peterfelfer/Oxcart/.folder_summary.md

---

folder: 03_admin/0309_lab/030901_instruments/Oxcart/Oxcart
aaaa_type: default
tier: institutional
synopsis: "Open-hardware titanium atom probe design files and documentation, currently under active improvement with a stage re-design in progress."
status: active
last_activity: "2024-04-24"
people:
  - { name: "Peter Felfer", role: "designer/lead" }
key_entities:
  notes: "Open hardware atom probe; GPL licensed; runs PyCCAPT software; integrates Surface Concept and RoentDek detectors."
deadlines: []
linked:
  projects: []
  publications: []
  conferences: []
open_items:
  - "Stage re-design to integrate laser with in-situ dual-side focusing is in progress."
  - "Piezo stage lacks lift force and is being replaced."
  - "Weight distribution on optical table prevents use of air suspension."
  - "Low temperature capability currently limited to 35K (20K possible with improvements)."
  - "Only 3 pucks in load lock currently."
indexed:
  at: "2026-05-20T20:55:03"
  model: "deepseek-ai/DeepSeek-V4-Flash"
  backend: "hpc"
  provider: "hpc"
  upstream_model: "deepseek-ai/DeepSeek-V4-Flash"
  source_hash: "1dfb2ab7d26a90a0"
  schema_version: 2
---

## Context

This folder contains the hardware and design files for the Oxcart Titanium atom probe, an open-hardware straight flight path, microelectrode atom probe designed by Peter Felfer under his ERC starting grant. The system is controlled by the PyCCAPT software package and supports integration of Surface Concept and RoentDek detectors. The folder sits within the lab's instruments directory, serving as the central repository for build files and documentation for this custom-built instrument. The project is licensed under GPL, encouraging others to build their own versions or remix components. The current state is active, with known limitations being addressed: the piezo stage lacks lift force and is being replaced, and a stage re-design is underway to integrate a laser with in-situ dual-side focusing. The system achieves excellent vacuum (<10-11 mbar), minimal residual hydrogen, good mass resolution, and high detection efficiency, but has limited low-temperature capability (currently 35K) and only three pucks in the load lock.

## Recent activity

- 2024-04-24: README.md and LICENSE files last modified; documentation reflects current state of the instrument.
- 2024-04-24: Stage re-design to integrate laser with in-situ dual-side focusing noted as in progress.
- 2024-04-24: Piezo stage replacement identified as ongoing due to insufficient lift force.
- 2024-04-24: Known limitations documented: weight distribution issue on optical table, limited low-temperature capability, and load lock capacity.

## Key documents

- **README.md** (2024-04-24): Project overview describing the open-hardware atom probe, its strengths (vacuum, mass resolution, detection efficiency), known problems, and ongoing improvements. Authored by Peter Felfer.
- **LICENSE** (2024-04-24): GPL license file governing use and distribution of the hardware and design files.

## Open questions / next actions

- Complete stage re-design to integrate laser with in-situ dual-side focusing.
- Replace current piezo stage with one having adequate lift force.
- Address weight distribution on optical table to enable air suspension use.
- Investigate improvements to achieve 20K low-temperature capability.
- Expand load lock capacity beyond 3 pucks.
