peterfelfer/Oxcart/BOM.md

# Bill of Materials — off-the-shelf / vendor parts

The CAD tree in this repository contains **only parts designed for the Oxcart instrument**. Off-the-shelf components sourced from commercial suppliers are *not* redistributed here — their CAD models are the property of the respective vendors and are subject to those vendors' own terms. Instead, the parts used are listed below so you can download the original models from, or order them through, each supplier.

Part identifiers are taken from the supplier catalogue names as used in the build. Quantities and exact revisions depend on your configuration; treat this as a sourcing reference rather than a definitive per-unit BOM.

**23 suppliers, 618 distinct catalogue parts referenced.**

| Supplier | Website | Parts referenced |
|---|---|---|
| www.kampundkoetter.de | https://www.kampundkoetter.de | 244 |
| Thorlabs | https://www.thorlabs.com | 200 |
| VAB | https://www.vab-vacuum.com | 38 |
| LewVac | https://www.lewvac.co.uk | 27 |
| MK Profile | https://www.mk-group.com | 16 |
| Edwards | https://www.edwardsvacuum.com | 13 |
| Standa | https://www.standa.lt | 13 |
| Mädler | https://www.maedler.de | 12 |
| allectra | https://www.allectra.com | 11 |
| Pfeiffer | https://www.pfeiffer-vacuum.com | 9 |
| Hositrad | https://www.hositrad.com | 6 |
| smaract | https://www.smaract.com | 6 |
| Newport | https://www.newport.com | 4 |
| Edmbund Optics | https://www.edmundoptics.com | 3 |
| Lakeshore and Omega | https://www.lakeshore.com  /  https://www.omega.com | 3 |
| Vacom | https://www.vacom.de | 3 |
| Festo | https://www.festo.com | 2 |
| Kipp | https://www.kippwerk.de | 2 |
| Landefeld | https://www.landefeld.com | 2 |
| Lesker | https://www.lesker.com | 2 |
| Menlo Systems | https://www.menlosystems.com | 1 |
| prevac | https://www.prevac.eu | 1 |
| Rittal | https://www.rittal.com | 0 |

---

## www.kampundkoetter.de

Website: https://www.kampundkoetter.de

<details><summary>244 catalogue parts</summary>

- Flansch-Festlager KUS12-20160127
- Flansch-Festlager KUS16-20160127
- Flansch-Festlager KUS25-20200903
- Flansch-FestlagerKUS20-20160127
- Flansch-Loslager KUS12-20160127
- Flansch-Loslager KUS16-20160127
- Flansch-Loslager KUS20-20160127
- Flansch-Loslager KUS25-20200903
- KPMR-09C-500
- KPMR-12C-500
- KPMR-15C-500
- KPMW-09C-BLZ0
- KPMW-09C-BSZ0
- KPMW-12C-BLZ0
- KPMW-12C-BSZ0
- KPMW-15C-BLZ0
- KPMW-15C-BSZ0
- KUS1204x1000
- KUS1204x200
- KUS1204x250
- KUS1204x300
- KUS1204x350
- KUS1204x400
- KUS1204x450
- KUS1204x500
- KUS1204x550
- KUS1204x600
- KUS1204x650
- KUS1204x700
- KUS1204x800
- KUS1204x900
- KUS1605x1000
- KUS1605x1100
- KUS1605x1200
- KUS1605x1300
- KUS1605x1400
- KUS1605x1500
- KUS1605x1600
- KUS1605x200
- KUS1605x250
- KUS1605x300
- KUS1605x350
- KUS1605x400
- KUS1605x450
- KUS1605x500
- KUS1605x550
- KUS1605x600
- KUS1605x650
- KUS1605x700
- KUS1605x800
- KUS1605x900
- KUS1610x1000
- KUS1610x1100
- KUS1610x1200
- KUS1610x1300
- KUS1610x1400
- KUS1610x1500
- KUS1610x1600
- KUS1610x200
- KUS1610x250
- KUS1610x300
- KUS1610x350
- KUS1610x400
- KUS1610x450
- KUS1610x500
- KUS1610x550
- KUS1610x600
- KUS1610x650
- KUS1610x700
- KUS1610x800
- KUS1610x900
- KUS2005x1000
- KUS2005x1100
- KUS2005x1200
- KUS2005x1300
- KUS2005x1400
- KUS2005x1500
- KUS2005x1600
- KUS2005x1800
- KUS2005x200
- KUS2005x2000
- KUS2005x250
- KUS2005x300
- KUS2005x350
- KUS2005x400
- KUS2005x450
- KUS2005x500
- KUS2005x550
- KUS2005x600
- KUS2005x650
- KUS2005x700
- KUS2005x800
- KUS2005x900
- KUS2010x1000
- KUS2010x1100
- KUS2010x1200
- KUS2010x1300
- KUS2010x1400
- KUS2010x1500
- KUS2010x1600
- KUS2010x1800
- KUS2010x200
- KUS2010x2000
- KUS2010x250
- KUS2010x300
- KUS2010x350
- KUS2010x400
- KUS2010x450
- KUS2010x500
- KUS2010x550
- KUS2010x600
- KUS2010x650
- KUS2010x700
- KUS2010x800
- KUS2010x900
- KUS2510_Spindelmutter
- KUS2510x1000
- KUS2510x1100
- KUS2510x1200
- KUS2510x1300
- KUS2510x1400
- KUS2510x1500
- KUS2510x1600
- KUS2510x1800
- KUS2510x2000
- KUS2510x800
- KUS2510x900
- LFS16x1000
- LFS16x1100
- LFS16x1200
- LFS16x1300
- LFS16x1400
- LFS16x1500
- LFS16x1600
- LFS16x1800
- LFS16x1900
- LFS16x200
- LFS16x2000
- LFS16x250
- LFS16x300
- LFS16x350
- LFS16x400
- LFS16x450
- LFS16x500
- LFS16x550
- LFS16x600
- LFS16x650
- LFS16x700
- LFS16x800
- LFS16x900
- LFS20x1000
- LFS20x1100
- LFS20x1200
- LFS20x1300
- LFS20x1400
- LFS20x1500
- LFS20x1600
- LFS20x1800
- LFS20x1900
- LFS20x200
- LFS20x2000
- LFS20x250
- LFS20x300
- LFS20x350
- LFS20x400
- LFS20x450
- LFS20x500
- LFS20x550
- LFS20x600
- LFS20x650
- LFS20x700
- LFS20x800
- LFS20x900
- Linearwagen
- Linearwagen D16
- Linearwagen D20 - 2016-09
- Linearwagen D20 WF
- Profilfuehrung20x1000
- Profilfuehrung20x1200
- Profilfuehrung20x1500
- Profilfuehrung20x2000
- Profilfuehrung20x300
- Profilfuehrung20x500
- Profilfuehrung20x800
- SFU2005 Spindelmutter_MJ2020
- SFU2010 Spindelmutter_MJ2020
- Spannblock KUS12
- Spannblock KUS16
- Spannblock KUS20
- Spannblock KUS25
- Spindelmutter-SFU1204-MJ2020
- SpindelmutterSFU1605_MJ2020
- SpindelmutterSFU1610_MJ2020
- Steh-Festlager KUS12-20180528
- Steh-Festlager KUS16-20150517
- Steh-Festlager KUS20-20171205
- Steh-Festlager KUS25-20200903
- Steh-Loslager KUS12-20180528
- Steh-Loslager KUS16-20160510
- Steh-Loslager KUS2020150511
- Steh-Loslager KUS25-20200903
- WF16x1000
- WF16x1100
- WF16x1200
- WF16x1300
- WF16x1400
- WF16x1500
- WF16x1600
- WF16x200
- WF16x250
- WF16x300
- WF16x350
- WF16x400
- WF16x450
- WF16x500
- WF16x550
- WF16x600
- WF16x650
- WF16x700
- WF16x800
- WF16x900
- WF20x1000
- WF20x1100
- WF20x1200
- WF20x1300
- WF20x1400
- WF20x1500
- WF20x1600
- WF20x200
- WF20x250
- WF20x300
- WF20x350
- WF20x400
- WF20x450
- WF20x500
- WF20x550
- WF20x600
- WF20x650
- WF20x700
- WF20x800
- WF20x900
- Wagen-20CR_2016
- Wellenhalter
- stepper_am23hs2449-01

</details>

## Thorlabs

Website: https://www.thorlabs.com

<details><summary>200 catalogue parts</summary>

- 1- 4- RFL MPD149-F01
- 1-2- 150mm RFL MPD00M9-F01
- 1” 6” RFL - MPD169-F01
- 2- 6- RFL MPD269-F01
- ACA254-150-UV
- AL1225-A
- AL75150-A
- AM45C_M
- BE03-UVB
- BE10-1064
- BE10-266
- BE10-532
- BE10-UVB
- BE1_M
- BSC203
- C4W
- C6W
- CF038C_M-P5
- CF125C_M-P5
- CF175C_M-P5
- CH1060_M
- CPX1_M
- CR1_M
- CXYZ05_M
- DAS110
- DCC3240M
- ER025
- ER1-P4
- ER2-P4
- ER24
- ER4
- FAS100
- FM90_M
- FP90_M
- H45CN
- H45E2
- ID36
- ID36_M
- ID50
- KB50_M
- KB75_M
- KC1_M
- KC2_M
- KCB1C_M
- KCB1E_M
- KCB1P_M
- KCB1_M
- KCB2C_M
- KCB2EC_M
- KIM101
- KM100
- KM100CP_M
- KM200
- KM200CP_M
- KPS201
- LA4936
- LC6W
- LCP01B
- LCP01T_M
- LCP02_M
- LCP06_M
- LCP09
- LCP50S
- LMR2_M
- Laser magnification optica
- Laser magnification optica v3 (ATTER UPDATE)
- Laser magnification optica v4 (ATTER UPDATE)
- Laser positioning setup
- MA45-50_M
- MAX341_M
- MB1015_M
- MB1530F_M
- MB2020_M
- MB3030D_M
- MB3030_M
- MB3045_M
- MB35142_M
- MFF101_M
- MFF102_M
- MFF102_M-Solidworks (1)
- MP127P1
- MPD00M9-F01-with beam
- MPD01M9-F01
- MPD124-P01
- MPD149-F01
- MPD169-F01
- MPD2151-P01
- MPD269-F01
- MPD284-P01
- MSB5075_M
- MSB7510_M
- MSC2
- MSP05_M
- MSP1.5_M
- MSP1_M
- MSP2_M
- MT3_M-Z8
- MVL12X20L
- MVL12X3Z
- MVL20A
- MVL6X3Z
- MVL7000
- MVLCMC
- N80L5P
- N80L6P
- NX1NF_M
- P100_M
- P75_M
- PB4_M
- PD1B2_M
- PD1D_M
- PD1V_M
- PD1Z_M
- PF10-03-F01
- PF125B
- PF175B
- PF20-03-F01
- PF85B
- PFE20-G01
- PFSQ20-03-F01
- PH100E_M
- PH150E_M
- PH20E_M
- PH2T_M
- PH30E_M
- PH40E_M
- PH50E_M
- PH75E_M
- PLS-T242_M
- PLS-T242_M-Step (1)
- PLS-T492_M
- PLS-T492_M-Step (1)
- PM100D
- POLARIS-CA1_M
- POLARIS-K05S2
- POLARIS-K1M4_M
- POLARIS-K2
- POLARIS-MA45_M
- PR005_M
- RBB150A_M
- RBL13D_M
- RP005_M
- RS10M
- RS19P4_M
- RS25_M
- RS3M
- RS99_M
- S120VC
- S415C
- S425C
- SB1_M
- SH05_M
- SM1L10
- SM1TC
- SM2A21
- SR025
- T1020C
- TR100_M
- TR10M
- TR150_M
- TR20_M
- TR2F90_M
- TR30_M
- TR40_M
- TR50_M
- TR75_M
- TRF90_M
- TRT2_M
- UPHA
- VB01A_M
- VB01_M
- VRC1SM1
- VRC1SM2
- VRC2SM1
- VRC2SM2
- VRC4SM1
- VRC4SM2
- XRN25-RP1_M
- XRN25DR
- XRN25DR2
- XRN25DR3
- XT34HP_M
- XT34SD-250
- XT34SD-500
- XT34TR1_M
- XT34TR2_M
- XT66C4
- XT66P2_M
- XT66SD-250
- XT66SD-500
- XT66SD-750
- beam expanders
- beam path assembly
- laser beam collection
- laser optical assembly
- laser optical assembly v12 (ATTER UPDATE)
- laser optical assembly v13 (ATTER UPDATE)
- lens laser focussing
- optics frame
- targeting camera assembly

</details>

## VAB

Website: https://www.vab-vacuum.com

<details><summary>38 catalogue parts</summary>

- CF40 offset port
- Durchführungsflansch DN40 CF_ Uni Erlangen
- FIM_PrÑparationskammer_CF200_S1_Blindflansch.0004
- VAb_BF 160-K
- VAb_BNC 16
- VAb_CBF 100
- VAb_DCF 63-2
- VAb_JU-MEM 40K
- VAb_JUMEM 40-L
- VAb_JUMEM 40-M
- VAb_JUMEM 63K
- VAb_KWCF 16K
- VAb_LD 63-50
- VAb_LD 63-50S
- VAb_MDS 16-300
- VAb_MDS 16_40-100 ST MLH
- VAb_MDS 16_40-300
- VAb_MDS 40-150
- VAb_MDS 40-200
- VAb_MDS 40-500
- VAb_MDS 40-600
- VAb_MDS 40-700
- VAb_MDS 63-500
- VAb_MDS 63-600
- VAb_MDS2 40-500
- VAb_MDWS-300
- VAb_MDWS-500
- VAb_MEM 160-200-K
- VAb_MEM 63-25
- VAb_MEM 63-25A
- VAb_RF 200-100
- VAb_SF 160-K
- VAb_SHV 16
- VAb_SPR 40-111
- VAb_SST-63-40
- VAb_THD 40_1+2
- VAb_WKCF 63
- VAb_X 40-12 S

</details>

## LewVac

Website: https://www.lewvac.co.uk

<details><summary>27 catalogue parts</summary>

- 110240 AGP
- A-SMA-F-UHV
- C19-40CF
- C19-AC1200
- C19-VCF500
- D9-40CF
- D9-40KF
- FH-BNC-D-40CF
- FH-MSC19-40CF
- FH-SMA-D-16CF (1)
- FH20-SHV-E-16CF (1)
- FHM-A10-16CF
- FHP-BECU-0.8-CON
- FHP-BECU-1.27-CON
- FHP-BECU-2.4-CON
- SVP-DUV-49.2-63CF
- SVP-UV-11.6-SW
- SVP-UV-14.9-SW
- SVP-UV-17.5-AW
- SVP-UV-23.8-40CF
- SVP-UV-23.8-AW
- SVP-UV-36.5-40CF
- SVP-UV-36.5-AW
- SVP-UV-49.2-AW
- SVP-UV-74.9-AW
- SVP-UV-8.6-SW
- modified SVP-DUV-49.2-63CF

</details>

## MK Profile

Website: https://www.mk-group.com

<details><summary>16 catalogue parts</summary>

- 25_01_0300(00-00-0)(0)
- 25_01_0500(00-00-0)(0)
- 25_50_1010
- 25_50_8000
- 31_60_0007
- 50_05_6026
- 51_51_1000(0)
- 6005AB1800(0)
- 60_05_0500(0)
- 60_05_0650(0)
- 60_05_1000(0)
- 60_05_1850(0)
- B85.00.016
- B85.00.021
- mk2563
- stage assembly rack

</details>

## Edwards

Website: https://www.edwardsvacuum.com

<details><summary>13 catalogue parts</summary>

- 360549_STEP
- 410023_ethernet_B
- 410030 TSP
- 5s-xx-2v-5k_step
- 5s-xx-2v-sc_step
- B58053170_AllCATPart_Radial Fan STEP
- B82200200 nEXT300D CF100 STEP
- B8G200820 AIR COOLER RADIAL SETUP
- B8GX10C01 nEXT85 CF63 (2)
- D02601000_APG100_NW16 (1)
- D14703000_GAUGE_WIDE_RNGE_S_FCC68_NW35CF
- D397XX000 TIC ALL VARIANTS
- nXDS standard and C variant STEP

</details>

## Standa

Website: https://www.standa.lt

<details><summary>13 catalogue parts</summary>

- 1HT09-18-20
- 1VIS10-065-12-60
- 7T38XYZ
- 8MT173V-10-VSS42
- 8MT184-13
- 8MTF2
- 8MTF2M
- 8MVT25-6
- 8MVT45-13
- air table assembly
- compressed air module base
- motorized stage setup
- optical table model

</details>

## Mädler

Website: https://www.maedler.de

<details><summary>12 catalogue parts</summary>

- 47514020
- 62399416GA
- 62499116
- 64001600
- 64010023
- 64200115
- 64477116
- 67071200
- 67099510
- A_64200506
- B_64200506
- shifter block

</details>

## allectra

Website: https://www.allectra.com

<details><summary>11 catalogue parts</summary>

- 210-D09-K40
- 211-FS09-UHV
- 211-FS44H-UHV
- 218-HD44-SS
- 218-HD78-SS
- 220-CM12-C16
- 220-CM19
- 264-13CU1K-2-K16
- 360-CRBC-0.8
- 360-CRBC-1.3
- 515-GV-C16_stp

</details>

## Pfeiffer

Website: https://www.pfeiffer-vacuum.com

<details><summary>9 catalogue parts</summary>

- 110RKR040-016-V.A
- 120AAU016-0500
- 120RKR040-016
- 310FMA063
- 330SMA063
- 420FES040
- 420FES063
- 470RKK040
- PTR21261

</details>

## Hositrad

Website: https://www.hositrad.com

<details><summary>6 catalogue parts</summary>

- 17105-01-W
- 17105-02-W
- Hositrad_CF35-38
- Hositrad_FO63-70-HalfNipple
- Hositrad_KE25-25
- botton standoff port

</details>

## smaract

Website: https://www.smaract.com

<details><summary>6 catalogue parts</summary>

- ALB DN63CF_1B_12
- EX22070349_A00
- EX23080921_A00
- EX23101016_A00
- EX23111089_A00
- EX23111091_A00

</details>

## Newport

Website: https://www.newport.com

<details><summary>4 catalogue parts</summary>

- NPXYZ100SG
- Newport 900 x 1800 optical table
- Newport-M-UMR5_16
- S-2000A-116

</details>

## Edmbund Optics

Website: https://www.edmundoptics.com

<details><summary>3 catalogue parts</summary>

- step_37259
- step_37264
- step_37288 RFL6.35 dia 6.35

</details>

## Lakeshore and Omega

Website: https://www.lakeshore.com  /  https://www.omega.com

<details><summary>3 catalogue parts</summary>

- Lakeshore CO clamp
- Lakeshore DT 670 SD Omega CY 670 SD
- Omega CY7 SD7

</details>

## Vacom

Website: https://www.vacom.de

<details><summary>3 catalogue parts</summary>

- 4AVP-16CF-MV-S
- VACOM_105133_W-SUBD-15-BASIC
- W-SUBD-9-BASIC

</details>

## Festo

Website: https://www.festo.com

<details><summary>2 catalogue parts</summary>

- 19201 DSNU-16-50-P-A---(0)
- 8061478 ELGC-BS-KF-32-200-8P---(0)

</details>

## Kipp

Website: https://www.kippwerk.de

<details><summary>2 catalogue parts</summary>

- K0333_02_0
- K0333_03_0

</details>

## Landefeld

Website: https://www.landefeld.com

<details><summary>2 catalogue parts</summary>

- 10_52_6481_1008_013
- zdm205017236

</details>

## Lesker

Website: https://www.lesker.com

<details><summary>2 catalogue parts</summary>

- sa0075mccf
- sa0075pvqf

</details>

## Menlo Systems

Website: https://www.menlosystems.com

<details><summary>1 catalogue parts</summary>

- Menlo Systems BlueCut Mockup

</details>

## prevac

Website: https://www.prevac.eu

<details><summary>1 catalogue parts</summary>

- TDS_W3008537

</details>

## Rittal

Website: https://www.rittal.com

_Assembly/reference models only._
