peterfelfer/Oxcart/CAD/assemblies/MC Laser assembly v4.step

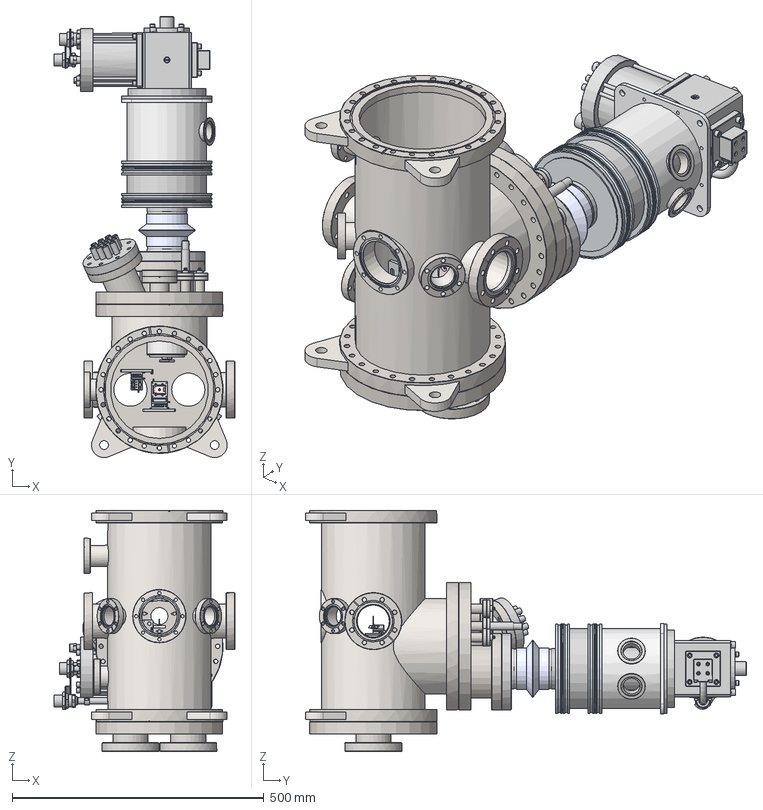
[picture p2: CAD file, 2026-05-30]
CAD/assemblies/MC Laser assembly v4.step
359.1 x 877.0 x 479.1 mm
MC body
Hositrad_CF200-203-Weldflange v1
Hositrad_CF200-203-Weldflange v1 (2)
Hositrad_CF200-203-Weldflange v1 (1)
console x 2
console(Mirror) x 2
Hositrad_CF63-64 v1
Hositrad_CF63-64 v1 (1)
Hositrad_CF35-38 v1
Hositrad_CF35-38 v1 (1)
Hositrad_CF35-38 v1 (2)
Hositrad_CF35-38 v1 (3)
CF63 special weld-in v3
Hositrad_CF200-B v1
Hositrad_CF63-70-Weldflange v1
Hositrad_CF63-70-Weldflange v1 (1)
EX-0045592-Wechselantrieb Baseplate_V8_00_Parent x 3
EX-0054799-Wechselantrieb Topplate V6_00_Parent x 3
ES-0000728-Rail SVS1_FNB-SVS1030 x 6
ES-0000705-Cage RK1_FNB-RK17-8Z x 6
ES-0000810-Slide WS1_WS1030 x 3
ISO 14580 - M2 x 4 x 3.2 - 4.8-N-A2_ISO 14580 - M2 x 4 x 3.2 - 4.8-N- A2 x 27
IS-0006594-NBK_NBK-M1,6x3-St x 6
EX-Kopie von IS-0043336-Housing^EX-0045461-Drive unit_00_Parent x 3
10001541_EX
10001504_EX x 2
10001510_EX
10001507_EX x 4
10000125_M2 x 4 - 4N-A2 x 6
ISO 4762 M2 x 10 - 8.8N-A2_ISO 4762 M2 x 10 - 8.8N-A2 x 4
ISO 4762 M2 x 5 - 3.8N-A2_ISO 4762 M2 x 5 - 3.8N-A2 x 8
ISO 4762 M2 x 4 - 2.8N-A2_ISO 4762 M2 x 4 - 2.8N-A2 x 4
FH20-SHV-E-16CF (1)
CF200
CF100-102-WeldflangE
cf63
CF40
CF16
CF16 (1)
CF16 (2)
CF16 (3)
CF63_1
FH-SMA-D-16CF (1) x 2
Viewport-metal-ring38
Glass47
NW35CF-Viewport
10013849_00_Parent
10004759_00_Parent x 12
top interface
bottom connector
thermal interface
bottom thermal connector
bottom clamp
VAb_CBF 100 v1
330SMA063
VAb_BF 160-K v1
tube
Hositrad_ISO160AV x 2
VAb_SF 160-K x 2
main body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
