peterfelfer/Oxcart/CAD/gas-thermal/baking equipment/baking lid assembly Drawing v3 Sheet1.dxf

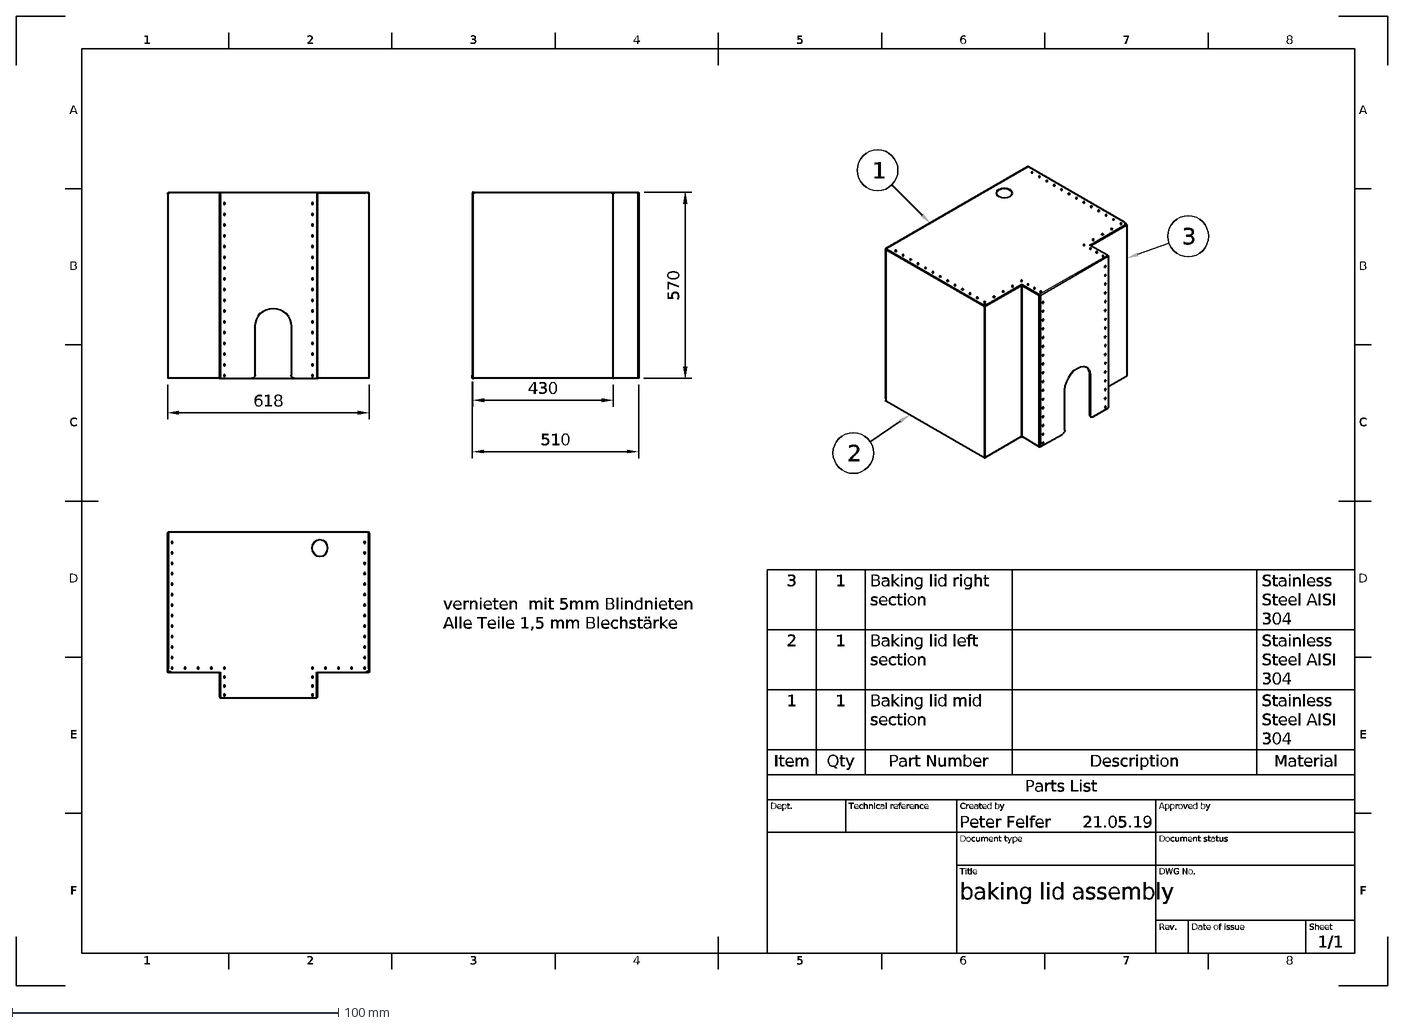
[picture p3: CAD file, 2026-05-30]
CAD/gas-thermal/baking equipment/baking lid assembly Drawing v3 Sheet1.dxf
1
A
2
3
4
5
6
7
8
B
C
D
E
F
21.05.19
1/1
baking lid assembly
Peter Felfer
Dept.
Technical reference
Created by
Approved by
Document type
Document status
Title
DWG No.
Rev.
Date of issue
Sheet
Parts List
Item
Qty
Part Number
Description
Material
Baking lid mid section
Stainless Steel AISI 304
Baking lid left section
Baking lid right section
vernieten mit 5mm Blindnieten Alle Teile 1,5 mm Blechstärke
510
570
430
618
