peterfelfer/Oxcart/CAD/machining/pocket nc/V2PocketNC_both_toolholders_Kinematic_Assembly v19 v1.step

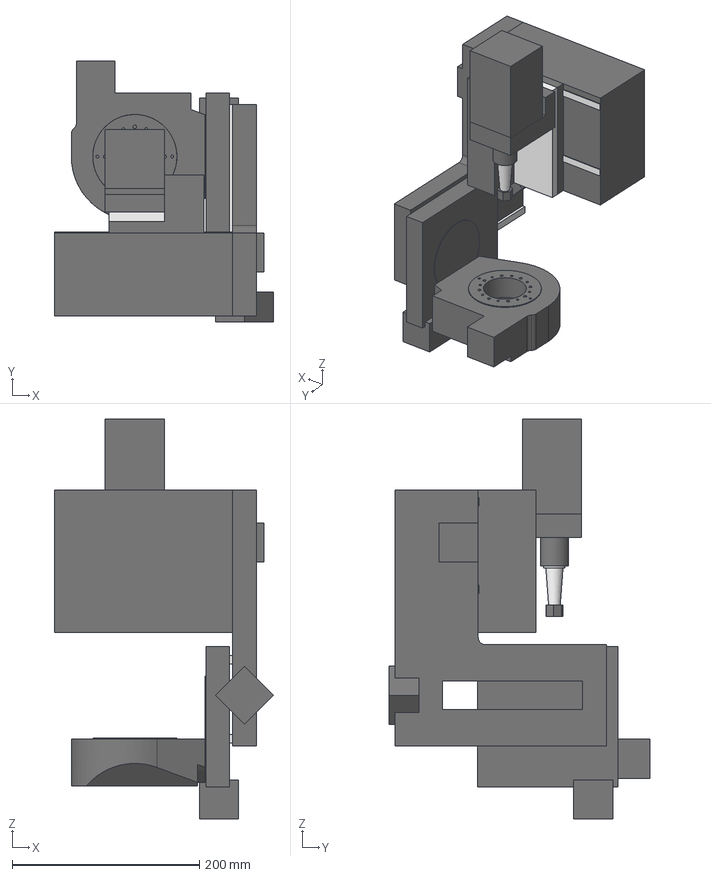
[picture p4: CAD file, 2026-05-30]
CAD/machining/pocket nc/V2PocketNC_both_toolholders_Kinematic_Assembly v19 v1.step
234.3 x 279.2 x 427.8 mm
x rail
L_Bracket_Kinematic
z rail
motor mount
motor
simulation spindle extended
V2 B housing kinematic only v8
V2PocketNC kinematic Bdisc v4
V2PocketNC_A housing v3
y rails
