peterfelfer/Oxcart/CAD/optics-laser/optics/bottom optics assembly v6.step

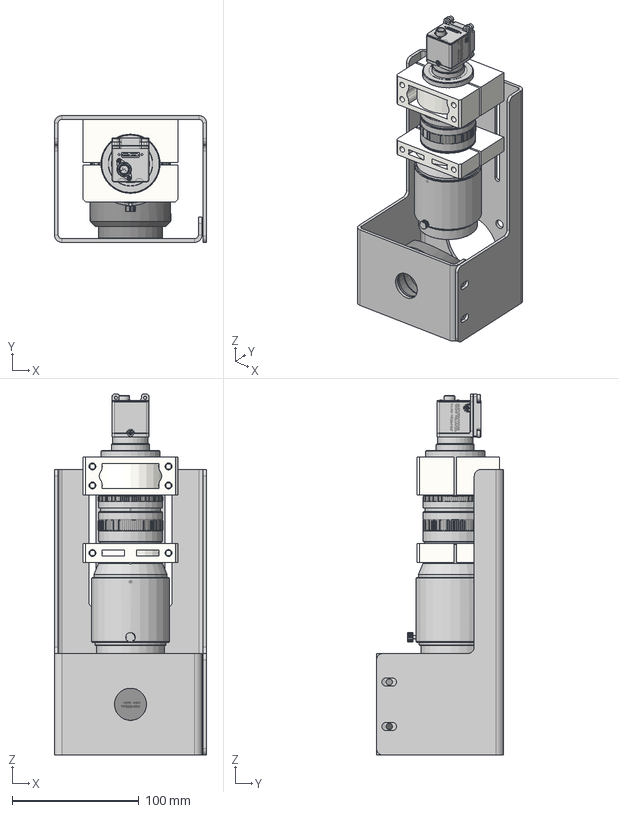
[picture p7: CAD file, 2026-05-30]
CAD/optics-laser/optics/bottom optics assembly v6.step
120.0 x 100.0 x 284.6 mm
H45E2-Step
bottom optics console
PFE20-G01-Step
MVL7000-Step v1
clamp upper short
clamp lower short
clamp lower
clamp upper
DCC3240M-Step v1
