peterfelfer/Oxcart/CAD/3d-print/3D-Print Oxcart/Detector assembly Copy v4.step

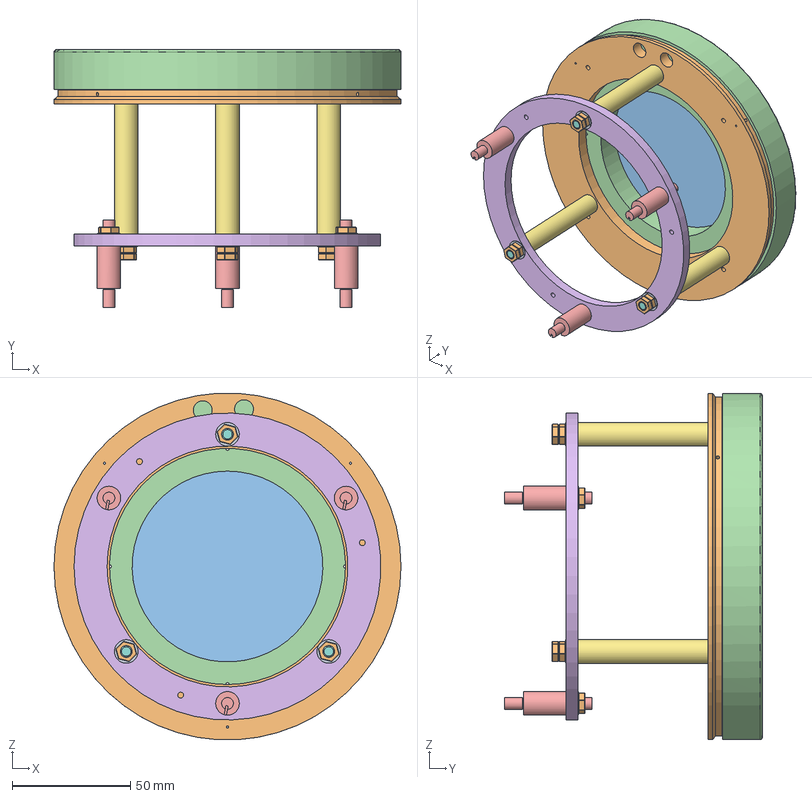
[picture p8: CAD file, 2026-05-30]
CAD/3d-print/3D-Print Oxcart/Detector assembly Copy v4.step
147.0 x 109.2 x 146.8 mm
DLD8080_BODENPLATTE
MCP-75-32-25-19_60ZU1
DLD8080_ABDECKUNG_V2
STANDOFF_ALU_18X10_V2 x 3
HALTERING_3D-DLD4040-150
ABSTANDSHALTER_PEEK x 3
M5-GEWINDESTANGE_ALU x 6
M5-WASCHER_CUBE x 6
M5-MUTTER_TITAN x 9
