peterfelfer/Oxcart/CAD/cryo/cryo heads/2-9 COLDHEAD ASSEMBLY v4.step

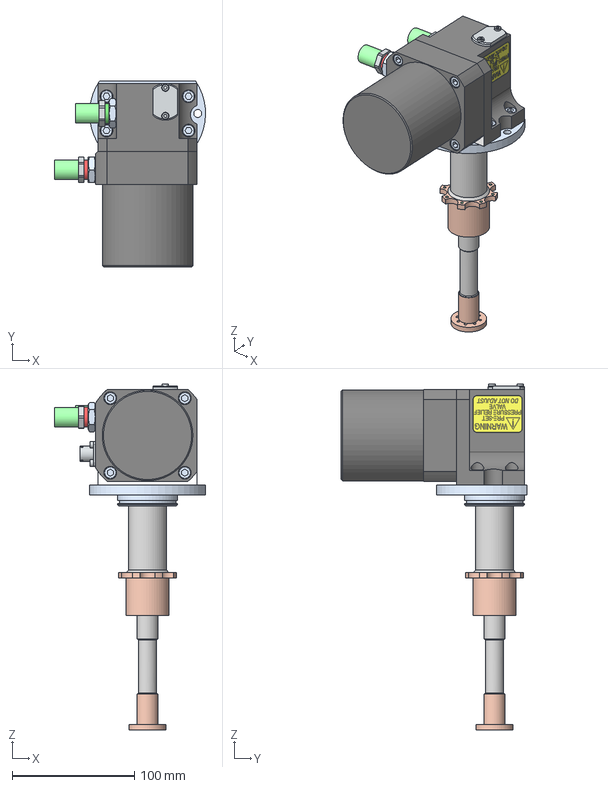
[picture p10: CAD file, 2026-05-30]
CAD/cryo/cryo heads/2-9 COLDHEAD ASSEMBLY v4.step
123.3 x 151.8 x 282.5 mm
911H030A-B (1ST STAGE HEAT STATION 2-9)
911H020A (2ND STAGE HEAT STATION)
911C000A-E (TUBE ASSEMBLY)|448|532|Groove 1
911H040A-C (TUBE FLANGE)
911H000A (1ST STAGE TUBE)
911H010A-B (2ND STAGE TUBE)
911C000A-E (TUBE ASSEMBLY)|448|532|Groove 1 (1)
911C000A-E (TUBE ASSEMBLY)|448|532|Groove 1 (2)
911H220A-F (DRIVE HOUSING)
1P0284 (SELFSEAL COUP MALE 5400-S2-4) x 2
M3 x 8 Socket Cap Head A4 x 2
99BS-OR925X178V160 (O RING 9.25x1 x 2
911H360A (GAS PLUG)
911H320A-B (GAS CONNECTOR) x 2
1X0234 (SHRINK SLEEVE D17 PVC GREEN)
1P0231 (WARNING LABEL)
911H210A-D (MOTOR HOUSING)
1P0175 (4 WAY CONNECTOR)
1X0235 (SHRINK SLEEVE D17 PVC RED)
M3 x 6 Socket Cap Head x 4
99BS-OR14X178N160
1P0213 (CE LABEL)
M6 x 12 Socket Cap Head x 4
M6 x 30 Socket Cap Head x 4
