peterfelfer/Oxcart/CAD/optics-laser/optics/MB1530_M-Step (assembly plate) v1.step

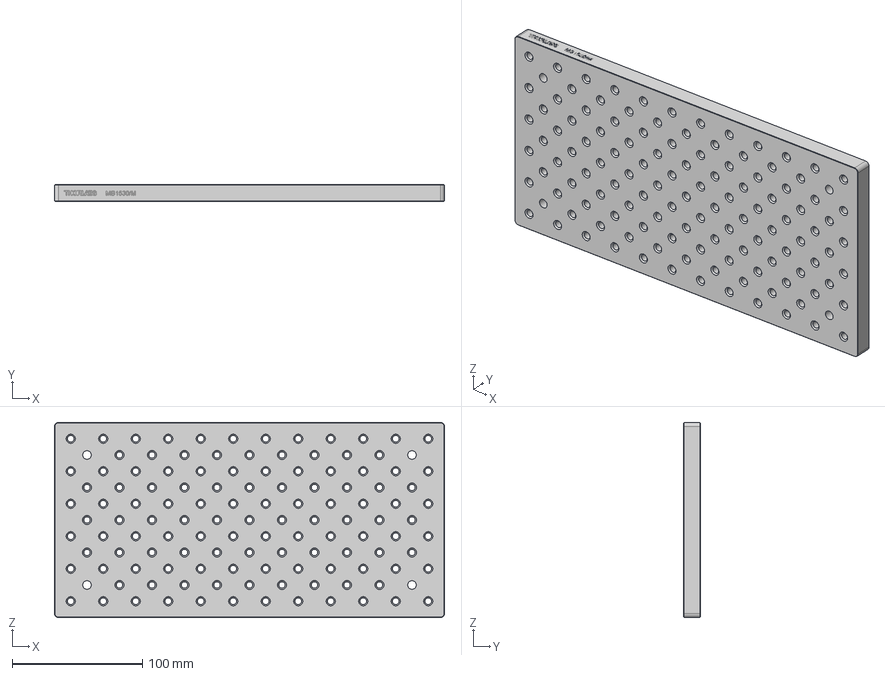
[picture p11: CAD file, 2026-05-30]
CAD/optics-laser/optics/MB1530_M-Step (assembly plate) v1.step
300.0 x 12.7 x 150.0 mm
