peterfelfer/Oxcart/CAD/assemblies/MC Lid assembly laser v9.step

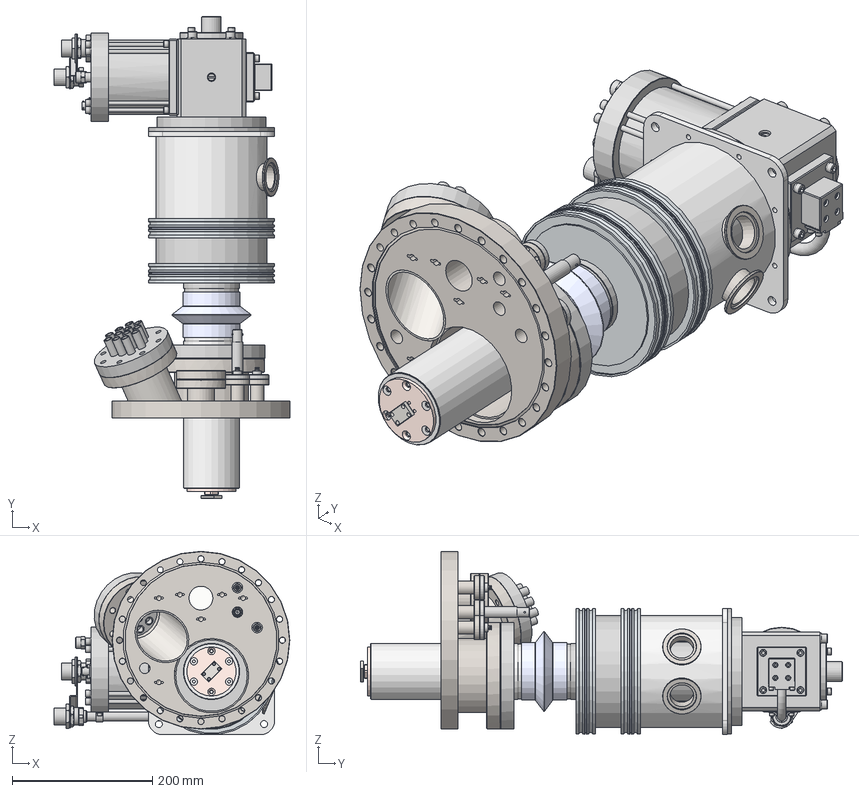
[picture p12: CAD file, 2026-05-30]
CAD/assemblies/MC Lid assembly laser v9.step
335.7 x 686.6 x 261.1 mm
FH20-SHV-E-16CF (1)
CF200
CF100-102-WeldflangE
cf63
CF40
CF16
CF16 (1)
CF16 (2)
CF16 (3)
CF63_1
FH-SMA-D-16CF (1) x 2
Viewport-metal-ring38
Glass47
NW35CF-Viewport
10013849_00_Parent
10004759_00_Parent x 12
top interface
bottom connector
thermal interface
bottom thermal connector
bottom clamp
VAb_CBF 100 v1
330SMA063
VAb_BF 160-K v1
tube
Hositrad_ISO160AV x 2
VAb_SF 160-K x 2
main body
top
VAb_SF 160-K v1
Hositrad_KF40-38-19 v1
Hositrad_KF40-38-19 v1 (1)
O ring 145 x 4
KDE415SA 3D Model
thermal conductor x 2
magnetic ring x 2
thermal contact x 2
pressure plate x 2
Lakeshore DT 670 SD Omega CY 670 SD
insulator bottom
insulator top
Lakeshore CO clamp
back clamp
front clamp
