peterfelfer/Oxcart/CAD/cryo/cryo LL/CryoLLMainPart v2.step

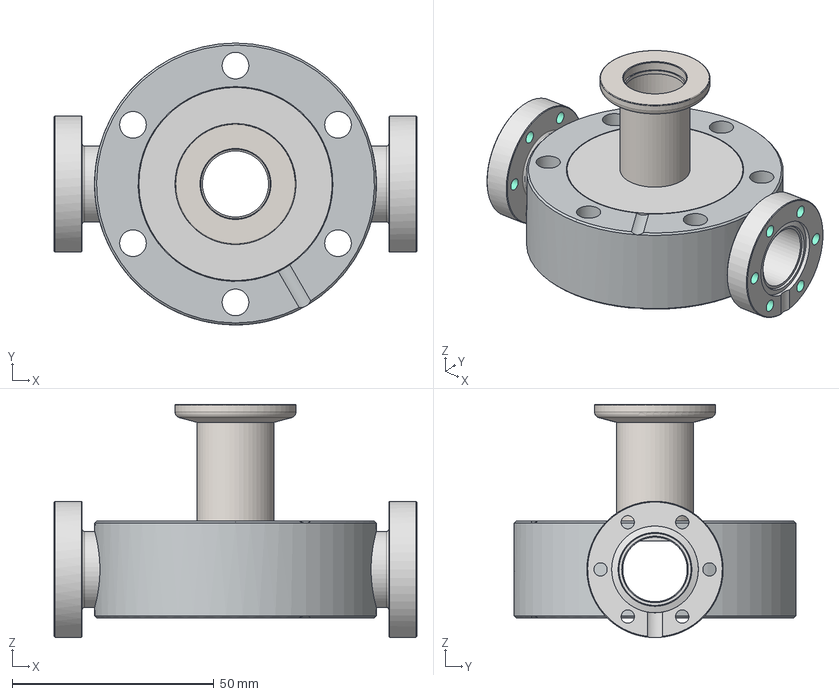
[picture p13: CAD file, 2026-05-30]
CAD/cryo/cryo LL/CryoLLMainPart v2.step
90.0 x 69.9 x 57.8 mm
VAb_DCF 40-2
CF-To-KF-Adaptors-All_CFA16-KF16
KF16-19WS_KF16-19
NW16CF-Outerring
NW16CF-Innerring_CF16-19-R
