peterfelfer/Oxcart/CAD/cryo/cryo system BC/coupling assembly v2.step

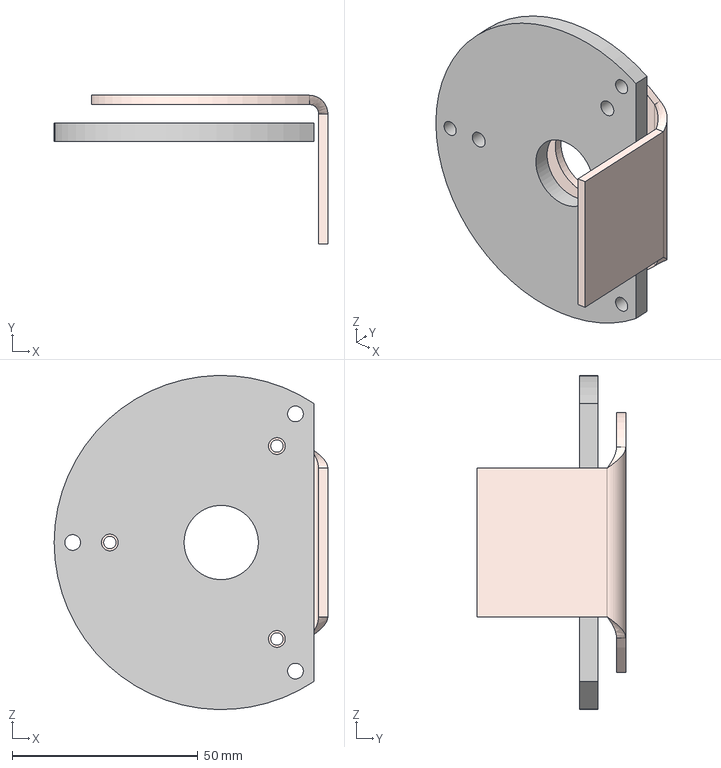
[picture p14: CAD file, 2026-05-30]
CAD/cryo/cryo system BC/coupling assembly v2.step
73.7 x 40.0 x 90.0 mm
coupling plate
coupling bottom plate
