peterfelfer/Oxcart/CAD/gas-thermal/gas charging devices/gasChargingFlashBang/Hositrad_FS16-19-FullNipple v1.step

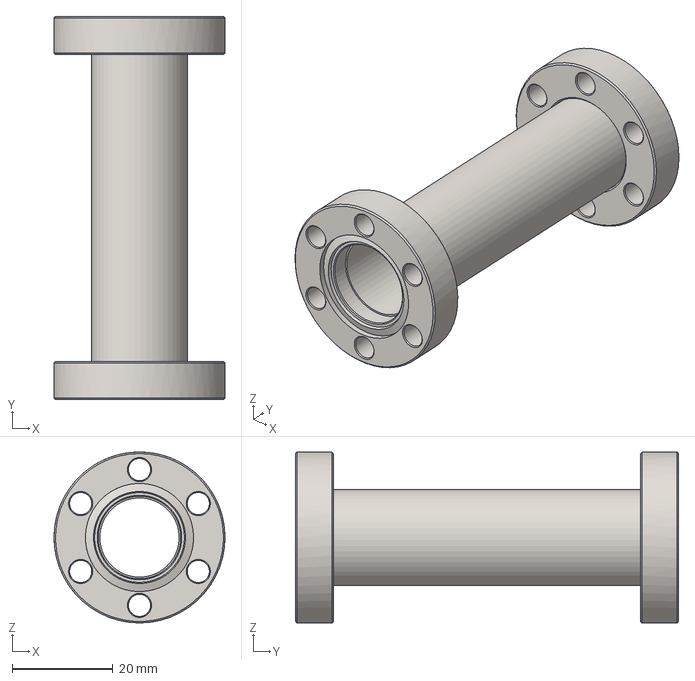
[picture p15: CAD file, 2026-05-30]
CAD/gas-thermal/gas charging devices/gasChargingFlashBang/Hositrad_FS16-19-FullNipple v1.step
34.0 x 76.2 x 34.0 mm
NW16CF-weld_CF16-19 x 2
Tube 19-All_Tube 19L66,8
