peterfelfer/Oxcart/CAD/optics-laser/optics/upper positioning optics assembly v8.step

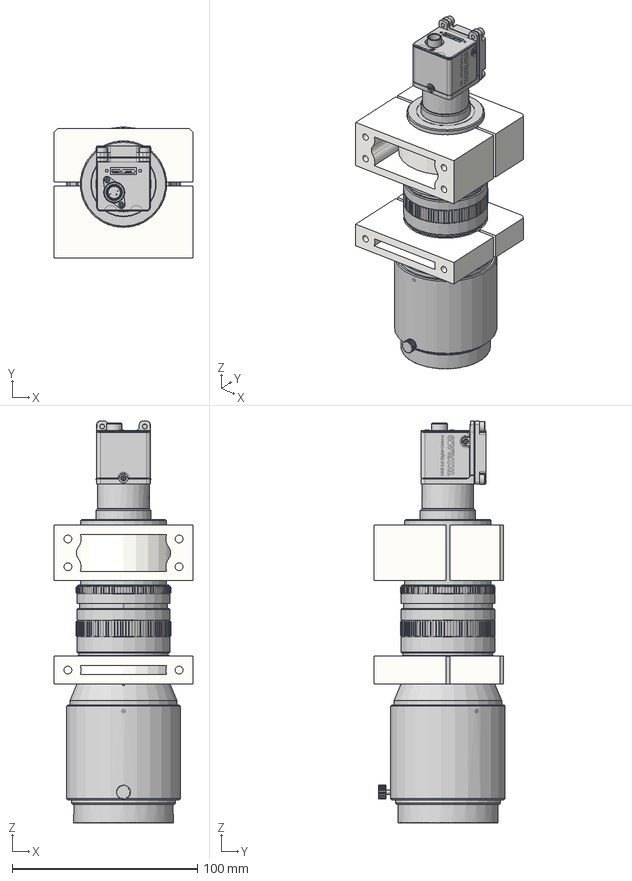
[picture p16: CAD file, 2026-05-30]
CAD/optics-laser/optics/upper positioning optics assembly v8.step
75.0 x 70.9 x 217.0 mm
MVL7000-Step
clamp upper short
clamp lower short
clamp lower
clamp upper
DCC3240M-Step
