peterfelfer/Oxcart/CAD/vacuum/vacuum parts/Hositrad_FS35-43R-FullNipple v1.step

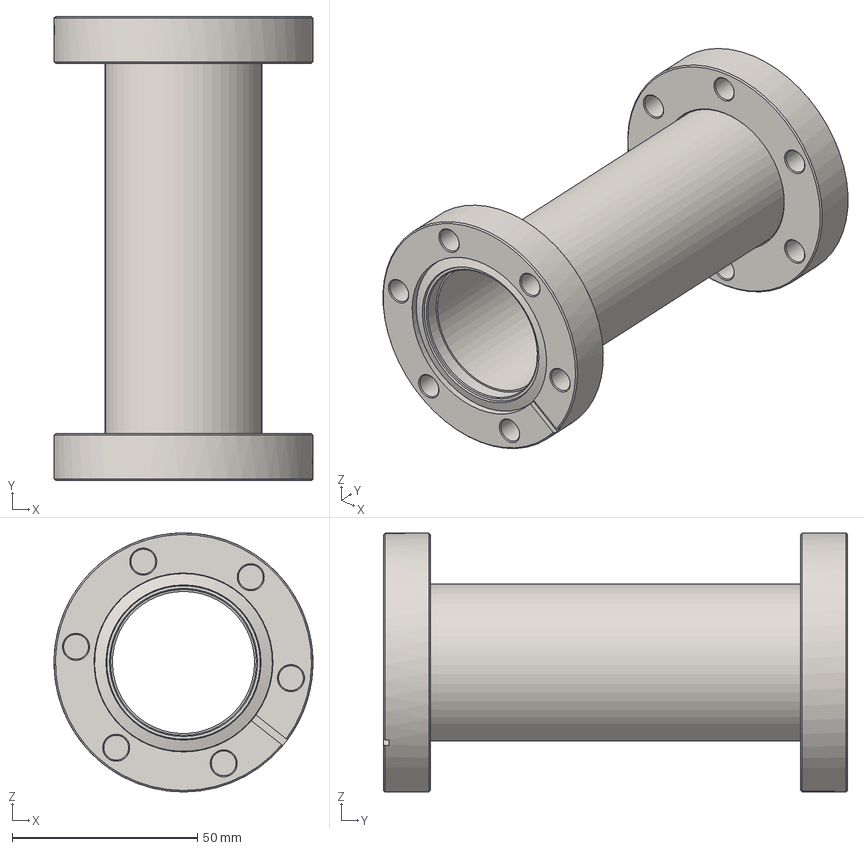
[picture p17: CAD file, 2026-05-30]
CAD/vacuum/vacuum parts/Hositrad_FS35-43R-FullNipple v1.step
70.0 x 125.4 x 70.0 mm
Tube 42.4-All_Tube 42
NW35CF-Weld-42
NW35CFR-Weld-42
