peterfelfer/Oxcart/CAD/detector/dld8080_v3_ext_asm v5.step

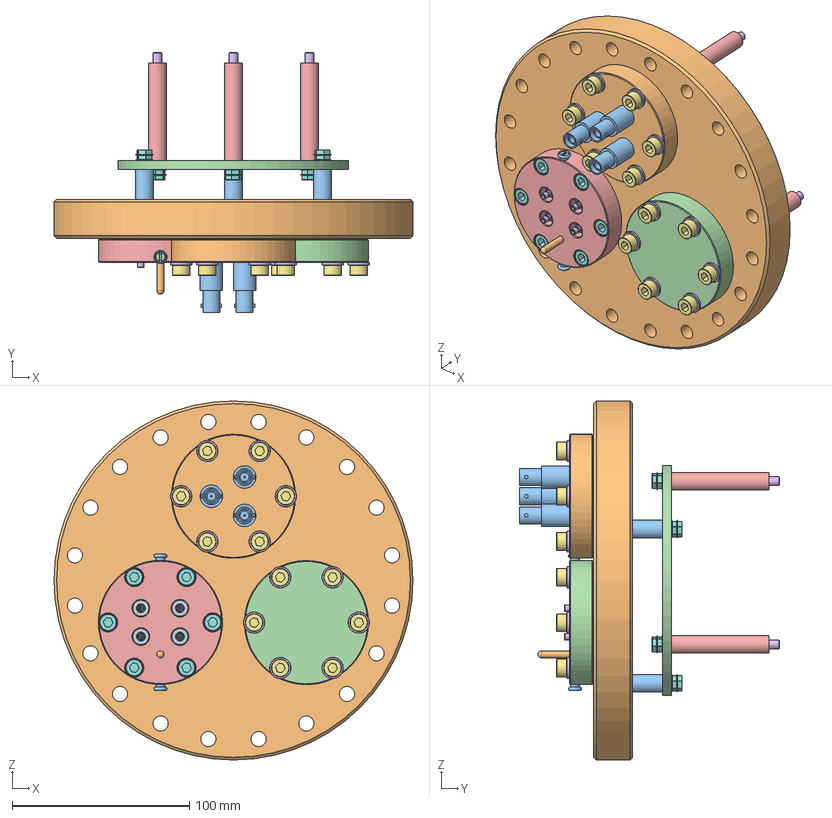
[picture p18: CAD file, 2026-05-30]
CAD/detector/dld8080_v3_ext_asm v5.step
202.4 x 146.9 x 202.4 mm
GRUNDFLANSCH_3D-DLD4040-150
STANDOFF_ALU_18X10_V2 x 3
HALTERING_3D-DLD4040-150
ABSTANDSHALTER_PEEK x 3
M5-GEWINDESTANGE_ALU x 6
M5-WASCHER_CUBE x 12
M5-MUTTER_TITAN x 12
CF40-KUPFERDICHTUNG x 3
3FACH_SHV_CF40
SHV5_SINGLE_2 x 3
CF40_BLINDFLANSCH
4FOLD_SMB_FLANSCH_RAW
SMB_METALLHUELSE x 4
SMB_KONTAKTPIN x 4
GLASHUELSE_INNEN x 4
GLASHUELSE_AUSSEN x 4
ORIENTIERUNGSPIN_ACU
BUNDOESE_METAL x 2
M3X6-SENKKOPF x 2
SMB_CABLECONNECTOR_RG178 x 4
M6_UNTERLEGSCHEIBE_VA x 12
M6X20_VA x 12
M6X18_VA_ABGEDREHT x 6
GOLDSTECKER-SHV-CC23F x 3
