peterfelfer/Oxcart/CAD/gas-thermal/baking equipment/baking lid assembly v4.step

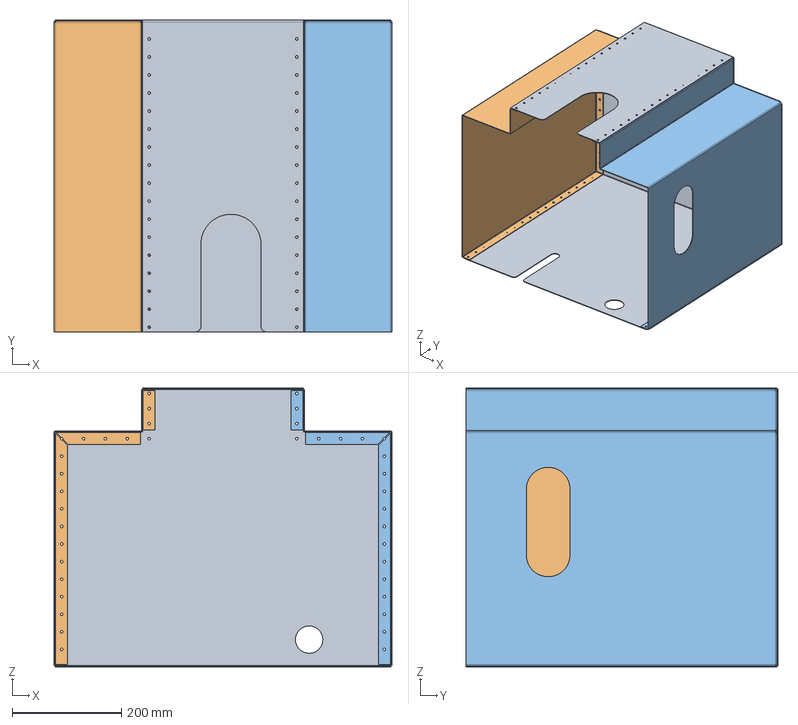
[picture p19: CAD file, 2026-05-30]
CAD/gas-thermal/baking equipment/baking lid assembly v4.step
618.0 x 570.0 x 510.0 mm
baking lid mid section
baking lid left section
baking lid right section
