peterfelfer/Oxcart/CAD/cryo/cryo LL/CryoLLMainPart Zeichnung v1 Plan1.dxf

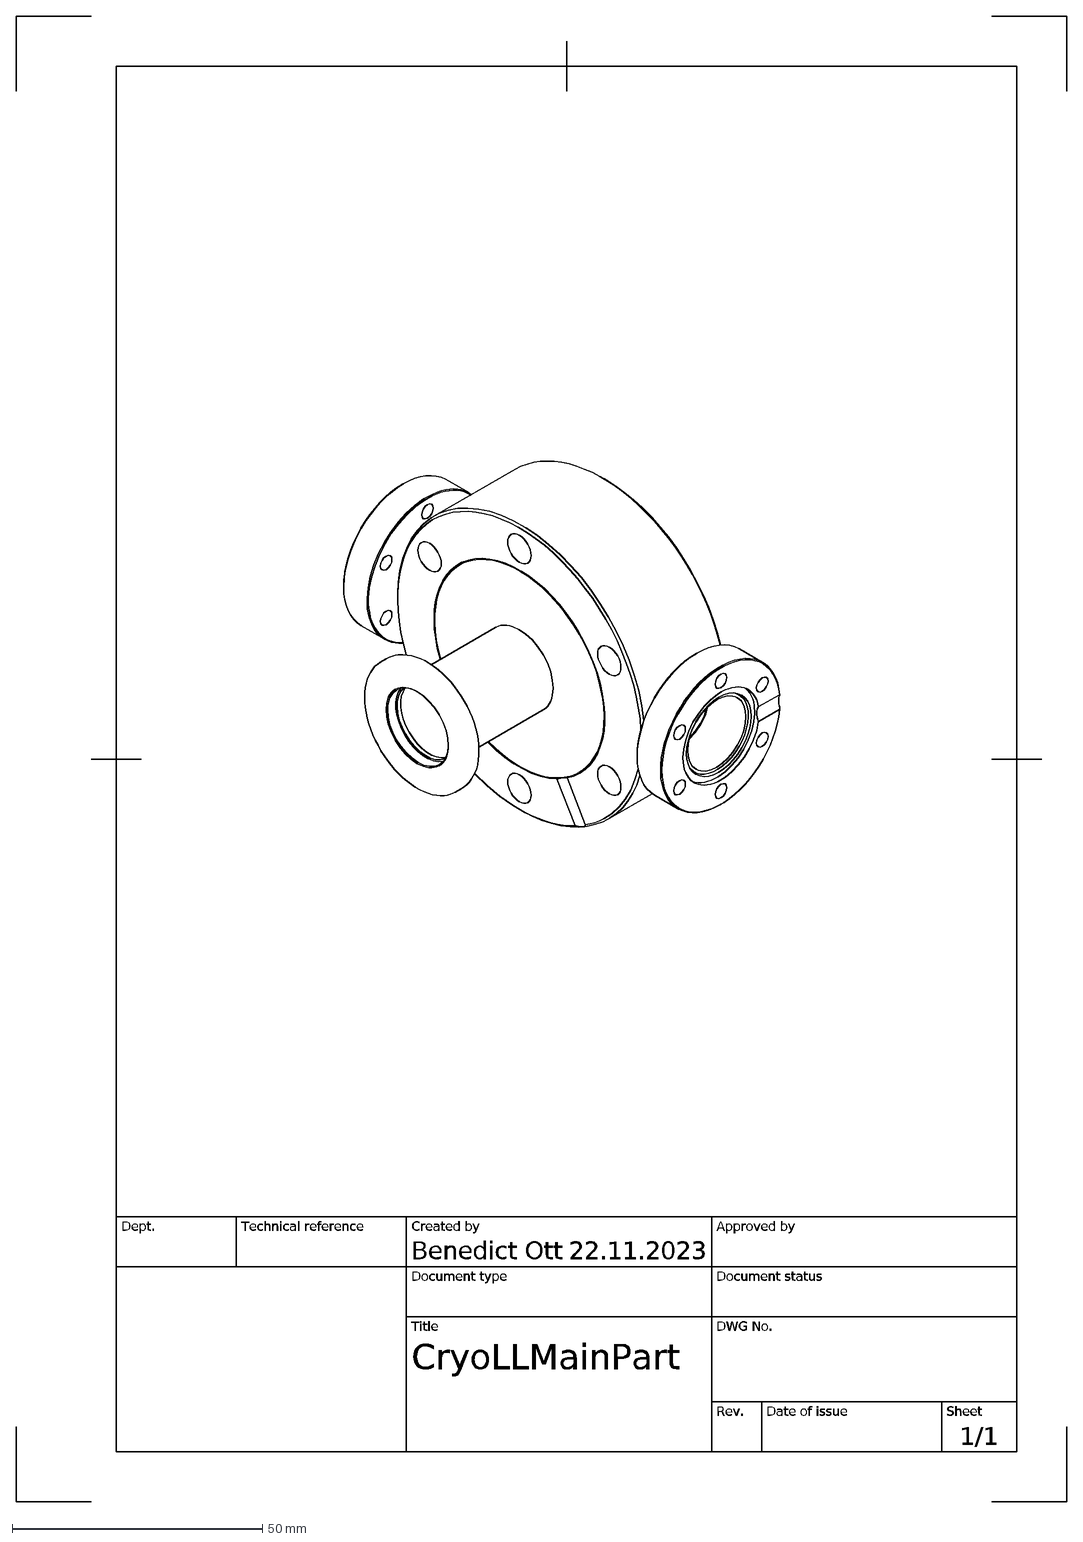
[picture p21: CAD file, 2026-05-30]
CAD/cryo/cryo LL/CryoLLMainPart Zeichnung v1 Plan1.dxf
22.11.2023
1/1
CryoLLMainPart
Benedict Ott
Dept.
Technical reference
Created by
Approved by
Document type
Document status
Title
DWG No.
Rev.
Date of issue
Sheet
