peterfelfer/Oxcart/CAD/cryo/cryo system BC/BC cryo head assembly v8.step

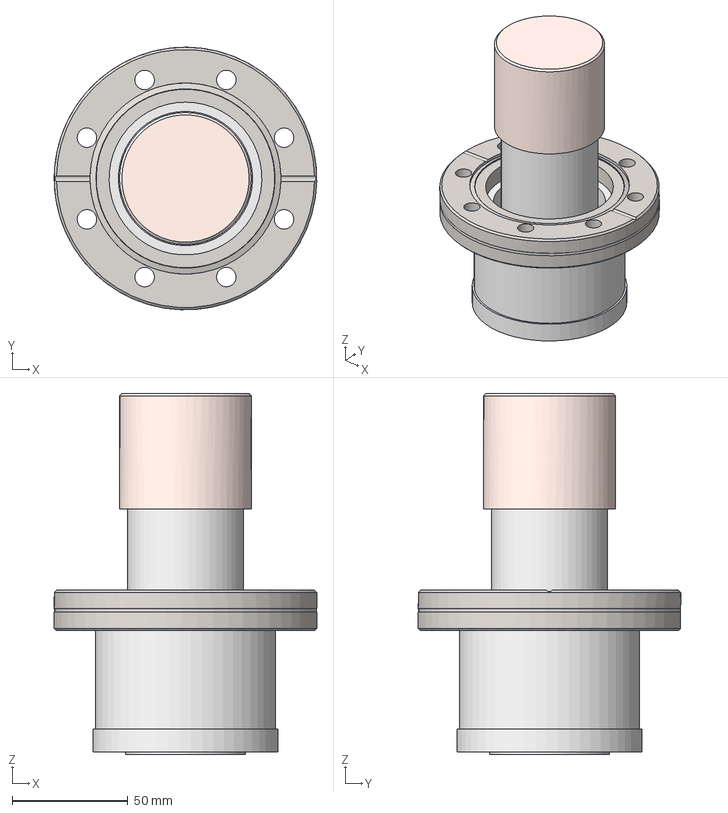
[picture p22: CAD file, 2026-05-30]
CAD/cryo/cryo system BC/BC cryo head assembly v8.step
113.5 x 113.5 x 156.0 mm
flange
thermal conductor
tube
flange (1)
