peterfelfer/Oxcart/CAD/cryo/cryo heads/cold_head_assy_ch204sb_267628d2 v1.step

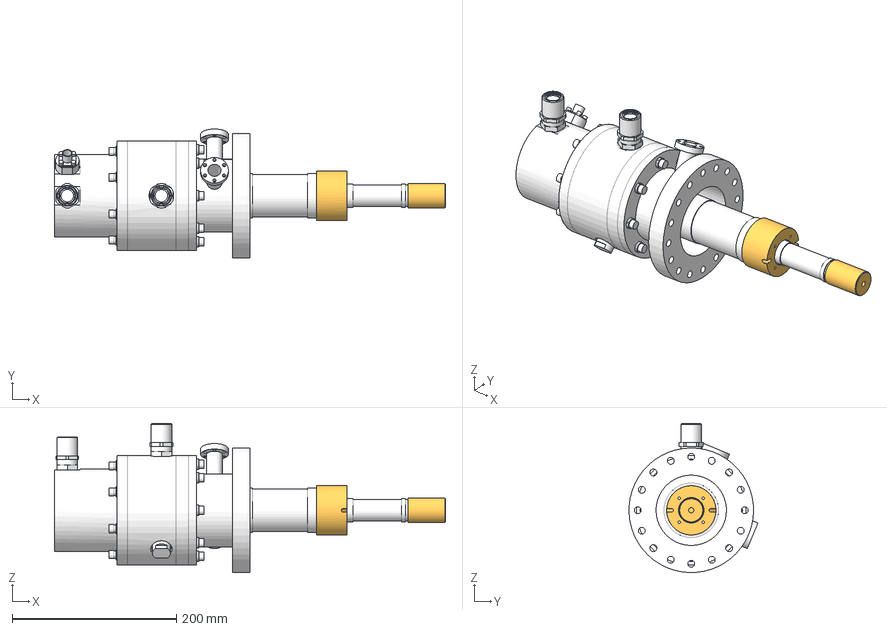
[picture p23: CAD file, 2026-05-30]
CAD/cryo/cryo heads/cold_head_assy_ch204sb_267628d2 v1.step
475.9 x 156.9 x 181.4 mm
