peterfelfer/Oxcart/CAD/cryo/cryo heads/0-12 COLDHEAD ASSEMBLY v3.step

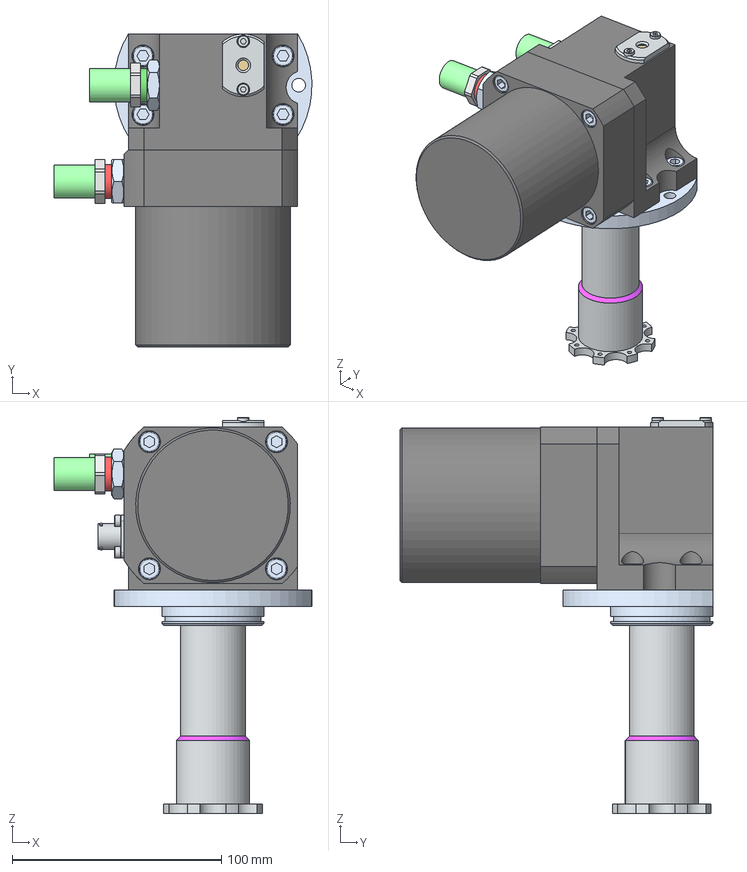
[picture p24: CAD file, 2026-05-30]
CAD/cryo/cryo heads/0-12 COLDHEAD ASSEMBLY v3.step
123.3 x 150.0 x 189.5 mm
M6 x 12 Socket Cap Head x 4
M6 x 30 Socket Cap Head x 4
1S0115 (O RING 40.95x2
1S0155 (O RING 67.0x2
1P0231 (WARNING LABEL)
1P0213 (CE LABEL)
Fillet 1-oa0
911H031A (1ST STAGE HEAT STATION 0-12))
911H040A (TUBE FLANGE)
911H000A (1ST STAGE TUBE)-oa1
M3 x 6 Socket Cap Head x 4
911H320A-B (GAS CONNECTOR) x 2
1P0284 (SELFSEAL COUP MALE 5400-S2-4) x 2
1P0284 (SELFSEAL COUP MALE 5400-S2-4) (1) x 2
1P0175 (4 WAY CONNECTOR)
1X0235 (SHRINK SLEEVE D17 PVC RED)
911H210A-C (MOTOR HOUSING)
1S0123 (O RING 9.25x1
1X0234 (SHRINK SLEEVE D17 PVC GREEN)
911H220A-D (DRIVE HOUSING)
911H360A (GAS PLUG)
99GM-VRVH-125B-435 GENERANT VALVE
M3 x 8 Socket Cap Head A4 x 2
