peterfelfer/Oxcart/CAD/optics-laser/optics/MC NEG assembly_Camera Holder v1.step

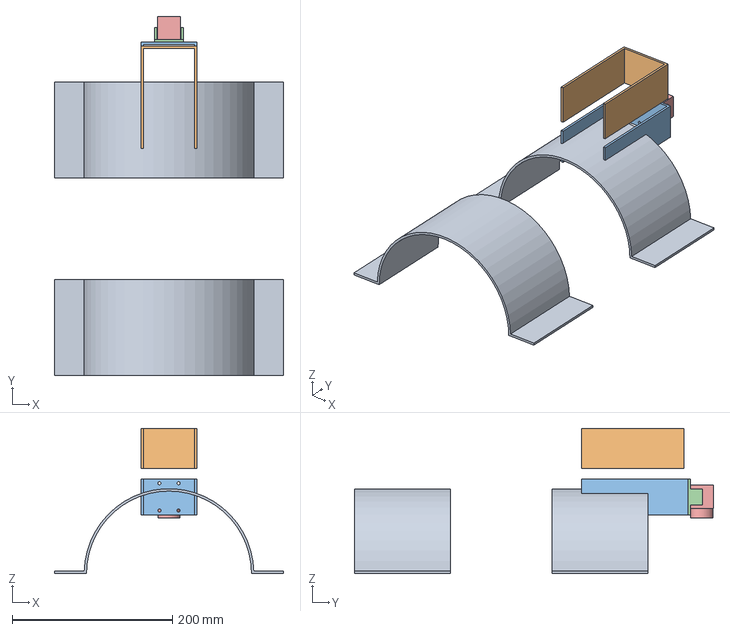
[picture p25: CAD file, 2026-05-30]
CAD/optics-laser/optics/MC NEG assembly_Camera Holder v1.step
286.0 x 448.4 x 181.3 mm
