peterfelfer/Oxcart/CAD/sample-handling/BC LL parts/specimen carousel assembly Drawing v2 Sheet1.dxf

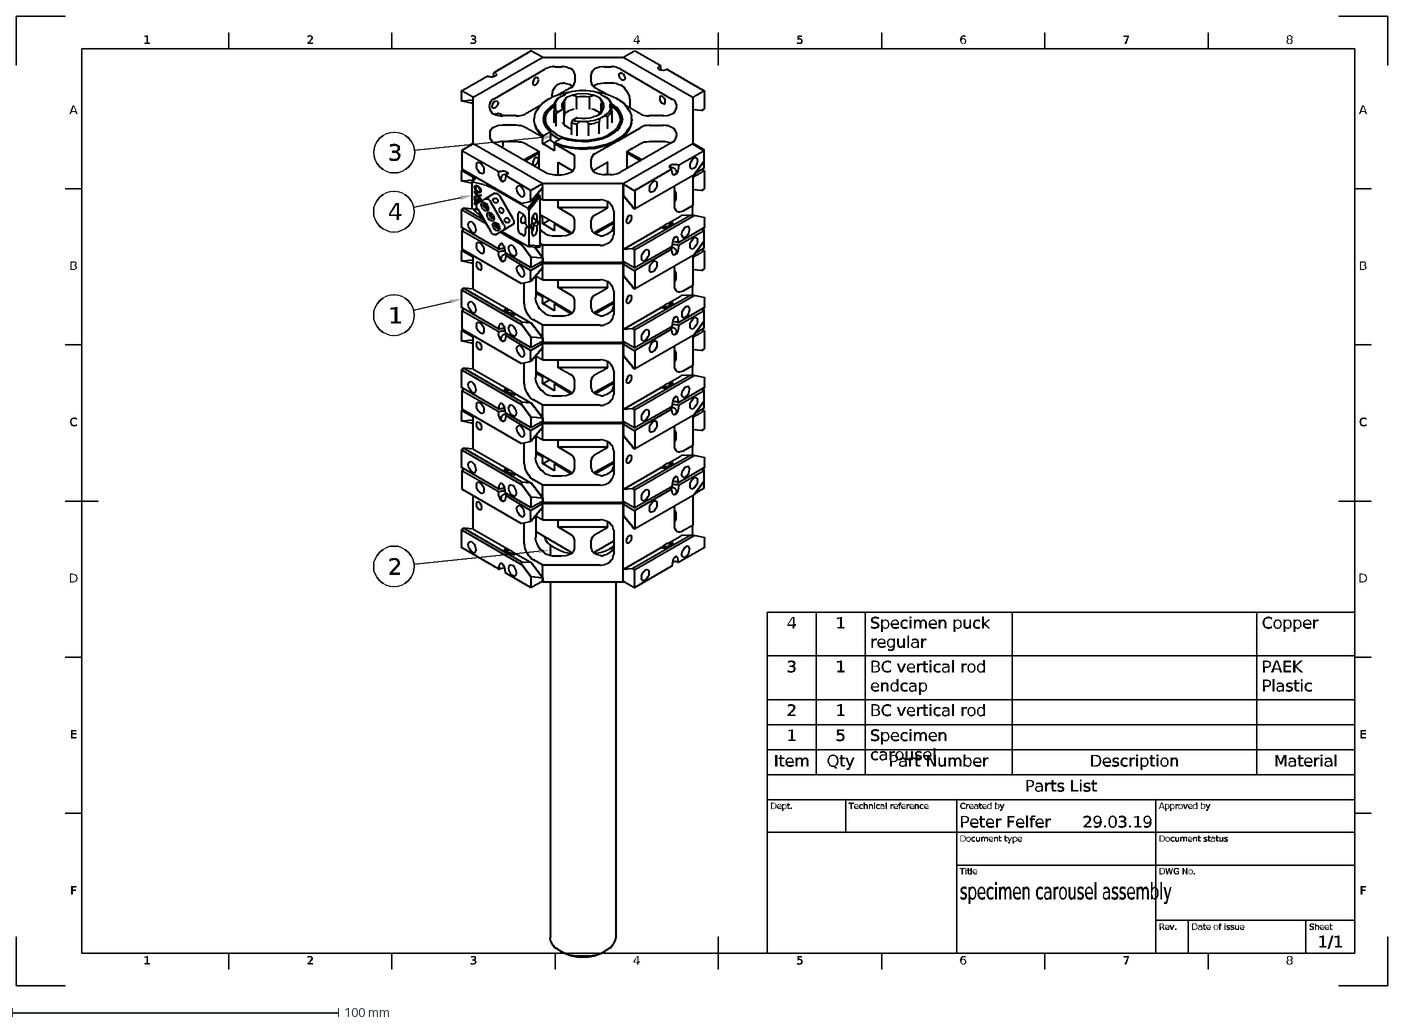
[picture p26: CAD file, 2026-05-30]
CAD/sample-handling/BC LL parts/specimen carousel assembly Drawing v2 Sheet1.dxf
29.03.19
1/1
specimen carousel assembly
Peter Felfer
Dept.
Technical reference
Created by
Approved by
Document type
Document status
Title
DWG No.
Rev.
Date of issue
Sheet
Parts List
Item
Qty
Part Number
Description
Material
1
5
Specimen carousel
2
BC vertical rod
3
BC vertical rod endcap
PAEK Plastic
4
Specimen puck regular
Copper
A
6
7
8
B
C
D
E
F
