peterfelfer/Oxcart/CAD/sample-handling/BC LL parts/specimen carousel assembly v22.step

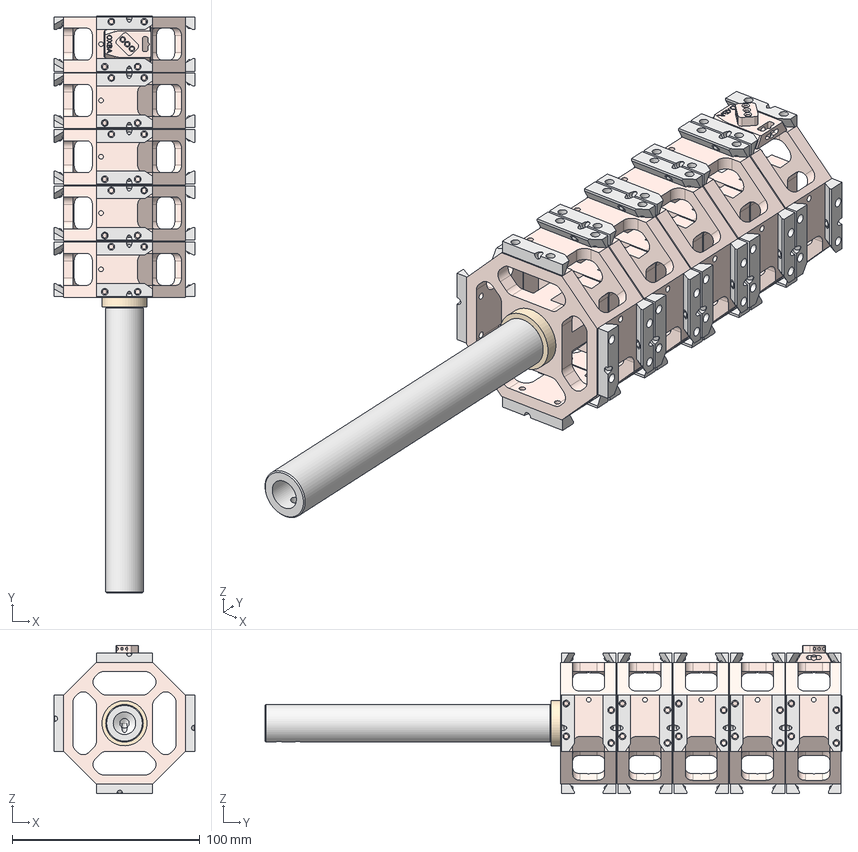
[picture p27: CAD file, 2026-05-30]
CAD/sample-handling/BC LL parts/specimen carousel assembly v22.step
75.0 x 307.5 x 79.0 mm
K0333_03_0 x 40
carousel x 5
rail x 20
rail lower x 20
vespel spacer x 4
vertical rod
peek insulator
BC vertical rod endcap
specimen puck regular
