peterfelfer/Oxcart/CAD/sample-handling/sample stage - pucks/stage assembly v116.step

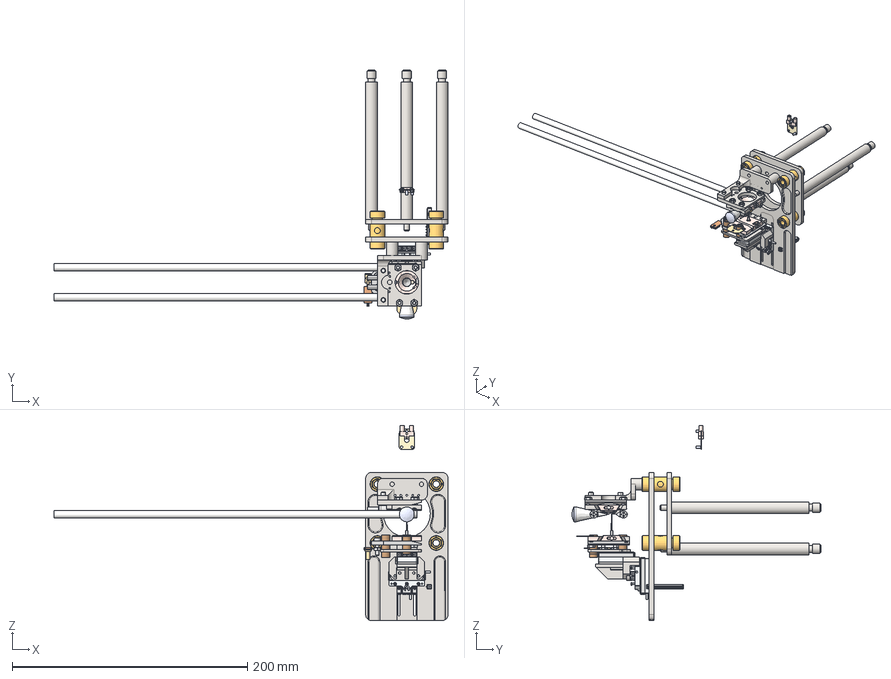
[picture p28: CAD file, 2026-05-30]
CAD/sample-handling/sample stage - pucks/stage assembly v116.step
335.0 x 211.7 x 166.0 mm
bottom plate
top plate
vespel seperator x 4
vespel spacer x 8
outer spacer x 3
vespel spacer_1 x 2
sapphire plate
contact clamp
pressure clamp
backplate
other vespel spacer x 2
even more vespel spacers
vespel bolt
HV connection
specimen puck
dummy sample
piezo adapter plate_1
ES-0000728-Rail SVS1_FNB-SVS1030_1 x 4
ES-0000705-Cage RK1_FNB-RK17-8Z_1 x 4
IS-0006589-NBS_NBS-M1,6x5-St_1 x 12
EX--Baseplate GLC-SLC_SLC-1730 x 2
EX-0009723-000-XYZ-SLC-1730 Slide x 2
EX-0010051-Baseplate SLC17-S-M-L_00_Parent
ES-0000728-Rail SVS1_FNB-SVS1030 x 2
ES-0000705-Cage RK1_FNB-RK17-8Z x 2
ES-0000810-Slide WS1_WS1030
IS-0006589-NBS_NBS-M1,6x5-St x 6
EX-0009723-000-XYZ-SLC-1730 z connector
EX-0009723-000-XYZ-SLC-1730 z base plate
mutter_din934_m3-10 x 5
stage standoffs x 3
pressure clamp_1
contact clamp_1
titanium plate
bracket new
schraube_din_7991-m3x10-a2-70 x 4
K0333_03_0
fhc4x10efa2 x 2
SMB plug holder
SMB electrode puck
SMB plug
smb electrode insulators x 2
electrode v2
smb electrode top ground
Lakeshore DT 670 SD Omega CY 670 SD
insulator bottom
insulator top
Lakeshore CO clamp
pn11610117 x 2
schraube_iso_4762-m3x12-10_9 x 2
mirror
primary beam
reflected beam
mirror(Mirror) (1)
primary beam(Mirror)
reflected beam(Mirror)
LA4936
