peterfelfer/Oxcart/CAD/cryo/cryo system MC/cryo interface assembly v29.step

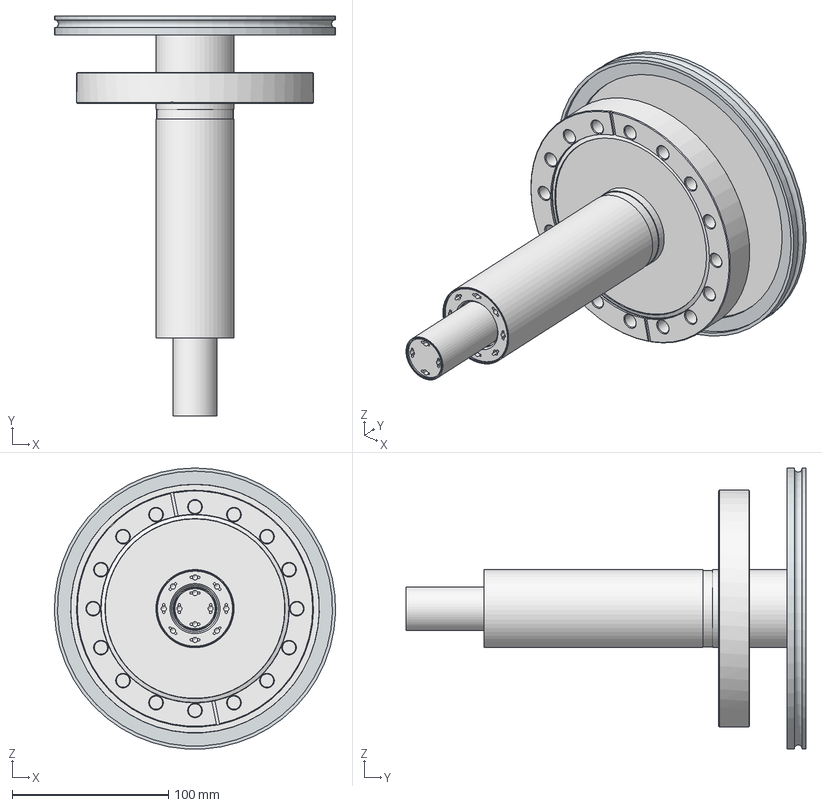
[picture p29: CAD file, 2026-05-30]
CAD/cryo/cryo system MC/cryo interface assembly v29.step
179.9 x 256.0 x 179.8 mm
Hositrad_CF100-B v2
stage 2 connector
bottom tube (28 x 0,6)
stage 1 connector
top tube (50 x 0,5)
toppest tube (50 x 2)
connector plate
VAb_SF 160-K v1
