peterfelfer/Oxcart/CAD/vacuum/vacuum parts/Hositrad_FS35-38-FullNipple v1.step

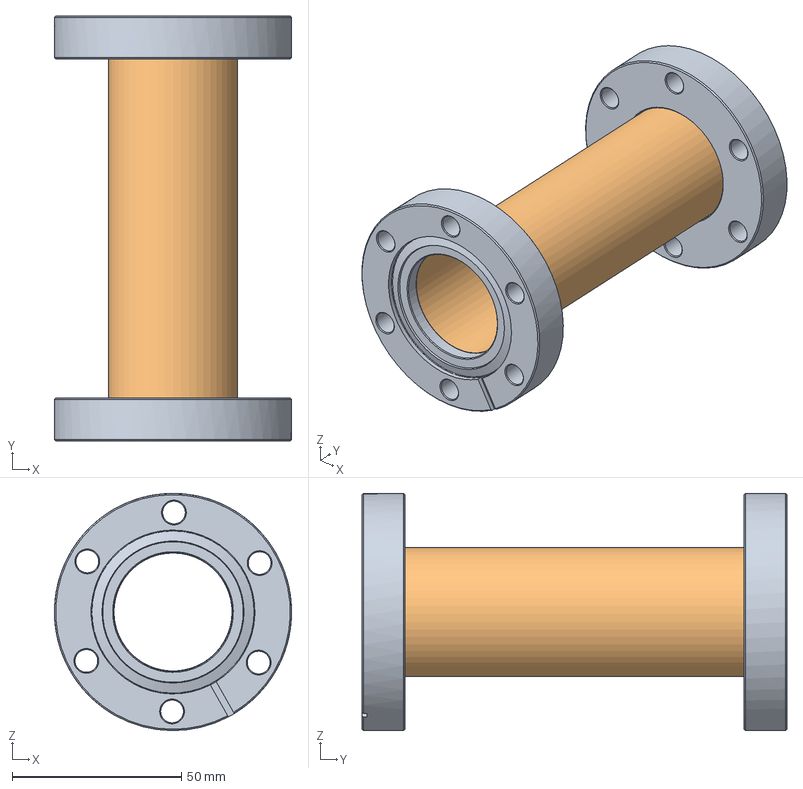
[picture p30: CAD file, 2026-05-30]
CAD/vacuum/vacuum parts/Hositrad_FS35-38-FullNipple v1.step
70.0 x 125.4 x 70.0 mm
NW35CF-Weld-38 x 2
Tube38
