peterfelfer/Oxcart/CAD/sample-handling/sample stage - pucks/electrode puck v2 assembly v12.step

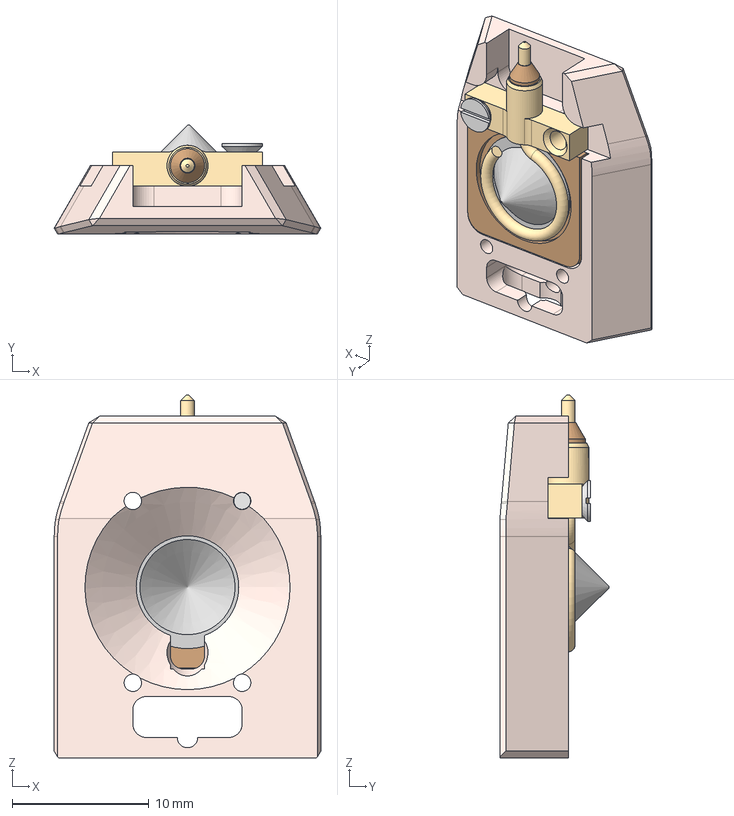
[picture p31: CAD file, 2026-05-30]
CAD/sample-handling/sample stage - pucks/electrode puck v2 assembly v12.step
19.5 x 7.98 x 26.6 mm
main gnd
dielectric
conductor
electrode puck v2
electrode v2 x 2
electrode puck v2 insulation
din_en_iso_2009_-_ke_m1_6_x_4_-_st
