peterfelfer/Oxcart/CAD/sample-handling/sample stage - pucks/SMB electrode assembly v42.step

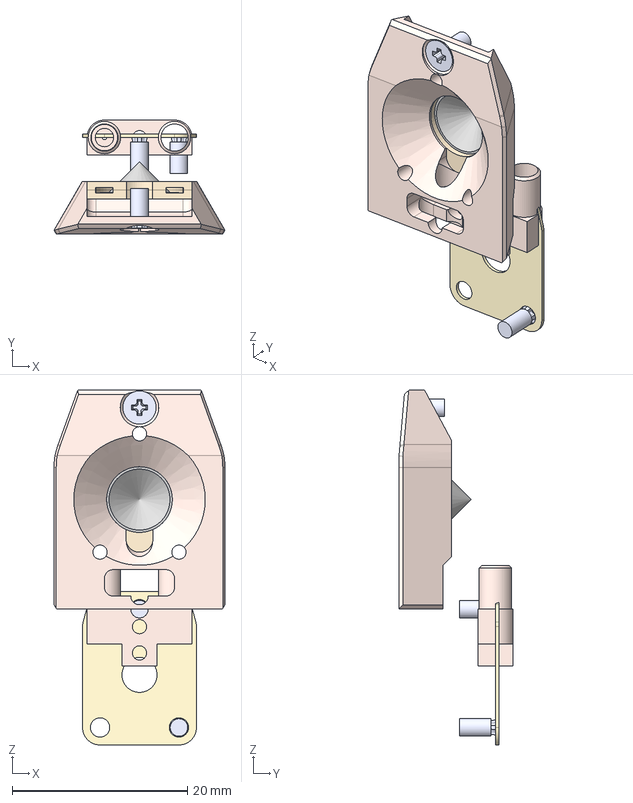
[picture p32: CAD file, 2026-05-30]
CAD/sample-handling/sample stage - pucks/SMB electrode assembly v42.step
19.5 x 13.0 x 40.5 mm
SMB electrode puck
SMB plug
smb electrode insulators x 2
electrode v2
smb electrode top ground
