peterfelfer/Oxcart/CAD/vacuum/vacuum parts/Hositrad_FS150-154R-FullNipple v1.step

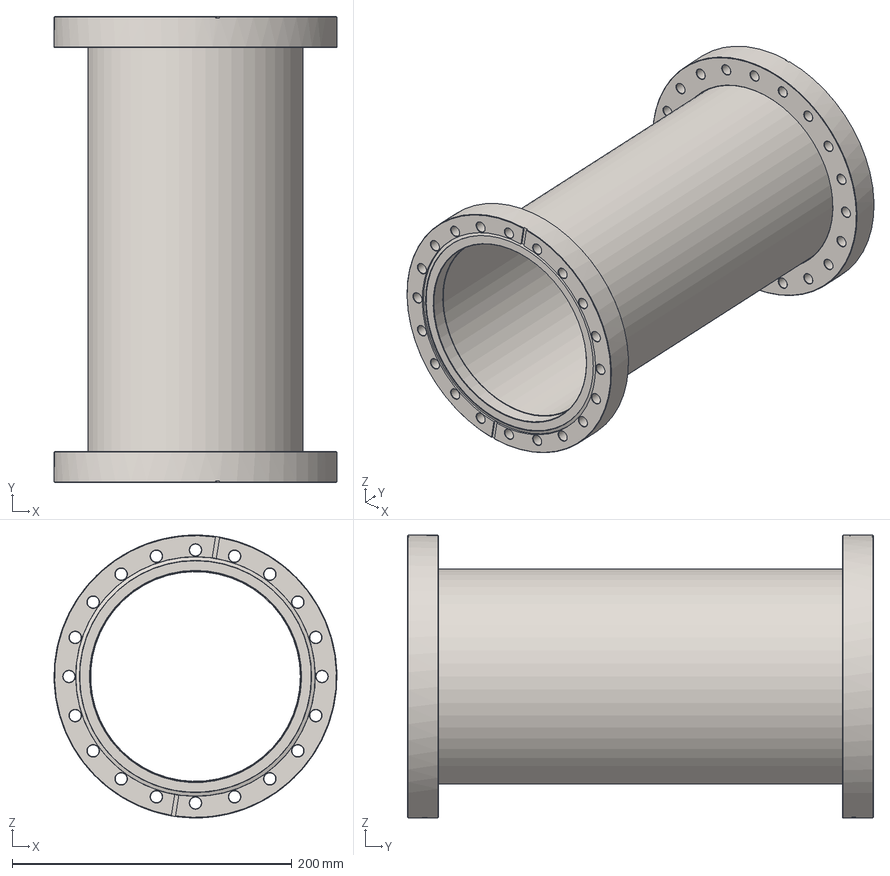
[picture p33: CAD file, 2026-05-30]
CAD/vacuum/vacuum parts/Hositrad_FS150-154R-FullNipple v1.step
202.4 x 333.4 x 202.4 mm
NW150CF-Weld_CF150-154
NW150CF-R-InnerWeld_-154
NW150CF-R-OuterWeld_-154
Tube 154-All_Tube 154 L=333,4-25,4
