peterfelfer/Oxcart/CAD/vacuum/vacuum parts/Hositrad_FS100-102R-FullNipple v1.step

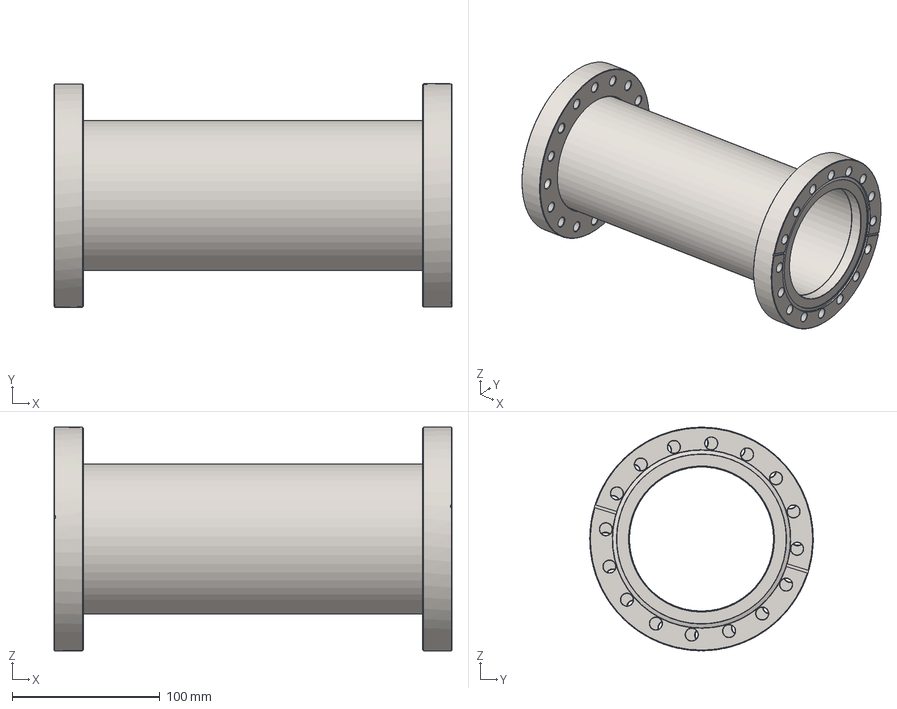
[picture p34: CAD file, 2026-05-30]
CAD/vacuum/vacuum parts/Hositrad_FS100-102R-FullNipple v1.step
269.8 x 151.6 x 151.6 mm
Tube101.6-All_Tube 101
NW100CF-weld_CF100-102
NW100CF-R-Outerring_CF100-108
NW100CF-R-InnerWeld_CF100-102
