peterfelfer/Oxcart/CAD/3d-print/3D-Print Oxcart/Emergency switch mount v2.step

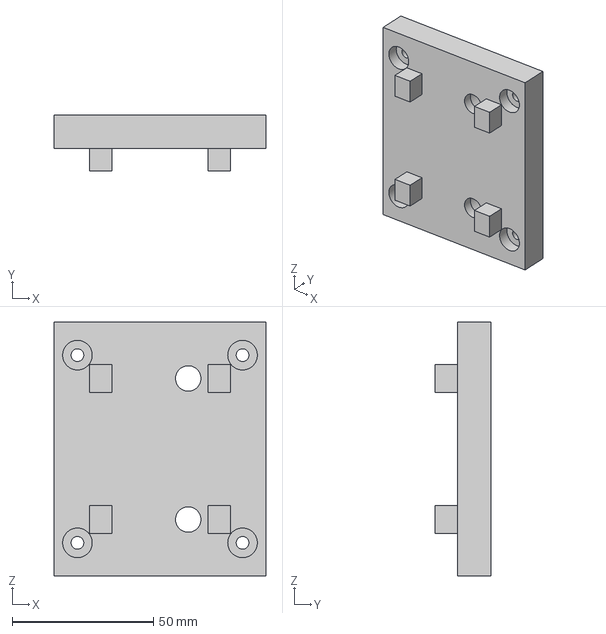
[picture p35: CAD file, 2026-05-30]
CAD/3d-print/3D-Print Oxcart/Emergency switch mount v2.step
75.0 x 20.0 x 90.0 mm
