peterfelfer/Oxcart/CAD/cryo/cryo LL/KF16Flange v1.step

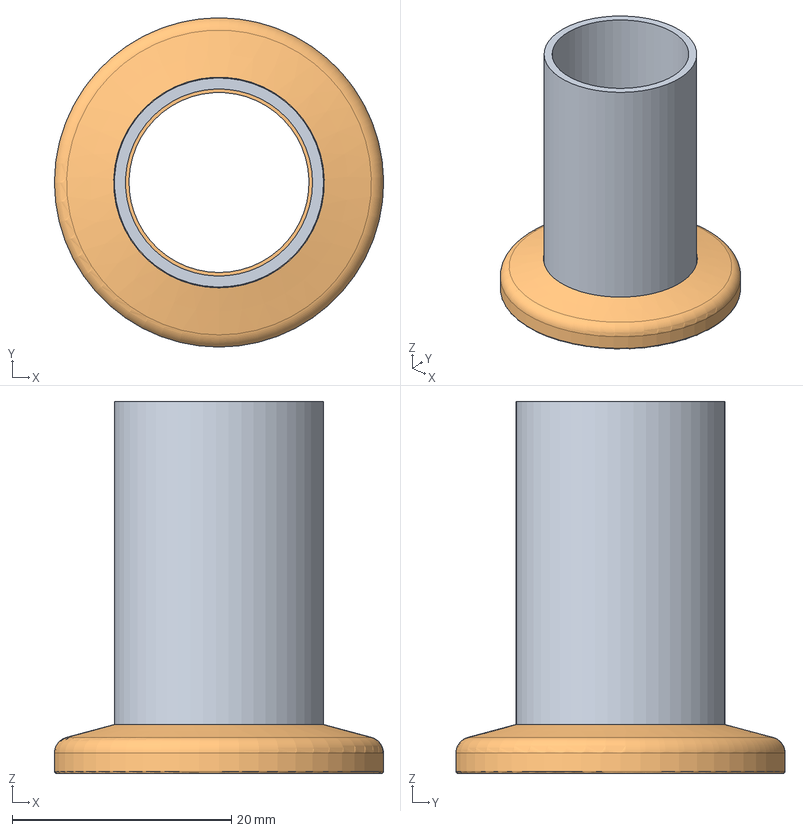
[picture p36: CAD file, 2026-05-30]
CAD/cryo/cryo LL/KF16Flange v1.step
30.0 x 30.0 x 33.9 mm
CF-To-KF-Adaptors-All_CFA16-KF16
KF16-19WS_KF16-19
NW16CF-Outerring
NW16CF-Innerring_CF16-19-R
