peterfelfer/Oxcart/CAD/cryo/cryo system MC/CAM/B-table and Collet v2.step

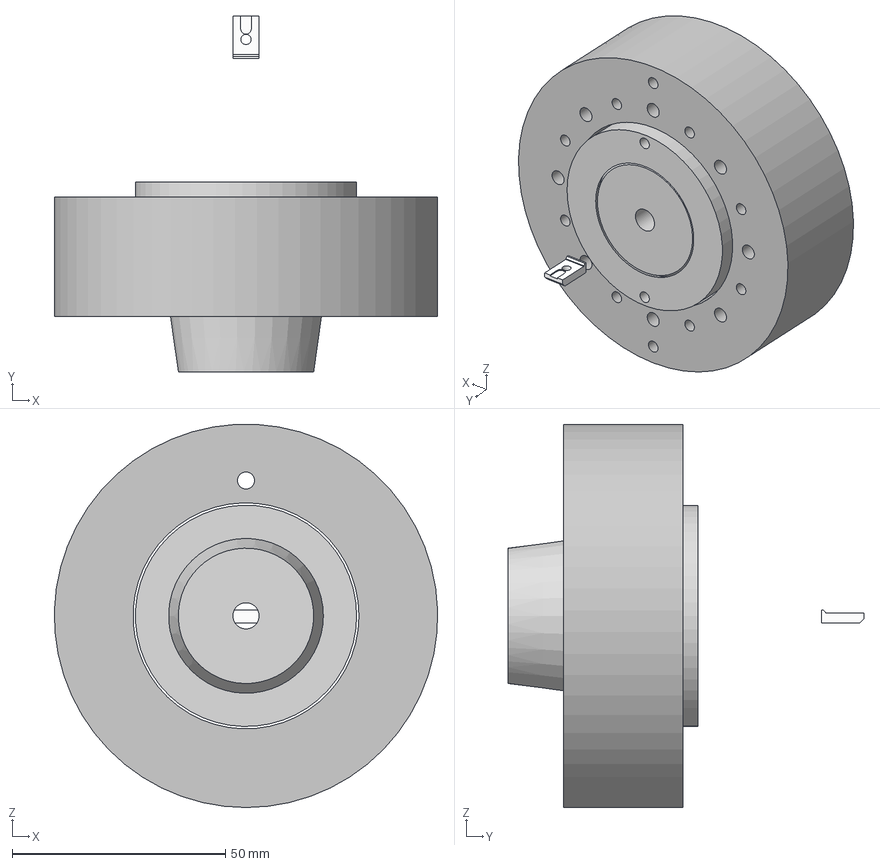
[picture p37: CAD file, 2026-05-30]
CAD/cryo/cryo system MC/CAM/B-table and Collet v2.step
89.9 x 83.5 x 89.9 mm
Collet Bottom Taper
Collet Top Taper
ER-40 Collet Generic v1
V2PocketNC kinematic Bdisc v4
CY7 diode clamp
