peterfelfer/Oxcart/CAD/cryo/cryo system MC/cryo interface v3 Drawing v20 Sheet8.dxf

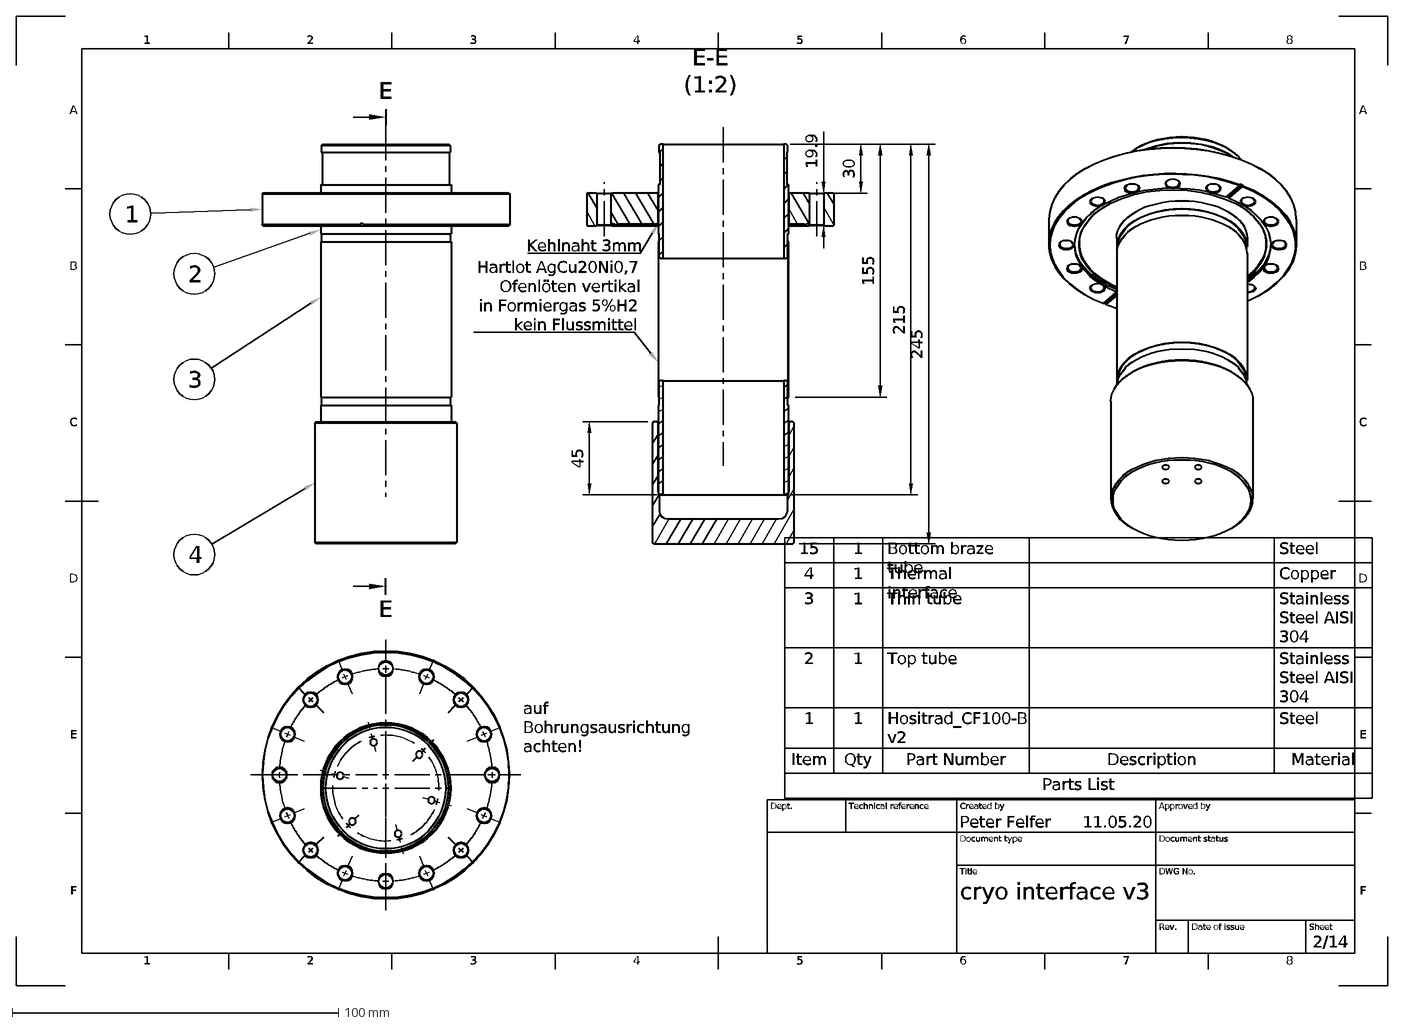
[picture p38: CAD file, 2026-05-30]
CAD/cryo/cryo system MC/cryo interface v3 Drawing v20 Sheet8.dxf
11.05.20
2/14
cryo interface v3
Peter Felfer
Dept.
Technical reference
Created by
Approved by
Document type
Document status
Title
DWG No.
Rev.
Date of issue
Sheet
1
A
2
3
4
5
6
7
8
B
C
D
E
F
E-E (1:2)
215
Kehlnaht 3mm
45
Hartlot AgCu20Ni0,7
Ofenlöten vertikal
in Formiergas 5%H2
kein Flussmittel
245
30
Parts List
Item
Qty
Part Number
Description
Material
Hositrad_CF100-B v2
Steel
Top tube
Stainless Steel AISI 304
Thin tube
Thermal interface
Copper
15
Bottom braze tube
auf Bohrungsausrichtung achten!
155
19.9
