peterfelfer/Oxcart/CAD/cryo/cryo system MC/Metallicflex/Federkörper v8.step

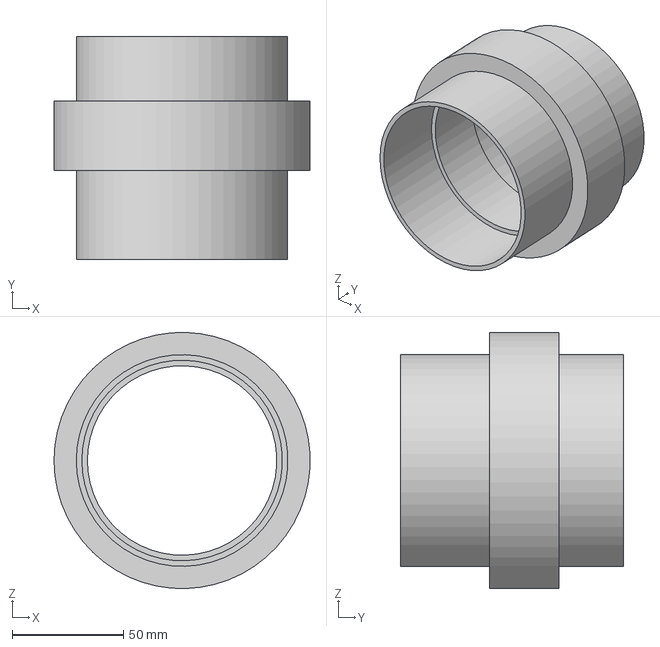
[picture p39: CAD file, 2026-05-30]
CAD/cryo/cryo system MC/Metallicflex/Federkörper v8.step
114.9 x 100.0 x 115.0 mm
