peterfelfer/Oxcart/CAD/detector/Detector CF200 v4.step

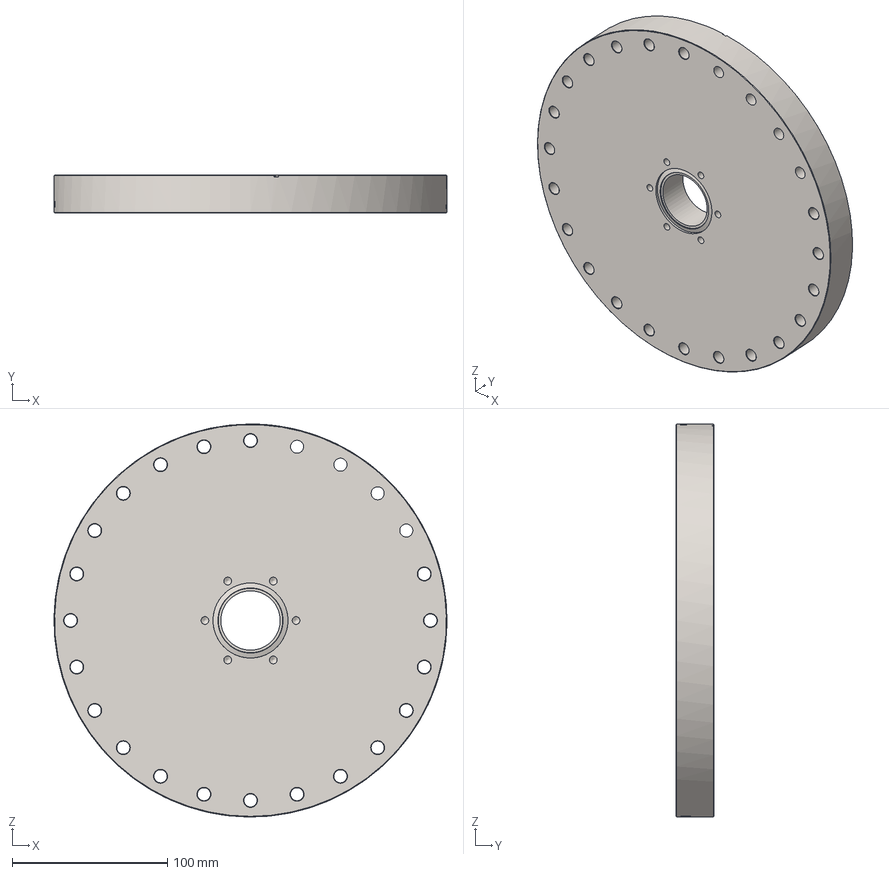
[picture p40: CAD file, 2026-05-30]
CAD/detector/Detector CF200 v4.step
253.2 x 24.6 x 253.2 mm
