peterfelfer/Oxcart/CAD/electronics/electrical and electronics/CNC/lid v1.step

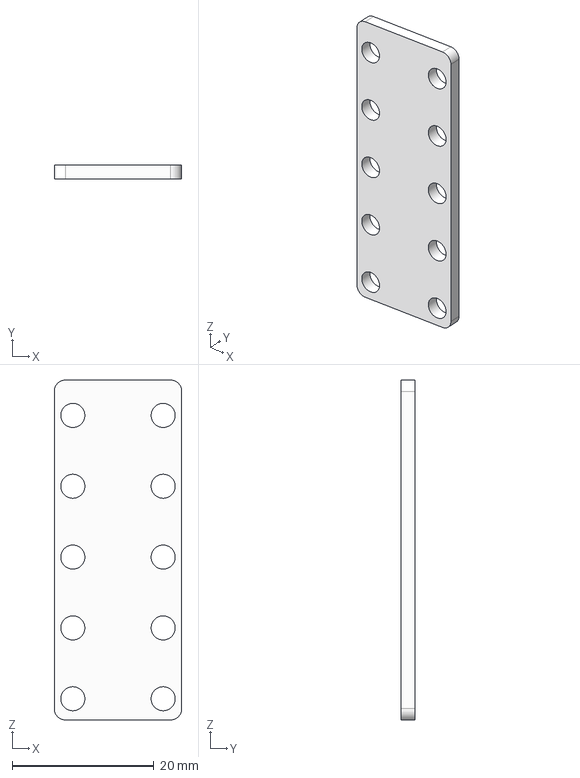
[picture p41: CAD file, 2026-05-30]
CAD/electronics/electrical and electronics/CNC/lid v1.step
18.0 x 2.00 x 48.0 mm
