peterfelfer/Oxcart/CAD/electronics/electrical and electronics/pulse pick-off v3.step

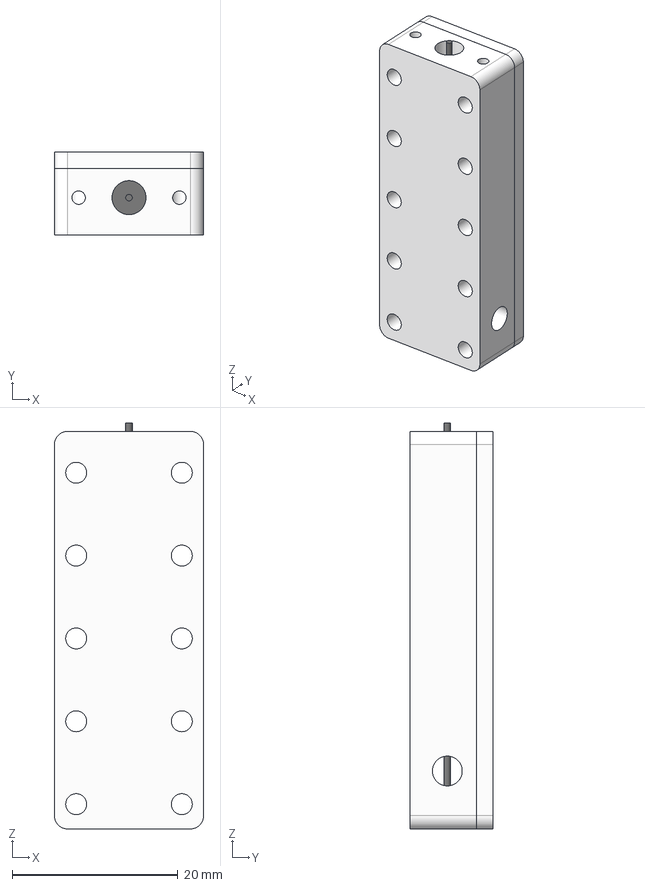
[picture p42: CAD file, 2026-05-30]
CAD/electronics/electrical and electronics/pulse pick-off v3.step
18.0 x 10.0 x 49.0 mm
case
lid
resistor
