peterfelfer/Oxcart/CAD/frame/Frame components/frame bottom v9.step

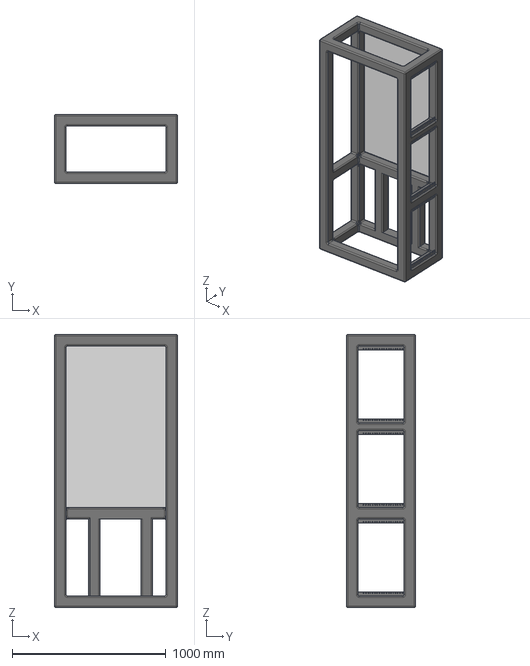
[picture p43: CAD file, 2026-05-30]
CAD/frame/Frame components/frame bottom v9.step
800.0 x 450.0 x 1775.0 mm
instrument frame
dust cover
