peterfelfer/Oxcart/CAD/gas-thermal/gas charging devices/deuterium pump/deuterium compression device Schraubplatte Kolben Zeichnung v2 Plan1.dxf

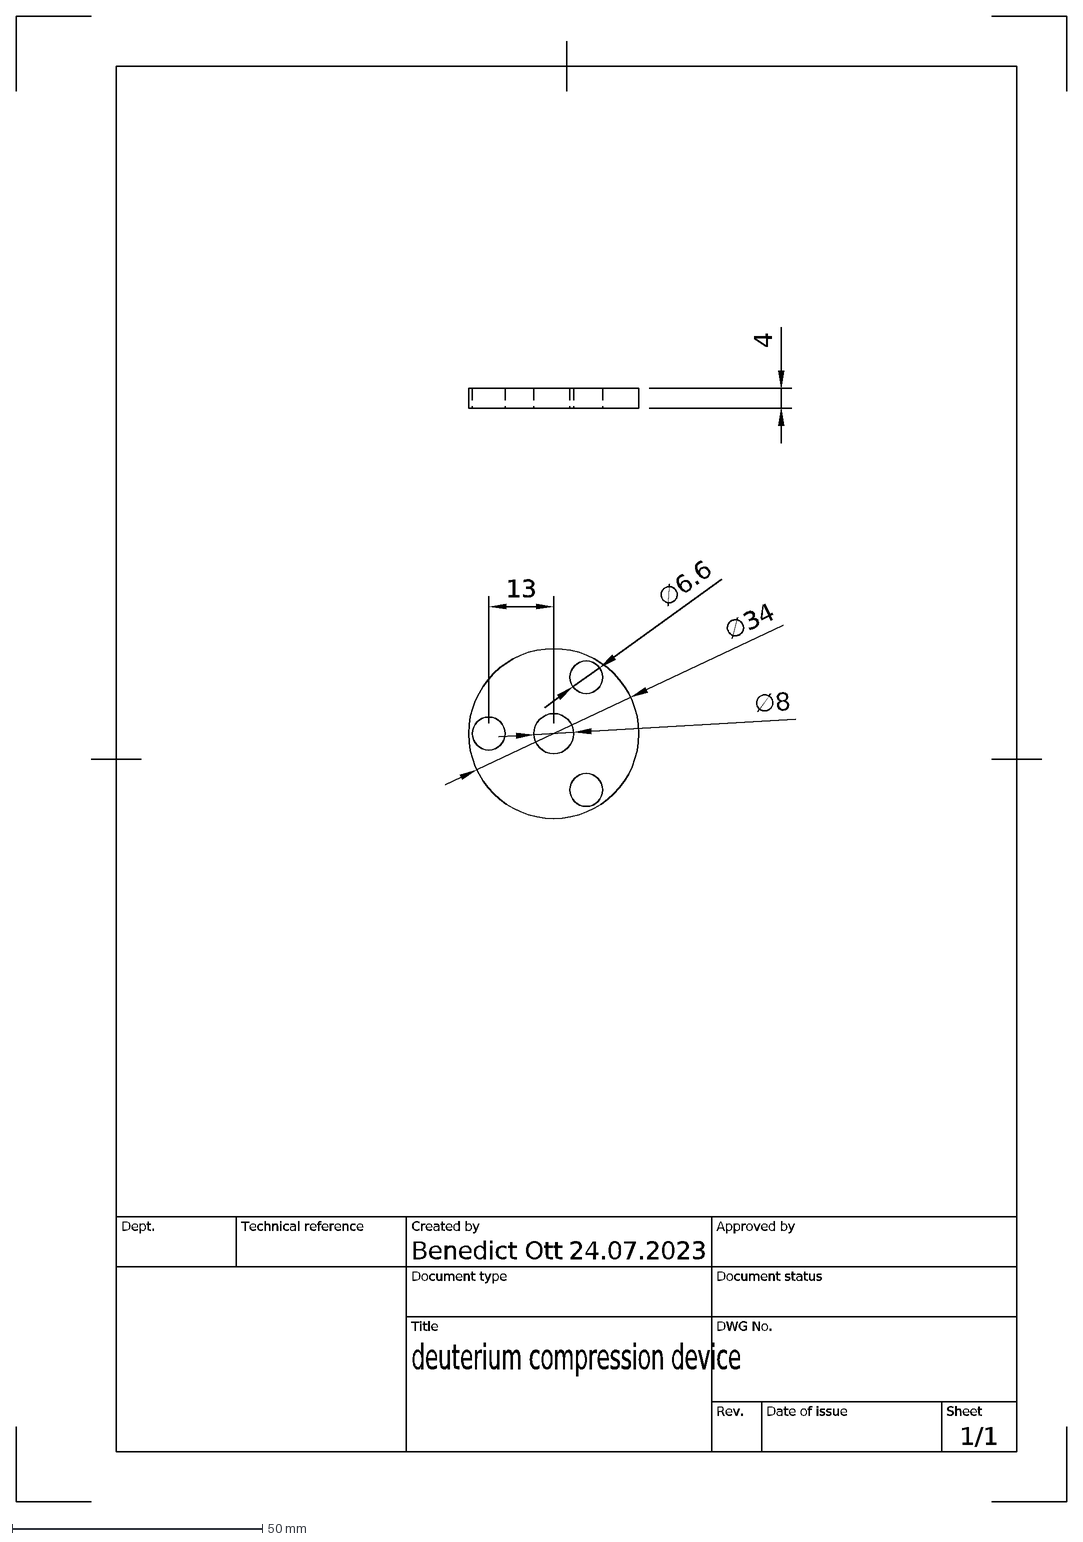
[picture p44: CAD file, 2026-05-30]
CAD/gas-thermal/gas charging devices/deuterium pump/deuterium compression device Schraubplatte Kolben Zeichnung v2 Plan1.dxf
24.07.2023
1/1
deuterium compression device
Benedict Ott
Dept.
Technical reference
Created by
Approved by
Document type
Document status
Title
DWG No.
Rev.
Date of issue
Sheet
∅34
∅8
∅6.6
4
13
