peterfelfer/Oxcart/CAD/gas-thermal/gas charging devices/gasChargingCartridge/V2/W3ZR16 v1.step

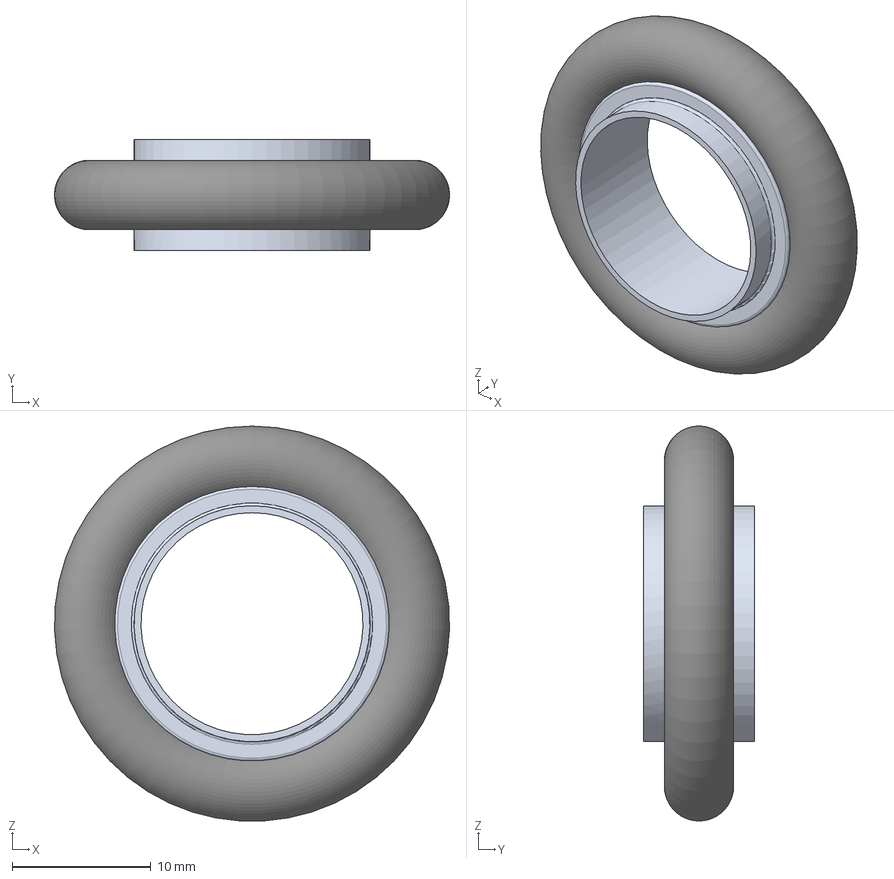
[picture p46: CAD file, 2026-05-30]
CAD/gas-thermal/gas charging devices/gasChargingCartridge/V2/W3ZR16 v1.step
28.5 x 8.00 x 28.5 mm
W3ZR16_1
O-Ring_18,5
