peterfelfer/Oxcart/CAD/gas-thermal/gas charging devices/gasChargingCube/Hositrad_CF16-B_RuptureDisc v18.step

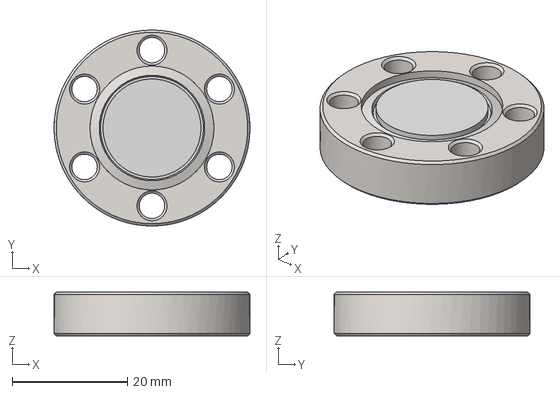
[picture p47: CAD file, 2026-05-30]
CAD/gas-thermal/gas charging devices/gasChargingCube/Hositrad_CF16-B_RuptureDisc v18.step
34.0 x 34.0 x 7.60 mm
Rupture Disc
