peterfelfer/Oxcart/CAD/gas-thermal/gas charging devices/gasChargingFlashBang/Hositrad_CF16-B_SwagelokTube v1.step

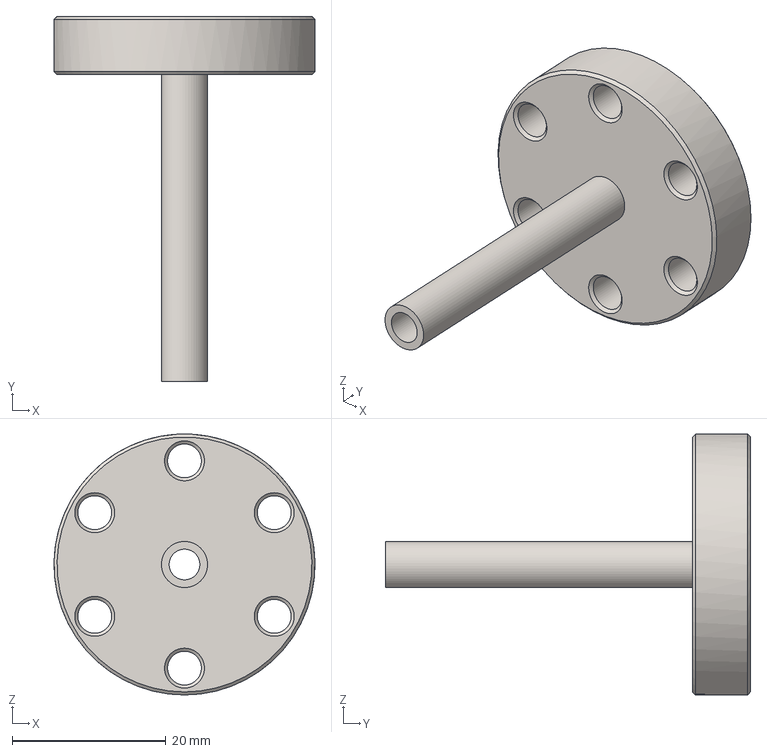
[picture p48: CAD file, 2026-05-30]
CAD/gas-thermal/gas charging devices/gasChargingFlashBang/Hositrad_CF16-B_SwagelokTube v1.step
34.0 x 47.6 x 34.0 mm
