peterfelfer/Oxcart/CAD/gas-thermal/gas charging devices/gasChargingHandgrenade/gasChargingHandgrenade v7.step

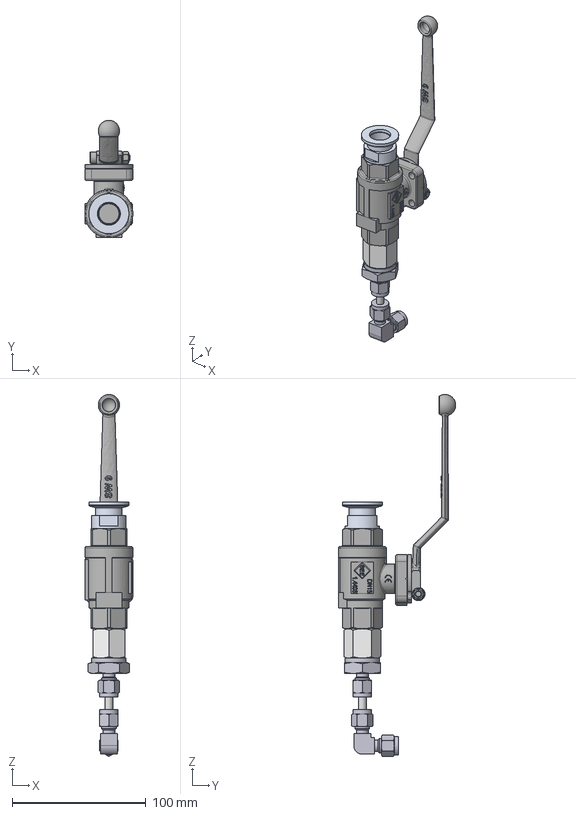
[picture p49: CAD file, 2026-05-30]
CAD/gas-thermal/gas charging devices/gasChargingHandgrenade/gasChargingHandgrenade v7.step
36.3 x 88.0 x 271.2 mm
Komponente1
Komponente2
cryo nipple v2 v2 v1
W3ES16-1I2
SS-6M0-1-8RS-SwagelokCompany-3D-04-11-2023
rn1212es12623
SwagelokTube_1
SS-6M0-9-SwagelokCompany-3D-04-12-2023
