peterfelfer/Oxcart/CAD/gas-thermal/gas charging devices/gasSupplyParts/3d_23x.50.063_radial_en_co v2.step

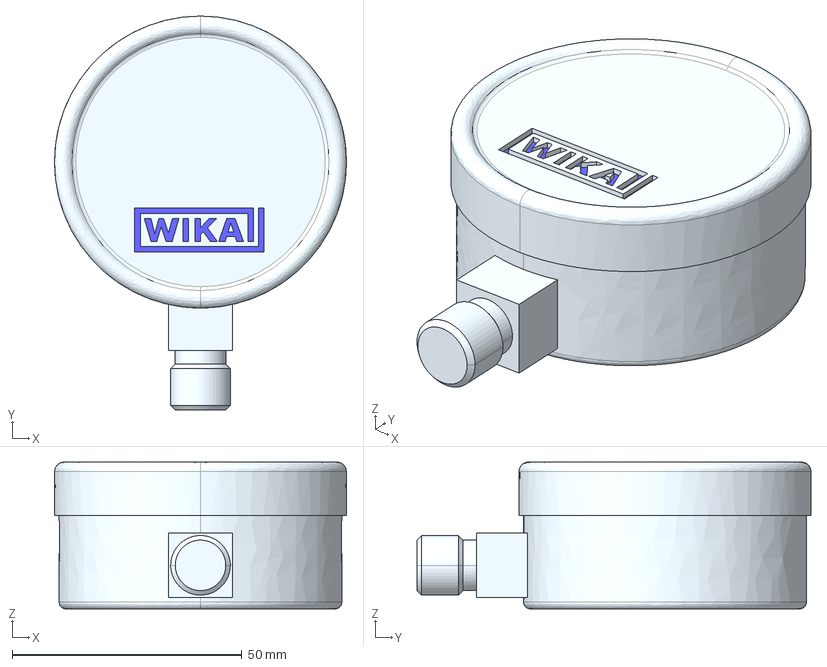
[picture p50: CAD file, 2026-05-30]
CAD/gas-thermal/gas charging devices/gasSupplyParts/3d_23x.50.063_radial_en_co v2.step
63.6 x 85.8 x 32.0 mm
