peterfelfer/Oxcart/CAD/gas-thermal/gas charging devices/Probe in Doppelnippel_new v2 v4 v1.step

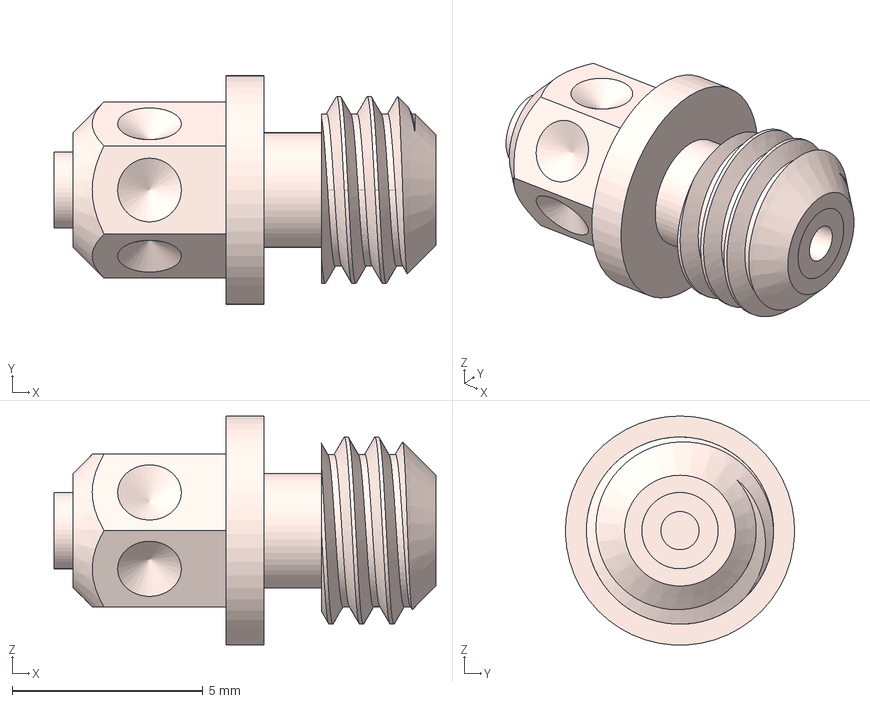
[picture p51: CAD file, 2026-05-30]
CAD/gas-thermal/gas charging devices/Probe in Doppelnippel_new v2 v4 v1.step
10.0 x 6.00 x 5.99 mm
Komponente1
Komponente2
cryo nipple v2 v2 v1
