peterfelfer/Oxcart/CAD/gas-thermal/lamp holder/lamp holder v5.step

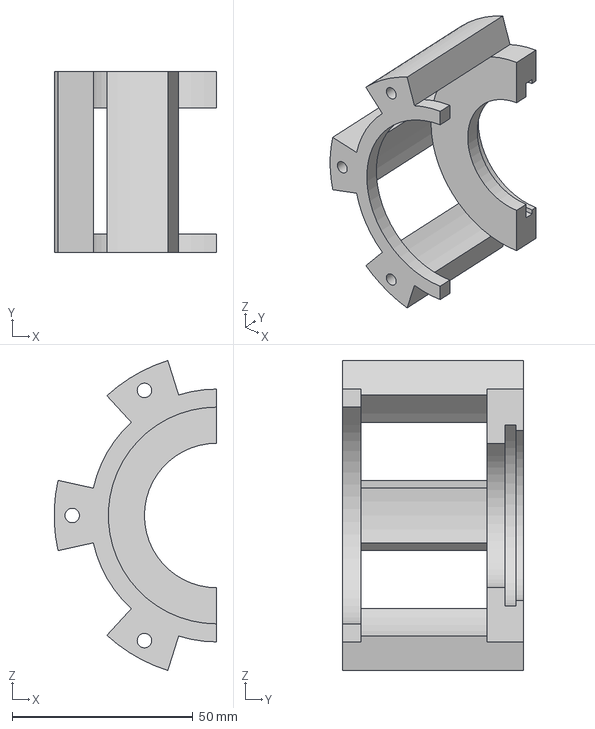
[picture p52: CAD file, 2026-05-30]
CAD/gas-thermal/lamp holder/lamp holder v5.step
45.0 x 50.0 x 85.8 mm
