peterfelfer/Oxcart/CAD/machining/CY7 diode clamp Drawing v1 Sheet1.dxf

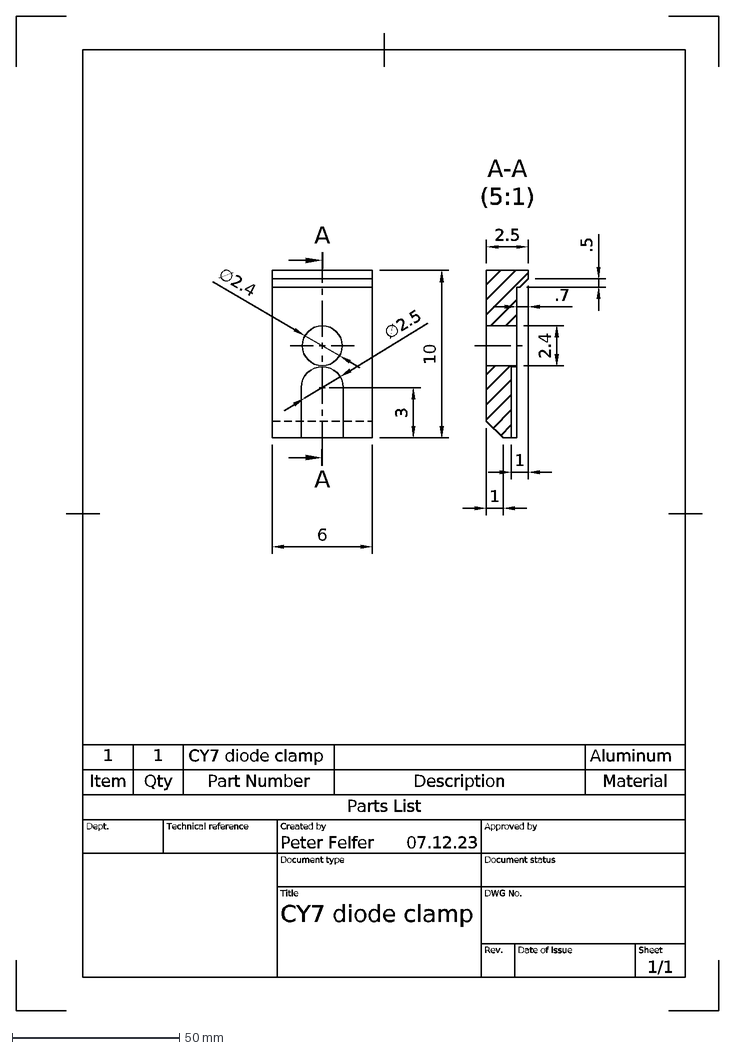
[picture p53: CAD file, 2026-05-30]
CAD/machining/CY7 diode clamp Drawing v1 Sheet1.dxf
07.12.23
1/1
CY7 diode clamp
Peter Felfer
Dept.
Technical reference
Created by
Approved by
Document type
Document status
Title
DWG No.
Rev.
Date of issue
Sheet
A-A (5:1)
6
10
3
∅2.5
∅2.4
2.4
.7
1
2.5
.5
Parts List
Item
Qty
Part Number
Description
Material
Aluminum
A
