peterfelfer/Oxcart/CAD/measurement/barion-basic v1.step

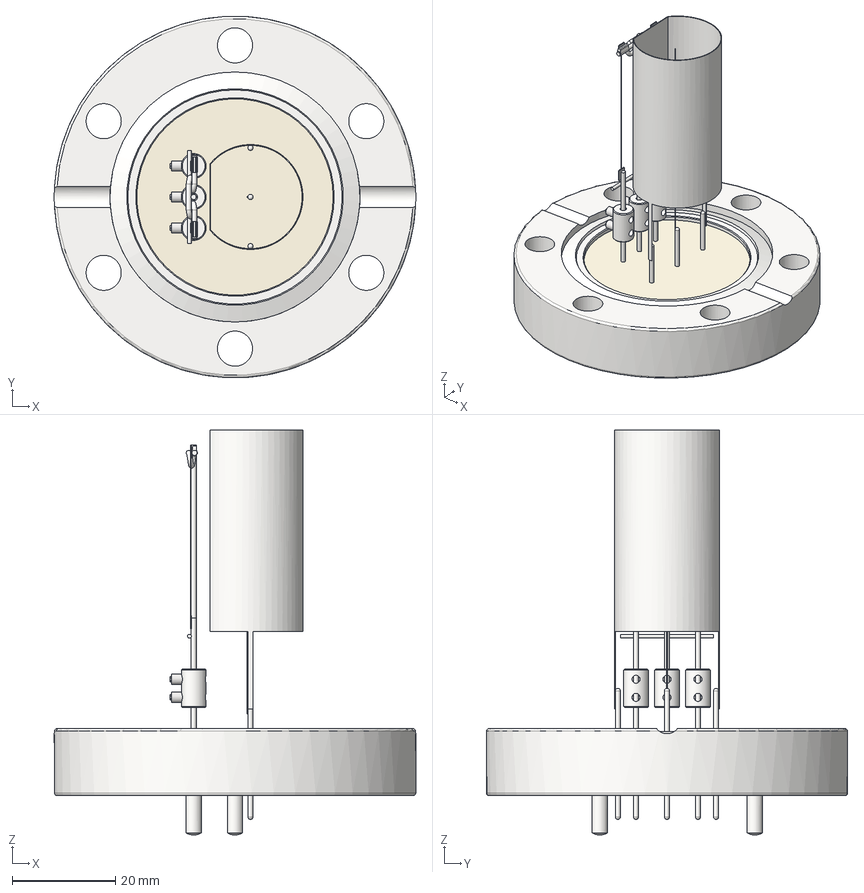
[picture p54: CAD file, 2026-05-30]
CAD/measurement/barion-basic v1.step
70.0 x 70.0 x 78.4 mm
