peterfelfer/Oxcart/CAD/optics-laser/laser upgrade/Amplitude Systemes/PI26-0013-B v1.step

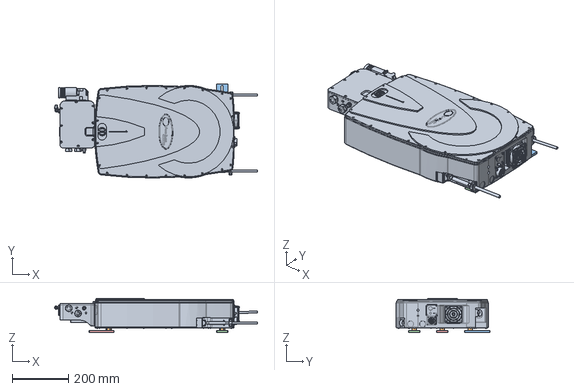
[picture p55: CAD file, 2026-05-30]
CAD/optics-laser/laser upgrade/Amplitude Systemes/PI26-0013-B v1.step
723.8 x 335.0 x 121.5 mm
