peterfelfer/Oxcart/CAD/optics-laser/laser upgrade/Edmund Optics/step_37288 v1.step

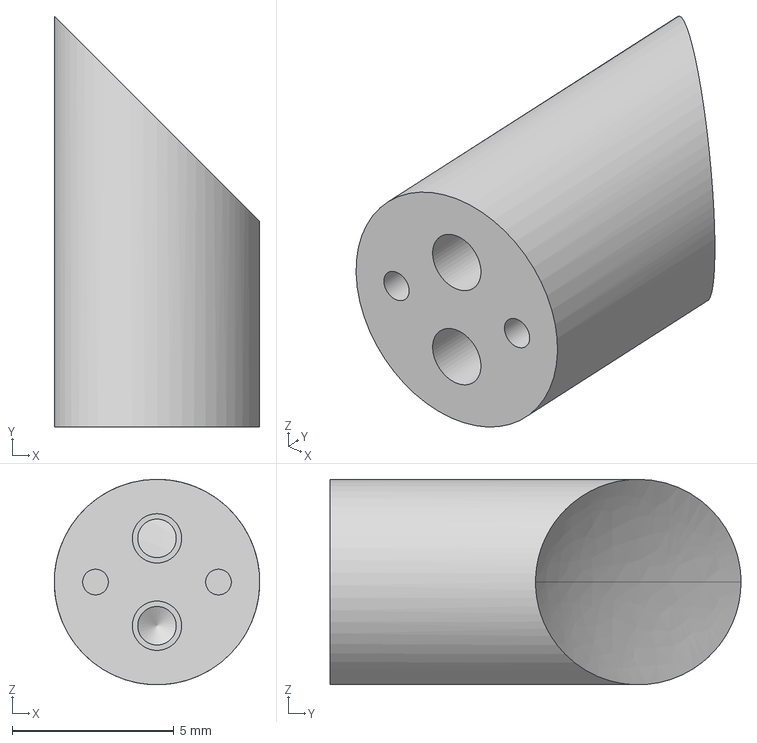
[picture p56: CAD file, 2026-05-30]
CAD/optics-laser/laser upgrade/Edmund Optics/step_37288 v1.step
6.35 x 12.7 x 6.35 mm
