peterfelfer/Oxcart/CAD/optics-laser/laser upgrade/Eksma optics/990-0070M-motorized-attenuator v1.step

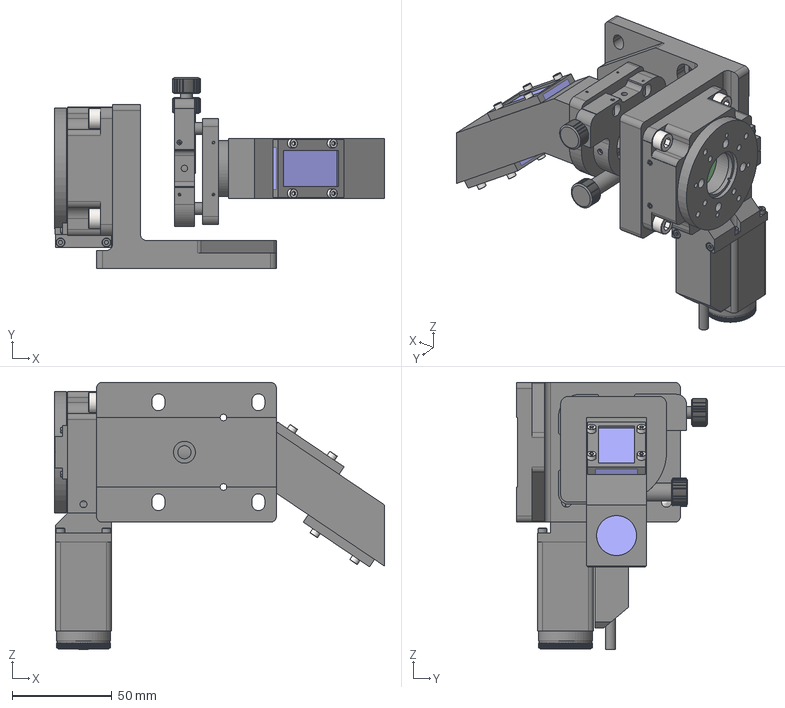
[picture p57: CAD file, 2026-05-30]
CAD/optics-laser/laser upgrade/Eksma optics/990-0070M-motorized-attenuator v1.step
165.1 x 95.4 x 133.8 mm
