peterfelfer/Oxcart/CAD/optics-laser/laser upgrade/LaserSaftyInterlockOverrideHolder v3.step

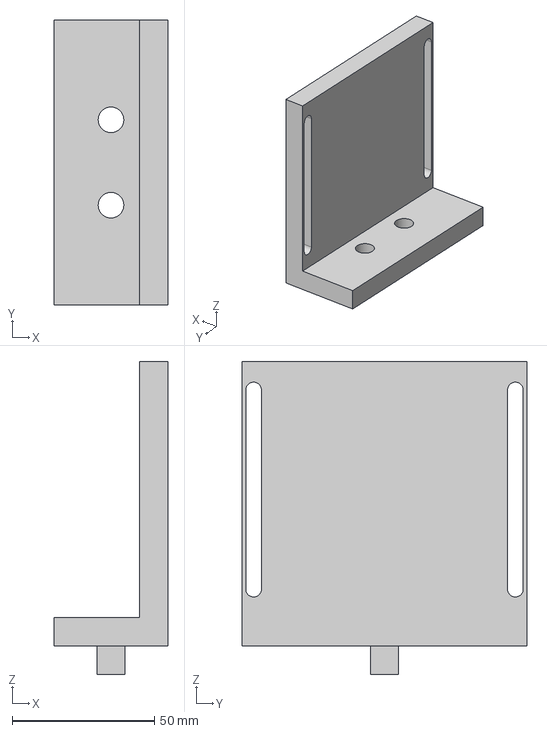
[picture p58: CAD file, 2026-05-30]
CAD/optics-laser/laser upgrade/LaserSaftyInterlockOverrideHolder v3.step
40.0 x 100.0 x 110.0 mm
