peterfelfer/Oxcart/CAD/optics-laser/laser upgrade/LaserStage/LaserStageXYZ Zeichnung v1 Plan1.dxf

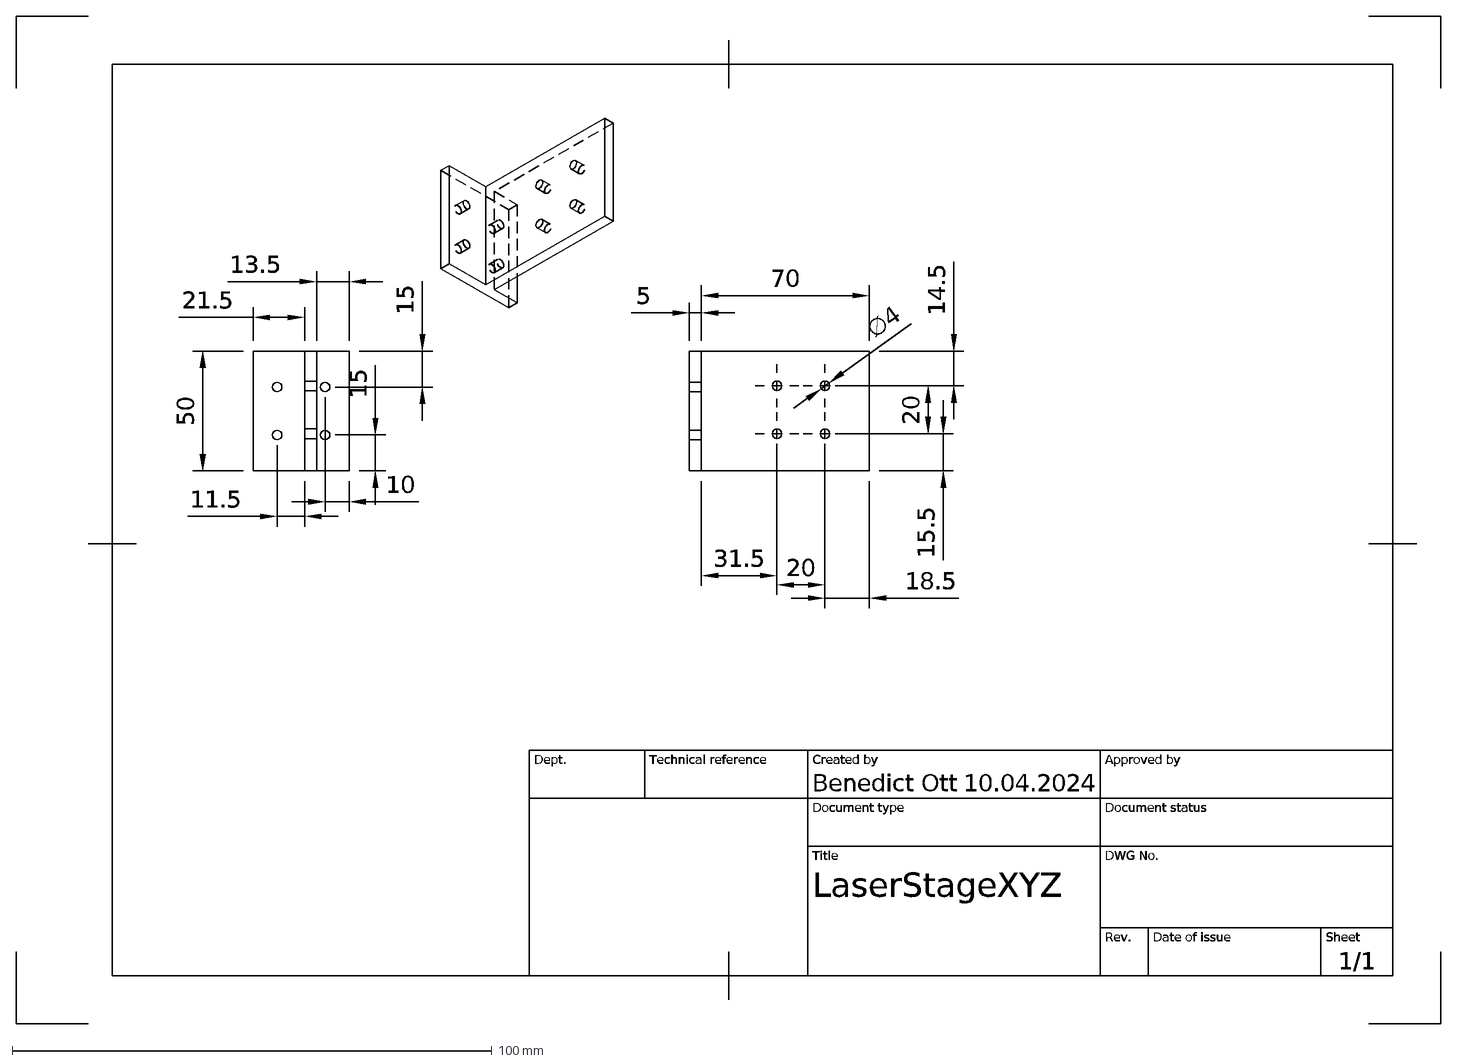
[picture p59: CAD file, 2026-05-30]
CAD/optics-laser/laser upgrade/LaserStage/LaserStageXYZ Zeichnung v1 Plan1.dxf
10.04.2024
1/1
LaserStageXYZ
Benedict Ott
Dept.
Technical reference
Created by
Approved by
Document type
Document status
Title
DWG No.
Rev.
Date of issue
Sheet
70
5
14.5
15.5
20
∅4
18.5
31.5
13.5
21.5
10
15
50
11.5
