peterfelfer/Oxcart/CAD/optics-laser/laser upgrade/NKT photonics/Origami XP_109147_baseplate v2.step

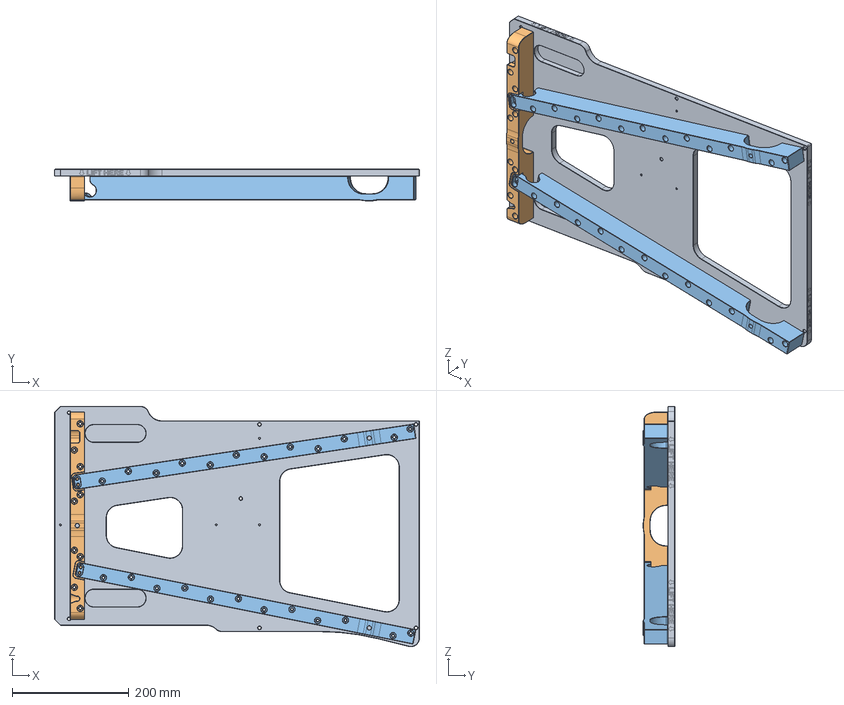
[picture p60: CAD file, 2026-05-30]
CAD/optics-laser/laser upgrade/NKT photonics/Origami XP_109147_baseplate v2.step
625.0 x 54.0 x 411.7 mm
