peterfelfer/Oxcart/CAD/optics-laser/optics/CAM/upper optics holder v2.step

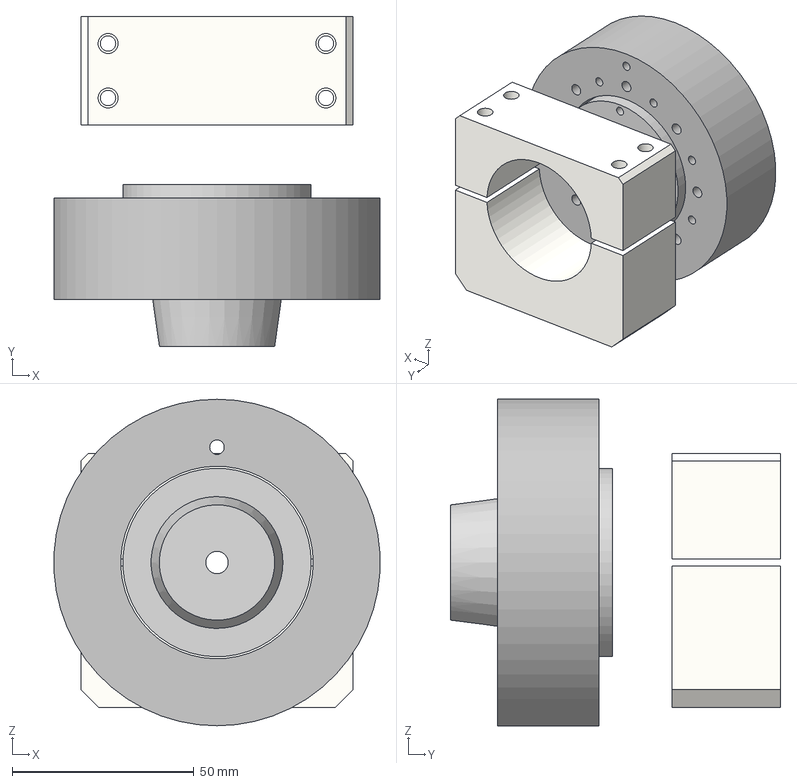
[picture p62: CAD file, 2026-05-30]
CAD/optics-laser/optics/CAM/upper optics holder v2.step
89.8 x 91.0 x 89.9 mm
Collet Bottom Taper
Collet Top Taper
ER-40 Collet Generic v1
V2PocketNC kinematic Bdisc v4
clamp lower
clamp upper
