peterfelfer/Oxcart/CAD/optics-laser/optics/SSE2BZ-MX10-355 (Guide Rail) v1.step

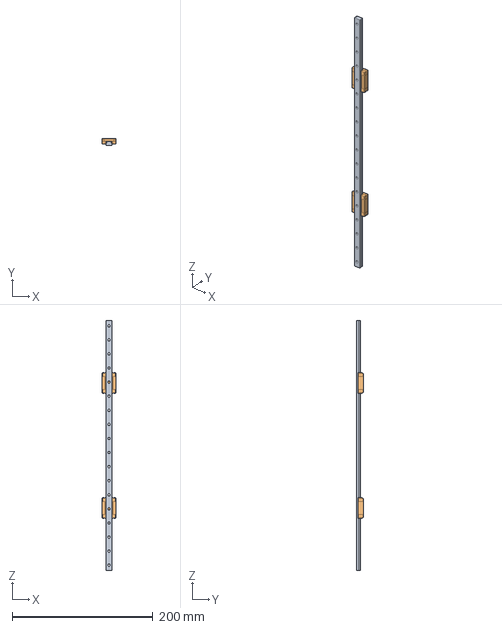
[picture p63: CAD file, 2026-05-30]
CAD/optics-laser/optics/SSE2BZ-MX10-355 (Guide Rail) v1.step
20.0 x 10.0 x 355.0 mm
SSE2BZ-MX10-355_r
SSEBZ-MX10_b x 2
