peterfelfer/Oxcart/CAD/sample-handling/BC LL parts/CAM/carousel rails v1.step

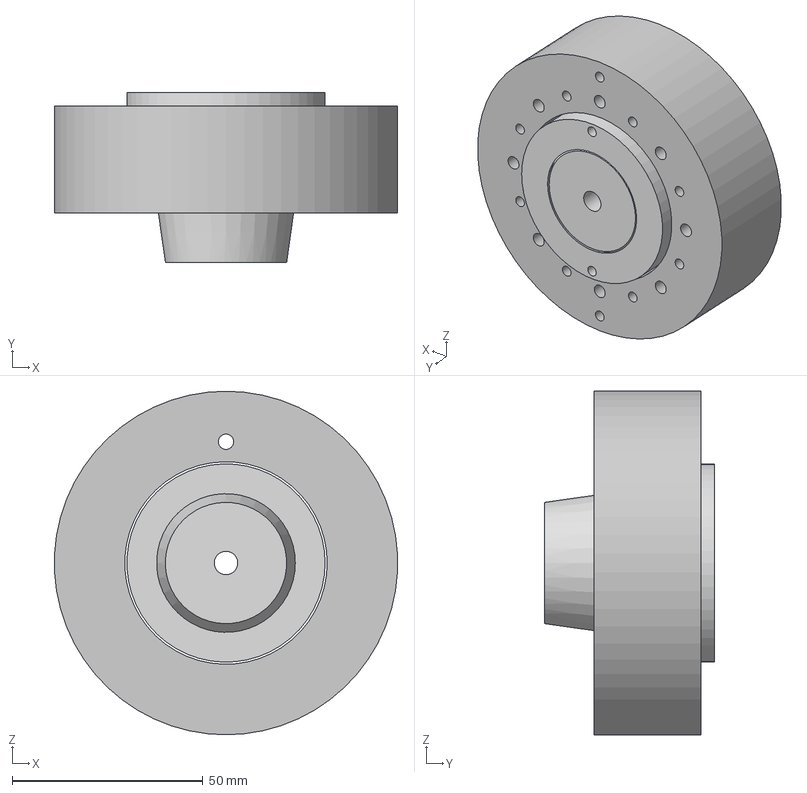
[picture p64: CAD file, 2026-05-30]
CAD/sample-handling/BC LL parts/CAM/carousel rails v1.step
89.8 x 44.6 x 89.9 mm
Collet Bottom Taper
Collet Top Taper
ER-40 Collet Generic v1
V2PocketNC kinematic Bdisc v4
