peterfelfer/Oxcart/CAD/sample-handling/BC LL parts/LL sample rail 2 Drawing v7 Sheet4.dxf

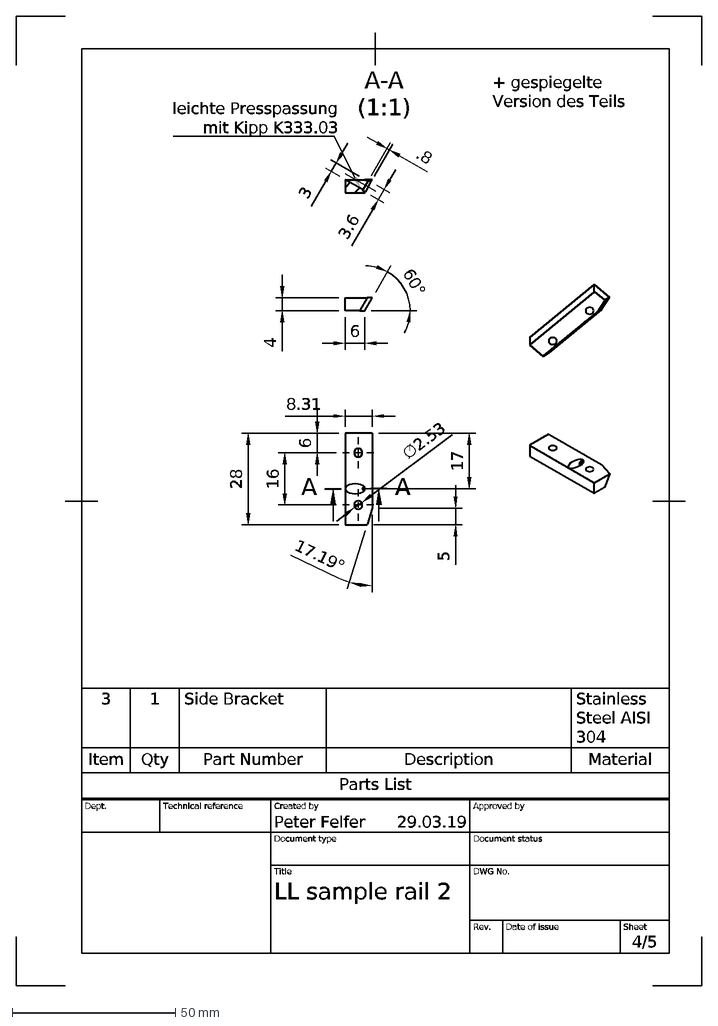
[picture p65: CAD file, 2026-05-30]
CAD/sample-handling/BC LL parts/LL sample rail 2 Drawing v7 Sheet4.dxf
29.03.19
4/5
LL sample rail 2
Peter Felfer
Dept.
Technical reference
Created by
Approved by
Document type
Document status
Title
DWG No.
Rev.
Date of issue
Sheet
28
8.31
17.19°
∅2.53
6
16
A-A (1:1)
3.6
3
.8
60°
4
17
Parts List
Item
Qty
Part Number
Description
Material
1
Side Bracket
Stainless Steel AISI 304
+ gespiegelte Version des Teils
leichte Presspassung
mit Kipp K333.03
5
A
