peterfelfer/Oxcart/CAD/sample-handling/sample automation/BC lift v2.step

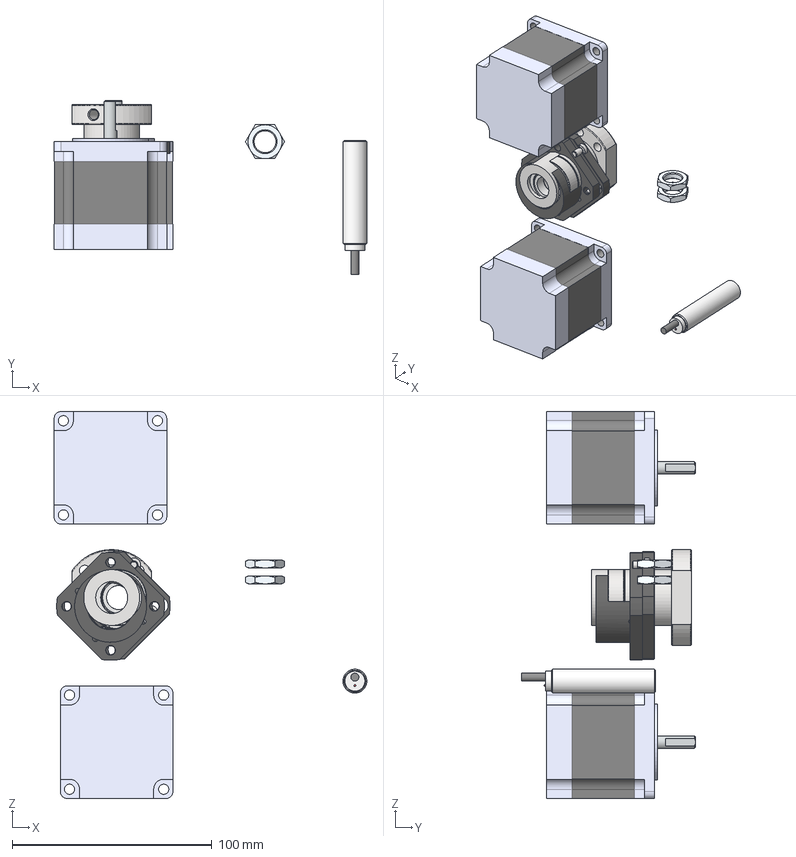
[picture p66: CAD file, 2026-05-30]
CAD/sample-handling/sample automation/BC lift v2.step
156.6 x 87.1 x 193.8 mm
stepper_am23hs2449-01_01 x 2
stepper_am23hs2449-01_02 x 2
FK12_Flanschfestlager
FK12_Abdeckkappe
FK12-Distanzscheibe
Rolling bearing 7001 C GB_T 292-94 x 2
DIN 7984 - M4 x 6 x 4
Wellendichtring23x17x4 x 2
FK12-Dinstanzring_kurz
FK12-Dinstanzring_lang
SpindelmutterSFU1605_MJ2020
sensor_mst12-s02aa-a2n2_1
