peterfelfer/Oxcart/CAD/sample-handling/sample stage - pucks/CAM/HV connector CAM v3.step

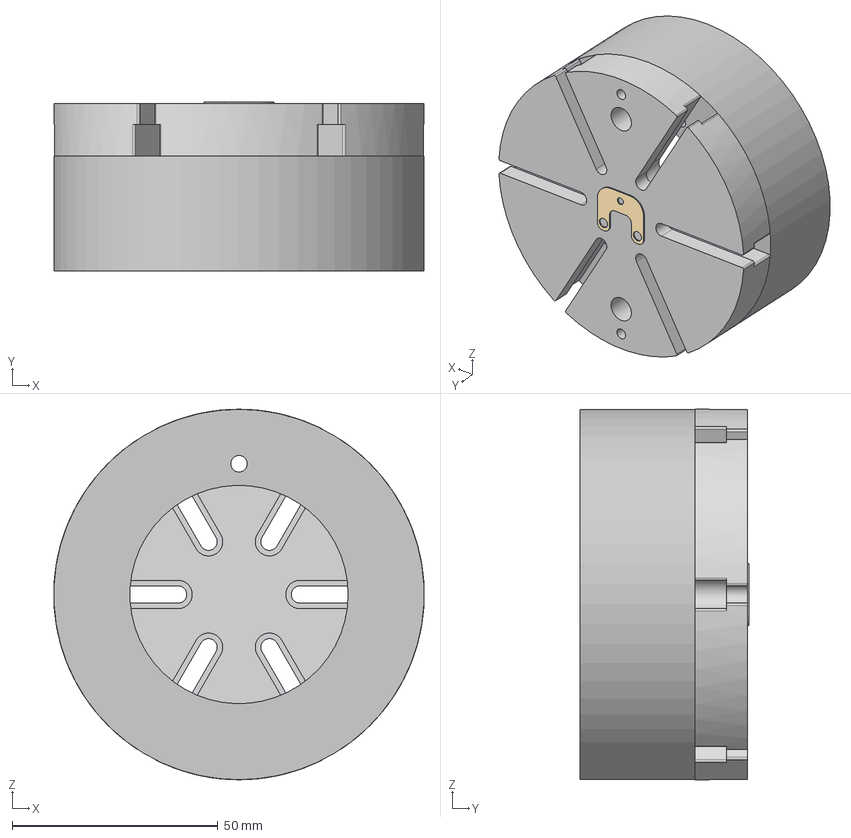
[picture p67: CAD file, 2026-05-30]
CAD/sample-handling/sample stage - pucks/CAM/HV connector CAM v3.step
89.8 x 41.1 x 90.0 mm
V2PocketNC kinematic Bdisc v4
V2 removable table v1
HV connection
