peterfelfer/Oxcart/CAD/sample-handling/sample stage - pucks/ME contact pin v2.step

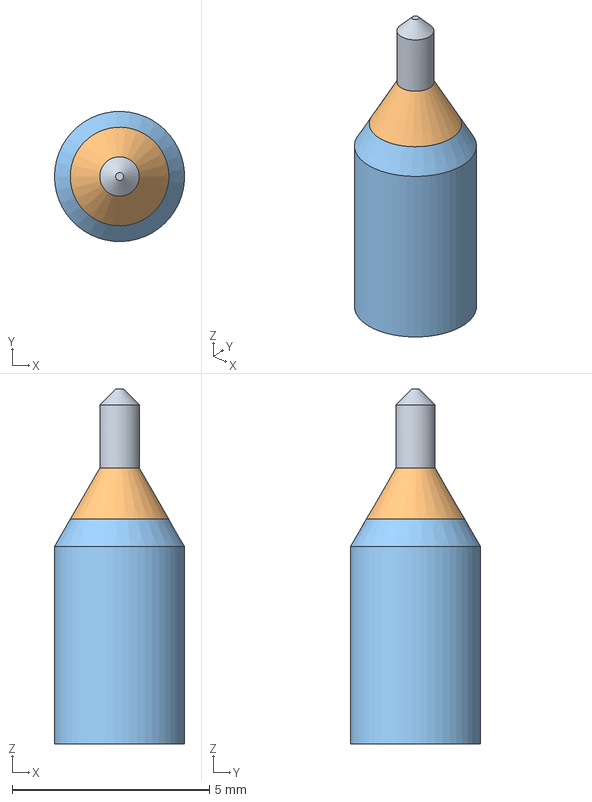
[picture p68: CAD file, 2026-05-30]
CAD/sample-handling/sample stage - pucks/ME contact pin v2.step
3.30 x 3.30 x 9.00 mm
