peterfelfer/Oxcart/CAD/sample-handling/UHV cryo transfer shuttle/shuttle body v4.step

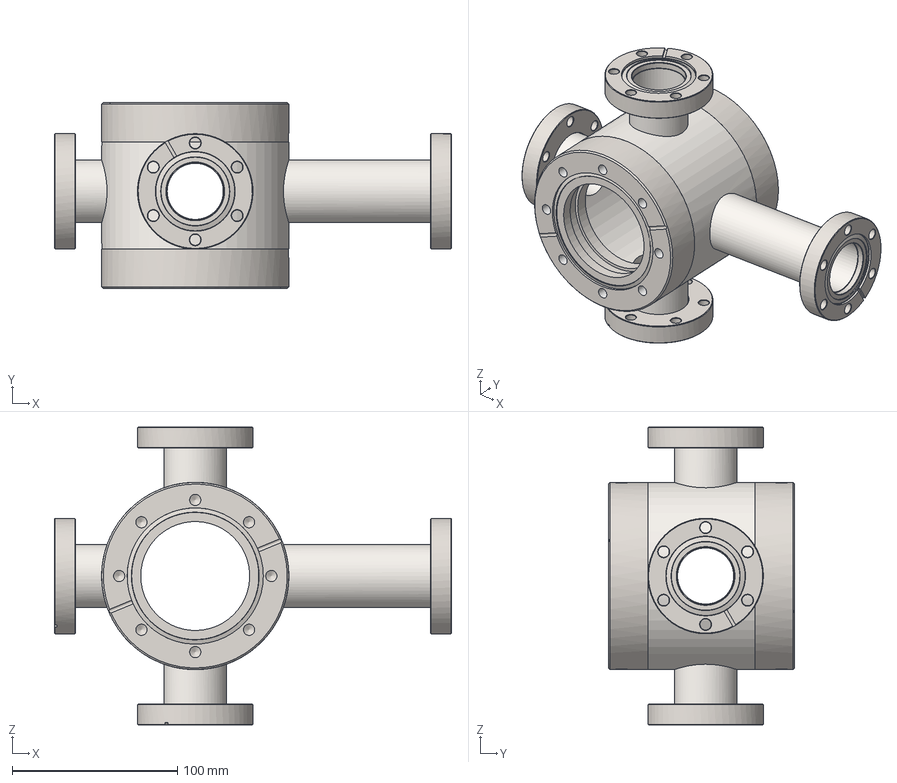
[picture p69: CAD file, 2026-05-30]
CAD/sample-handling/UHV cryo transfer shuttle/shuttle body v4.step
240.6 x 113.0 x 180.6 mm
Hositrad_CF35-38 v1
Hositrad_CF35-38 v1 (1)
420FES063 v1
420FES063 v1 (1)
Hositrad_CF35-38 v1 (3)
Hositrad_CF35-38 v1 (2)
