peterfelfer/Oxcart/CAD/vacuum/pumps/5s-xx-2v-sc_step v1.step

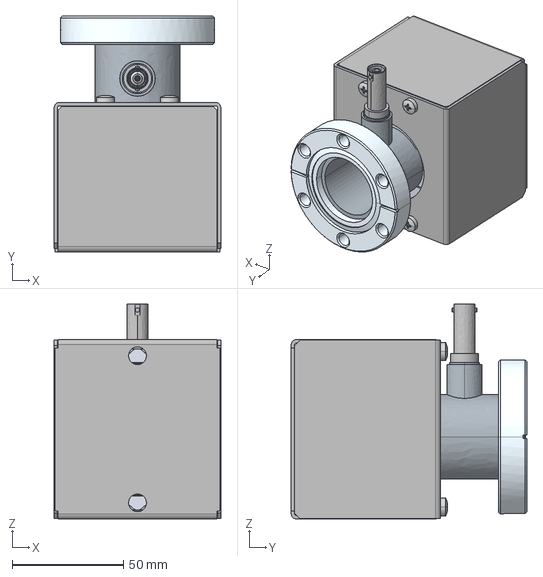
[picture p70: CAD file, 2026-05-30]
CAD/vacuum/pumps/5s-xx-2v-sc_step v1.step
75.0 x 106.1 x 96.8 mm
