peterfelfer/Oxcart/CAD/vacuum/vacuum parts/Hositrad_CF63-64-T v1.step

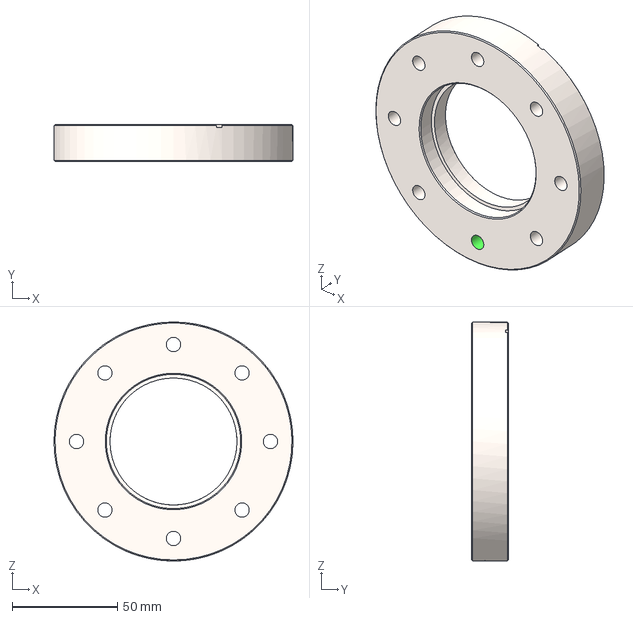
[picture p71: CAD file, 2026-05-30]
CAD/vacuum/vacuum parts/Hositrad_CF63-64-T v1.step
113.5 x 17.5 x 113.5 mm
