peterfelfer/Oxcart/CAD/vacuum/valves manipulation/sample shifter Drawing v6 Sheet4.dxf

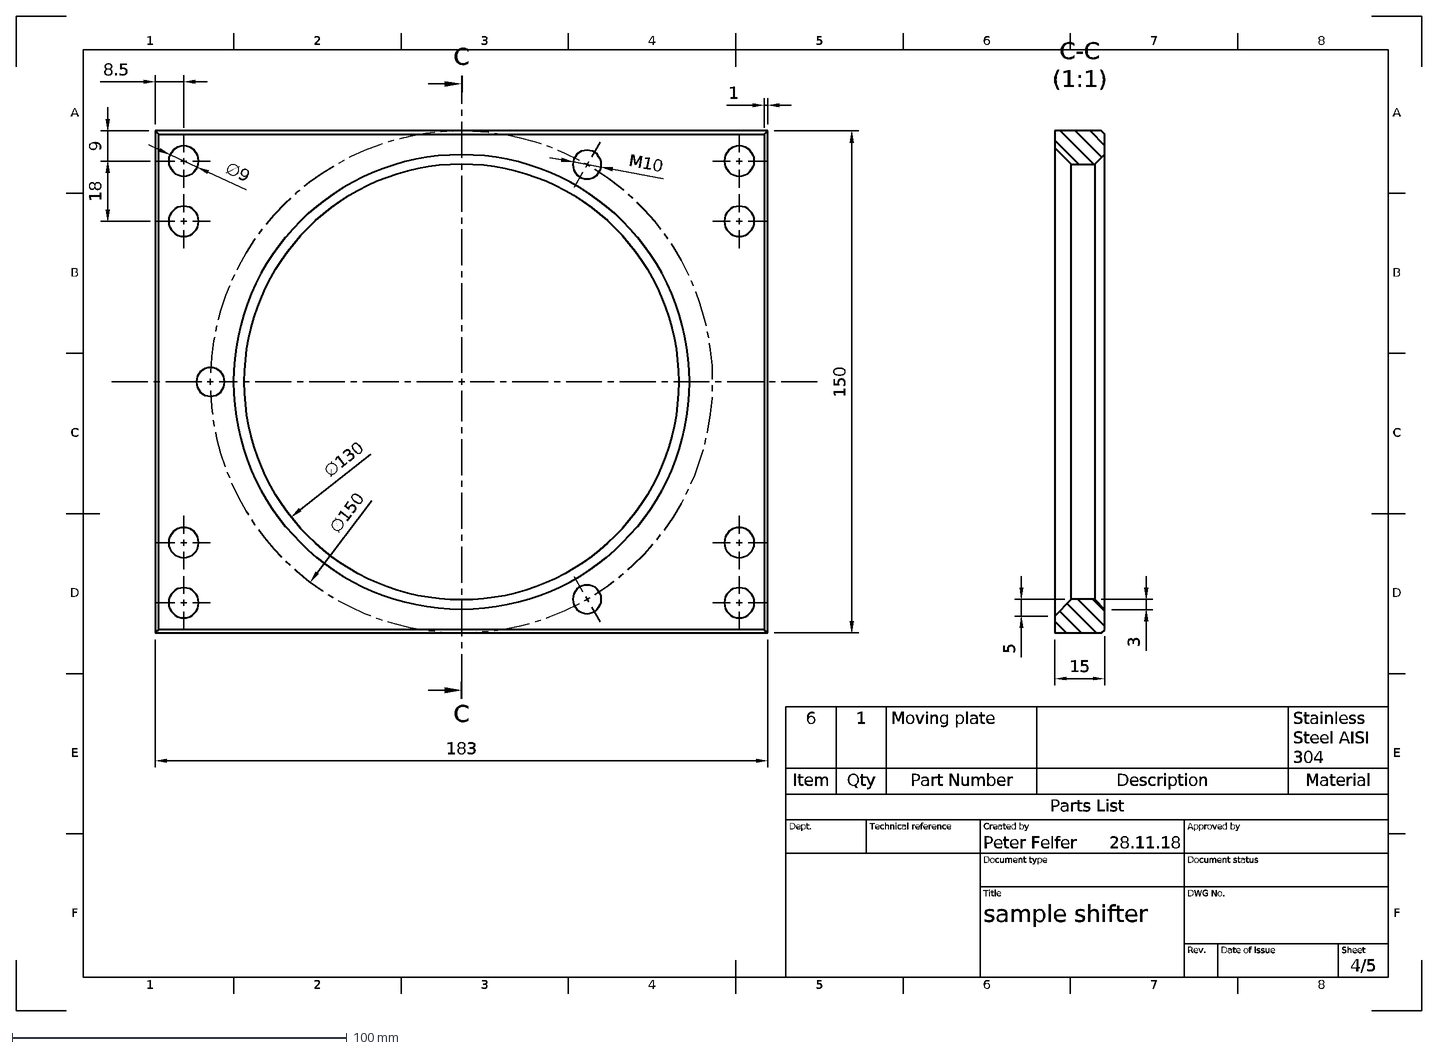
[picture p72: CAD file, 2026-05-30]
CAD/vacuum/valves manipulation/sample shifter Drawing v6 Sheet4.dxf
1
A
2
3
4
5
6
7
8
B
C
D
E
F
28.11.18
4/5
sample shifter
Peter Felfer
Dept.
Technical reference
Created by
Approved by
Document type
Document status
Title
DWG No.
Rev.
Date of issue
Sheet
C-C (1:1)
15
8.5
9
18
150
183
∅130
∅150
∅9
M10
Parts List
Item
Qty
Part Number
Description
Material
Moving plate
Stainless Steel AISI 304
