peterfelfer/Oxcart/CAD/cryo/cryo heads/KDE415SA 3D Model v4.step

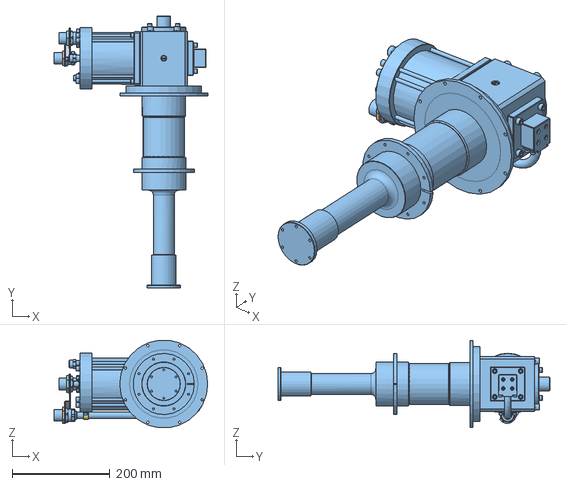
[picture p73: CAD file, 2026-05-30]
CAD/cryo/cryo heads/KDE415SA 3D Model v4.step
314.1 x 556.5 x 178.7 mm
