peterfelfer/Oxcart/CAD/cryo/cryo LL/Hositrad_CFA35-16L v1.step

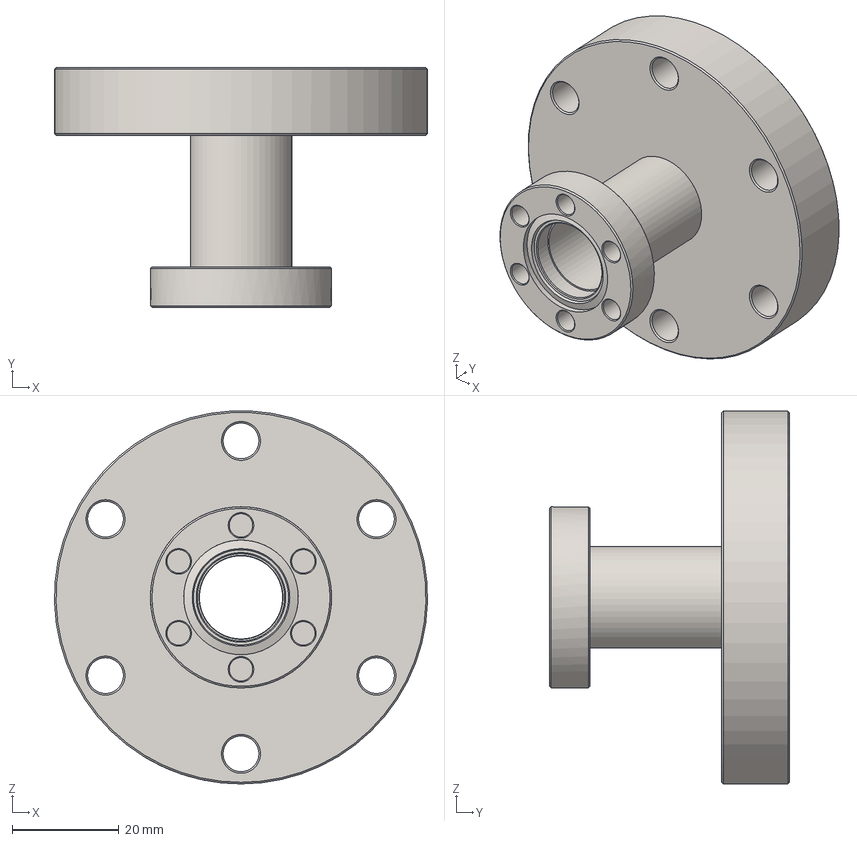
[picture p74: CAD file, 2026-05-30]
CAD/cryo/cryo LL/Hositrad_CFA35-16L v1.step
70.0 x 45.0 x 69.9 mm
NW35CF-Straight Hole_CF35-Hole 19,05
Tube 19-All_Tube19L35
NW16CF-weld_CF16-19
