peterfelfer/Oxcart/CAD/cryo/cryo system BC/coupling plate v1.step

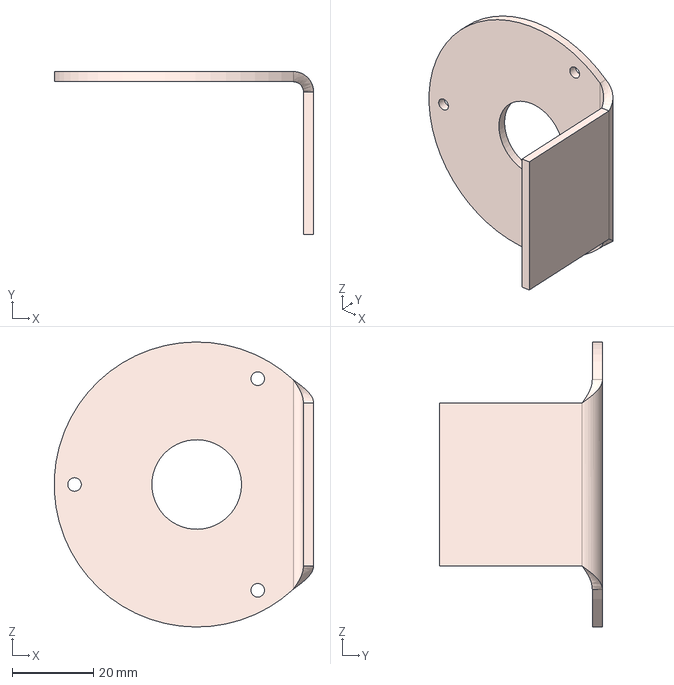
[picture p75: CAD file, 2026-05-30]
CAD/cryo/cryo system BC/coupling plate v1.step
63.7 x 40.0 x 70.0 mm
