peterfelfer/Oxcart/CAD/cryo/cryo system MC/CAM/Collet Top Taper v1.step

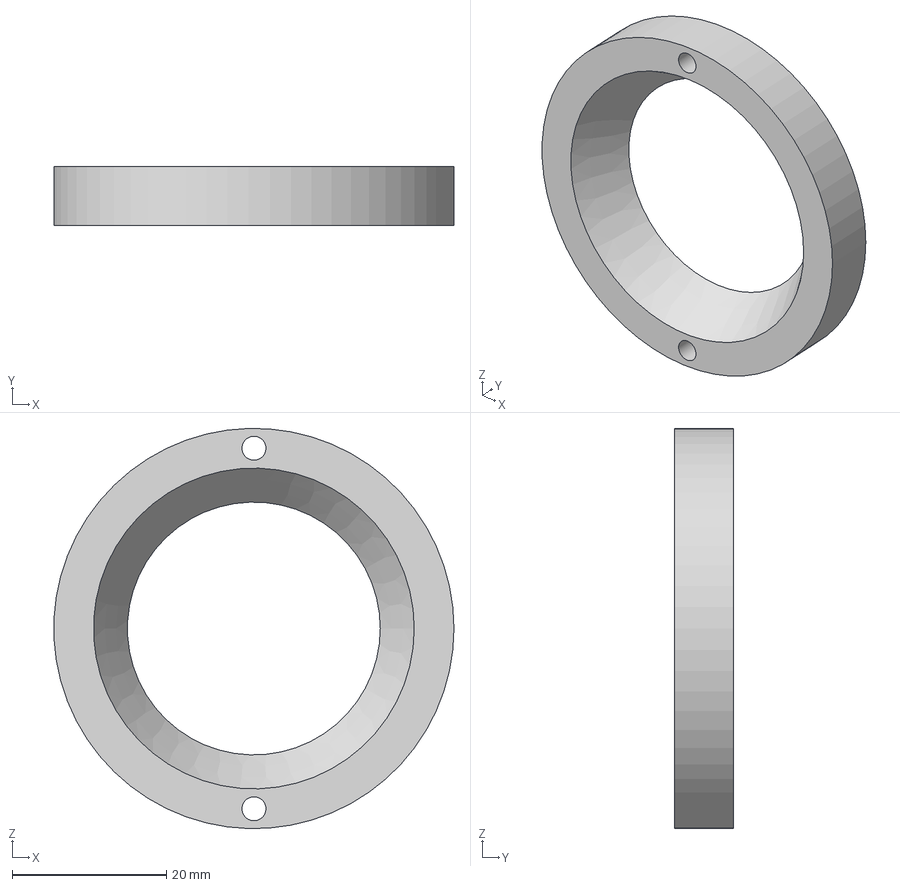
[picture p76: CAD file, 2026-05-30]
CAD/cryo/cryo system MC/CAM/Collet Top Taper v1.step
51.8 x 7.62 x 51.8 mm
