peterfelfer/Oxcart/CAD/cryo/cryo system MC/cryo interface v4 v42.step

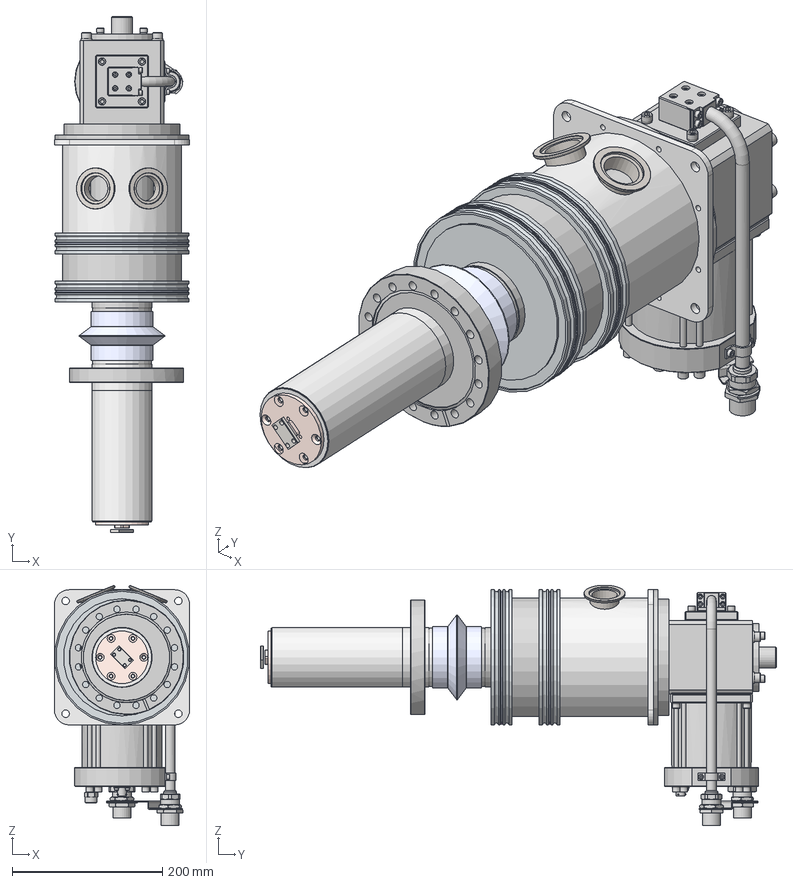
[picture p77: CAD file, 2026-05-30]
CAD/cryo/cryo system MC/cryo interface v4 v42.step
180.0 x 686.6 x 320.0 mm
top interface
bottom connector
thermal interface
bottom thermal connector
bottom clamp
VAb_CBF 100 v1
330SMA063
VAb_BF 160-K v1
tube
Hositrad_ISO160AV x 2
VAb_SF 160-K x 2
main body
top
VAb_SF 160-K v1
Hositrad_KF40-38-19 v1
Hositrad_KF40-38-19 v1 (1)
O ring 145 x 4
KDE415SA 3D Model
thermal conductor x 2
magnetic ring x 2
thermal contact x 2
pressure plate x 2
Lakeshore DT 670 SD Omega CY 670 SD
insulator bottom
insulator top
Lakeshore CO clamp
back clamp
front clamp
