peterfelfer/Oxcart/CAD/gas-thermal/baking equipment/baking lid left section Drawing v3 Sheet1.dxf

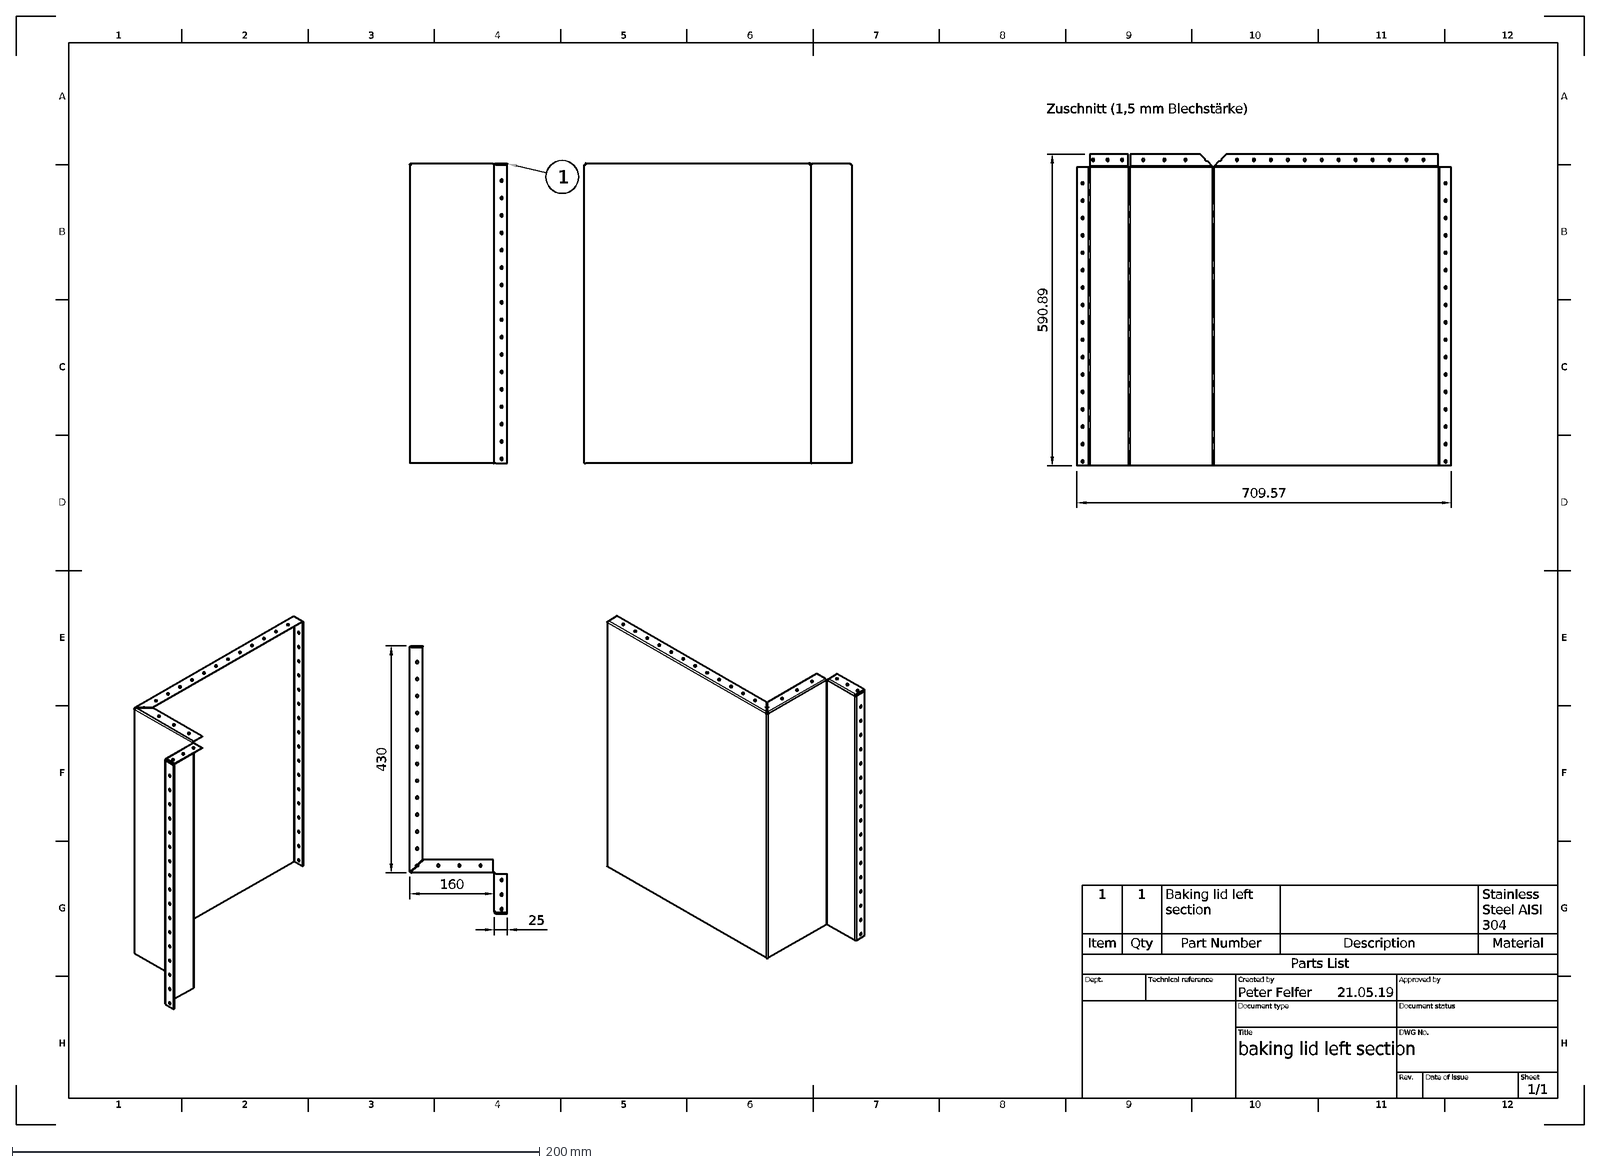
[picture p78: CAD file, 2026-05-30]
CAD/gas-thermal/baking equipment/baking lid left section Drawing v3 Sheet1.dxf
2
1
3
4
5
6
7
8
9
10
11
12
B
A
C
D
E
F
G
H
21.05.19
1/1
baking lid left section
Peter Felfer
Dept.
Technical reference
Created by
Approved by
Document type
Document status
Title
DWG No.
Rev.
Date of issue
Sheet
Parts List
Item
Qty
Part Number
Description
Material
Baking lid left section
Stainless Steel AISI 304
430
160
25
Zuschnitt (1,5 mm Blechstärke)
709.57
590.89
