peterfelfer/Oxcart/CAD/gas-thermal/gas charging devices/deuterium pump/deuterium compression device Endstopfen Zeichnung v2 Plan1.dxf

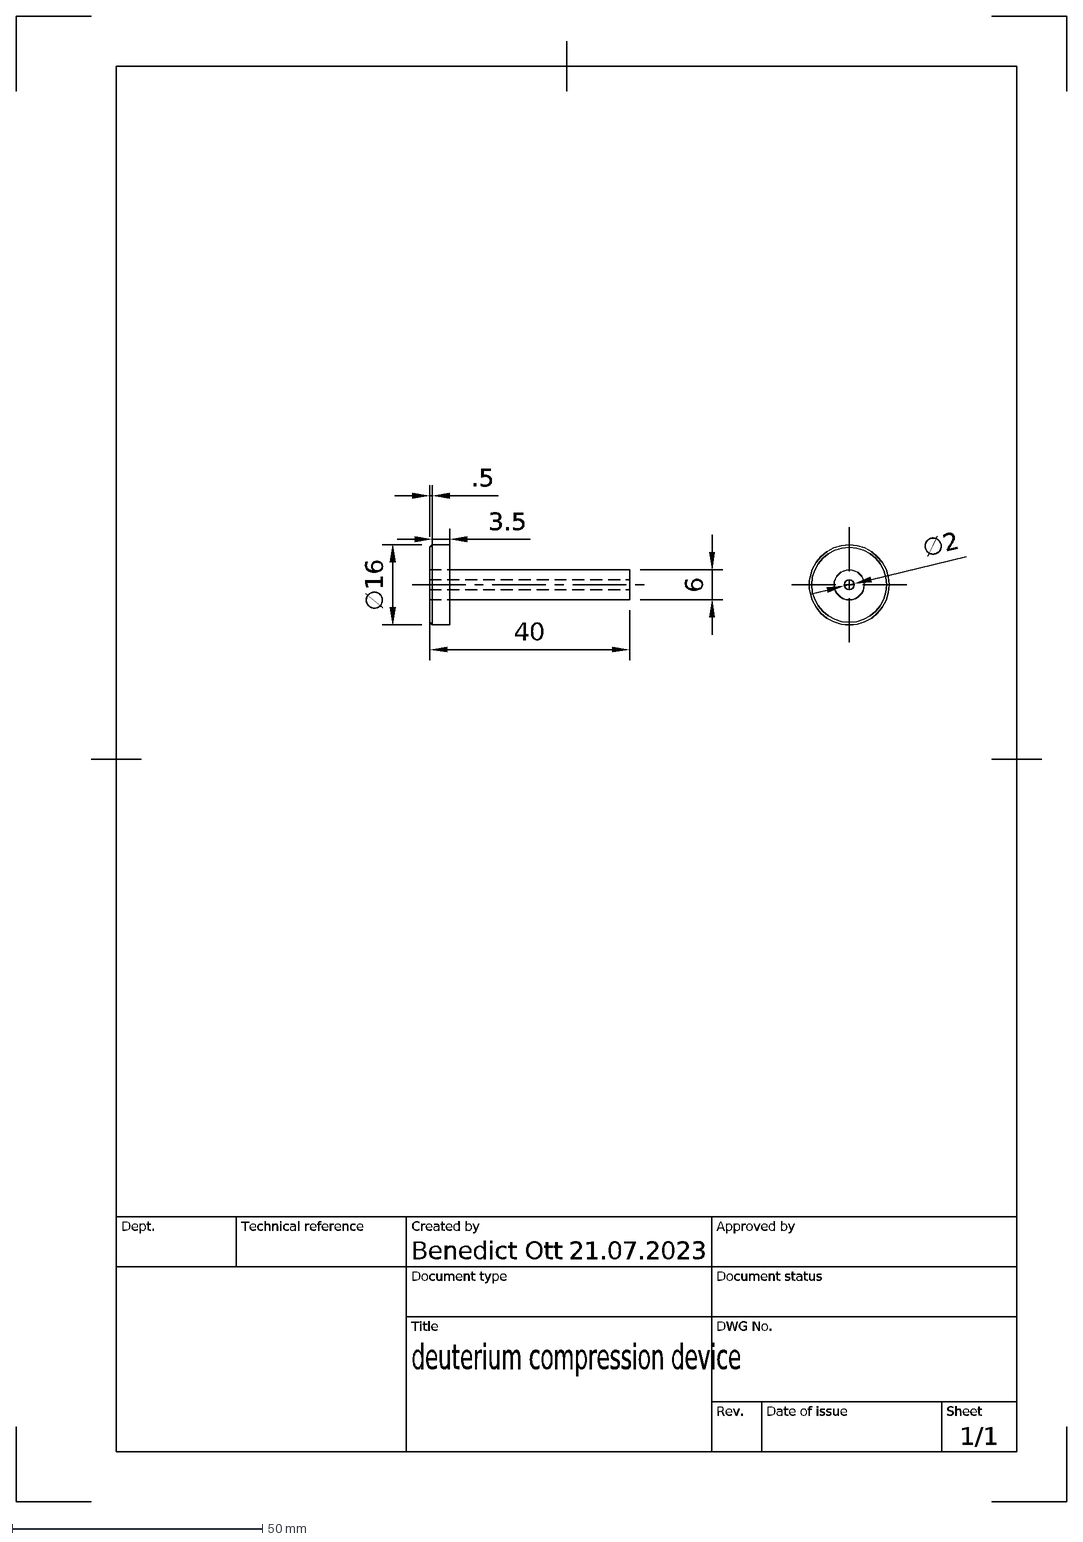
[picture p79: CAD file, 2026-05-30]
CAD/gas-thermal/gas charging devices/deuterium pump/deuterium compression device Endstopfen Zeichnung v2 Plan1.dxf
21.07.2023
1/1
deuterium compression device
Benedict Ott
Dept.
Technical reference
Created by
Approved by
Document type
Document status
Title
DWG No.
Rev.
Date of issue
Sheet
.5
∅16
6
∅2
40
3.5
