peterfelfer/Oxcart/CAD/gas-thermal/gas charging devices/gasChargingBombHolder/gasChargingBombLid v4.step

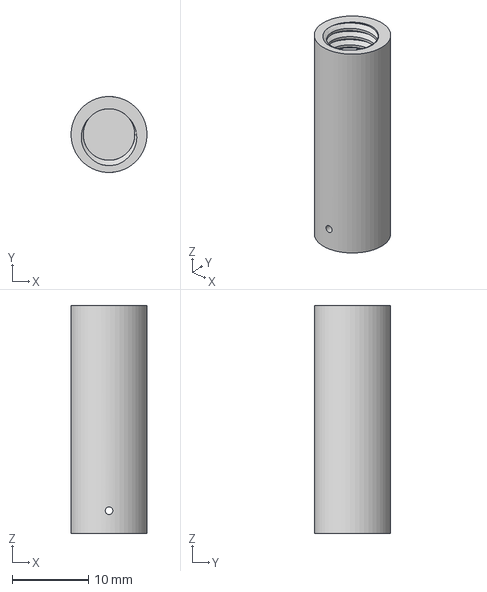
[picture p80: CAD file, 2026-05-30]
CAD/gas-thermal/gas charging devices/gasChargingBombHolder/gasChargingBombLid v4.step
9.99 x 10.00 x 30.0 mm
