peterfelfer/Oxcart/CAD/gas-thermal/gas charging devices/gasChargingCartridge/V2/gasChargingCartridgePlug v9.step

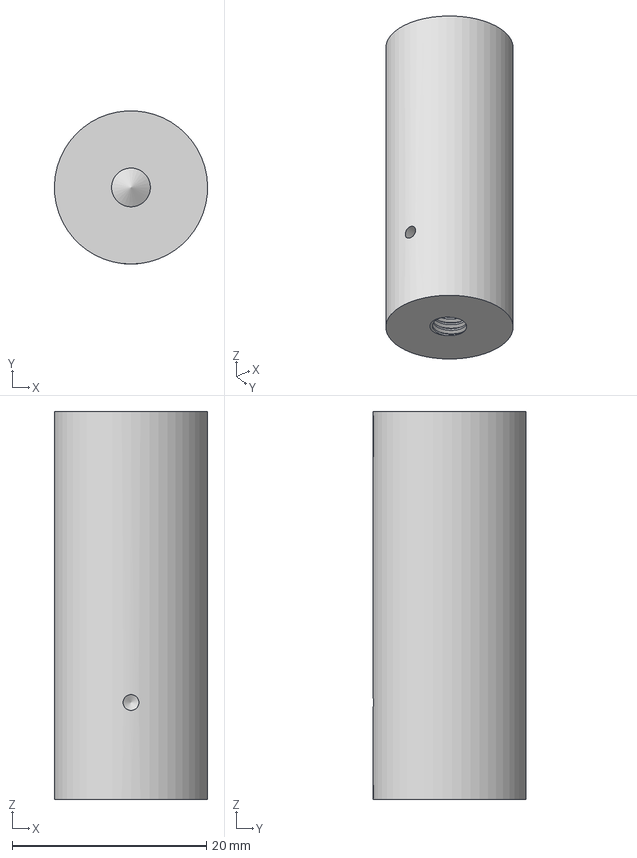
[picture p81: CAD file, 2026-05-30]
CAD/gas-thermal/gas charging devices/gasChargingCartridge/V2/gasChargingCartridgePlug v9.step
15.8 x 15.8 x 40.0 mm
