peterfelfer/Oxcart/CAD/gas-thermal/gas charging devices/gasChargingCube/5242-110ZSK016 v1.step

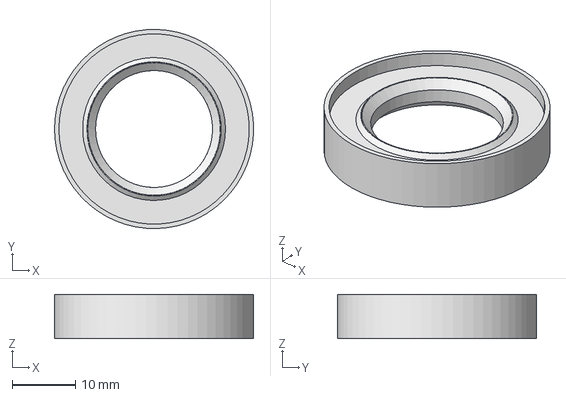
[picture p82: CAD file, 2026-05-30]
CAD/gas-thermal/gas charging devices/gasChargingCube/5242-110ZSK016 v1.step
31.5 x 31.5 x 7.00 mm
