peterfelfer/Oxcart/CAD/gas-thermal/gas charging devices/gasChargingFlashBang/gasChargingFlashBangSampleHolder v6.step

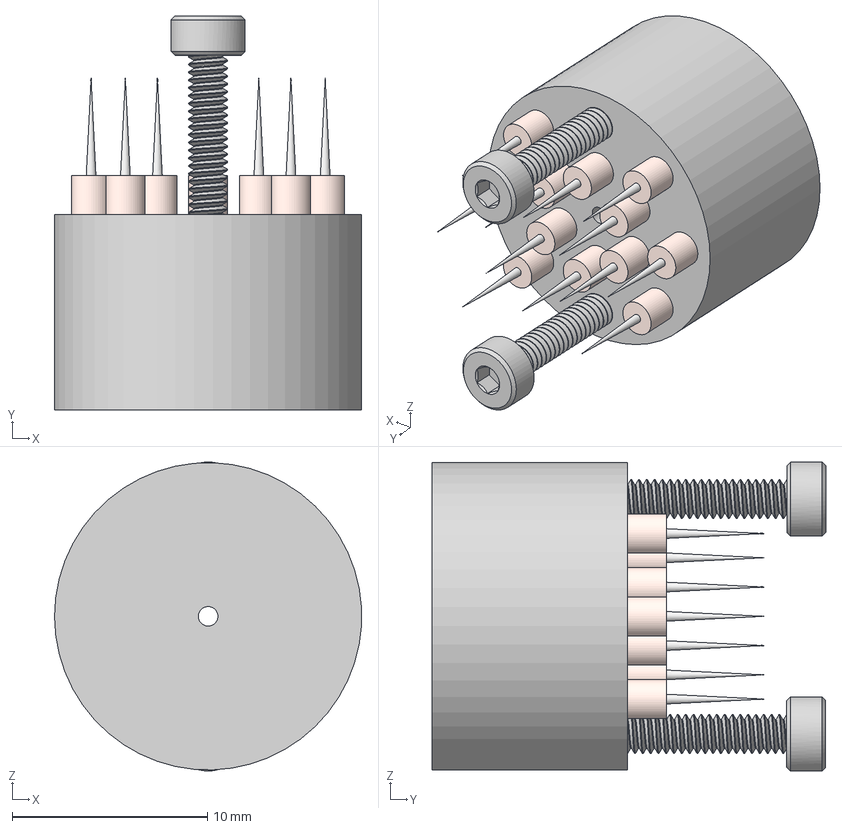
[picture p83: CAD file, 2026-05-30]
CAD/gas-thermal/gas charging devices/gasChargingFlashBang/gasChargingFlashBangSampleHolder v6.step
15.7 x 20.2 x 15.8 mm
Sample x 12
91292A833_18-8 Stainless Steel Socket Head Screw
91292A833_18-8 Stainless Steel Socket Head Screw (1)
