peterfelfer/Oxcart/CAD/gas-thermal/gas charging devices/gasChargingHandgrenade/SS-6M0-1-8RS-SwagelokCompany-3D-04-11-2023 v6.step

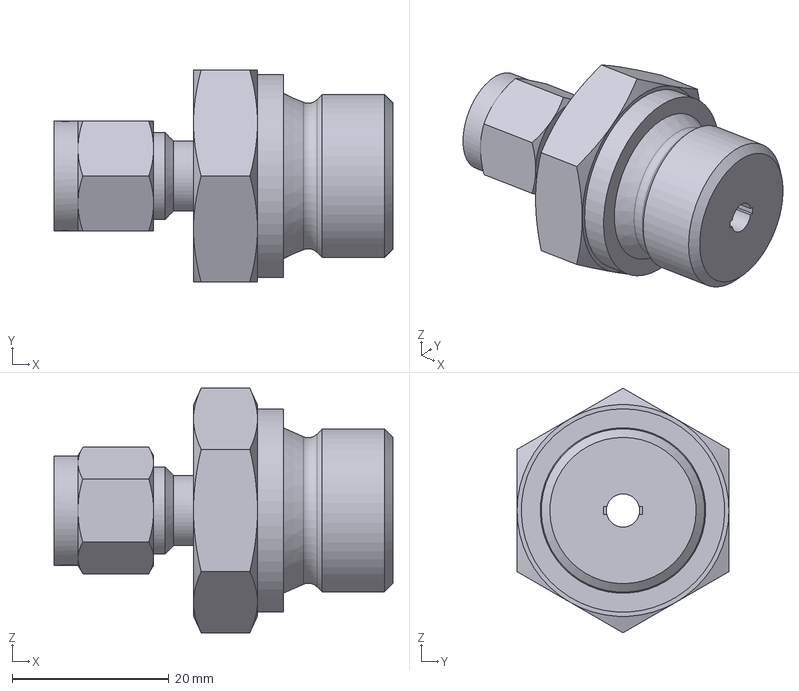
[picture p84: CAD file, 2026-05-30]
CAD/gas-thermal/gas charging devices/gasChargingHandgrenade/SS-6M0-1-8RS-SwagelokCompany-3D-04-11-2023 v6.step
43.2 x 27.0 x 31.2 mm
