peterfelfer/Oxcart/CAD/gas-thermal/gas charging devices/gasSupplyParts/SS-6M0-3-SwagelokCompany-3D-03-31-2022 v2.step

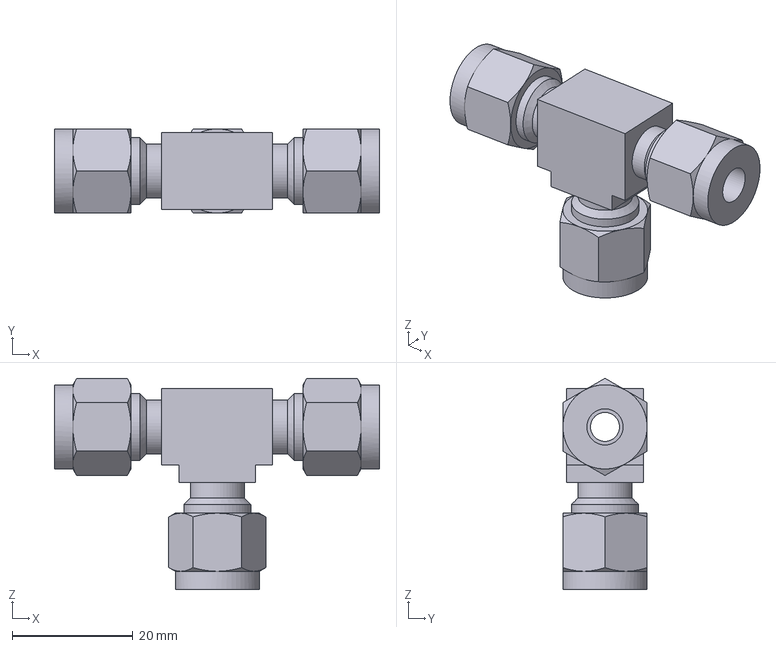
[picture p85: CAD file, 2026-05-30]
CAD/gas-thermal/gas charging devices/gasSupplyParts/SS-6M0-3-SwagelokCompany-3D-03-31-2022 v2.step
53.9 x 14.0 x 35.1 mm
