peterfelfer/Oxcart/CAD/gas-thermal/gas charging devices/Sample v3.step

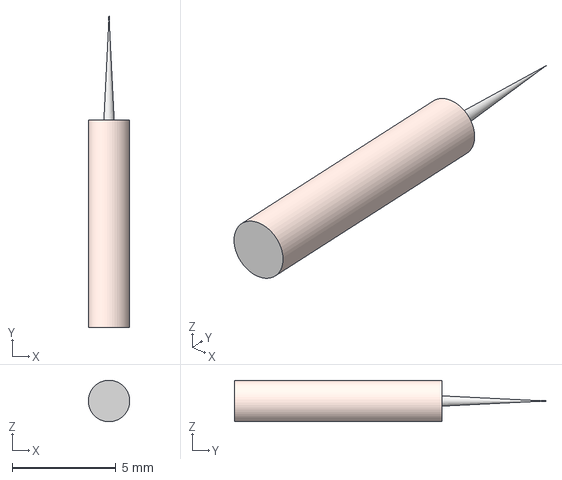
[picture p86: CAD file, 2026-05-30]
CAD/gas-thermal/gas charging devices/Sample v3.step
2.00 x 15.0 x 2.00 mm
