peterfelfer/Oxcart/CAD/gas-thermal/lamp holder/lamp holder v2 v3.step

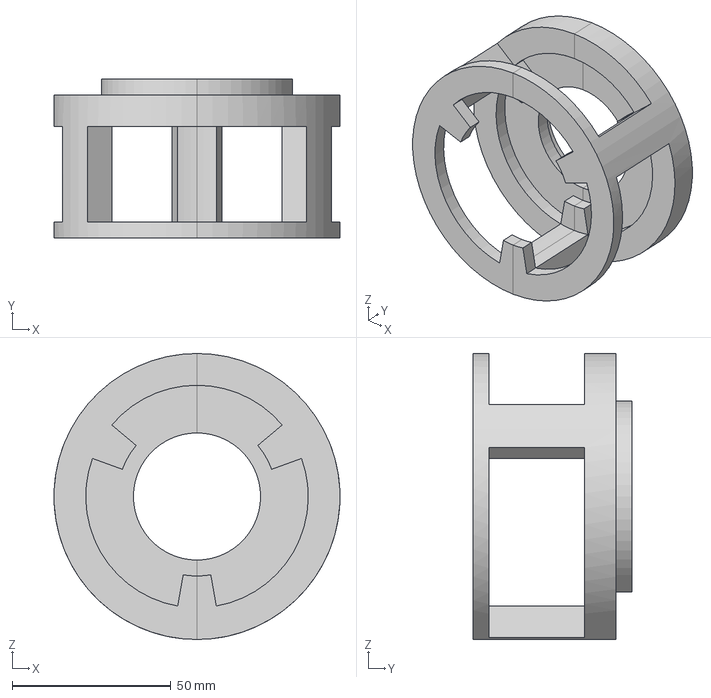
[picture p87: CAD file, 2026-05-30]
CAD/gas-thermal/lamp holder/lamp holder v2 v3.step
90.0 x 50.0 x 90.0 mm
