peterfelfer/Oxcart/CAD/machining/cryo interface v4 cooling shield Zeichnung v2 Plan1.dxf

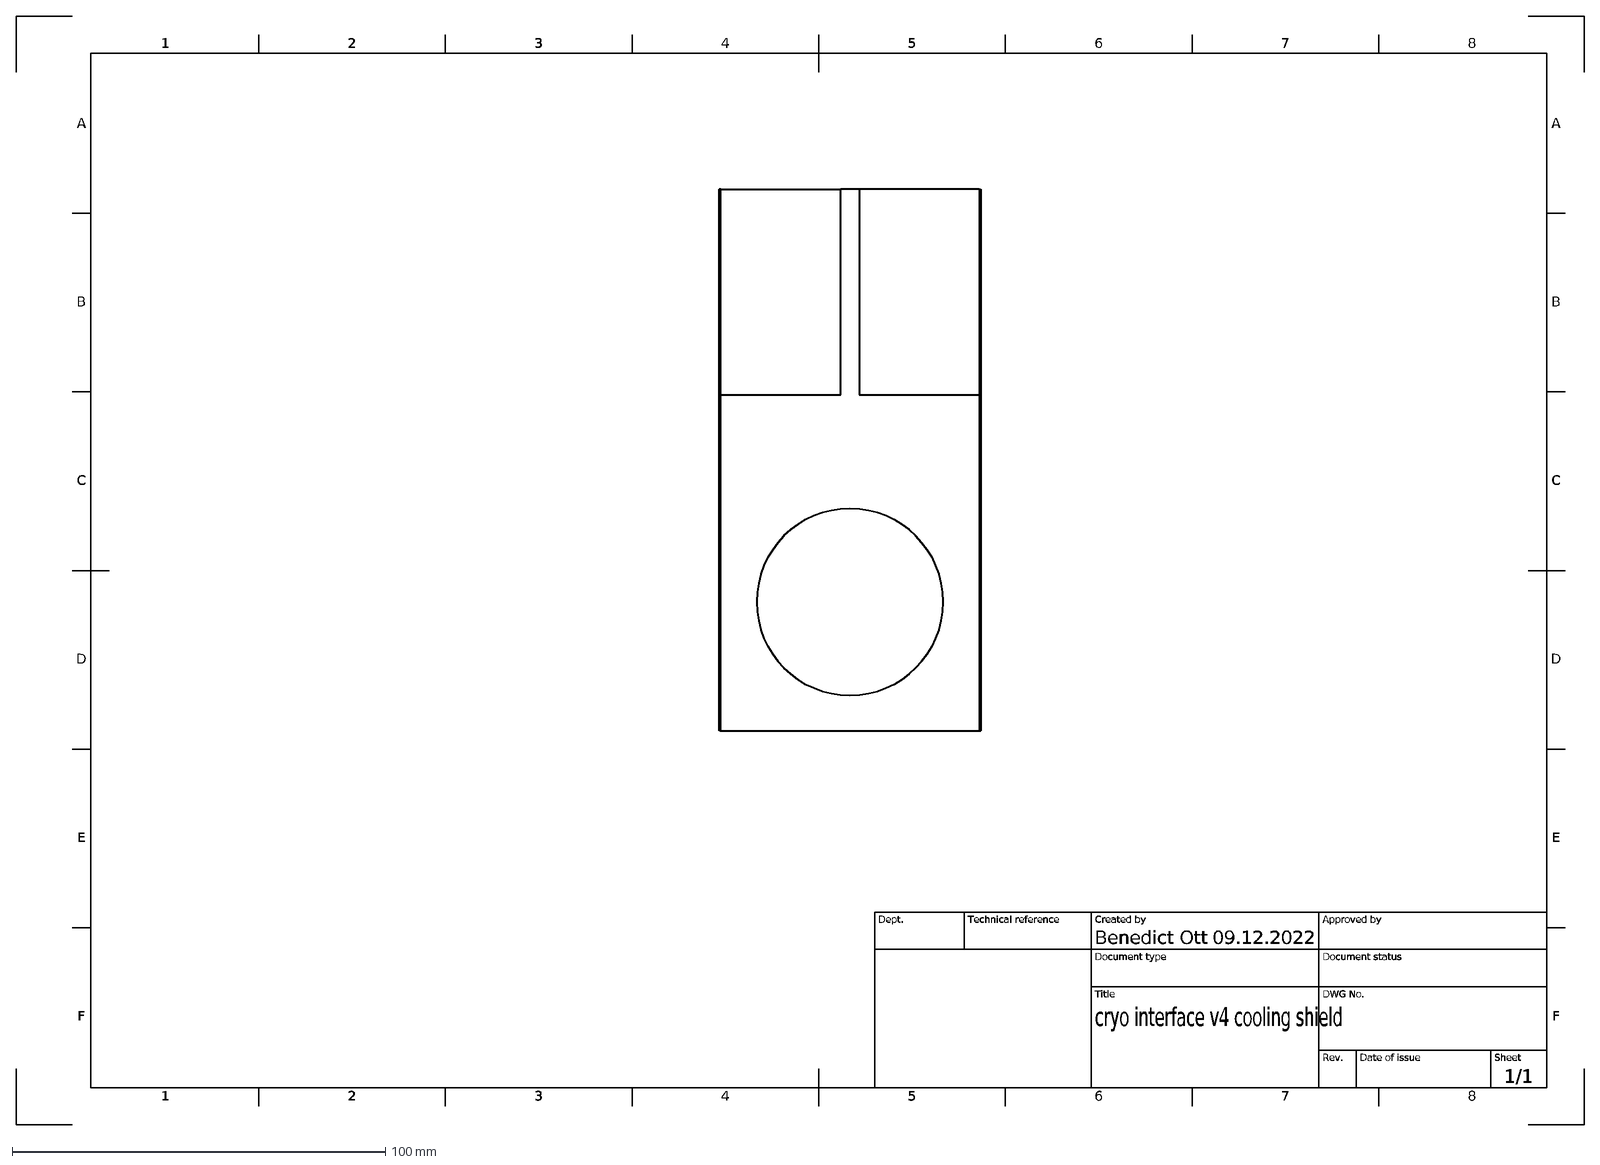
[picture p88: CAD file, 2026-05-30]
CAD/machining/cryo interface v4 cooling shield Zeichnung v2 Plan1.dxf
1
A
2
3
4
5
6
7
8
B
C
D
E
F
09.12.2022
1/1
cryo interface v4 cooling shield
Benedict Ott
Dept.
Technical reference
Created by
Approved by
Document type
Document status
Title
DWG No.
Rev.
Date of issue
Sheet
