peterfelfer/Oxcart/CAD/machining/pocket nc/Collet Bottom Taper v1.step

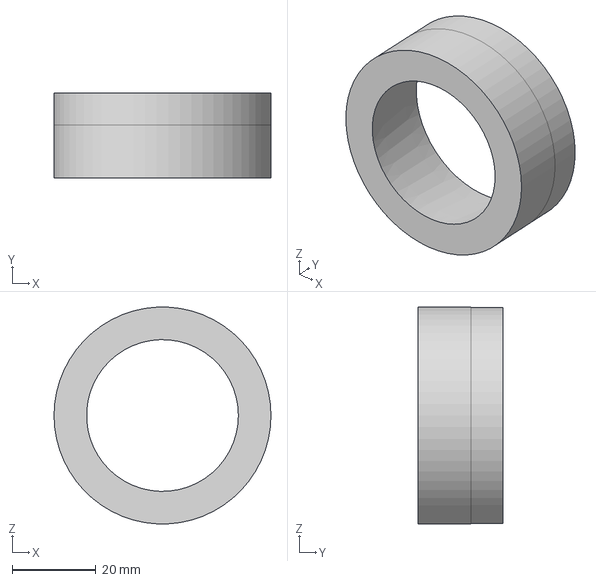
[picture p89: CAD file, 2026-05-30]
CAD/machining/pocket nc/Collet Bottom Taper v1.step
51.9 x 20.3 x 51.8 mm
