peterfelfer/Oxcart/CAD/optics-laser/laser upgrade/LaserStage/LaserStageRotation Drawing v2 Sheet1.dxf

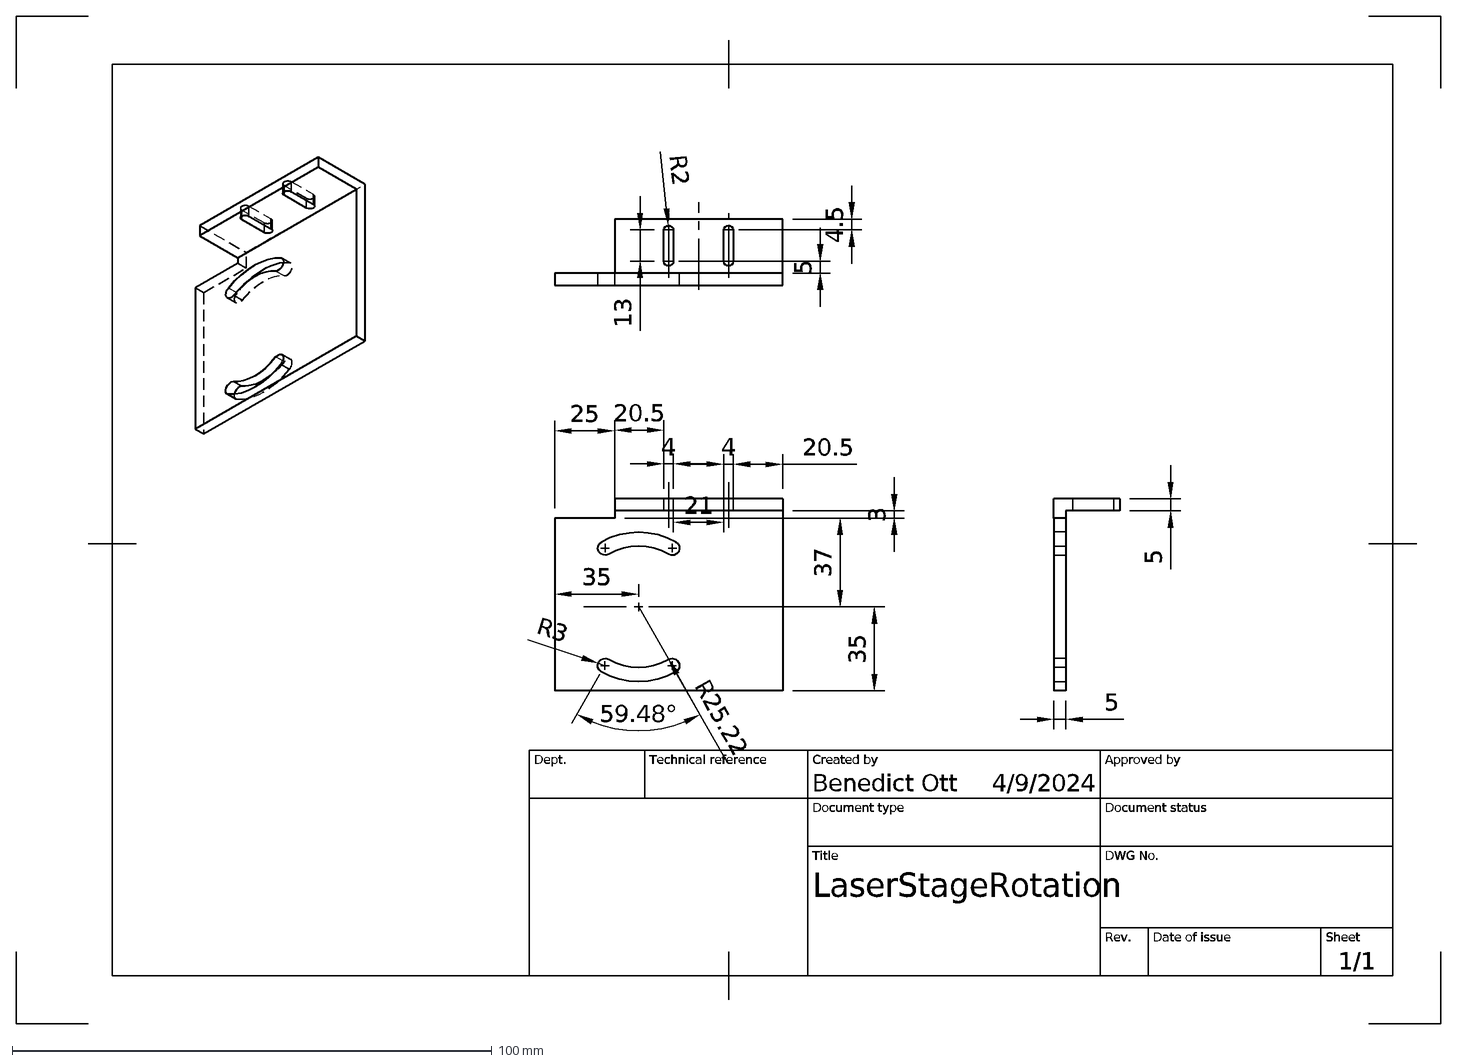
[picture p91: CAD file, 2026-05-30]
CAD/optics-laser/laser upgrade/LaserStage/LaserStageRotation Drawing v2 Sheet1.dxf
4/9/2024
1/1
LaserStageRotation
Benedict Ott
Dept.
Technical reference
Created by
Approved by
Document type
Document status
Title
DWG No.
Rev.
Date of issue
Sheet
R3
20.5
4
21
25
3
35
37
5
59.48°
R25.22
R2
13
4.5
