peterfelfer/Oxcart/CAD/optics-laser/laser upgrade/NKT photonics/Origami XP_109443_FHG v2.step

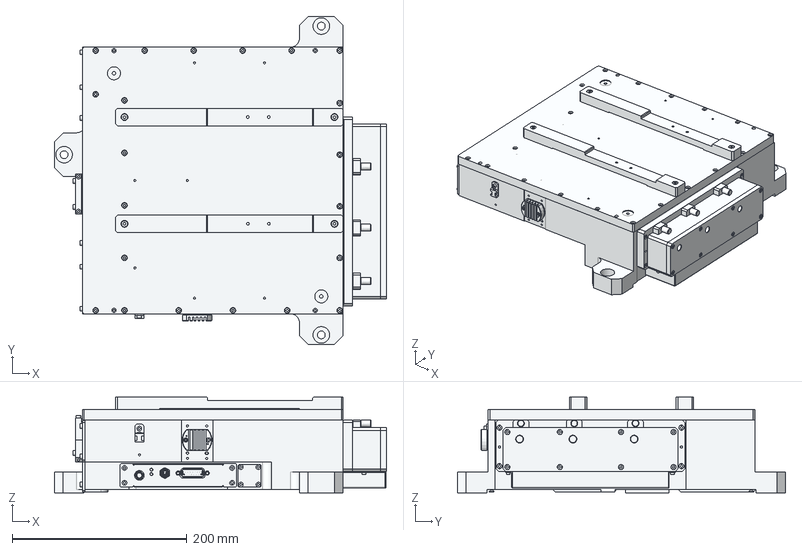
[picture p92: CAD file, 2026-05-30]
CAD/optics-laser/laser upgrade/NKT photonics/Origami XP_109443_FHG v2.step
379.5 x 375.0 x 109.5 mm
