peterfelfer/Oxcart/CAD/optics-laser/laser upgrade/smaract/EX-0038144-XYZ SLC2330_00_Parent v2.step

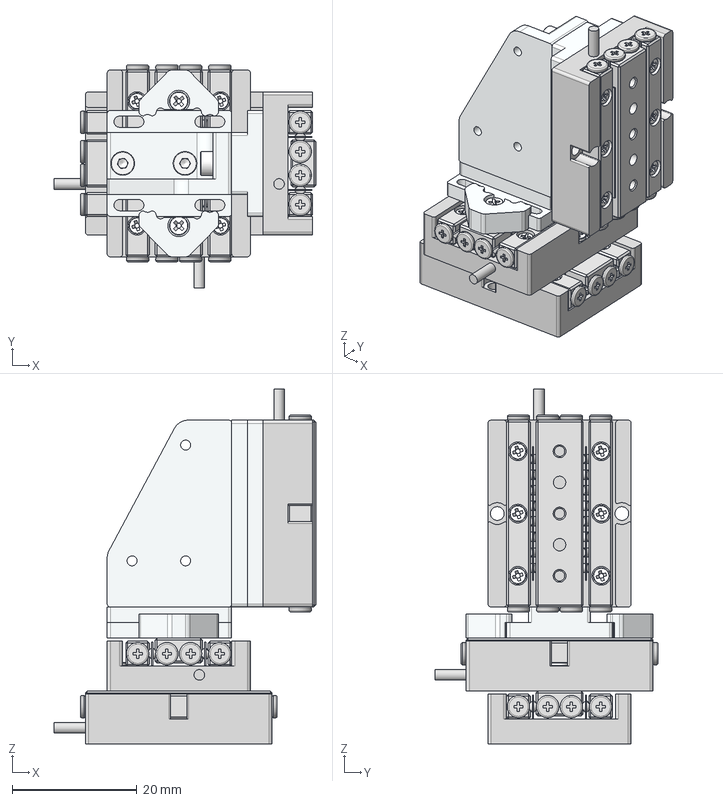
[picture p93: CAD file, 2026-05-30]
CAD/optics-laser/laser upgrade/smaract/EX-0038144-XYZ SLC2330_00_Parent v2.step
42.0 x 35.8 x 57.0 mm
ES-0000728-Rail SVS1_FNB-SVS1030 x 6
ES-0000705-Cage RK1_FNB-RK17-8Z x 6
IS-0006589-NBS_NBS-M1,6x5-St x 18
EX--Baseplate GLC-SLC_SLC-2330-W-D-S x 3
ES-0000810-Slide WS1_WS1030 x 3
EX-0037996-Baseplate_00_Parent
EX-0033125-Plate_00_Parent
EX-0033059-Bracket_00_Parent
EX-0033060-Plate_00_Parent
EX-0013083-Modular Connector_00_Parent x 2
EX-0043426-Cable clip _00_Parent x 4
EX-0043609-Cable clip_00_Parent
ISO 4762-M1.6 X 6-6-A2_ISO 4762-M1.6 X 6-6-A2 x 8
ISO 4762-M2 X 6-6-A2_ISO 4762-M2 X 6-6-A2 x 4
IS-0006594-NBK_NBK-M2x4-St x 6
IS-0006594-NBK_NBK-M2x6-St x 4
