peterfelfer/Oxcart/CAD/sample-handling/BC LL parts/BC linear drive plate v6.step

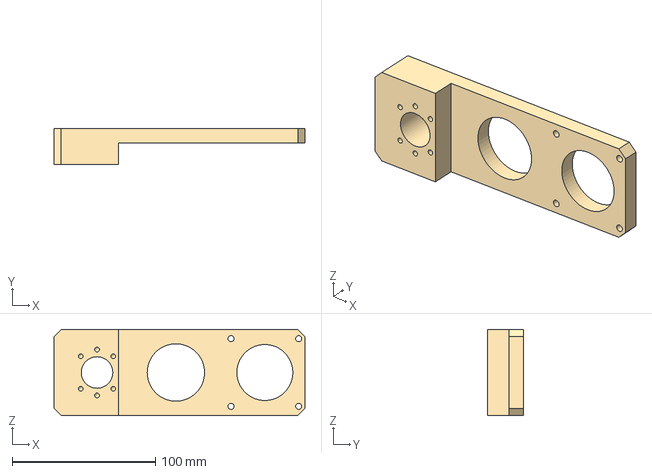
[picture p94: CAD file, 2026-05-30]
CAD/sample-handling/BC LL parts/BC linear drive plate v6.step
175.0 x 25.0 x 60.0 mm
