peterfelfer/Oxcart/CAD/sample-handling/BC LL parts/CAM/V2PocketNC kinematic Bdisc v4 v1-3.step

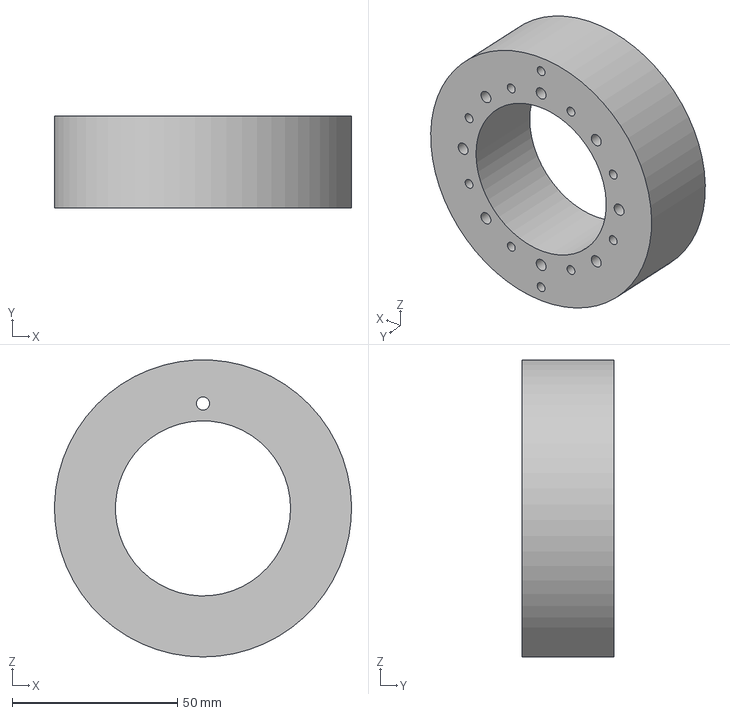
[picture p95: CAD file, 2026-05-30]
CAD/sample-handling/BC LL parts/CAM/V2PocketNC kinematic Bdisc v4 v1-3.step
89.9 x 28.0 x 89.9 mm
