peterfelfer/Oxcart/CAD/sample-handling/sample stage - pucks/RT 60K thermal separator v4.step

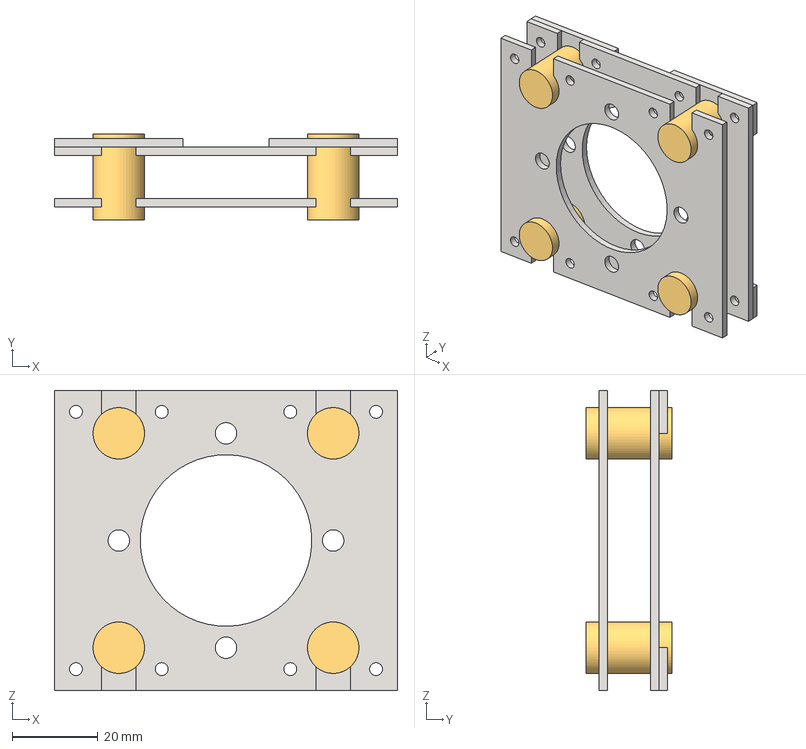
[picture p96: CAD file, 2026-05-30]
CAD/sample-handling/sample stage - pucks/RT 60K thermal separator v4.step
80.0 x 20.0 x 70.0 mm
Ti Baseplate
Vespel spacer
Ti clamp
Vespel spacer(Mirror)
Ti clamp(Mirror)
Vespel spacer(Mirror) (1)
Ti clamp(Mirror) (1)
Vespel spacer(Mirror)(Mirror)
Ti clamp(Mirror)(Mirror)
Ti Baseplate(Mirror)
