peterfelfer/Oxcart/CAD/sample-handling/UHV cryo transfer shuttle/cryo interface v5.step

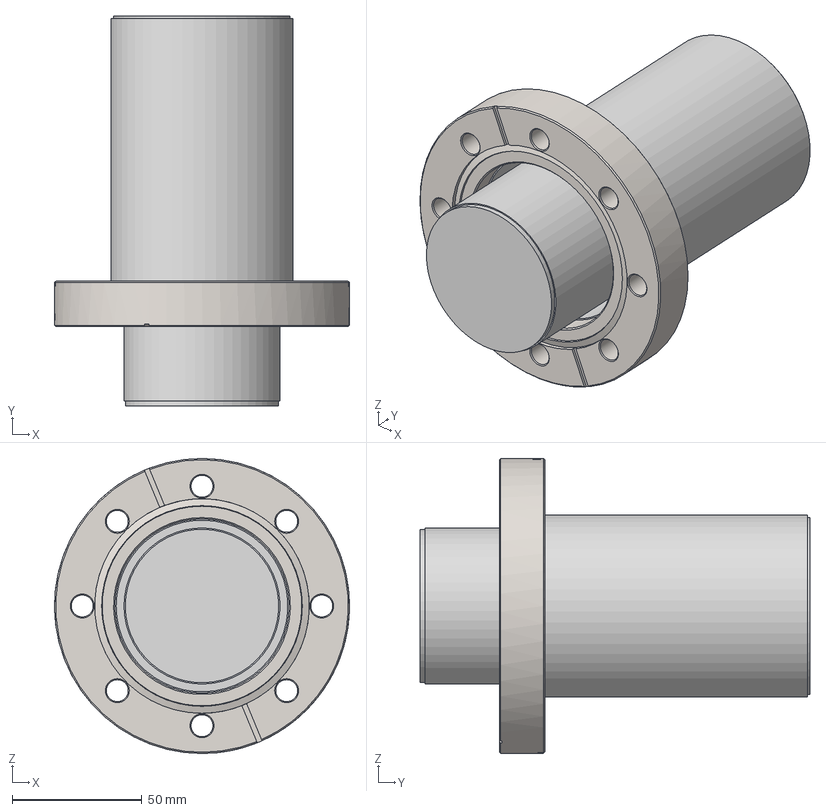
[picture p97: CAD file, 2026-05-30]
CAD/sample-handling/UHV cryo transfer shuttle/cryo interface v5.step
113.5 x 150.0 x 113.5 mm
thermal interface
insulation tube
top connector
outer tube
Hositrad_CF63-70-Weldflange
