peterfelfer/Oxcart/CAD/vacuum/chambers/D1000 NEG Flange Drawing v4 Sheet1.dxf

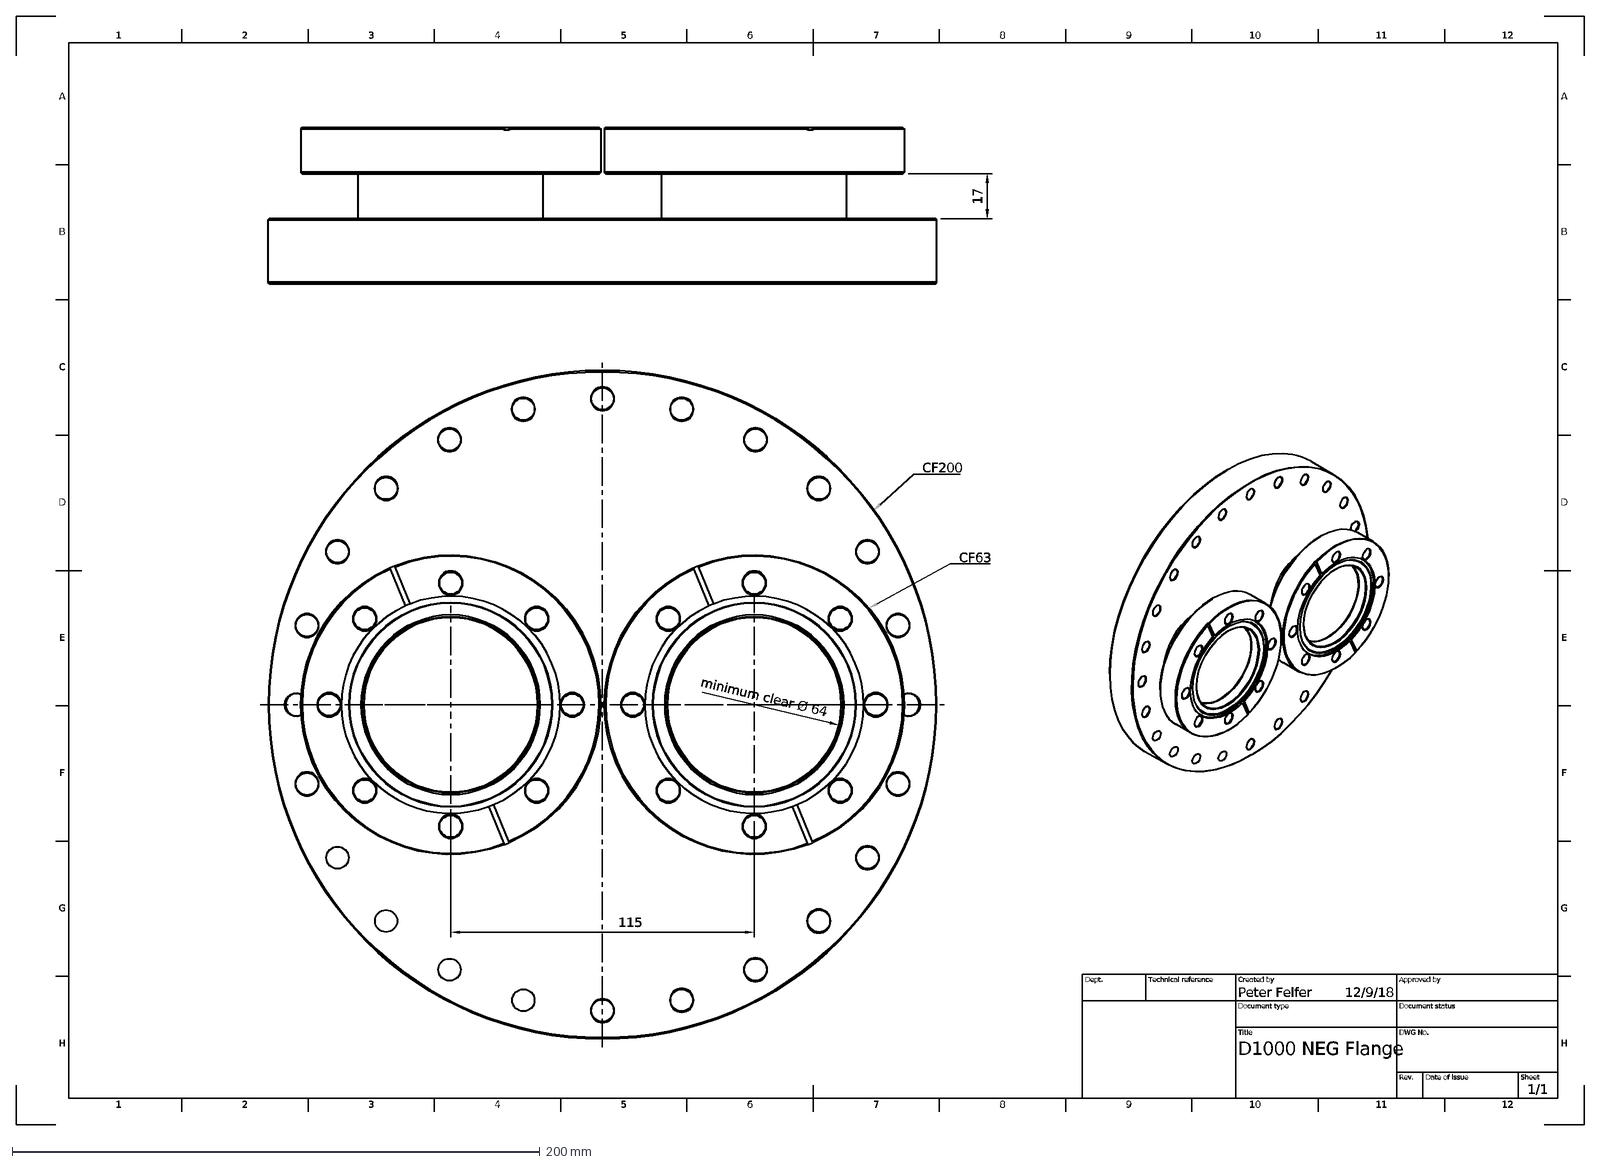
[picture p98: CAD file, 2026-05-30]
CAD/vacuum/chambers/D1000 NEG Flange Drawing v4 Sheet1.dxf
2
1
3
4
5
6
7
8
9
10
11
12
B
A
C
D
E
F
G
H
12/9/18
1/1
D1000 NEG Flange
Peter Felfer
Dept.
Technical reference
Created by
Approved by
Document type
Document status
Title
DWG No.
Rev.
Date of issue
Sheet
CF200
CF63
115
17
minimum clear Ø 64
