peterfelfer/Oxcart/CAD/vacuum/pumps/400lx-8p_w_htrs v1.step

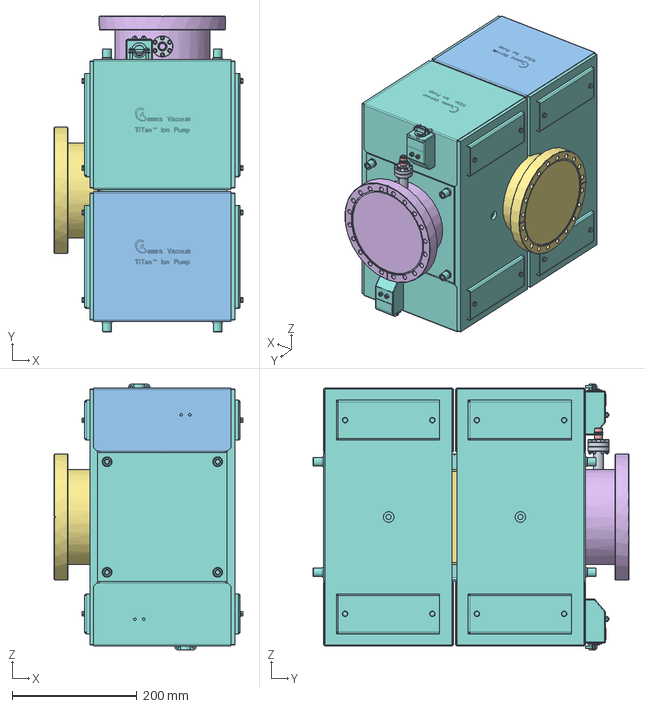
[picture p99: CAD file, 2026-05-30]
CAD/vacuum/pumps/400lx-8p_w_htrs v1.step
301.8 x 505.8 x 425.8 mm
