peterfelfer/Oxcart/CAD/vacuum/vacuum parts/Hositrad_FX-100-100R-Cross v1.step

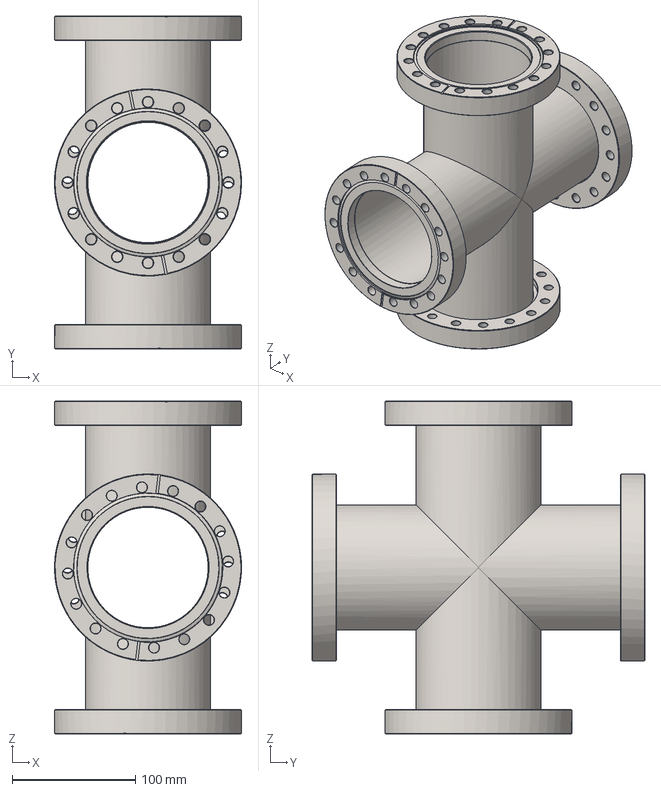
[picture p100: CAD file, 2026-05-30]
CAD/vacuum/vacuum parts/Hositrad_FX-100-100R-Cross v1.step
151.6 x 269.8 x 269.8 mm
FX4-101
NW100CF-R-Outerring_CF100-108 x 2
NW100CF-R-InnerWeld_CF100-102 x 2
NW100CF-weld_CF100-102 x 2
