peterfelfer/Oxcart/CAD/vacuum/valves manipulation/MPPL35-100-H (0) v2.step

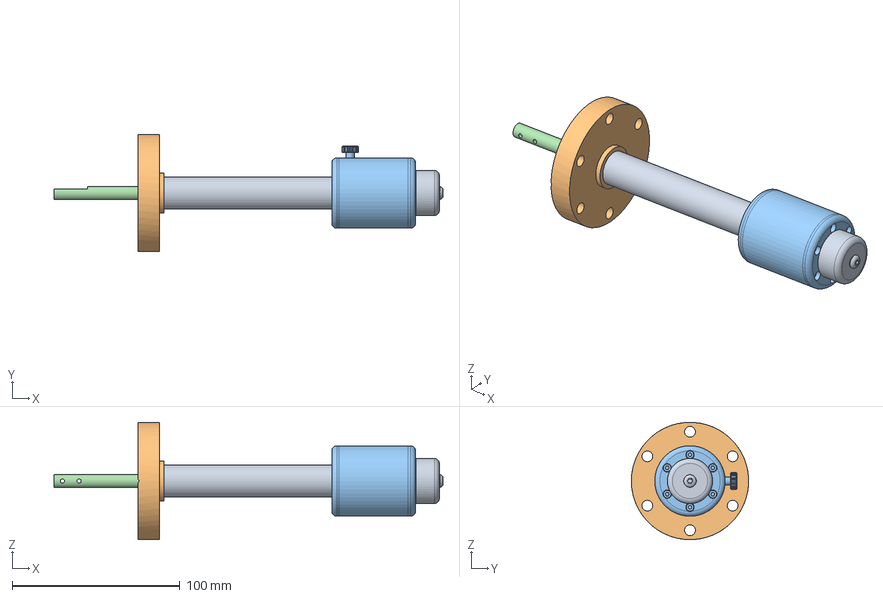
[picture p101: CAD file, 2026-05-30]
CAD/vacuum/valves manipulation/MPPL35-100-H (0) v2.step
232.1 x 70.0 x 70.0 mm
MPPL-H-16_35-BASE (100) (0)
MPPL-CF35-H flange
MPPL-H-16_35-BASE-THIMBLE (100) (0)
MPPL (H)(100)_shaft
