peterfelfer/Oxcart/CAD/cryo/cryo LL/CryoLL v7.step

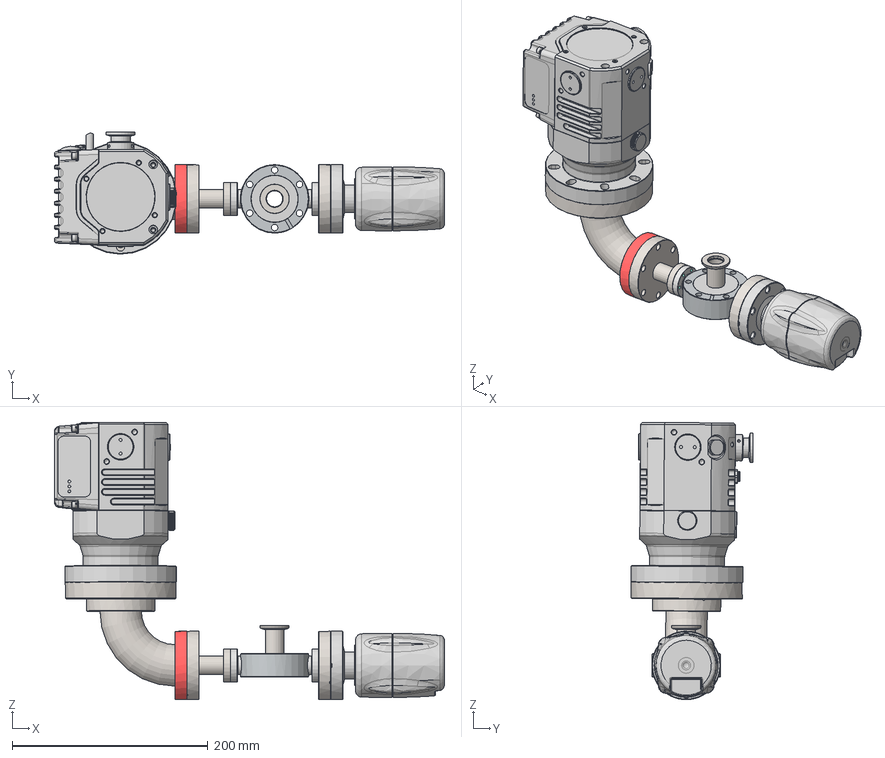
[picture p102: CAD file, 2026-05-30]
CAD/cryo/cryo LL/CryoLL v7.step
398.1 x 124.8 x 283.2 mm
NW35CF-Straight Hole_CF35-Hole 19,05
Tube 19-All_Tube19L35
NW16CF-weld_CF16-19
Elbows-90-all_35-43
CF35-BR-innerring_CF35-43-W
CF35-BR-outerring
NW35CF-Weld-42.4
VAb_DCF 40-2
CF-To-KF-Adaptors-All_CFA16-KF16
KF16-19WS_KF16-19
NW16CF-Outerring
NW16CF-Innerring_CF16-19-R
B8GX10C01 nEXT85 CF63 (2)
D14703000_GAUGE_WIDE_RNGE_S_FCC68_NW35CF
Hositrad_CFA63-38D
Hositrad_CFA35-16D
