peterfelfer/Oxcart/CAD/cryo/cryo system BC/cryo head flange v5.step

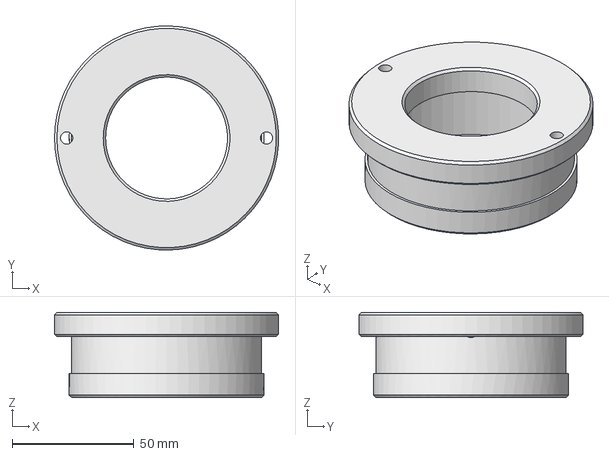
[picture p103: CAD file, 2026-05-30]
CAD/cryo/cryo system BC/cryo head flange v5.step
91.9 x 92.0 x 35.0 mm
