peterfelfer/Oxcart/CAD/cryo/cryo system MC/CAM/heater plug shim CAM v4.step

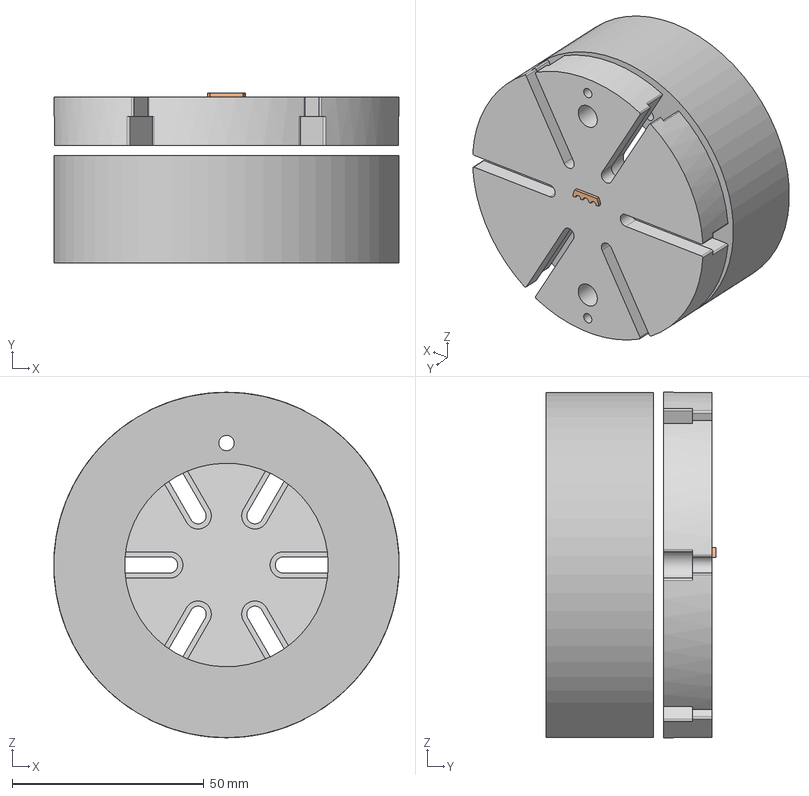
[picture p104: CAD file, 2026-05-30]
CAD/cryo/cryo system MC/CAM/heater plug shim CAM v4.step
89.8 x 44.2 x 90.0 mm
V2PocketNC kinematic Bdisc v4
V2 removable table v1
shim
