peterfelfer/Oxcart/CAD/cryo/cryo system MC/stage 2 shield v7.step

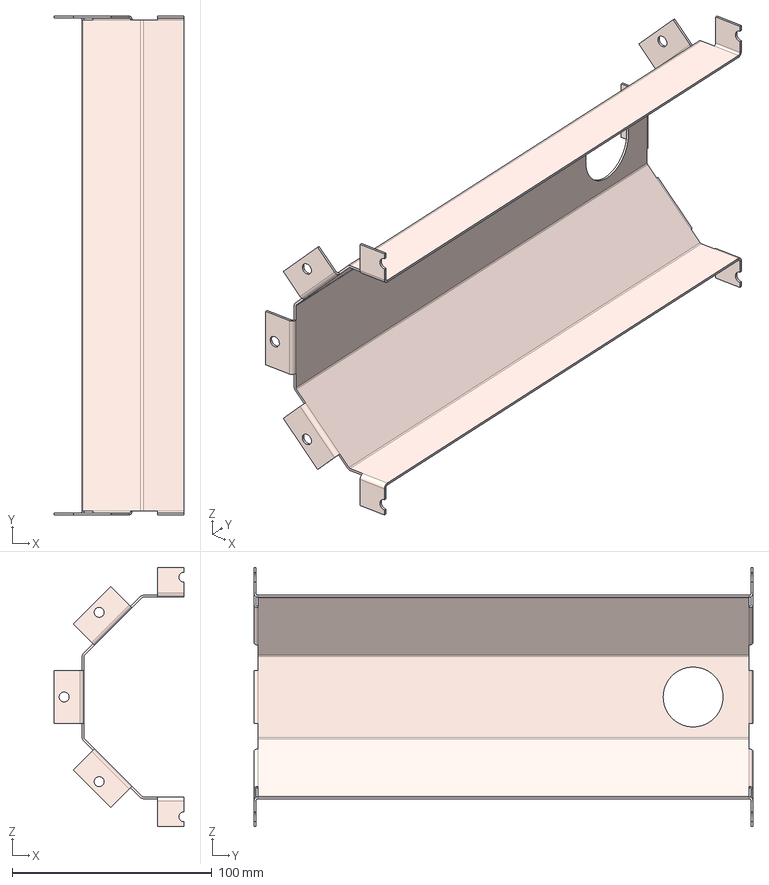
[picture p105: CAD file, 2026-05-30]
CAD/cryo/cryo system MC/stage 2 shield v7.step
65.0 x 250.0 x 130.0 mm
