peterfelfer/Oxcart/CAD/detector/dld8080_added_flange_BO v1.step

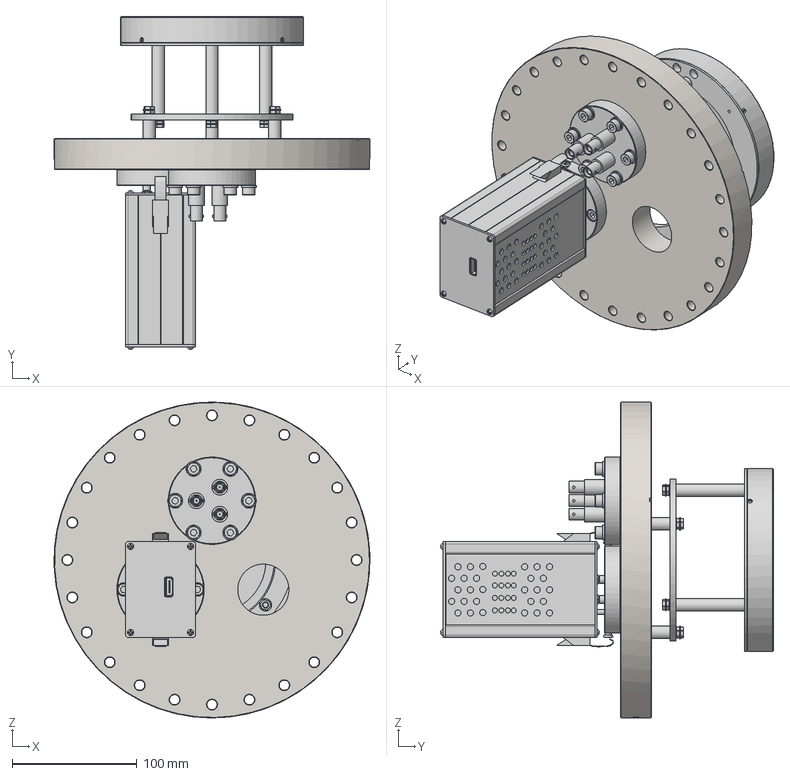
[picture p106: CAD file, 2026-05-30]
CAD/detector/dld8080_added_flange_BO v1.step
253.0 x 266.9 x 253.2 mm
DLD8080_BODENPLATTE
MCP-75-32-25-19_60ZU1
DLD8080_ABDECKUNG_V2
M2X5-SENKKOPF_TITAN x 3
STANDOFF_ALU_18X10_V2 x 3
HALTERING_3D-DLD4040-150
ABSTANDSHALTER_PEEK x 3
M5-GEWINDESTANGE_ALU x 6
M5-WASCHER_CUBE x 12
M5-MUTTER_TITAN x 12
CF40-KUPFERDICHTUNG x 2
3FACH_SHV_CF40
SHV5_SINGLE_2 x 3
4FOLD_SMB_FLANSCH_RAW
SMB_METALLHUELSE x 4
SMB_KONTAKTPIN x 4
GLASHUELSE_INNEN x 4
GLASHUELSE_AUSSEN x 4
ORIENTIERUNGSPIN_ACU
BUNDOESE_METAL x 2
M3X6-SENKKOPF x 2
SMB_CABLECONNECTOR_RG178 x 4
M6_UNTERLEGSCHEIBE_VA x 6
M6X20_VA x 6
M6X18_VA_ABGEDREHT x 6
GOLDSTECKER-SHV-CC23F x 3
SEITENPROFIL_ACU342_1 x 2
RUECKPLATTE_SMB-MONTAGE_2
MONTAGESCHIENE_1 x 2
BODEN-DECKEL_1 x 2
MANIFOLD_SOLID_BREP_19127
MANIFOLD_SOLID_BREP_19216
MANIFOLD_SOLID_BREP_19305
MANIFOLD_SOLID_BREP_19394
MANIFOLD_SOLID_BREP_19483
MANIFOLD_SOLID_BREP_19572
MANIFOLD_SOLID_BREP_19661
MANIFOLD_SOLID_BREP_19750
MANIFOLD_SOLID_BREP_19839
MANIFOLD_SOLID_BREP_19928
MANIFOLD_SOLID_BREP_20017
MANIFOLD_SOLID_BREP_20106
MANIFOLD_SOLID_BREP_20195
MANIFOLD_SOLID_BREP_20284
MANIFOLD_SOLID_BREP_20373
MANIFOLD_SOLID_BREP_20462
MANIFOLD_SOLID_BREP_20551
ABSTANDHUELSEN_PVC_3X5_1 x 4
ZYLINDERKOPF_PVC_M3X12_1 x 4
MUTTER_M3_3 x 8
KOFFERVERSCHLUSS_1 x 2
SMB_PANNELCONNECTOR_RG178_2 x 4
KRATZSCHEIBE_SMB_1 x 4
LOETOESE_M5_1 x 4
MONTAGEMUTTER_SMB_1 x 4
ZYLINDERKOPF_METAL_M3X6_1 x 4
LINSENKOPF_BLECHSCHRAUBE_M3_1 x 8
FRONTPLATTE_ACU342_1
Hositrad_CF200-BT
