peterfelfer/Oxcart/CAD/frame/Frame components/PSY176-Step v1.step

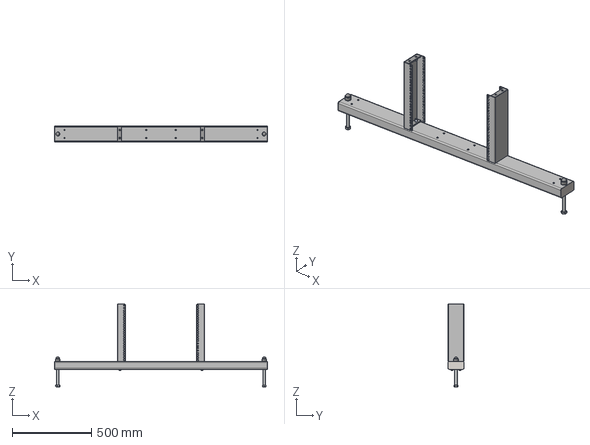
[picture p107: CAD file, 2026-05-30]
CAD/frame/Frame components/PSY176-Step v1.step
1342.0 x 100.0 x 520.0 mm
