peterfelfer/Oxcart/CAD/gas-thermal/baking equipment/baking base Drawing v3 Sheet1.dxf

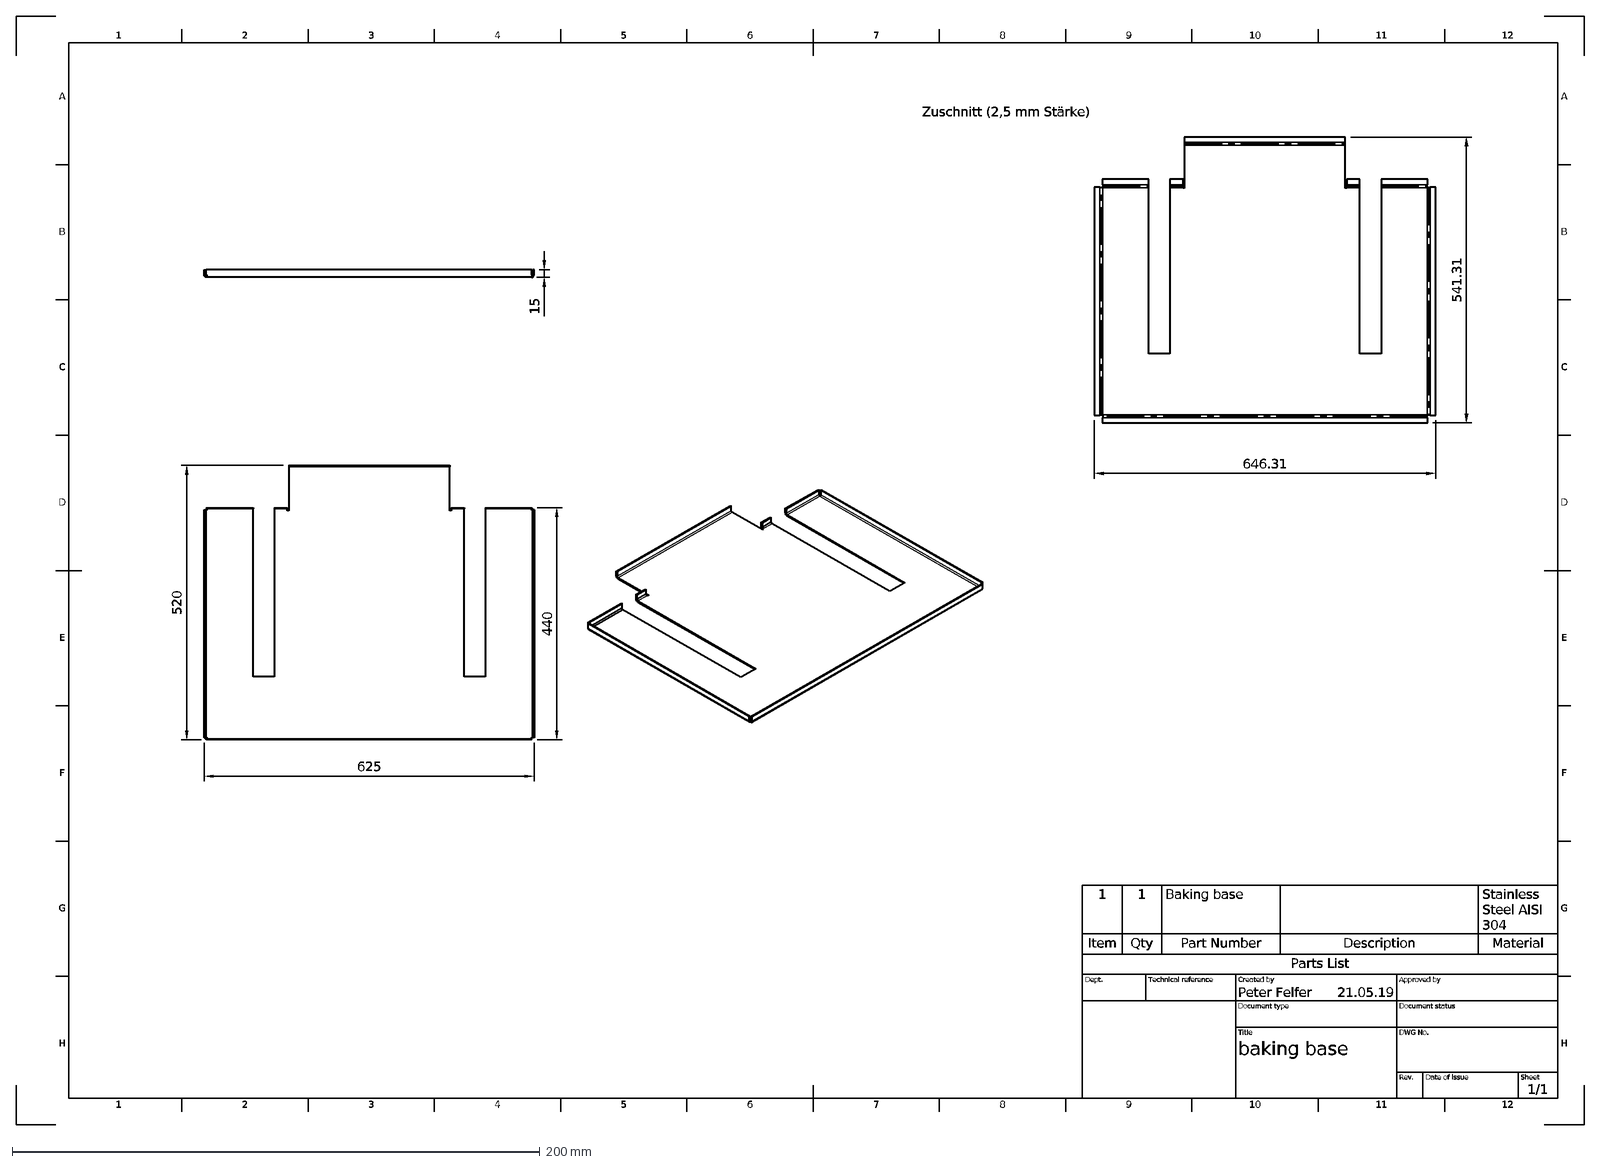
[picture p108: CAD file, 2026-05-30]
CAD/gas-thermal/baking equipment/baking base Drawing v3 Sheet1.dxf
2
1
3
4
5
6
7
8
9
10
11
12
B
A
C
D
E
F
G
H
21.05.19
1/1
baking base
Peter Felfer
Dept.
Technical reference
Created by
Approved by
Document type
Document status
Title
DWG No.
Rev.
Date of issue
Sheet
Parts List
Item
Qty
Part Number
Description
Material
Baking base
Stainless Steel AISI 304
646.31
541.31
15
625
440
520
Zuschnitt (2,5 mm Stärke)
