peterfelfer/Oxcart/CAD/gas-thermal/gas charging devices/490DFL016-S10 v3.step

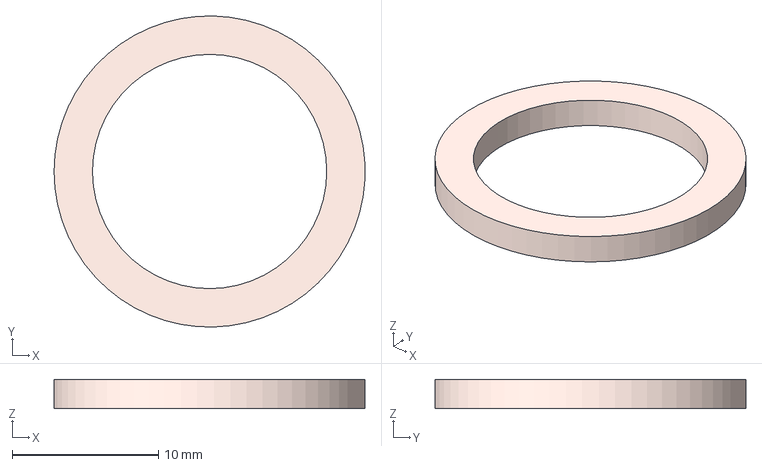
[picture p109: CAD file, 2026-05-30]
CAD/gas-thermal/gas charging devices/490DFL016-S10 v3.step
21.2 x 21.2 x 2.00 mm
