peterfelfer/Oxcart/CAD/gas-thermal/gas charging devices/deuterium pump/deuterium compression device Rohr Zeichnung v2 Plan1.dxf

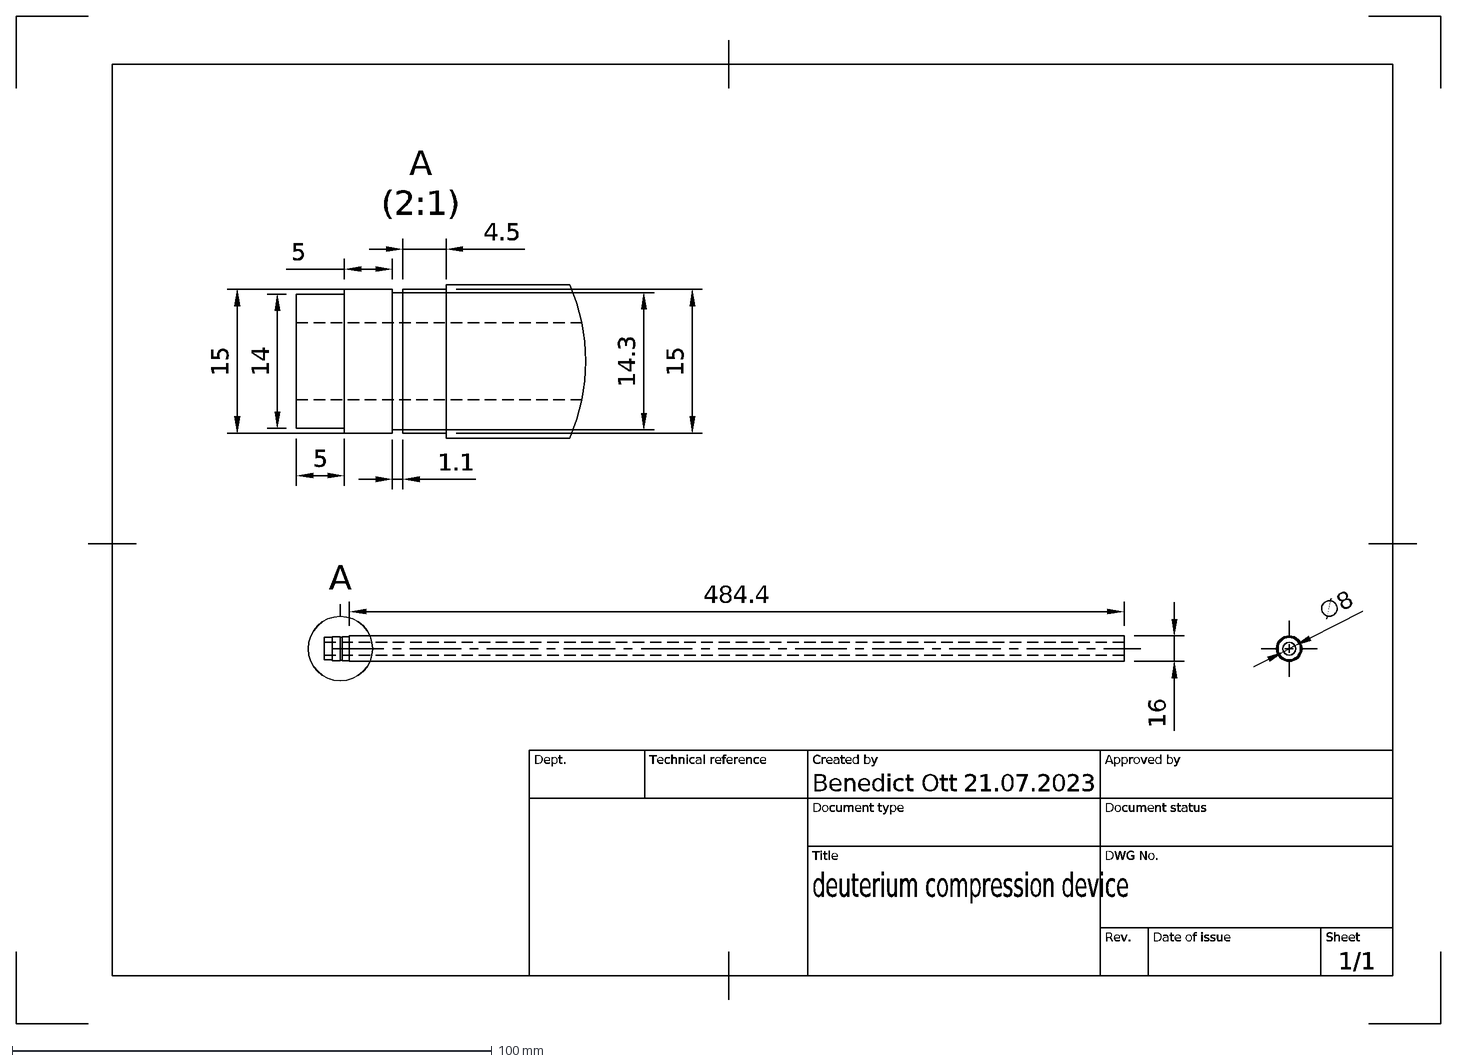
[picture p110: CAD file, 2026-05-30]
CAD/gas-thermal/gas charging devices/deuterium pump/deuterium compression device Rohr Zeichnung v2 Plan1.dxf
21.07.2023
1/1
deuterium compression device
Benedict Ott
Dept.
Technical reference
Created by
Approved by
Document type
Document status
Title
DWG No.
Rev.
Date of issue
Sheet
16
484.4
∅8
A (2:1)
5
1.1
4.5
14
15
14.3
A
