peterfelfer/Oxcart/CAD/gas-thermal/gas charging devices/gasChargingBombHolder/gasChargingBombHolderCryologgerstand v5.step

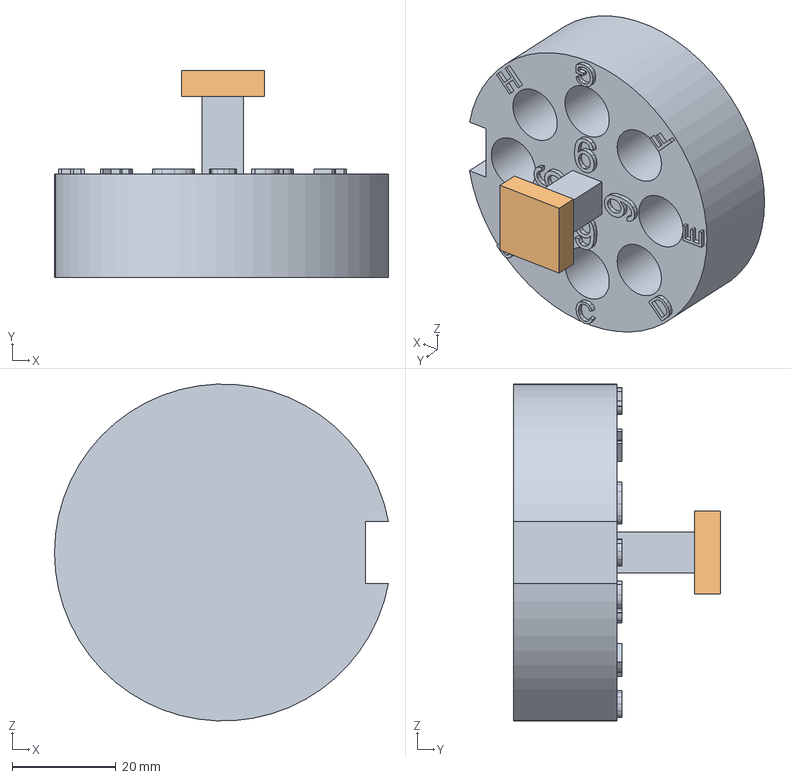
[picture p111: CAD file, 2026-05-30]
CAD/gas-thermal/gas charging devices/gasChargingBombHolder/gasChargingBombHolderCryologgerstand v5.step
64.4 x 40.0 x 65.0 mm
