peterfelfer/Oxcart/CAD/gas-thermal/gas charging devices/gasChargingCartridge/V2/gasChargingCartridgeV2 Zeichnung v1 Plan1.dxf

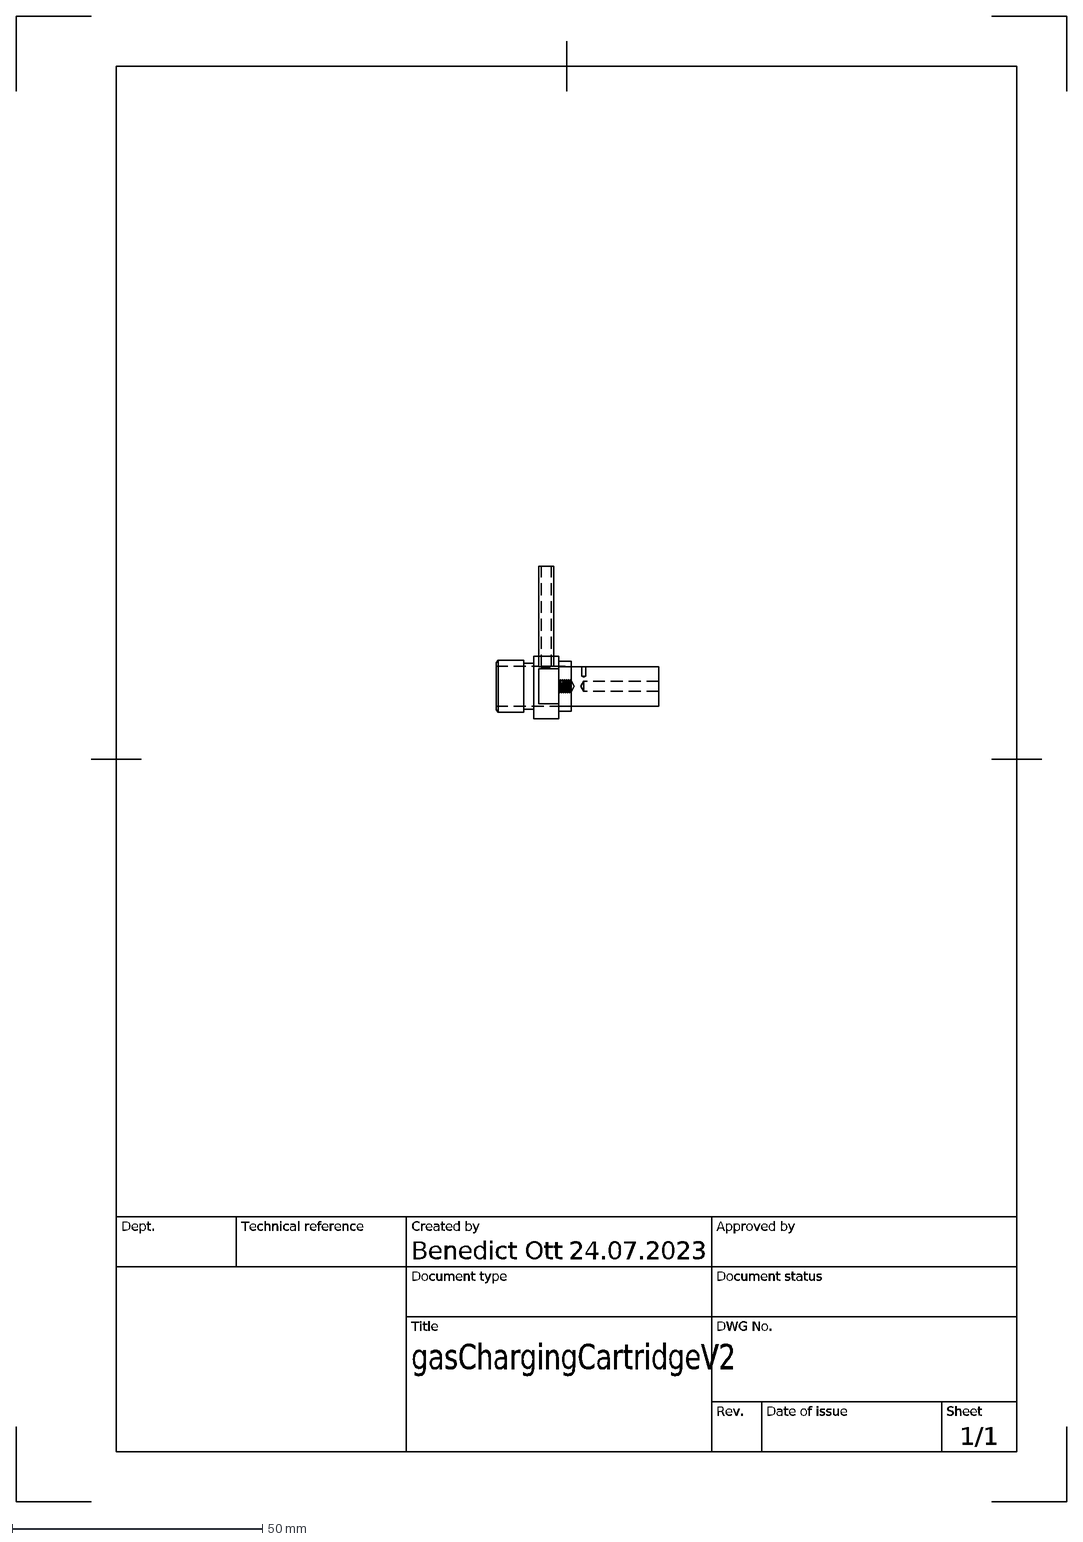
[picture p112: CAD file, 2026-05-30]
CAD/gas-thermal/gas charging devices/gasChargingCartridge/V2/gasChargingCartridgeV2 Zeichnung v1 Plan1.dxf
24.07.2023
1/1
gasChargingCartridgeV2
Benedict Ott
Dept.
Technical reference
Created by
Approved by
Document type
Document status
Title
DWG No.
Rev.
Date of issue
Sheet
