peterfelfer/Oxcart/CAD/gas-thermal/gas charging devices/gasChargingCube/Hositrad_CF16-B_RuptureDisc Zeichnung v1 Plan1.dxf

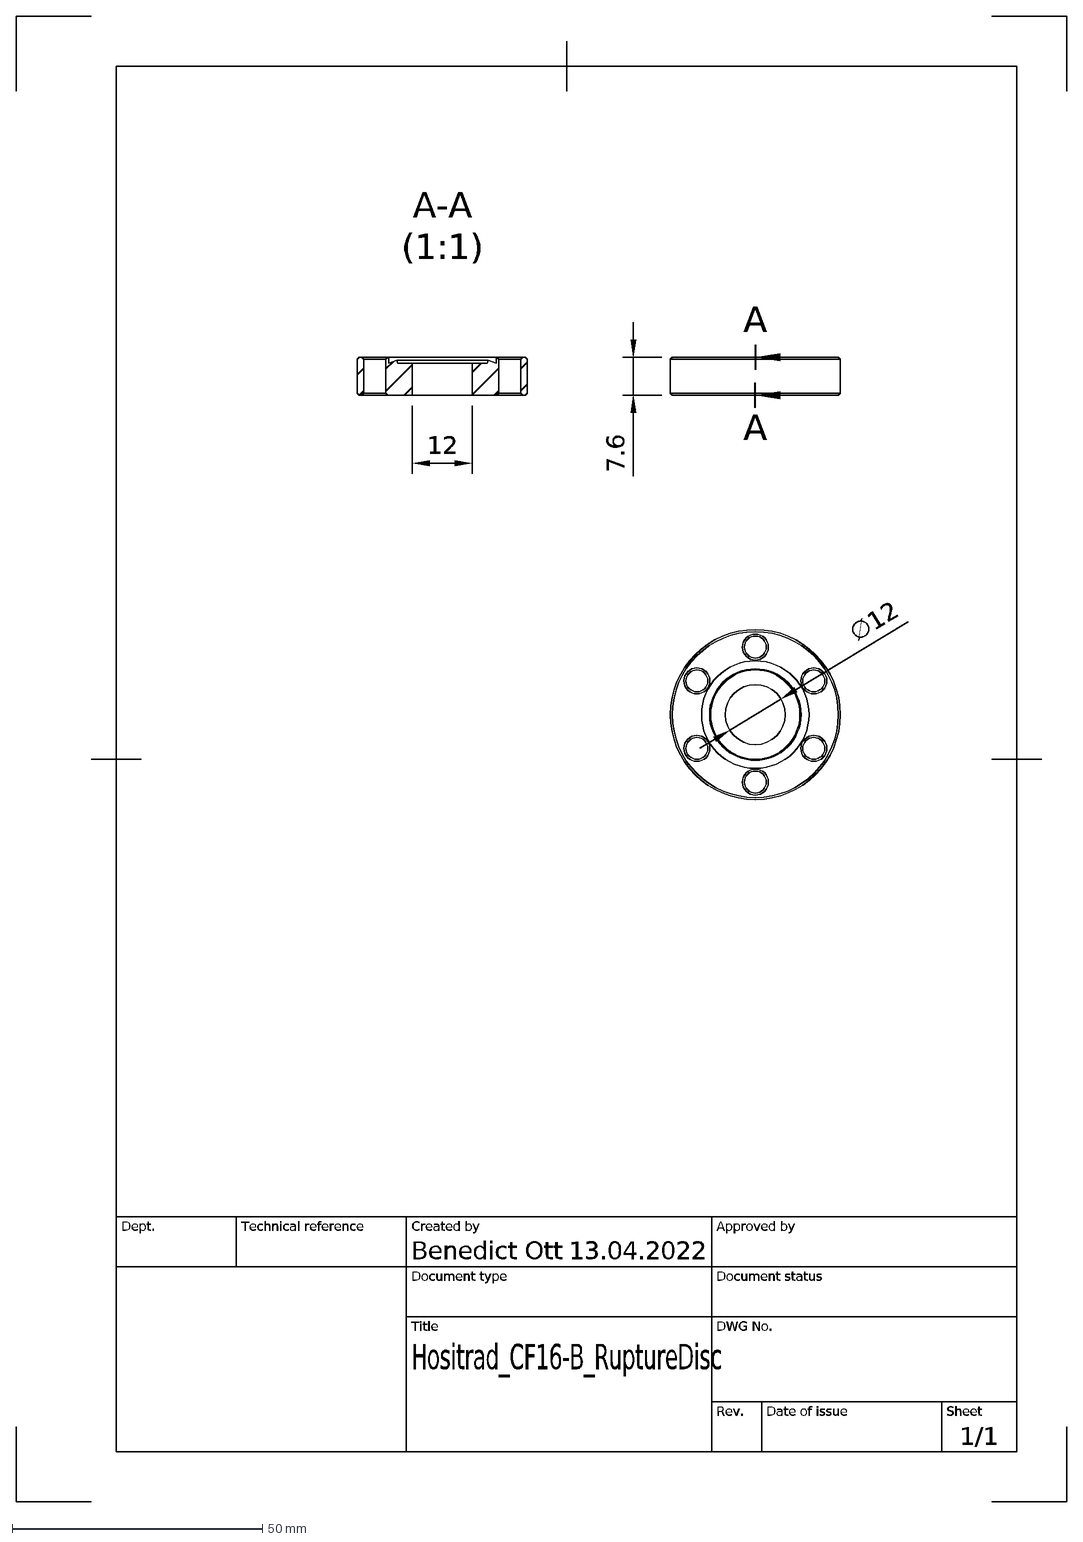
[picture p113: CAD file, 2026-05-30]
CAD/gas-thermal/gas charging devices/gasChargingCube/Hositrad_CF16-B_RuptureDisc Zeichnung v1 Plan1.dxf
13.04.2022
1/1
Hositrad_CF16-B_RuptureDisc
Benedict Ott
Dept.
Technical reference
Created by
Approved by
Document type
Document status
Title
DWG No.
Rev.
Date of issue
Sheet
A-A (1:1)
12
7.6
∅12
A
