peterfelfer/Oxcart/CAD/gas-thermal/gas charging devices/gasChargingFlashBang/sampleHolder_fancy v4.step

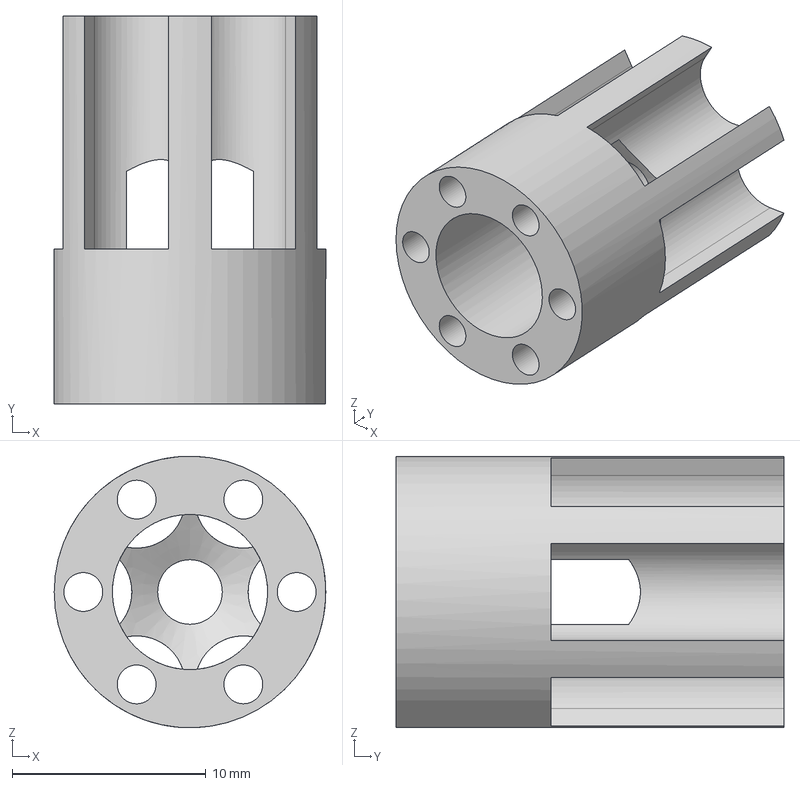
[picture p114: CAD file, 2026-05-30]
CAD/gas-thermal/gas charging devices/gasChargingFlashBang/sampleHolder_fancy v4.step
14.0 x 20.0 x 14.0 mm
