peterfelfer/Oxcart/CAD/gas-thermal/gas charging devices/gasChargingHandgrenade/rn1212es12623 v3.step

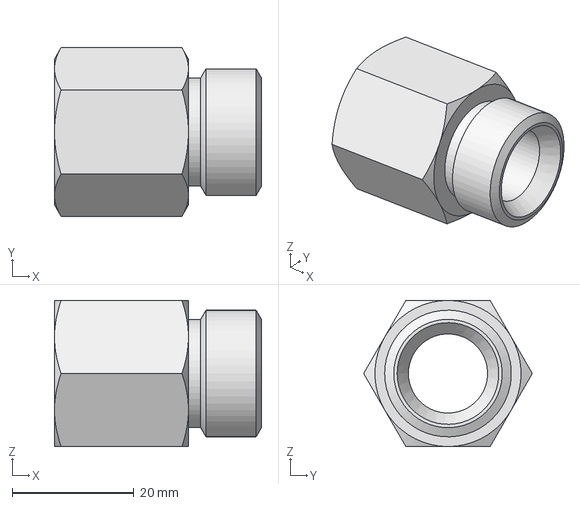
[picture p115: CAD file, 2026-05-30]
CAD/gas-thermal/gas charging devices/gasChargingHandgrenade/rn1212es12623 v3.step
34.0 x 27.7 x 24.0 mm
