peterfelfer/Oxcart/CAD/gas-thermal/gas charging devices/gasSupplyParts/SS-6BG-MM-SwagelokCompany-3D-04-05-2022 v2.step

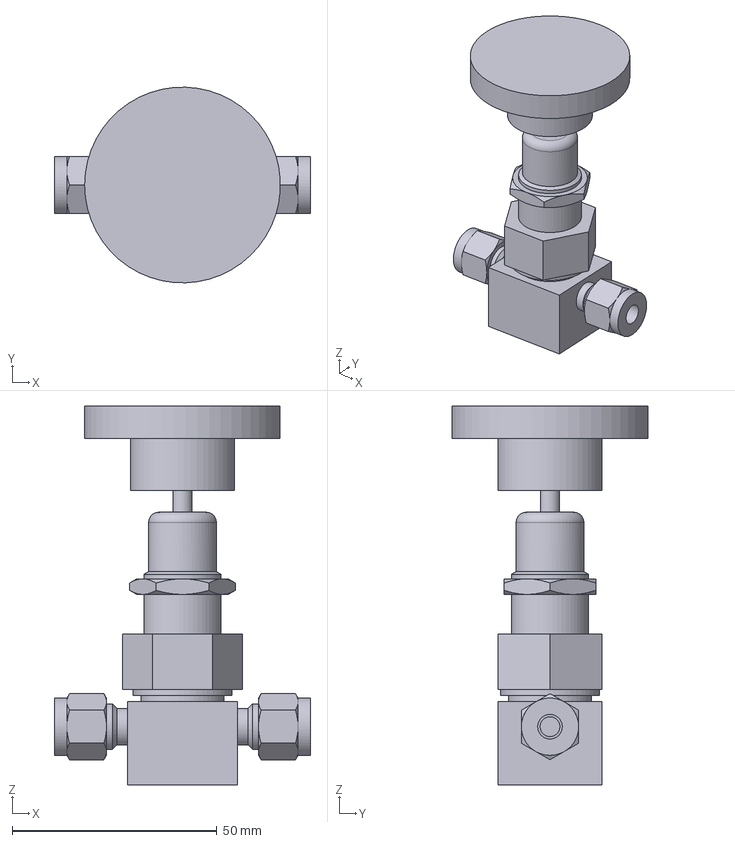
[picture p116: CAD file, 2026-05-30]
CAD/gas-thermal/gas charging devices/gasSupplyParts/SS-6BG-MM-SwagelokCompany-3D-04-05-2022 v2.step
62.5 x 47.7 x 92.5 mm
