peterfelfer/Oxcart/CAD/machining/MC NEG laser space requirements v1 Sheet1.dxf

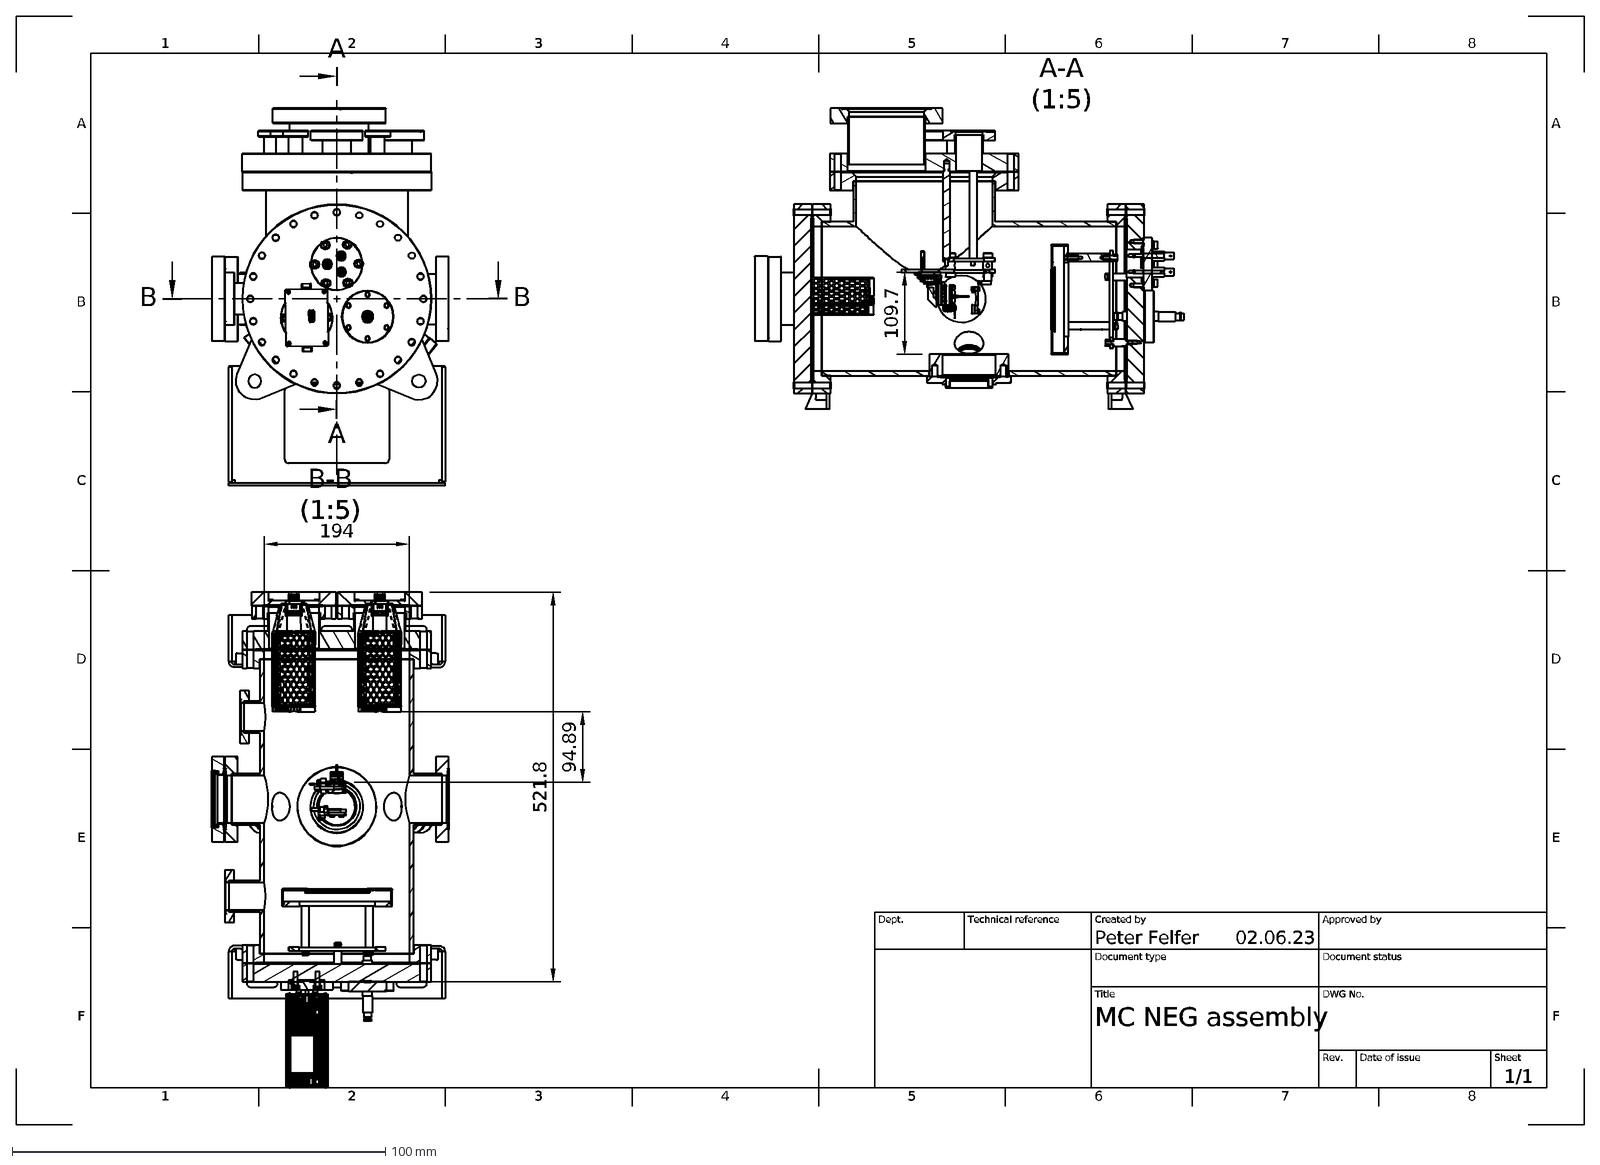
[picture p117: CAD file, 2026-05-30]
CAD/machining/MC NEG laser space requirements v1 Sheet1.dxf
02.06.23
1/1
MC NEG assembly
Peter Felfer
Dept.
Technical reference
Created by
Approved by
Document type
Document status
Title
DWG No.
Rev.
Date of issue
Sheet
A-A (1:5)
B-B (1:5)
521.8
194
94.89
109.7
1
A
2
3
4
5
6
7
8
B
C
D
E
F
