peterfelfer/Oxcart/CAD/machining/pocket nc/B-table and Collet v2.step

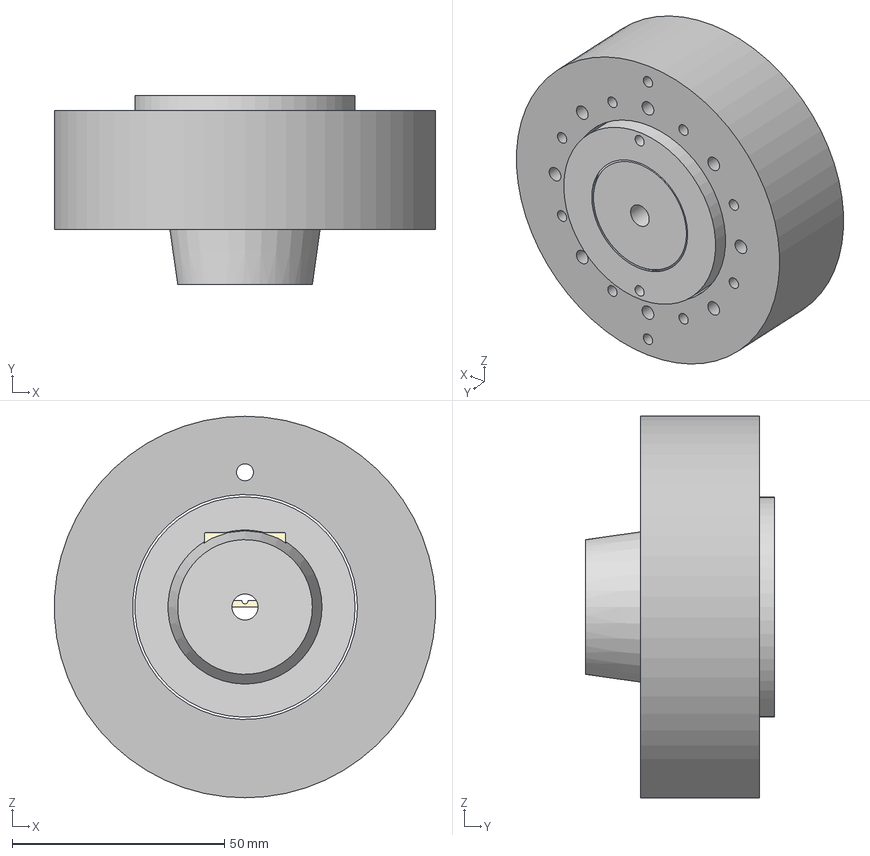
[picture p118: CAD file, 2026-05-30]
CAD/machining/pocket nc/B-table and Collet v2.step
89.8 x 44.6 x 89.9 mm
Collet Bottom Taper
Collet Top Taper
ER-40 Collet Generic v1
V2PocketNC kinematic Bdisc v4
