peterfelfer/Oxcart/CAD/optics-laser/laser upgrade/LaserSaftyInterlockDoorBelt v1.step

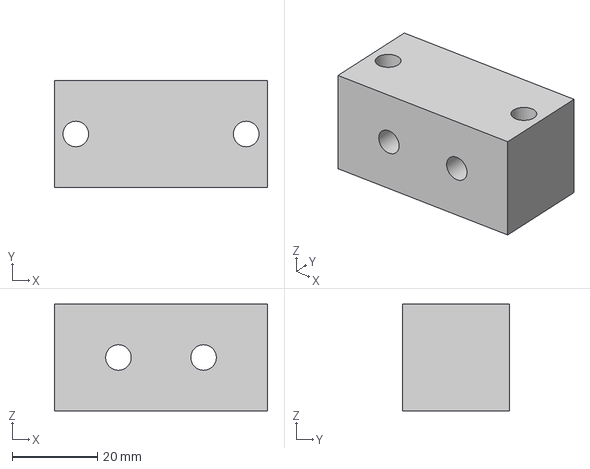
[picture p119: CAD file, 2026-05-30]
CAD/optics-laser/laser upgrade/LaserSaftyInterlockDoorBelt v1.step
50.0 x 25.0 x 25.0 mm
