peterfelfer/Oxcart/CAD/optics-laser/laser upgrade/LaserStage/LaserStageXYZ v19.step

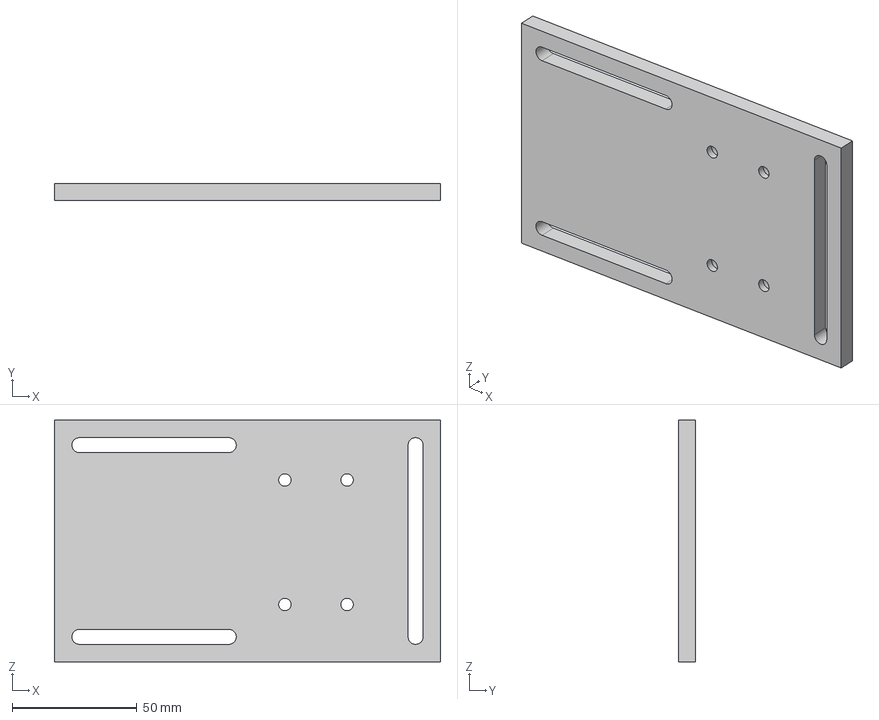
[picture p120: CAD file, 2026-05-30]
CAD/optics-laser/laser upgrade/LaserStage/LaserStageXYZ v19.step
155.0 x 7.00 x 97.0 mm
