peterfelfer/Oxcart/CAD/optics-laser/laser upgrade/NKT photonics/LaerCover v2.step

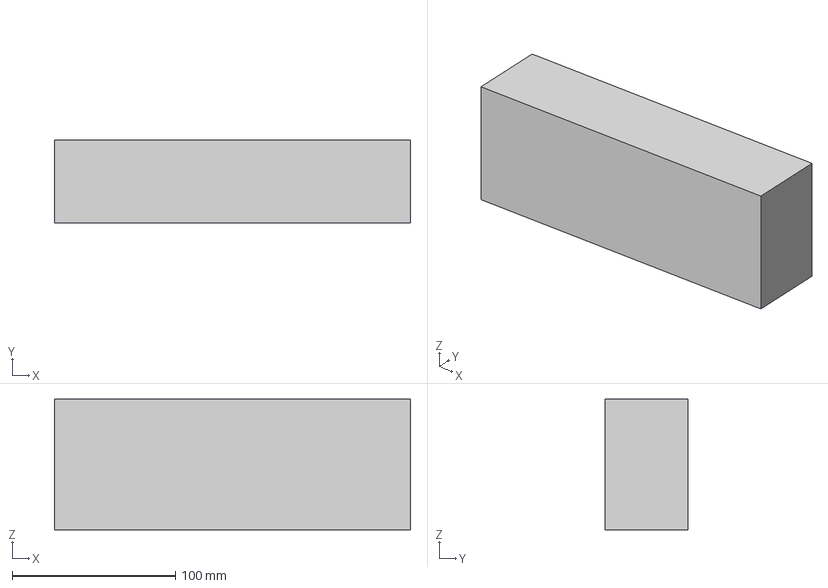
[picture p121: CAD file, 2026-05-30]
CAD/optics-laser/laser upgrade/NKT photonics/LaerCover v2.step
218.0 x 51.0 x 80.0 mm
