peterfelfer/Oxcart/CAD/optics-laser/laser upgrade/smaract/EX-0038097-XYZ SLC1722_00_Parent v2.step

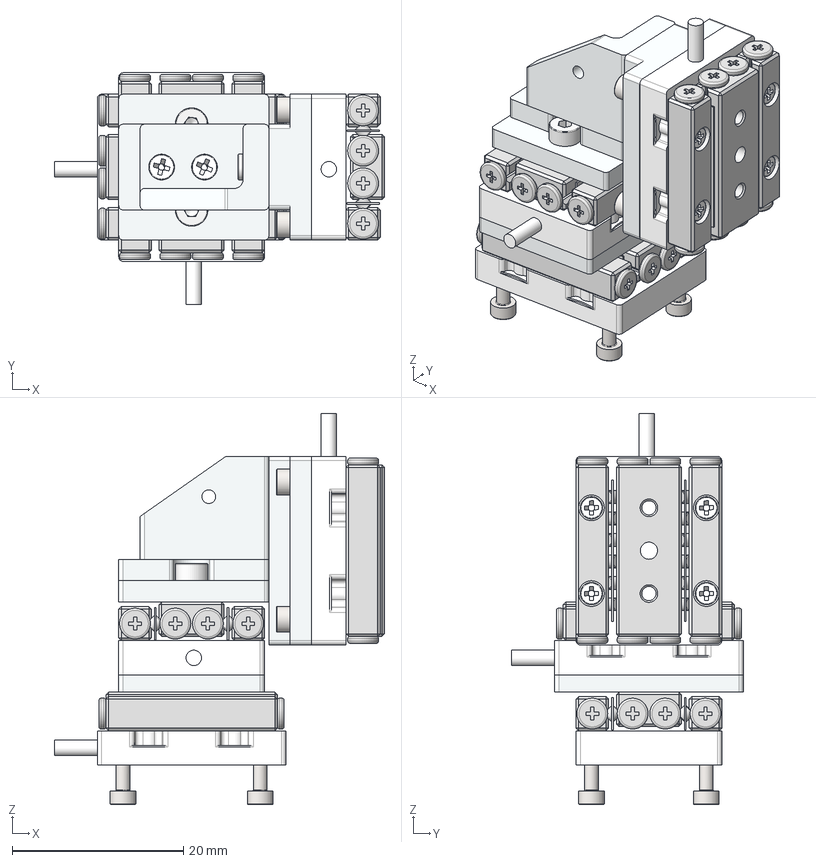
[picture p122: CAD file, 2026-05-30]
CAD/optics-laser/laser upgrade/smaract/EX-0038097-XYZ SLC1722_00_Parent v2.step
38.5 x 27.0 x 45.6 mm
EX-0011844-Baseplate SLC1722-S_00_Parent x 3
ES-0000728-Rail SVS1_FNB-SVS1020 x 6
ES-0000705-Cage RK1_FNB-RK17-6Z x 6
IS-0006589-NBS_NBS-M1,6x5-St x 12
ES-0000810-Slide WS1_WS1020 x 3
EX-0037996-Baseplate_00_Parent
IS-0011435-Connecting Element_00_Parent
EX-0034841-Plate_00_Parent
EX-0033068-Bracket_00_Parent
EX-0035285-Plate_00_Parent
EX-0043426-Cable clip _00_Parent x 3
EX-0043609-Cable clip_00_Parent
ISO 4762-M1.6 X 6-6-A2_ISO 4762-M1.6 X 6-6-A2 x 8
ISO 4762-M2 X 6-6-A2_ISO 4762-M2 X 6-6-A2 x 2
IS-0006594-NBK_NBK-M1,6x4-St x 4
IS-0006594-NBK_NBK-M2x4-St x 7
IS-0006594-NBK_NBK-M2x6-St x 4
