peterfelfer/Oxcart/CAD/sample-handling/BC LL parts/BC Endeffector Drawing v9 Sheet1.dxf

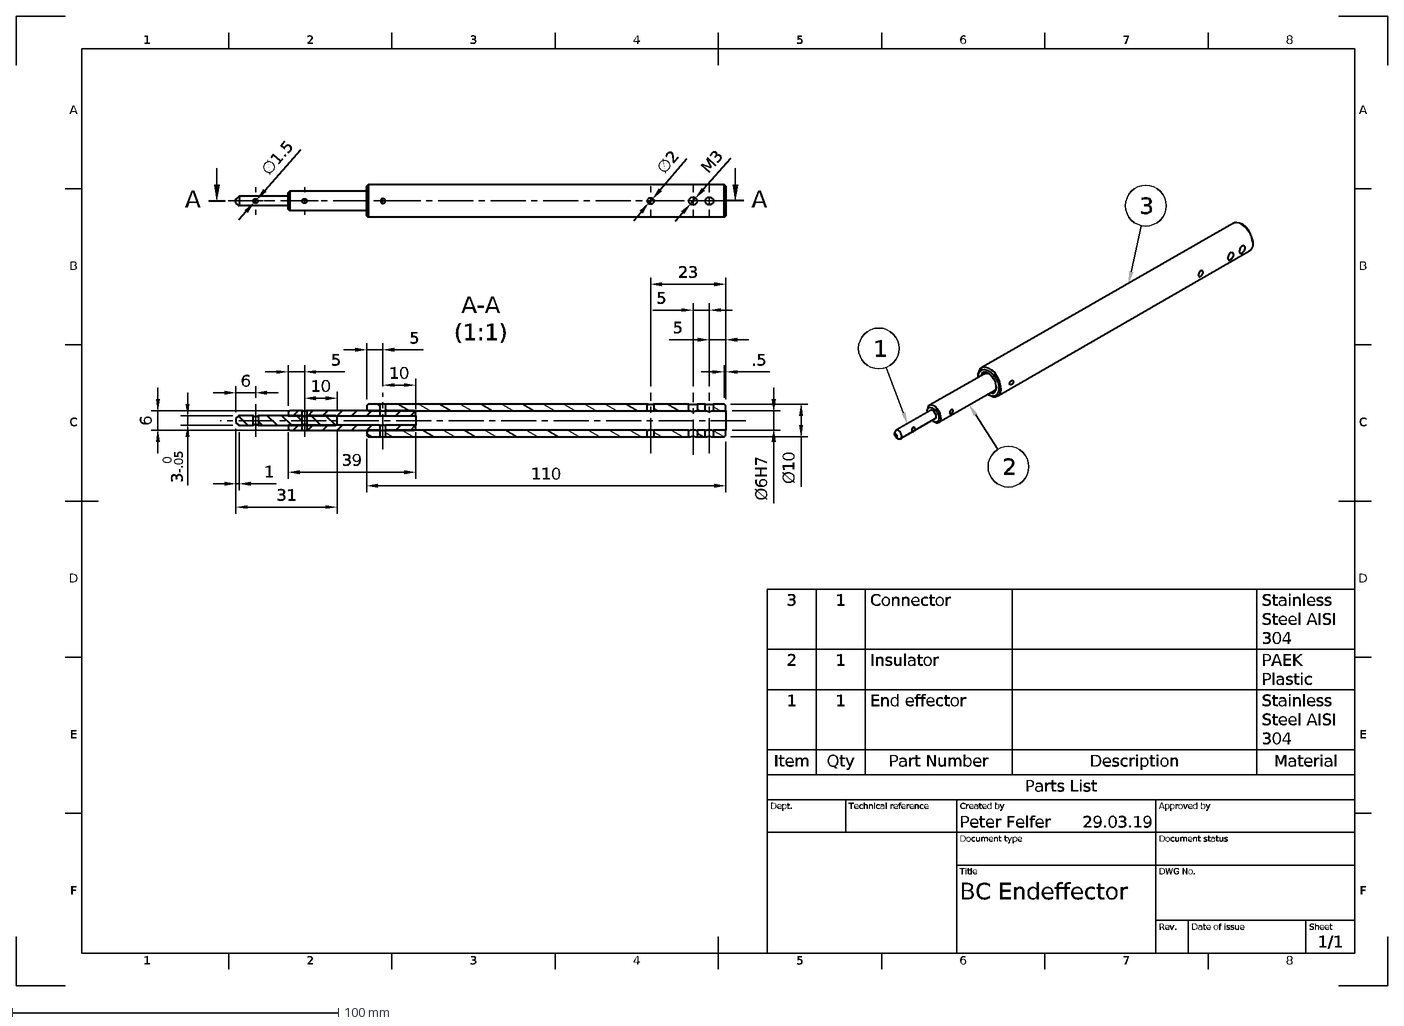
[picture p123: CAD file, 2026-05-30]
CAD/sample-handling/BC LL parts/BC Endeffector Drawing v9 Sheet1.dxf
1
A
2
3
4
5
6
7
8
B
C
D
E
F
29.03.19
1/1
BC Endeffector
Peter Felfer
Dept.
Technical reference
Created by
Approved by
Document type
Document status
Title
DWG No.
Rev.
Date of issue
Sheet
A-A (1:1)
.5
110
39
23
Ø6H7
Ø10
∅1.5
∅2
M3
Parts List
Item
Qty
Part Number
Description
Material
End effector
Stainless Steel AISI 304
Insulator
PAEK Plastic
Connector
3 0^-.05
31
10
