peterfelfer/Oxcart/CAD/sample-handling/BC LL parts/CAM/BC carousel top cap v5.step

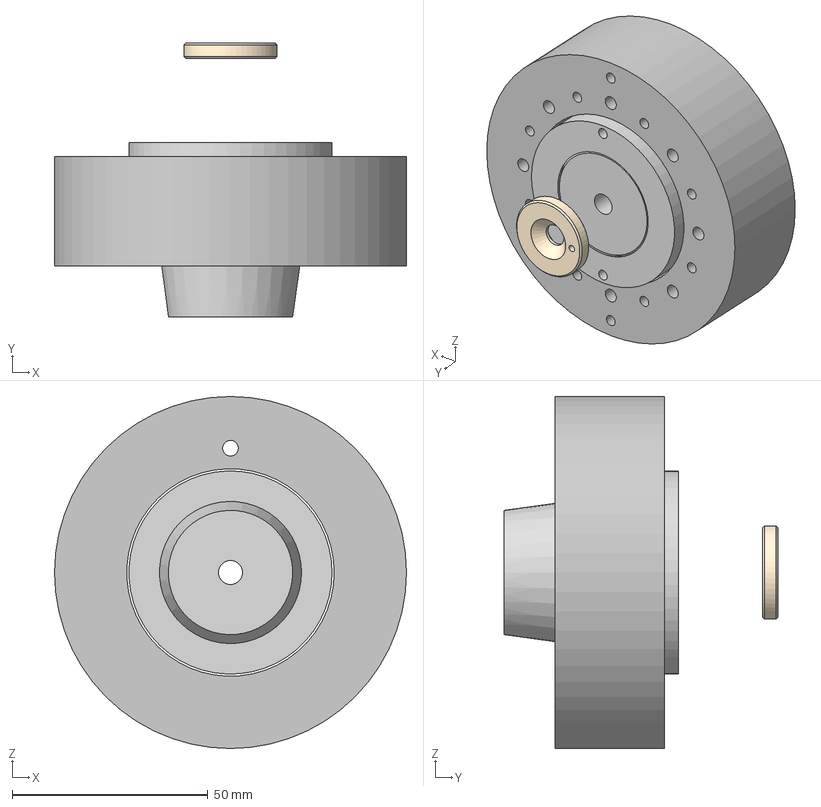
[picture p124: CAD file, 2026-05-30]
CAD/sample-handling/BC LL parts/CAM/BC carousel top cap v5.step
89.9 x 70.0 x 89.9 mm
Collet Bottom Taper
Collet Top Taper
ER-40 Collet Generic v1
V2PocketNC kinematic Bdisc v4
BC vertical rod endcap
