peterfelfer/Oxcart/CAD/sample-handling/sample stage - pucks/CAM/ME puck insulators v5.step

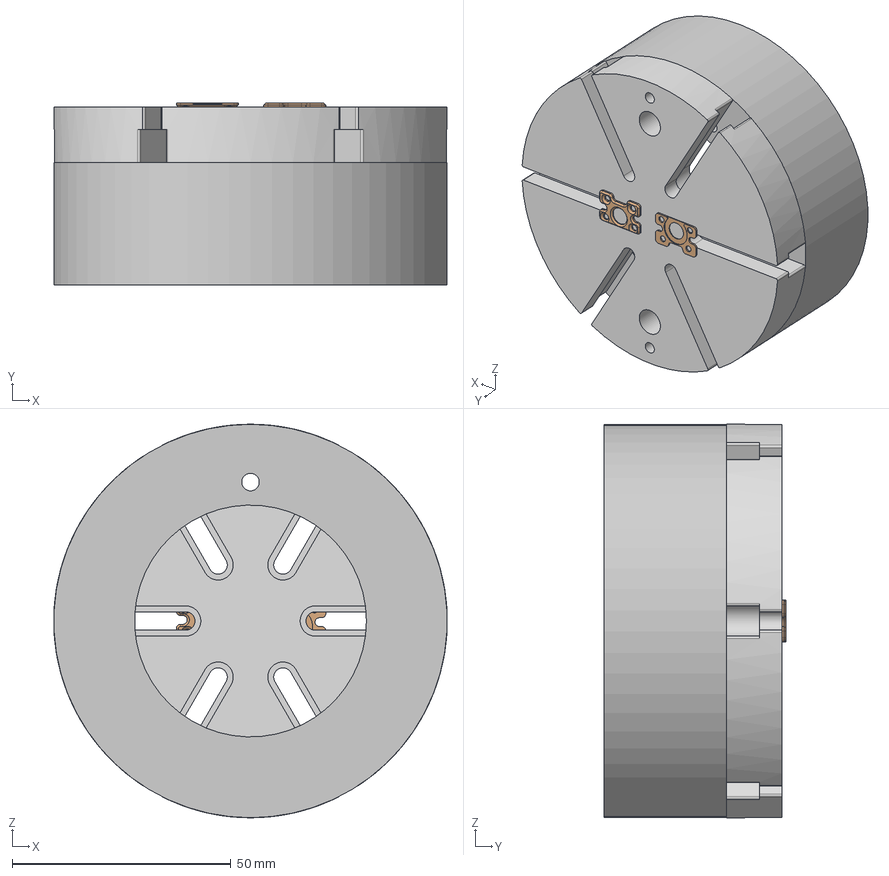
[picture p126: CAD file, 2026-05-30]
CAD/sample-handling/sample stage - pucks/CAM/ME puck insulators v5.step
89.8 x 41.7 x 90.0 mm
V2PocketNC kinematic Bdisc v4
V2 removable table v1
insulator
insulator (1)
