peterfelfer/Oxcart/CAD/vacuum/chambers/chamber brackets v6.step

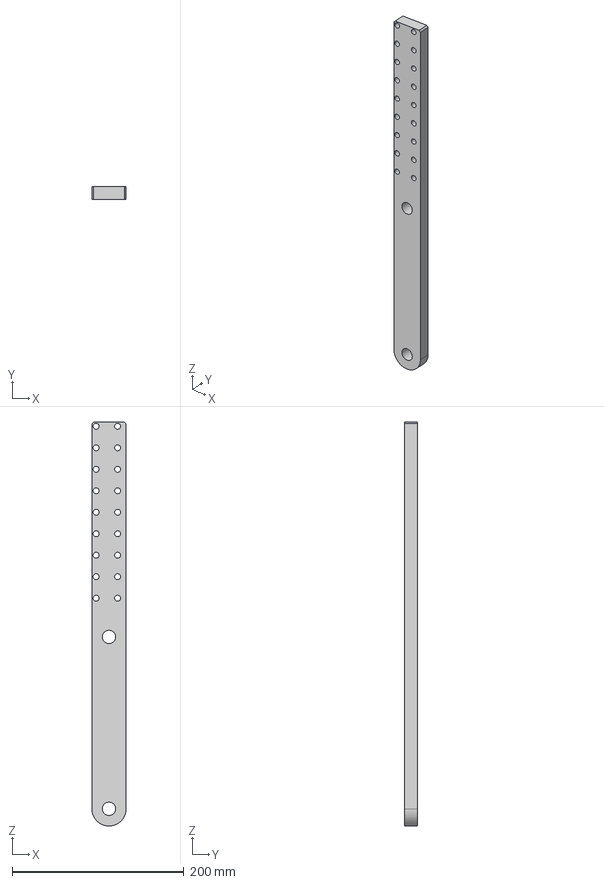
[picture p127: CAD file, 2026-05-30]
CAD/vacuum/chambers/chamber brackets v6.step
40.0 x 15.0 x 470.0 mm
