peterfelfer/Oxcart/CAD/vacuum/pumps/500t-8s_no_htrs v1.step

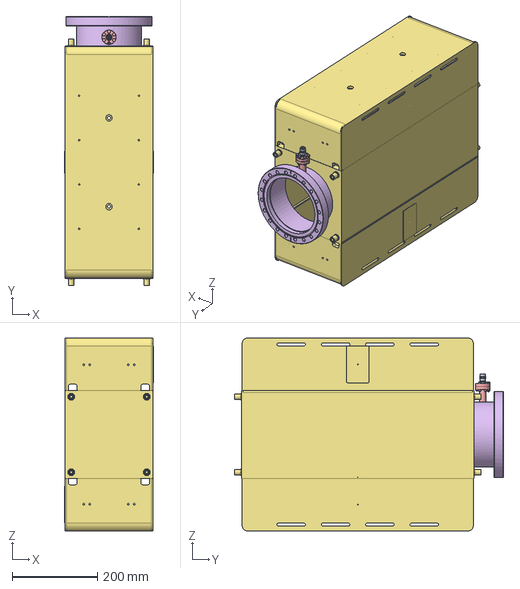
[picture p128: CAD file, 2026-05-30]
CAD/vacuum/pumps/500t-8s_no_htrs v1.step
207.7 x 630.8 x 452.4 mm
