peterfelfer/Oxcart/CAD/vacuum/vacuum parts/420BMH160 (1) v1.step

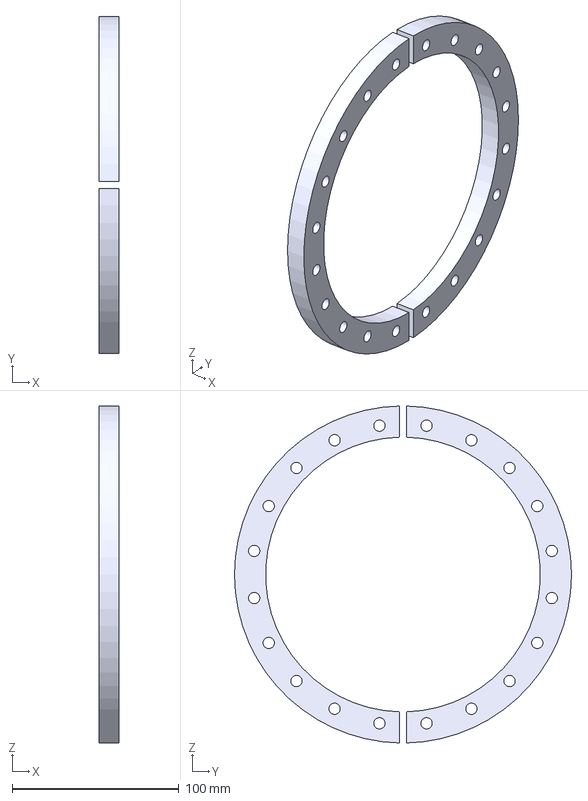
[picture p129: CAD file, 2026-05-30]
CAD/vacuum/vacuum parts/420BMH160 (1) v1.step
12.0 x 202.4 x 202.4 mm
