peterfelfer/Oxcart/CAD/vacuum/valves manipulation/MPPRL35-300-H (0) v3.step

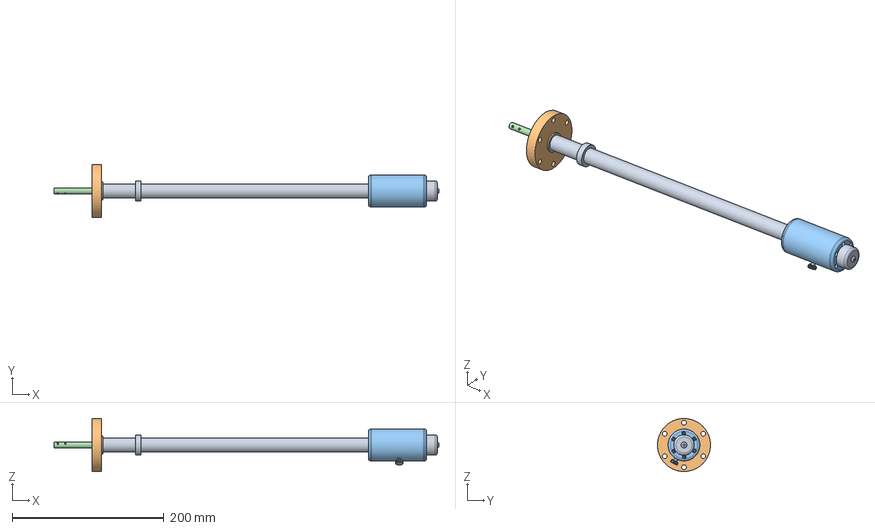
[picture p130: CAD file, 2026-05-30]
CAD/vacuum/valves manipulation/MPPRL35-300-H (0) v3.step
508.1 x 70.0 x 70.0 mm
MPPLR-H-35-BASE (300) (0)
MPPRL-CF35-H_flange
MPPLR-H-35-BASE-THIMBLE (300) (0)
MPPRL (35)(300)_shaft
