peterfelfer/Oxcart/CAD/3d-print/3D-Print Oxcart/Curtain Clamps v2.step

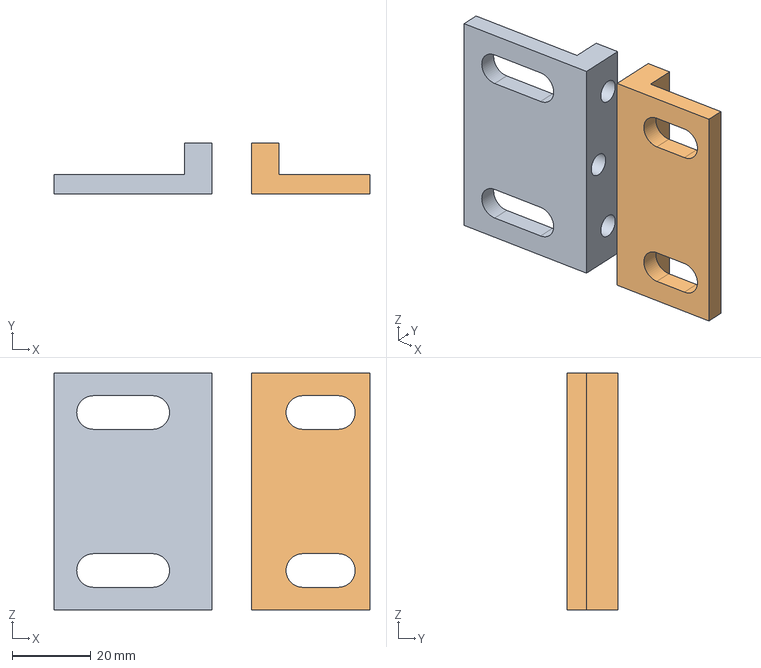
[picture p131: CAD file, 2026-05-30]
CAD/3d-print/3D-Print Oxcart/Curtain Clamps v2.step
80.0 x 13.0 x 60.0 mm
