peterfelfer/Oxcart/CAD/cryo/cryo heads/RDK-305E2_XRD47Z0971AQ v1.step

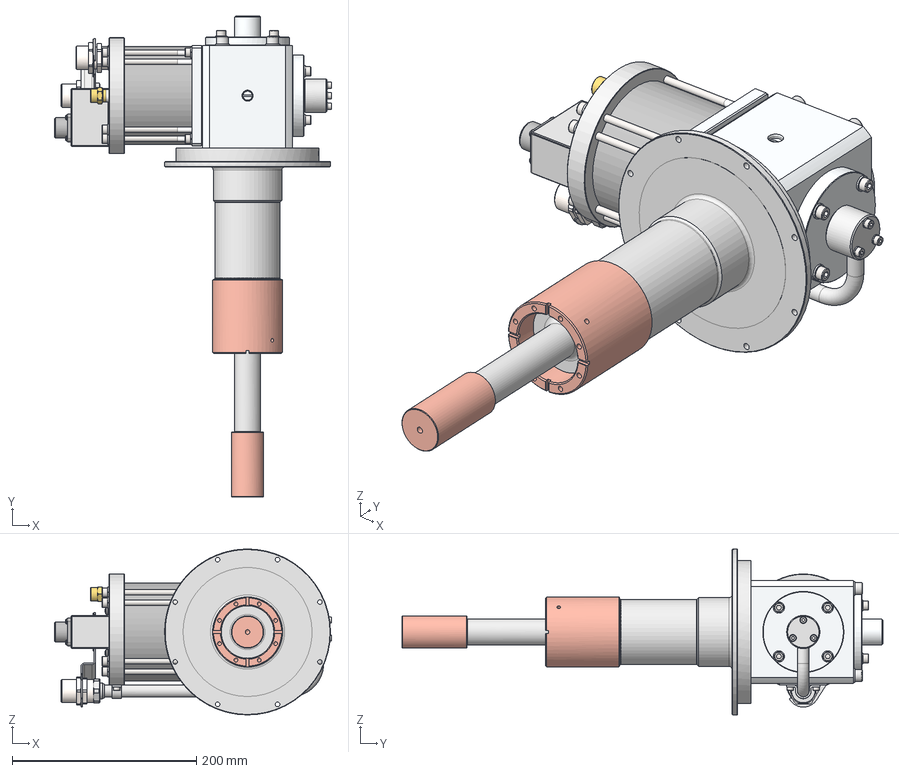
[picture p132: CAD file, 2026-05-30]
CAD/cryo/cryo heads/RDK-305E2_XRD47Z0971AQ v1.step
301.0 x 522.0 x 180.0 mm
