peterfelfer/Oxcart/CAD/cryo/cryo system MC/CAM/CY7 diode clamp CAM v3.step

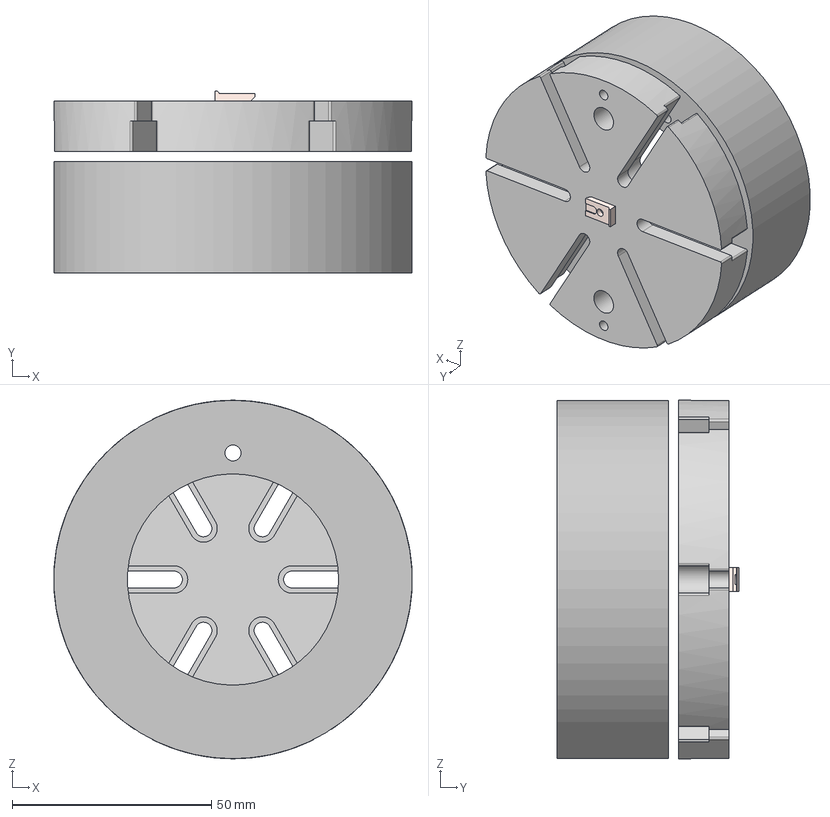
[picture p133: CAD file, 2026-05-30]
CAD/cryo/cryo system MC/CAM/CY7 diode clamp CAM v3.step
89.8 x 45.7 x 90.0 mm
V2PocketNC kinematic Bdisc v4
V2 removable table v1
CY7 diode clamp
