peterfelfer/Oxcart/CAD/cryo/cryo system MC/cryo interface v2 Drawing v6 Sheet6.dxf

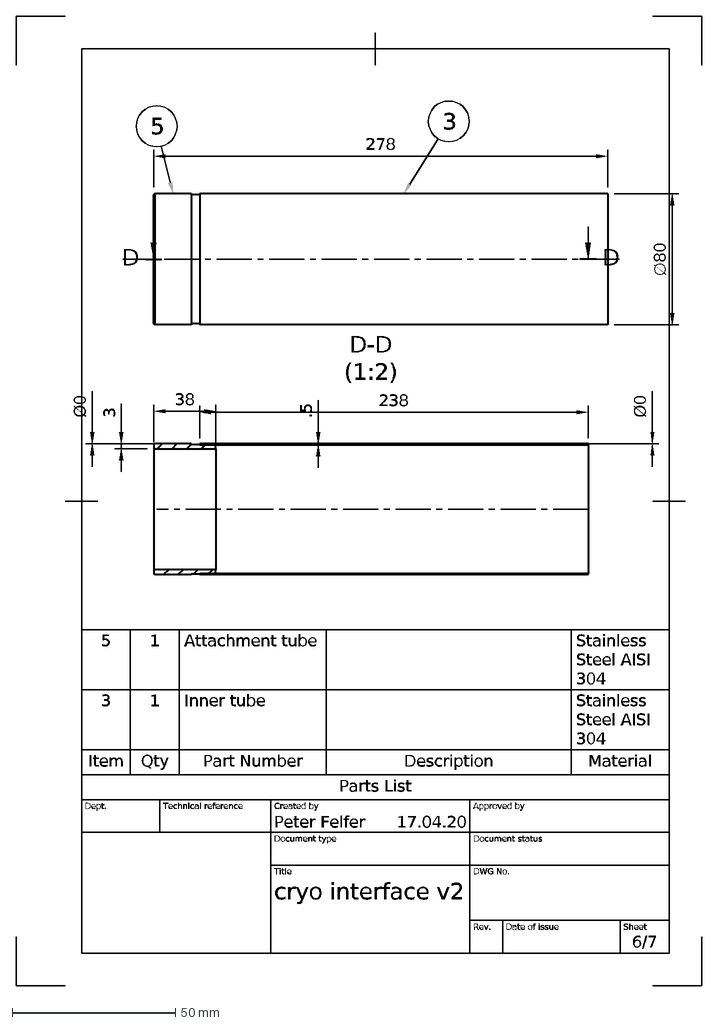
[picture p134: CAD file, 2026-05-30]
CAD/cryo/cryo system MC/cryo interface v2 Drawing v6 Sheet6.dxf
17.04.20
6/7
cryo interface v2
Peter Felfer
Dept.
Technical reference
Created by
Approved by
Document type
Document status
Title
DWG No.
Rev.
Date of issue
Sheet
278
∅80
D-D (1:2)
Parts List
Item
Qty
Part Number
Description
Material
3
1
Inner tube
Stainless Steel AISI 304
5
Attachment tube
Ø0
.5
238
38
D
