peterfelfer/Oxcart/CAD/detector/Hositrad_CF200-BT v3.step

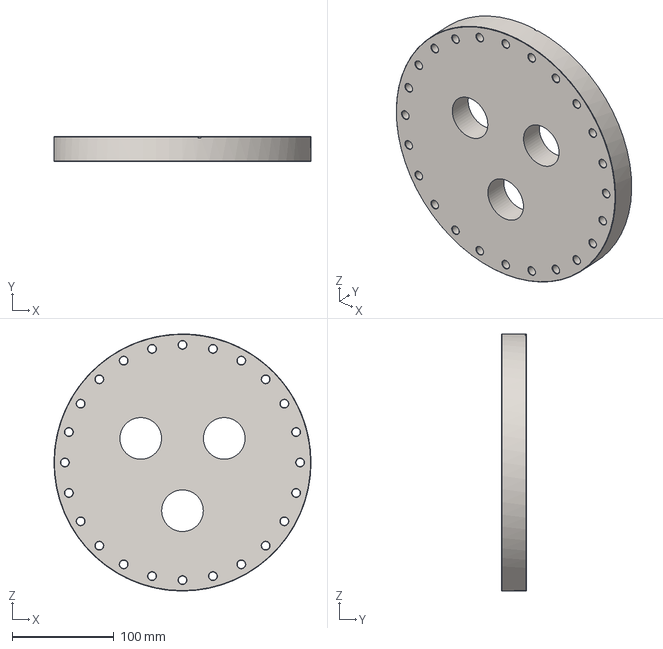
[picture p135: CAD file, 2026-05-30]
CAD/detector/Hositrad_CF200-BT v3.step
253.2 x 24.6 x 253.2 mm
