peterfelfer/Oxcart/CAD/frame/Frame components/PSY175-Step v1.step

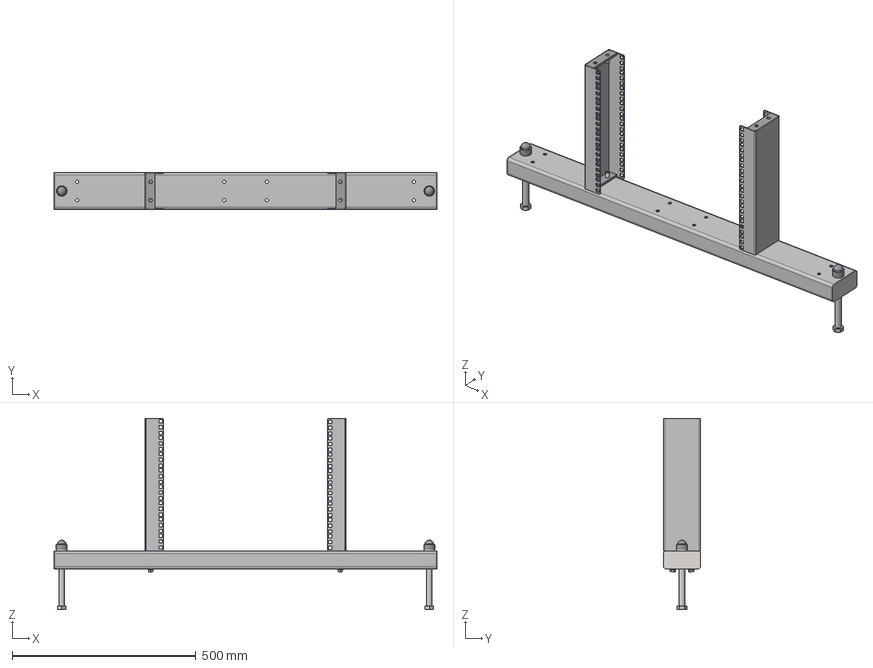
[picture p136: CAD file, 2026-05-30]
CAD/frame/Frame components/PSY175-Step v1.step
1042.0 x 100.0 x 520.0 mm
