peterfelfer/Oxcart/CAD/gas-thermal/baking equipment/baking lid right section Drawing v4 Sheet1.dxf

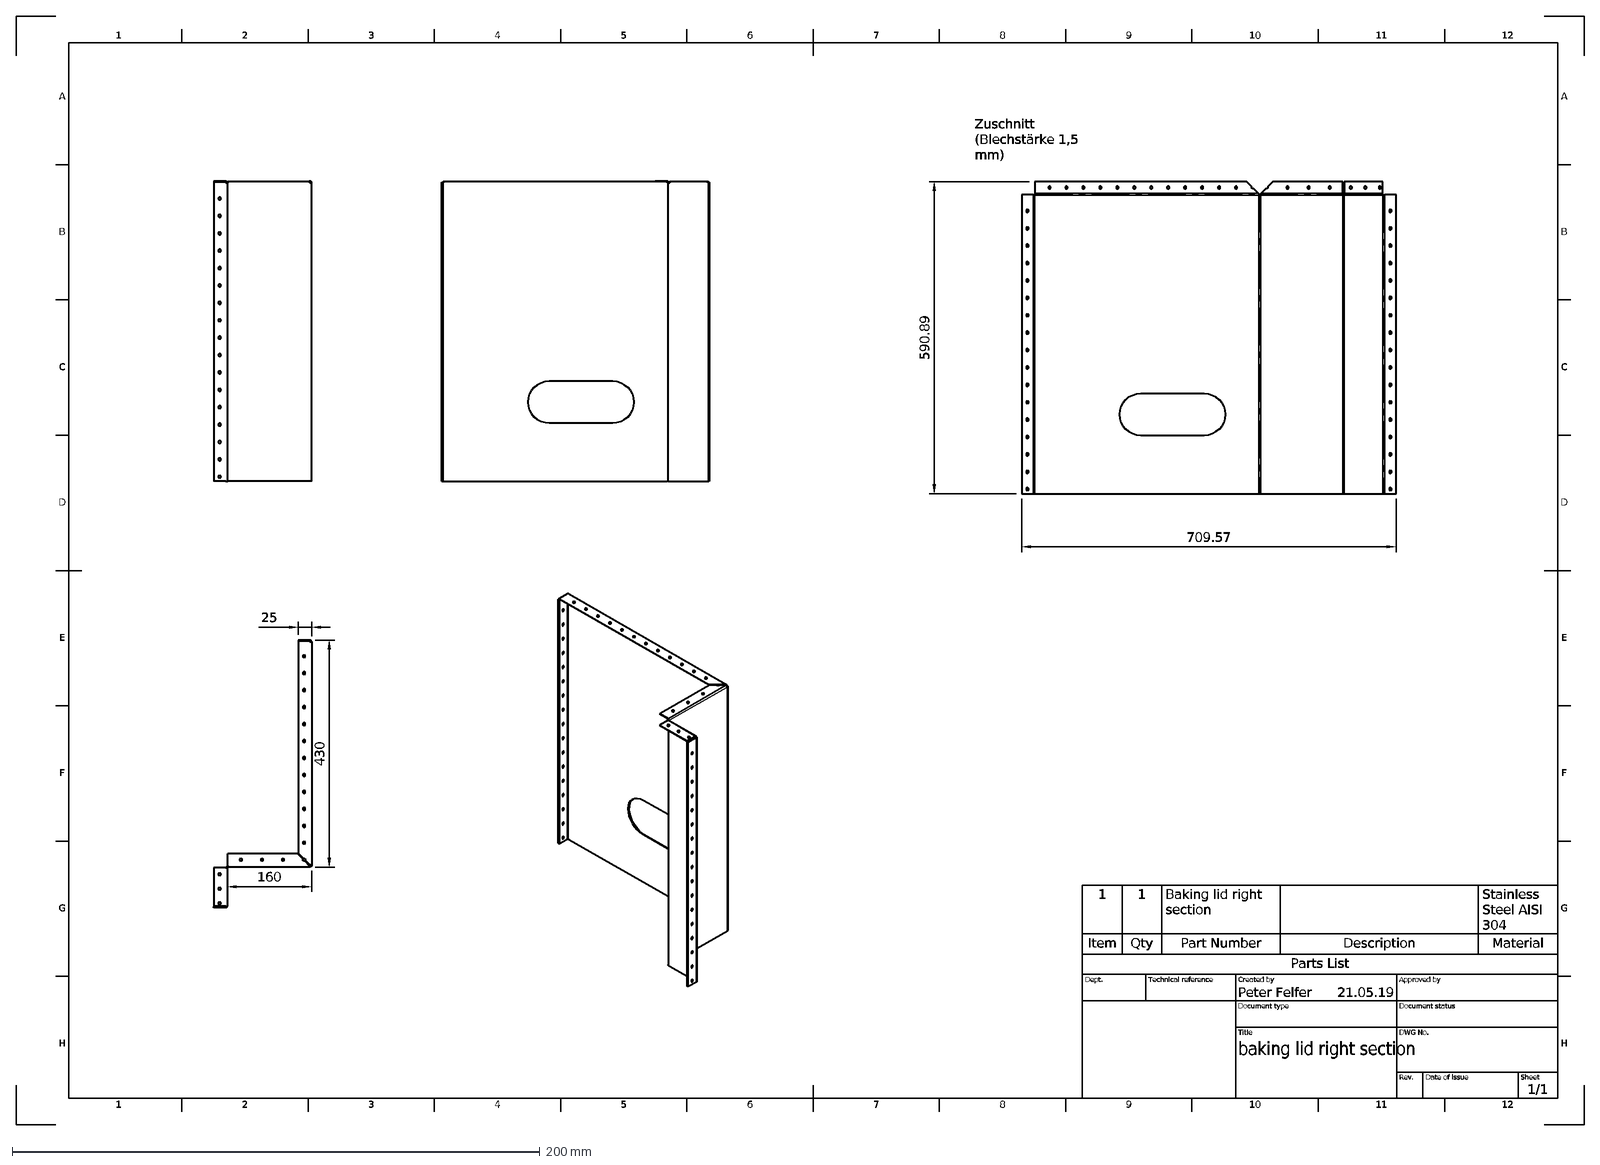
[picture p137: CAD file, 2026-05-30]
CAD/gas-thermal/baking equipment/baking lid right section Drawing v4 Sheet1.dxf
21.05.19
1/1
baking lid right section
Peter Felfer
Dept.
Technical reference
Created by
Approved by
Document type
Document status
Title
DWG No.
Rev.
Date of issue
Sheet
2
1
3
4
5
6
7
8
9
10
11
12
B
A
C
D
E
F
G
H
Zuschnitt (Blechstärke 1,5 mm)
590.89
709.57
430
25
160
Parts List
Item
Qty
Part Number
Description
Material
Baking lid right section
Stainless Steel AISI 304
