peterfelfer/Oxcart/CAD/gas-thermal/gas charging devices/deuterium pump/deuterium compression device Zeichnung Schraubplatte Rohr v2 Plan1.dxf

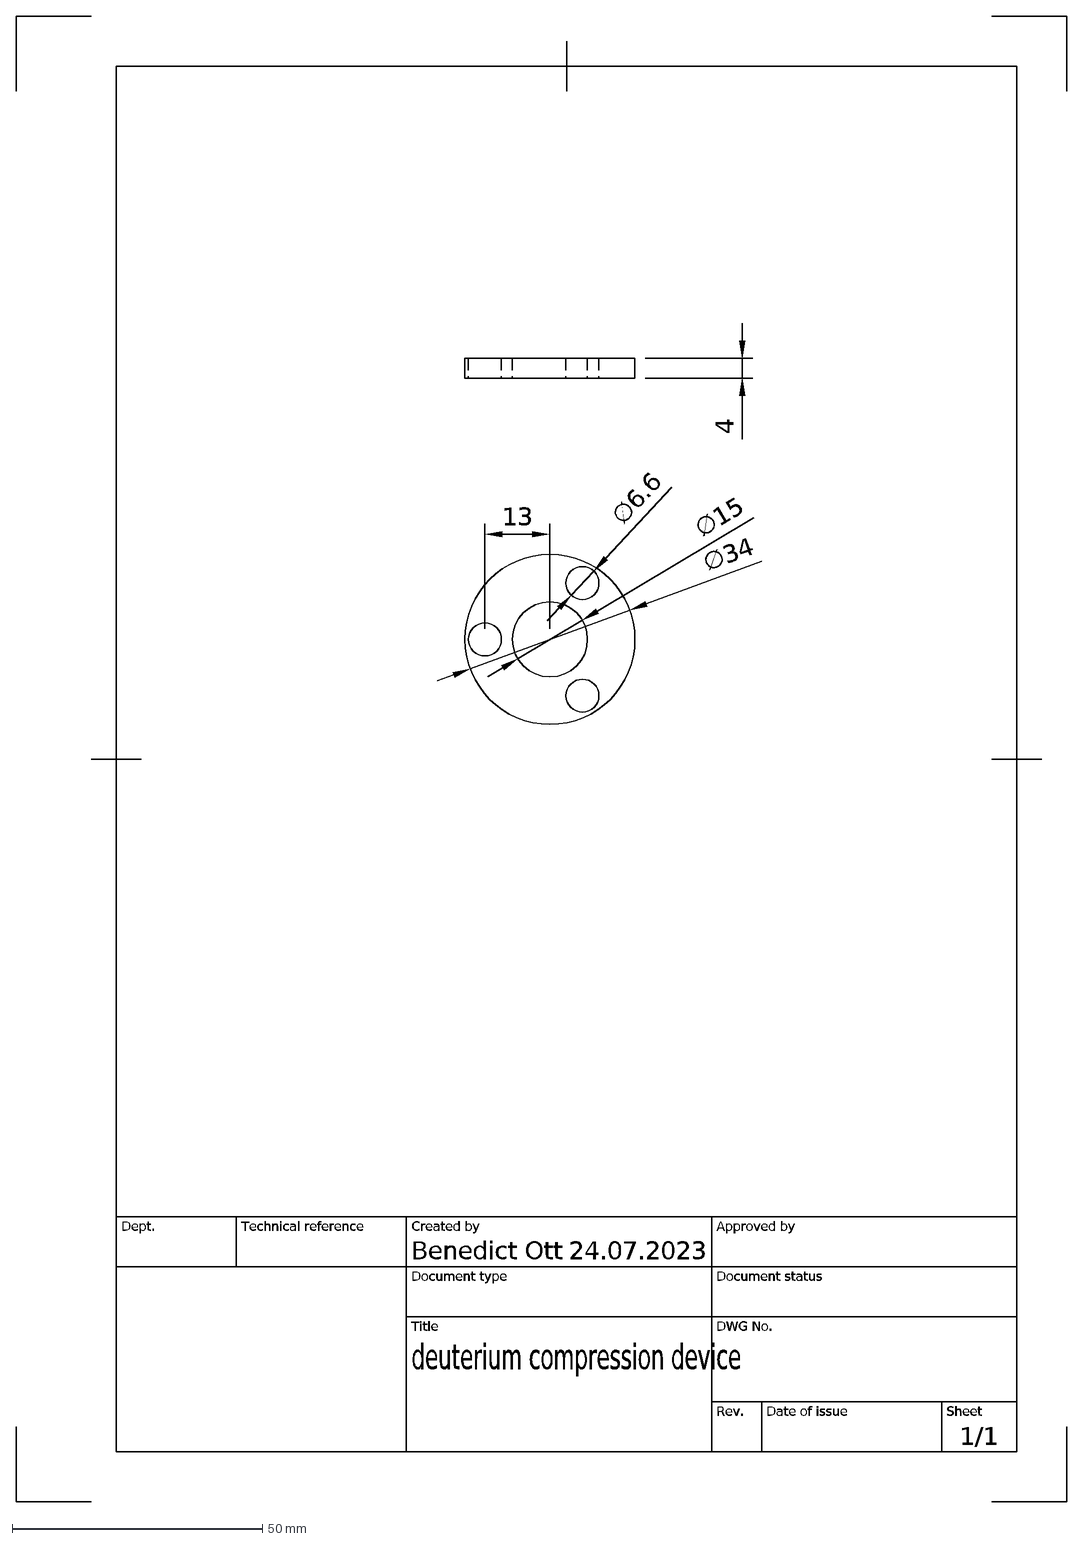
[picture p138: CAD file, 2026-05-30]
CAD/gas-thermal/gas charging devices/deuterium pump/deuterium compression device Zeichnung Schraubplatte Rohr v2 Plan1.dxf
24.07.2023
1/1
deuterium compression device
Benedict Ott
Dept.
Technical reference
Created by
Approved by
Document type
Document status
Title
DWG No.
Rev.
Date of issue
Sheet
∅34
∅15
4
∅6.6
13
