peterfelfer/Oxcart/CAD/gas-thermal/gas charging devices/gasChargingBombHolder/gasChargingBombHolderSchnittbild v2.step

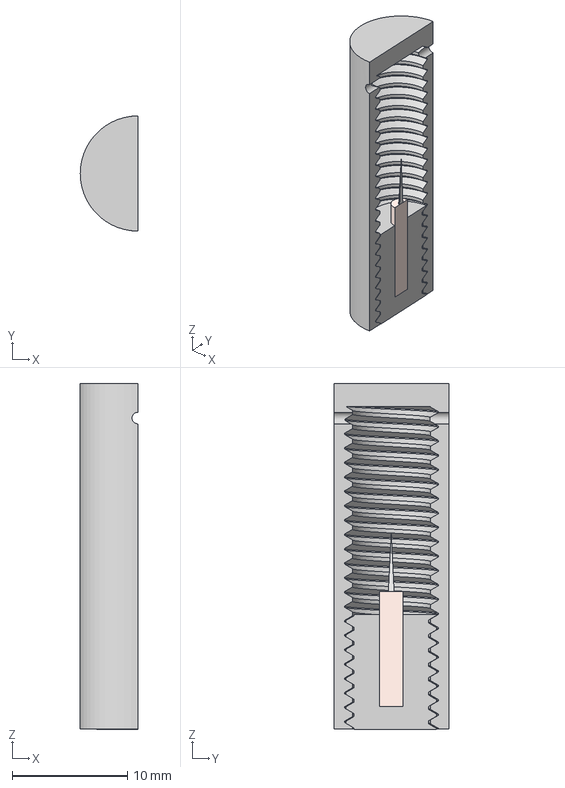
[picture p139: CAD file, 2026-05-30]
CAD/gas-thermal/gas charging devices/gasChargingBombHolder/gasChargingBombHolderSchnittbild v2.step
5.00 x 10.0 x 30.0 mm
SampleHolder
gasChargingBombLid v4
Tube
Sample
