peterfelfer/Oxcart/CAD/gas-thermal/gas charging devices/gasChargingCartridge/V2/gasChargingCartridgeV2 v17.step

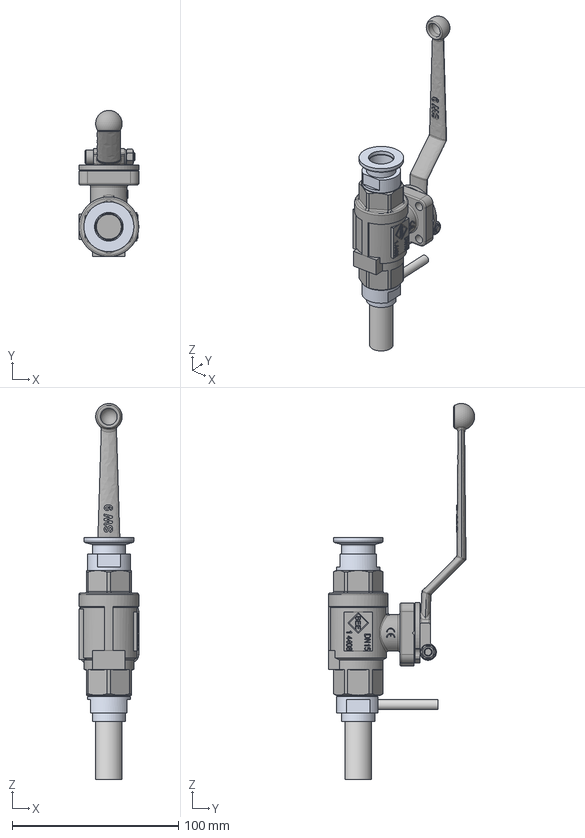
[picture p140: CAD file, 2026-05-30]
CAD/gas-thermal/gas charging devices/gasChargingCartridge/V2/gasChargingCartridgeV2 v17.step
36.3 x 88.0 x 226.1 mm
SwagelokTube_1
Komponente1
Komponente2
cryo nipple v2 v2 v1
W3ES16-1I2
