peterfelfer/Oxcart/CAD/gas-thermal/gas charging devices/gasChargingCube/Hositrad_CU16-Cube v2.step

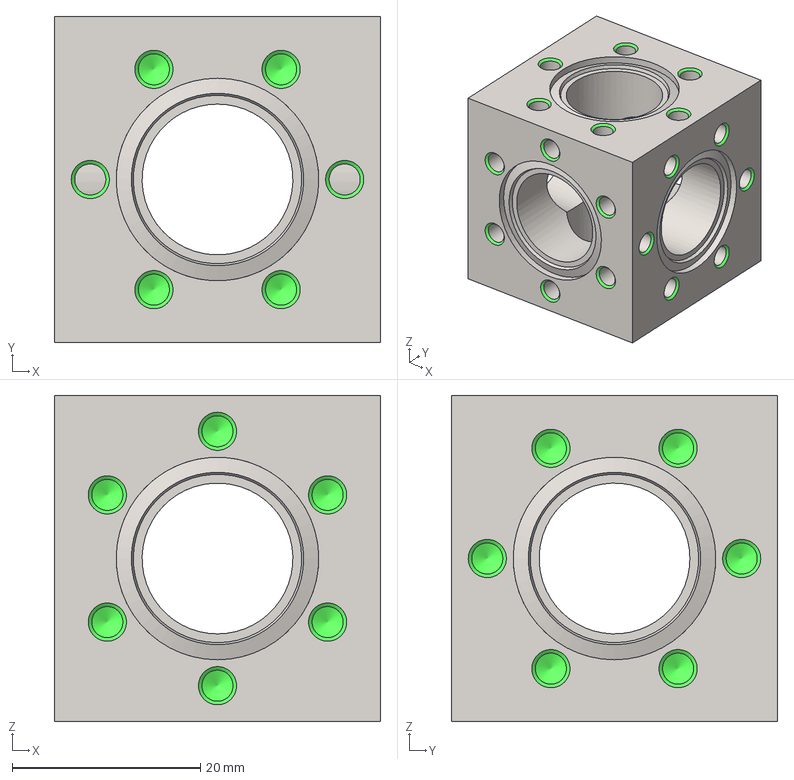
[picture p141: CAD file, 2026-05-30]
CAD/gas-thermal/gas charging devices/gasChargingCube/Hositrad_CU16-Cube v2.step
34.6 x 34.6 x 34.6 mm
