peterfelfer/Oxcart/CAD/gas-thermal/gas charging devices/gasChargingHandgrenade/SS-6M0-9-SwagelokCompany-3D-04-12-2023 v1.step

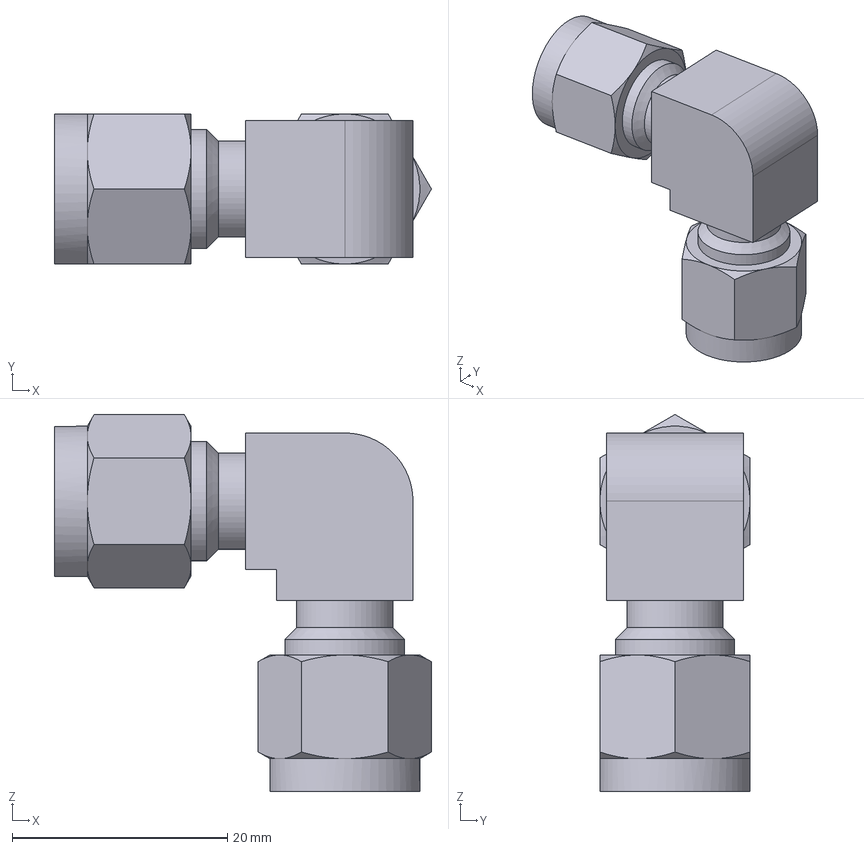
[picture p142: CAD file, 2026-05-30]
CAD/gas-thermal/gas charging devices/gasChargingHandgrenade/SS-6M0-9-SwagelokCompany-3D-04-12-2023 v1.step
35.1 x 14.0 x 35.1 mm
