peterfelfer/Oxcart/(list of files, cad)

Other CAD files:
CAD/cryo/cryo heads/stress sim taper v14.step
CAD/cryo/cryo system BC/BC cryo interface 2 v9.step
CAD/vacuum/chambers/BC_FINAL Drawing v5 Sheet1.dxf
CAD/3d-print/3D-Print Oxcart/Anweisungen für die Foxcart v1.step
CAD/optics-laser/laser upgrade/Laser beam height adjustment optics v1.step
CAD/optics-laser/optics/CAM/B-table and Collet v1.step
CAD/sample-handling/sample stage - pucks/CAM/V2PocketNC kinematic Bdisc v4 v1-2.step
CAD/optics-laser/laser upgrade/Edmund Optics/step_37289 v1.step
CAD/optics-laser/optics/CAM/V2PocketNC kinematic Bdisc v4 v1.step
CAD/3d-print/3D-Print Oxcart/Anweisungen für die Foxcart v1.f3d
CAD/3d-print/3D-Print Oxcart/Curtain Clamps Side slide v4.f3d
CAD/3d-print/3D-Print Oxcart/Curtain Clamps Side slide v4.step
CAD/3d-print/3D-Print Oxcart/Curtain Clamps v2.f3d
CAD/3d-print/3D-Print Oxcart/Detector assembly Copy v4.f3d
CAD/3d-print/3D-Print Oxcart/Emergency switch mount v2.f3d
CAD/3d-print/3D-Print Oxcart/Flansch Endcap v2.f3z
CAD/3d-print/3D-Print Oxcart/Flansch Endcap v3.step
CAD/3d-print/3D-Print Oxcart/Mirror Mount- New Version v3.f3d
CAD/3d-print/3D-Print Oxcart/Mirror Mount- New Version v3.step
CAD/3d-print/3D-Print Oxcart/Mirror mount temporary v15.f3z
CAD/3d-print/3D-Print Oxcart/Mirror mount temporary v15.step
CAD/3d-print/3D-Print Oxcart/SVP-UV-36.5-40CF Kopieren v4.f3d
CAD/3d-print/3D-Print Oxcart/SVP-UV-36.5-40CF Kopieren v4.step
CAD/3d-print/3D-Print Oxcart/Vesa 100 x 100 Alu Profil 40x40 mount v2.f3d
CAD/3d-print/3D-Print Oxcart/Vesa 100 x 100 Alu Profil 40x40 mount v2.step
CAD/assemblies/BC3 assembly v87.f3z
CAD/assemblies/LL assembly v43.f3z
CAD/assemblies/MC Laser assembly v4.f3z
CAD/assemblies/MC Lid assembly laser v9.f3z
CAD/assemblies/MC lid assembly v121.f3z
CAD/cryo/cryo LL/CryoLL v7.f3z
CAD/cryo/cryo LL/CryoLLMainPart v2.f3z
CAD/cryo/cryo LL/Hositrad_CF16-19-XT v1.f3d
CAD/cryo/cryo LL/Hositrad_CF16-19-XT v1.step
CAD/cryo/cryo LL/Hositrad_CFA16-KF16 v1.f3d
CAD/cryo/cryo LL/Hositrad_CFA16-KF16 v1.step
CAD/cryo/cryo LL/Hositrad_CFA35-16D v1.f3d
CAD/cryo/cryo LL/Hositrad_CFA35-16D v1.step
CAD/cryo/cryo LL/Hositrad_CFA35-16L v1.f3d
CAD/cryo/cryo LL/Hositrad_CFA63-38D v1.f3d
CAD/cryo/cryo LL/Hositrad_CFA63-38D v1.step
CAD/cryo/cryo LL/Hositrad_FE35-43R-Elbow v1.f3d
CAD/cryo/cryo LL/Hositrad_FE35-43R-Elbow v1.step
CAD/cryo/cryo LL/KF16Flange v1.f3d
CAD/cryo/cryo LL/VAb_DCF 40-2 v1.f3d
CAD/cryo/cryo LL/VAb_DCF 40-2 v1.step
CAD/cryo/cryo heads/0-12 COLDHEAD ASSEMBLY v3.f3d
CAD/cryo/cryo heads/1.5W 4K v2.f3d
CAD/cryo/cryo heads/1.5W 4K v2.step
CAD/cryo/cryo heads/2-9 COLDHEAD ASSEMBLY v4.f3d
CAD/cryo/cryo heads/Cryo assembly v18.f3z
CAD/cryo/cryo heads/Cryo interface v3.f3d
CAD/cryo/cryo heads/Cryo interface v3.step
CAD/cryo/cryo heads/KDE415SA 3D Model v4.f3d
CAD/cryo/cryo heads/RDK-305E2_XRD47Z0971AQ v1.f3d
CAD/cryo/cryo heads/cold_head_assy_ch204sb_267628d2 v1.f3d
CAD/cryo/cryo heads/coldhead CF adapter v3.f3d
CAD/cryo/cryo heads/coldhead CF adapter v3.step
CAD/cryo/cryo heads/stress sim taper v14.f3d
CAD/cryo/cryo system BC/BC cryo head assembly v7.f3z
CAD/cryo/cryo system BC/BC cryo interface 2 v9.f3d
CAD/cryo/cryo system BC/BC cryo interface v8.f3d
CAD/cryo/cryo system BC/BC cryo interface v8.step
CAD/cryo/cryo system BC/coupling assembly v2.f3z
CAD/cryo/cryo system BC/coupling bottom plate v3.f3d
CAD/cryo/cryo system BC/coupling bottom plate v3.step
CAD/cryo/cryo system BC/coupling plate v1.f3d
CAD/cryo/cryo system BC/cryo head flange v5.f3d
CAD/cryo/cryo system MC/CAM/B-Table and Sacrificial Plate v1.f3z
CAD/cryo/cryo system MC/CAM/B-Table and Sacrificial Plate v1.step
CAD/cryo/cryo system MC/CAM/B-table and Collet v2.f3z
CAD/cryo/cryo system MC/CAM/CY7 diode clamp CAM v2.f3z
CAD/cryo/cryo system MC/CAM/Collet Bottom Taper v1.f3d
CAD/cryo/cryo system MC/CAM/Collet Bottom Taper v1.step
CAD/cryo/cryo system MC/CAM/Collet Top Taper v1.f3d
CAD/cryo/cryo system MC/CAM/V2 removable table v1 v1.f3d
CAD/cryo/cryo system MC/CAM/V2PocketNC kinematic Bdisc v4 v1-1.f3d
CAD/cryo/cryo system MC/CAM/V2PocketNC kinematic Bdisc v4 v1-1.step
CAD/cryo/cryo system MC/CAM/counterheater element CAM v4.f3z
CAD/cryo/cryo system MC/CAM/counterheater element CAM v5.step
CAD/cryo/cryo system MC/CAM/heater plug CAM v4.f3z
CAD/cryo/cryo system MC/CAM/heater plug CAM v4.step
CAD/cryo/cryo system MC/CAM/heater plug shim CAM v4.f3z
CAD/cryo/cryo system MC/CAM/m2 washers vespel CAM v2.f3z
CAD/cryo/cryo system MC/CAM/m2 washers vespel CAM v2.step
CAD/cryo/cryo system MC/CAM/silver contact pieces CAM v3.f3z
CAD/cryo/cryo system MC/CAM/silver contact pieces CAM v3.step
CAD/cryo/cryo system MC/CY7 diode clamp Drawing v2 Sheet1.dxf
CAD/cryo/cryo system MC/CY7 diode clamp v7.f3d
CAD/cryo/cryo system MC/CY7 diode clamp v7.step
CAD/cryo/cryo system MC/Cryo counterheater plate v1.f3d
CAD/cryo/cryo system MC/Cryo counterheater plate v1.step
CAD/cryo/cryo system MC/Cryo head connector Drawing v10 Sheet1.dxf
CAD/cryo/cryo system MC/Cryo head connector v22.f3z
CAD/cryo/cryo system MC/Cryo head connector v22.step
CAD/cryo/cryo system MC/Iso K 160 extension tube v2.f3z
CAD/cryo/cryo system MC/Iso K 160 extension tube v2.step
CAD/cryo/cryo system MC/M2 washer vespel v1.f3d
CAD/cryo/cryo system MC/M2 washer vespel v1.step
CAD/cryo/cryo system MC/Metallicflex/Federkörper v8.f3d
CAD/cryo/cryo system MC/O ring 145 x 4 v2.f3d
CAD/cryo/cryo system MC/O ring 145 x 4 v2.step
CAD/cryo/cryo system MC/butted insulation tube Drawing v1 Sheet1.dxf
CAD/cryo/cryo system MC/butted insulation tube v2.f3d
CAD/cryo/cryo system MC/butted insulation tube v2.step
CAD/cryo/cryo system MC/chc4x35pf8z v1.f3d
CAD/cryo/cryo system MC/chc4x35pf8z v1.step
CAD/cryo/cryo system MC/clamp Drawing v4 Sheet1.dxf
CAD/cryo/cryo system MC/contact part v2.f3d
CAD/cryo/cryo system MC/contact part v2.step
CAD/cryo/cryo system MC/counterheater v2.f3d
CAD/cryo/cryo system MC/counterheater v2.step
CAD/cryo/cryo system MC/cryo boom 2 Drawing v2 Sheet1.dxf
CAD/cryo/cryo system MC/cryo boom 2 v16.f3z
CAD/cryo/cryo system MC/cryo boom 2 v16.step
CAD/cryo/cryo system MC/cryo boom Drawing v1 Sheet1.dxf
CAD/cryo/cryo system MC/cryo boom console Drawing v2 Sheet1.dxf
CAD/cryo/cryo system MC/cryo boom console v8.f3d
CAD/cryo/cryo system MC/cryo boom console v8.step
CAD/cryo/cryo system MC/cryo boom v15.f3z
CAD/cryo/cryo system MC/cryo boom v15.step
CAD/cryo/cryo system MC/cryo clamp lower v4.f3d
CAD/cryo/cryo system MC/cryo clamp lower v4.step
CAD/cryo/cryo system MC/cryo clamp upper Drawing v2 Sheet1.dxf
CAD/cryo/cryo system MC/cryo clamp upper v8.f3d
CAD/cryo/cryo system MC/cryo clamp upper v8.step
CAD/cryo/cryo system MC/cryo contact clamp Drawing v1 Sheet1.dxf
CAD/cryo/cryo system MC/cryo contact clamp v3.f3d
CAD/cryo/cryo system MC/cryo contact clamp v3.step
CAD/cryo/cryo system MC/cryo head clamp Drawing v4 Sheet1.dxf
CAD/cryo/cryo system MC/cryo head clamp v8.f3d
CAD/cryo/cryo system MC/cryo head clamp v8.step
CAD/cryo/cryo system MC/cryo head diode and heater mount Drawing v1 Sheet1.dxf
CAD/cryo/cryo system MC/cryo head diode and heater mount v6.f3z
CAD/cryo/cryo system MC/cryo head diode and heater mount v6.step
CAD/cryo/cryo system MC/cryo interface assembly v28.f3z
CAD/cryo/cryo system MC/cryo interface final Drawing v4 Sheet1.dxf
CAD/cryo/cryo system MC/cryo interface final v24.f3d
CAD/cryo/cryo system MC/cryo interface final v24.step
CAD/cryo/cryo system MC/cryo interface v2 Drawing v6 Sheet1.dxf
CAD/cryo/cryo system MC/cryo interface v2 Drawing v6 Sheet2.dxf
CAD/cryo/cryo system MC/cryo interface v2 Drawing v6 Sheet3.dxf
CAD/cryo/cryo system MC/cryo interface v2 Drawing v6 Sheet4.dxf
CAD/cryo/cryo system MC/cryo interface v2 Drawing v6 Sheet5.dxf
CAD/cryo/cryo system MC/cryo interface v2 Drawing v6 Sheet7.dxf
CAD/cryo/cryo system MC/cryo interface v2 v25.f3z
CAD/cryo/cryo system MC/cryo interface v2 v26.step
CAD/cryo/cryo system MC/cryo interface v2 weld Drawing v3 Sheet1.dxf
CAD/cryo/cryo system MC/cryo interface v3 Drawing v20 Sheet1.dxf
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
