peterfelfer/Oxcart/CAD/machining/MC NEG laser space requirements v1.pdf

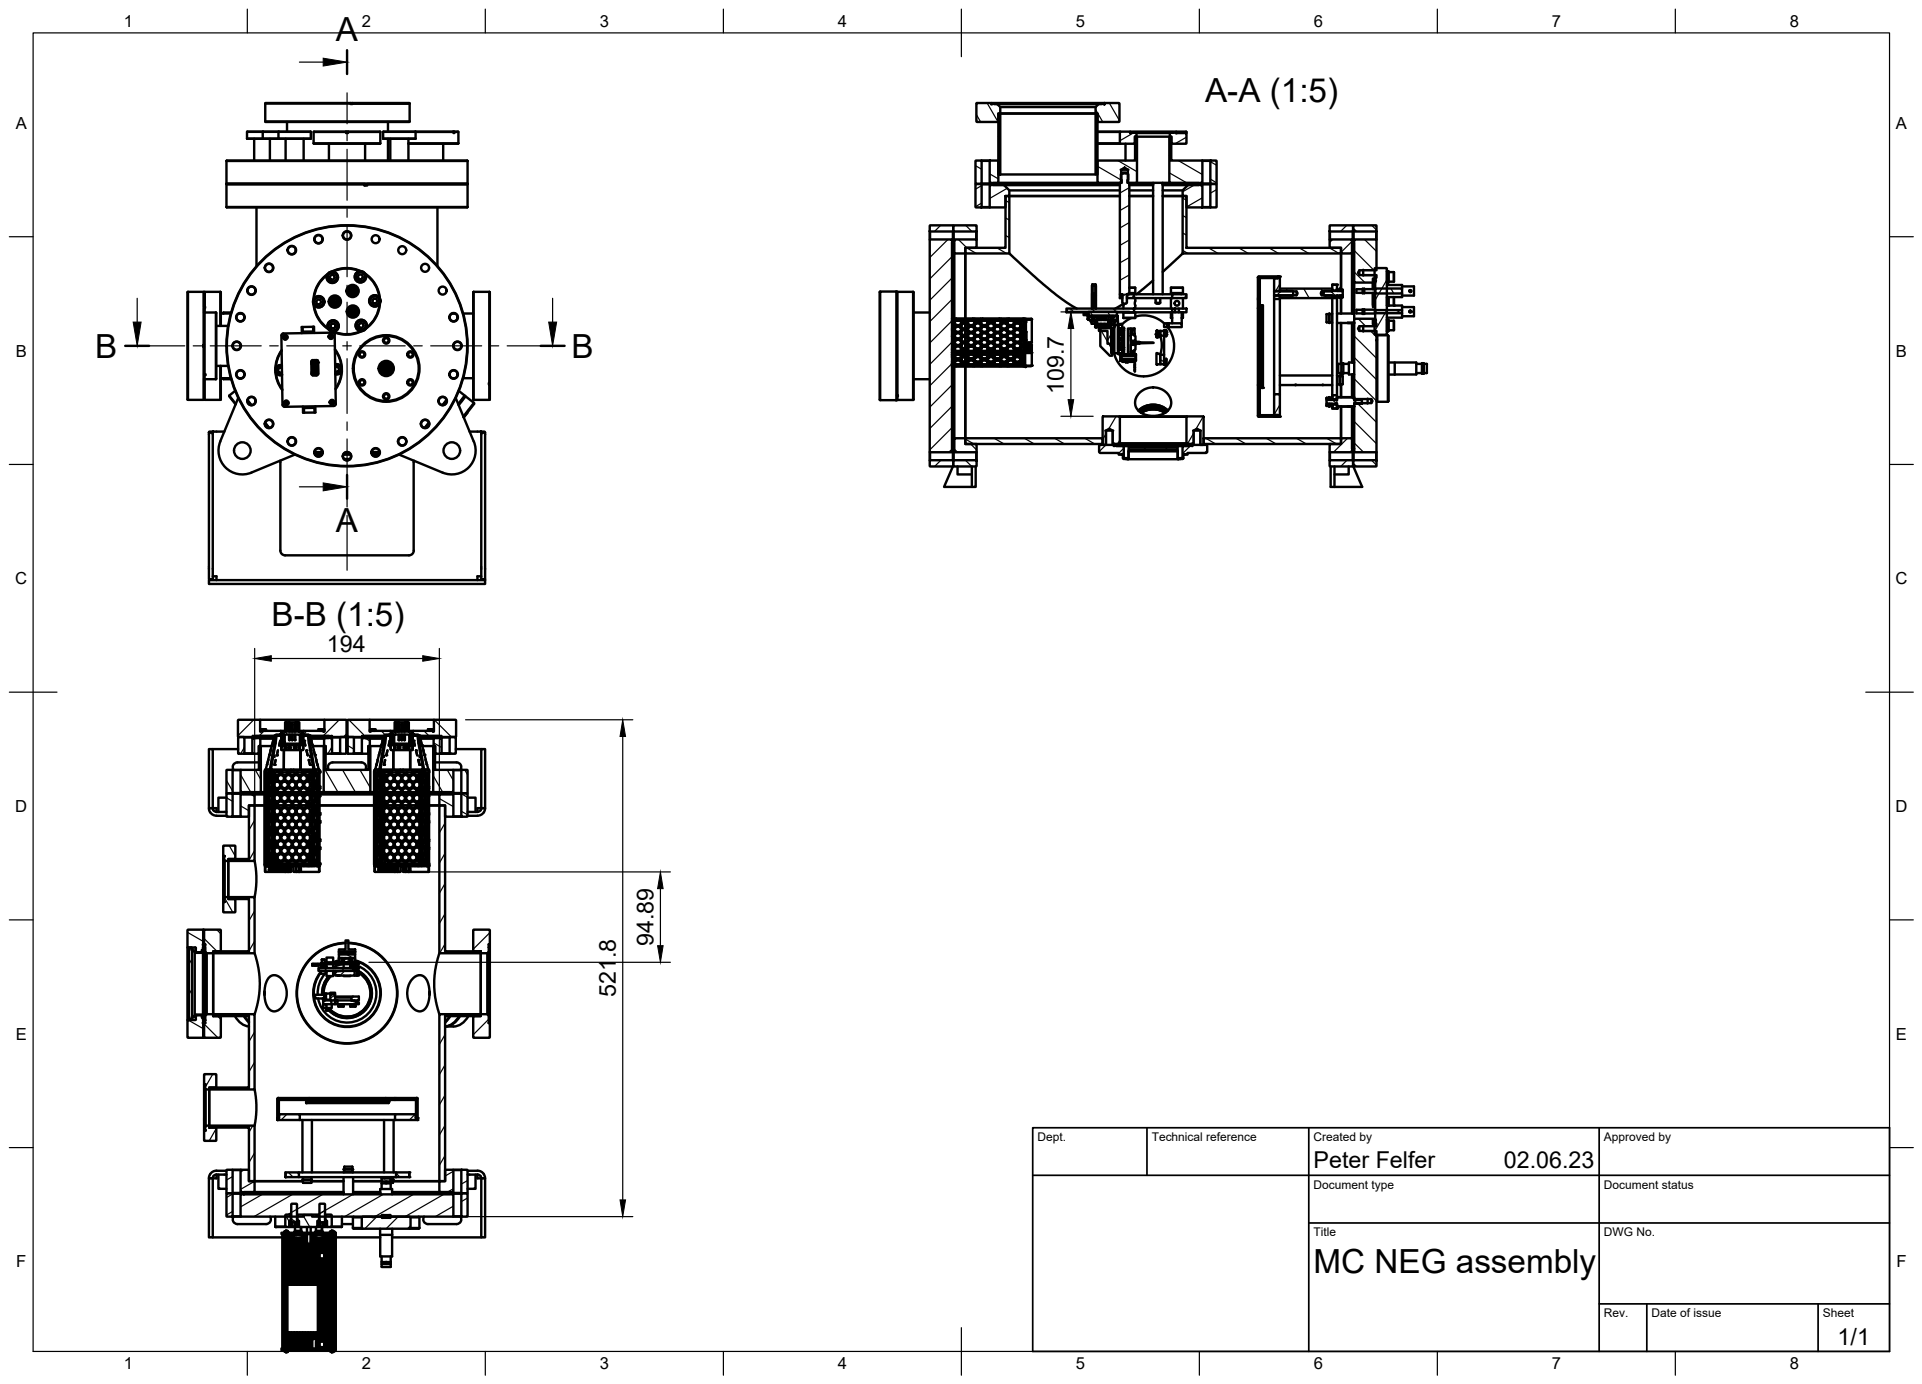
[picture p143: page 1]
Dept.; Technical reference; Created by; Approved by; Document type; Document status; Title; DWG No.; Rev.; Date of issue; Sheet; Peter Felfer

MC NEG assembly
