peterfelfer/Oxcart/CAD/gas-thermal/baking equipment/baking lid assembly Drawing v3.pdf

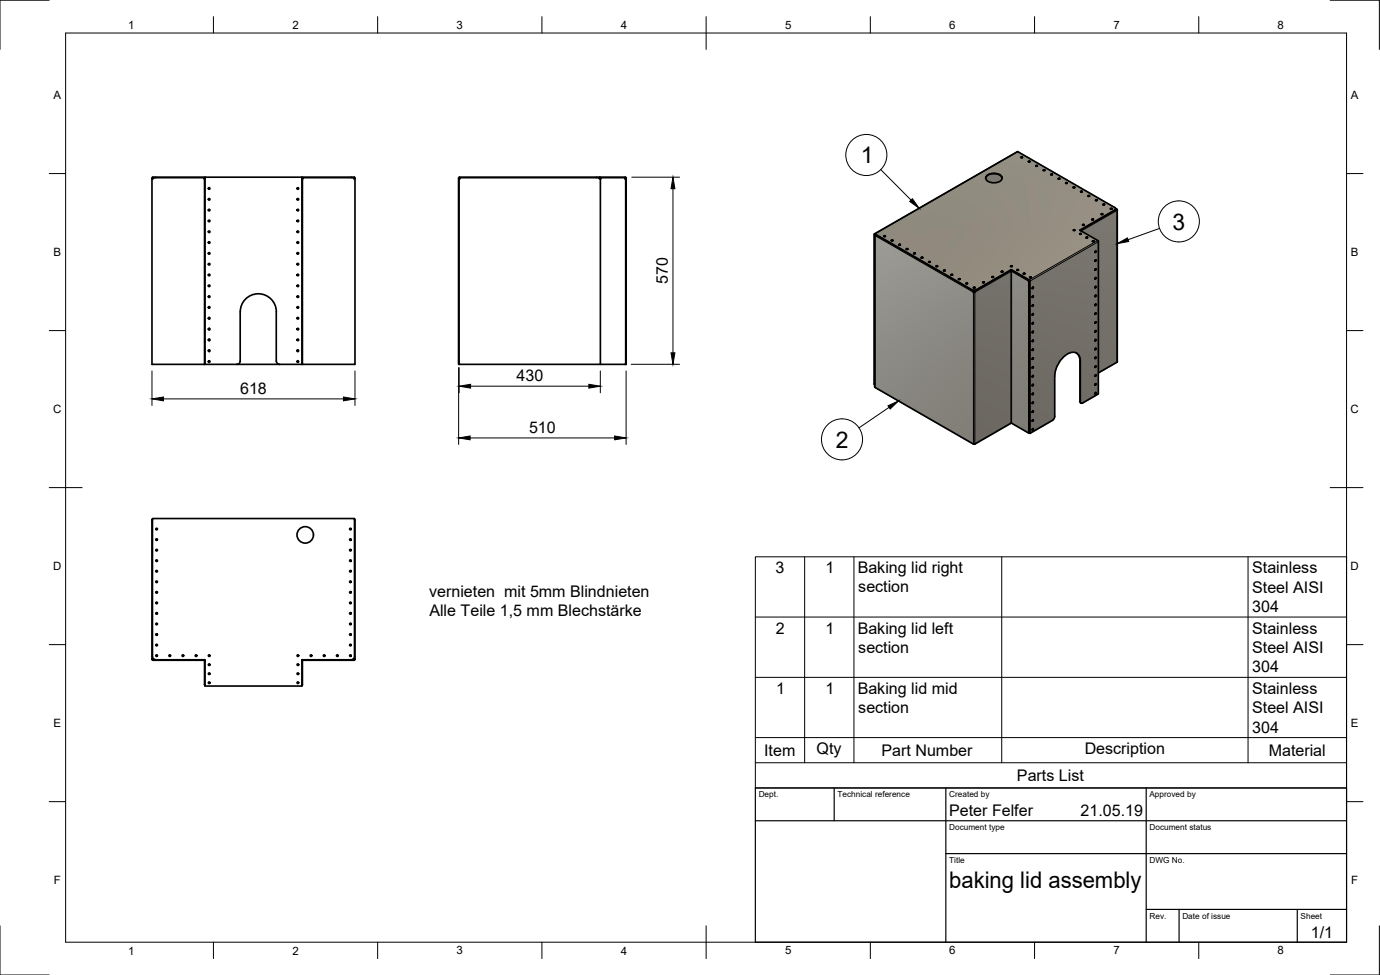
[picture p144: page 1]
Parts List

3 | 1 | Baking lid right section | | Stainless Steel AISI 304

vernieten mit 5mm Blindnieten
Alle Teile 1,5 mm Blechstärke

2 | 1 | Baking lid left section | | Stainless Steel AISI 304

1 | 1 | Baking lid mid section | | Stainless Steel AISI 304

Item | Qty | Part Number | Description | Material

Dept. | Technical reference | Created by Peter Felfer 21.05.19 | Approved by

Document type | Document status

Title baking lid assembly | DWG No.

Rev. | Date of issue | Sheet 1/1
