peterfelfer/Oxcart/CAD/optics-laser/optics/bottom optics console Drawing v4.pdf

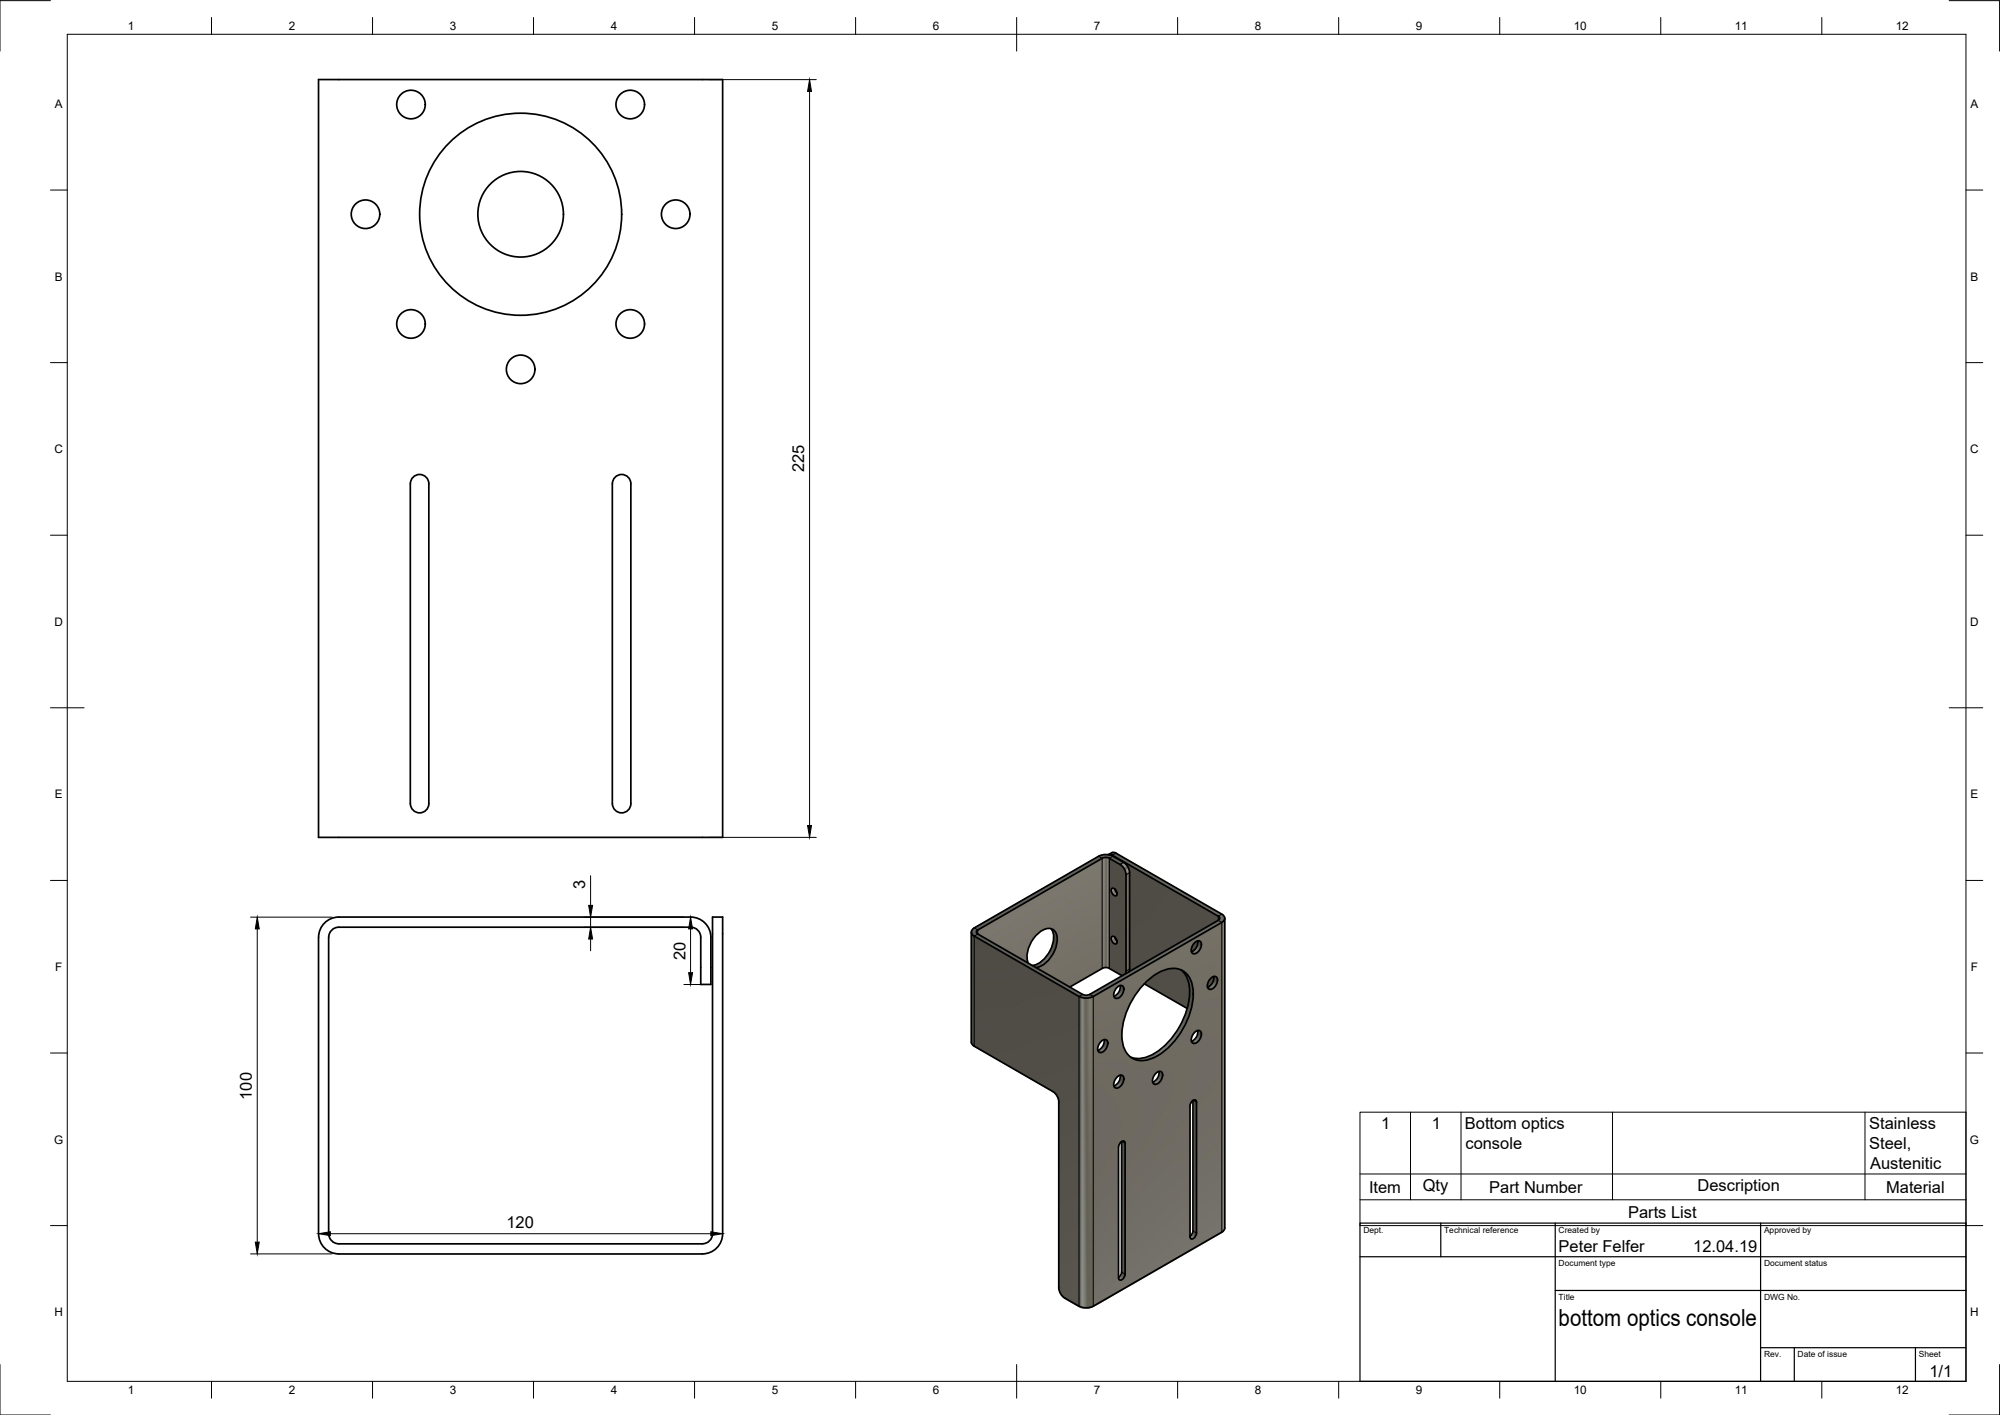
[picture p145: page 1]
Parts List; Austenitic 20

1 | 1 | Bottom optics console | | Stainless Steel,

Item | Qty | Part Number | Description | Material

Dept. | Technical reference | Created by Peter Felfer 12.04.19 | Approved by

Document type | Document status

Title bottom optics console | DWG No.

Rev. | Date of issue | Sheet 1/1
