peterfelfer/Oxcart/CAD/optics-laser/optics/upper positioning optics console Drawing v2.pdf

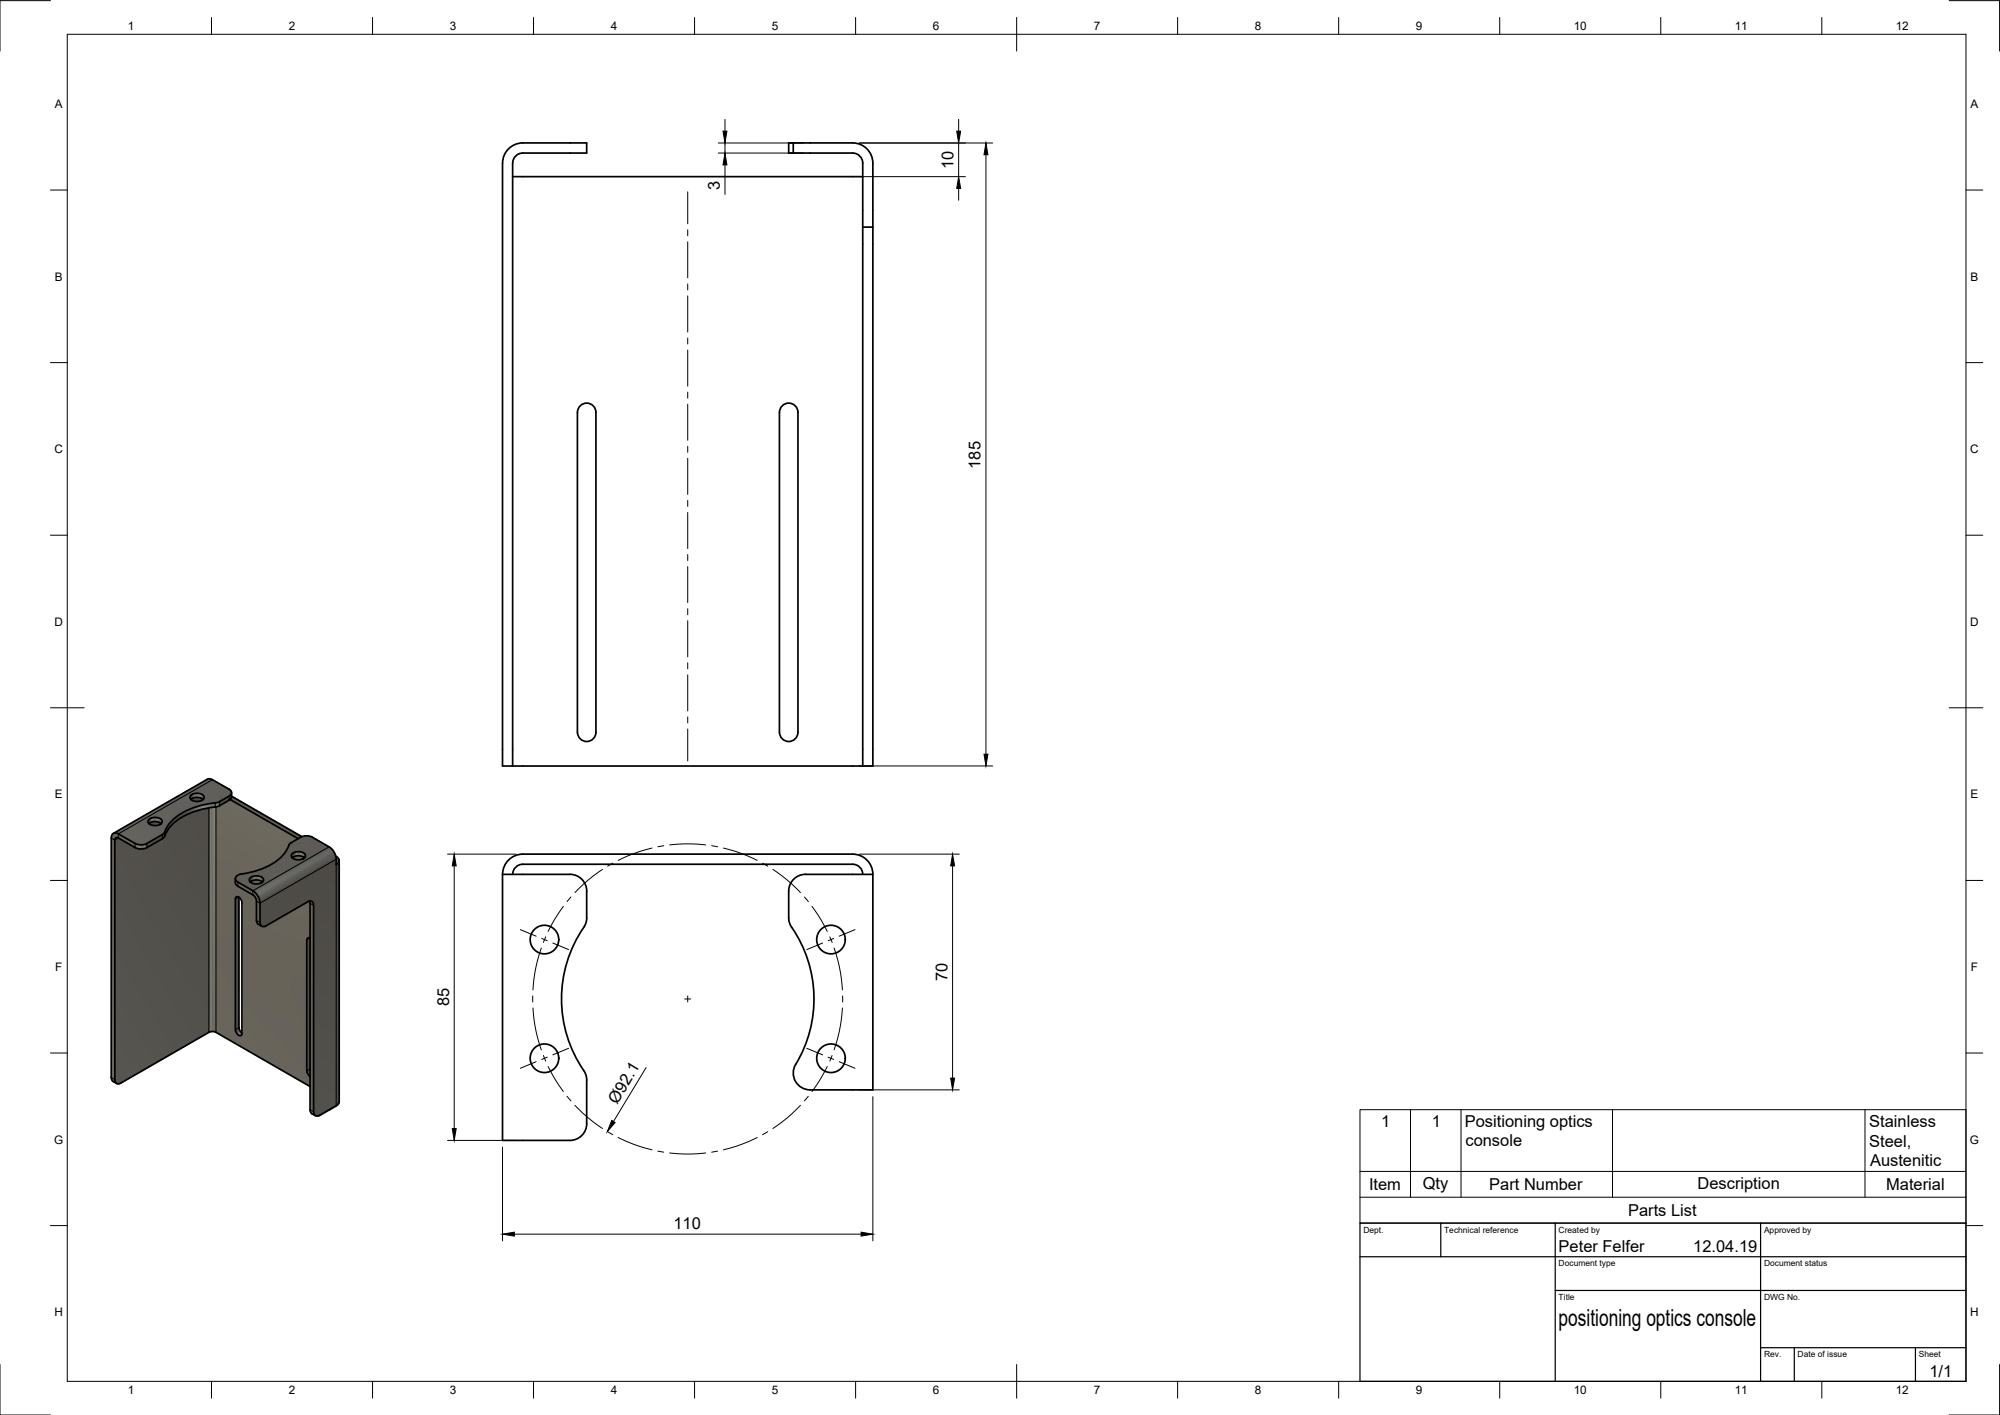
[picture p146: page 1]
Peter Felfer 10; Parts List

1 | 1 | Positioning optics console | | Stainless Steel, Austenitic

Item | Qty | Part Number | Description | Material

Dept. | Technical reference | Created by 12.04.19 | Approved by

Document type | Document status

Title positioning optics console | DWG No.

Rev. | Date of issue | Sheet 1/1
