peterfelfer/Oxcart/CAD/sample-handling/BC LL parts/BC Endeffector Drawing v9.pdf

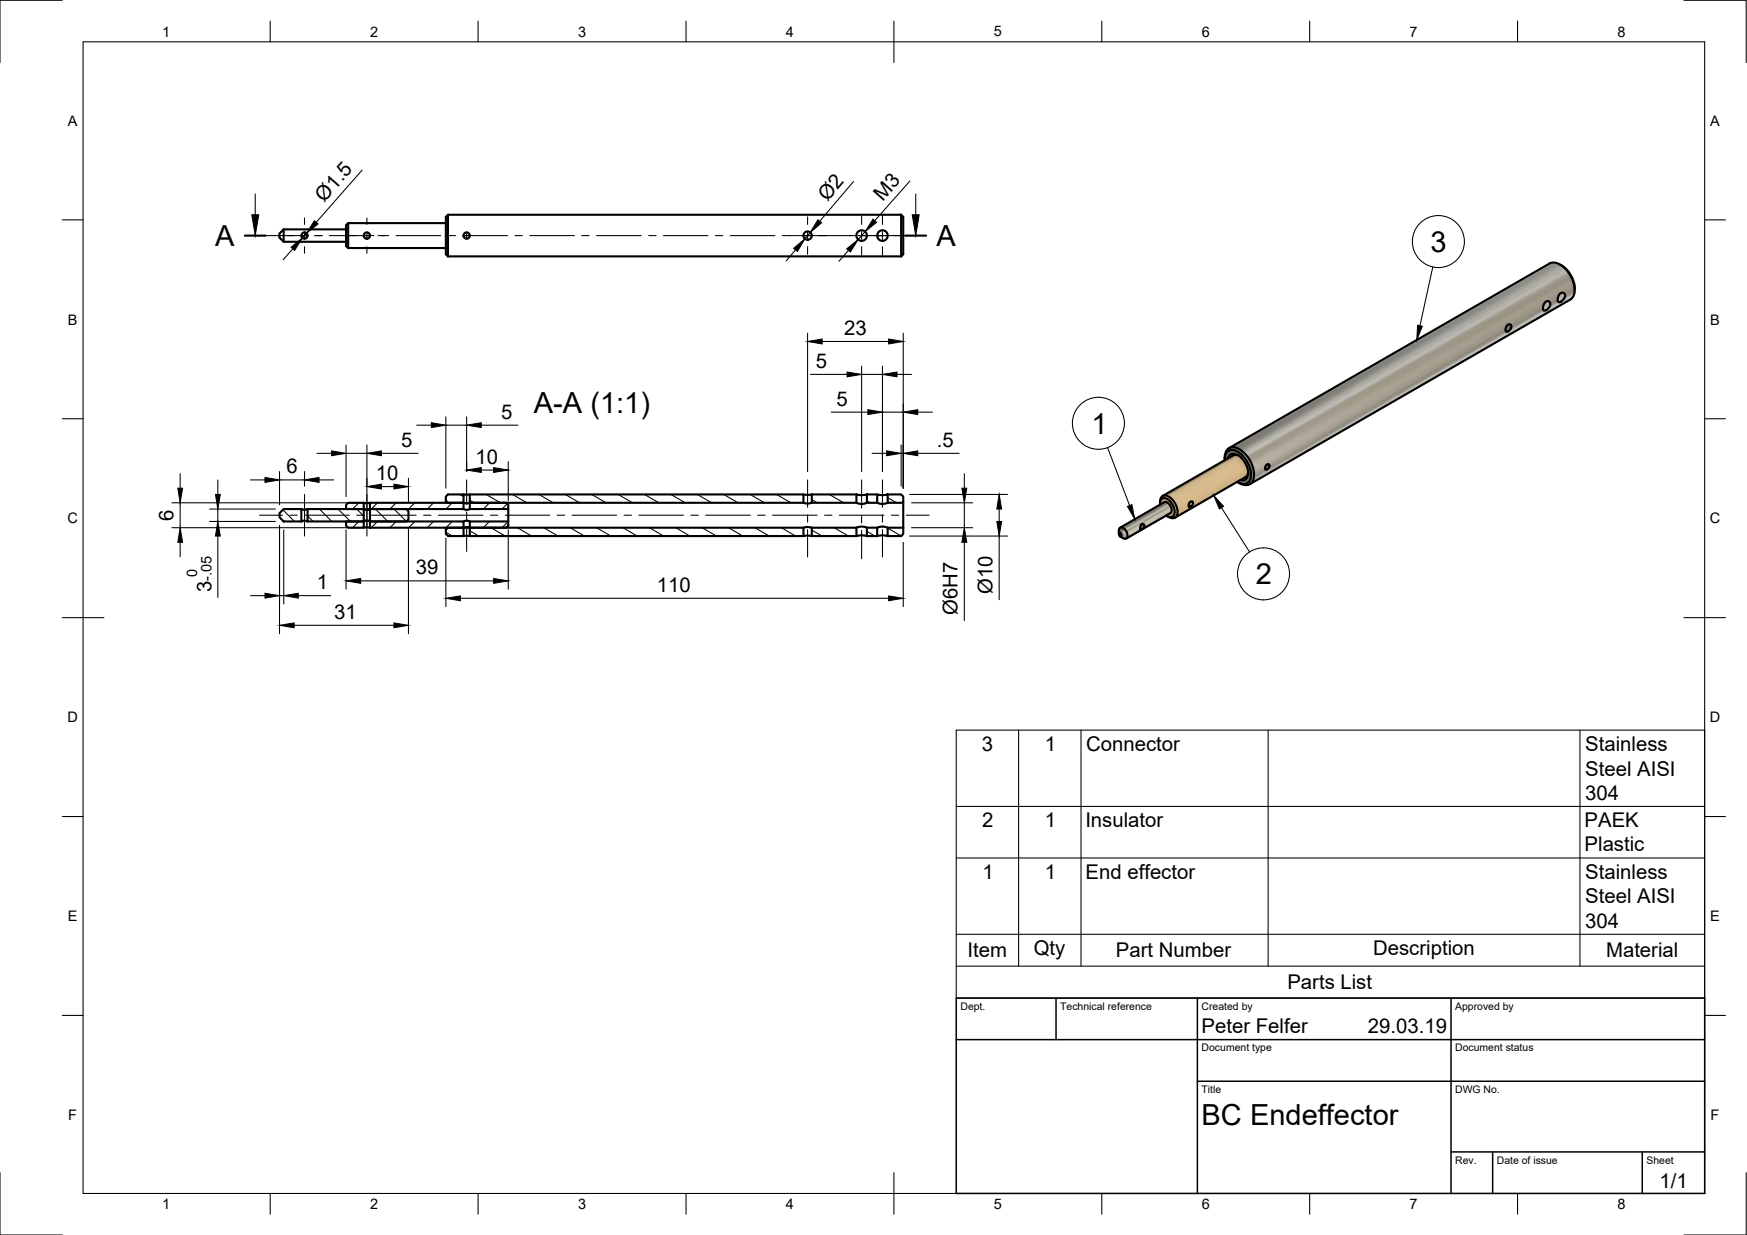
[picture p147: page 1]
Parts List

3 | 1 | Connector | | Stainless Steel AISI 304

2 | 1 | Insulator | | PAEK Plastic

1 | 1 | End effector | | Stainless Steel AISI 304

Item | Qty | Part Number | Description | Material

Dept. | Technical reference | Created by Peter Felfer 29.03.19 | Approved by

Document type | Document status

Title BC Endeffector | DWG No.

Rev. | Date of issue | Sheet 1/1
