peterfelfer/Oxcart/CAD/sample-handling/BC LL parts/BC vertical rod Drawing v2.pdf

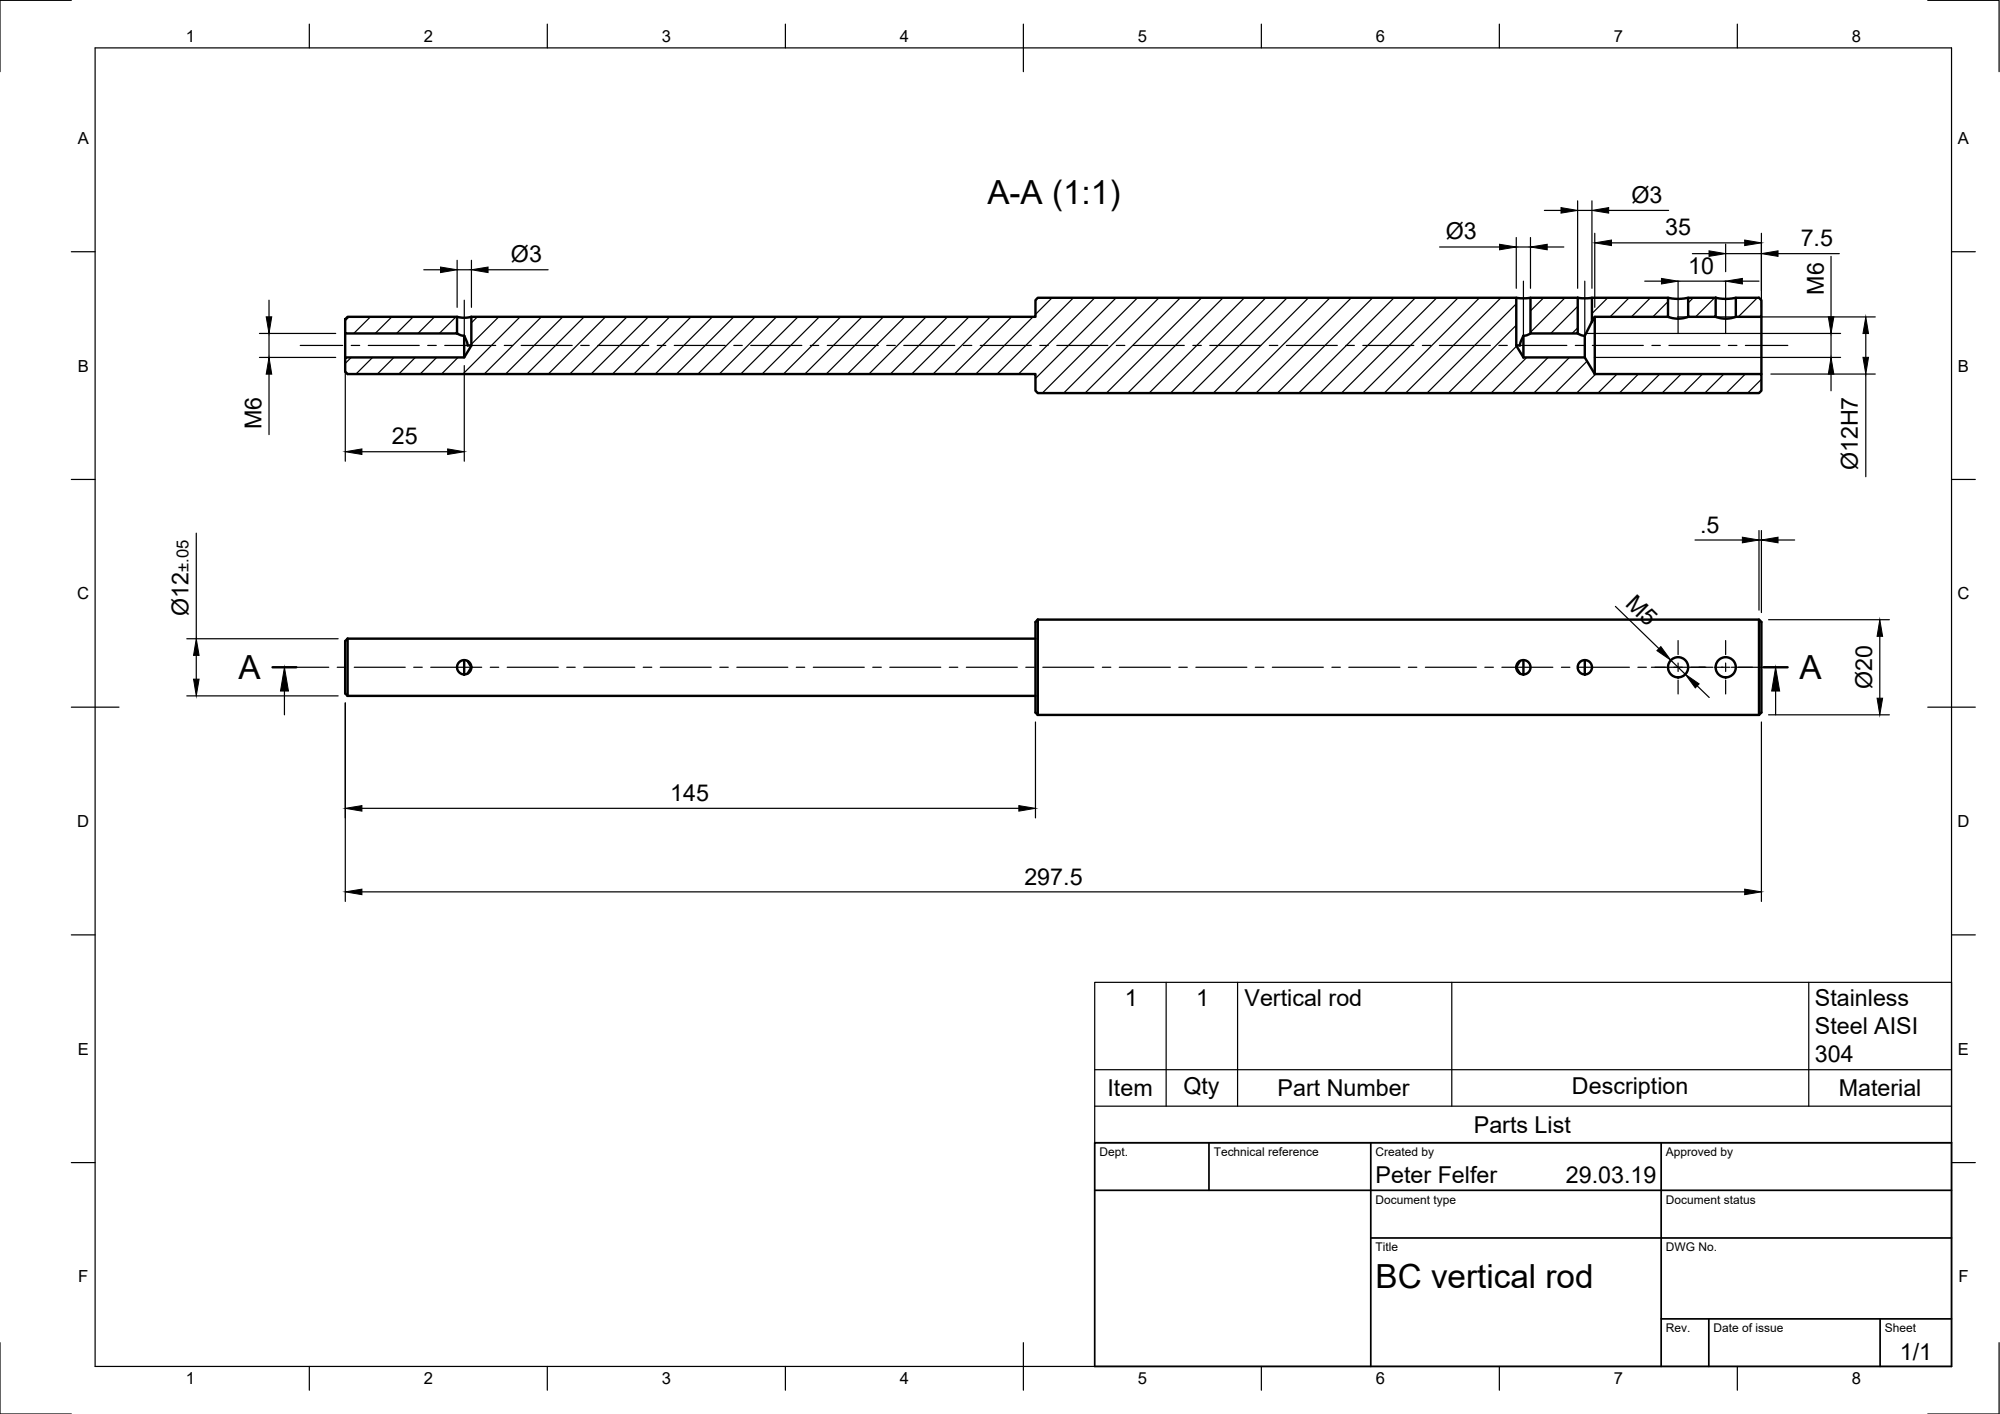
[picture p148: page 1]
Peter Felfer Ø12±.05; Parts List

1 | 1 | Vertical rod | | Stainless Steel AISI 304

Item | Qty | Part Number | Description | Material

Dept. | Technical reference | Created by 29.03.19 | Approved by

Document type | Document status

Title BC vertical rod | DWG No.

Rev. | Date of issue | Sheet 1/1
