peterfelfer/Oxcart/CAD/sample-handling/BC LL parts/LL endeffector Drawing v4.pdf

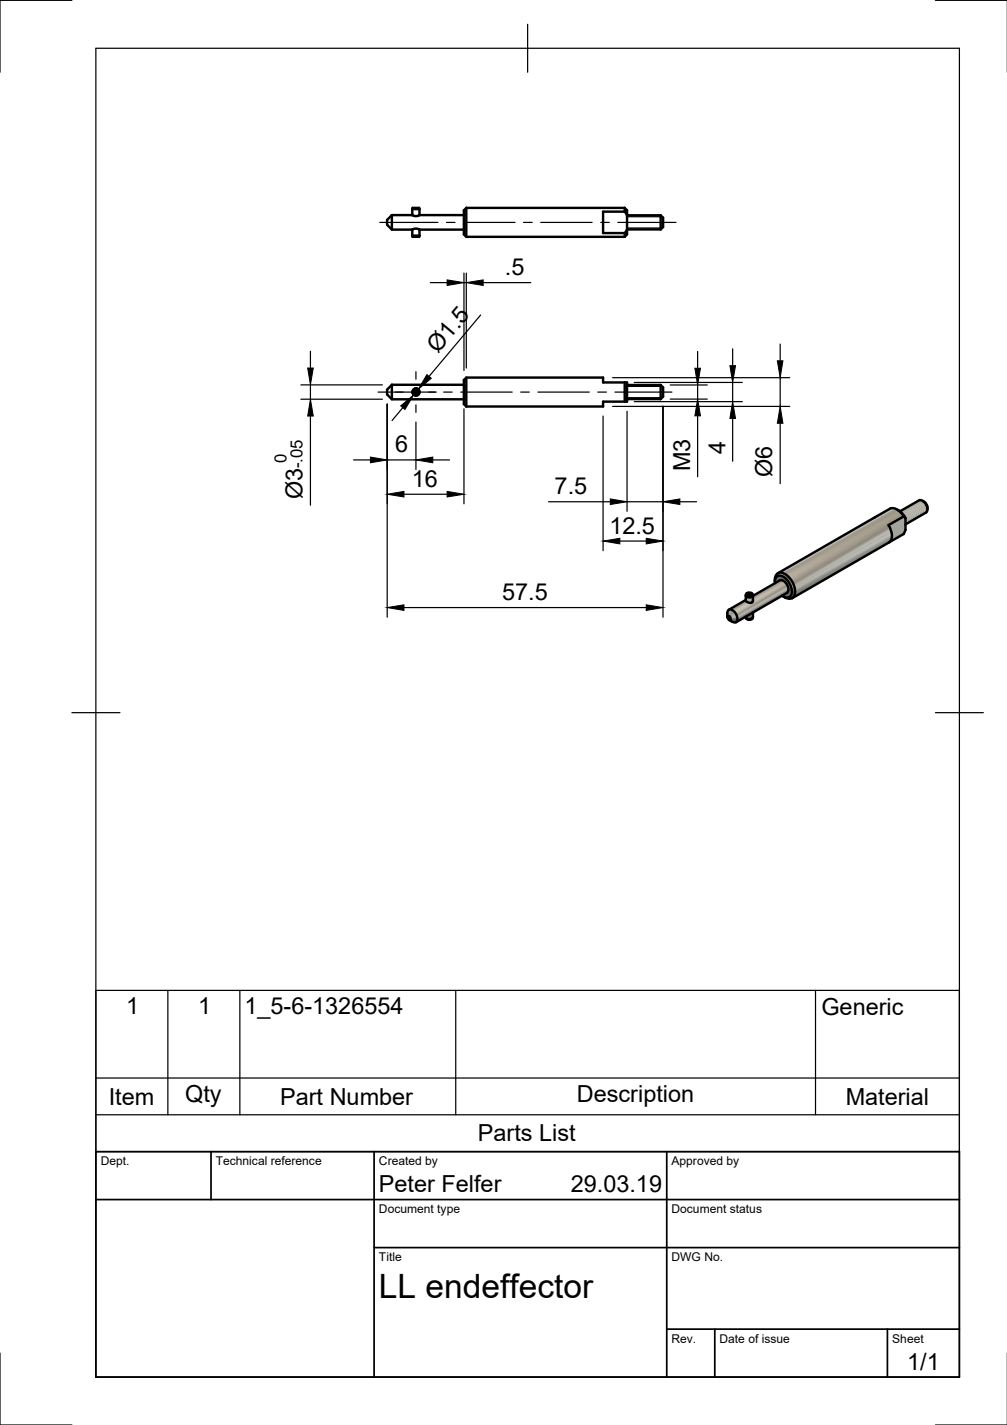
[picture p149: page 1]
Parts List

1 | 1 | 1_5-6-1326554 | | Generic

Item | Qty | Part Number | Description | Material

Dept. | Technical reference | Created by Peter Felfer 29.03.19 | Approved by

Document type | Document status

Title LL endeffector | DWG No.

Rev. | Date of issue | Sheet 1/1
