peterfelfer/Oxcart/CAD/sample-handling/BC LL parts/LL sample rail 2 Drawing v7.pdf

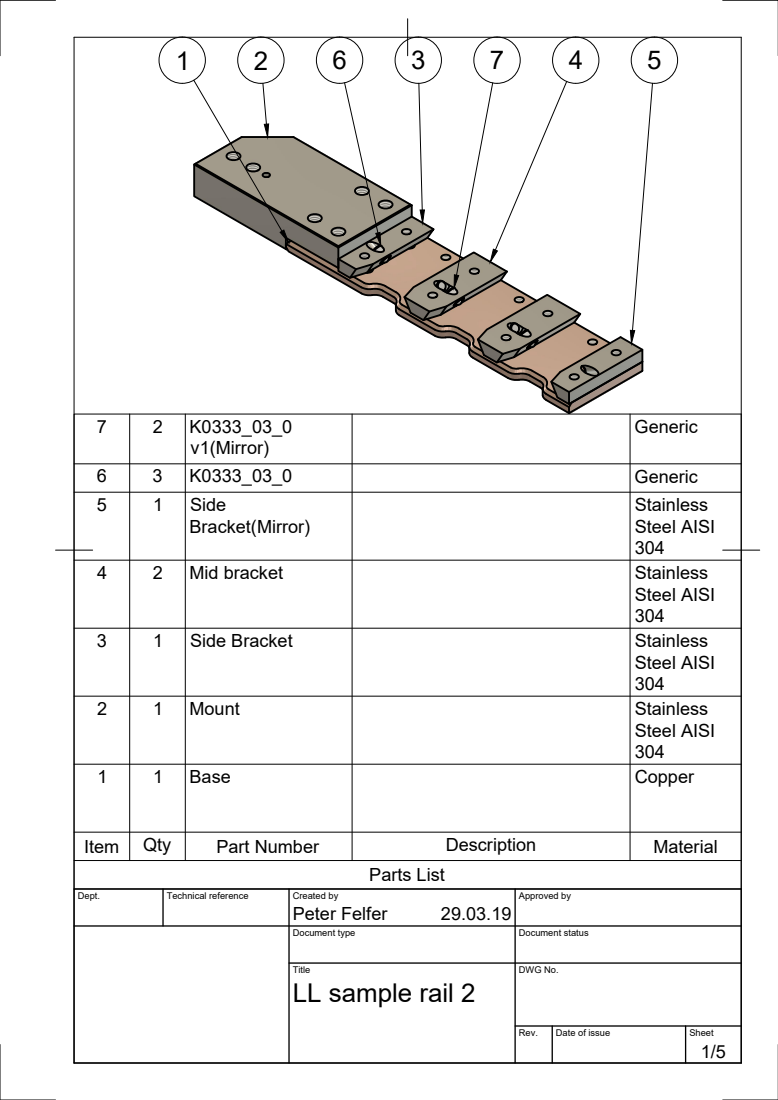
[picture p150: page 1]
Parts List

7 | 2 | K0333_03_0 v1(Mirror) | | Generic

6 | 3 | K0333_03_0 | | Generic
5 | 1 | Side Bracket(Mirror) | | Stainless Steel AISI 304

4 | 2 | Mid bracket | | Stainless Steel AISI 304

3 | 1 | Side Bracket | | Stainless Steel AISI 304

2 | 1 | Mount | | Stainless Steel AISI 304

1 | 1 | Base | | Copper

Item | Qty | Part Number | Description | Material

Dept. | Technical reference | Created by Peter Felfer 29.03.19 | Approved by

Document type | Document status

Title LL sample rail 2 | DWG No.

Rev. | Date of issue | Sheet

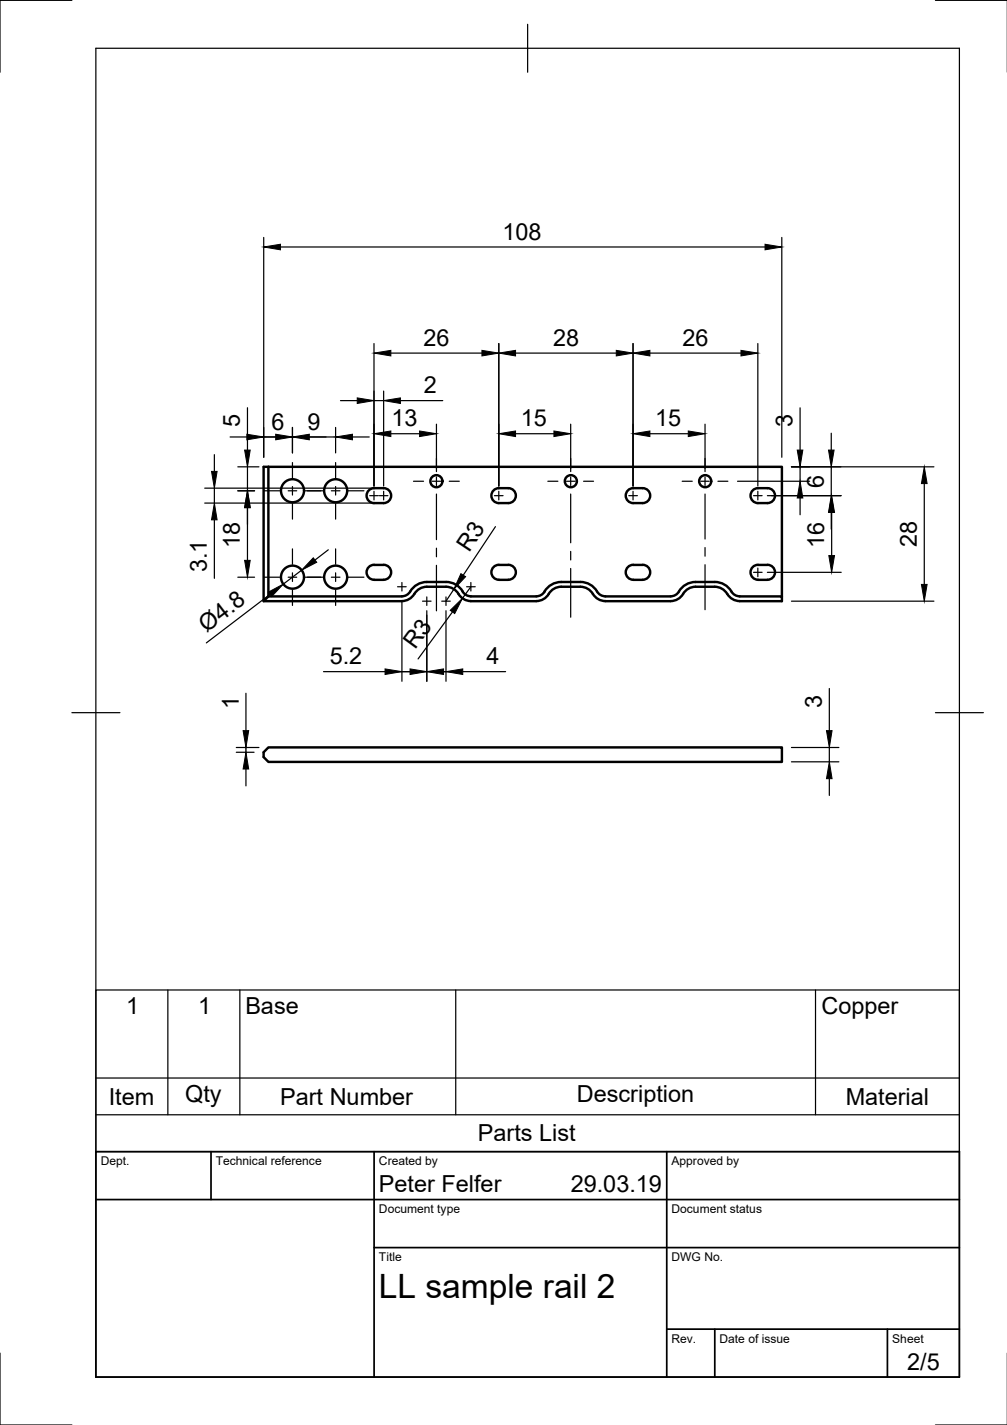
[picture p151: page 2]
Peter Felfer; Parts List

1 | 1 | Base | | Copper

Item | Qty | Part Number | Description | Material

Dept. | Technical reference | Created by 29.03.19 | Approved by

Document type | Document status

Title LL sample rail 2 | DWG No.

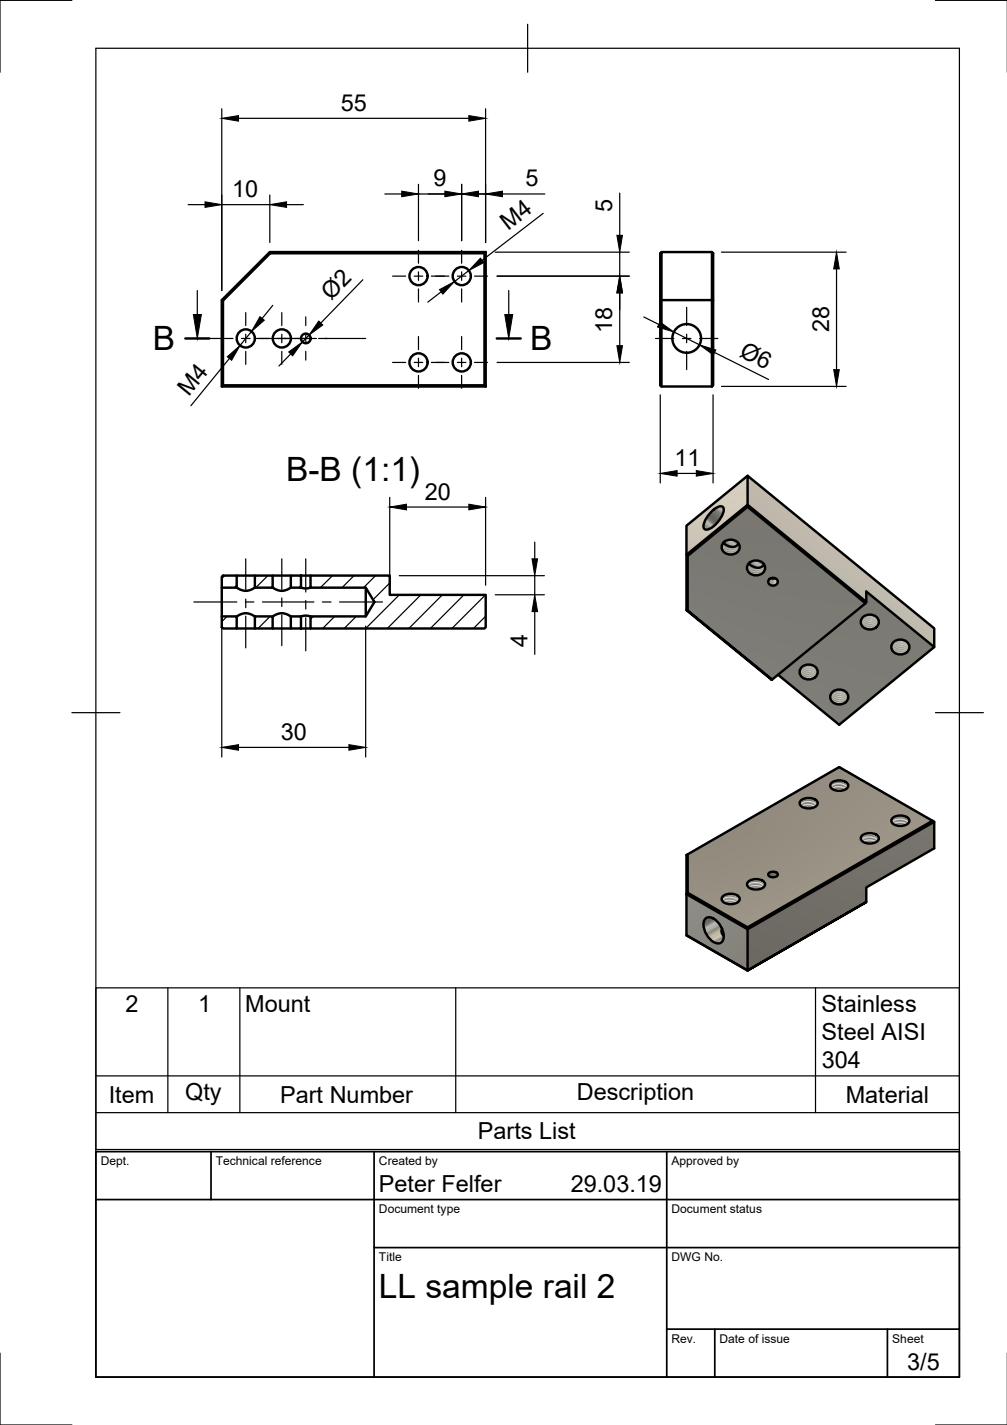
[picture p152: page 3]
Parts List

2 | 1 | Mount | | Stainless Steel AISI 304

Item | Qty | Part Number | Description | Material

Dept. | Technical reference | Created by Peter Felfer 29.03.19 | Approved by

Document type | Document status

Title LL sample rail 2 | DWG No.

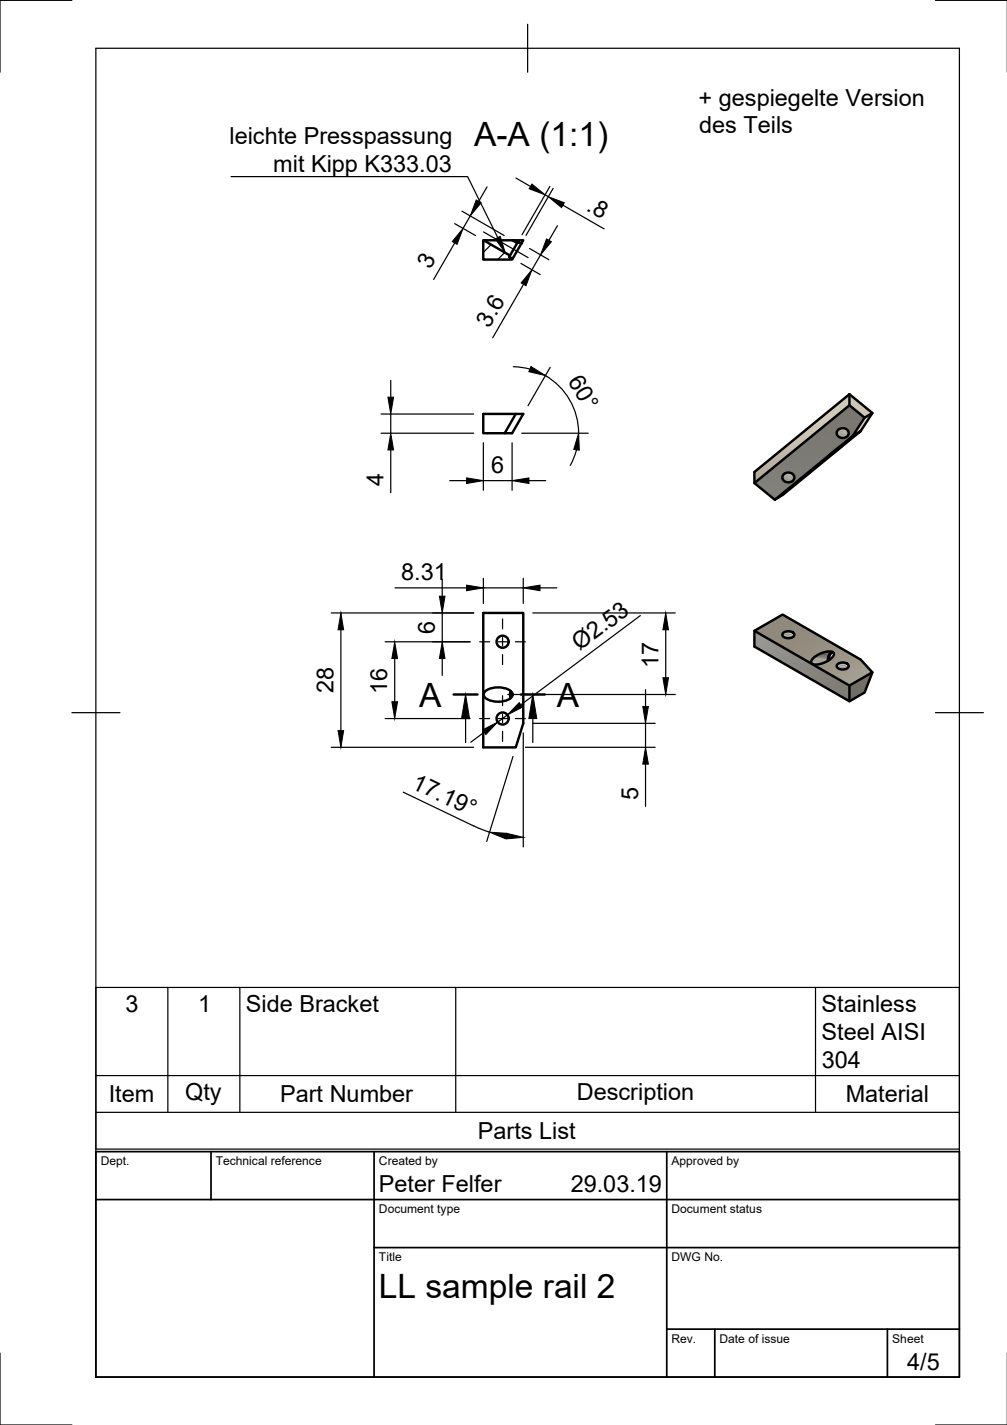
[picture p153: page 4]
Peter Felfer 28; Parts List; + gespiegelte Version

des Teils leichte Presspassung
mit Kipp K333.03

3 | 1 | Side Bracket | | Stainless Steel AISI 304

Item | Qty | Part Number | Description | Material

Dept. | Technical reference | Created by 29.03.19 | Approved by

Document type | Document status

Title LL sample rail 2 | DWG No.

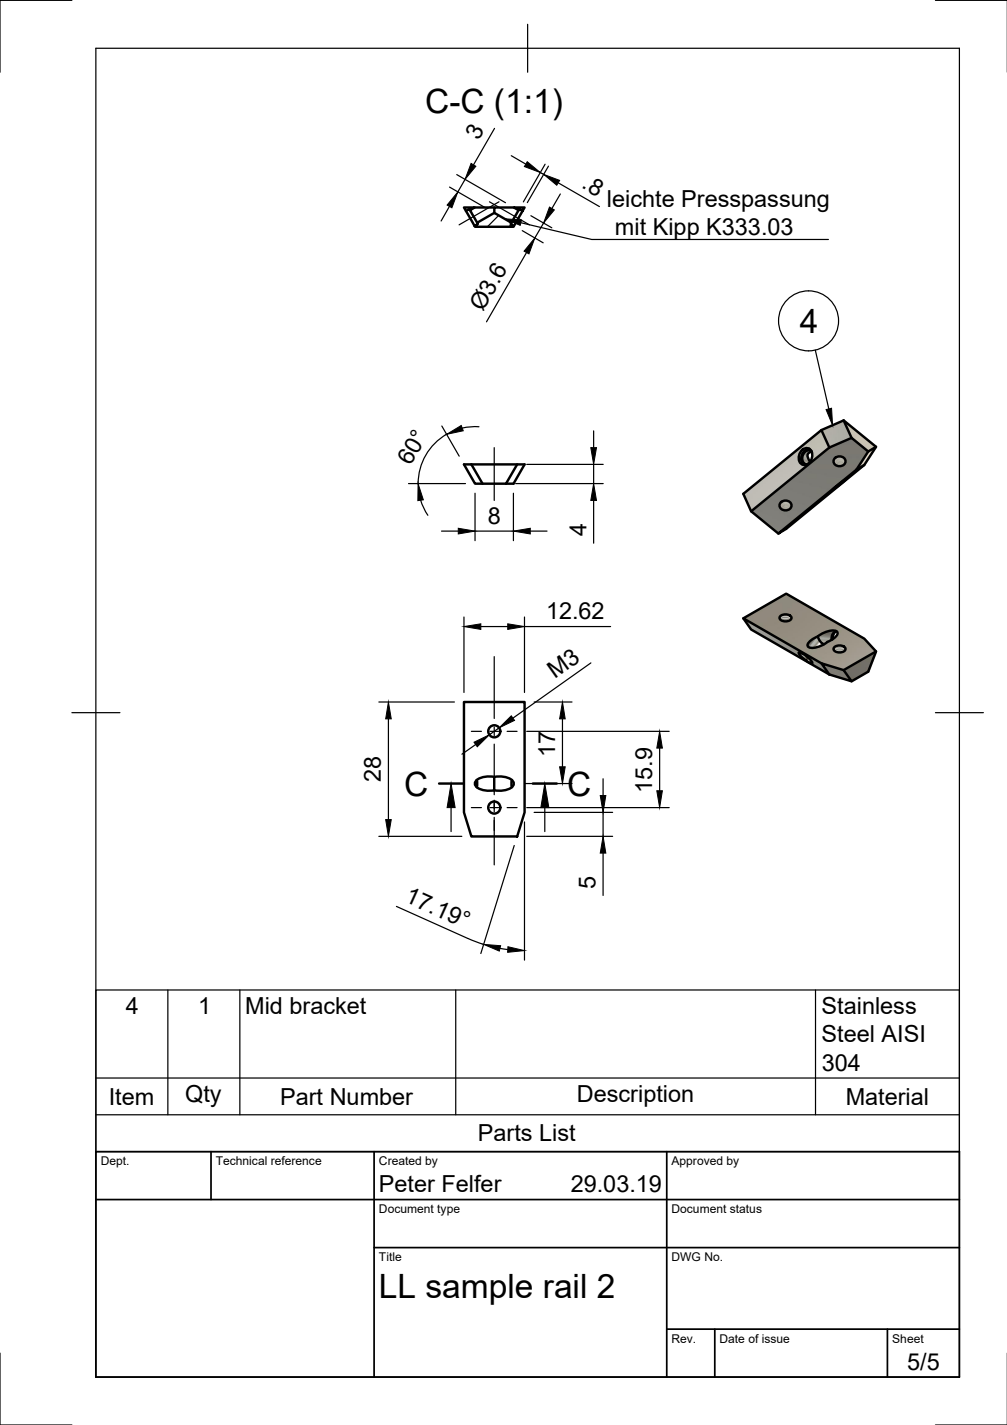
[picture p154: page 5]
Peter Felfer 28; leichte Presspassung mit Kipp K333.03; Parts List

4 | 1 | Mid bracket | | Stainless Steel AISI 304

Item | Qty | Part Number | Description | Material

Dept. | Technical reference | Created by 29.03.19 | Approved by

Document type | Document status

Title LL sample rail 2 | DWG No.
