peterfelfer/Oxcart/CAD/sample-handling/BC LL parts/specimen carousel assembly Drawing v2.pdf

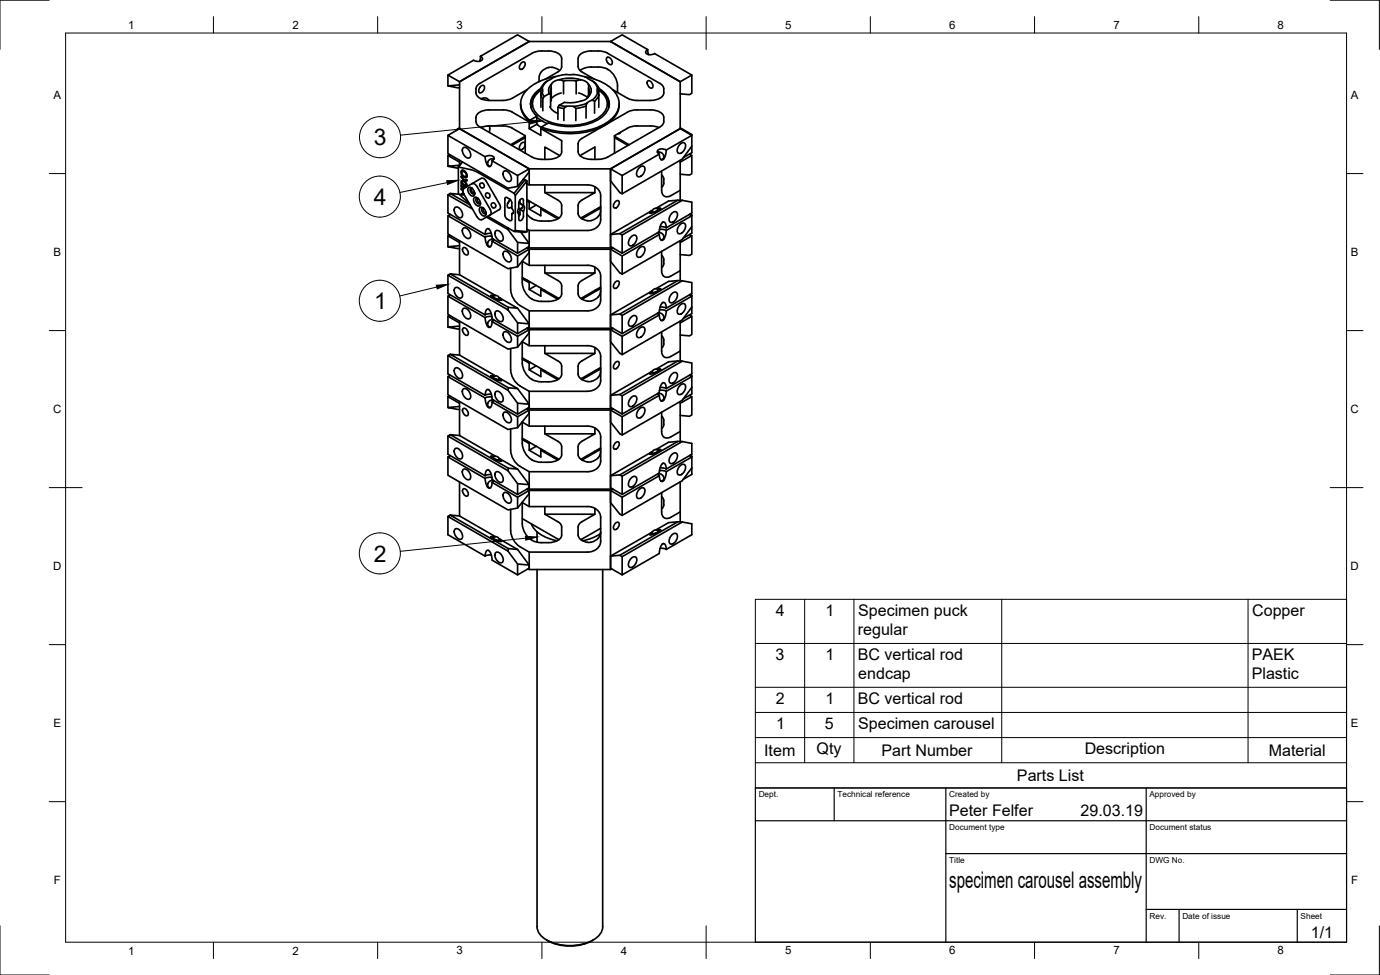
[picture p156: page 1]
Parts List

4 | 1 | Specimen puck regular | | Copper

3 | 1 | BC vertical rod endcap | | PAEK Plastic

2 | 1 | BC vertical rod
1 | 5 | Specimen carousel
Item | Qty | Part Number | Description | Material

Dept. | Technical reference | Created by Peter Felfer 29.03.19 | Approved by

Document type | Document status

Title specimen carousel assembly | DWG No.

Rev. | Date of issue | Sheet 1/1
