peterfelfer/Oxcart/CAD/sample-handling/BC LL parts/specimen carousel Drawing v6.pdf

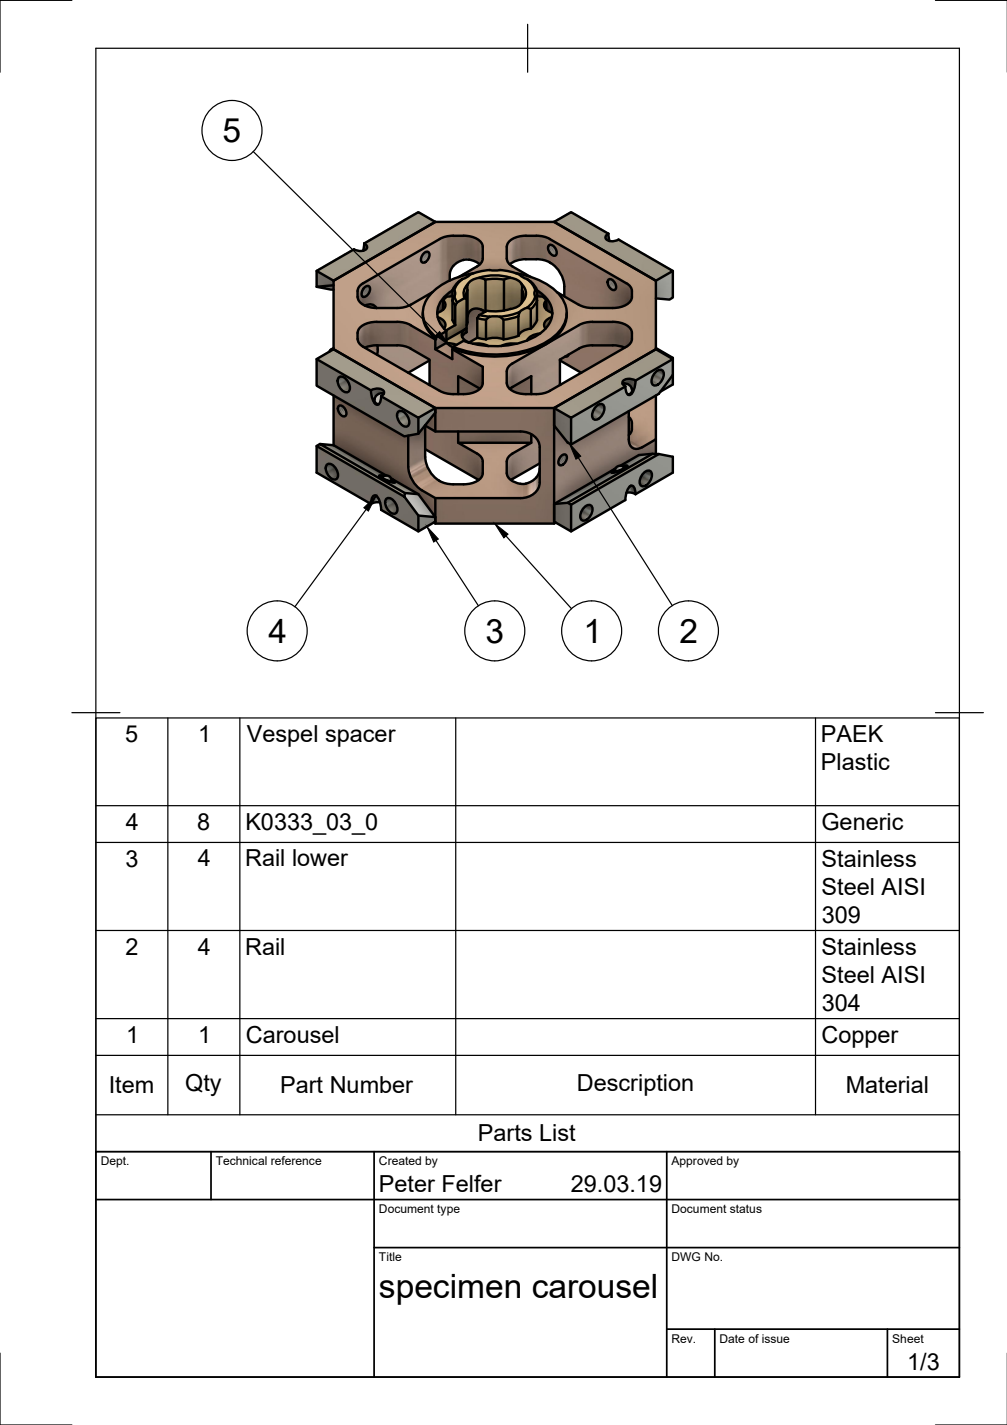
[picture p157: page 1]
Parts List

5 | 1 | Vespel spacer | | PAEK Plastic

4 | 8 | K0333_03_0 | | Generic
3 | 4 | Rail lower | | Stainless Steel AISI 309

2 | 4 | Rail | | Stainless Steel AISI 304

1 | 1 | Carousel | | Copper

Item | Qty | Part Number | Description | Material

Dept. | Technical reference | Created by Peter Felfer 29.03.19 | Approved by

Document type | Document status

Title specimen carousel | DWG No.

Rev. | Date of issue | Sheet

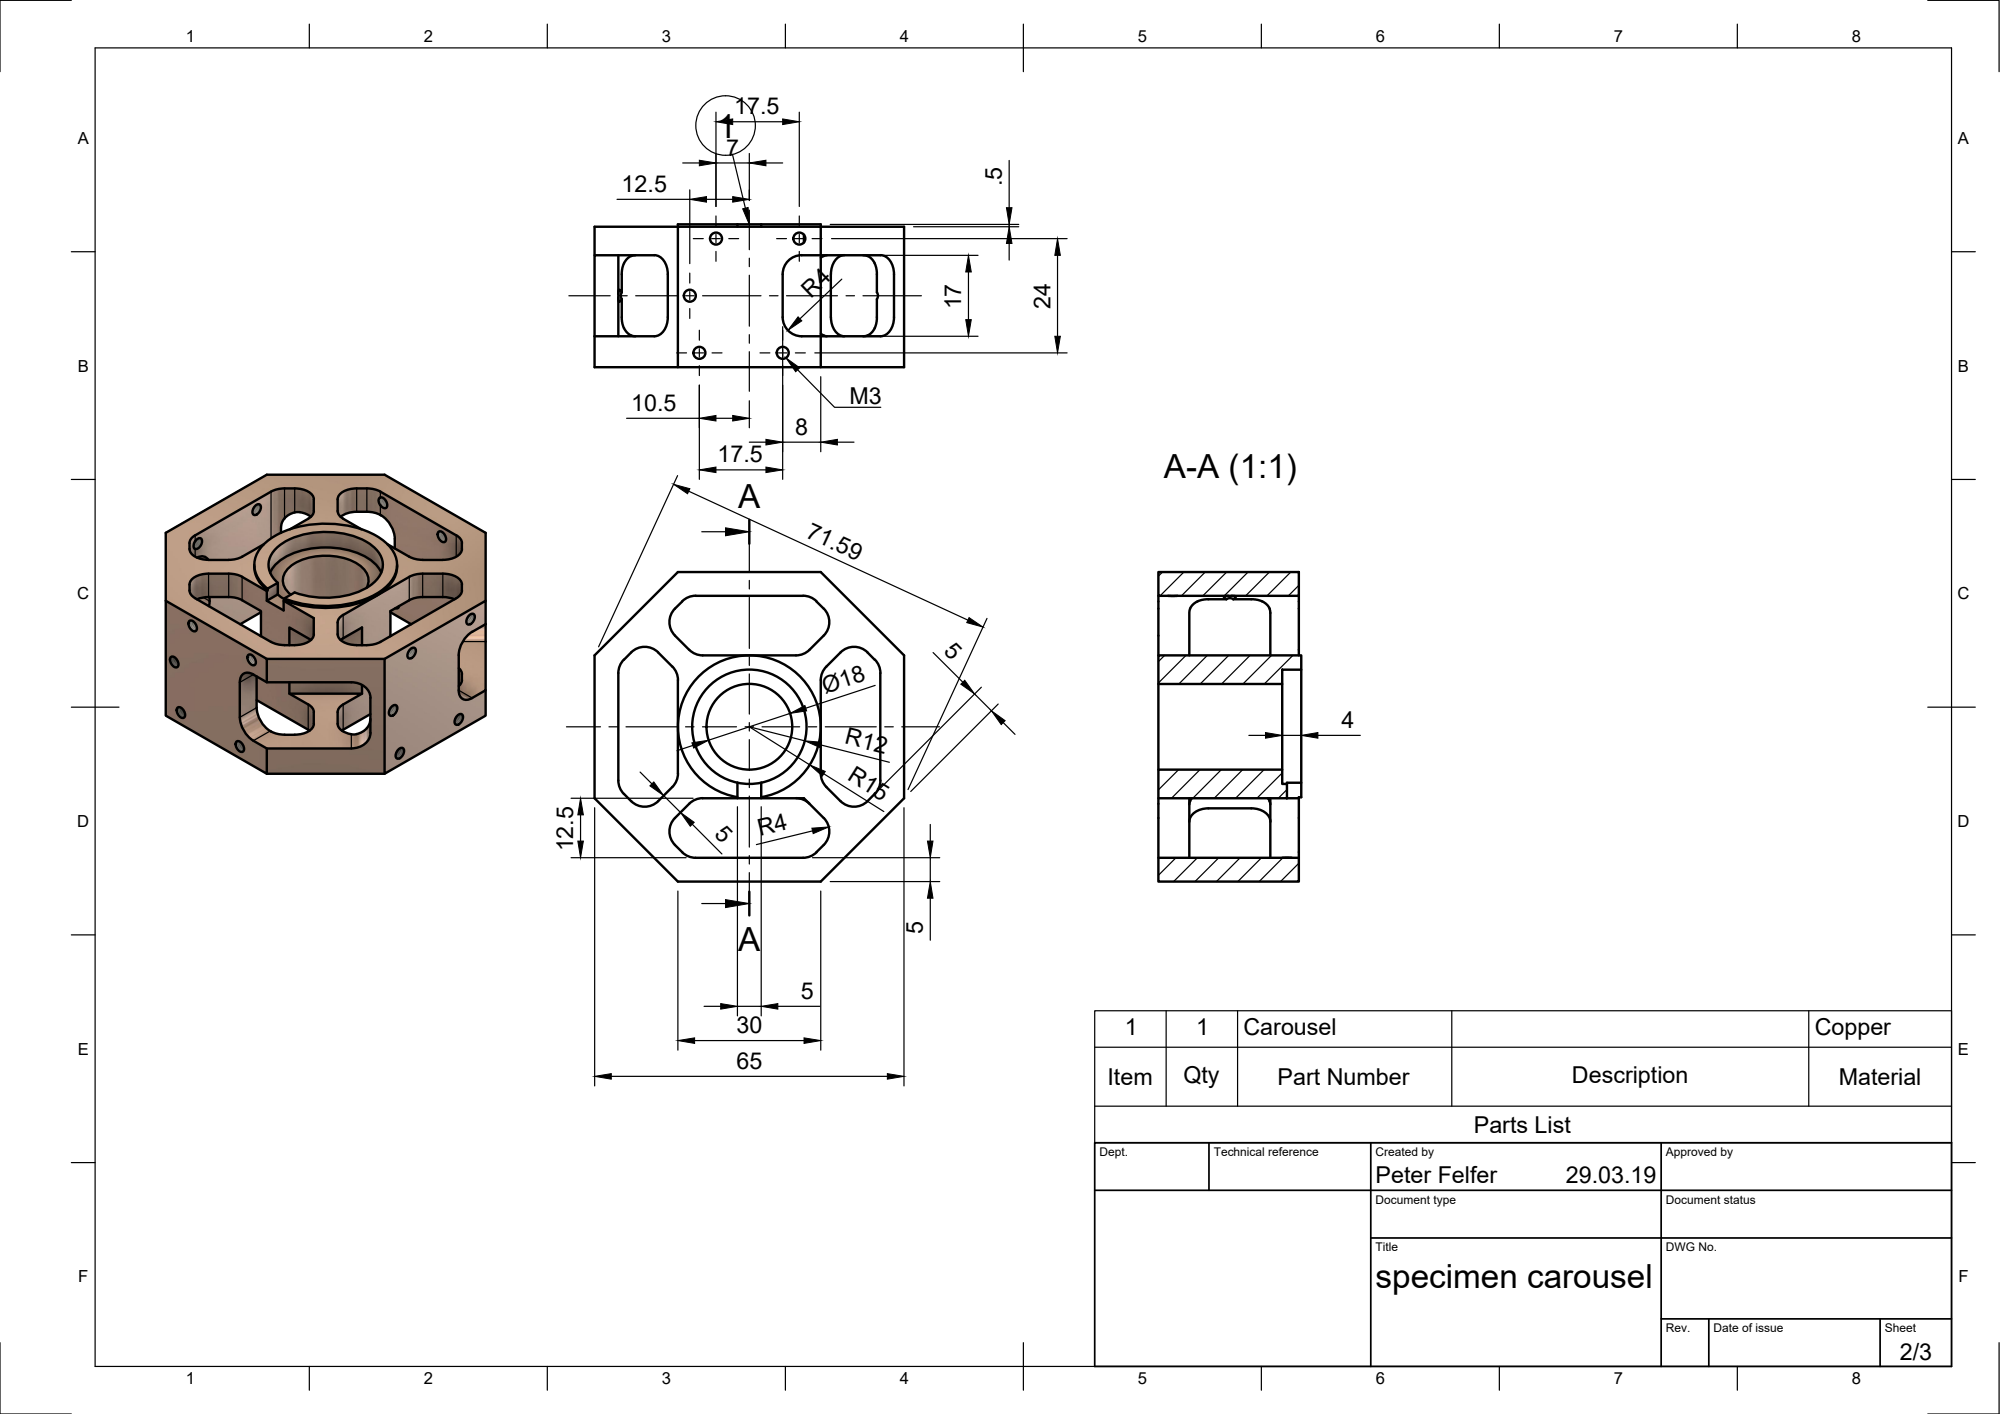
[picture p158: page 2]
Parts List

1 | 1 | Carousel | | Copper

Item | Qty | Part Number | Description | Material

Dept. | Technical reference | Created by Peter Felfer 29.03.19 | Approved by

Document type | Document status

Title specimen carousel | DWG No.

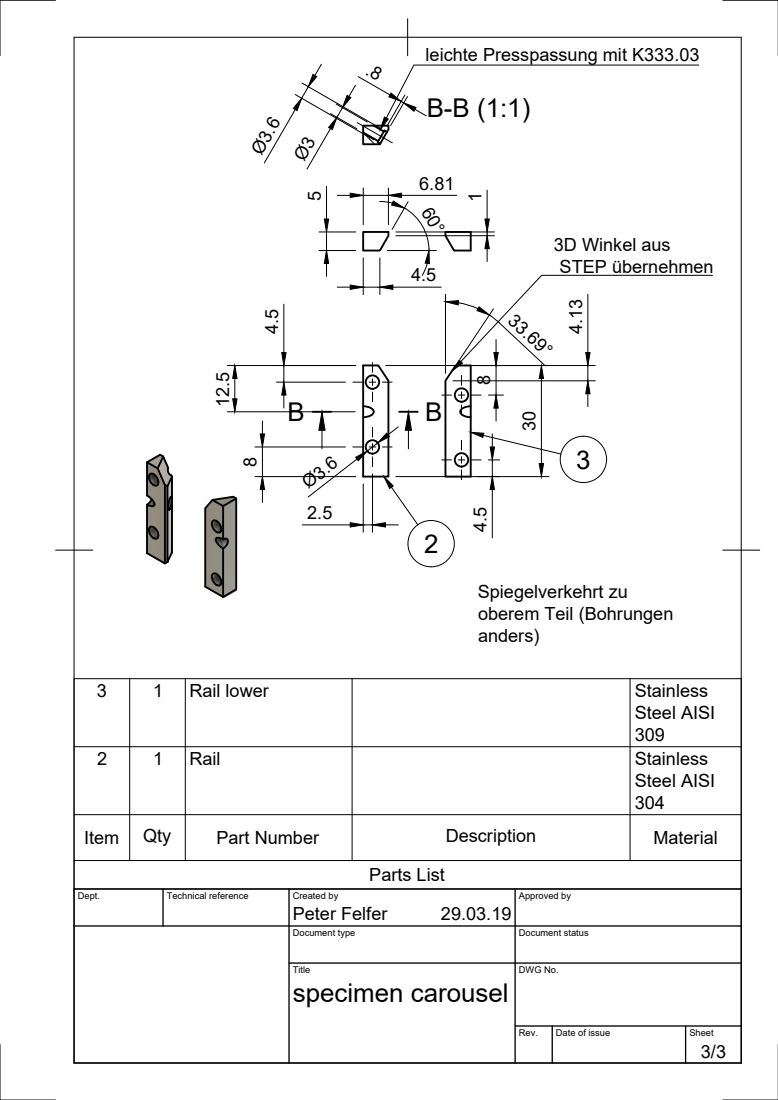
[picture p159: page 3]
anders) 4.5; Parts List; 3D Winkel aus STEP übernehmen

leichte Presspassung mit K333.03

Spiegelverkehrt zu
oberem Teil (Bohrungen

3 | 1 | Rail lower | | Stainless Steel AISI 309

2 | 1 | Rail | | Stainless Steel AISI 304

Item | Qty | Part Number | Description | Material

Dept. | Technical reference | Created by Peter Felfer 29.03.19 | Approved by

Document type | Document status

Title specimen carousel | DWG No.
