peterfelfer/Oxcart/CAD/sample-handling/sample stage - pucks/Sapphire Plate Specimen Side Drawing v6.pdf

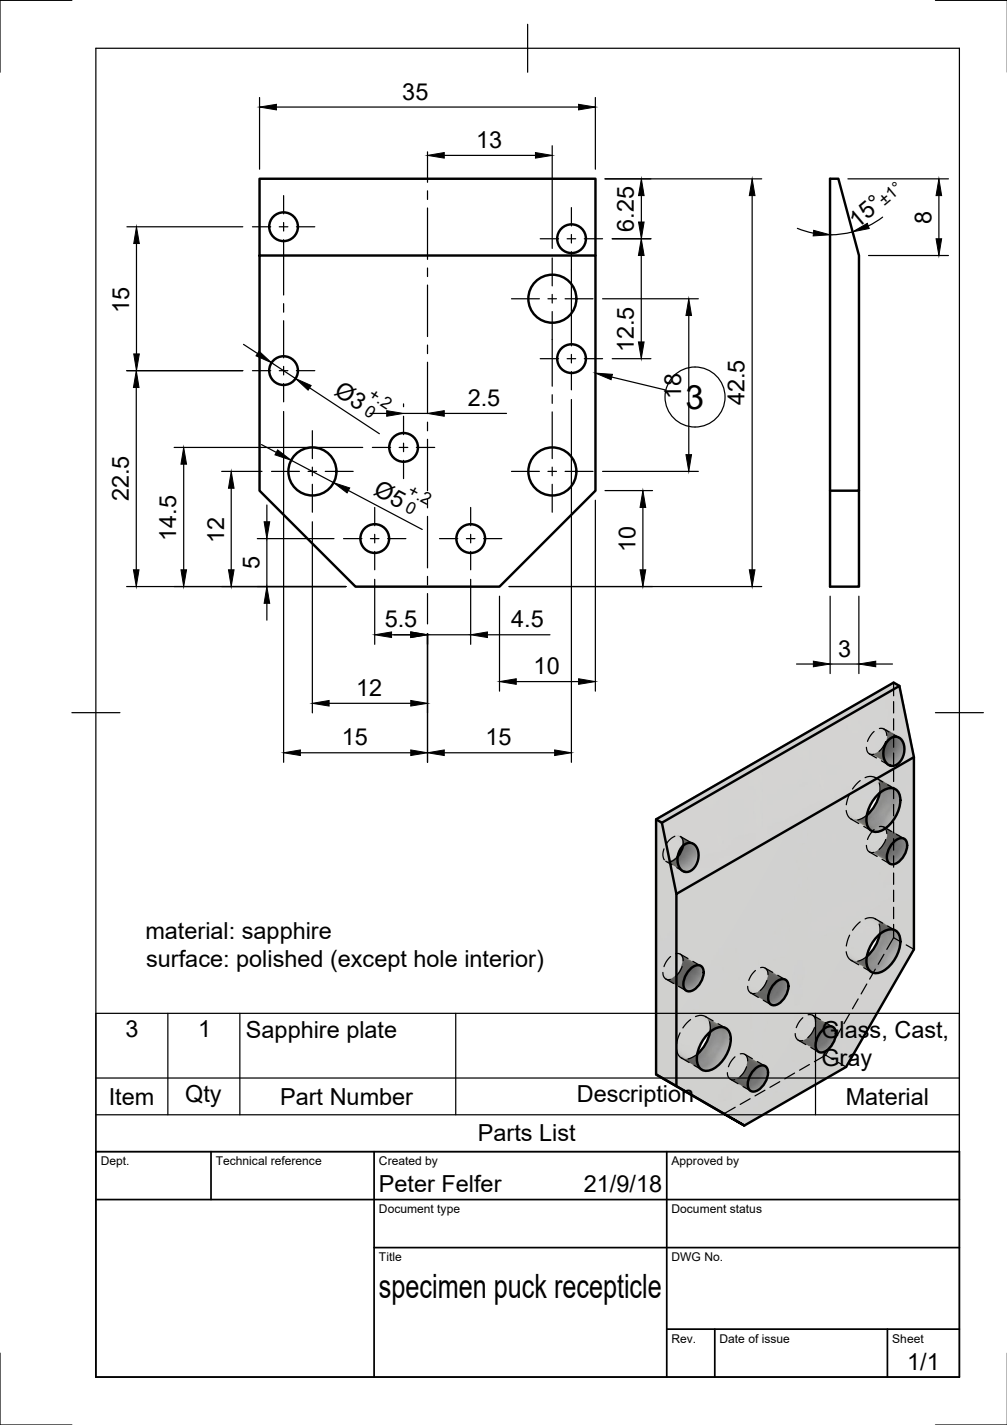
[picture p160: page 1]
Parts List

material: sapphire
surface: polished (except hole interior)

3 | 1 | Sapphire plate | | Glass, Cast, Gray

Item | Qty | Part Number | Description | Material

Dept. | Technical reference | Created by Peter Felfer 21/9/18 | Approved by

Document type | Document status

Title specimen puck recepticle | DWG No.

Rev. | Date of issue | Sheet 1/1
