peterfelfer/Oxcart/CAD/sample-handling/sample stage - pucks/specimen puck Drawing v5.pdf

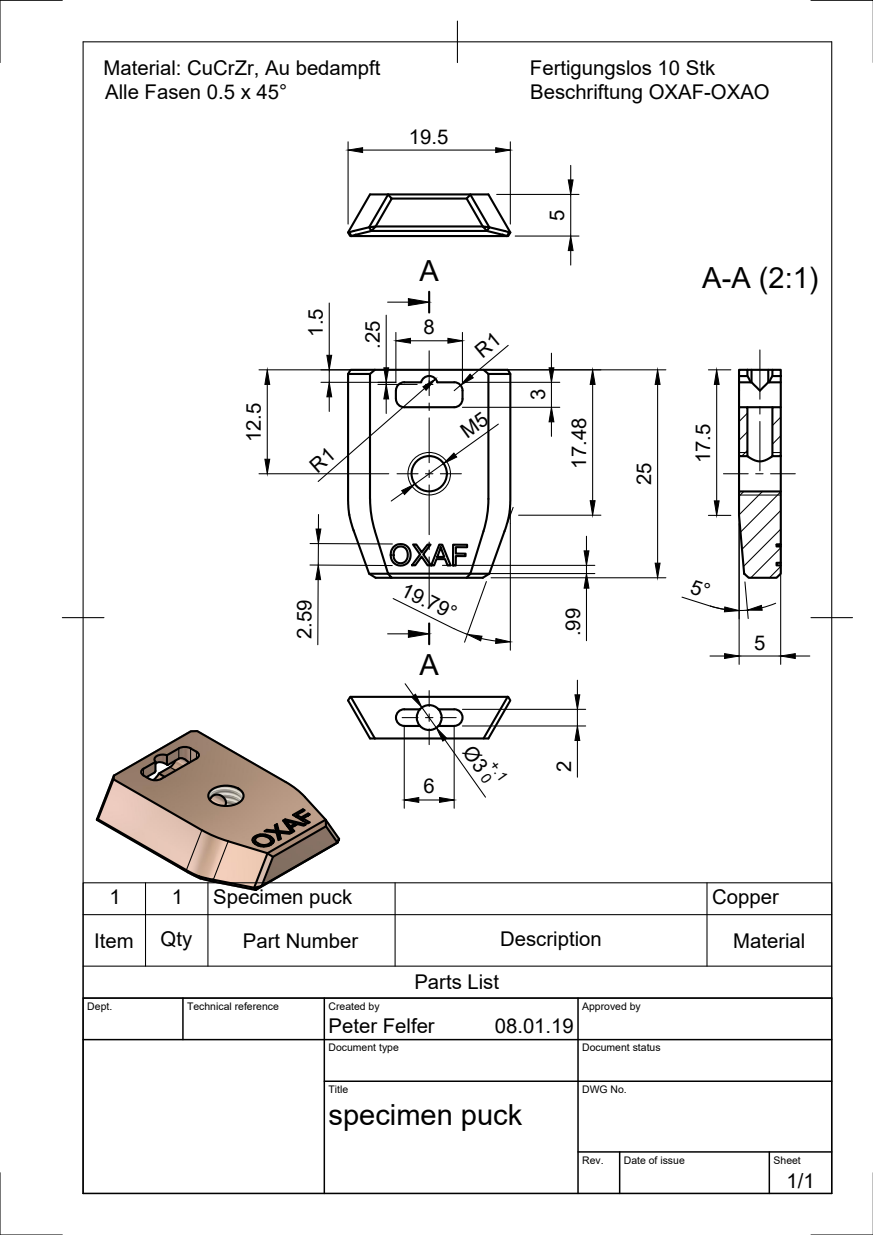
[picture p161: page 1]
Parts List

Material: CuCrZr, Au bedampft
Alle Fasen 0.5 x 45°

Fertigungslos 10 Stk
Beschriftung OXAF-OXAO 2517.48

1 | 1 | Specimen puck | | Copper

Item | Qty | Part Number | Description | Material

Dept. | Technical reference | Created by Peter Felfer 08.01.19 | Approved by

Document type | Document status

Title specimen puck | DWG No.

Rev. | Date of issue | Sheet 1/1
