peterfelfer/Oxcart/CAD/sample-handling/sample stage - pucks/specimen puck recepticle Drawing v5.pdf

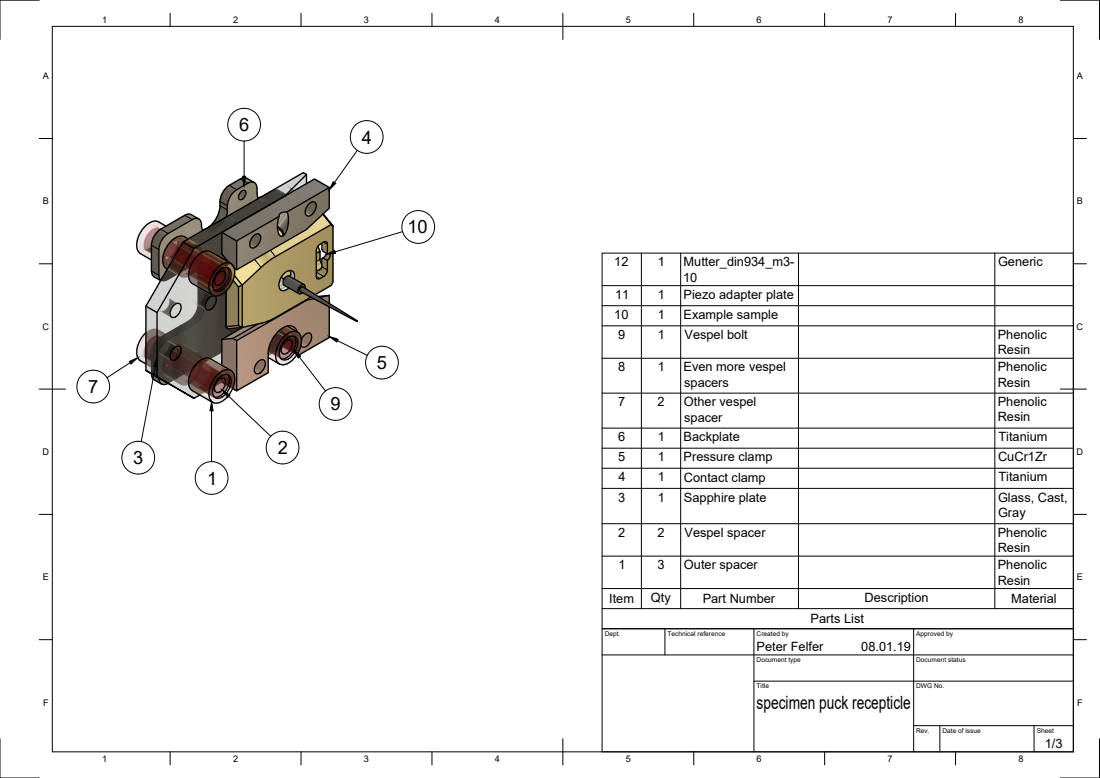
[picture p162: page 1]
Peter Felfer 1 A; 8 BCDEF; ABCDEF; Parts List; Resin 2; Vespel spacer; Phenolic

12 | 1 | Mutter_din934_m3-10 | | Generic

11 | 1 | Piezo adapter plate
10 | 1 | Example sample
1 | Vespel bolt | | Resin 9 Phenolic Resin

1 | Even more vespel spacers | | Resin 8 Phenolic

2 1 1 1 | Pressure clamp Backplate Contact clamp Other vespel | | Gray 4 CuCr1Zr 6 Titanium 5 Titanium 7

spacer | | Phenolic

1 | Sapphire plate | | Resin 3 Glass, Cast,

Item | Qty 3 | Outer spacer Part Number | Description | Phenolic Material 1

Dept. | Technical reference | Created by 08.01.19 | Approved by

Document type | Document status

Title specimen puck recepticle | DWG No.

Rev. | Date of issue | Sheet

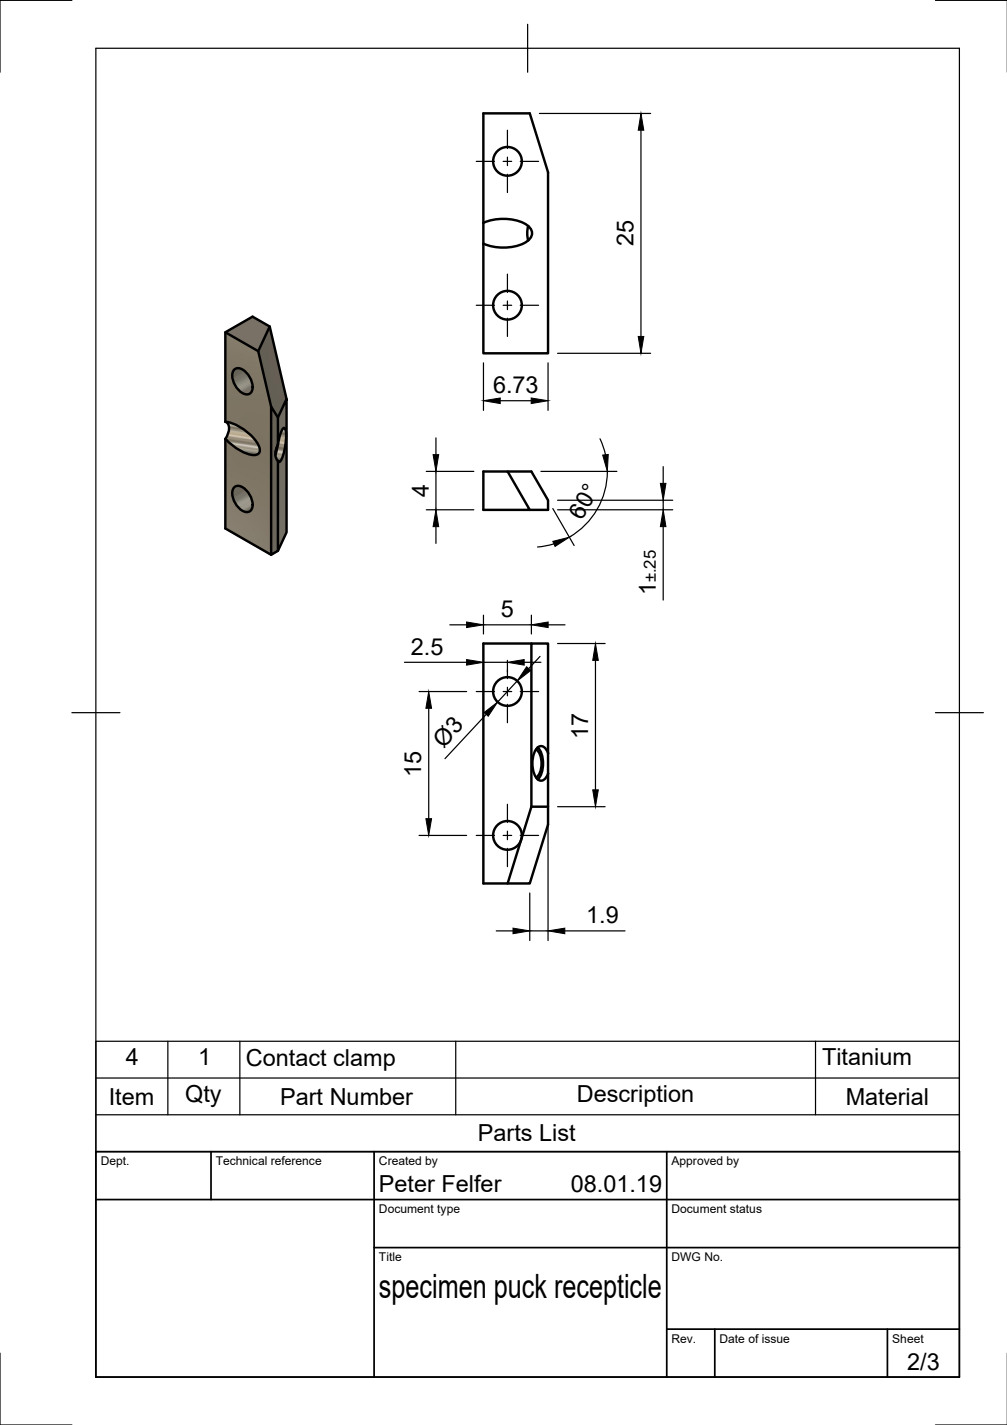
[picture p163: page 2]
Parts List; Item; Qty; Part Number; Description; Material; Contact clamp; Titanium 25

Dept. | Technical reference | Created by Peter Felfer 08.01.19 | Approved by

Document type | Document status

Title specimen puck recepticle | DWG No.

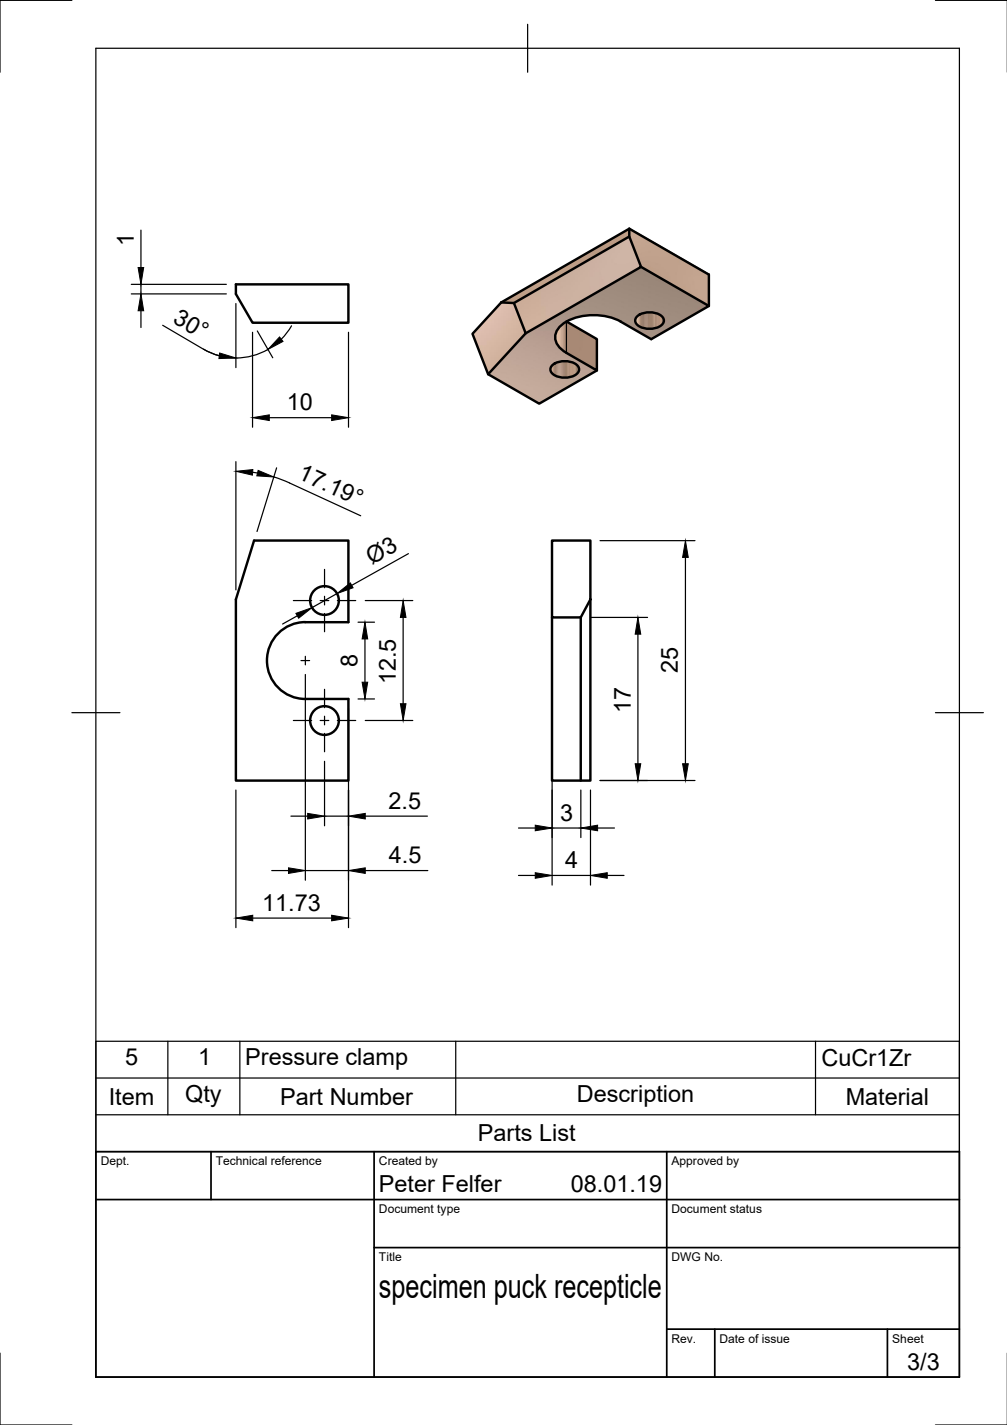
[picture p164: page 3]
Parts List; Item; Qty; Part Number; Description; Material; Pressure clamp; CuCr1Zr 25

Dept. | Technical reference | Created by Peter Felfer 08.01.19 | Approved by

Document type | Document status

Title specimen puck recepticle | DWG No.
