peterfelfer/Oxcart/CAD/sample-handling/sample stage - pucks/specimen puck regular Drawing v6.pdf

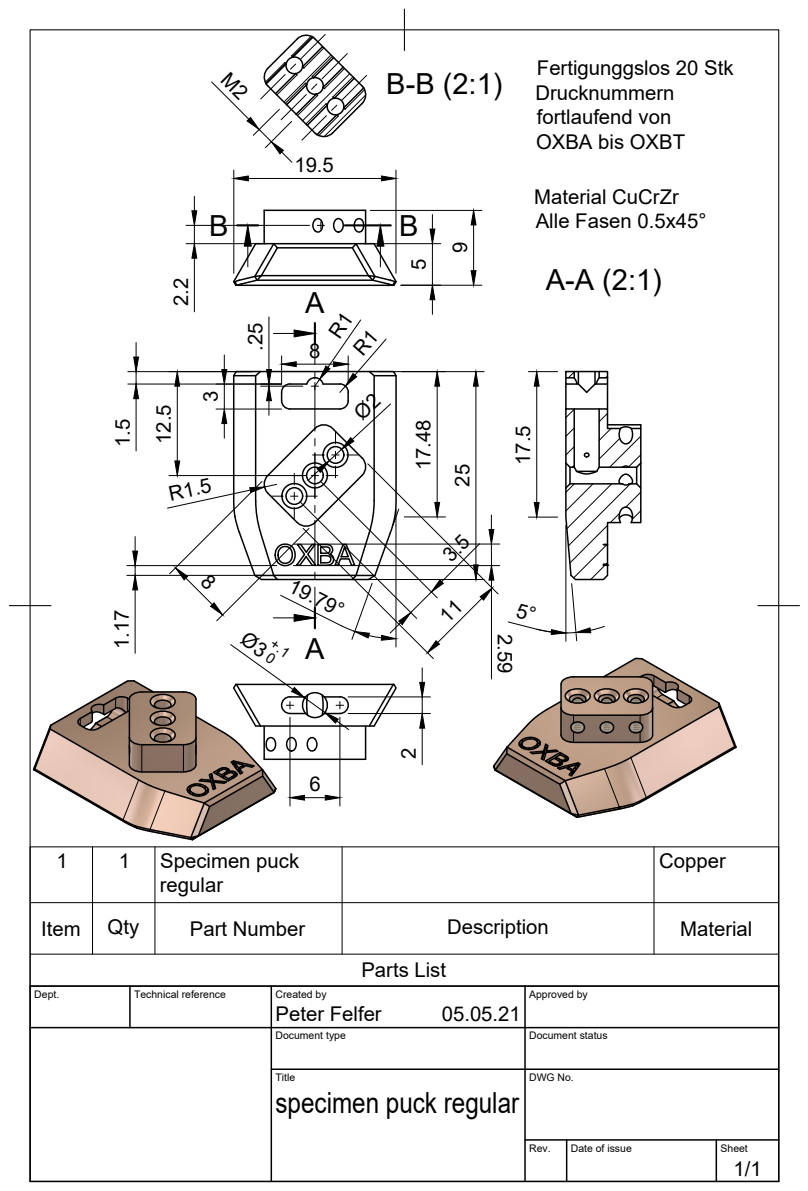
[picture p165: page 1]
Parts List; Material CuCrZr Alle Fasen 0.5x45°; Fertigunggslos 20 Stk; Drucknummern; fortlaufend von; OXBA bis OXBT 2.591.17

1 | 1 | Specimen puck regular | | Copper

Item | Qty | Part Number | Description | Material

Dept. | Technical reference | Created by Peter Felfer 05.05.21 | Approved by

Document type | Document status

Title specimen puck regular | DWG No.

Rev. | Date of issue | Sheet 1/1
