peterfelfer/Oxcart/CAD/vacuum/chambers/CF63 special weld-in_final v1.pdf

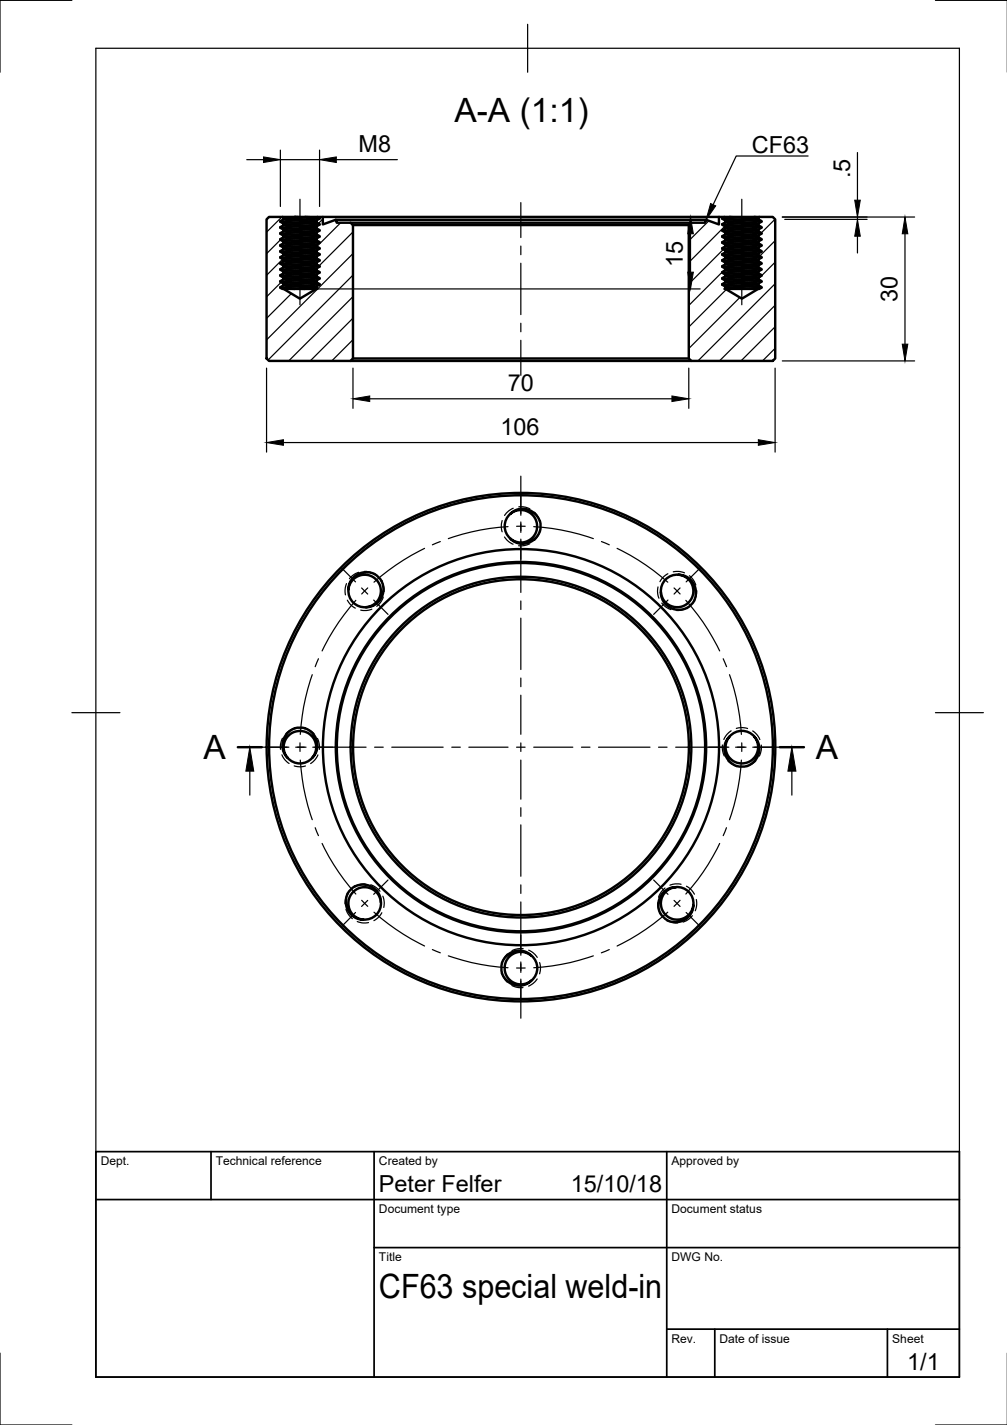
[picture p166: page 1]

Dept. | Technical reference | Created by Peter Felfer 15/10/18 | Approved by

Document type | Document status

Title CF63 special weld-in | DWG No.

Rev. | Date of issue | Sheet 1/1
