peterfelfer/Oxcart/CAD/vacuum/chambers/Detector flange Surface Concept Drawing v4.pdf

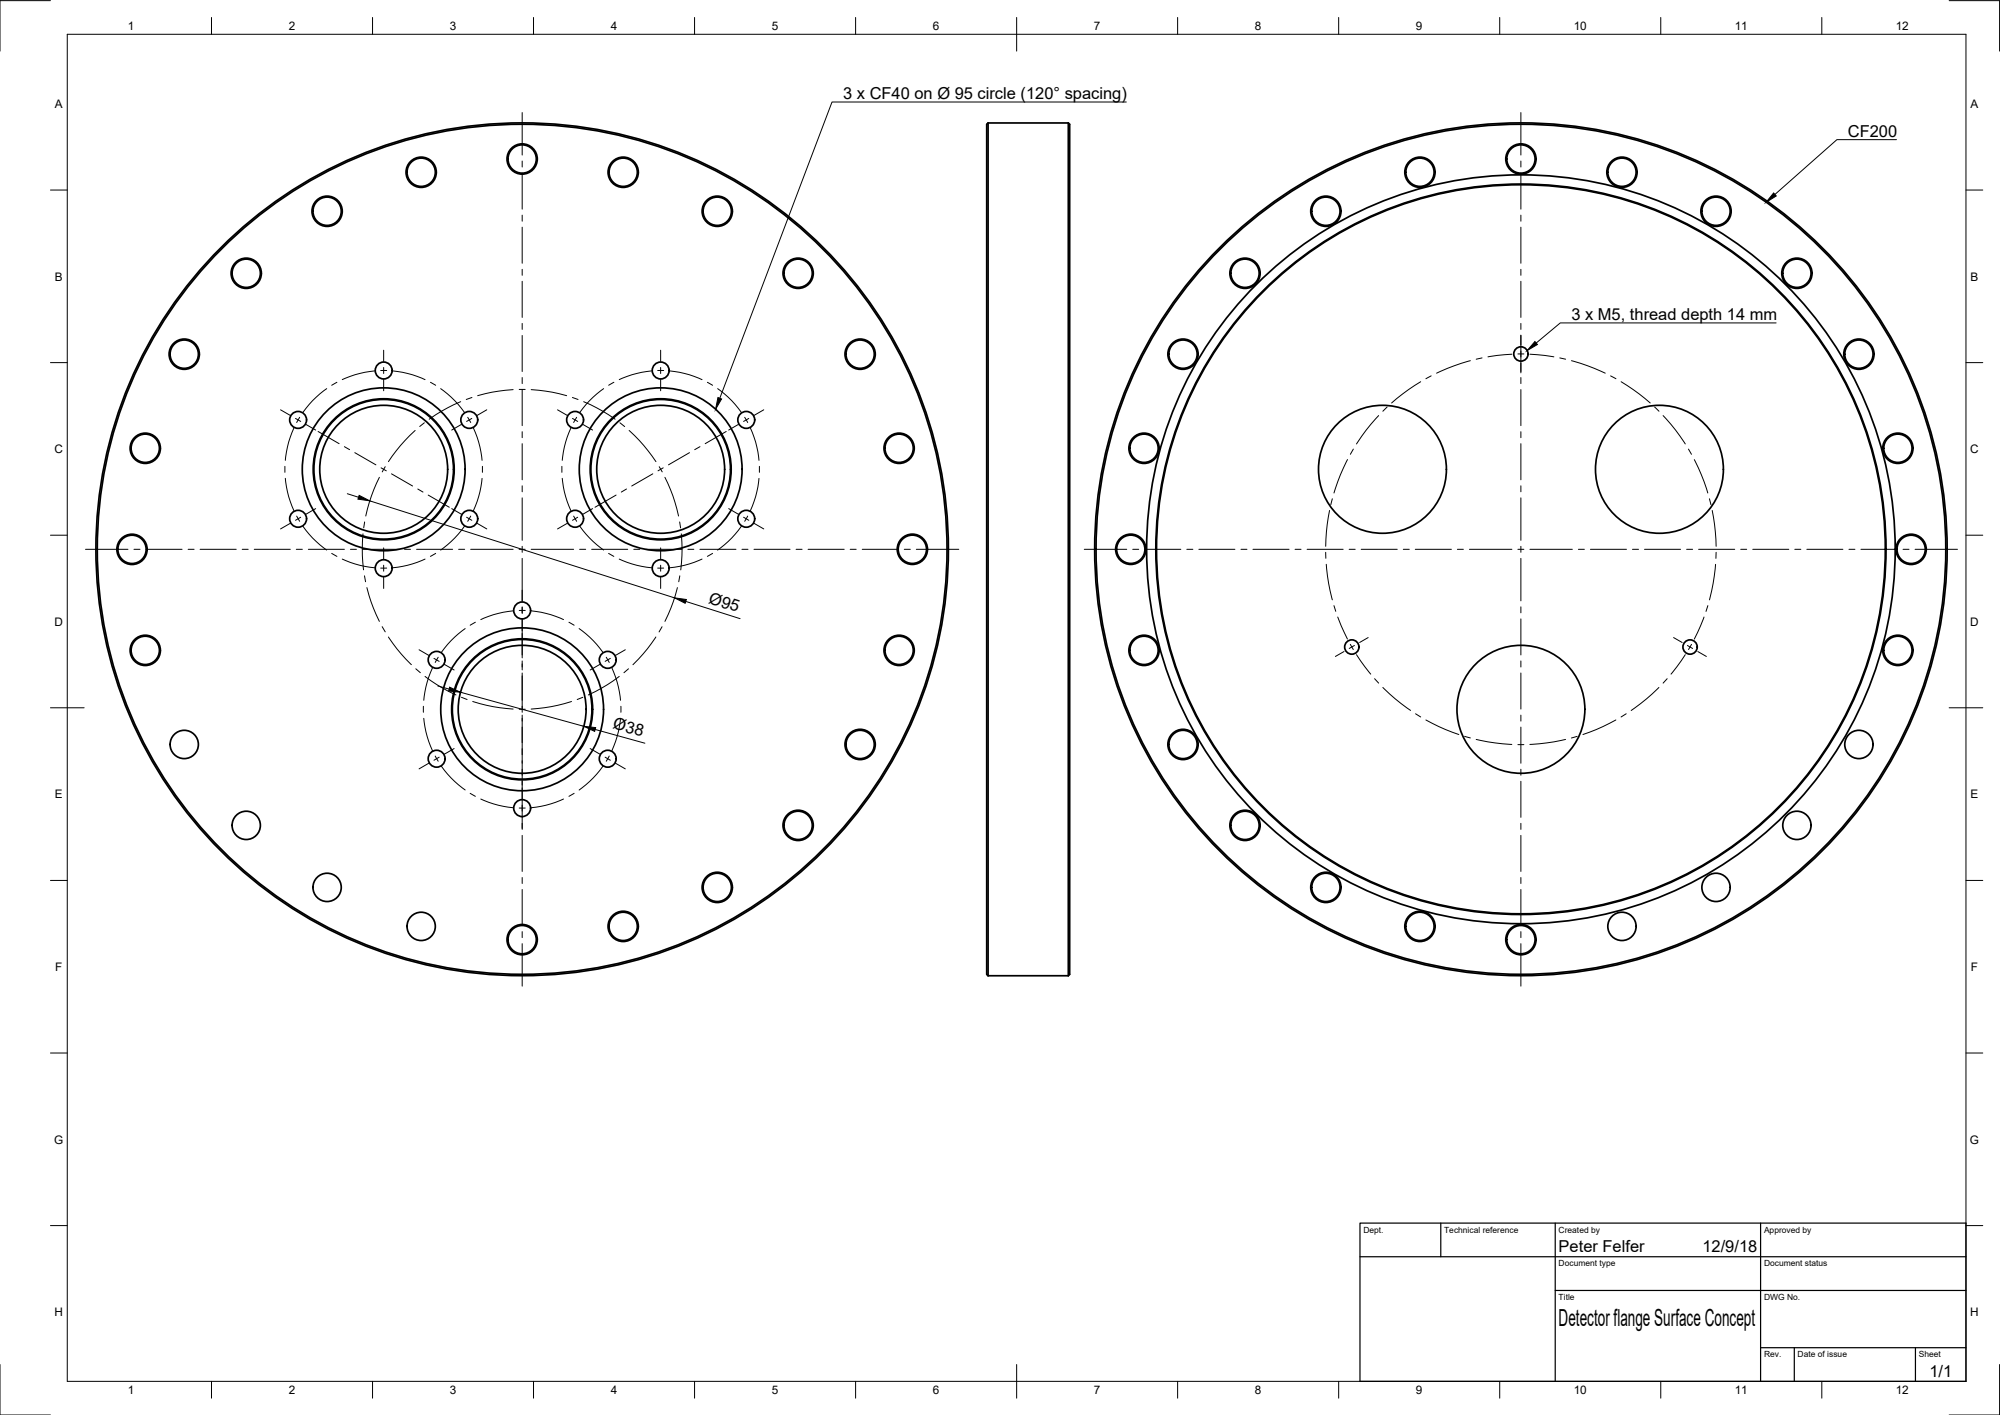
[picture p167: page 1]

3 x CF40 on Ø 95 circle (120° spacing)

3 x M5, thread depth 14 mm

Dept. | Technical reference | Created by Peter Felfer 12/9/18 | Approved by

Document type | Document status

Title Detector flange Surface Concept | DWG No.

Rev. | Date of issue | Sheet 1/1
