peterfelfer/Oxcart/CAD/optics-laser/laser upgrade/LaserStage/LaserStageRotation Drawing v2.pdf

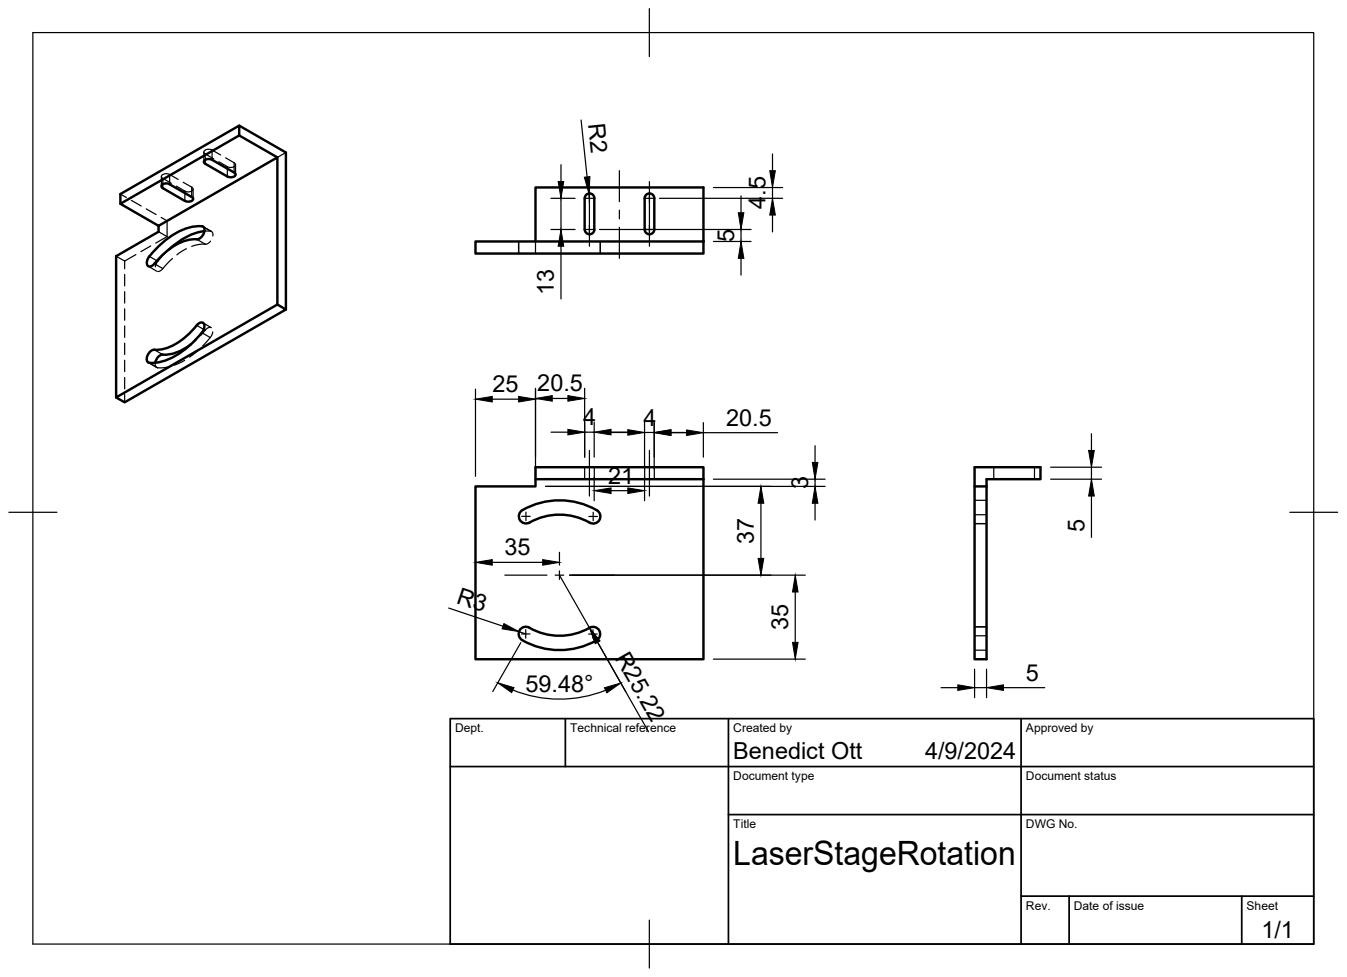
[picture p168: page 1]

Dept. | Technical reference | Created by Benedict Ott 4/9/2024 | Approved by

Document type | Document status

Title LaserStageRotation | DWG No.

Rev. | Date of issue | Sheet 1/1
