peterfelfer/Oxcart/CAD/optics-laser/laser upgrade/LaserStage/LaserStageXYZ Zeichnung v1.pdf

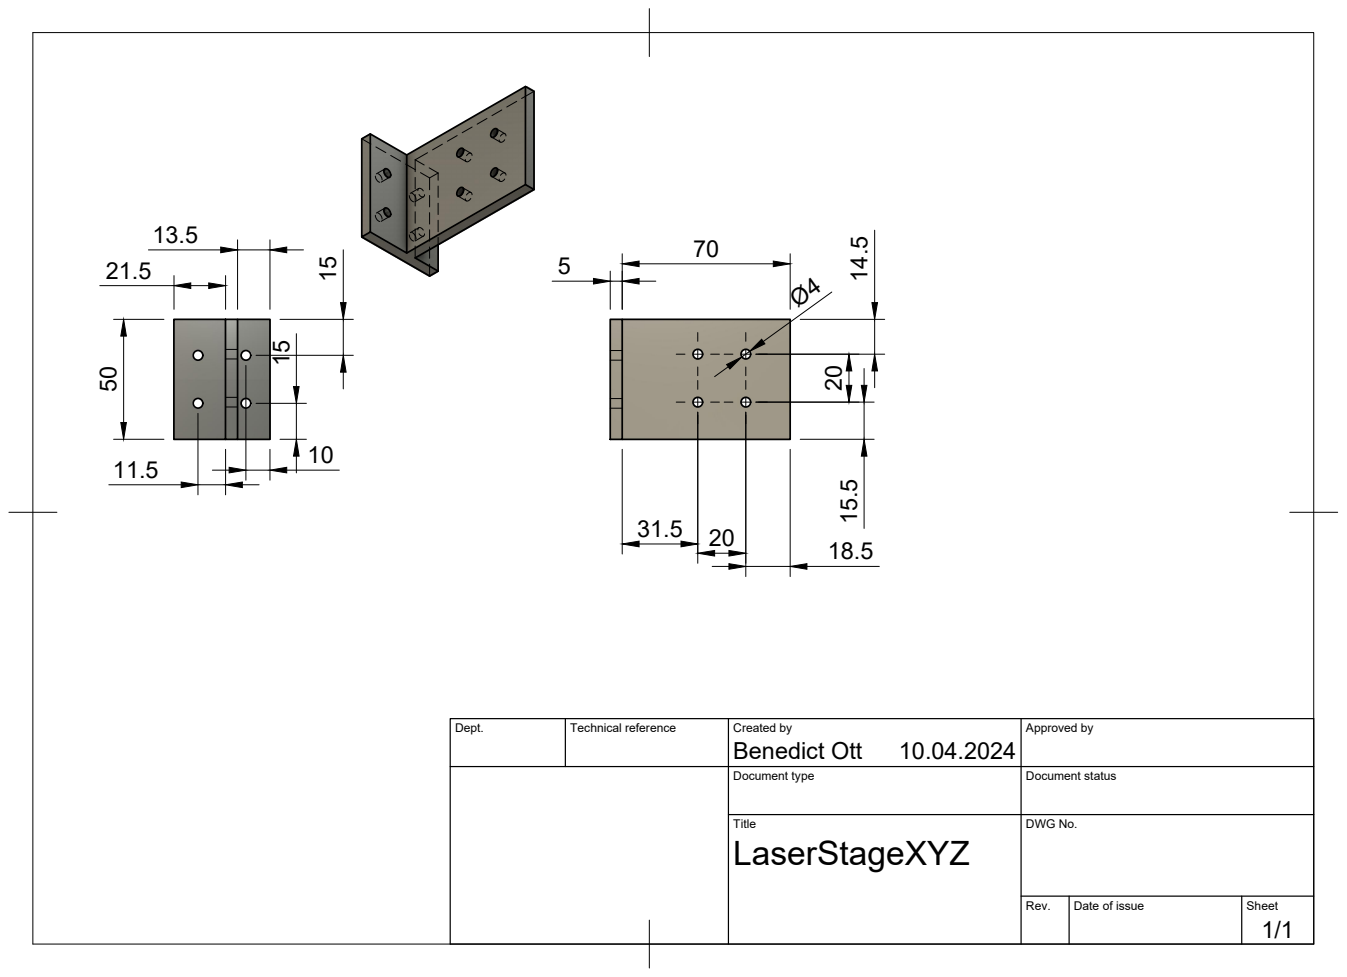
[picture p169: page 1]

Dept. | Technical reference | Created by Benedict Ott 10.04.2024 | Approved by

Document type | Document status

Title LaserStageXYZ | DWG No.

Rev. | Date of issue | Sheet 1/1
