peterfelfer/Oxcart/CAD/machining/CY7 diode clamp Drawing v1.pdf

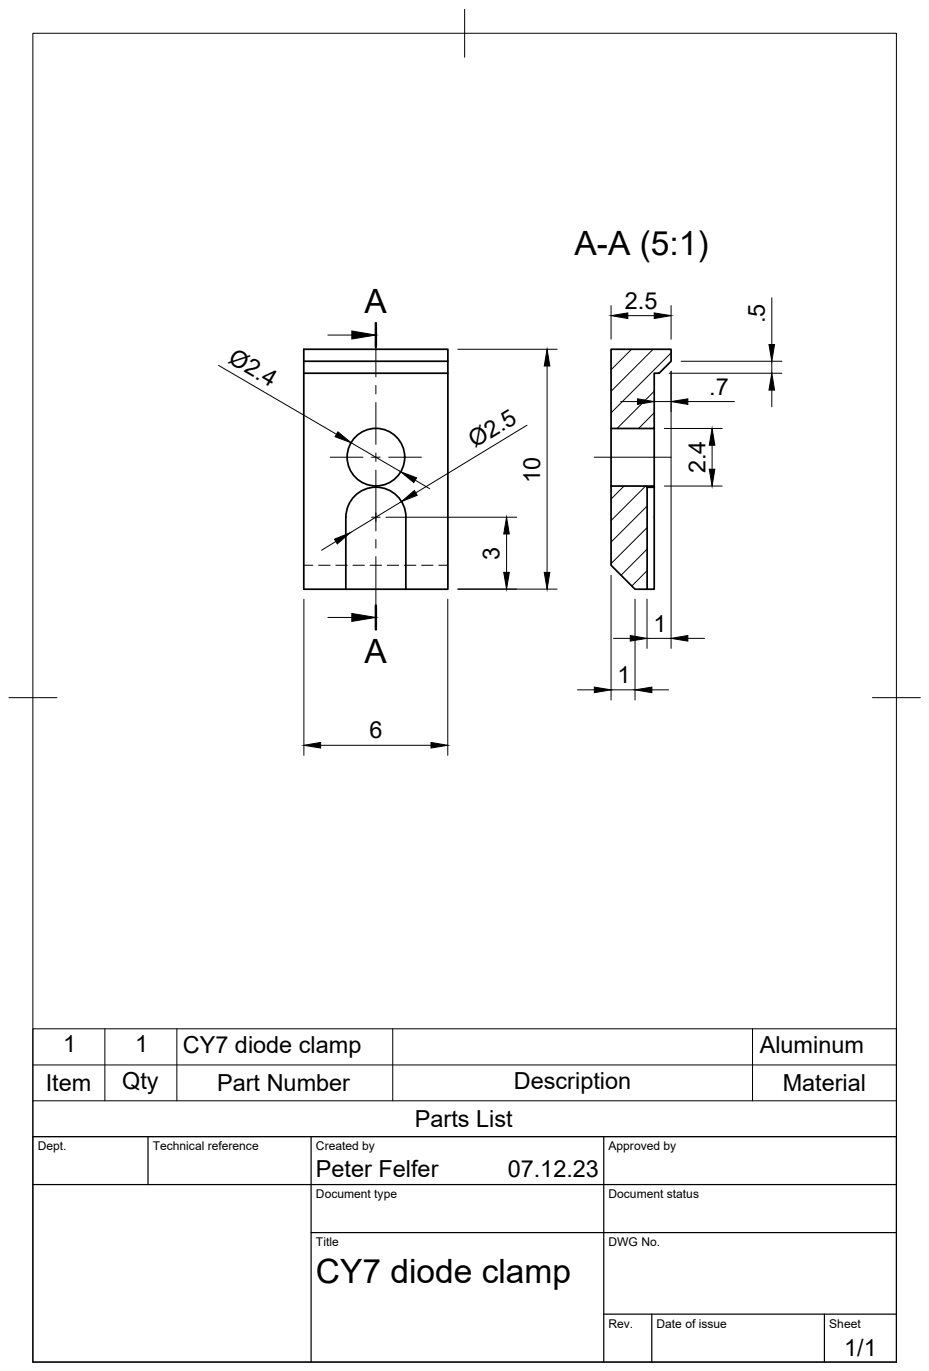
[picture p170: page 1]
Parts List

1 | 1 | CY7 diode clamp | | Aluminum
Item | Qty | Part Number | Description | Material

Dept. | Technical reference | Created by Peter Felfer 07.12.23 | Approved by

Document type | Document status

Title CY7 diode clamp | DWG No.

Rev. | Date of issue | Sheet 1/1
