peterfelfer/Oxcart/CAD/cryo/cryo system MC/butted insulation tube Drawing v1.pdf

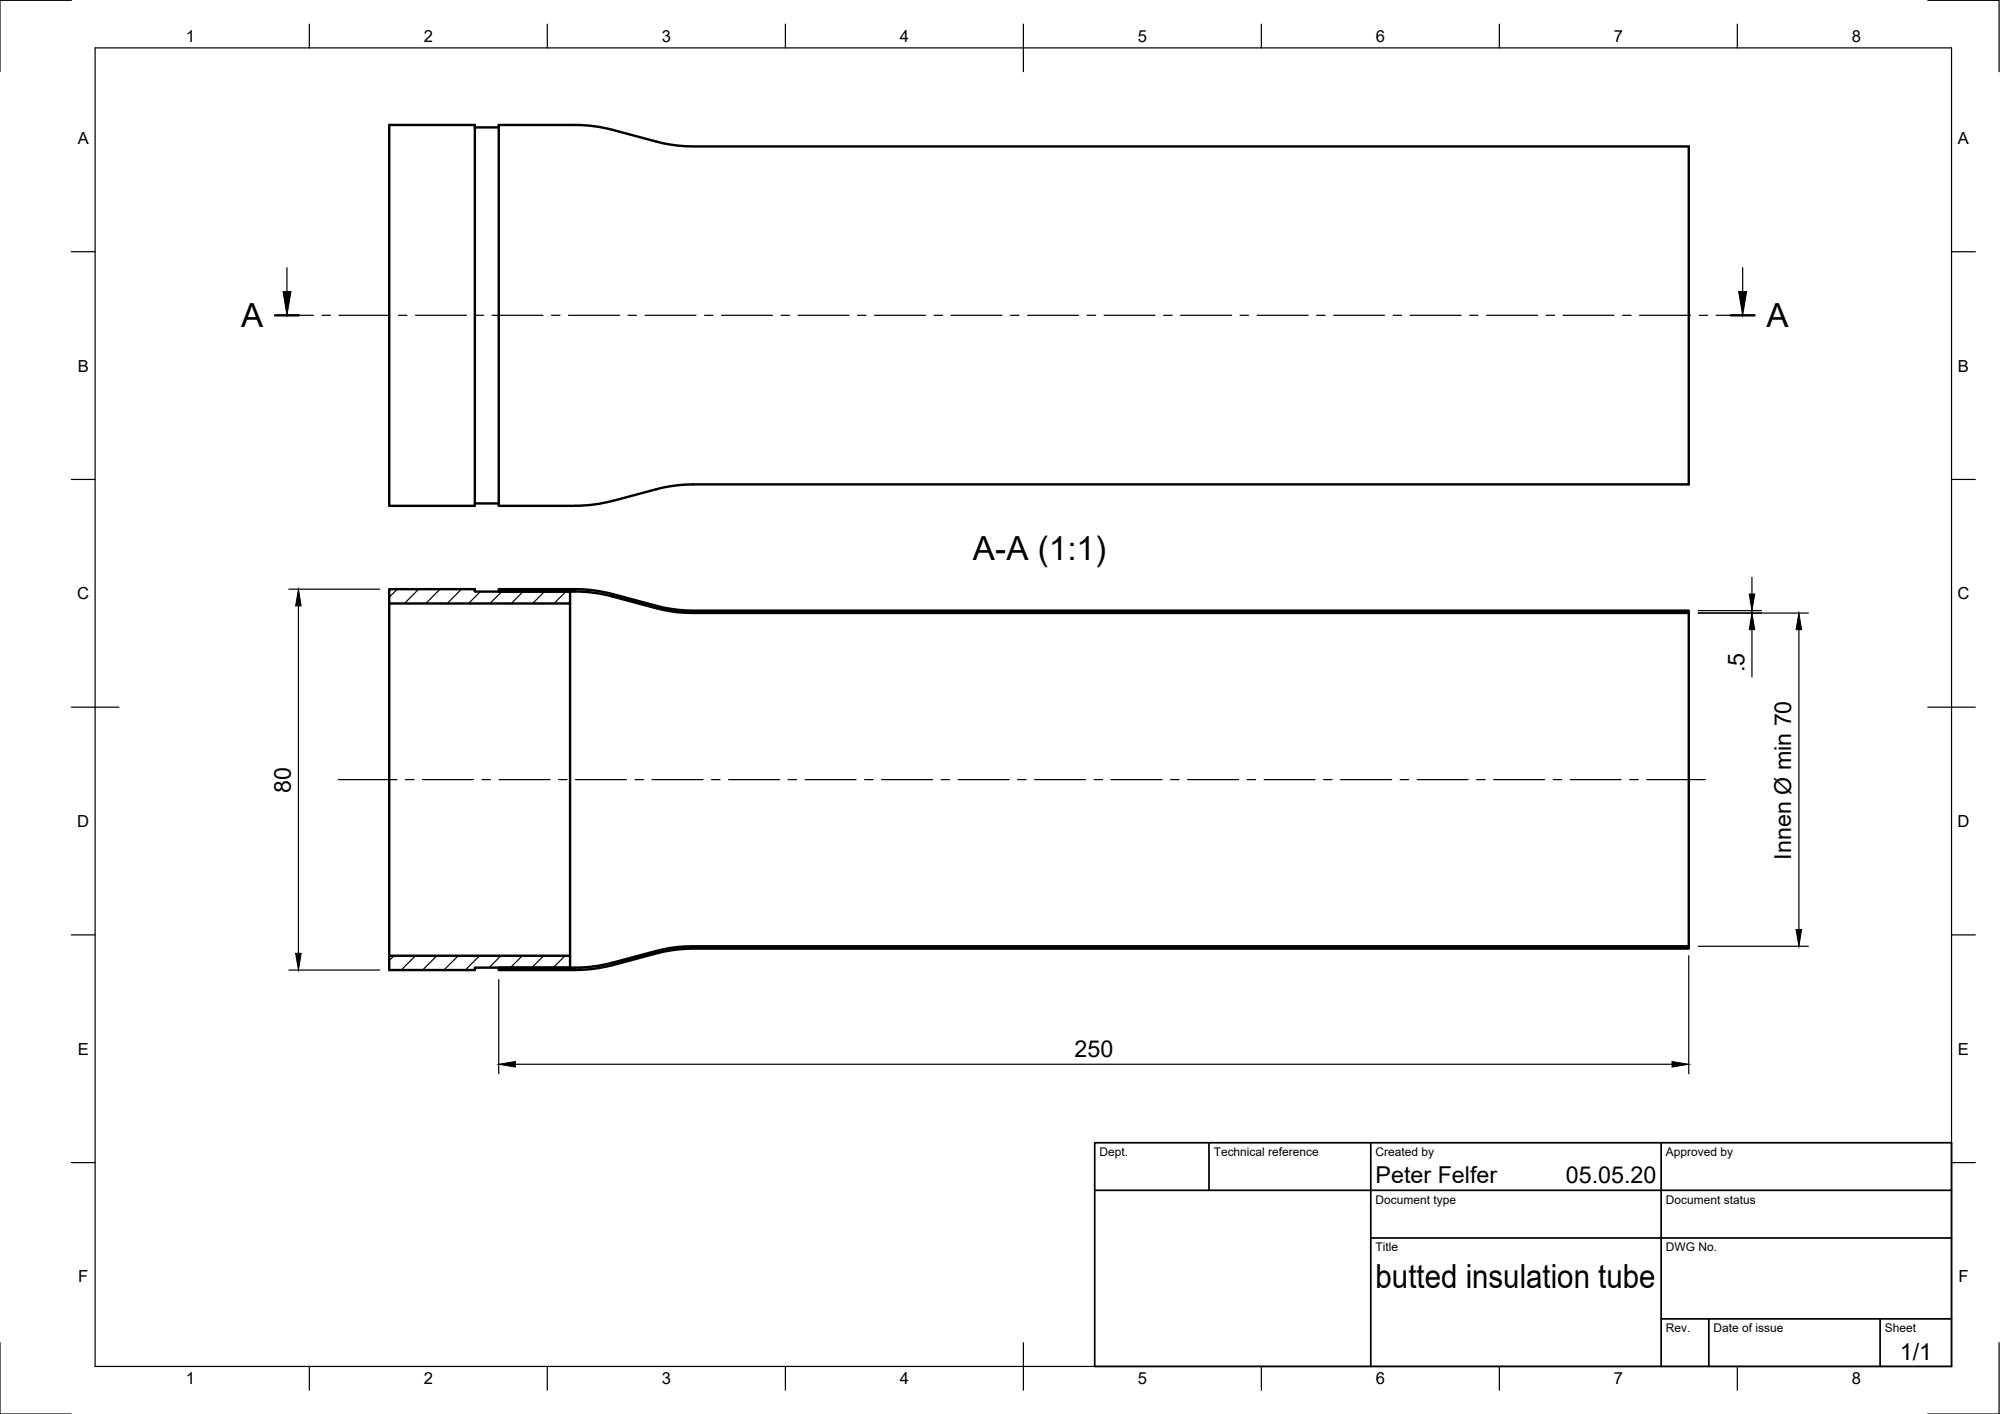
[picture p171: page 1]
Innen Ø min 70

Dept. | Technical reference | Created by Peter Felfer 05.05.20 | Approved by

Document type | Document status

Title butted insulation tube | DWG No.

Rev. | Date of issue | Sheet 1/1
