peterfelfer/Oxcart/CAD/cryo/cryo system MC/clamp Drawing v4.pdf

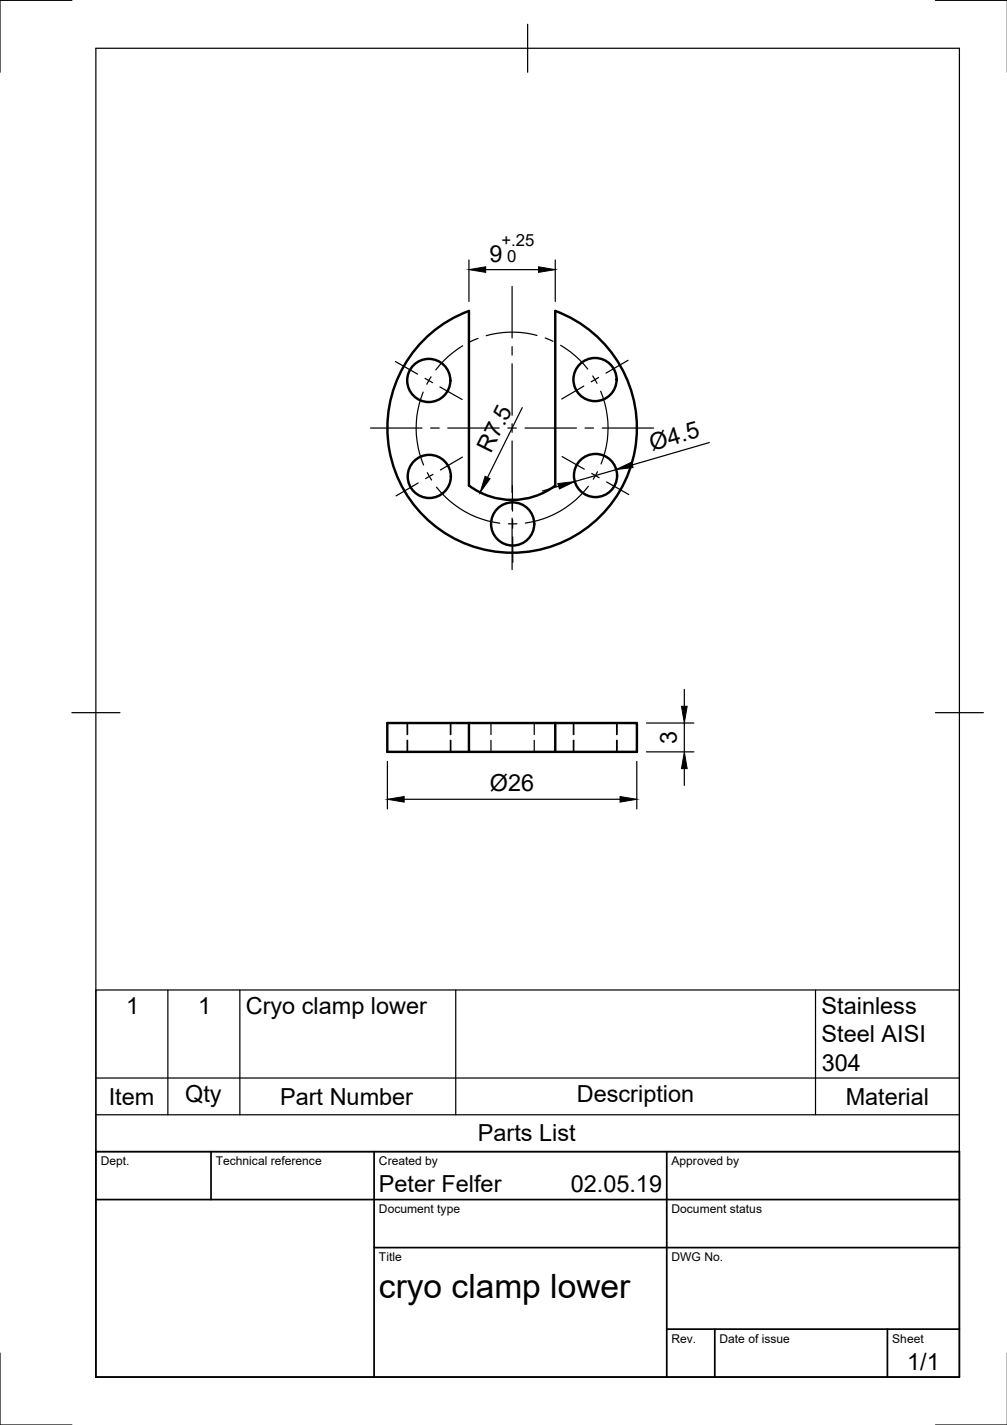
[picture p172: page 1]
Parts List

1 | 1 | Cryo clamp lower | | Stainless Steel AISI 304

Item | Qty | Part Number | Description | Material

Dept. | Technical reference | Created by Peter Felfer 02.05.19 | Approved by

Document type | Document status

Title cryo clamp lower | DWG No.

Rev. | Date of issue | Sheet 1/1
