peterfelfer/Oxcart/CAD/cryo/cryo system MC/cryo boom 2 Drawing v2.pdf

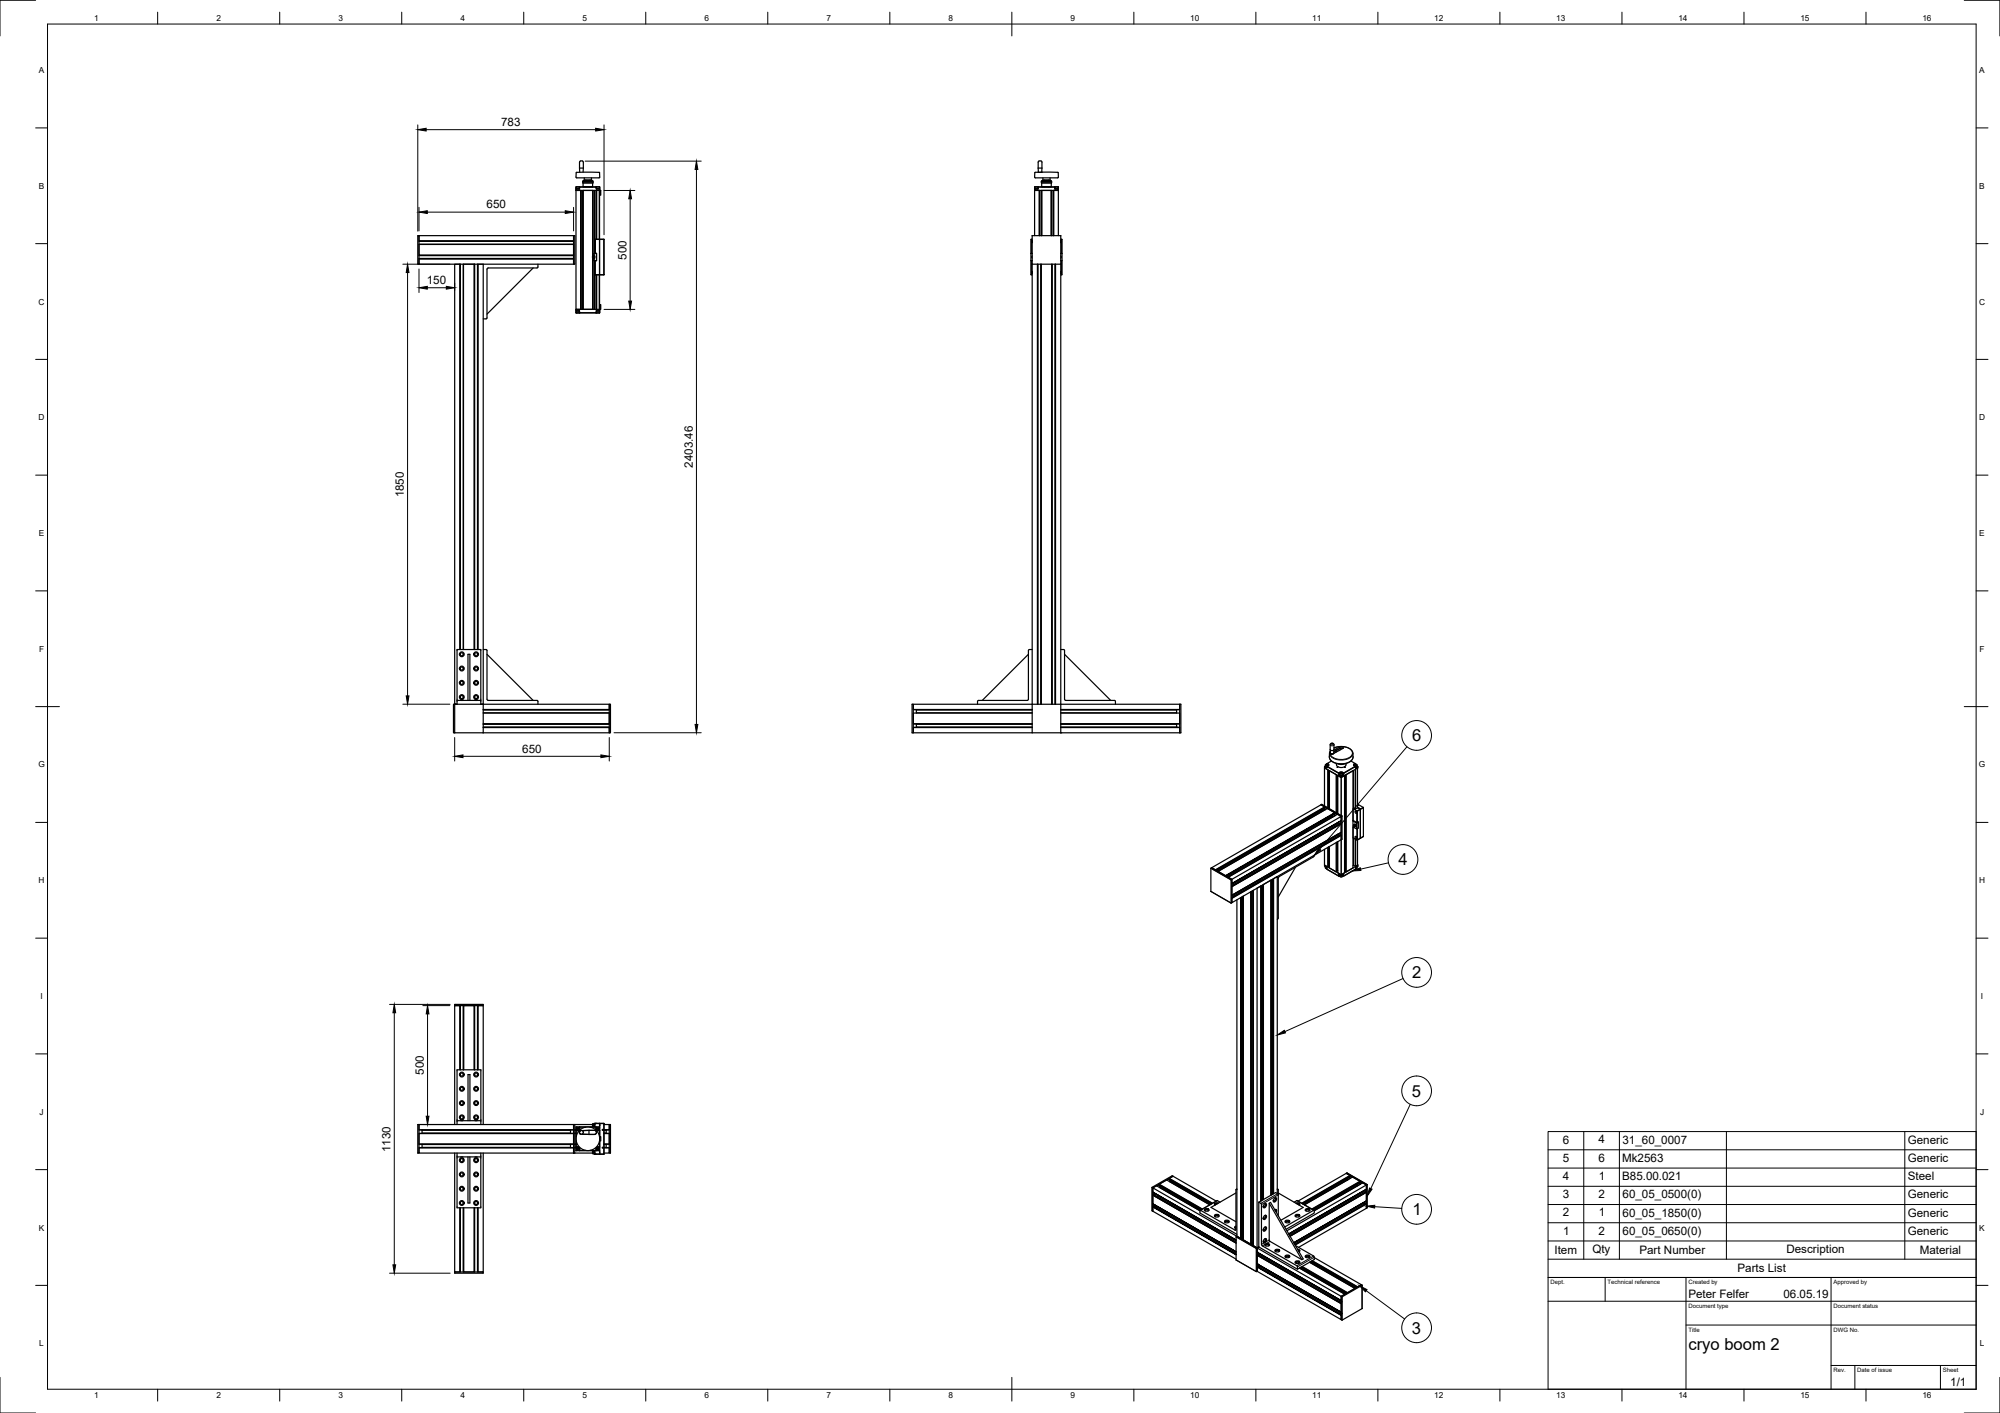
[picture p173: page 1]
Peter Felfer 1; 16 BACDEFGHIJKL; BACDEFGHIJKL; Parts List; Item; Qty; Part Number; Description; Material 1; Generic 2; Generic 3; Generic 4; Steel 5; Generic 6; Generic 3152 4 6 500

Dept. | Technical reference | Created by 06.05.19 | Approved by

Document type | Document status

Title cryo boom 2 | DWG No.

Rev. | Date of issue | Sheet 1/1
