peterfelfer/Oxcart/CAD/cryo/cryo system MC/cryo boom console Drawing v2.pdf

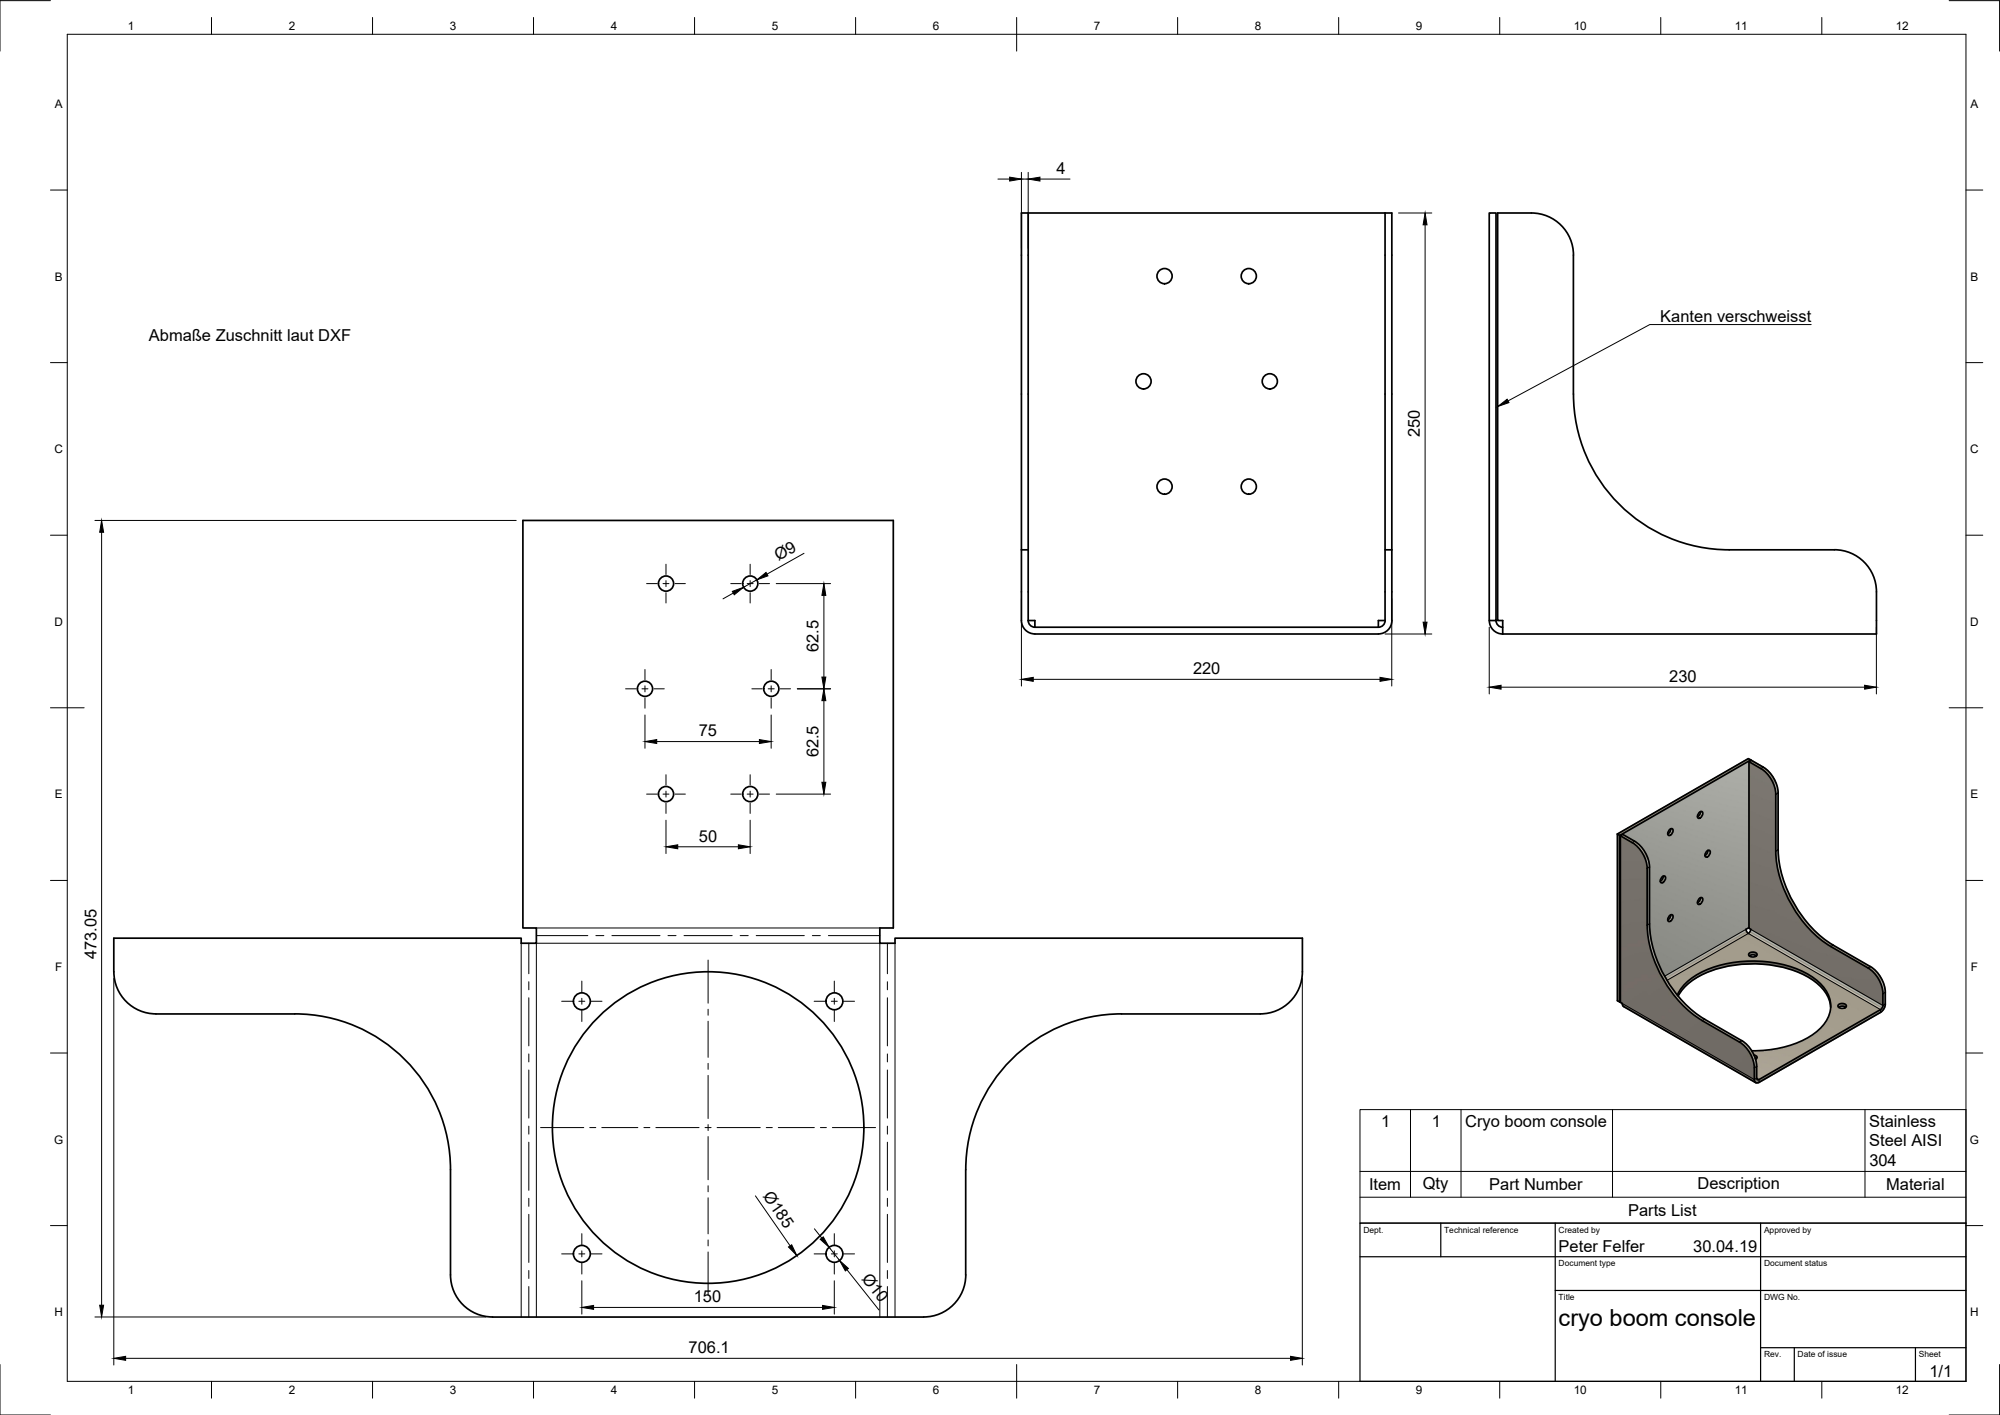
[picture p174: page 1]
Peter Felfer 473.05; Kanten verschweisst; Parts List

Abmaße Zuschnitt laut DXF

1 | 1 | Cryo boom console | | Stainless Steel AISI 304

Item | Qty | Part Number | Description | Material

Dept. | Technical reference | Created by 30.04.19 | Approved by

Document type | Document status

Title cryo boom console | DWG No.

Rev. | Date of issue | Sheet 1/1
