peterfelfer/Oxcart/CAD/cryo/cryo system MC/cryo boom Drawing v1.pdf

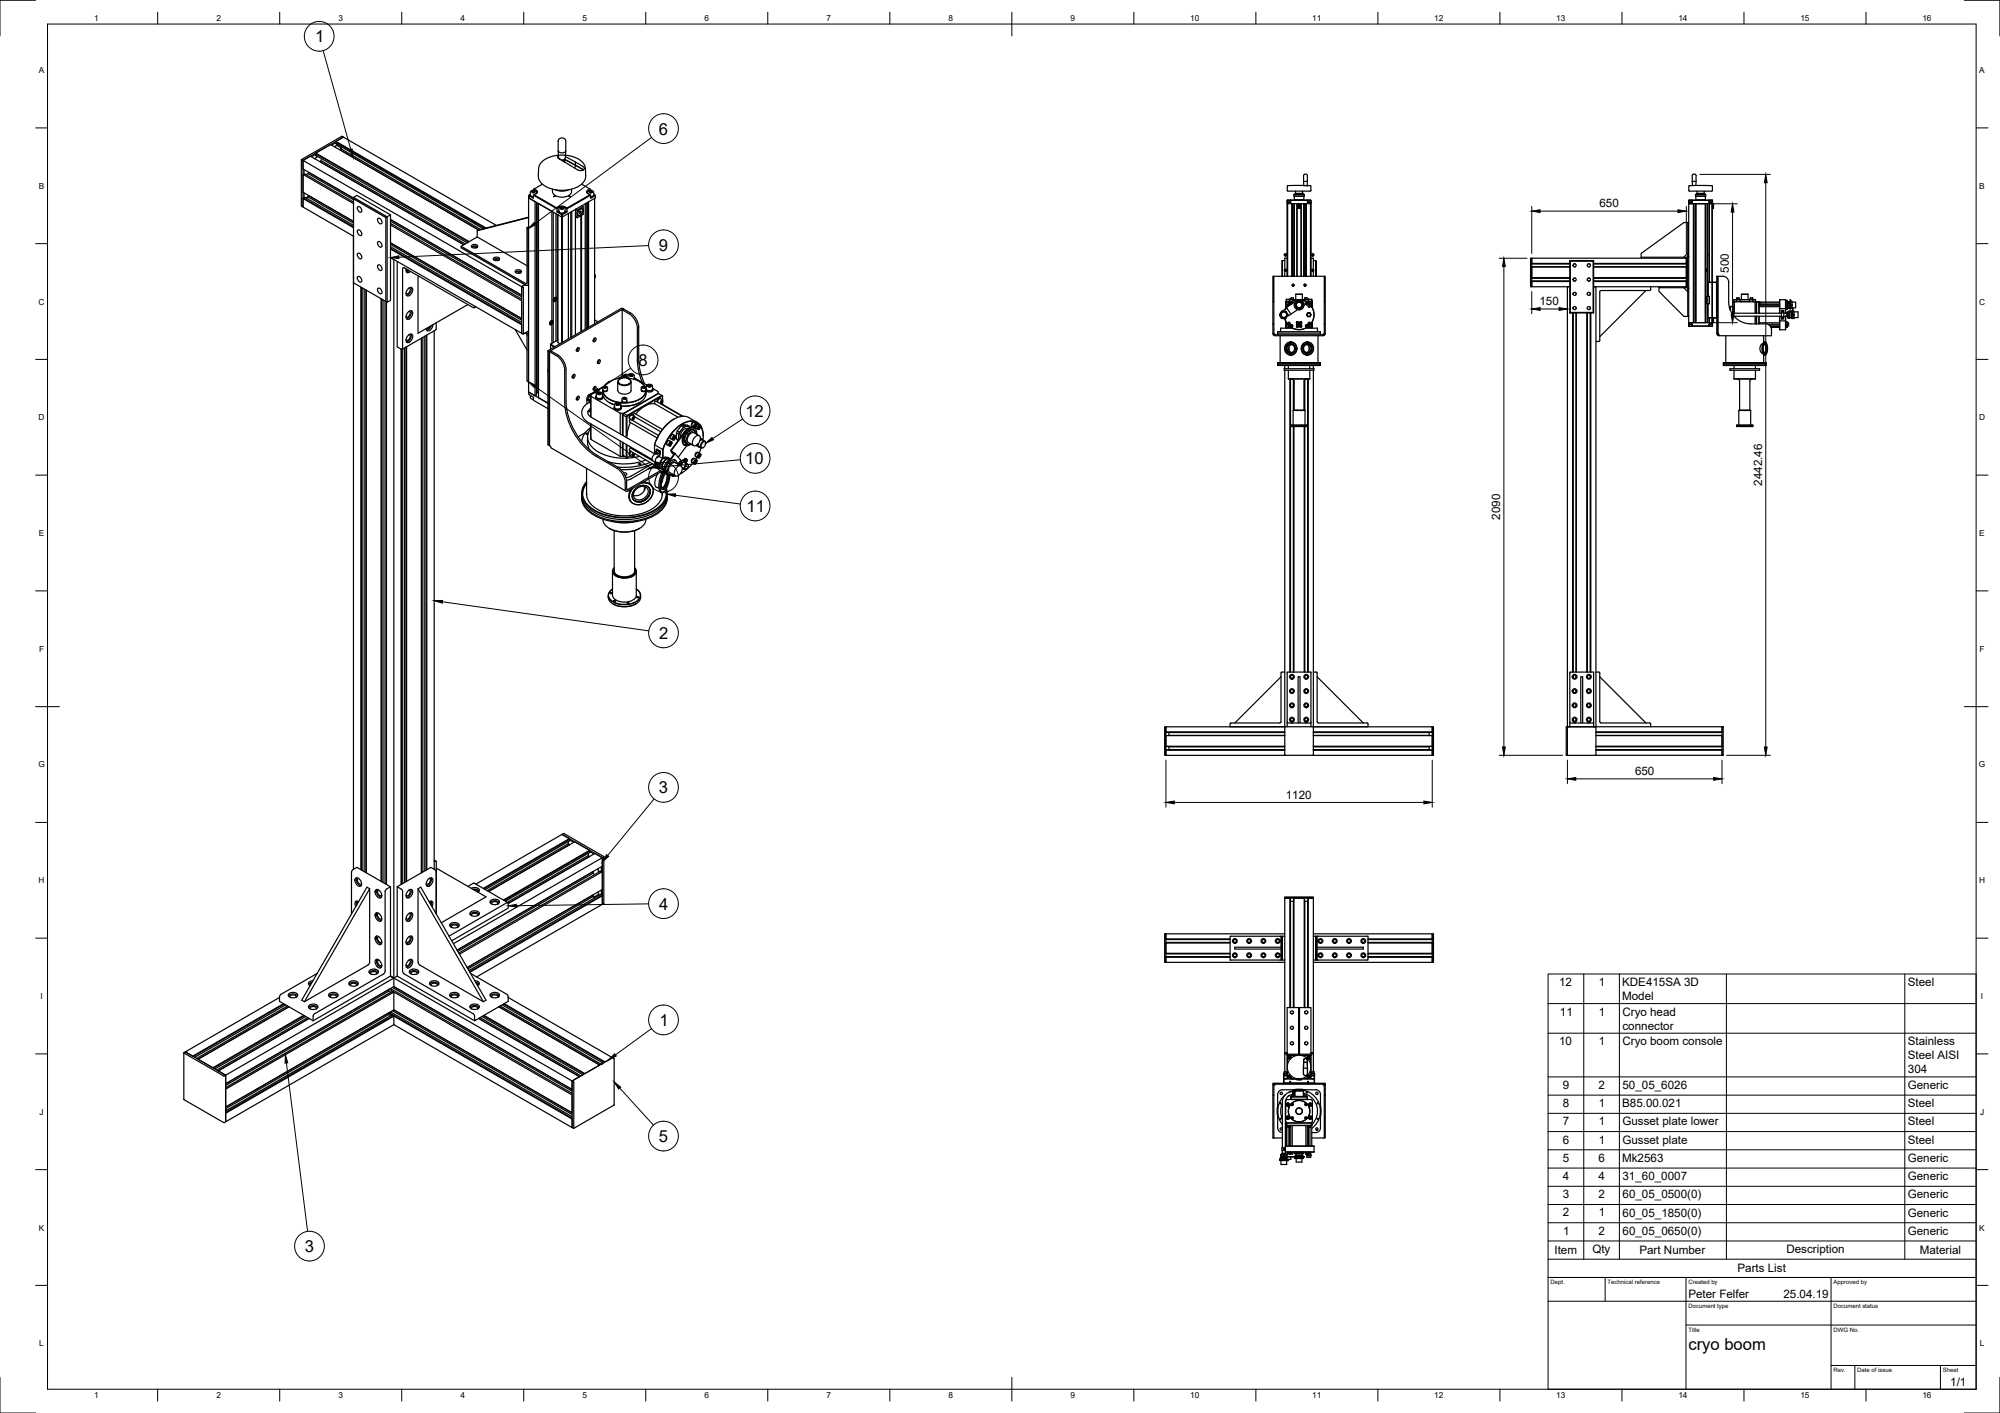
[picture p175: page 1]
16 BACDEFGHIJKL; BACDEFGHIJKL; Dept.; Technical reference; Created by; Approved by; Document type; Document status; Title; DWG No.; Rev.; Date of issue; Sheet; cryo boom; Peter Felfer; Parts List; Item; Qty; Part Number; Description; Material 1; Generic 2; Generic 3; Generic 4; Generic 5; Generic 6; Gusset plate; Steel 7; Gusset plate lower; Steel 8; Steel 9; Generic; Cryo boom console; Stainless; Steel AISI; Cryo head; KDE415SA 3D; Steel 51432 8 796
