peterfelfer/Oxcart/CAD/cryo/cryo system MC/cryo clamp upper Drawing v2.pdf

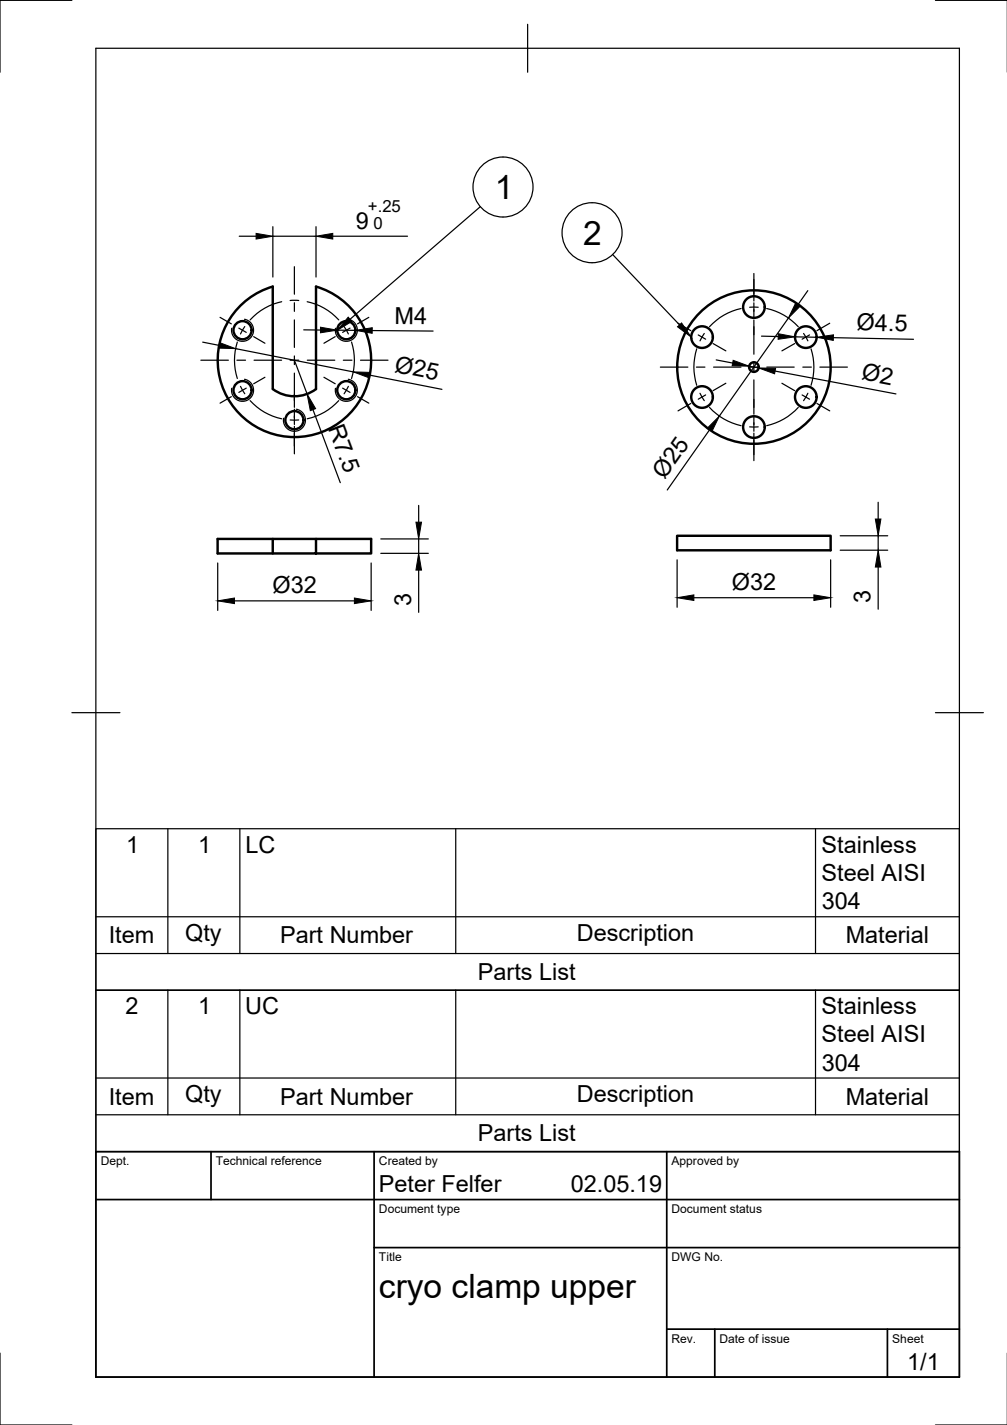
[picture p176: page 1]
Parts List

1 | 1 | LC | | Stainless Steel AISI 304

Item | Qty | Part Number | Description | Material

2 | 1 | UC | | Stainless Steel AISI 304

Dept. | Technical reference | Created by Peter Felfer 02.05.19 | Approved by

Document type | Document status

Title cryo clamp upper | DWG No.

Rev. | Date of issue | Sheet 1/1
