peterfelfer/Oxcart/CAD/cryo/cryo system MC/cryo contact clamp Drawing v1.pdf

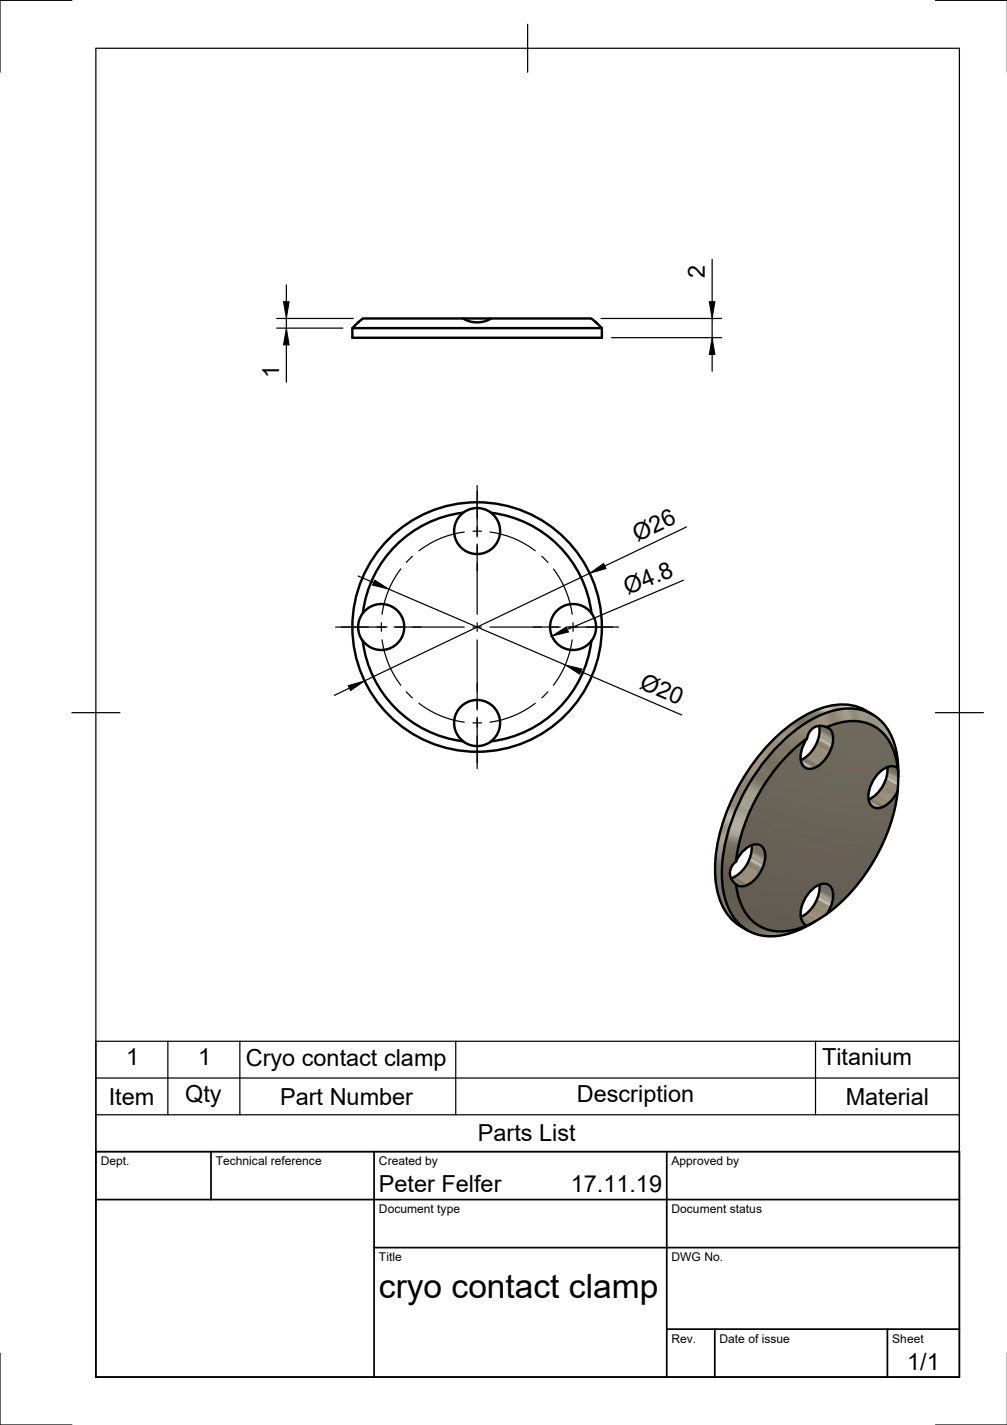
[picture p177: page 1]
Parts List

1 | 1 | Cryo contact clamp | | Titanium
Item | Qty | Part Number | Description | Material

Dept. | Technical reference | Created by Peter Felfer 17.11.19 | Approved by

Document type | Document status

Title cryo contact clamp | DWG No.

Rev. | Date of issue | Sheet 1/1
