peterfelfer/Oxcart/CAD/cryo/cryo system MC/cryo head clamp Drawing v4.pdf

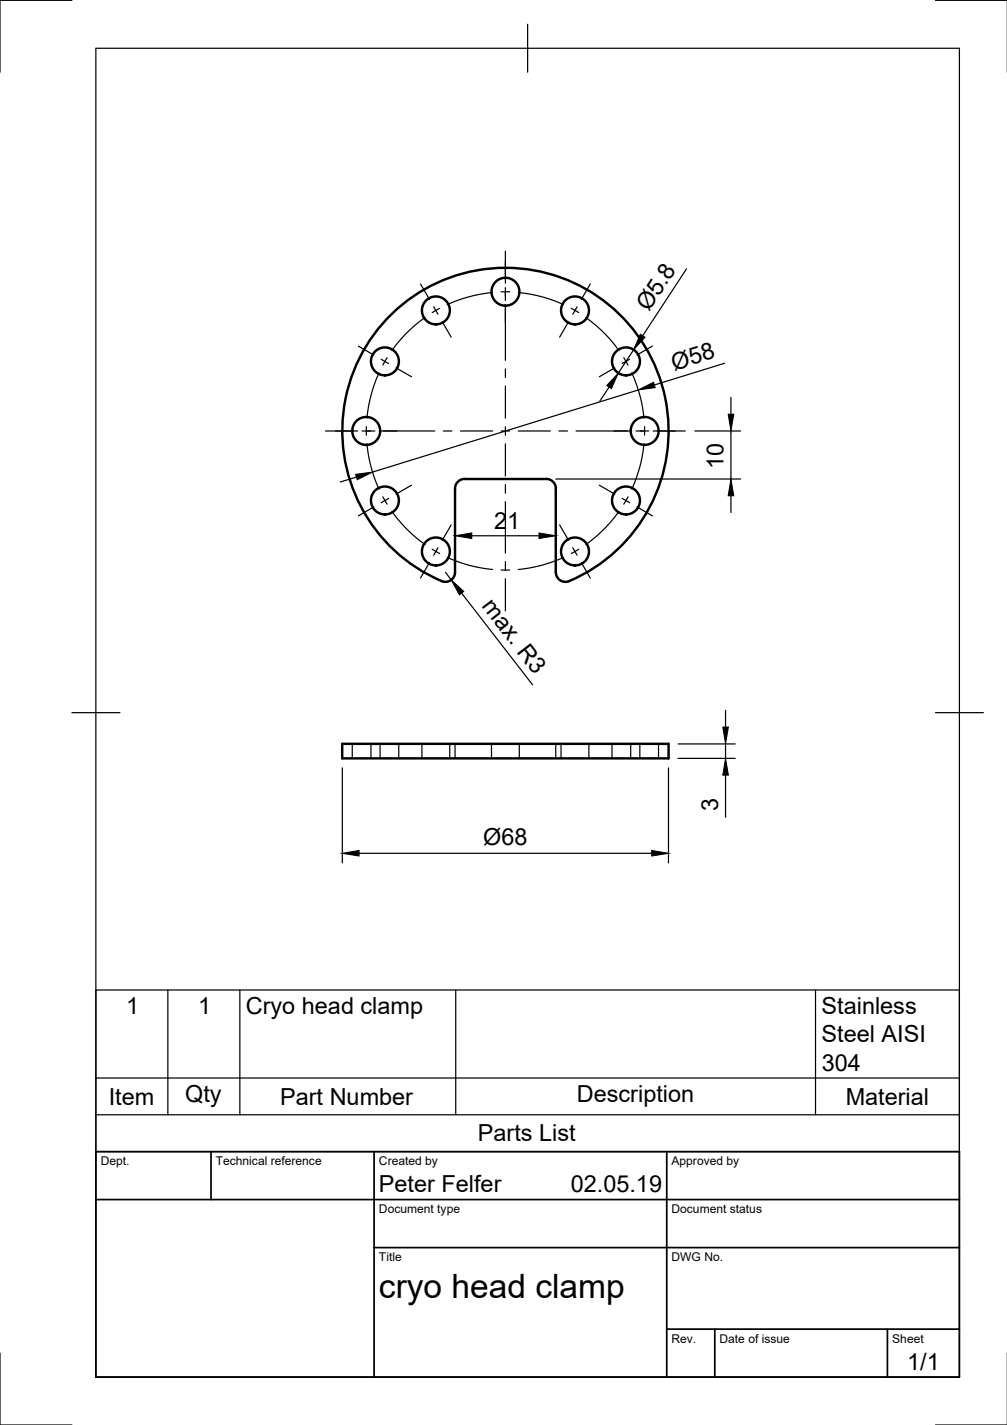
[picture p178: page 1]
max. R3; Parts List

1 | 1 | Cryo head clamp | | Stainless Steel AISI 304

Item | Qty | Part Number | Description | Material

Dept. | Technical reference | Created by Peter Felfer 02.05.19 | Approved by

Document type | Document status

Title cryo head clamp | DWG No.

Rev. | Date of issue | Sheet 1/1
