peterfelfer/Oxcart/CAD/cryo/cryo system MC/Cryo head connector Drawing v10.pdf

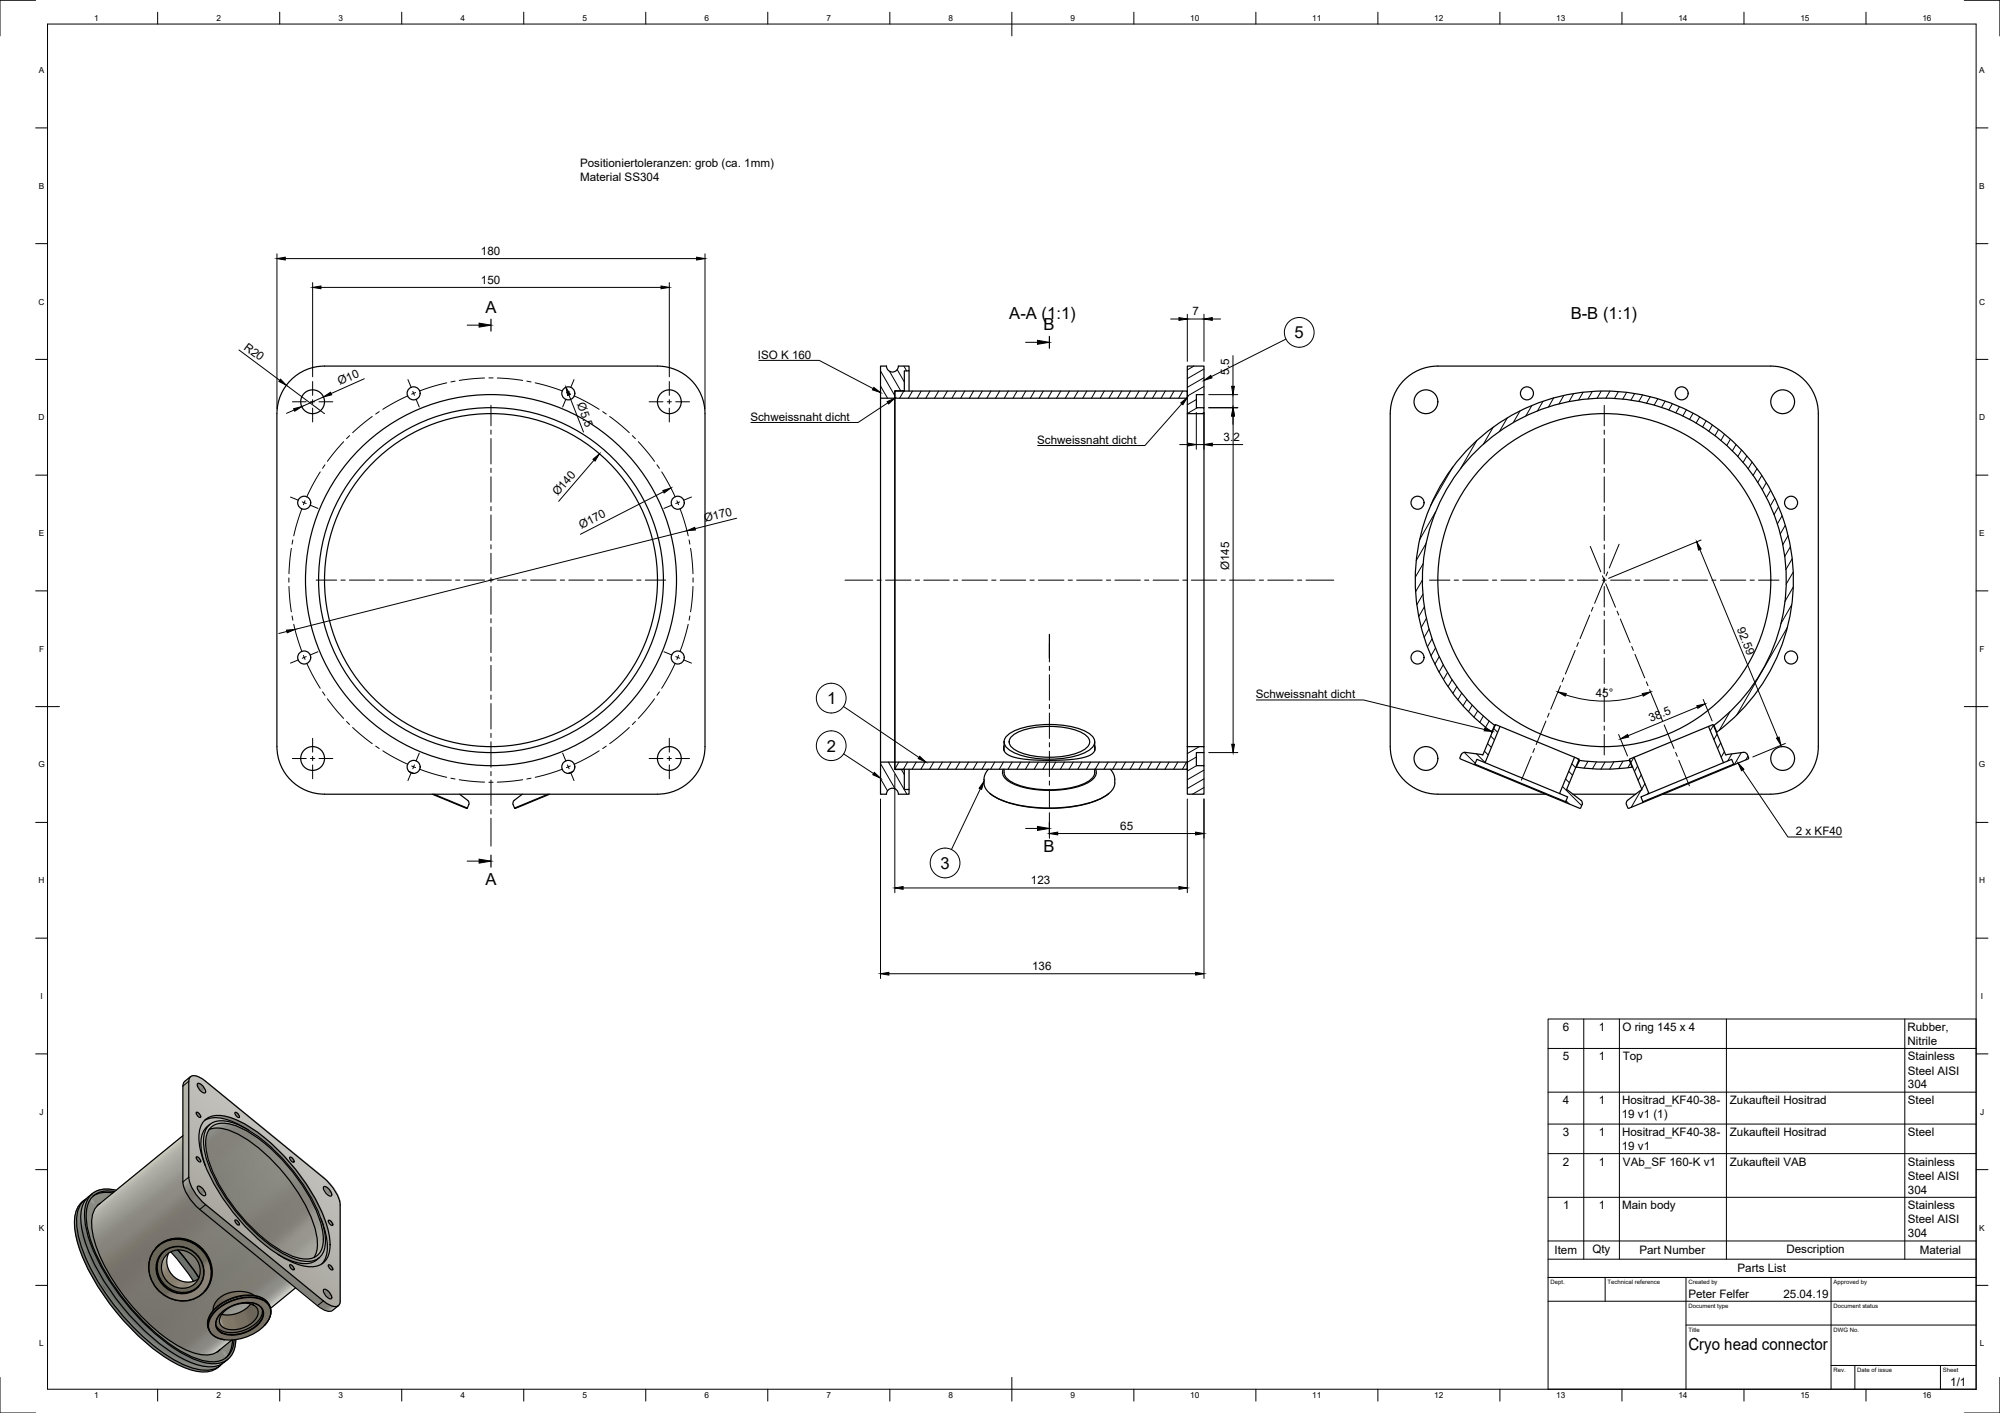
[picture p179: page 1]
ISO K 160; Schweissnaht dicht; Parts List

Positioniertoleranzen: grob (ca. 1mm)
Material SS304

6 | 1 | O ring 145 x 4 | | Rubber, Nitrile

5 | 1 | Top | | Stainless Steel AISI 304

4 | 1 | Hositrad_KF40-38-19 v1 (1) | Zukaufteil Hositrad | Steel

3 | 1 | Hositrad_KF40-38-19 v1 | Zukaufteil Hositrad | Steel

2 | 1 | VAb_SF 160-K v1 | Zukaufteil VAB | Stainless Steel AISI 304

1 | 1 | Main body | | Stainless Steel AISI 304

Item | Qty | Part Number | Description | Material

Dept. | Technical reference | Created by Peter Felfer 25.04.19 | Approved by

Document type | Document status

Title Cryo head connector | DWG No.

Rev. | Date of issue | Sheet 1/1
