peterfelfer/Oxcart/CAD/cryo/cryo system MC/cryo head diode and heater mount Drawing v1.pdf

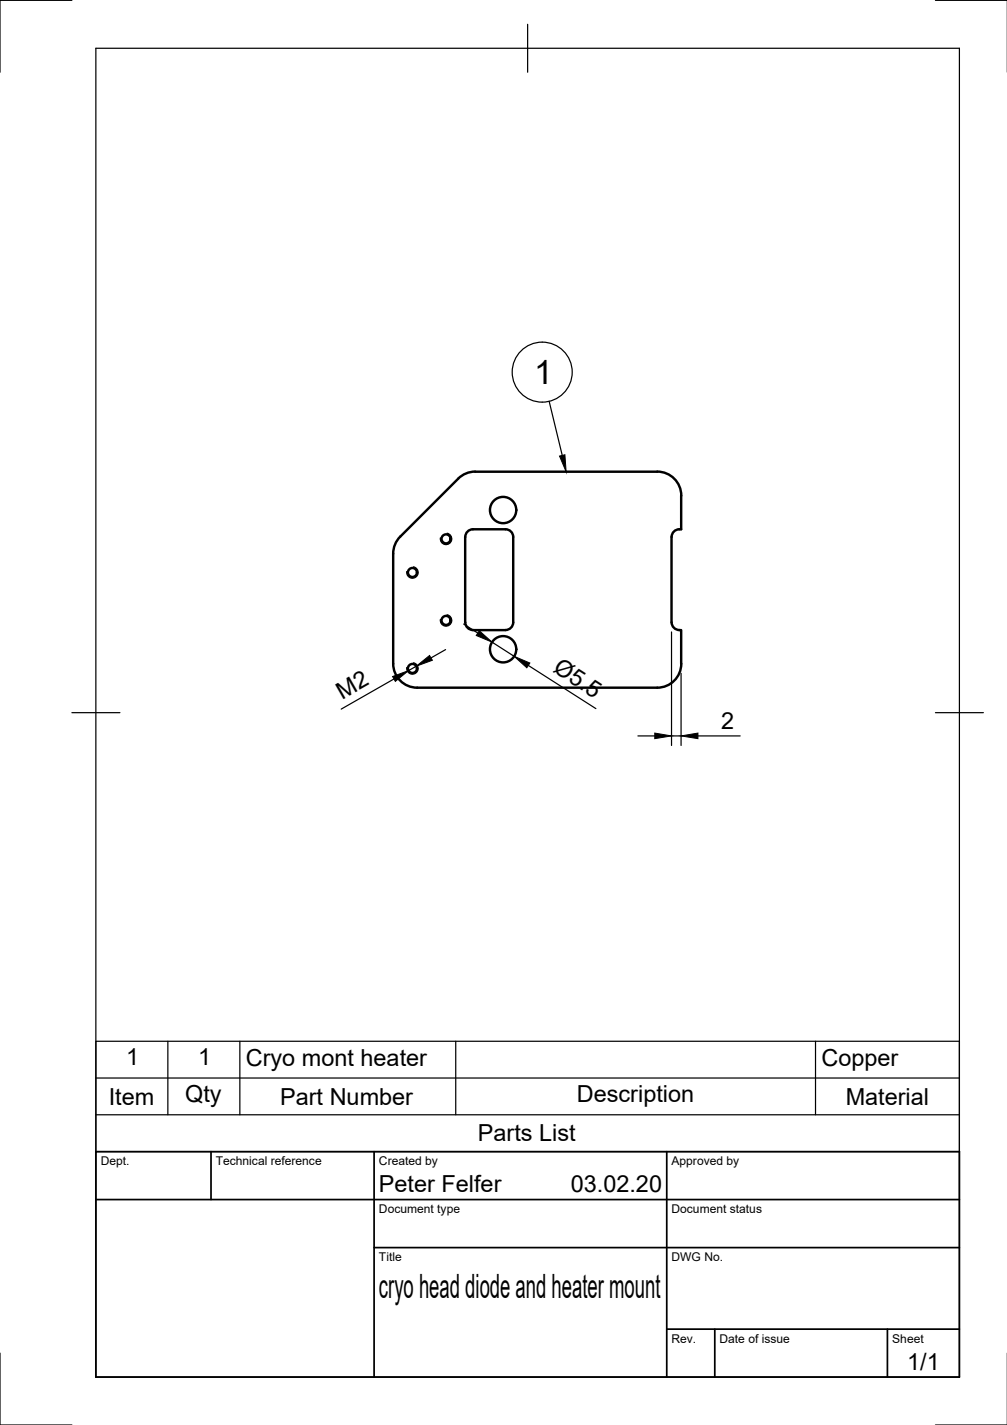
[picture p180: page 1]
Parts List

1 | 1 | Cryo mont heater | | Copper
Item | Qty | Part Number | Description | Material

Dept. | Technical reference | Created by Peter Felfer 03.02.20 | Approved by

Document type | Document status

Title cryo head diode and heater mount | DWG No.

Rev. | Date of issue | Sheet 1/1
