peterfelfer/Oxcart/CAD/cryo/cryo system MC/cryo interface final Drawing v4.pdf

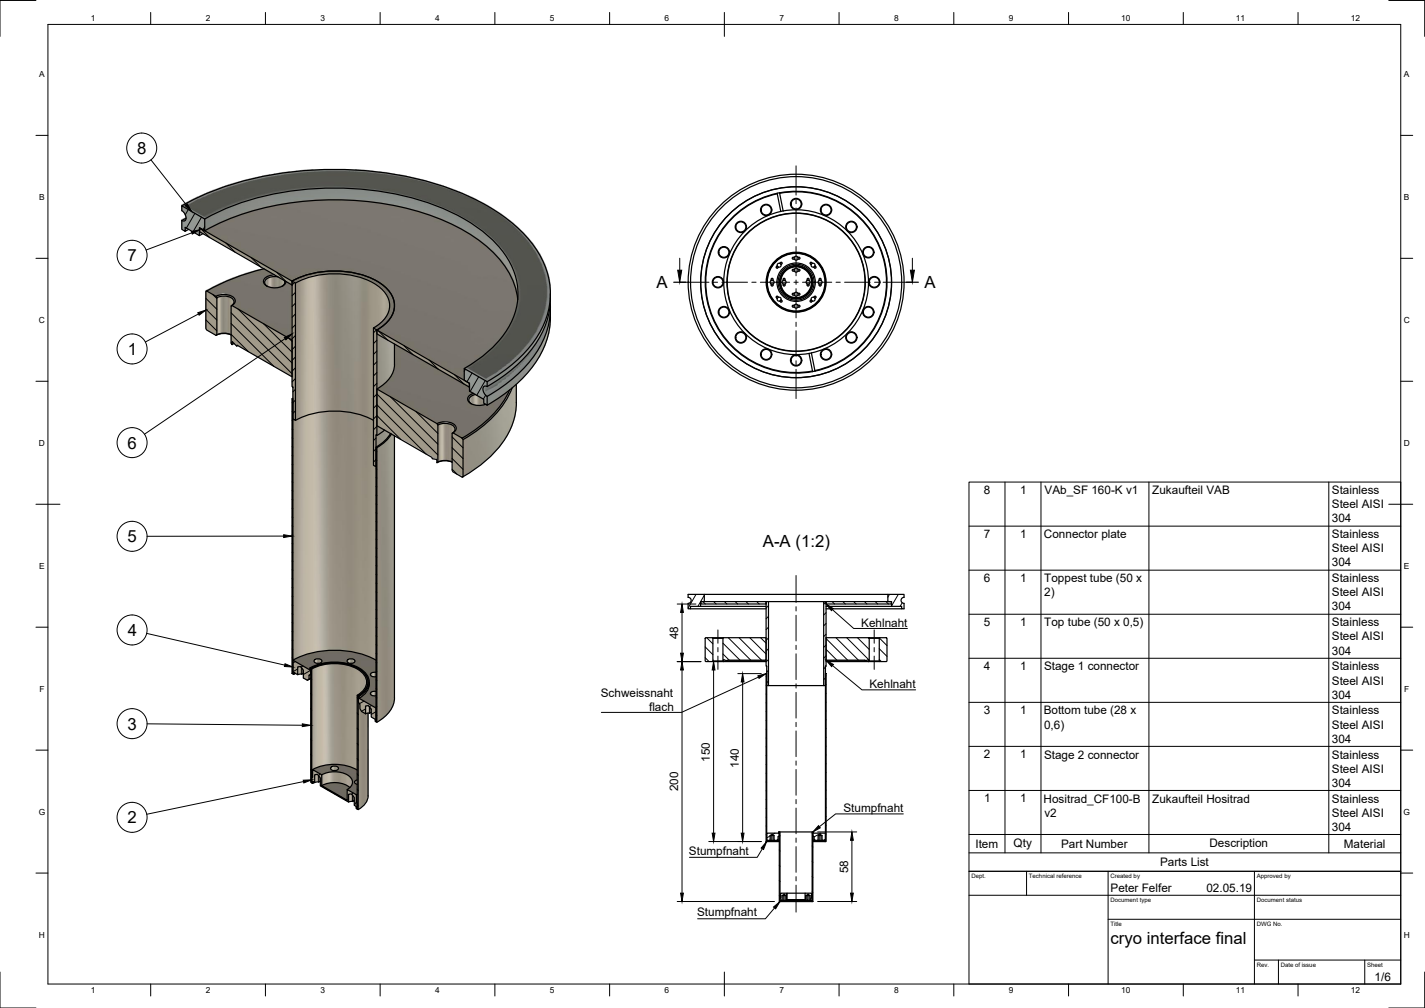
[picture p181: page 1]
Parts List; Kehlnaht Schweissnaht; Stumpfnaht 140

8 | 1 | VAb_SF 160-K v1 | Zukaufteil VAB | Stainless Steel AISI 304

7 | 1 | Connector plate | | Stainless Steel AISI 304

6 | 1 | Toppest tube (50 x 2) | | Stainless Steel AISI 304

5 | 1 | Top tube (50 x 0,5) | | Stainless Steel AISI 304

4 | 1 | Stage 1 connector | | Stainless Steel AISI 304

3 | 1 | Bottom tube (28 x 0,6) | | Stainless Steel AISI 304

2 | 1 | Stage 2 connector | | Stainless Steel AISI 304

1 | 1 | Hositrad_CF100-B v2 | Zukaufteil Hositrad | Stainless Steel AISI 304

Item | Qty | Part Number | Description | Material

Dept. | Technical reference | Created by Peter Felfer 02.05.19 | Approved by

Document type | Document status

Title cryo interface final | DWG No.

Rev. | Date of issue | Sheet

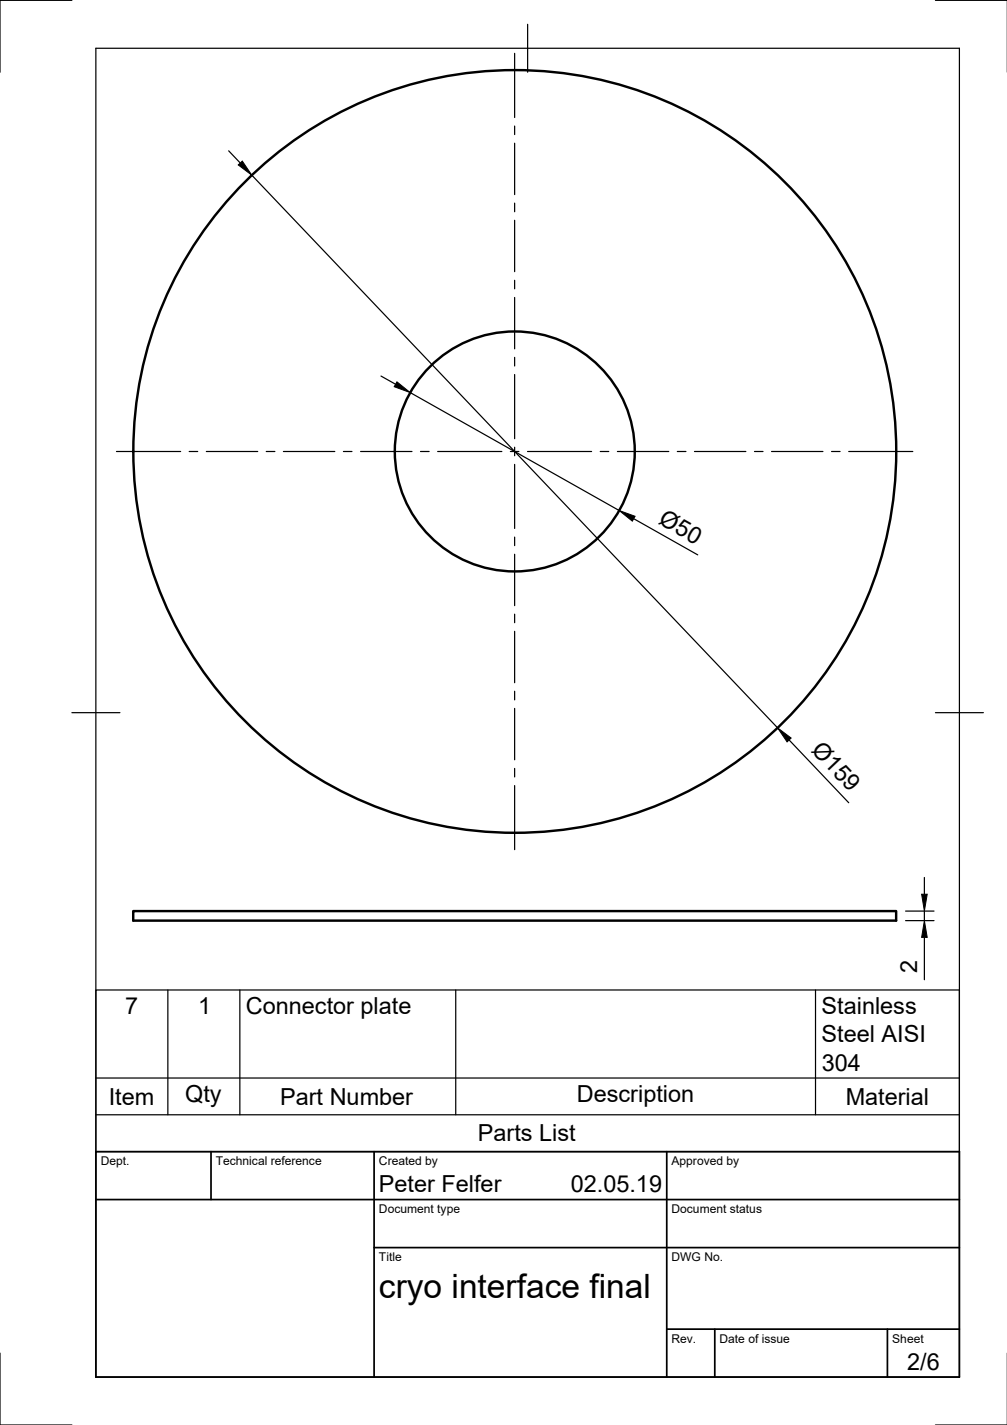
[picture p182: page 2]
Parts List

7 | 1 | Connector plate | | Stainless Steel AISI 304

Item | Qty | Part Number | Description | Material

Dept. | Technical reference | Created by Peter Felfer 02.05.19 | Approved by

Document type | Document status

Title cryo interface final | DWG No.

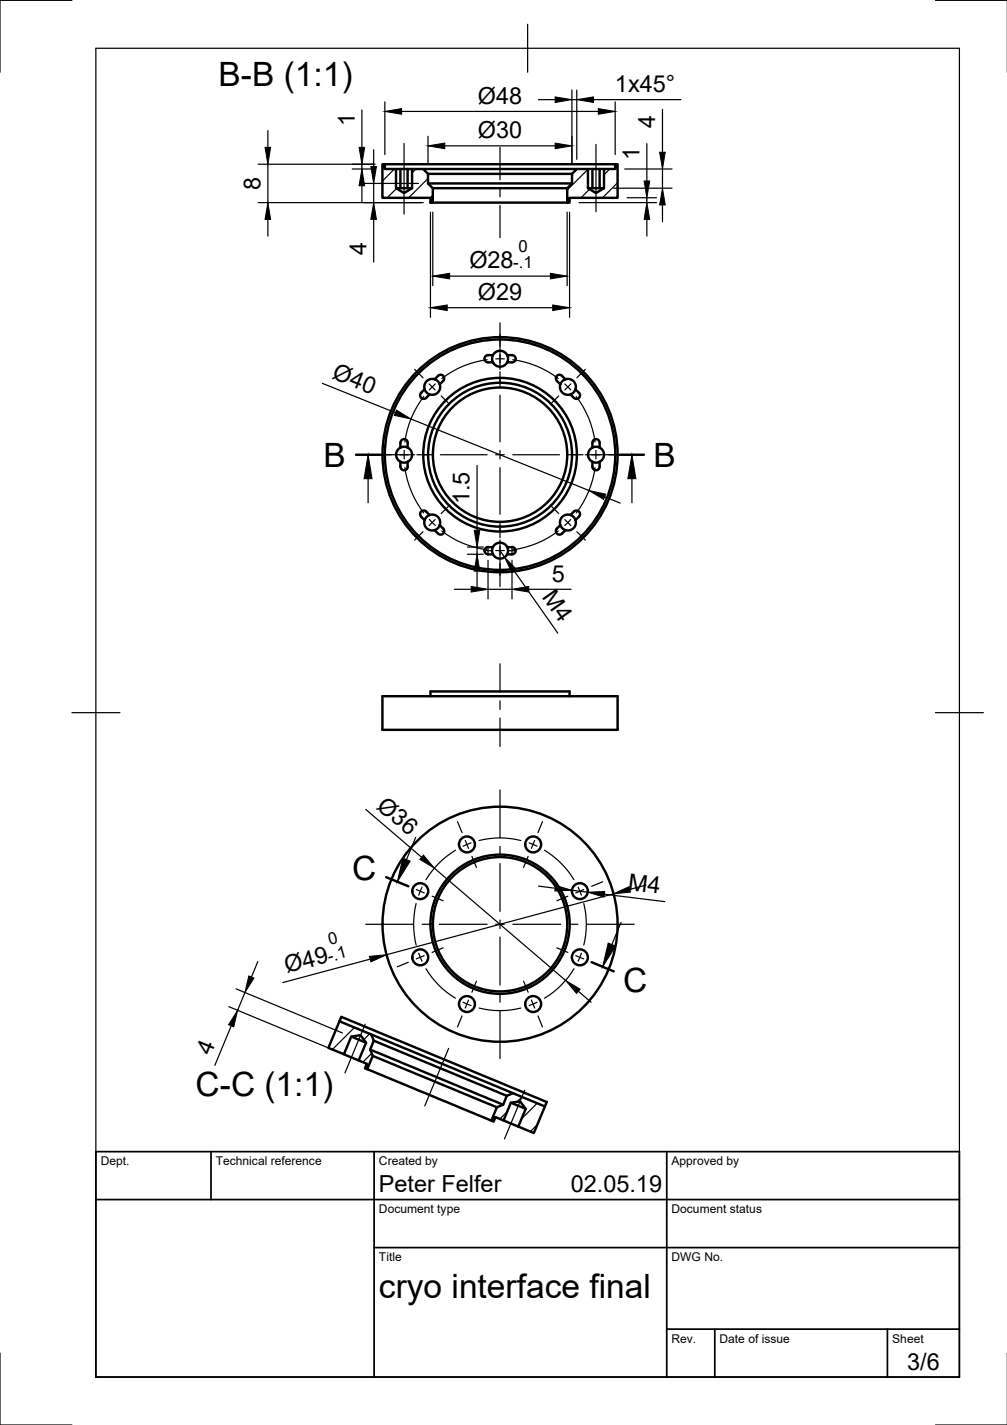
[picture p183: page 3]

Dept. | Technical reference | Created by Peter Felfer 02.05.19 | Approved by

Document type | Document status

Title cryo interface final | DWG No.

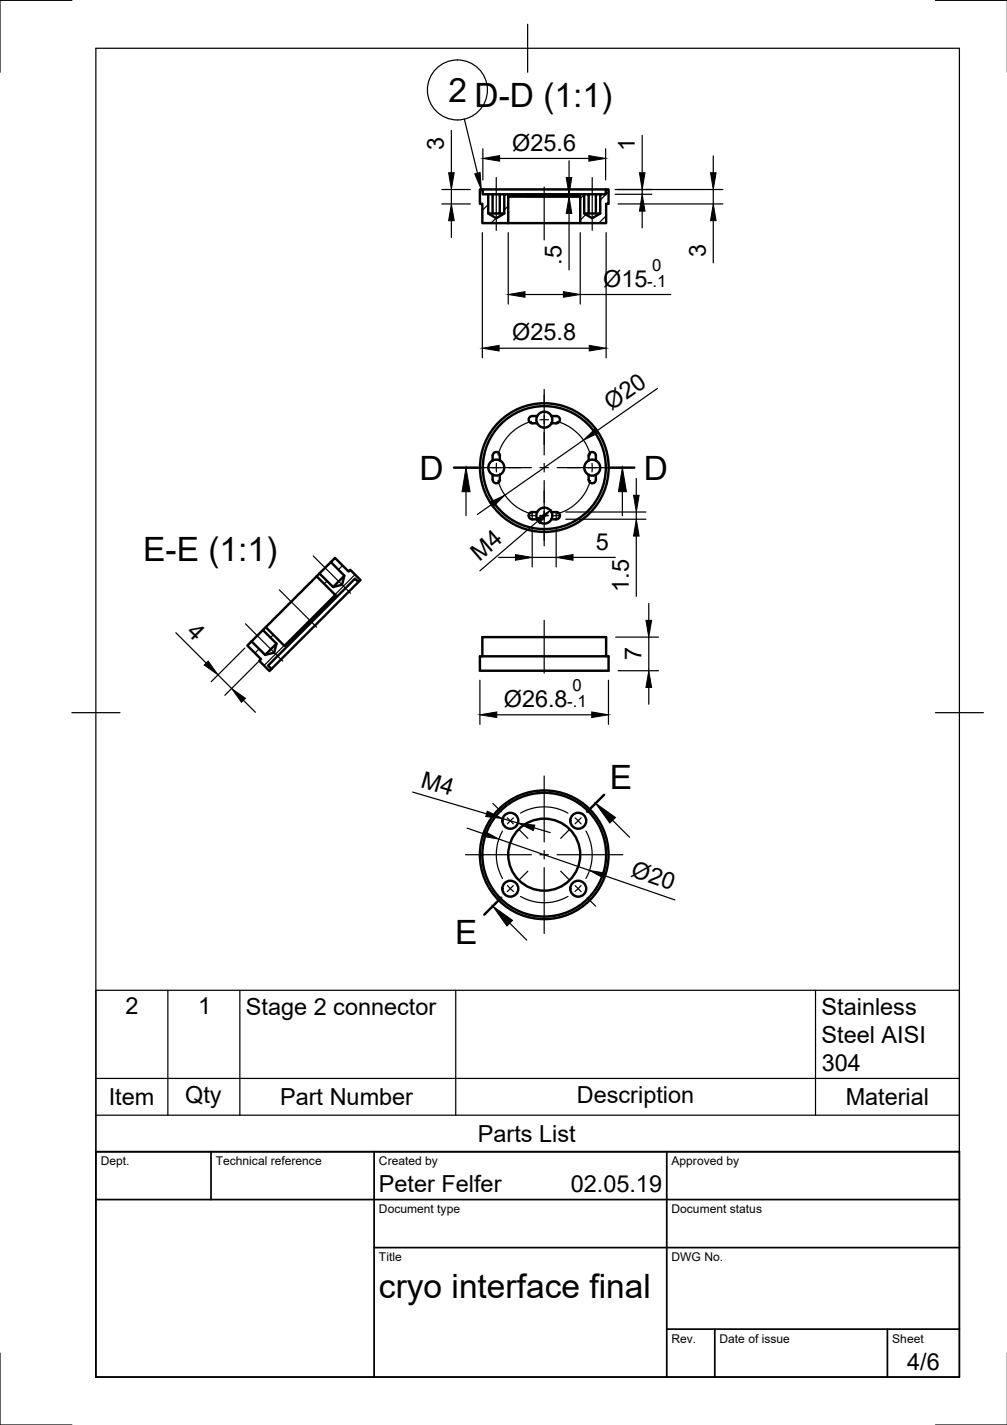
[picture p184: page 4]
Parts List

2 | 1 | Stage 2 connector | | Stainless Steel AISI 304

Item | Qty | Part Number | Description | Material

Dept. | Technical reference | Created by Peter Felfer 02.05.19 | Approved by

Document type | Document status

Title cryo interface final | DWG No.

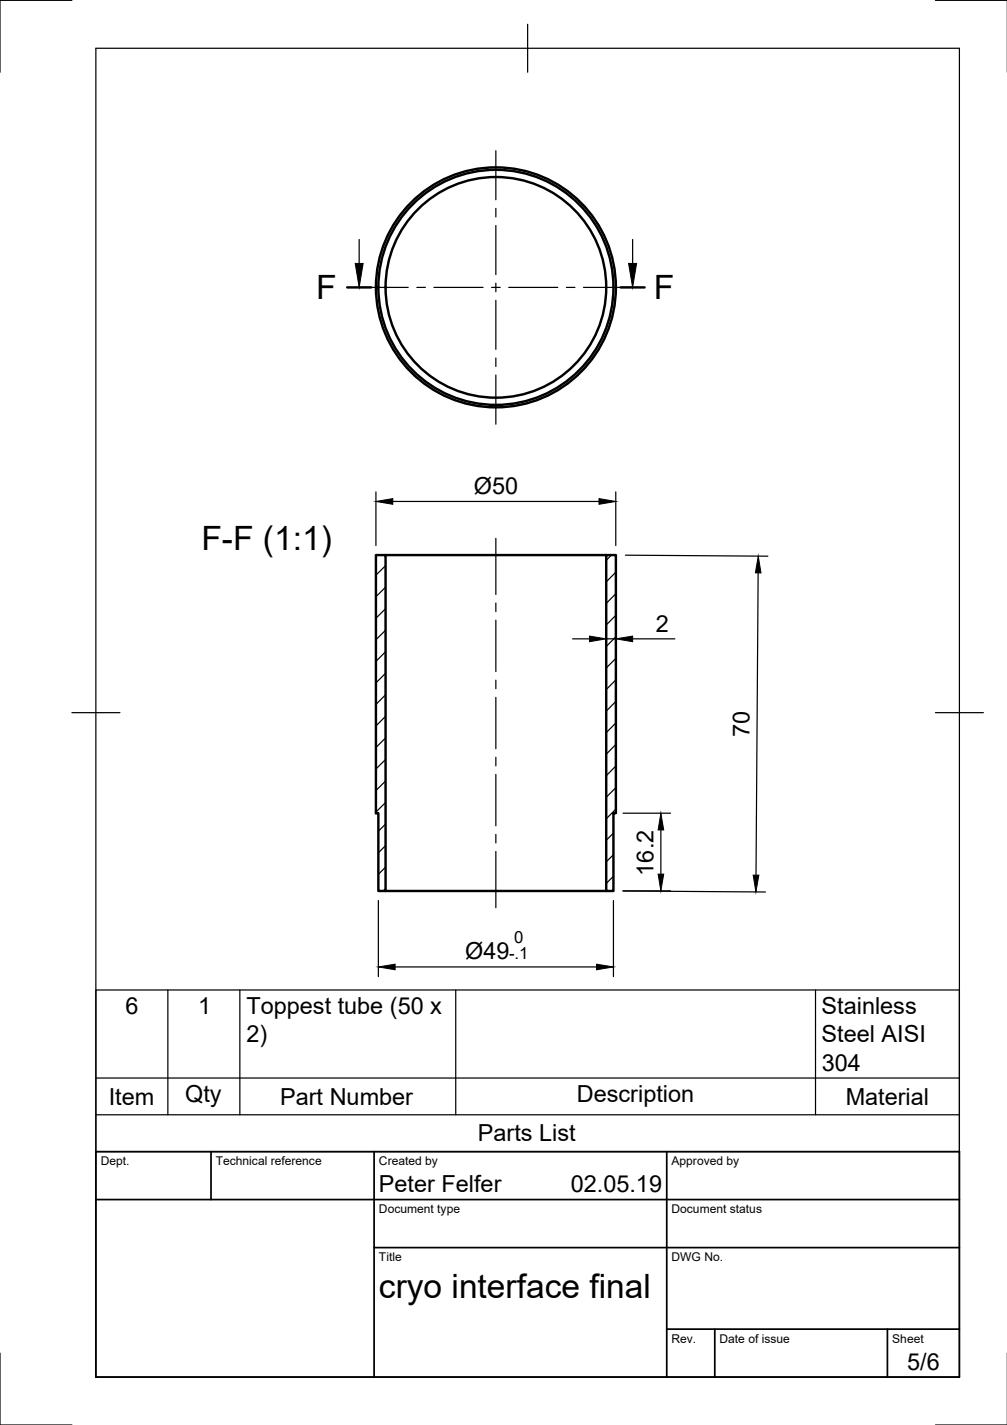
[picture p185: page 5]
Parts List

6 | 1 | Toppest tube (50 x 2) | | Stainless Steel AISI 304

Item | Qty | Part Number | Description | Material

Dept. | Technical reference | Created by Peter Felfer 02.05.19 | Approved by

Document type | Document status

Title cryo interface final | DWG No.

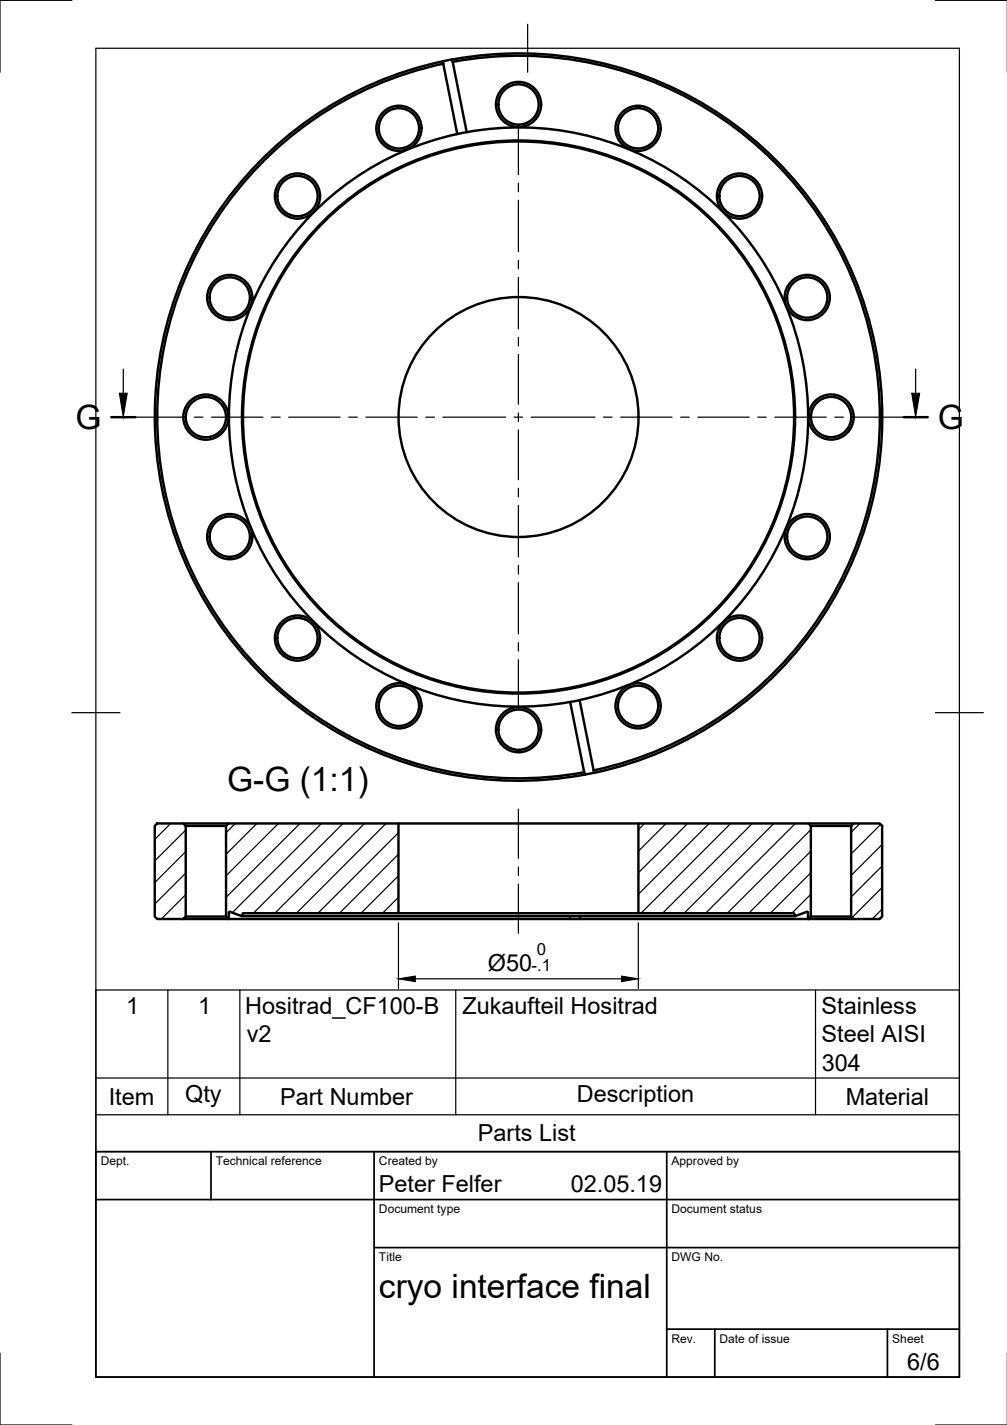
[picture p186: page 6]
Parts List

1 | 1 | Hositrad_CF100-B v2 | Zukaufteil Hositrad | Stainless Steel AISI 304

Item | Qty | Part Number | Description | Material

Dept. | Technical reference | Created by Peter Felfer 02.05.19 | Approved by

Document type | Document status

Title cryo interface final | DWG No.
