peterfelfer/Oxcart/CAD/cryo/cryo system MC/cryo interface v2 Drawing v6.pdf

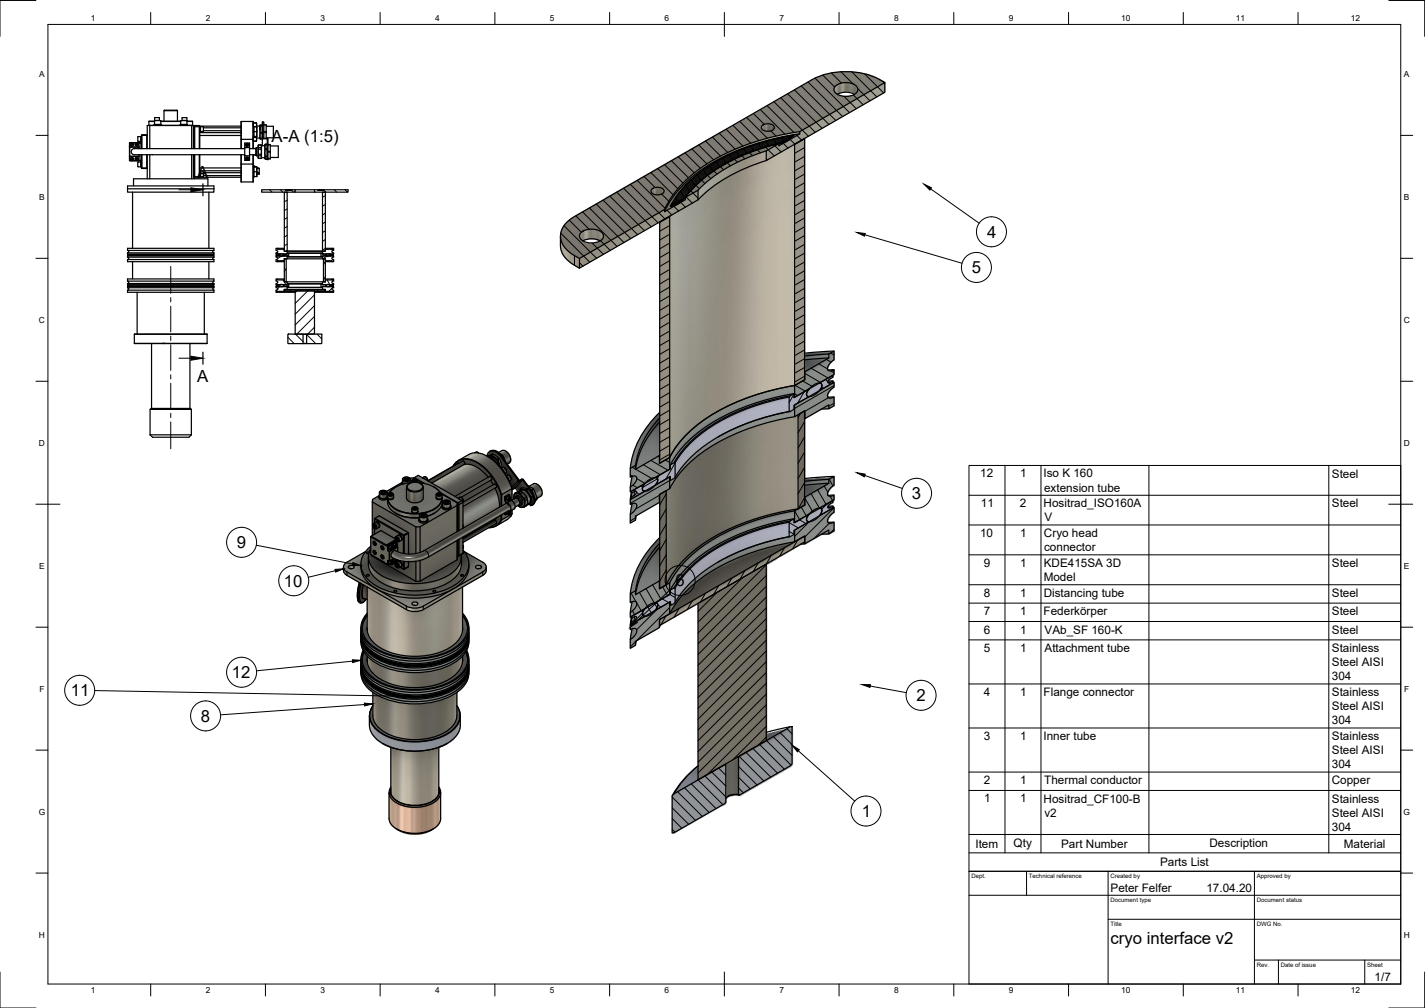
[picture p187: page 1]
12 BACDEFGH; BACDEFGH; Peter Felfer AA; Parts List; Item; Qty; Part Number; Description; Material 1; Hositrad_CF100-B; Steel AISI; Steel 23 1

12 | 1 | Iso K 160 extension tube

11 | 2 | Hositrad_ISO160A V | Steel

10 | 1 | Cryo head connector

1 1 | Federkörper Distancing tube KDE415SA 3D VAb_SF 160-K | Steel 7 Steel 8 Steel 9 304 6

Model | Steel

1 | Attachment tube | Stainless 304 5 Steel AISI

1 | Flange connector | Stainless 304 4 Steel AISI

1 1 | Inner tube Thermal conductor | Copper 3 Stainless 304 2 Steel AISI

Dept. | Technical reference | Created by 17.04.20 | Approved by

Document type | Document status

Title cryo interface v2 | DWG No.

Rev. | Date of issue | Sheet

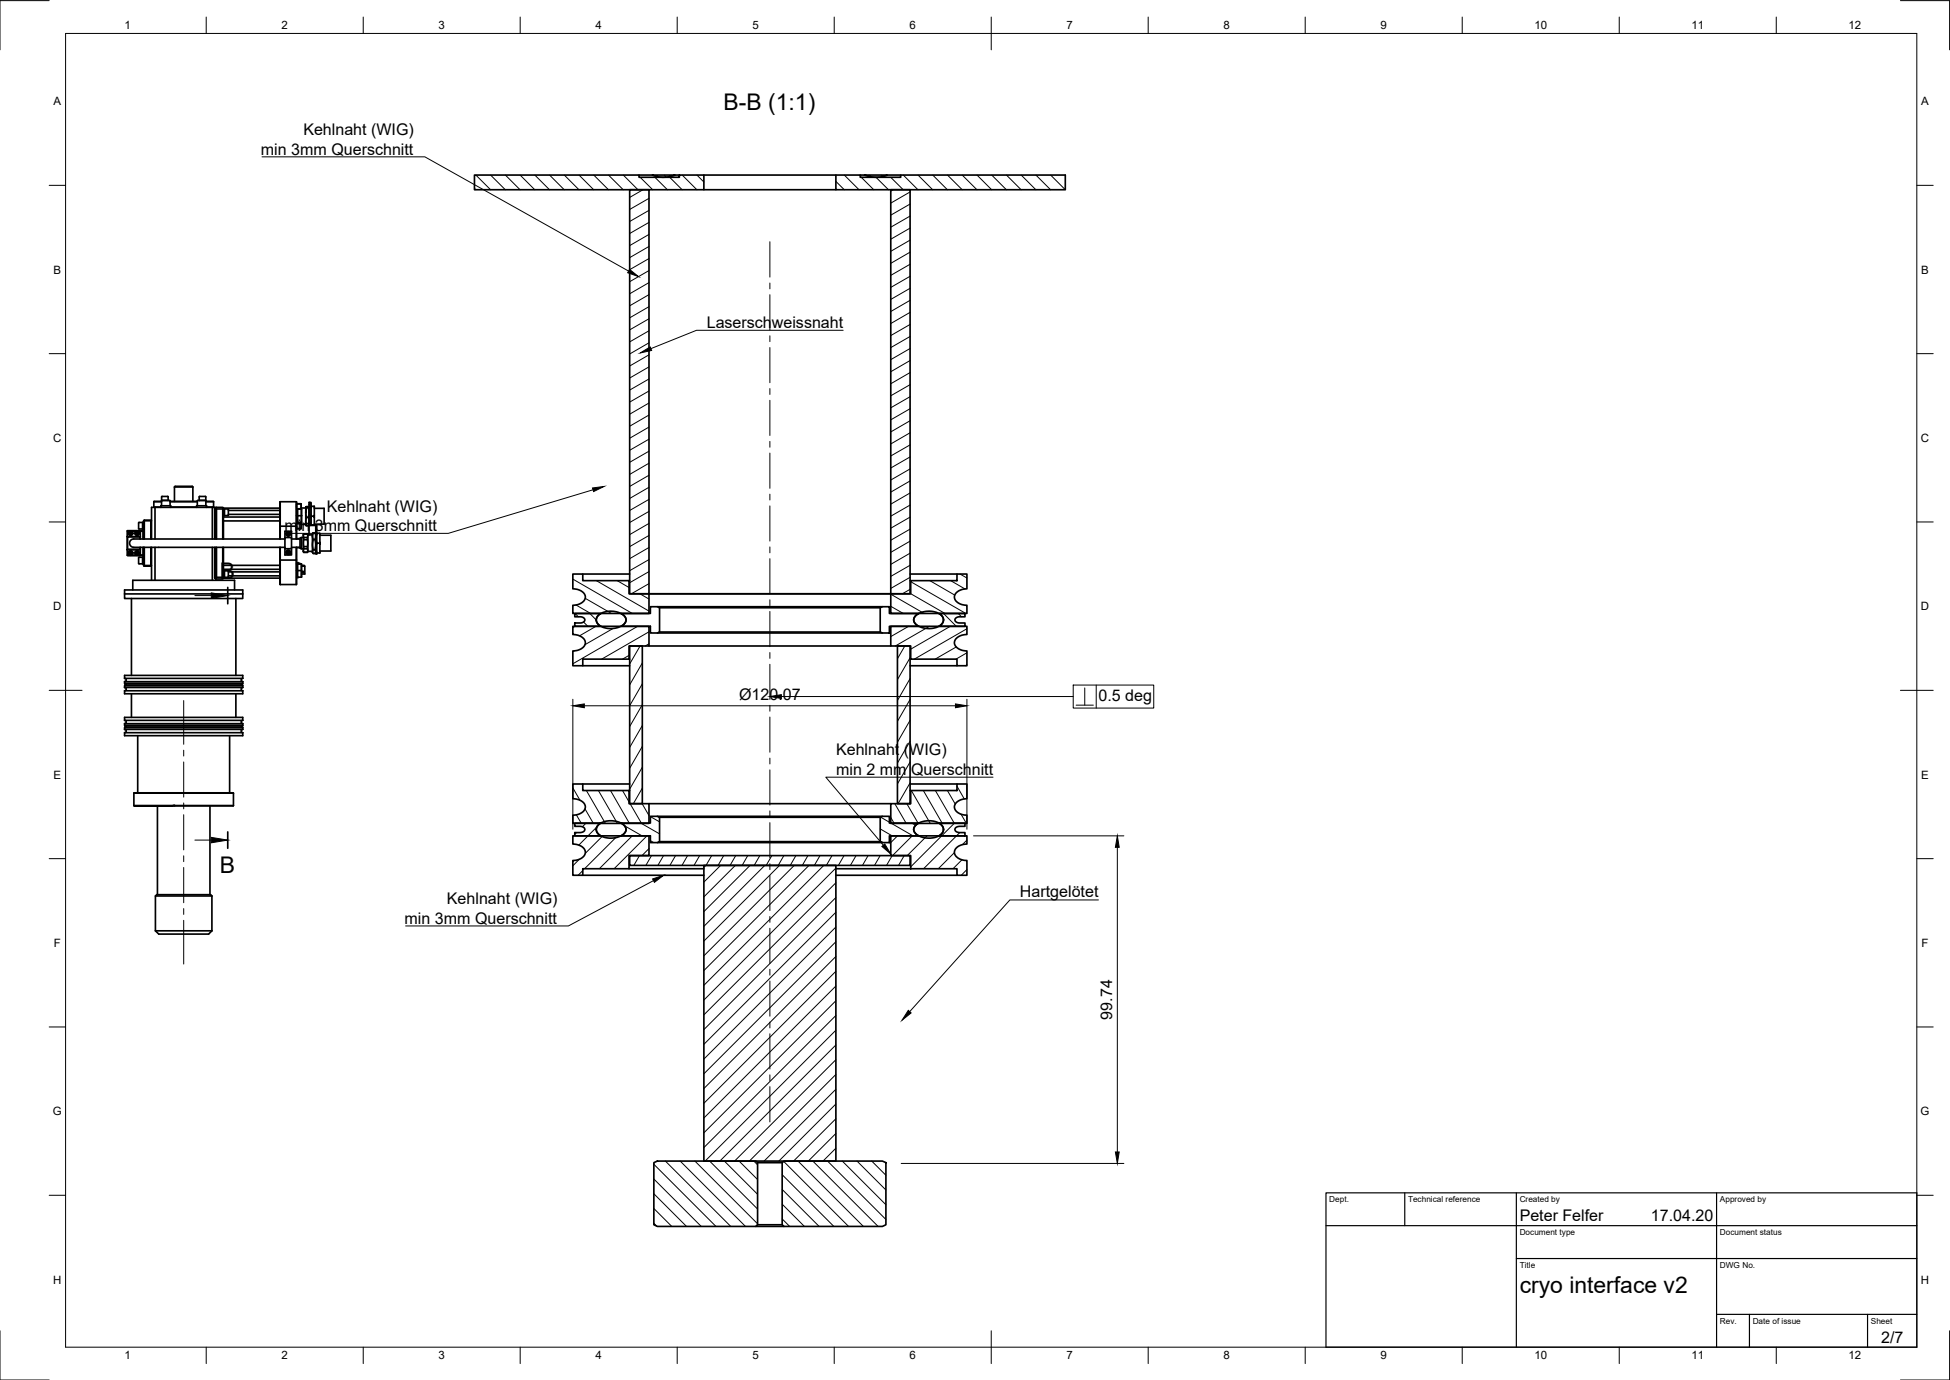
[picture p188: page 2]
Kehlnaht (WIG) min 3mm Querschnitt; 0.5 deg

Kehlnaht (WIG)
min 2 mm Querschnitt

Dept. | Technical reference | Created by Peter Felfer 17.04.20 | Approved by

Document type | Document status

Title cryo interface v2 | DWG No.

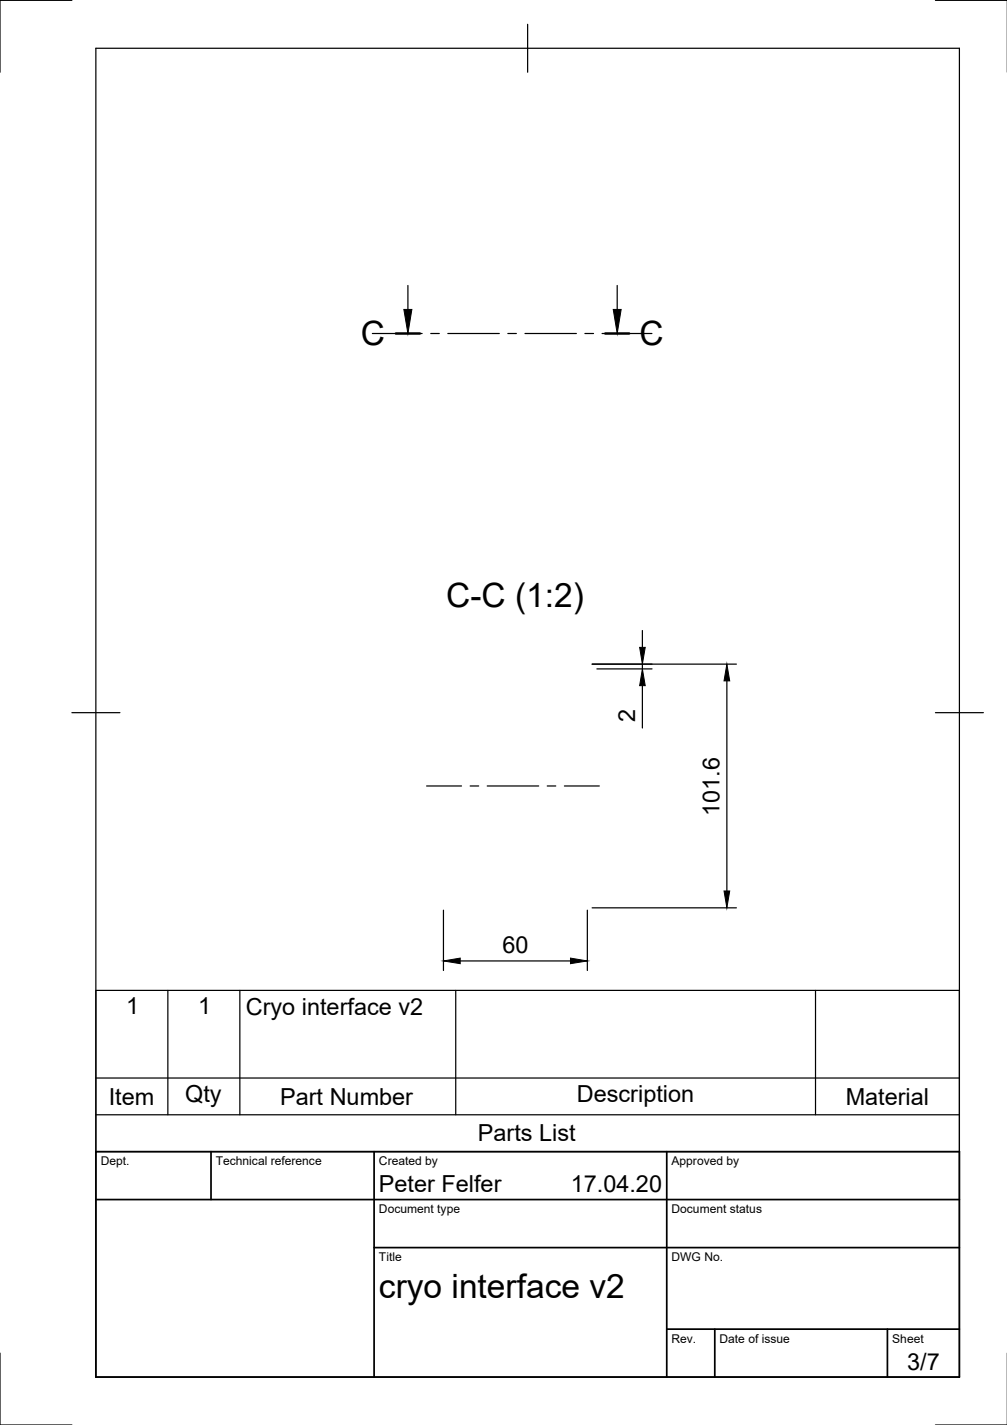
[picture p189: page 3]
Parts List; Item; Qty; Part Number; Description; Material; Cryo interface v2

Dept. | Technical reference | Created by Peter Felfer 17.04.20 | Approved by

Document type | Document status

Title cryo interface v2 | DWG No.

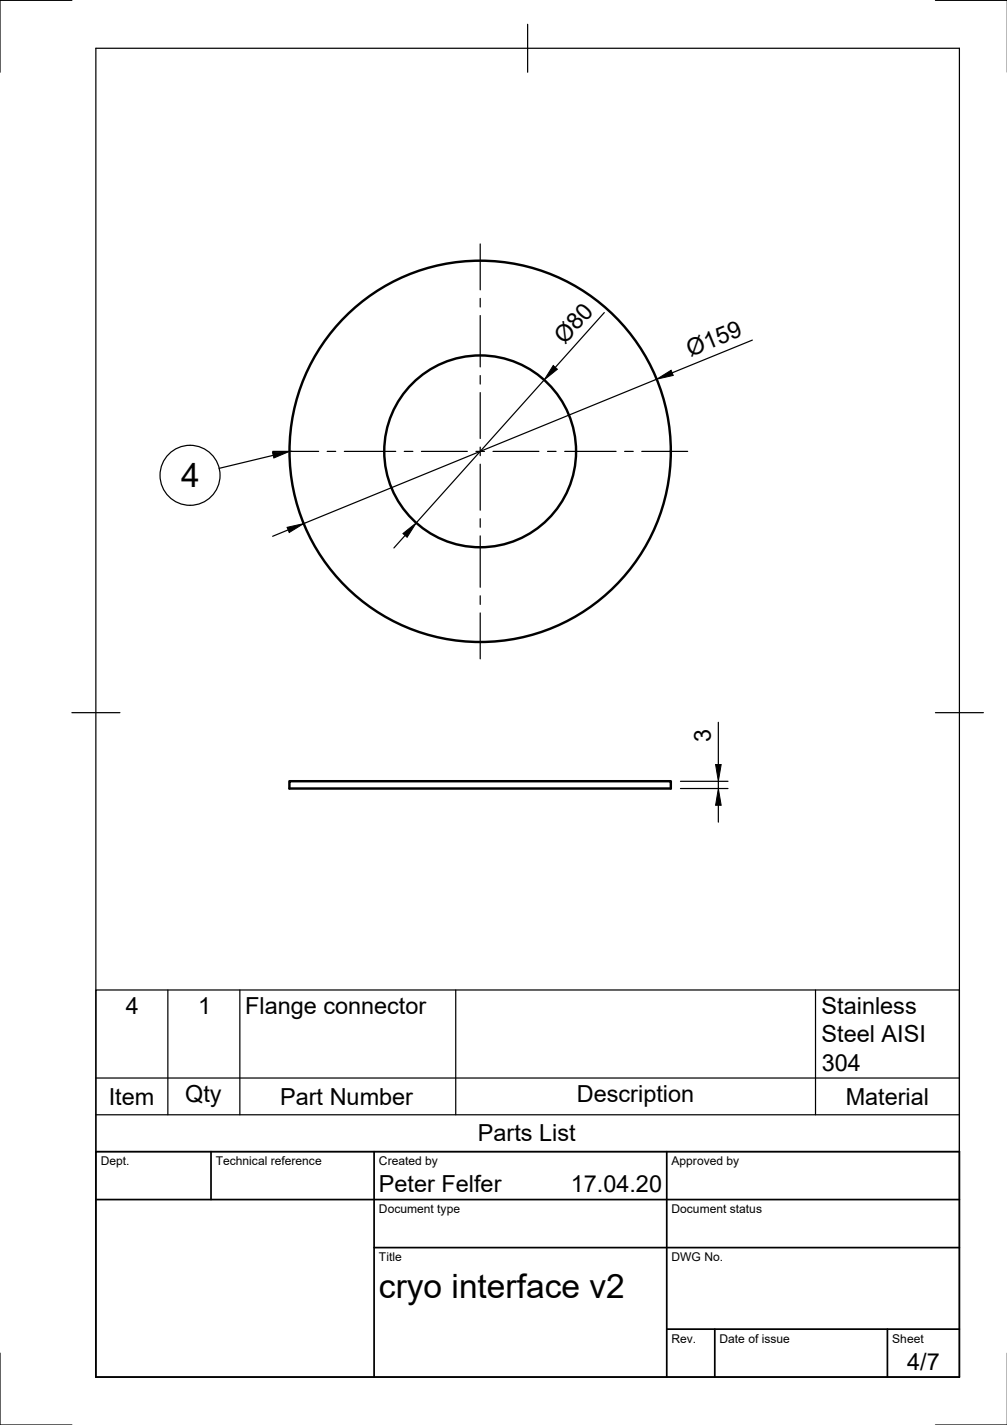
[picture p190: page 4]
Parts List

4 | 1 | Flange connector | | Stainless Steel AISI 304

Item | Qty | Part Number | Description | Material

Dept. | Technical reference | Created by Peter Felfer 17.04.20 | Approved by

Document type | Document status

Title cryo interface v2 | DWG No.

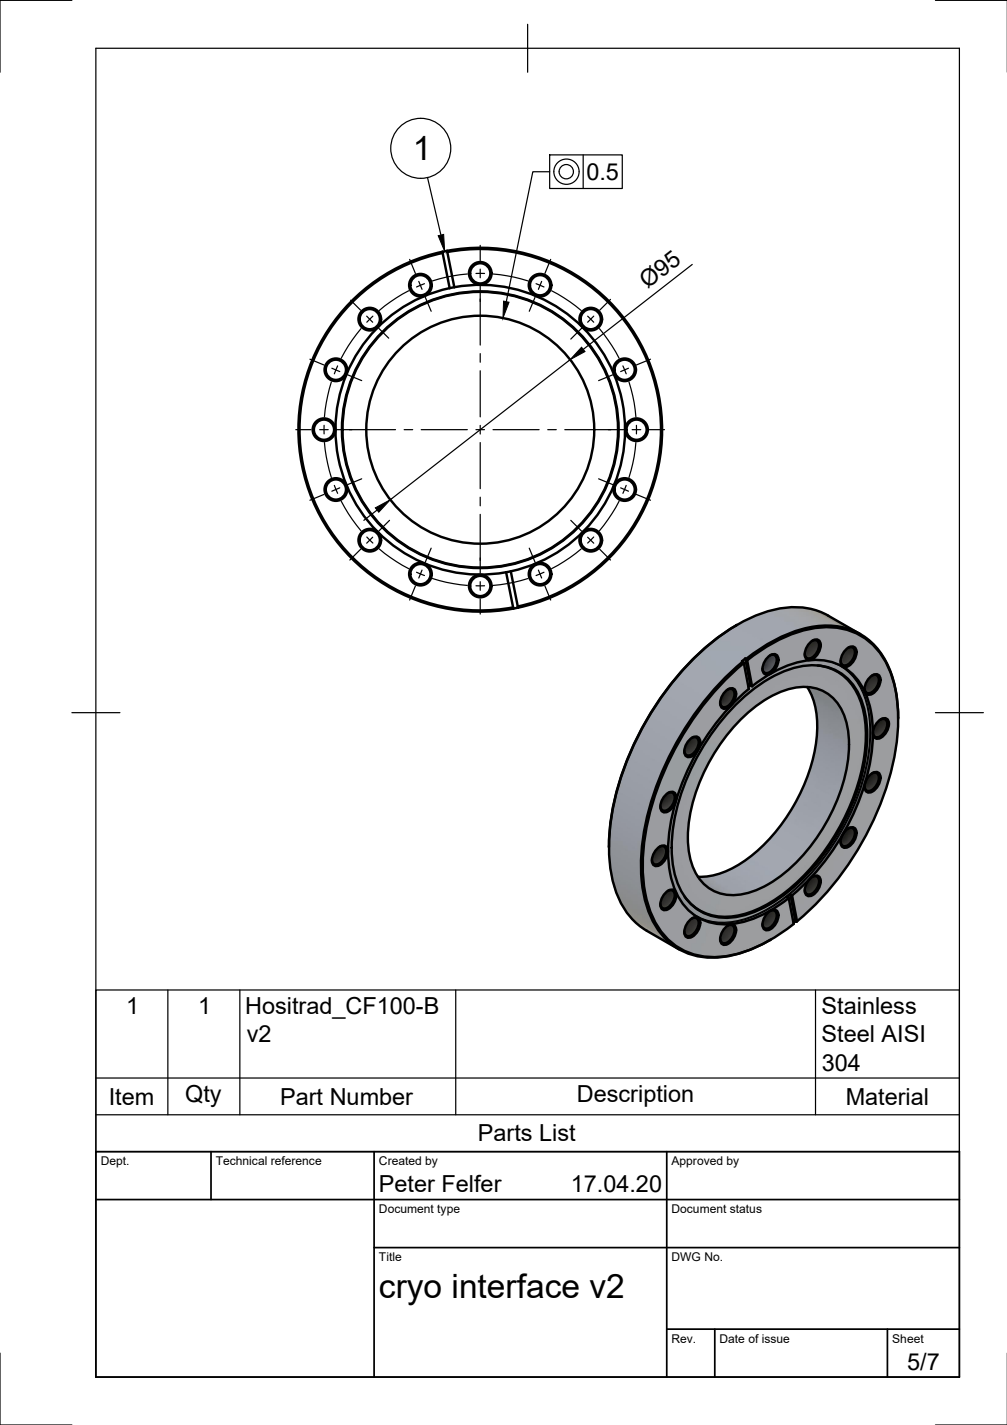
[picture p191: page 5]
Parts List

1 | 1 | Hositrad_CF100-B v2 | | Stainless Steel AISI 304

Item | Qty | Part Number | Description | Material

Dept. | Technical reference | Created by Peter Felfer 17.04.20 | Approved by

Document type | Document status

Title cryo interface v2 | DWG No.

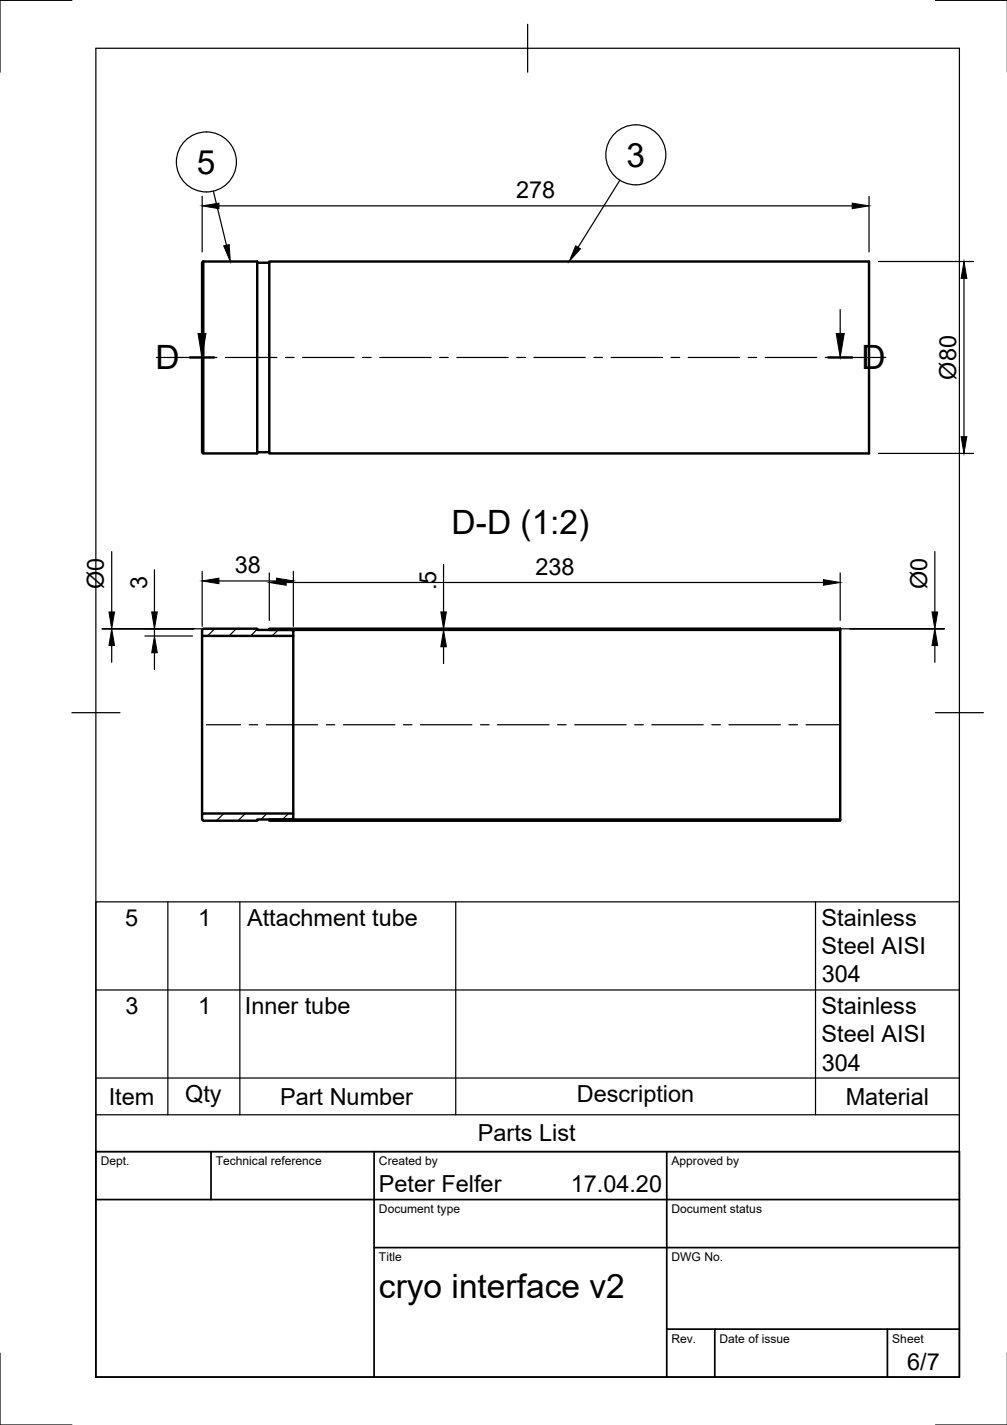
[picture p192: page 6]
Parts List

5 | 1 | Attachment tube | | Stainless Steel AISI 304

3 | 1 | Inner tube | | Stainless Steel AISI 304

Item | Qty | Part Number | Description | Material

Dept. | Technical reference | Created by Peter Felfer 17.04.20 | Approved by

Document type | Document status

Title cryo interface v2 | DWG No.

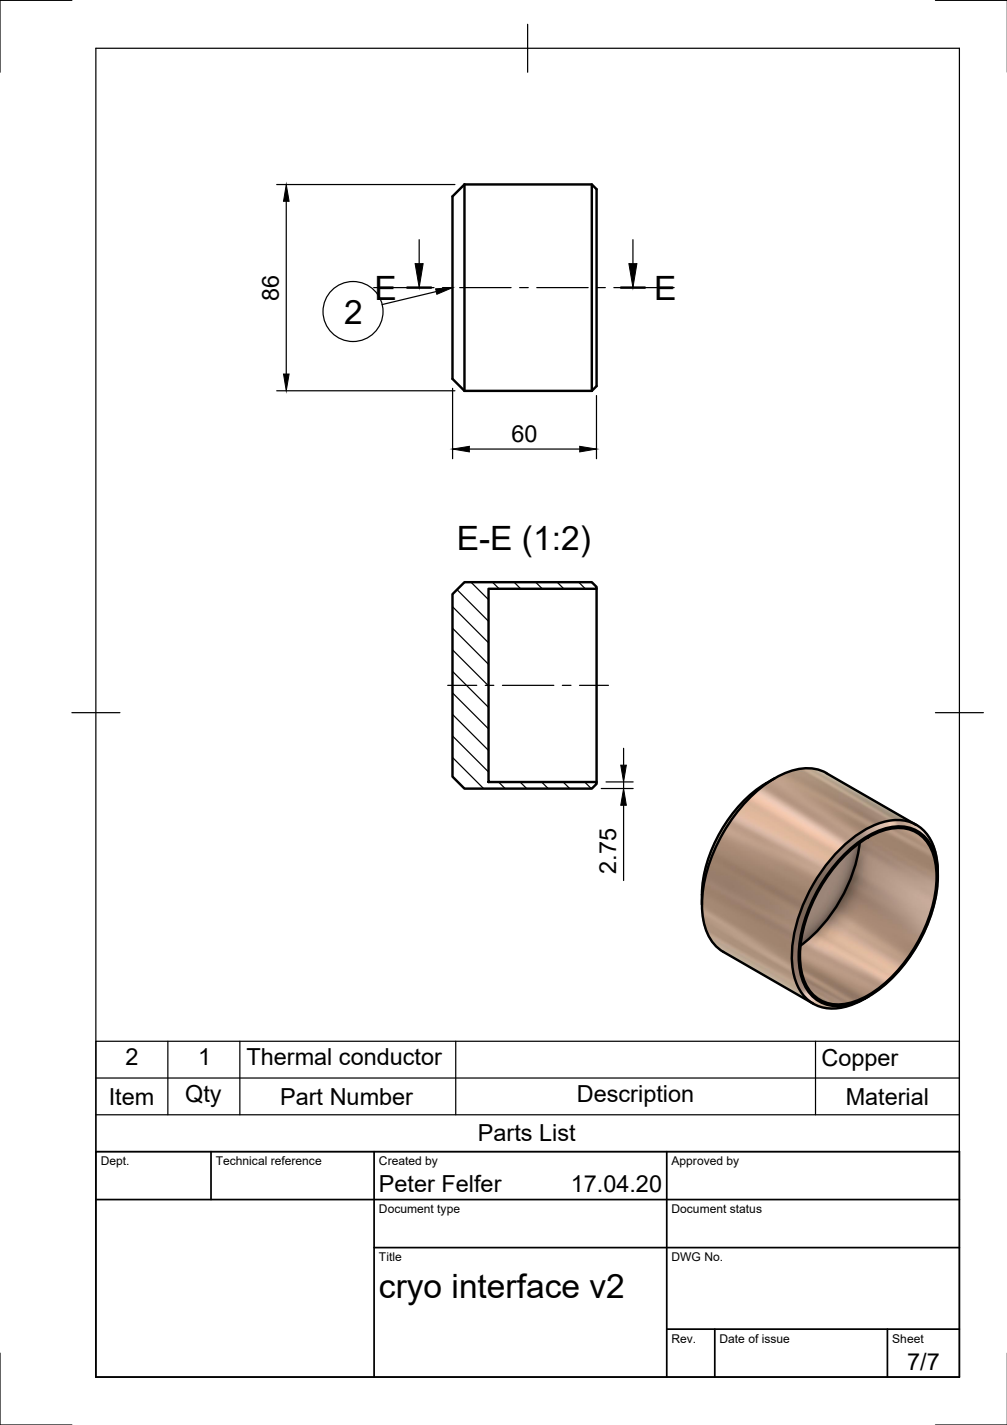
[picture p193: page 7]
Parts List; Item; Qty; Part Number; Description; Material; Thermal conductor; Copper 86

Dept. | Technical reference | Created by Peter Felfer 17.04.20 | Approved by

Document type | Document status

Title cryo interface v2 | DWG No.
