peterfelfer/Oxcart/CAD/cryo/cryo system MC/cryo interface v3 Drawing v20.pdf

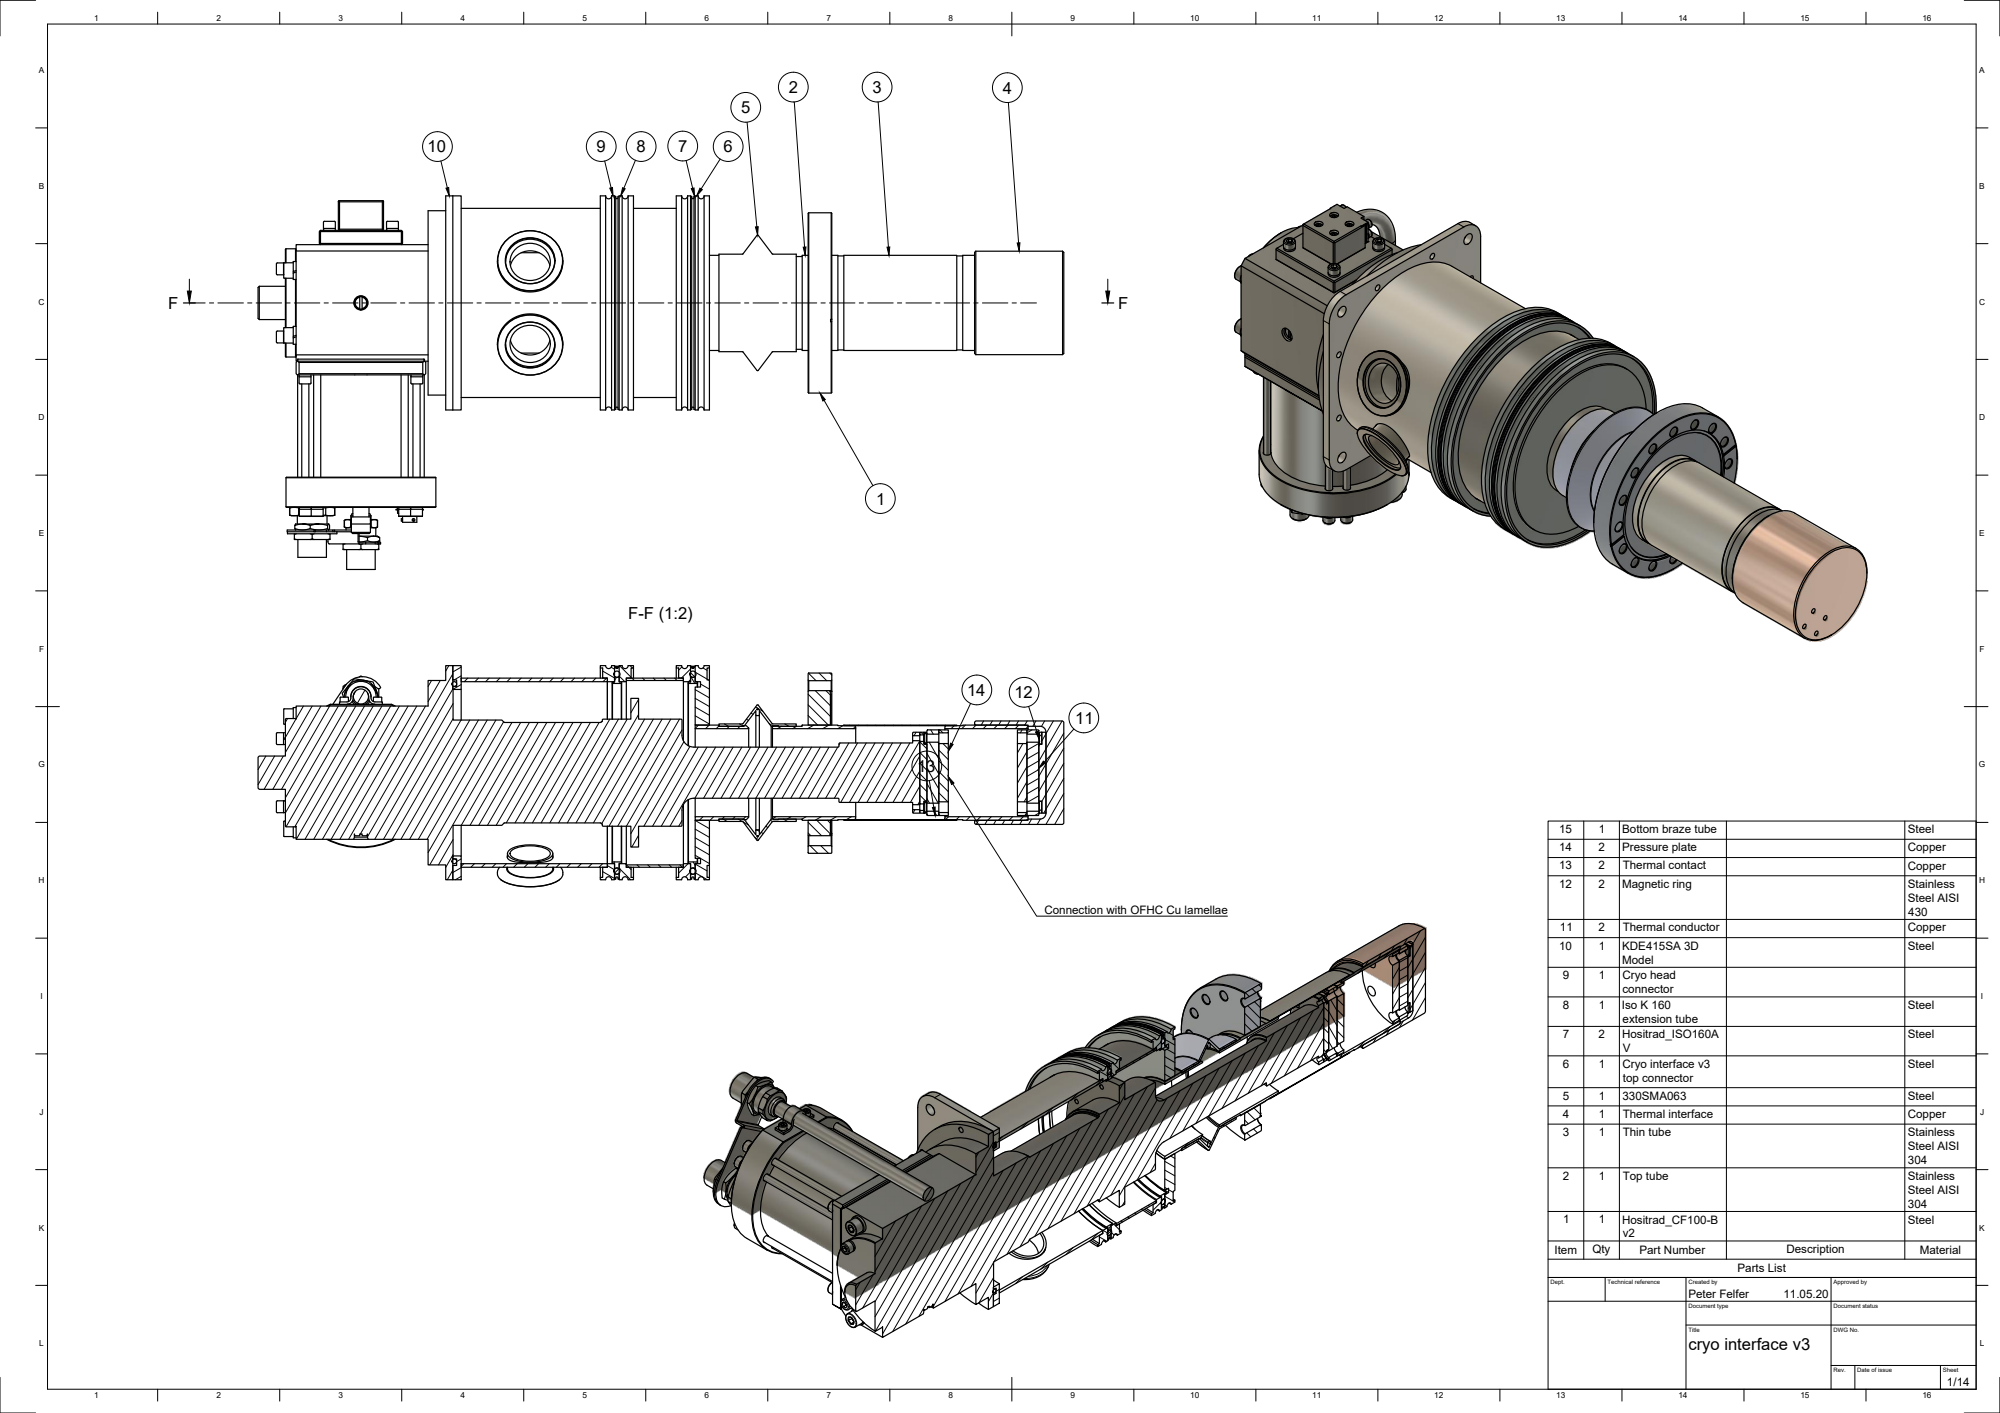
[picture p194: page 1]
Dept.; Technical reference; Created by; Approved by; Document type; Document status; Title; DWG No.; Rev.; Date of issue; Sheet; cryo interface v3; Peter Felfer; Parts List; Item; Qty; Part Number; Description; Material; Top tube; Stainless; Steel AISI; Thin tube; Thermal interface; Copper; Cryo interface v3; top connector; Iso K 160; extension tube; Cryo head; KDE415SA 3D; Thermal conductor; Magnetic ring; Thermal contact; Pressure plate; Bottom braze tube; Steel

Connection with OFHC Cu lamellae

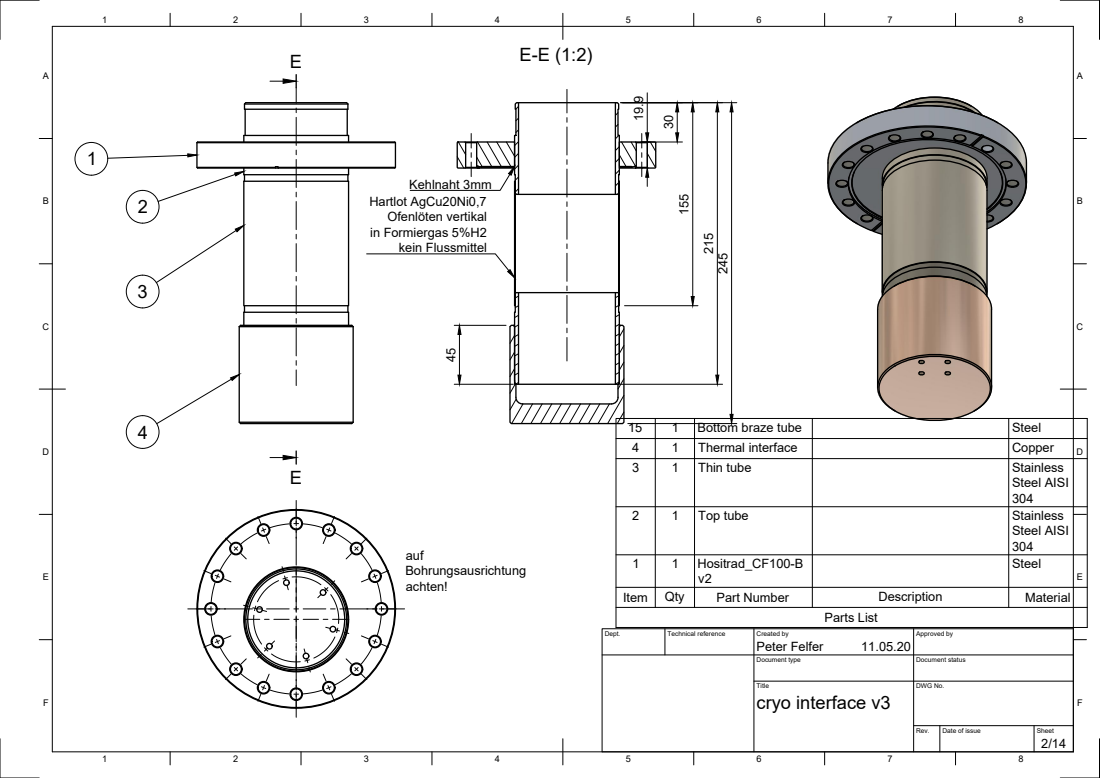
[picture p195: page 2]
Kehlnaht 3mm 45 Hartlot AgCu20Ni0,7 Ofenlöten vertikal in Formiergas 5%H2; kein Flussmittel; Bottom braze tube; Steel 4; achten!

4 | 1 | Thermal interface | | Copper | D
3 | 1 | Thin tube | | Stainless Steel AISI 304

2 | 1 | Top tube | | Stainless Steel AISI 304

1 | 1 | Hositrad_CF100-B v2 | | Steel | E

Item | Qty | Part Number | Description | Material

Parts List

Dept. | Technical reference | Created by Peter Felfer 11.05.20 | Approved by

Document type | Document status

Title cryo interface v3 | DWG No.

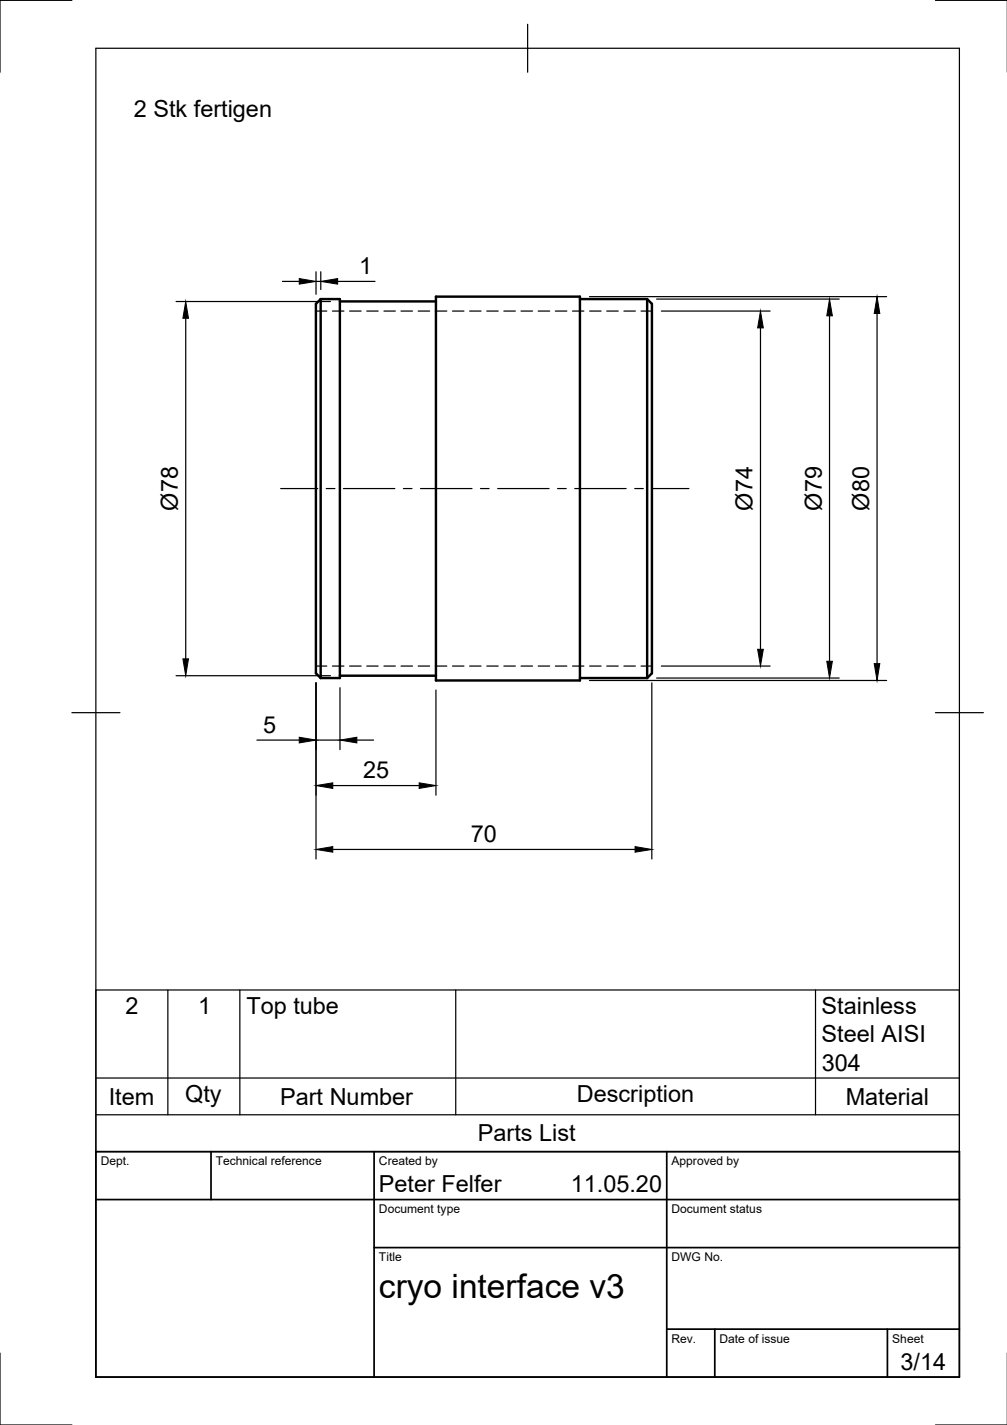
[picture p196: page 3]
Parts List; 2 Stk fertigen

2 | 1 | Top tube | | Stainless Steel AISI

Item | Qty | Part Number | Description | Material

Dept. | Technical reference | Created by Peter Felfer 11.05.20 | Approved by

Document type | Document status

Title cryo interface v3 | DWG No.

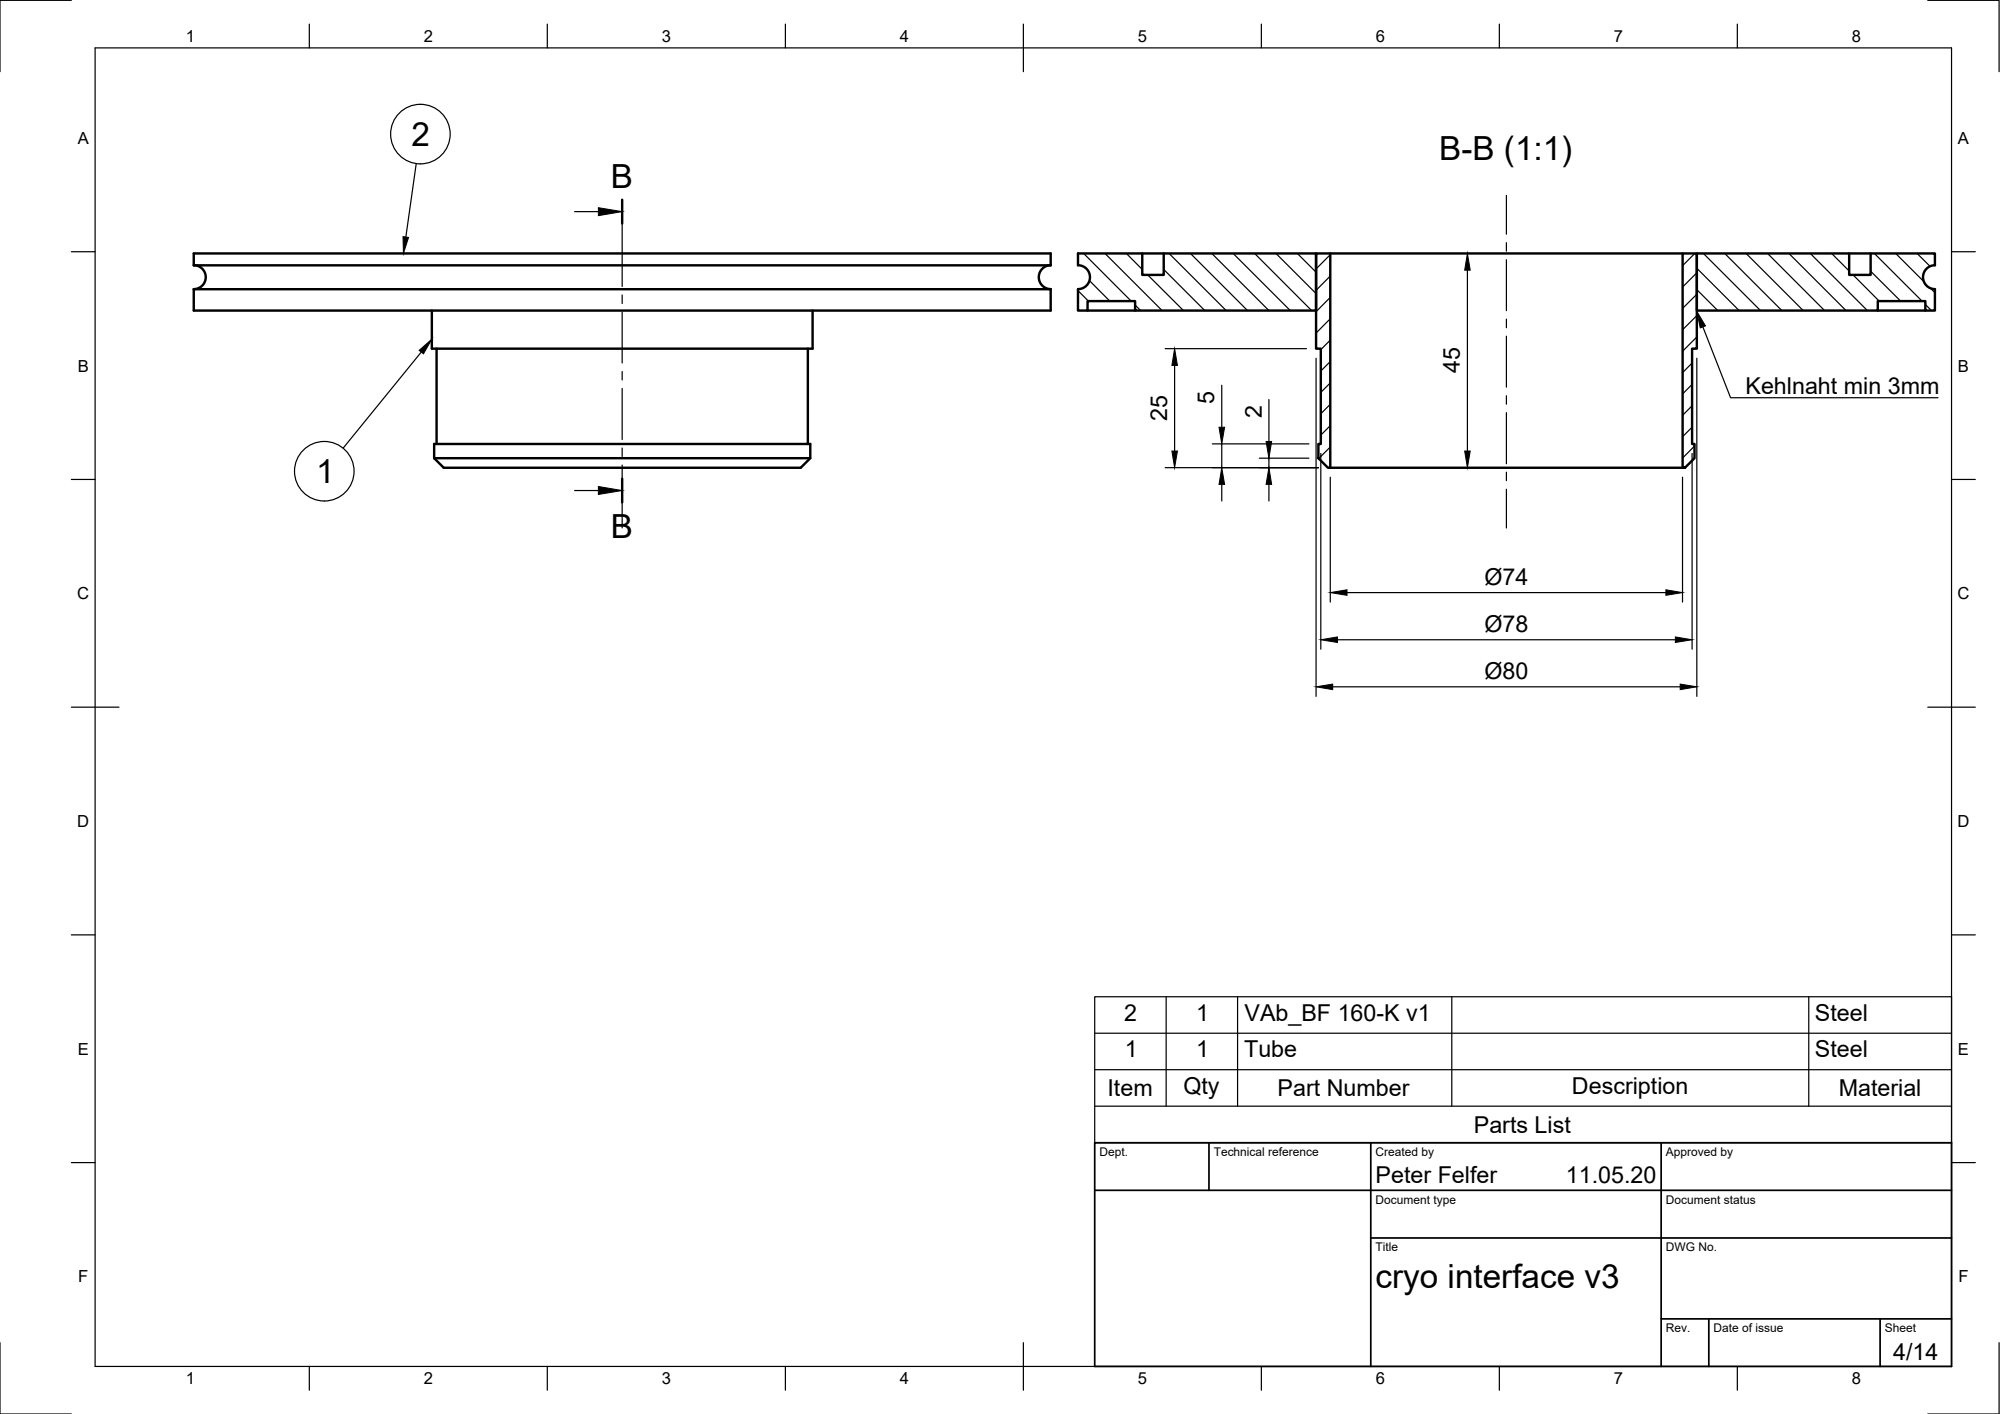
[picture p197: page 4]
Parts List; Kehlnaht min 3mm

2 | 1 | VAb_BF 160-K v1 | | Steel
1 | 1 | Tube | | Steel
Item | Qty | Part Number | Description | Material

Dept. | Technical reference | Created by Peter Felfer 11.05.20 | Approved by

Document type | Document status

Title cryo interface v3 | DWG No.

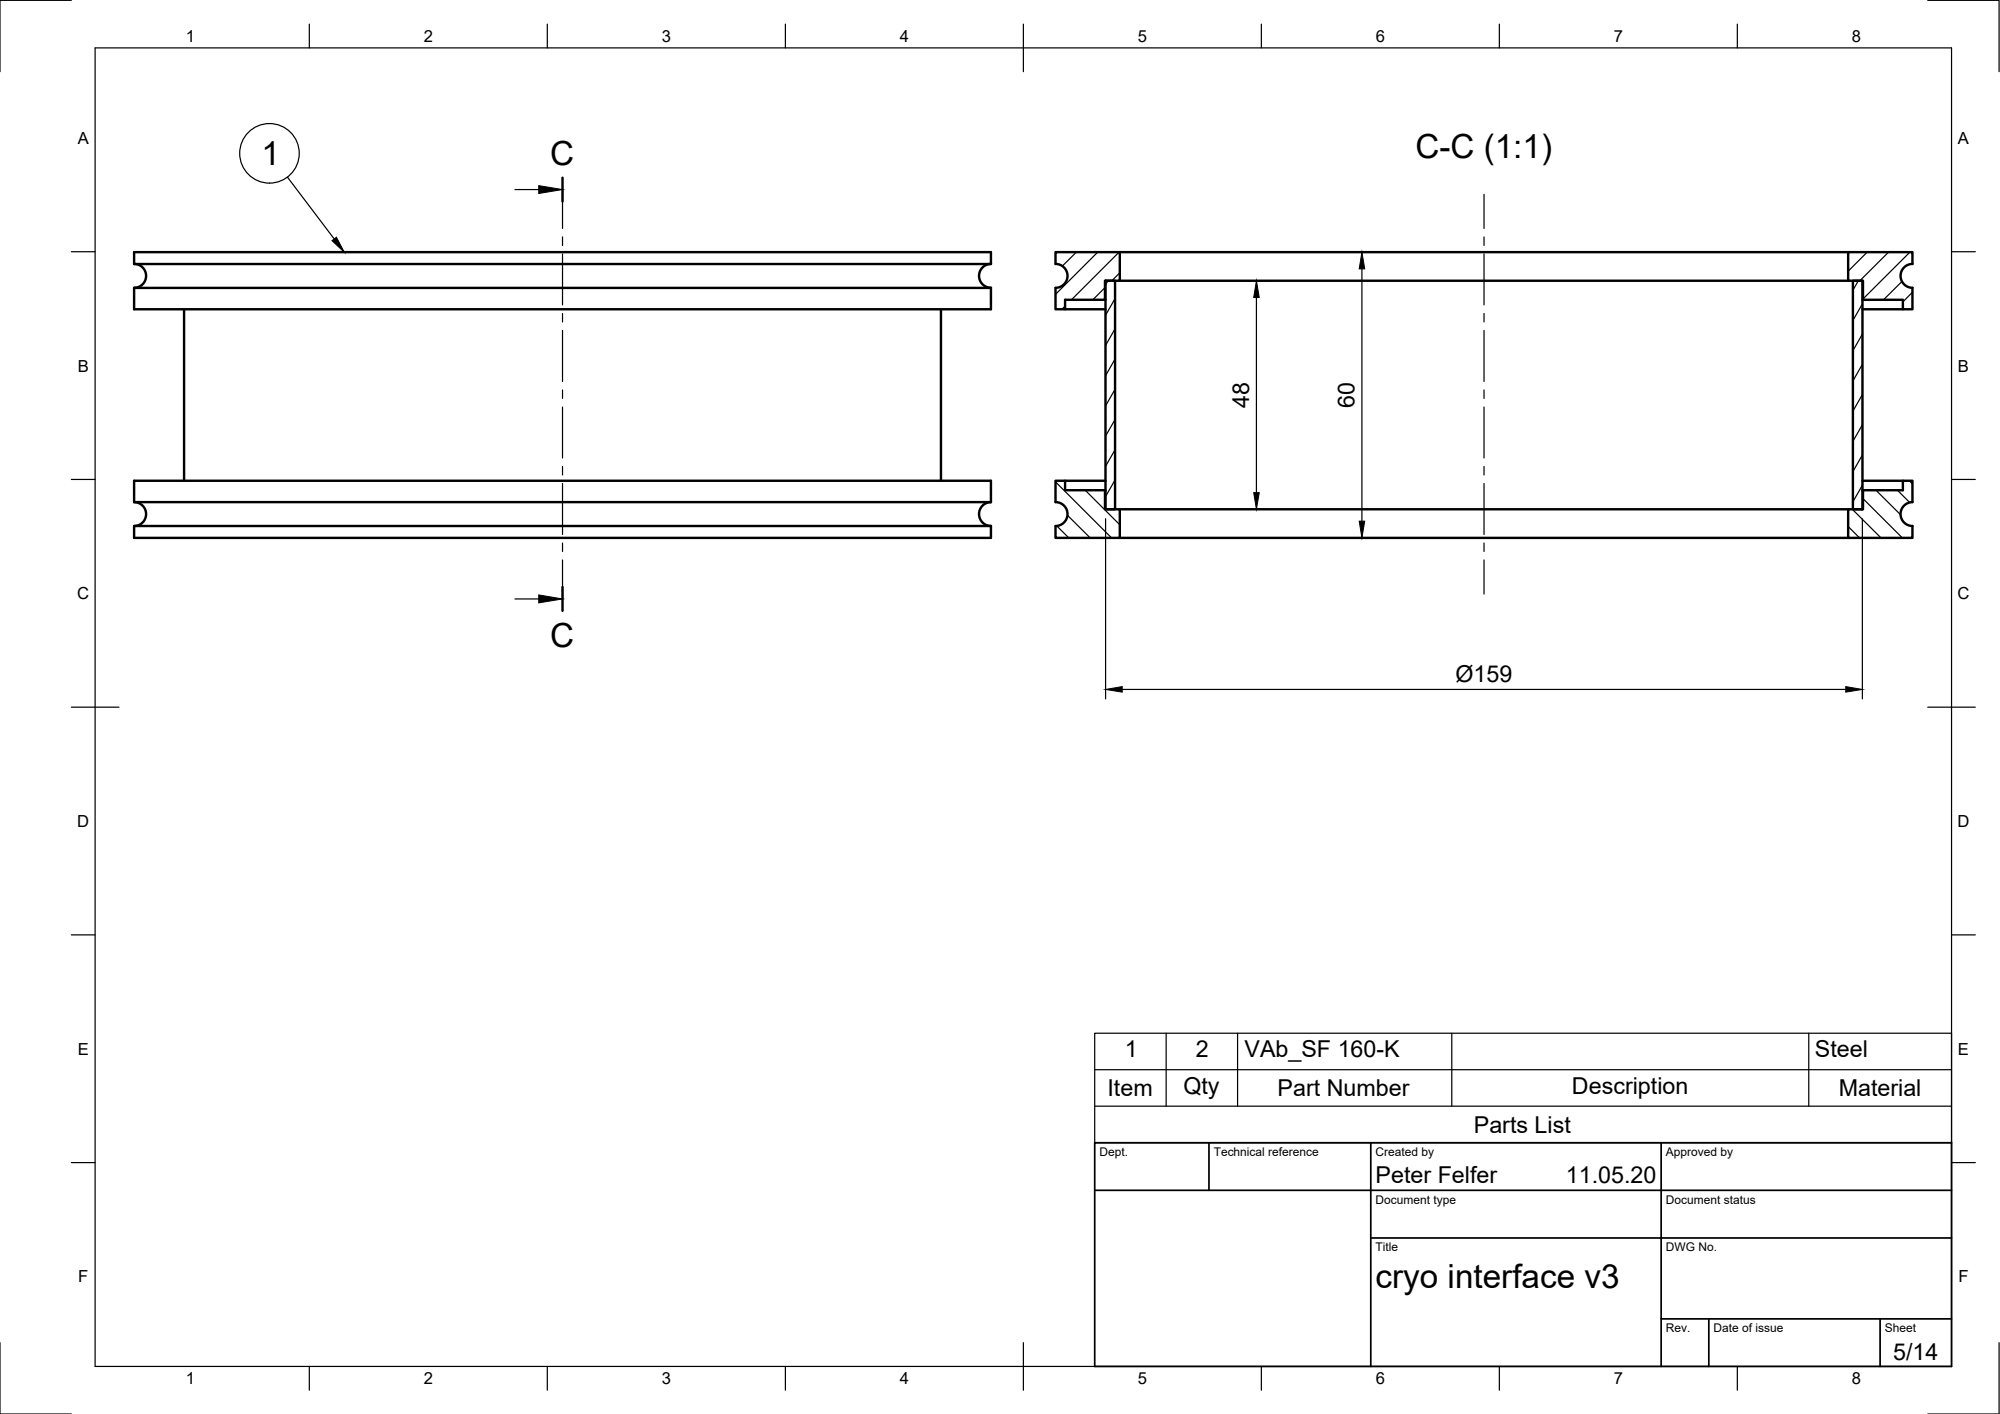
[picture p198: page 5]
Parts List

1 | 2 | VAb_SF 160-K | | Steel
Item | Qty | Part Number | Description | Material

Dept. | Technical reference | Created by Peter Felfer 11.05.20 | Approved by

Document type | Document status

Title cryo interface v3 | DWG No.

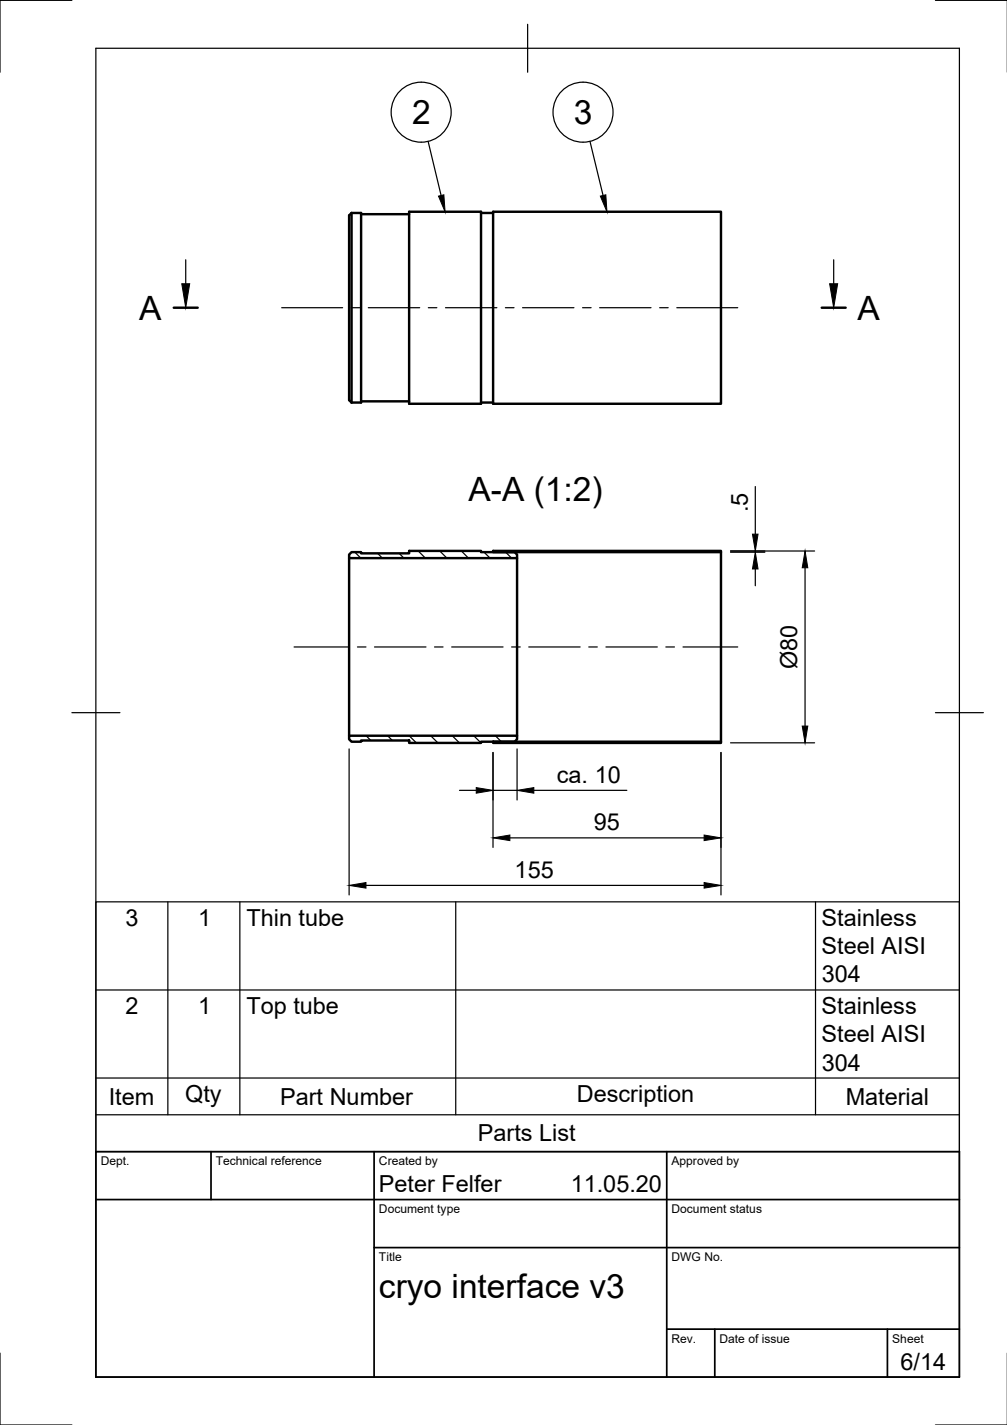
[picture p199: page 6]
Parts List

3 | 1 | Thin tube | | Stainless Steel AISI 304

2 | 1 | Top tube | | Stainless Steel AISI 304

Item | Qty | Part Number | Description | Material

Dept. | Technical reference | Created by Peter Felfer 11.05.20 | Approved by

Document type | Document status

Title cryo interface v3 | DWG No.

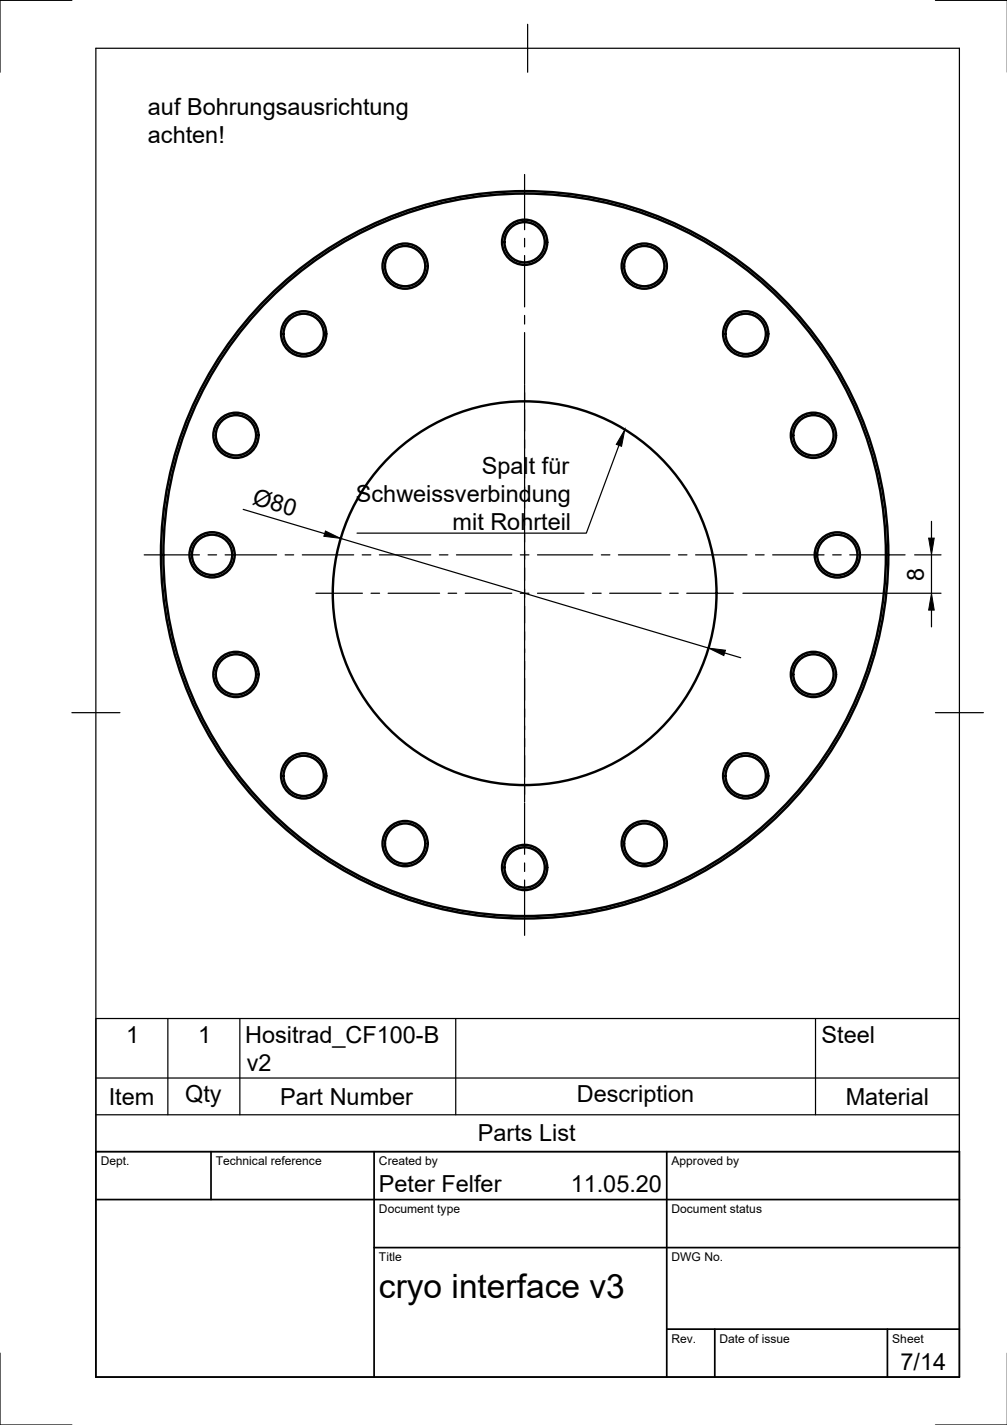
[picture p200: page 7]
Parts List; auf Bohrungsausrichtung; Spalt für; mit Rohrteil

1 | 1 | Hositrad_CF100-B v2 | | Steel

Item | Qty | Part Number | Description | Material

Dept. | Technical reference | Created by Peter Felfer 11.05.20 | Approved by

Document type | Document status

Title cryo interface v3 | DWG No.

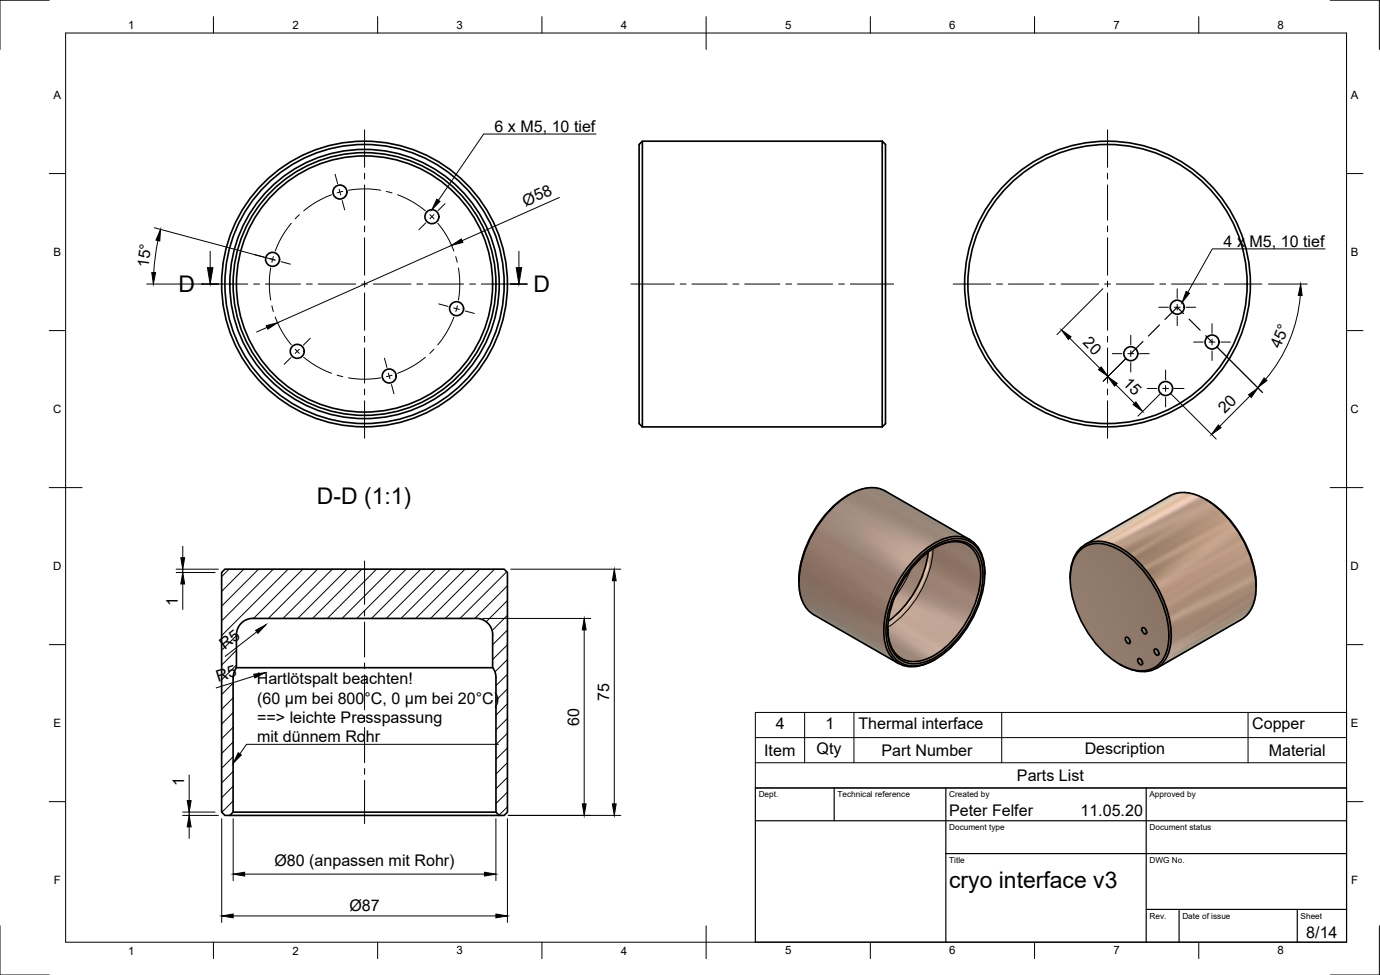
[picture p201: page 8]
Ø80 (anpassen mit Rohr); 6 x M5, 10 tief; 4 x M5, 10 tief; Parts List

Hartlötspalt beachten!
(60 µm bei 800°C, 0 µm bei 20°C)
==> leichte Presspassung
mit dünnem Rohr

4 | 1 | Thermal interface | | Copper
Item | Qty | Part Number | Description | Material

Dept. | Technical reference | Created by Peter Felfer 11.05.20 | Approved by

Document type | Document status

Title cryo interface v3 | DWG No.

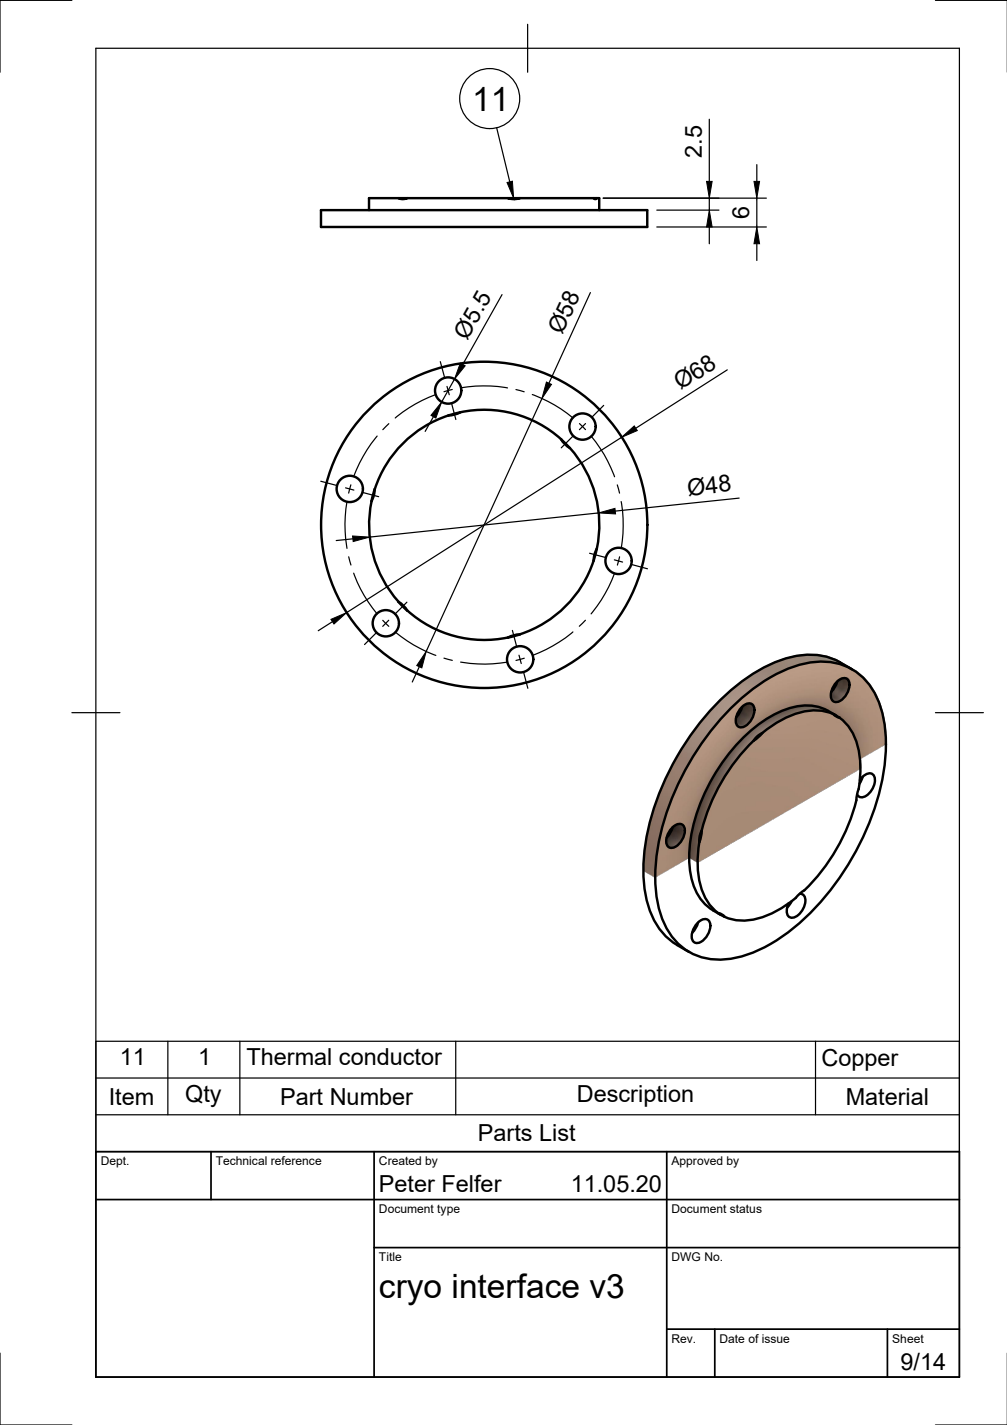
[picture p202: page 9]
Parts List

11 | 1 | Thermal conductor | | Copper
Item | Qty | Part Number | Description | Material

Dept. | Technical reference | Created by Peter Felfer 11.05.20 | Approved by

Document type | Document status

Title cryo interface v3 | DWG No.

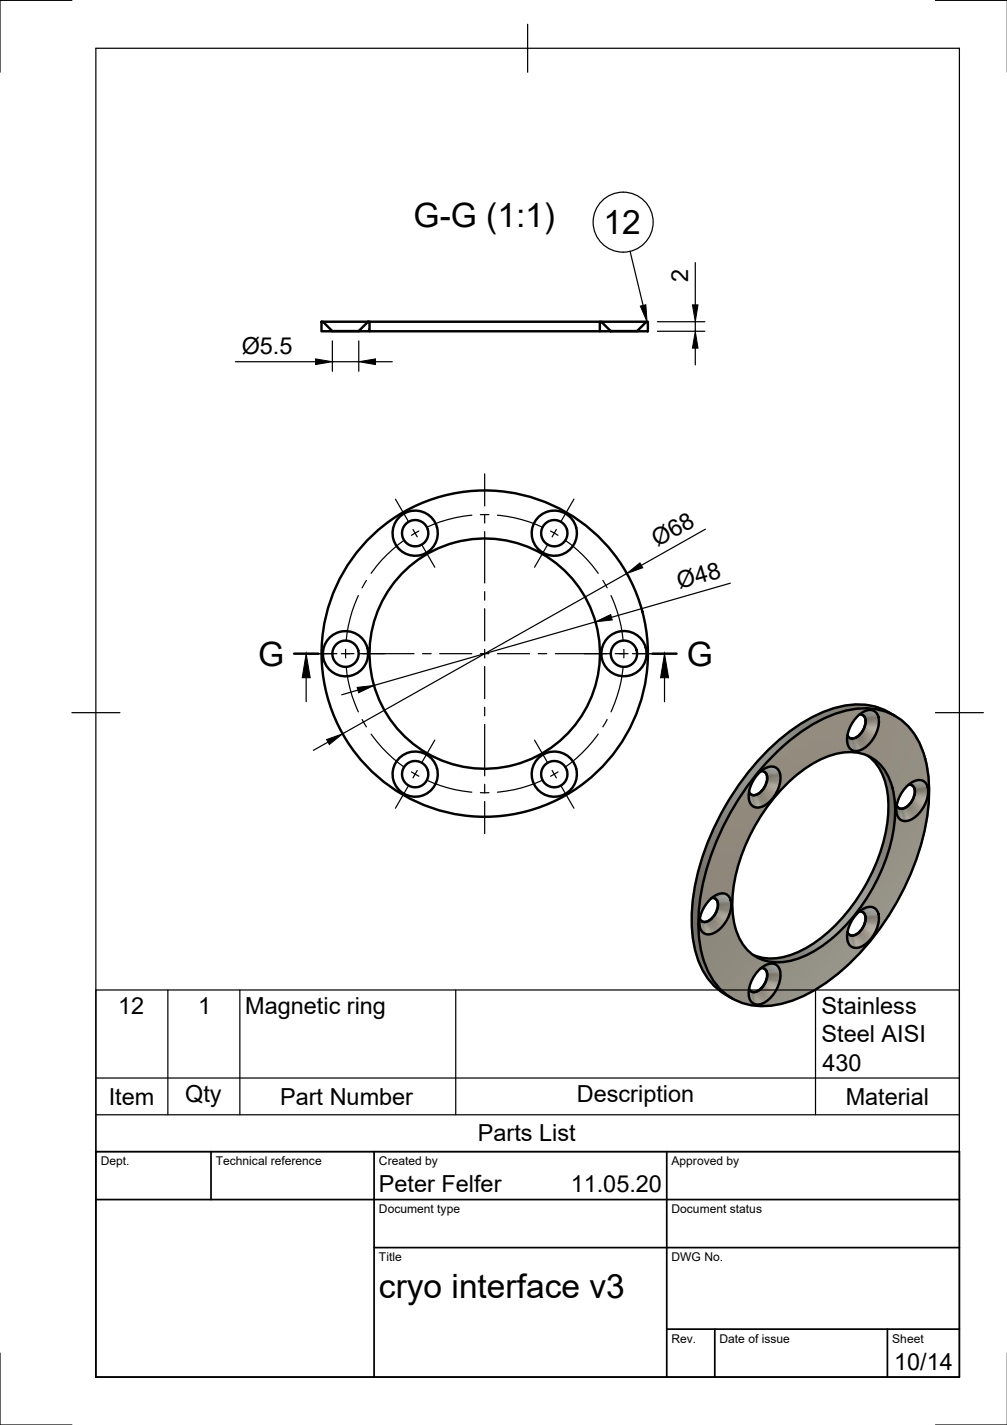
[picture p203: page 10]
Parts List

12 | 1 | Magnetic ring | | Stainless Steel AISI 430

Item | Qty | Part Number | Description | Material

Dept. | Technical reference | Created by Peter Felfer 11.05.20 | Approved by

Document type | Document status

Title cryo interface v3 | DWG No.

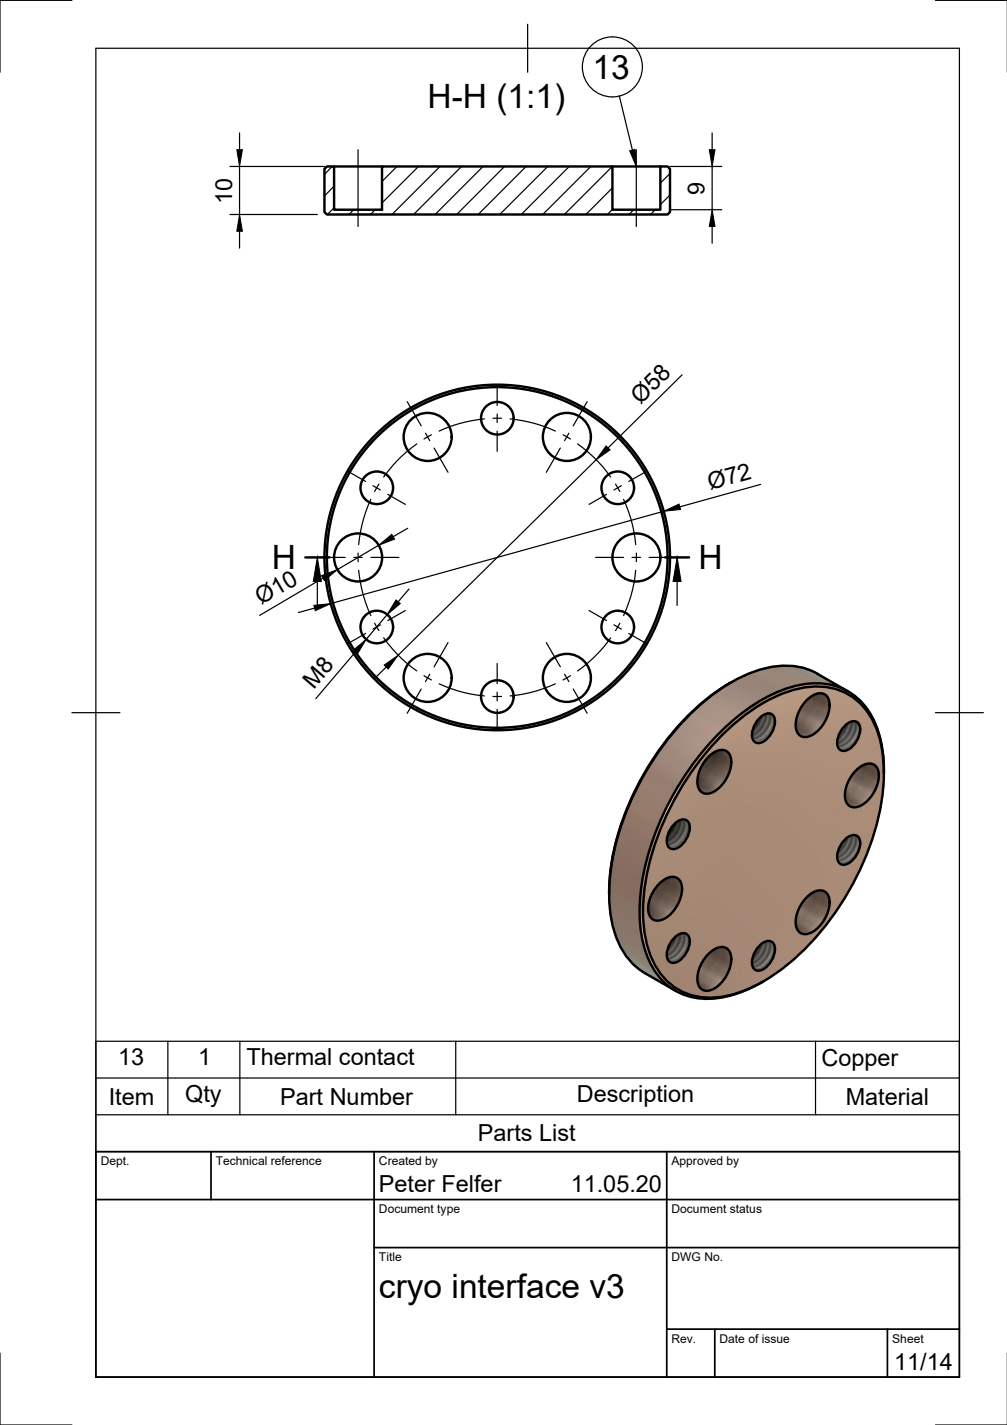
[picture p204: page 11]
Parts List

13 | 1 | Thermal contact | | Copper
Item | Qty | Part Number | Description | Material

Dept. | Technical reference | Created by Peter Felfer 11.05.20 | Approved by

Document type | Document status

Title cryo interface v3 | DWG No.

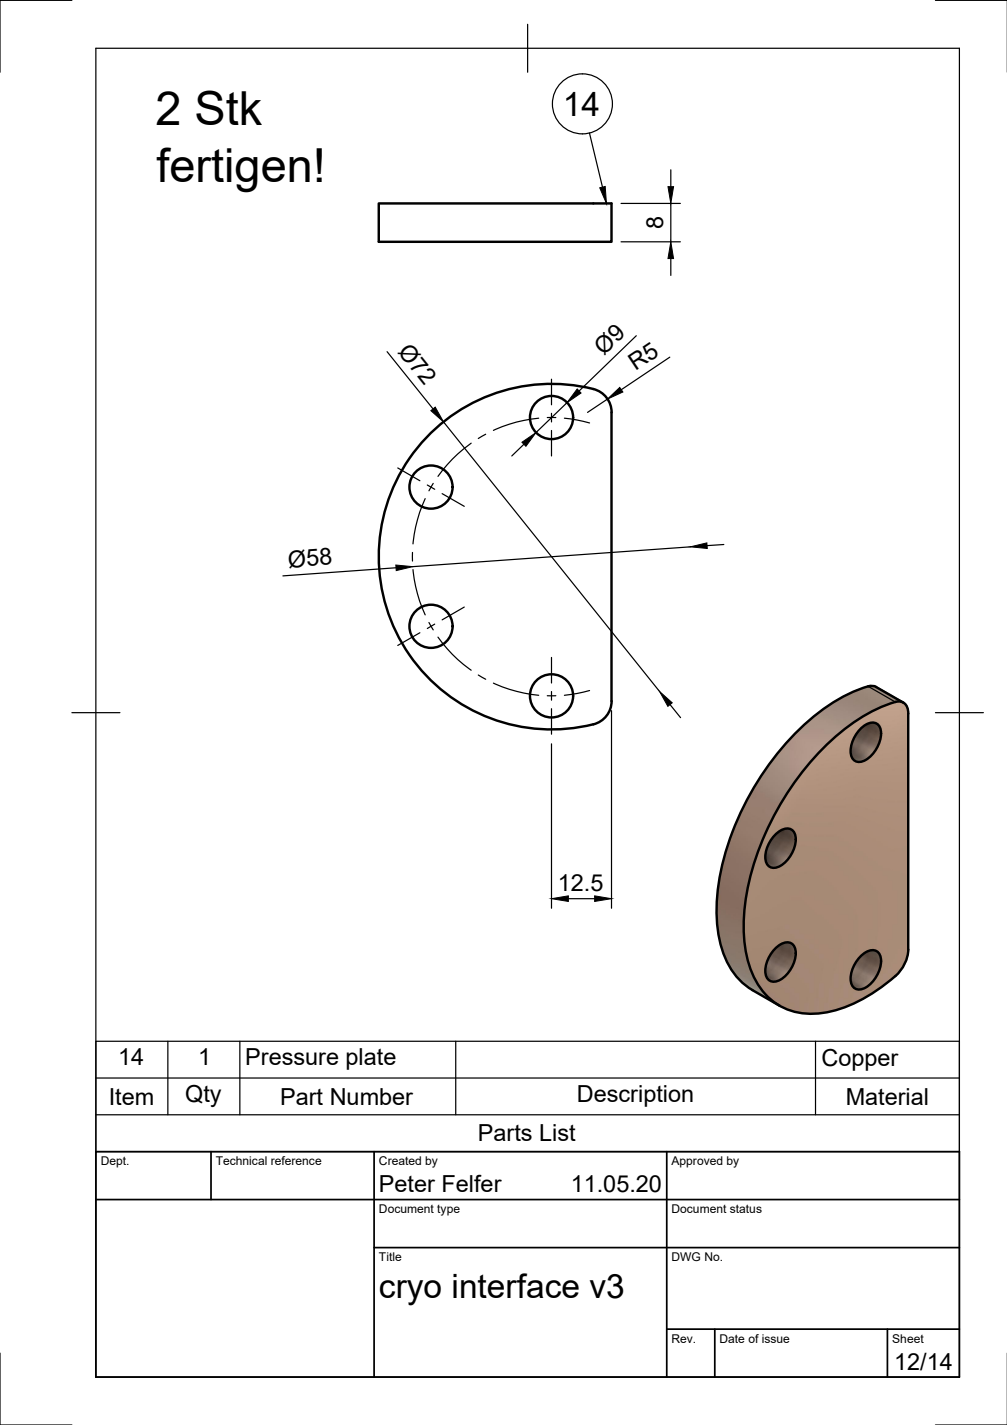
[picture p205: page 12]
Parts List; 2 Stk

14 | 1 | Pressure plate | | Copper
Item | Qty | Part Number | Description | Material

Dept. | Technical reference | Created by Peter Felfer 11.05.20 | Approved by

Document type | Document status

Title cryo interface v3 | DWG No.

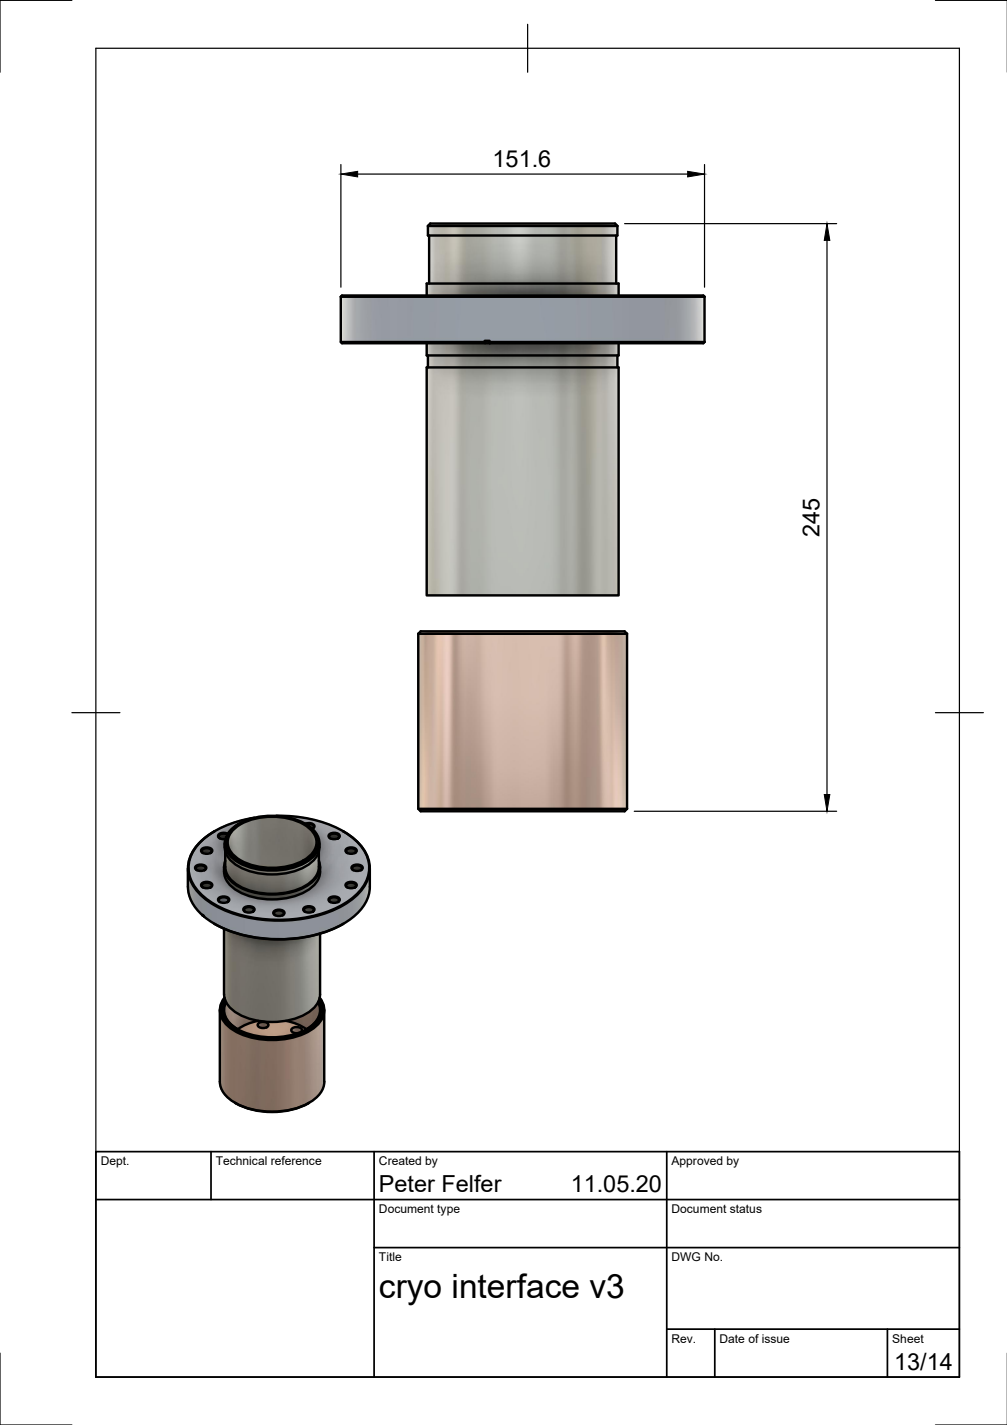
[picture p206: page 13]
Peter Felfer

Dept. | Technical reference | Created by 11.05.20 | Approved by

Document type | Document status

Title cryo interface v3 | DWG No.

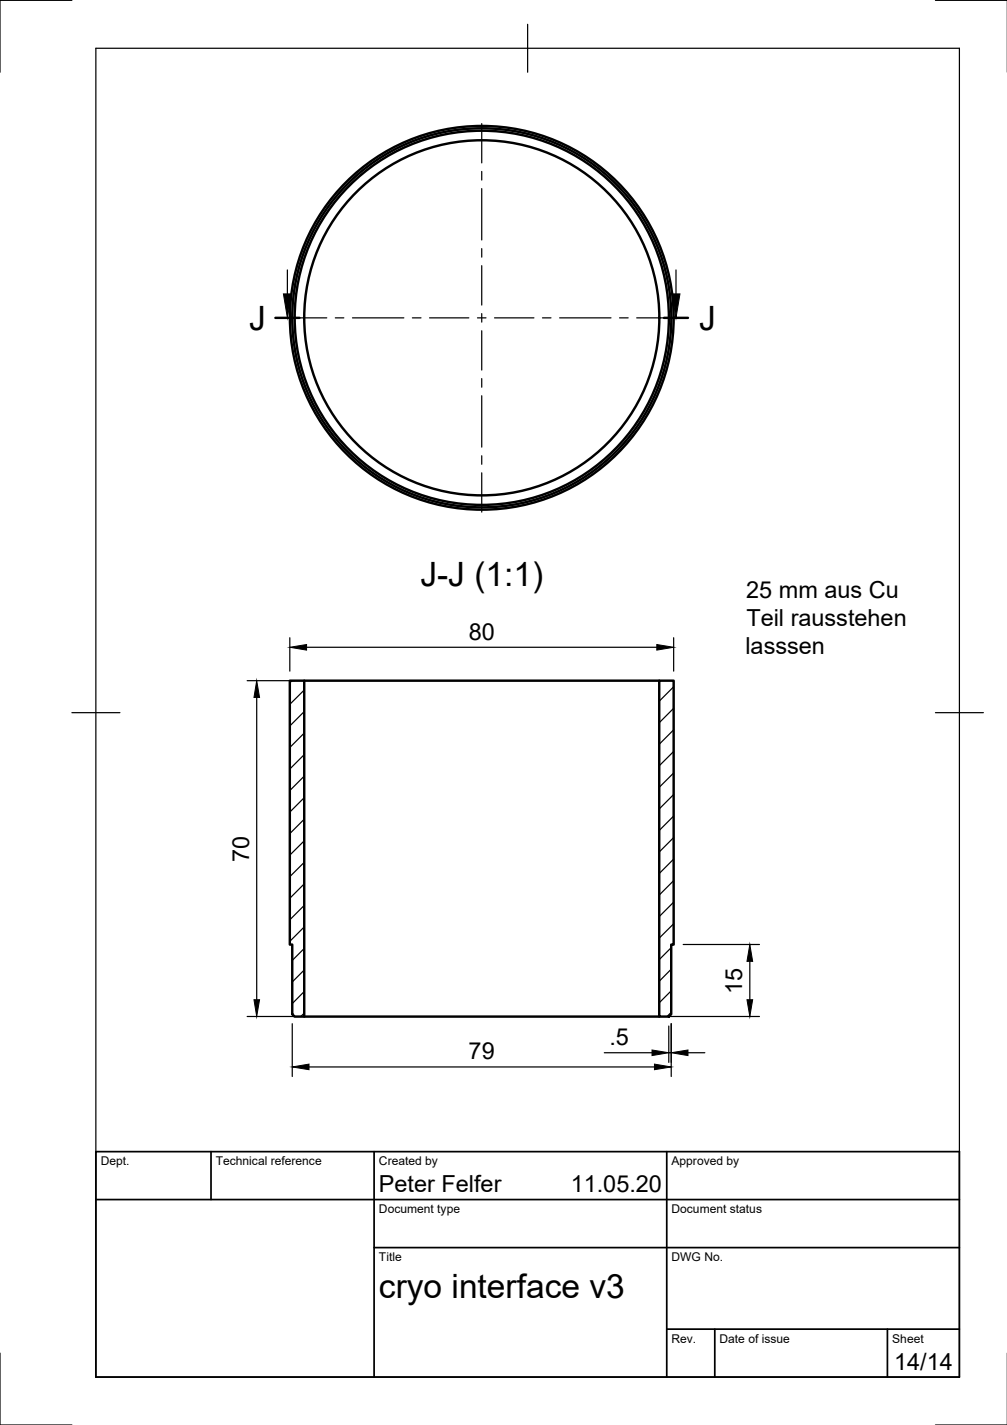
[picture p207: page 14]

25 mm aus Cu
Teil rausstehen
lasssen

Dept. | Technical reference | Created by Peter Felfer 11.05.20 | Approved by

Document type | Document status

Title cryo interface v3 | DWG No.
