peterfelfer/Oxcart/CAD/cryo/cryo system MC/cryo interface v4 Drawing v26.pdf

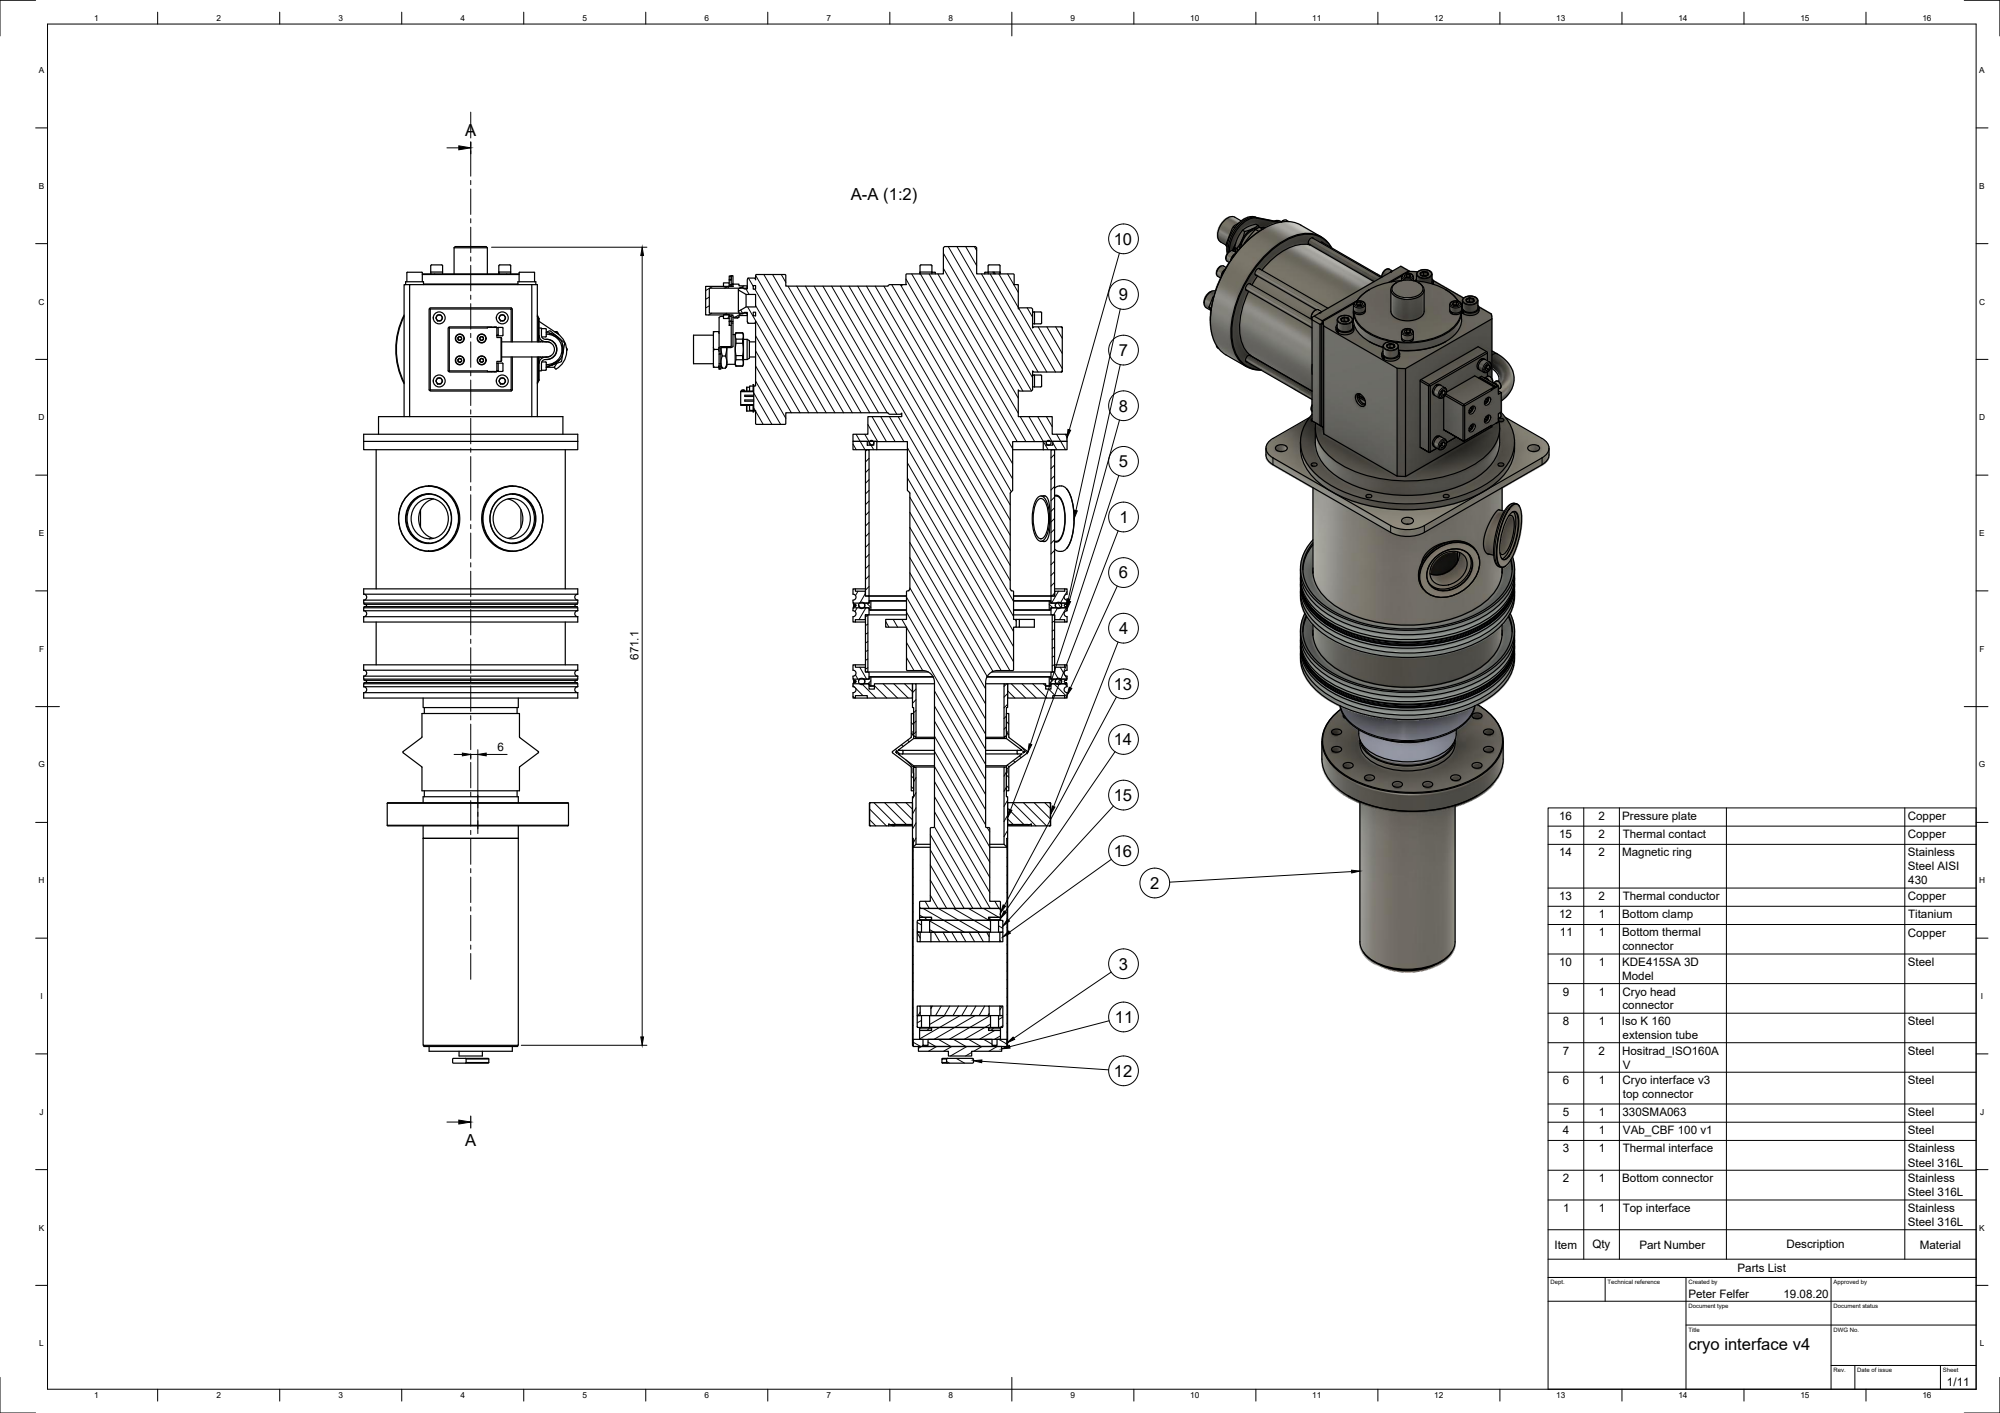
[picture p208: page 1]
16 BACDEFGHIJKL; BACDEFGHIJKL; Peter Felfer AA; Parts List; Item; Qty; Part Number; Description; Material 1; Top interface; Stainless; Steel 316L 2; Bottom connector; Steel 316L 3; Thermal interface; Steel 316L 4; VAb_CBF 100 v1; Steel 5; 330SMA063; Steel 6; Cryo interface v3; top connector; Steel 7; Hositrad_ISO160A V; Steel 8; Iso K 160; extension tube; Steel 9; Cryo head; KDE415SA 3D; Bottom thermal; Bottom clamp; Titanium; Thermal conductor; Copper; Magnetic ring; Steel AISI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

Dept. | Technical reference | Created by 19.08.20 | Approved by

Document type | Document status

Title cryo interface v4 | DWG No.

Rev. | Date of issue | Sheet

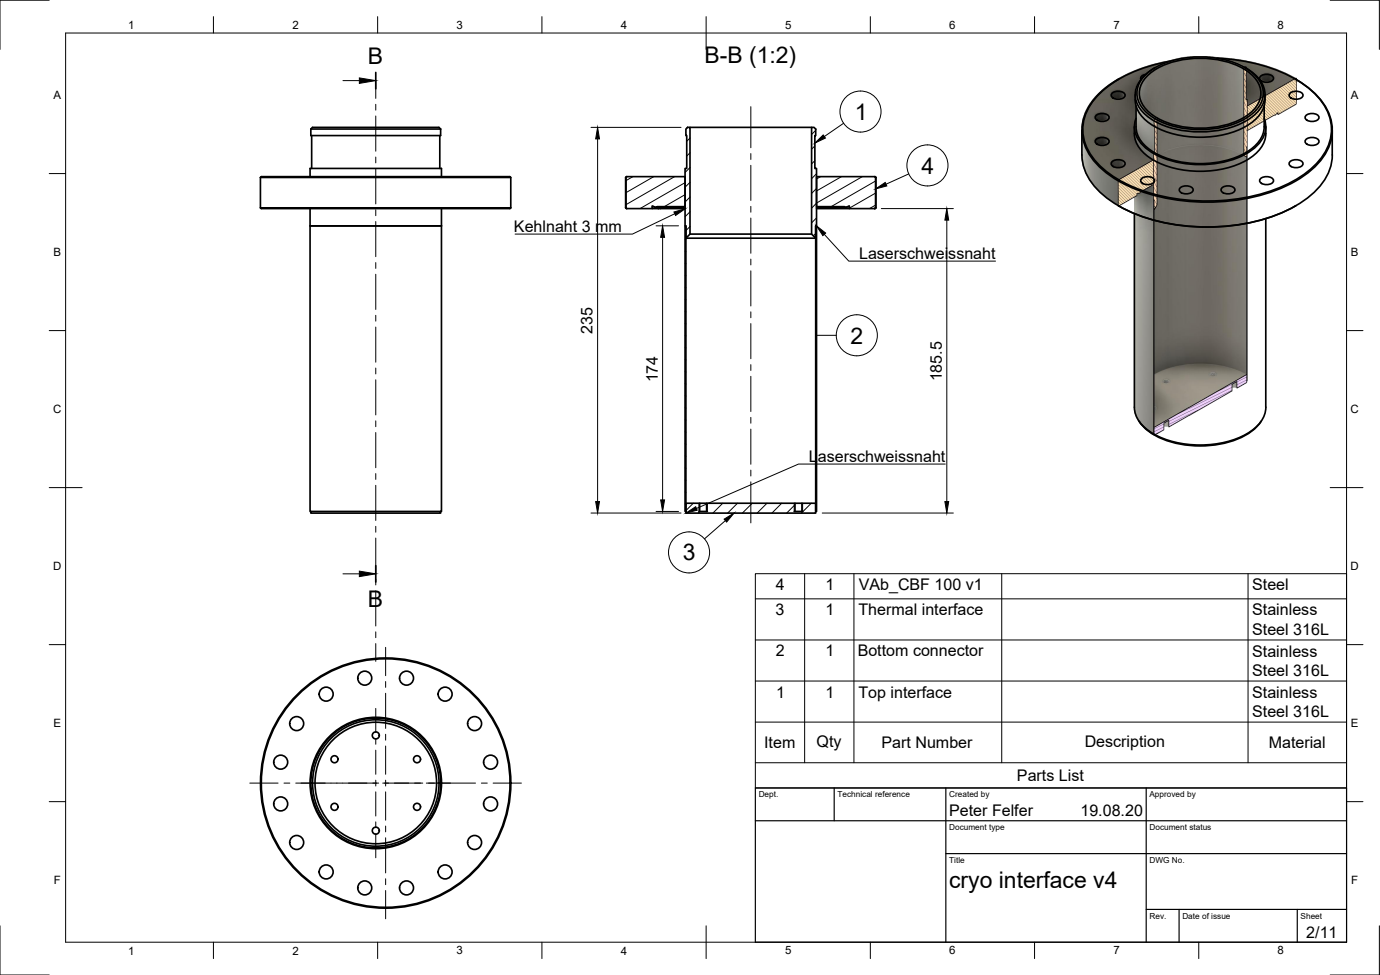
[picture p209: page 2]
Kehlnaht 3 mm; Parts List

4 | 1 | VAb_CBF 100 v1 | | Steel
3 | 1 | Thermal interface | | Stainless Steel 316L

2 | 1 | Bottom connector | | Stainless Steel 316L

1 | 1 | Top interface | | Stainless Steel 316L

Item | Qty | Part Number | Description | Material

Dept. | Technical reference | Created by Peter Felfer 19.08.20 | Approved by

Document type | Document status

Title cryo interface v4 | DWG No.

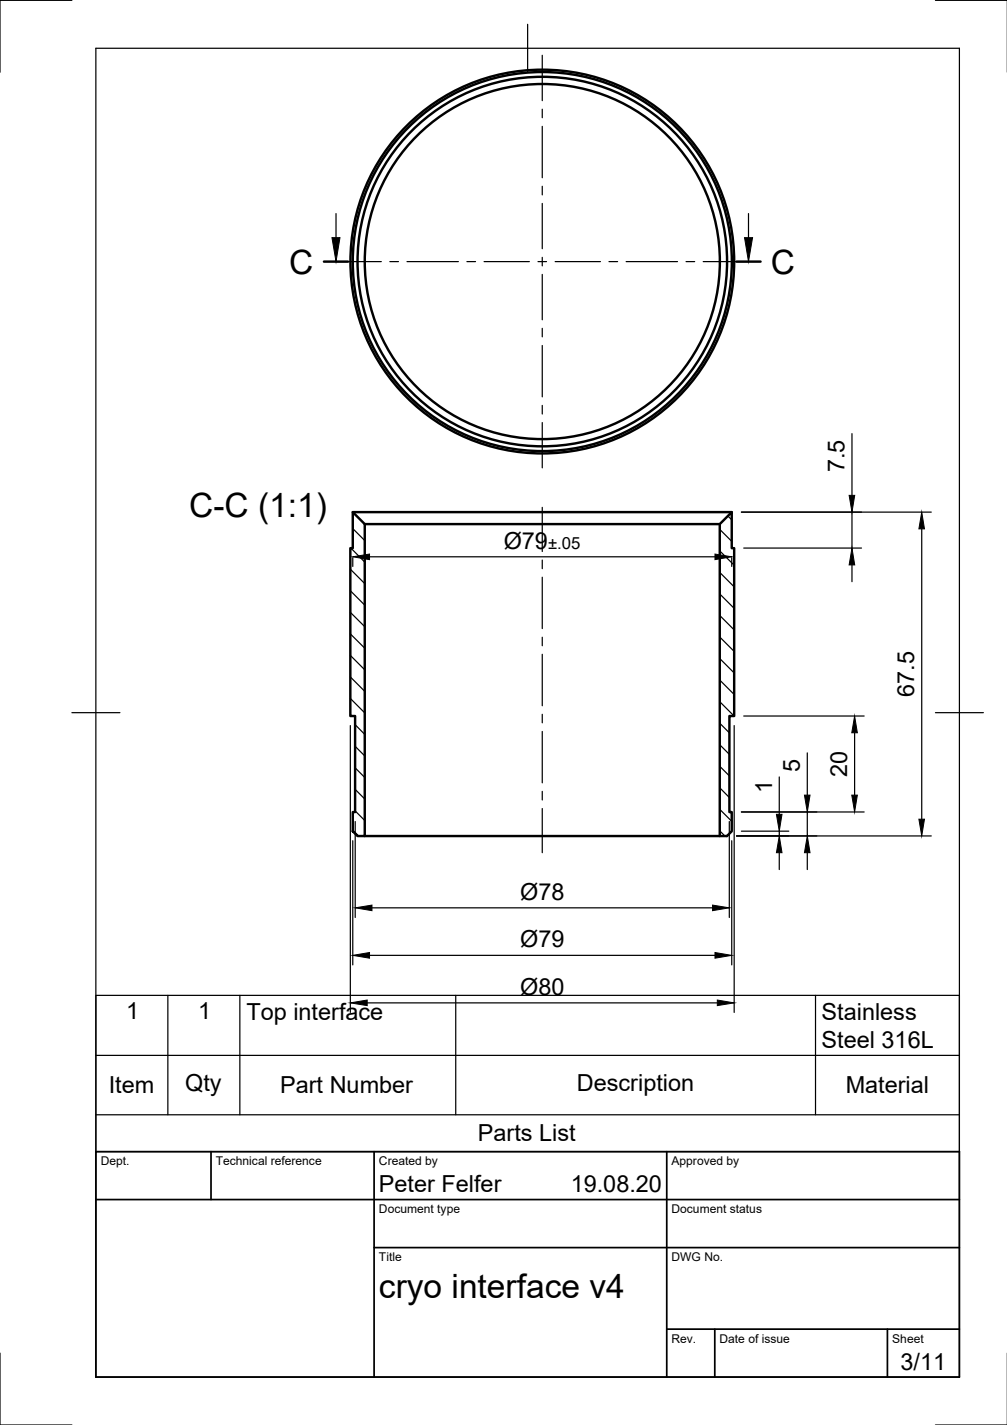
[picture p210: page 3]
Parts List

1 | 1 | Top interface | | Stainless Steel 316L

Item | Qty | Part Number | Description | Material

Dept. | Technical reference | Created by Peter Felfer 19.08.20 | Approved by

Document type | Document status

Title cryo interface v4 | DWG No.

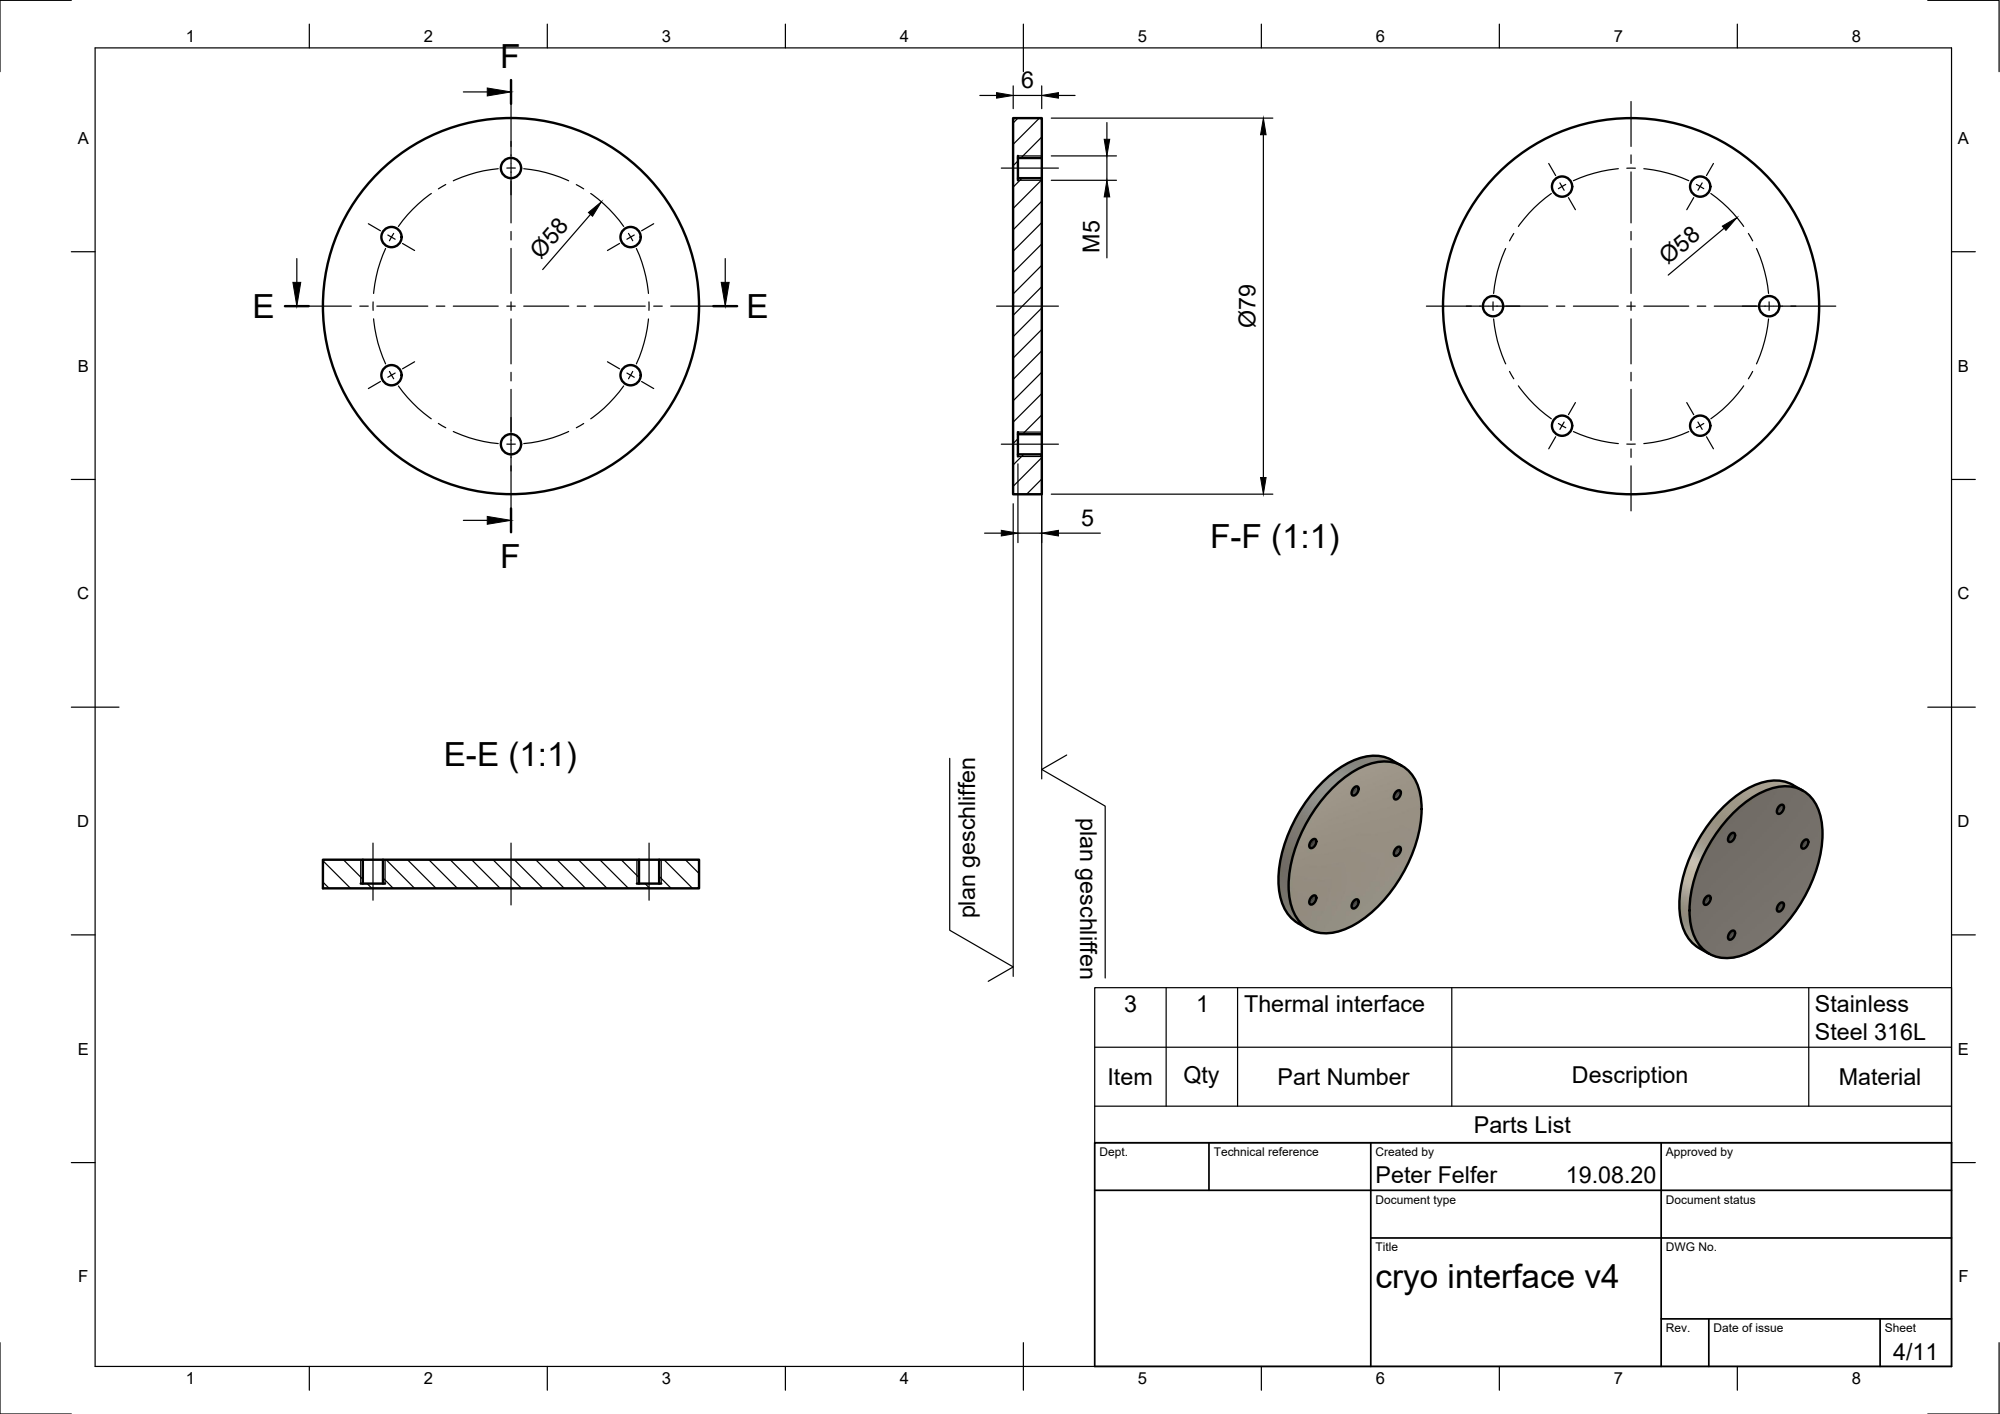
[picture p211: page 4]
Parts List

Ø58 Ø58 plan geschliffen plan geschliffen

3 | 1 | Thermal interface | | Stainless Steel 316L

Item | Qty | Part Number | Description | Material

Dept. | Technical reference | Created by Peter Felfer 19.08.20 | Approved by

Document type | Document status

Title cryo interface v4 | DWG No.

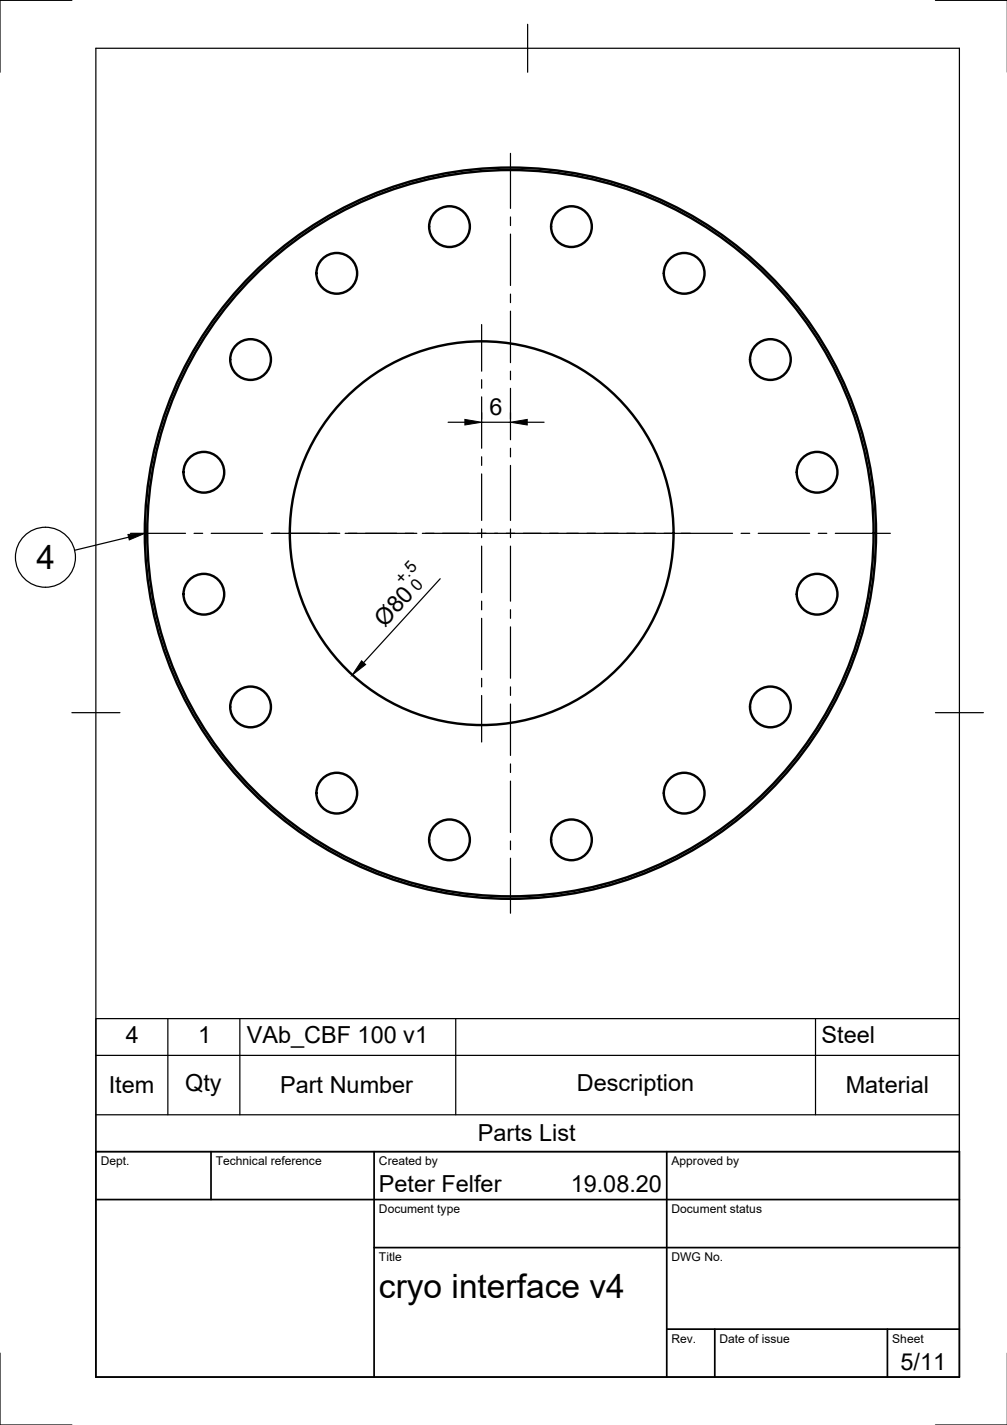
[picture p212: page 5]
Parts List

4 | 1 | VAb_CBF 100 v1 | | Steel

Item | Qty | Part Number | Description | Material

Dept. | Technical reference | Created by Peter Felfer 19.08.20 | Approved by

Document type | Document status

Title cryo interface v4 | DWG No.

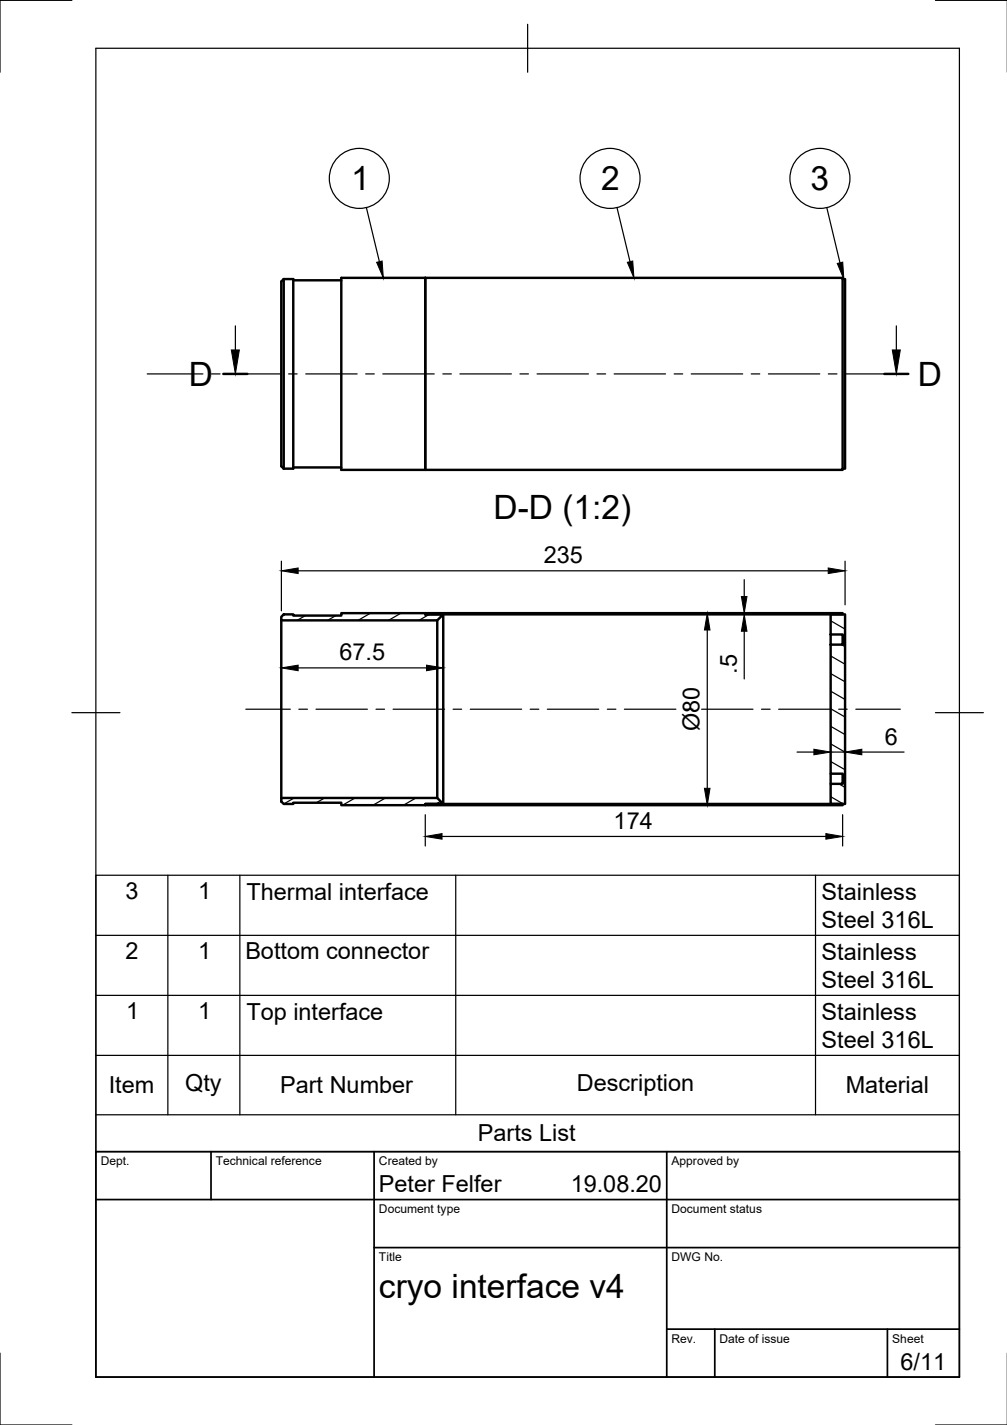
[picture p213: page 6]
Parts List

3 | 1 | Thermal interface | | Stainless Steel 316L

2 | 1 | Bottom connector | | Stainless Steel 316L

1 | 1 | Top interface | | Stainless Steel 316L

Item | Qty | Part Number | Description | Material

Dept. | Technical reference | Created by Peter Felfer 19.08.20 | Approved by

Document type | Document status

Title cryo interface v4 | DWG No.

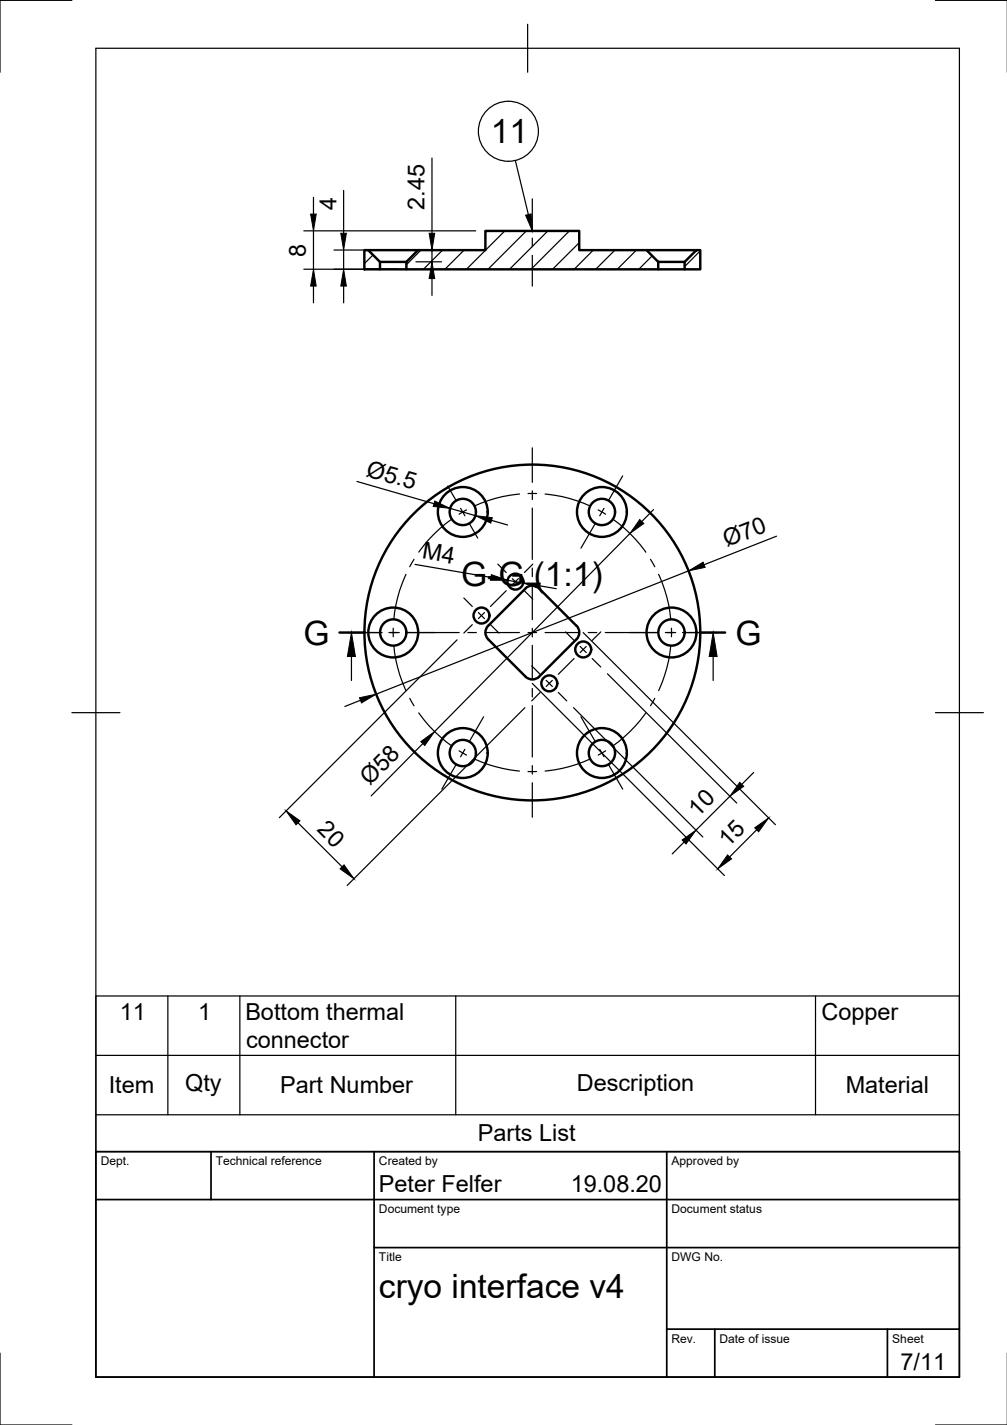
[picture p214: page 7]
Parts List

11 | 1 | Bottom thermal connector | | Copper

Item | Qty | Part Number | Description | Material

Dept. | Technical reference | Created by Peter Felfer 19.08.20 | Approved by

Document type | Document status

Title cryo interface v4 | DWG No.

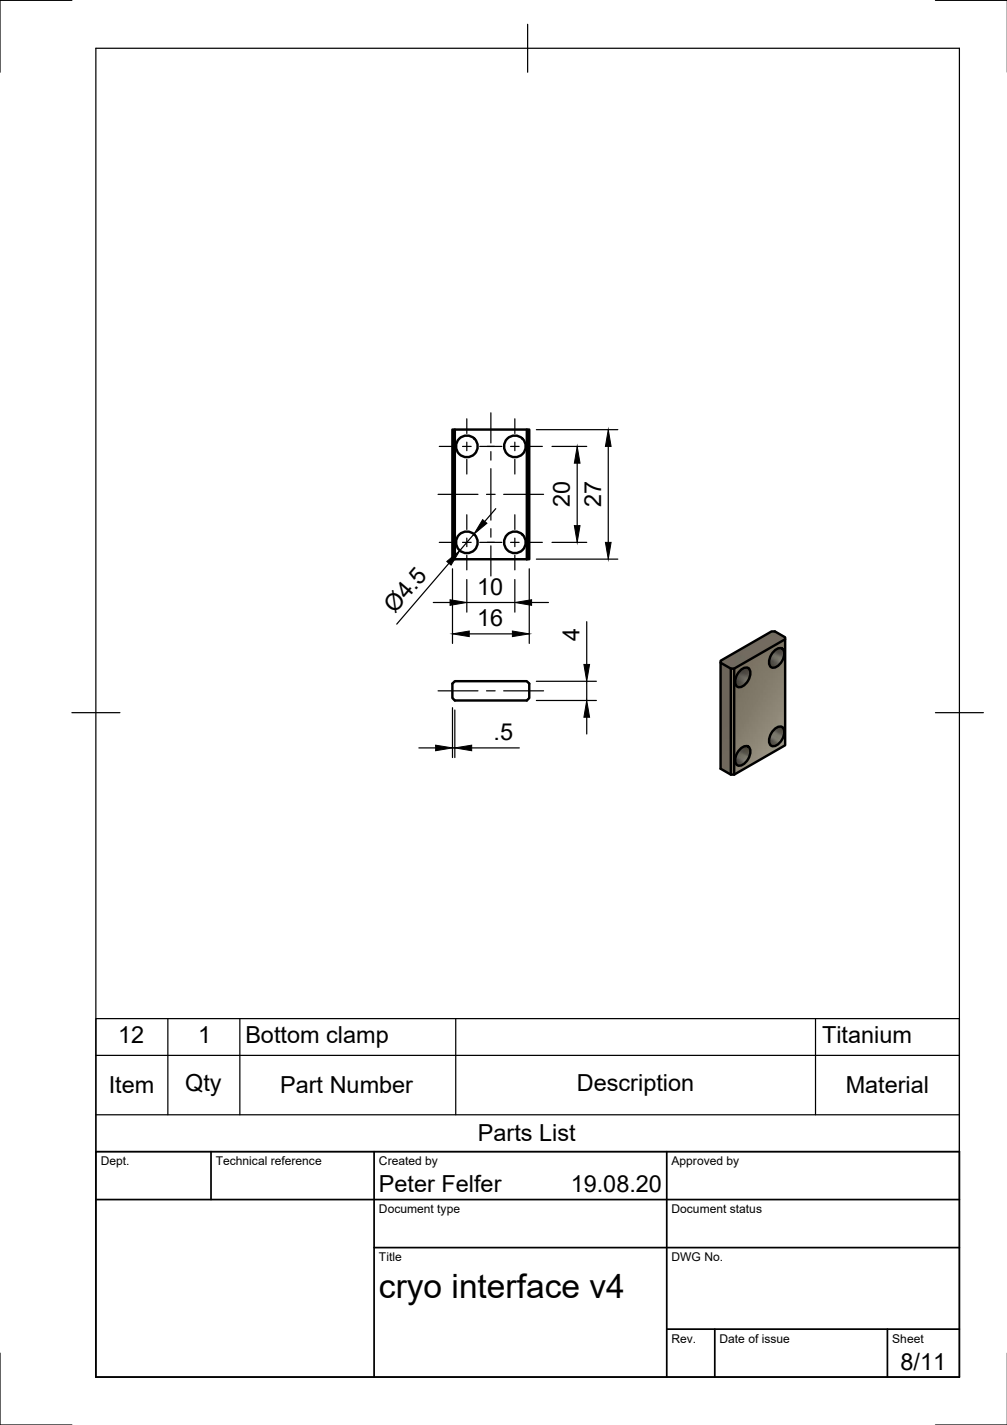
[picture p215: page 8]
Parts List

12 | 1 | Bottom clamp | | Titanium

Item | Qty | Part Number | Description | Material

Dept. | Technical reference | Created by Peter Felfer 19.08.20 | Approved by

Document type | Document status

Title cryo interface v4 | DWG No.

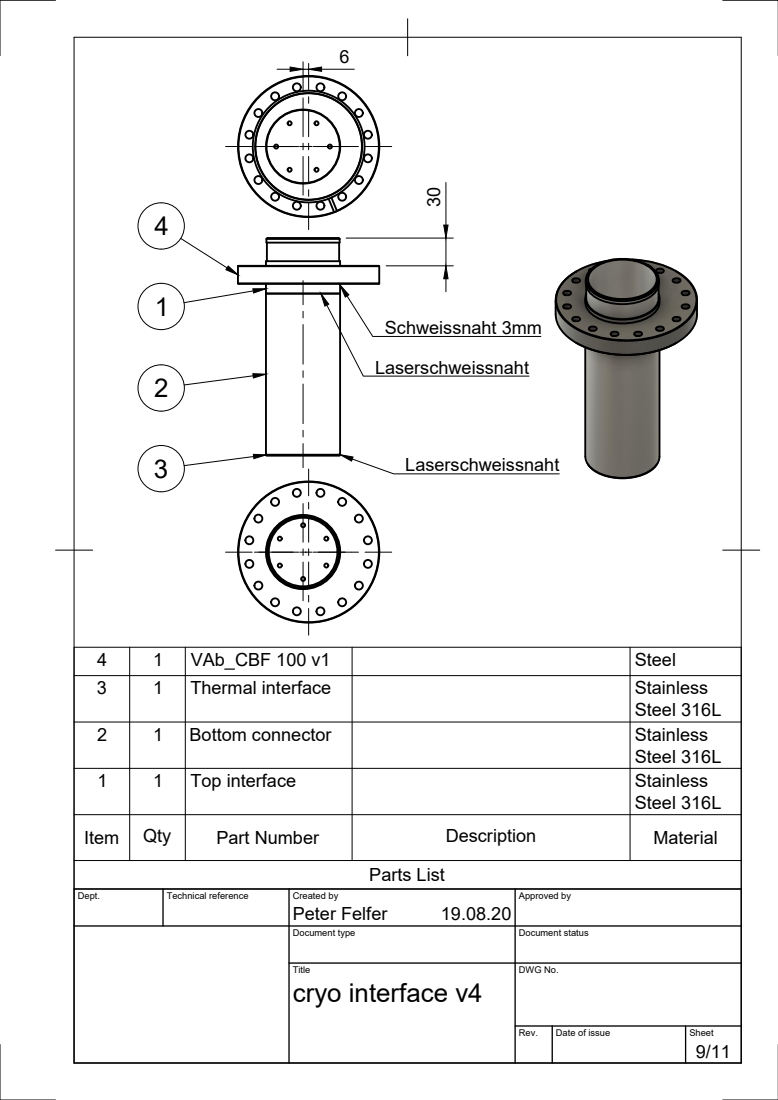
[picture p216: page 9]
Schweissnaht 3mm; Parts List; Laserschweissnaht 30

4 | 1 | VAb_CBF 100 v1 | | Steel
3 | 1 | Thermal interface | | Stainless Steel 316L

2 | 1 | Bottom connector | | Stainless Steel 316L

1 | 1 | Top interface | | Stainless Steel 316L

Item | Qty | Part Number | Description | Material

Dept. | Technical reference | Created by Peter Felfer 19.08.20 | Approved by

Document type | Document status

Title cryo interface v4 | DWG No.

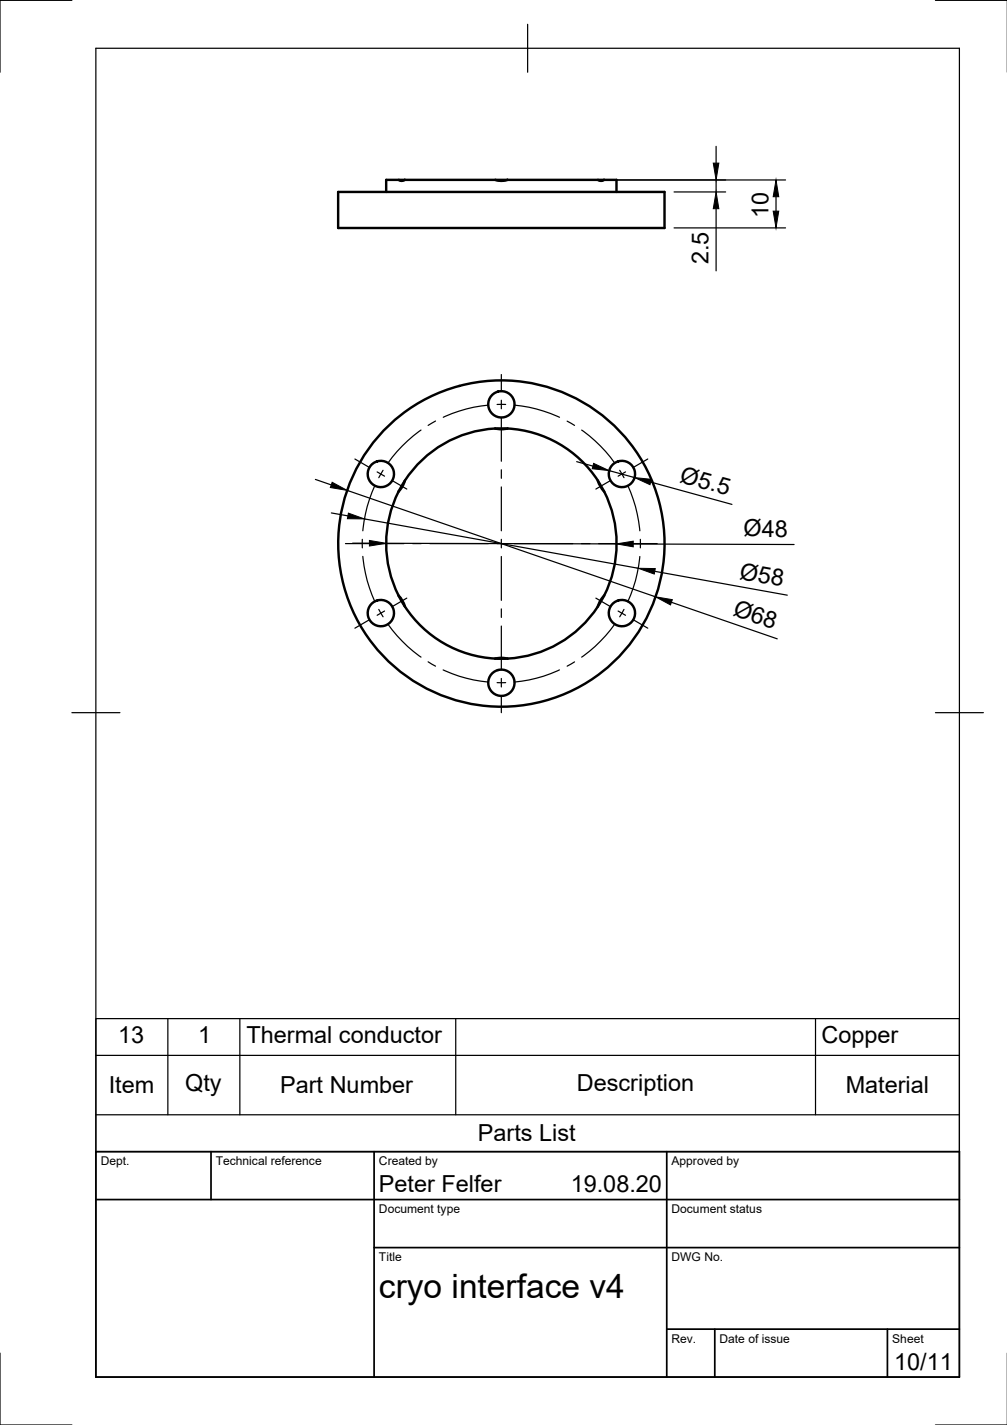
[picture p217: page 10]
Parts List; Item; Qty; Part Number; Description; Material; Thermal conductor; Copper 10 2.5

Dept. | Technical reference | Created by Peter Felfer 19.08.20 | Approved by

Document type | Document status

Title cryo interface v4 | DWG No.

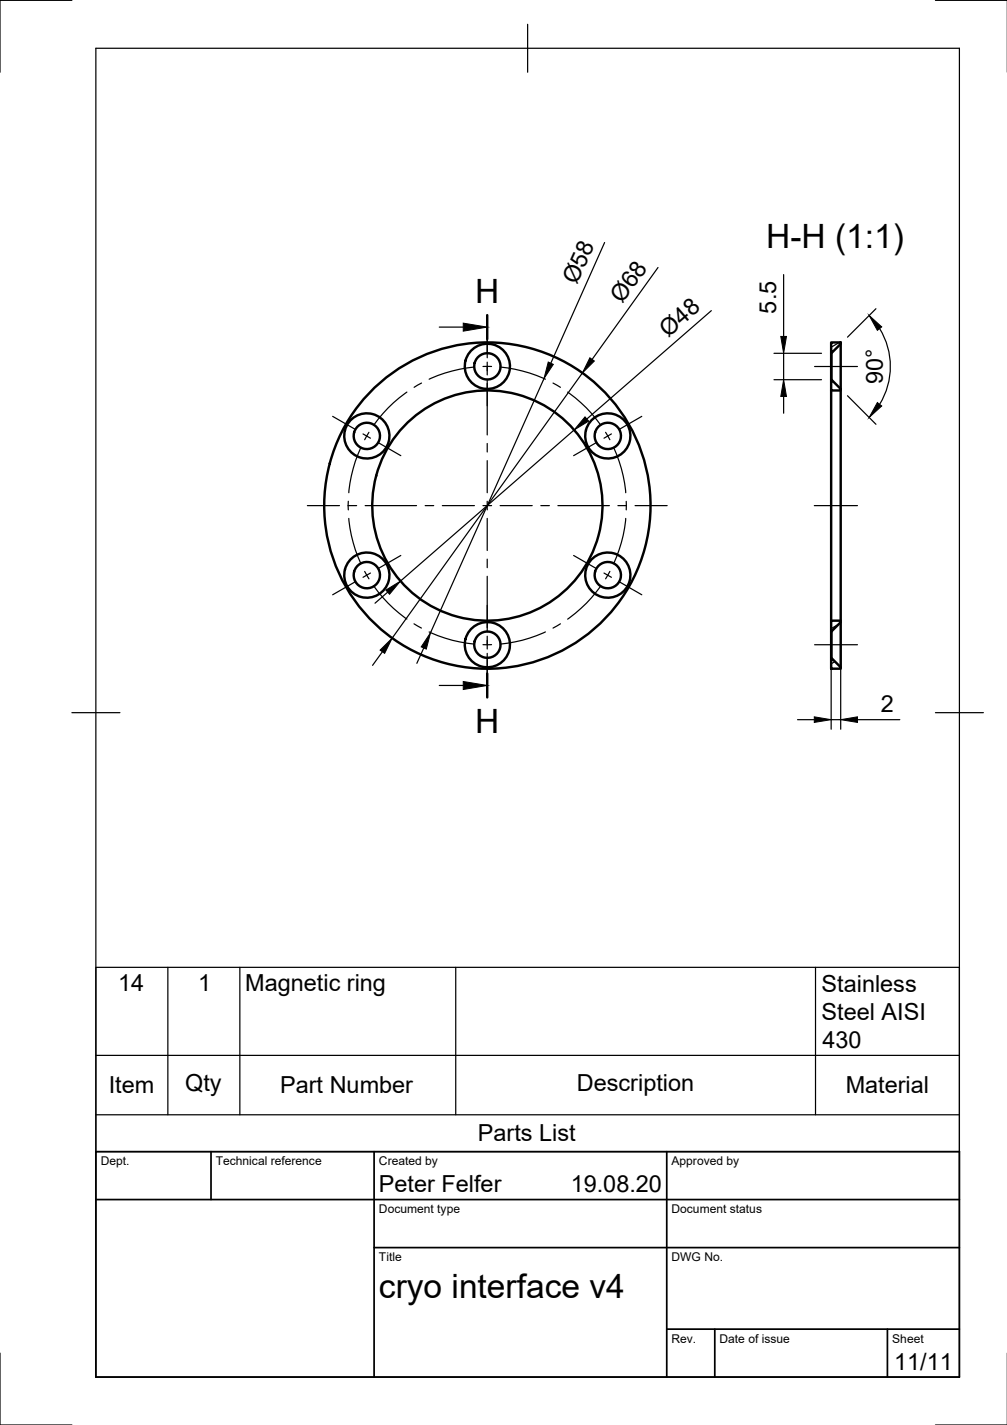
[picture p218: page 11]
Parts List

14 | 1 | Magnetic ring | | Stainless Steel AISI 430

Item | Qty | Part Number | Description | Material

Dept. | Technical reference | Created by Peter Felfer 19.08.20 | Approved by

Document type | Document status

Title cryo interface v4 | DWG No.
