peterfelfer/Oxcart/CAD/cryo/cryo system MC/cryointerface v4 heating bracket Drawing v3.pdf

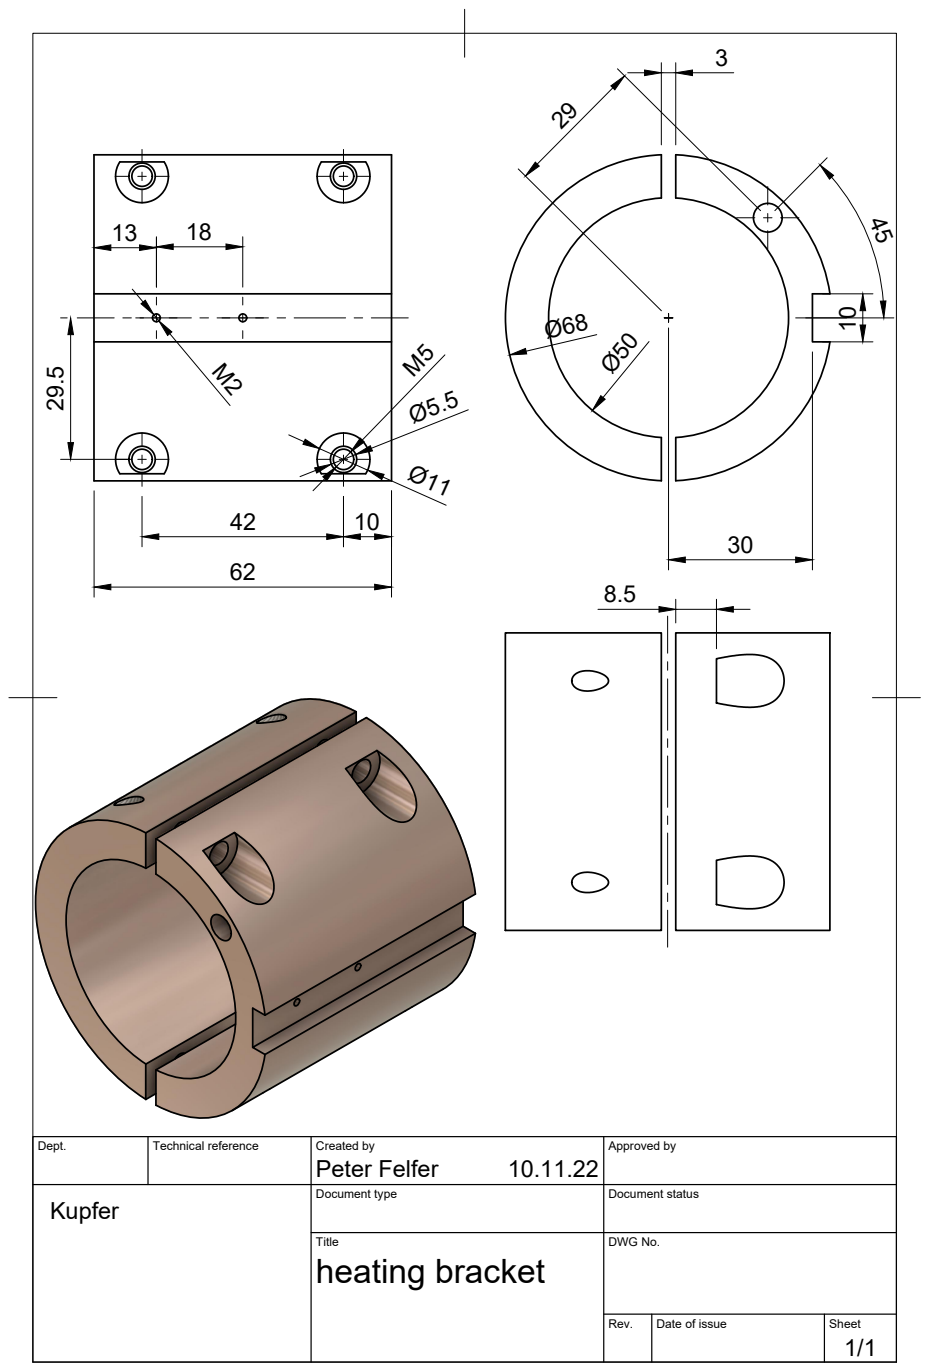
[picture p219: page 1]

Dept. | Technical reference | Created by Peter Felfer 10.11.22 | Approved by

Kupfer | | Document type | Document status

Title heating bracket | DWG No.

Rev. | Date of issue | Sheet 1/1
