peterfelfer/Oxcart/CAD/cryo/cryo system MC/shield connector Drawing v1.pdf

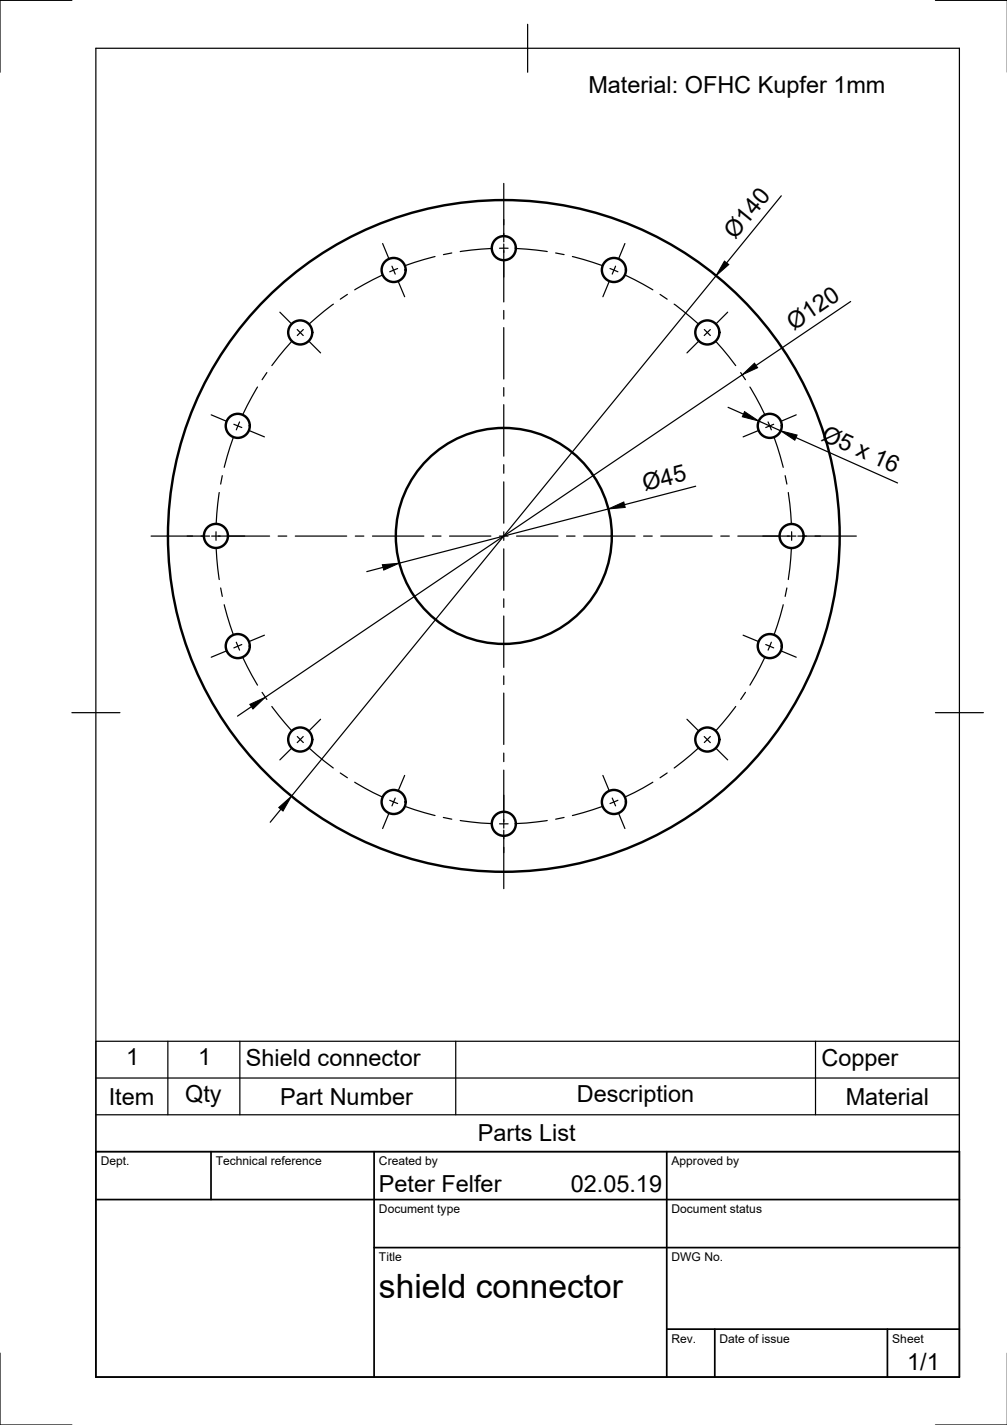
[picture p220: page 1]
Parts List

Material: OFHC Kupfer 1mm

1 | 1 | Shield connector | | Copper
Item | Qty | Part Number | Description | Material

Dept. | Technical reference | Created by Peter Felfer 02.05.19 | Approved by

Document type | Document status

Title shield connector | DWG No.

Rev. | Date of issue | Sheet 1/1
