peterfelfer/Oxcart/CAD/cryo/cryo system MC/stage 1 shield Drawing v1.pdf

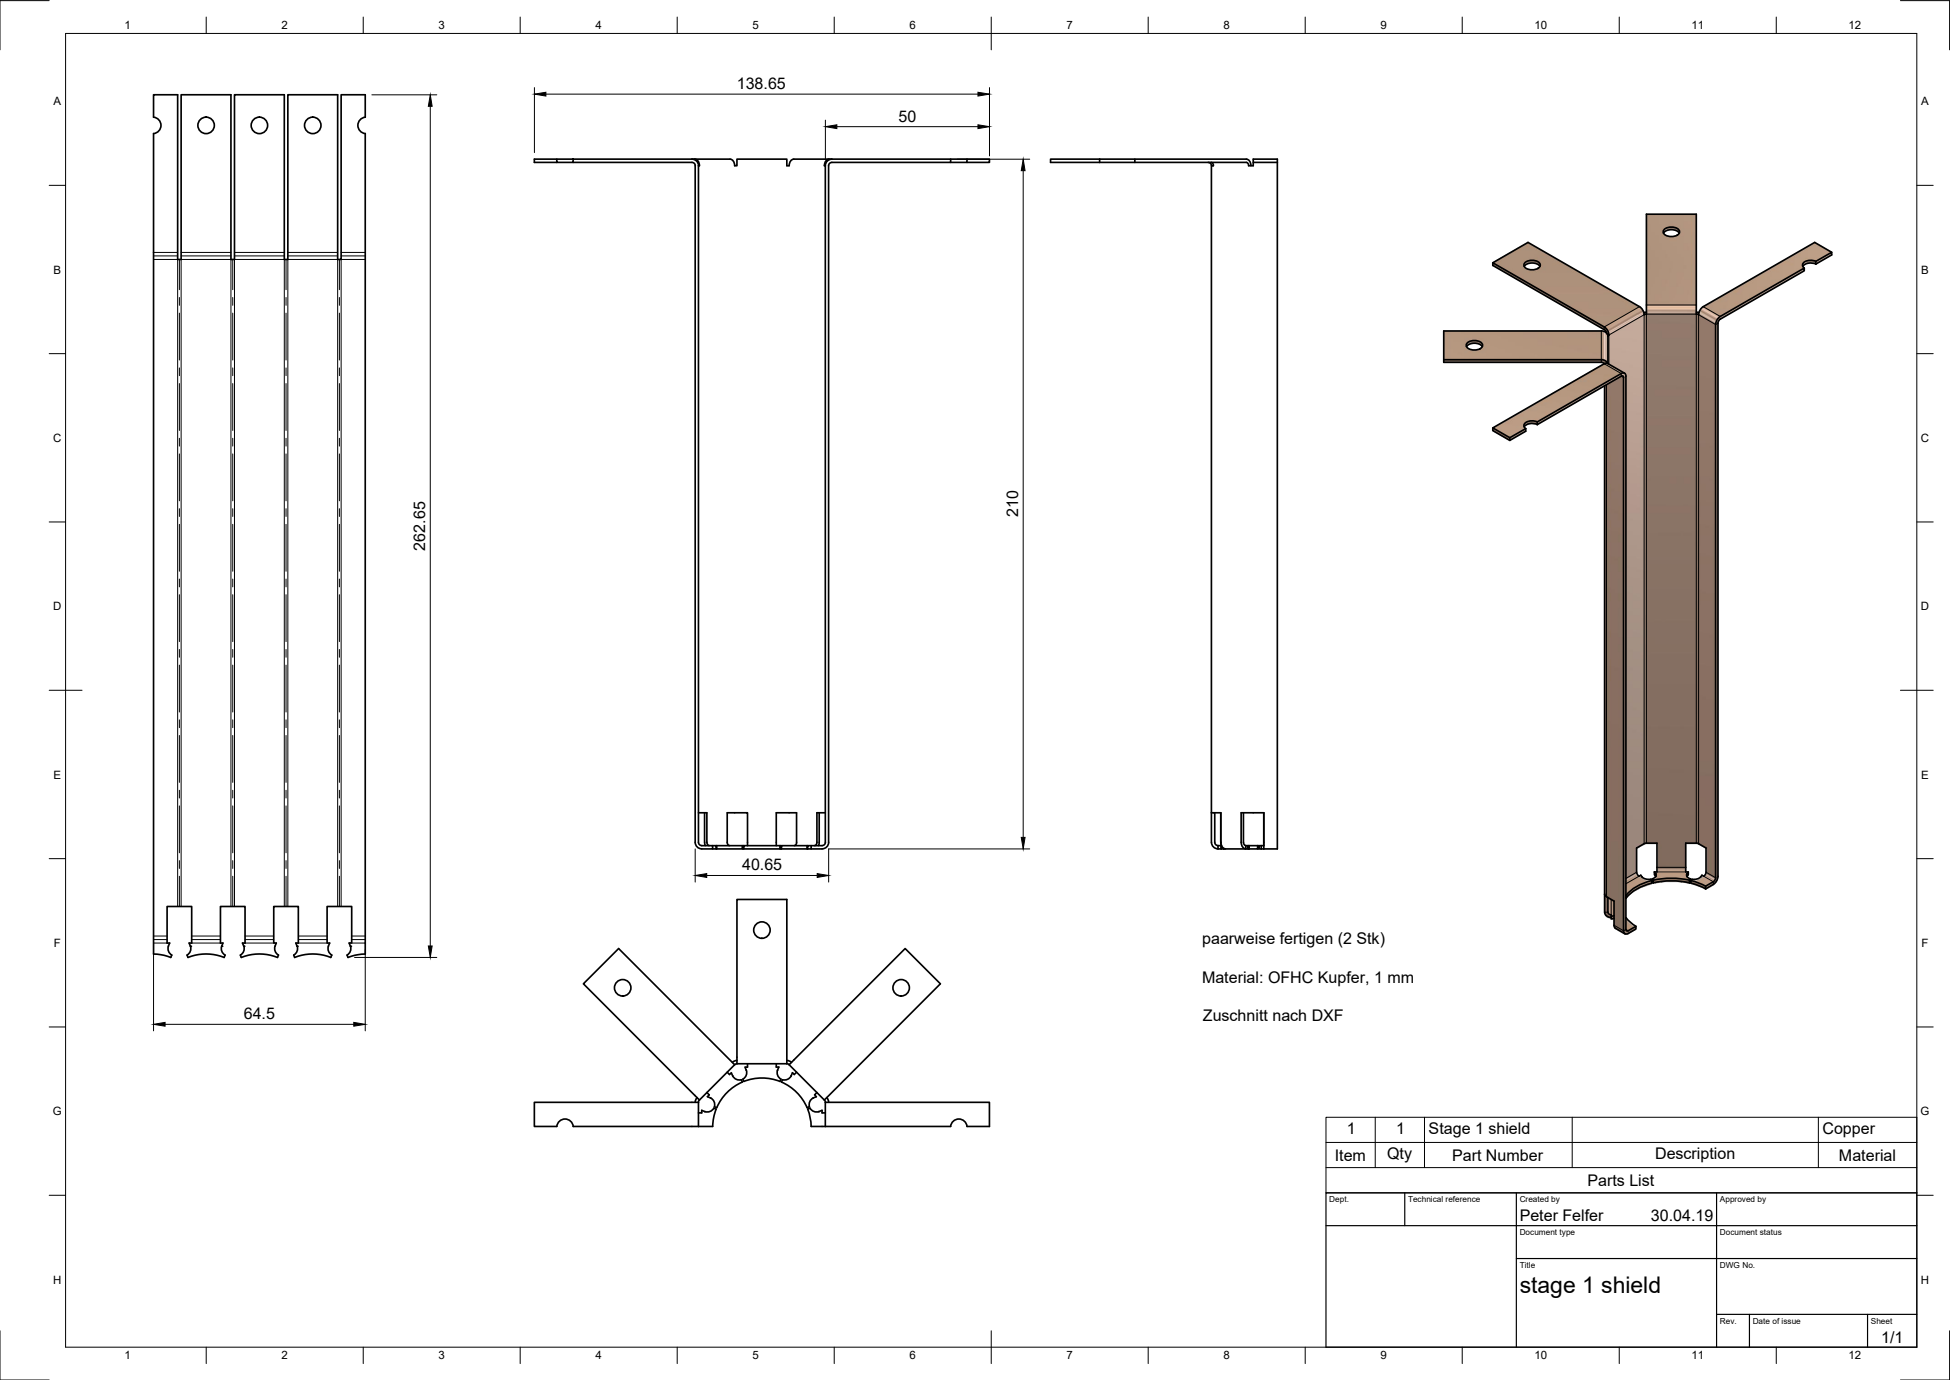
[picture p221: page 1]
Parts List; Item; Qty; Part Number; Description; Material; Stage 1 shield; Copper 210

paarweise fertigen (2 Stk)

Material: OFHC Kupfer, 1 mm

Zuschnitt nach DXF

Dept. | Technical reference | Created by Peter Felfer 30.04.19 | Approved by

Document type | Document status

Title stage 1 shield | DWG No.

Rev. | Date of issue | Sheet 1/1
