peterfelfer/Oxcart/CAD/cryo/cryo system MC/stage 2 connector clamp Drawing v2.pdf

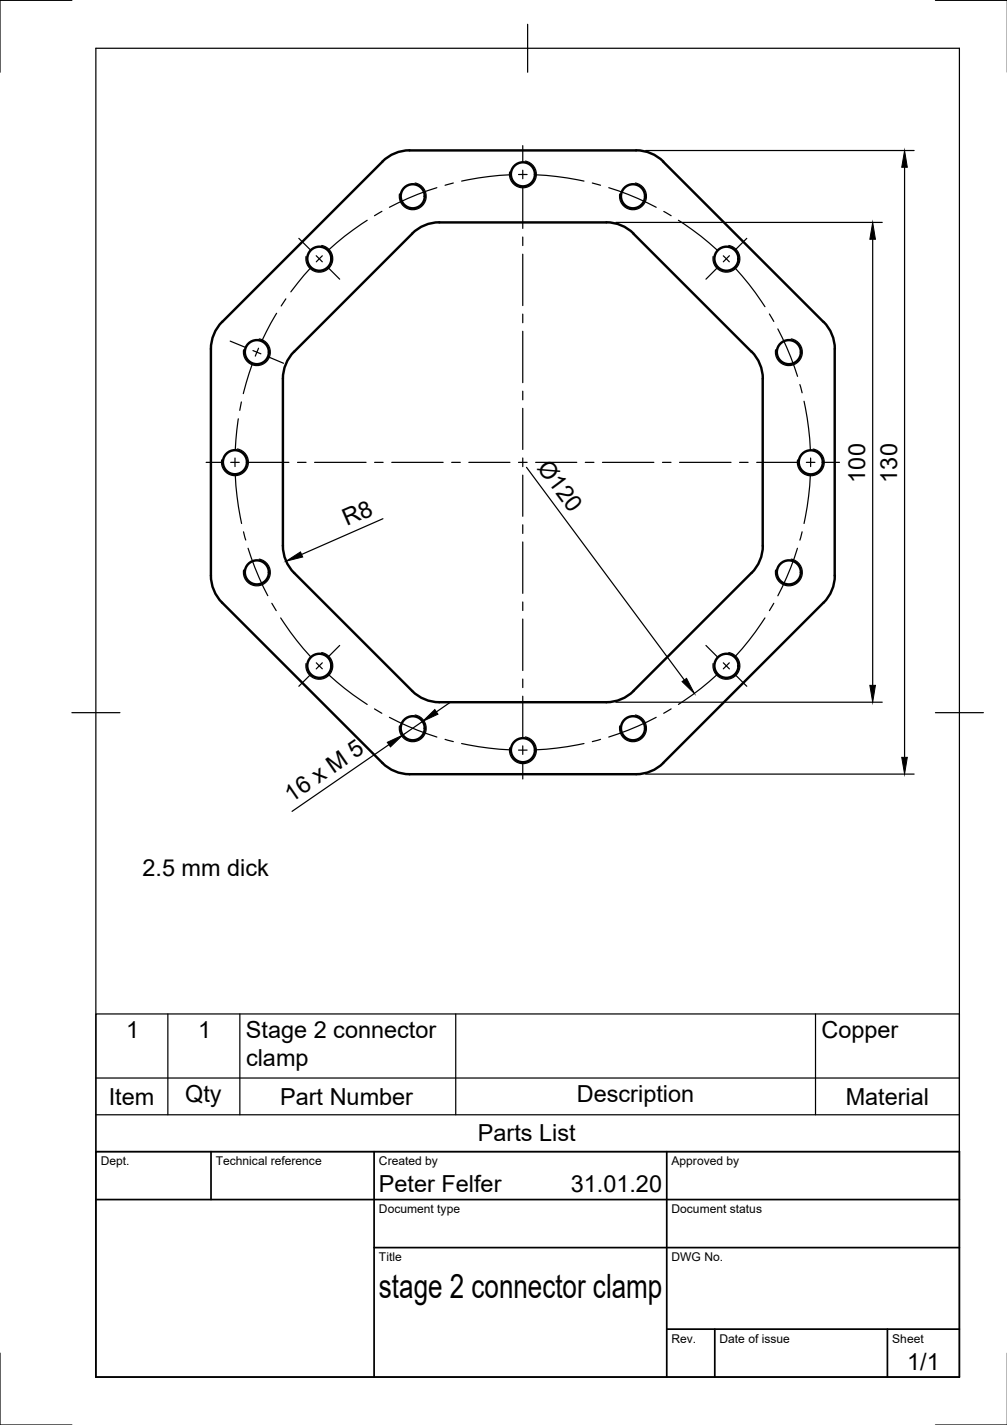
[picture p222: page 1]
2.5 mm dick; Parts List

1 | 1 | Stage 2 connector clamp | | Copper

Item | Qty | Part Number | Description | Material

Dept. | Technical reference | Created by Peter Felfer 31.01.20 | Approved by

Document type | Document status

Title stage 2 connector clamp | DWG No.

Rev. | Date of issue | Sheet 1/1
