peterfelfer/Oxcart/CAD/cryo/cryo system MC/stage 2 connector Cu lamellae Drawing v5.pdf

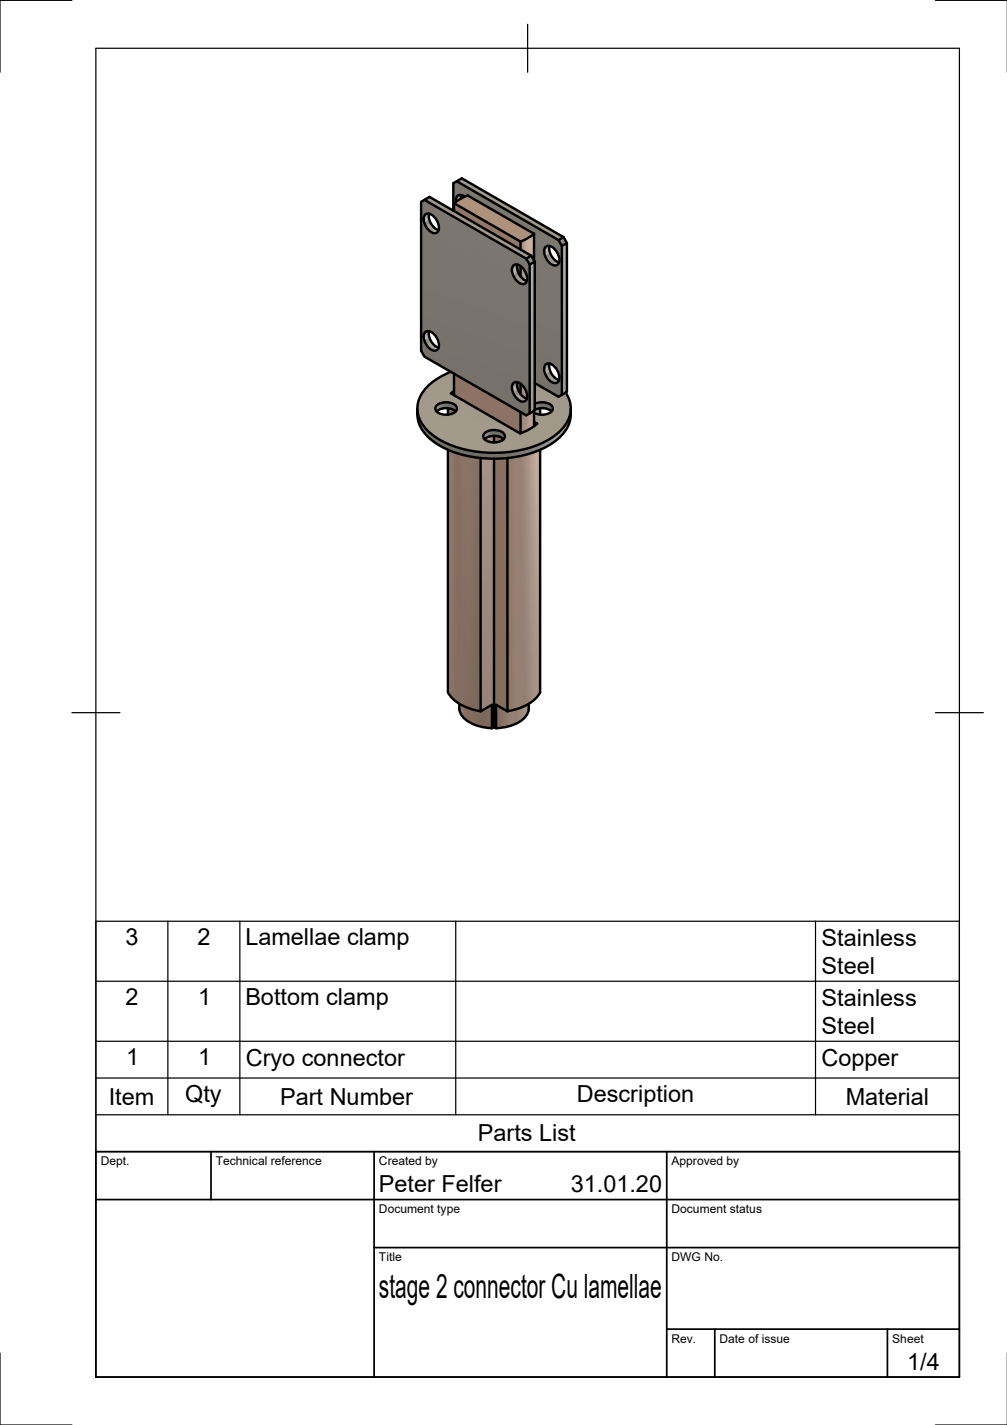
[picture p223: page 1]
Parts List

3 | 2 | Lamellae clamp | | Stainless Steel

2 | 1 | Bottom clamp | | Stainless Steel

1 | 1 | Cryo connector | | Copper
Item | Qty | Part Number | Description | Material

Dept. | Technical reference | Created by Peter Felfer 31.01.20 | Approved by

Document type | Document status

Title stage 2 connector Cu lamellae | DWG No.

Rev. | Date of issue | Sheet

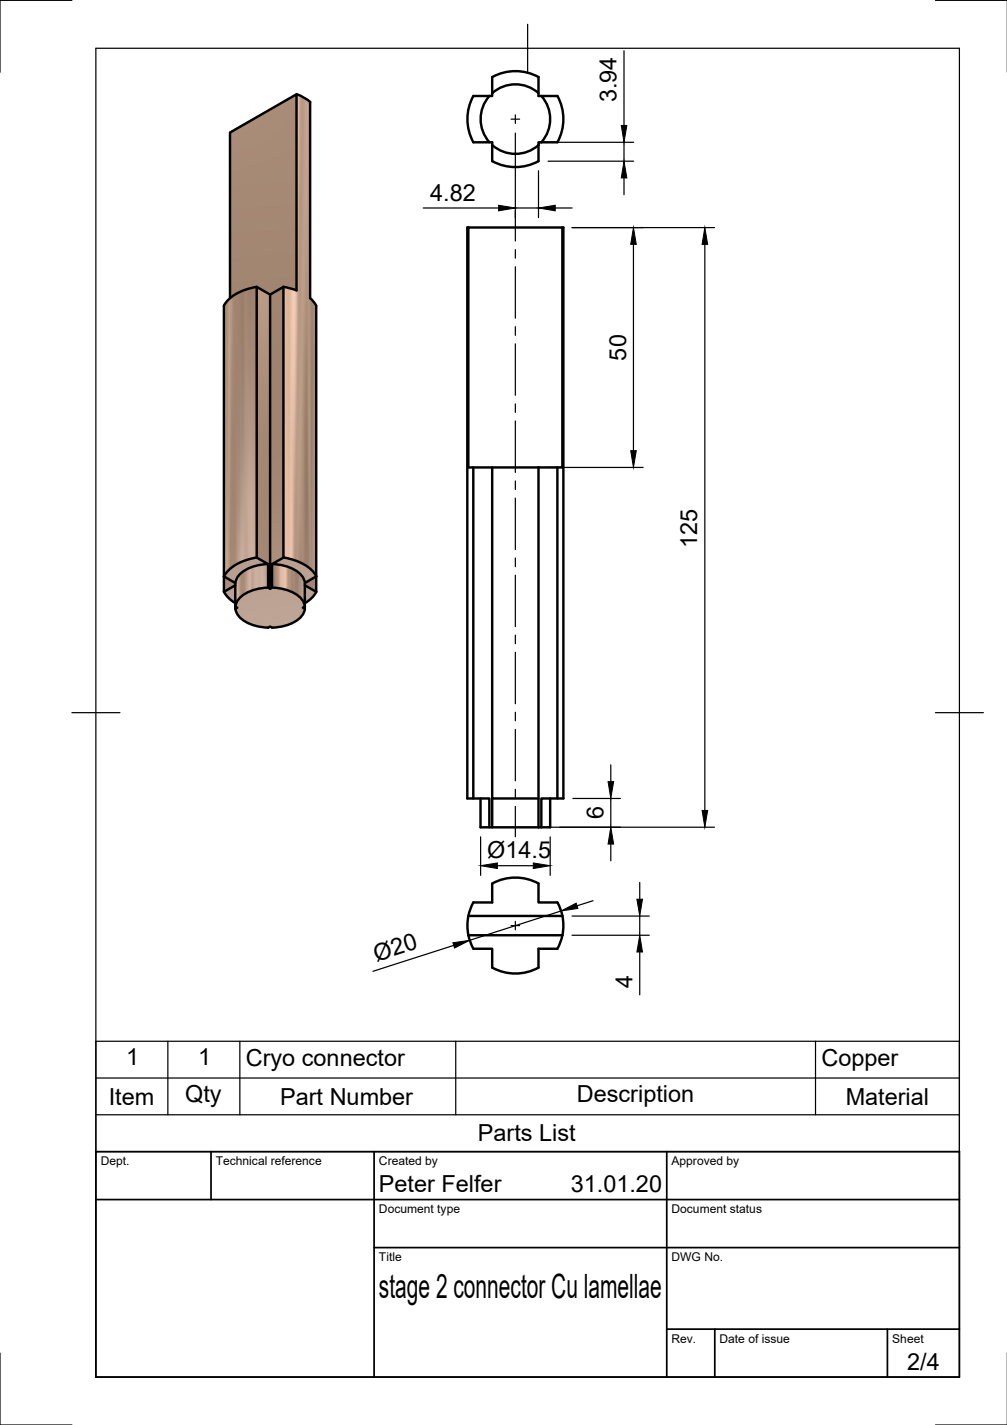
[picture p224: page 2]
Peter Felfer; Parts List

1 | 1 | Cryo connector | | Copper
Item | Qty | Part Number | Description | Material

Dept. | Technical reference | Created by 31.01.20 | Approved by

Document type | Document status

Title stage 2 connector Cu lamellae | DWG No.

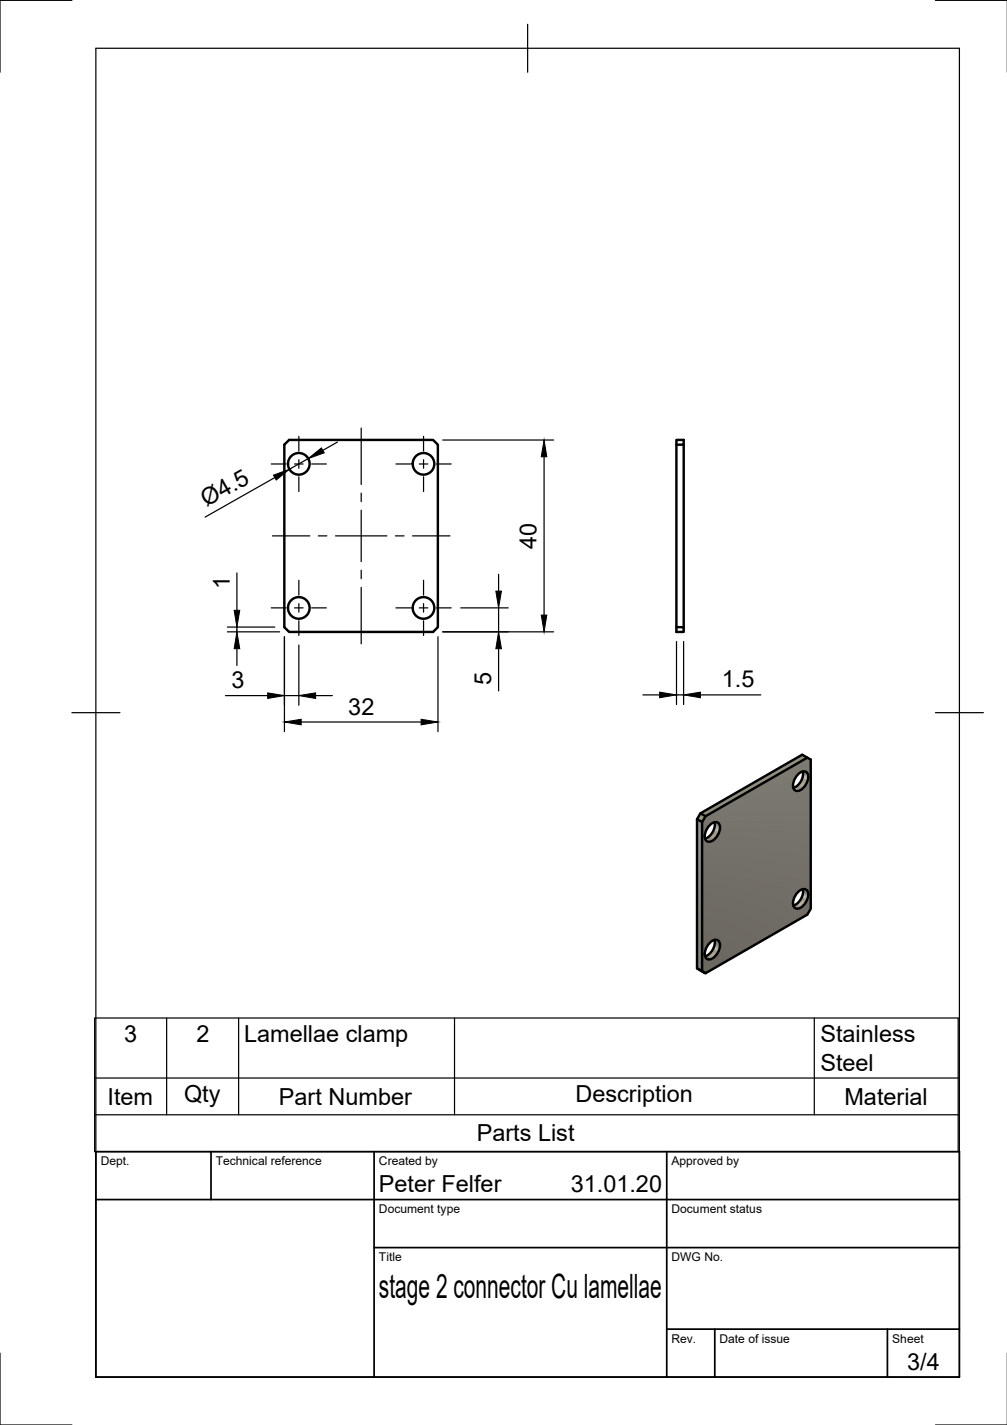
[picture p225: page 3]
Peter Felfer 40; Parts List

3 | 2 | Lamellae clamp | | Stainless Steel

Item | Qty | Part Number | Description | Material

Dept. | Technical reference | Created by 31.01.20 | Approved by

Document type | Document status

Title stage 2 connector Cu lamellae | DWG No.

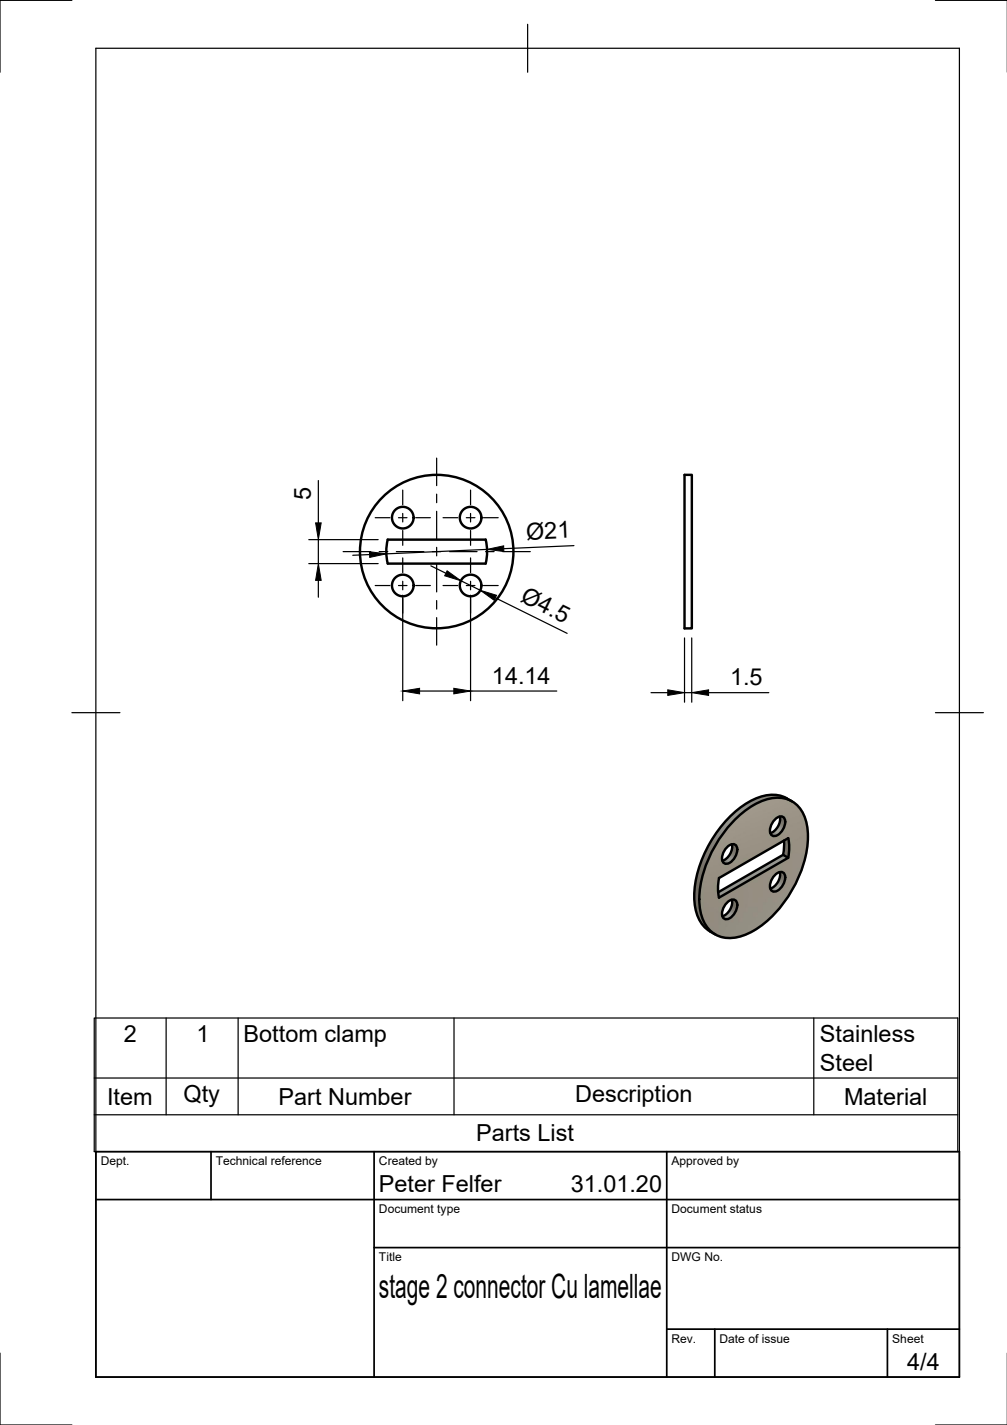
[picture p226: page 4]
Parts List

2 | 1 | Bottom clamp | | Stainless Steel

Item | Qty | Part Number | Description | Material

Dept. | Technical reference | Created by Peter Felfer 31.01.20 | Approved by

Document type | Document status

Title stage 2 connector Cu lamellae | DWG No.
