peterfelfer/Oxcart/CAD/cryo/cryo system MC/stage 2 shield 2 clamps Drawing v2.pdf

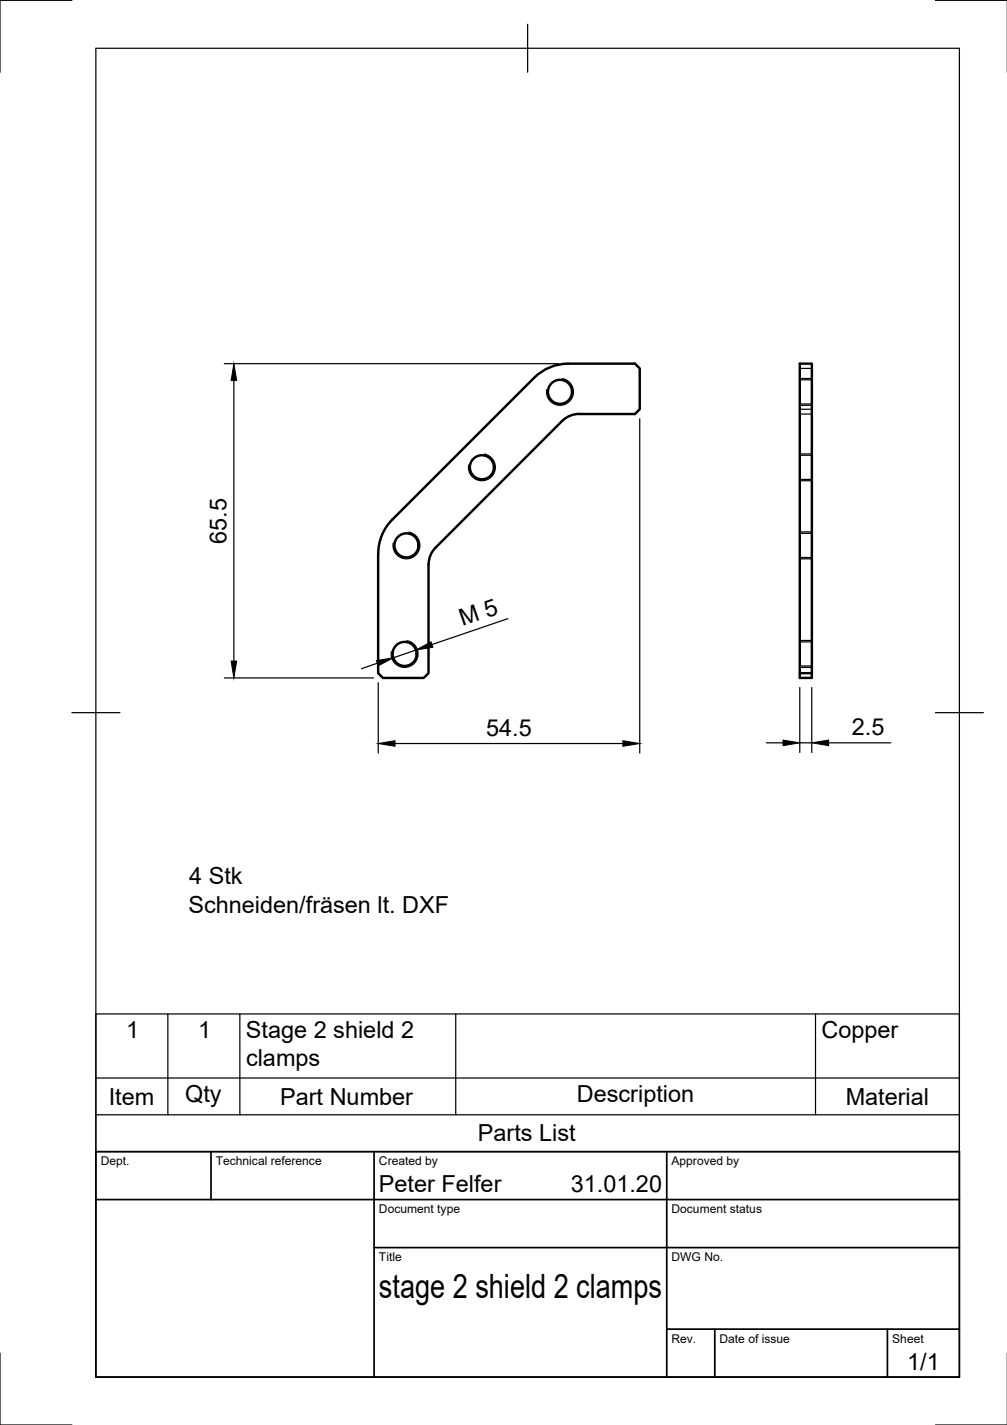
[picture p227: page 1]
4 Stk; Parts List

Schneiden/fräsen lt. DXF 65.5

1 | 1 | Stage 2 shield 2 clamps | | Copper

Item | Qty | Part Number | Description | Material

Dept. | Technical reference | Created by Peter Felfer 31.01.20 | Approved by

Document type | Document status

Title stage 2 shield 2 clamps | DWG No.

Rev. | Date of issue | Sheet 1/1
