peterfelfer/Oxcart/CAD/cryo/cryo system MC/stage 2 shield 2 clamps top Drawing v5.pdf

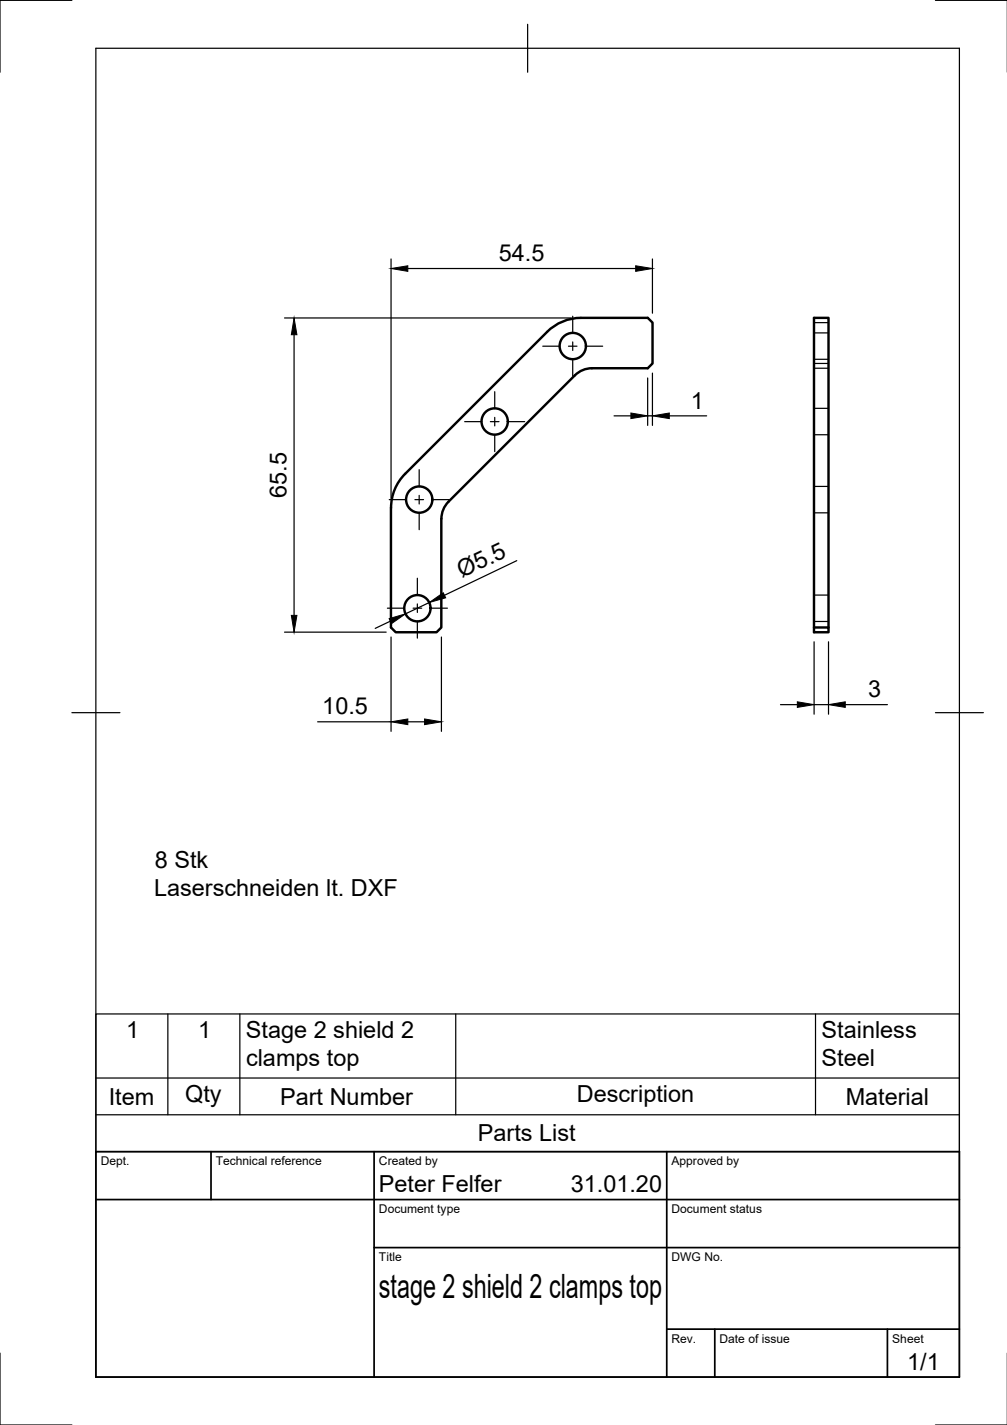
[picture p228: page 1]
Parts List

8 Stk
Laserschneiden lt. DXF

1 | 1 | Stage 2 shield 2 clamps top | | Stainless Steel

Item | Qty | Part Number | Description | Material

Dept. | Technical reference | Created by Peter Felfer 31.01.20 | Approved by

Document type | Document status

Title stage 2 shield 2 clamps top | DWG No.

Rev. | Date of issue | Sheet 1/1
