peterfelfer/Oxcart/CAD/cryo/cryo system MC/stage 2 shield 2 Drawing v3.pdf

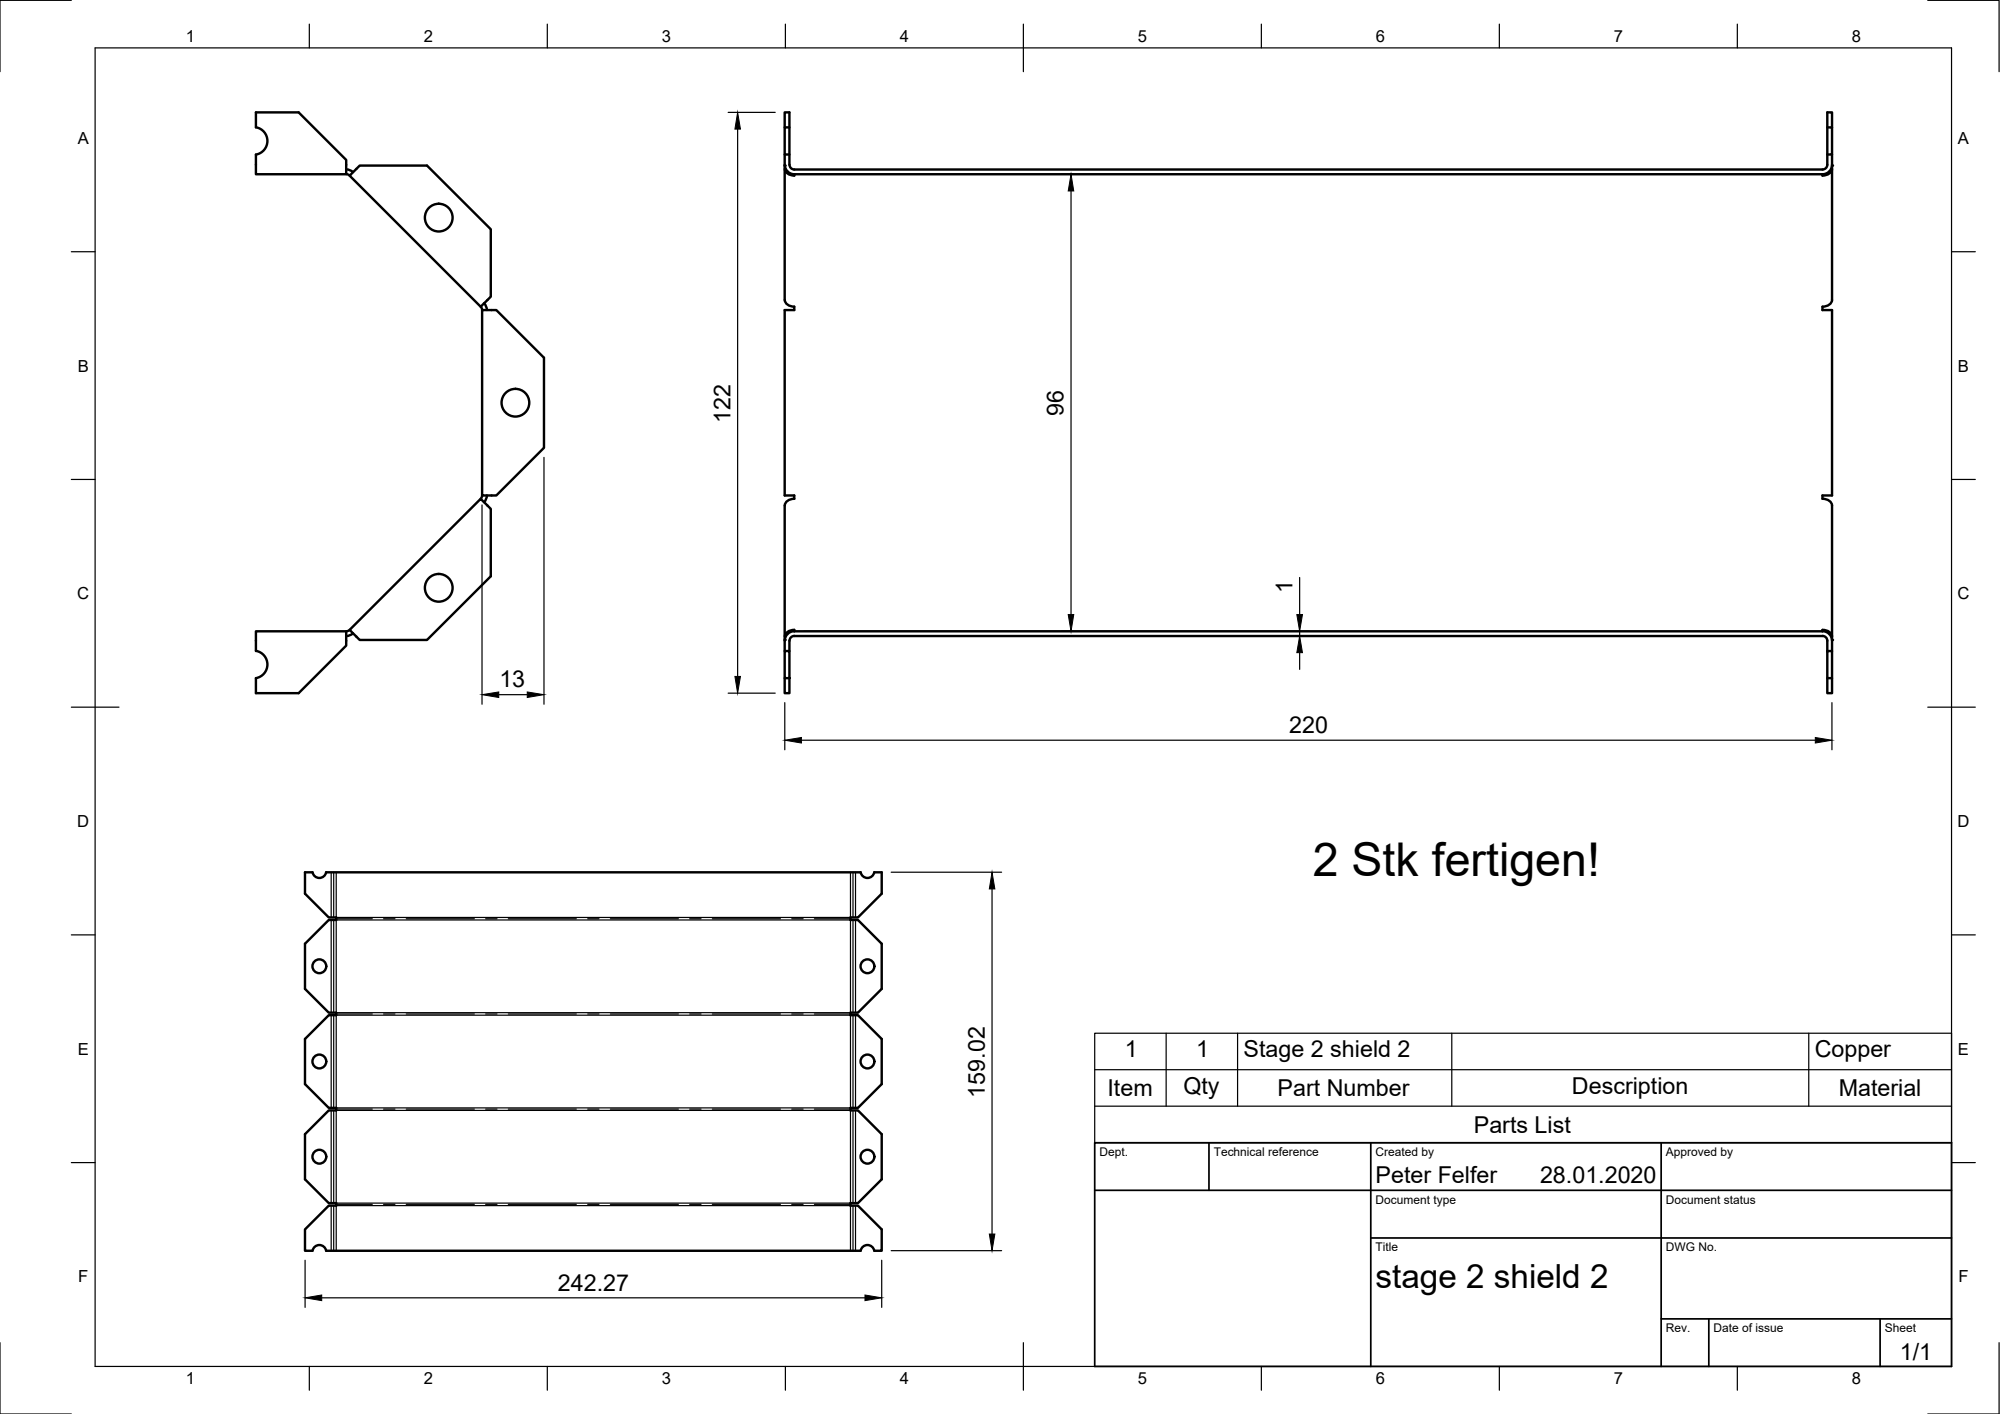
[picture p229: page 1]
Parts List; 2 Stk fertigen!

1 | 1 | Stage 2 shield 2 | Copper 159.02

Item | Qty | Part Number | Description | Material

Dept. | Technical reference | Created by Peter Felfer 28.01.2020 | Approved by

Document type | Document status

Title stage 2 shield 2 | DWG No.

Rev. | Date of issue | Sheet 1/1
