peterfelfer/Oxcart/CAD/cryo/cryo system MC/stage 2 shield Drawing v2.pdf

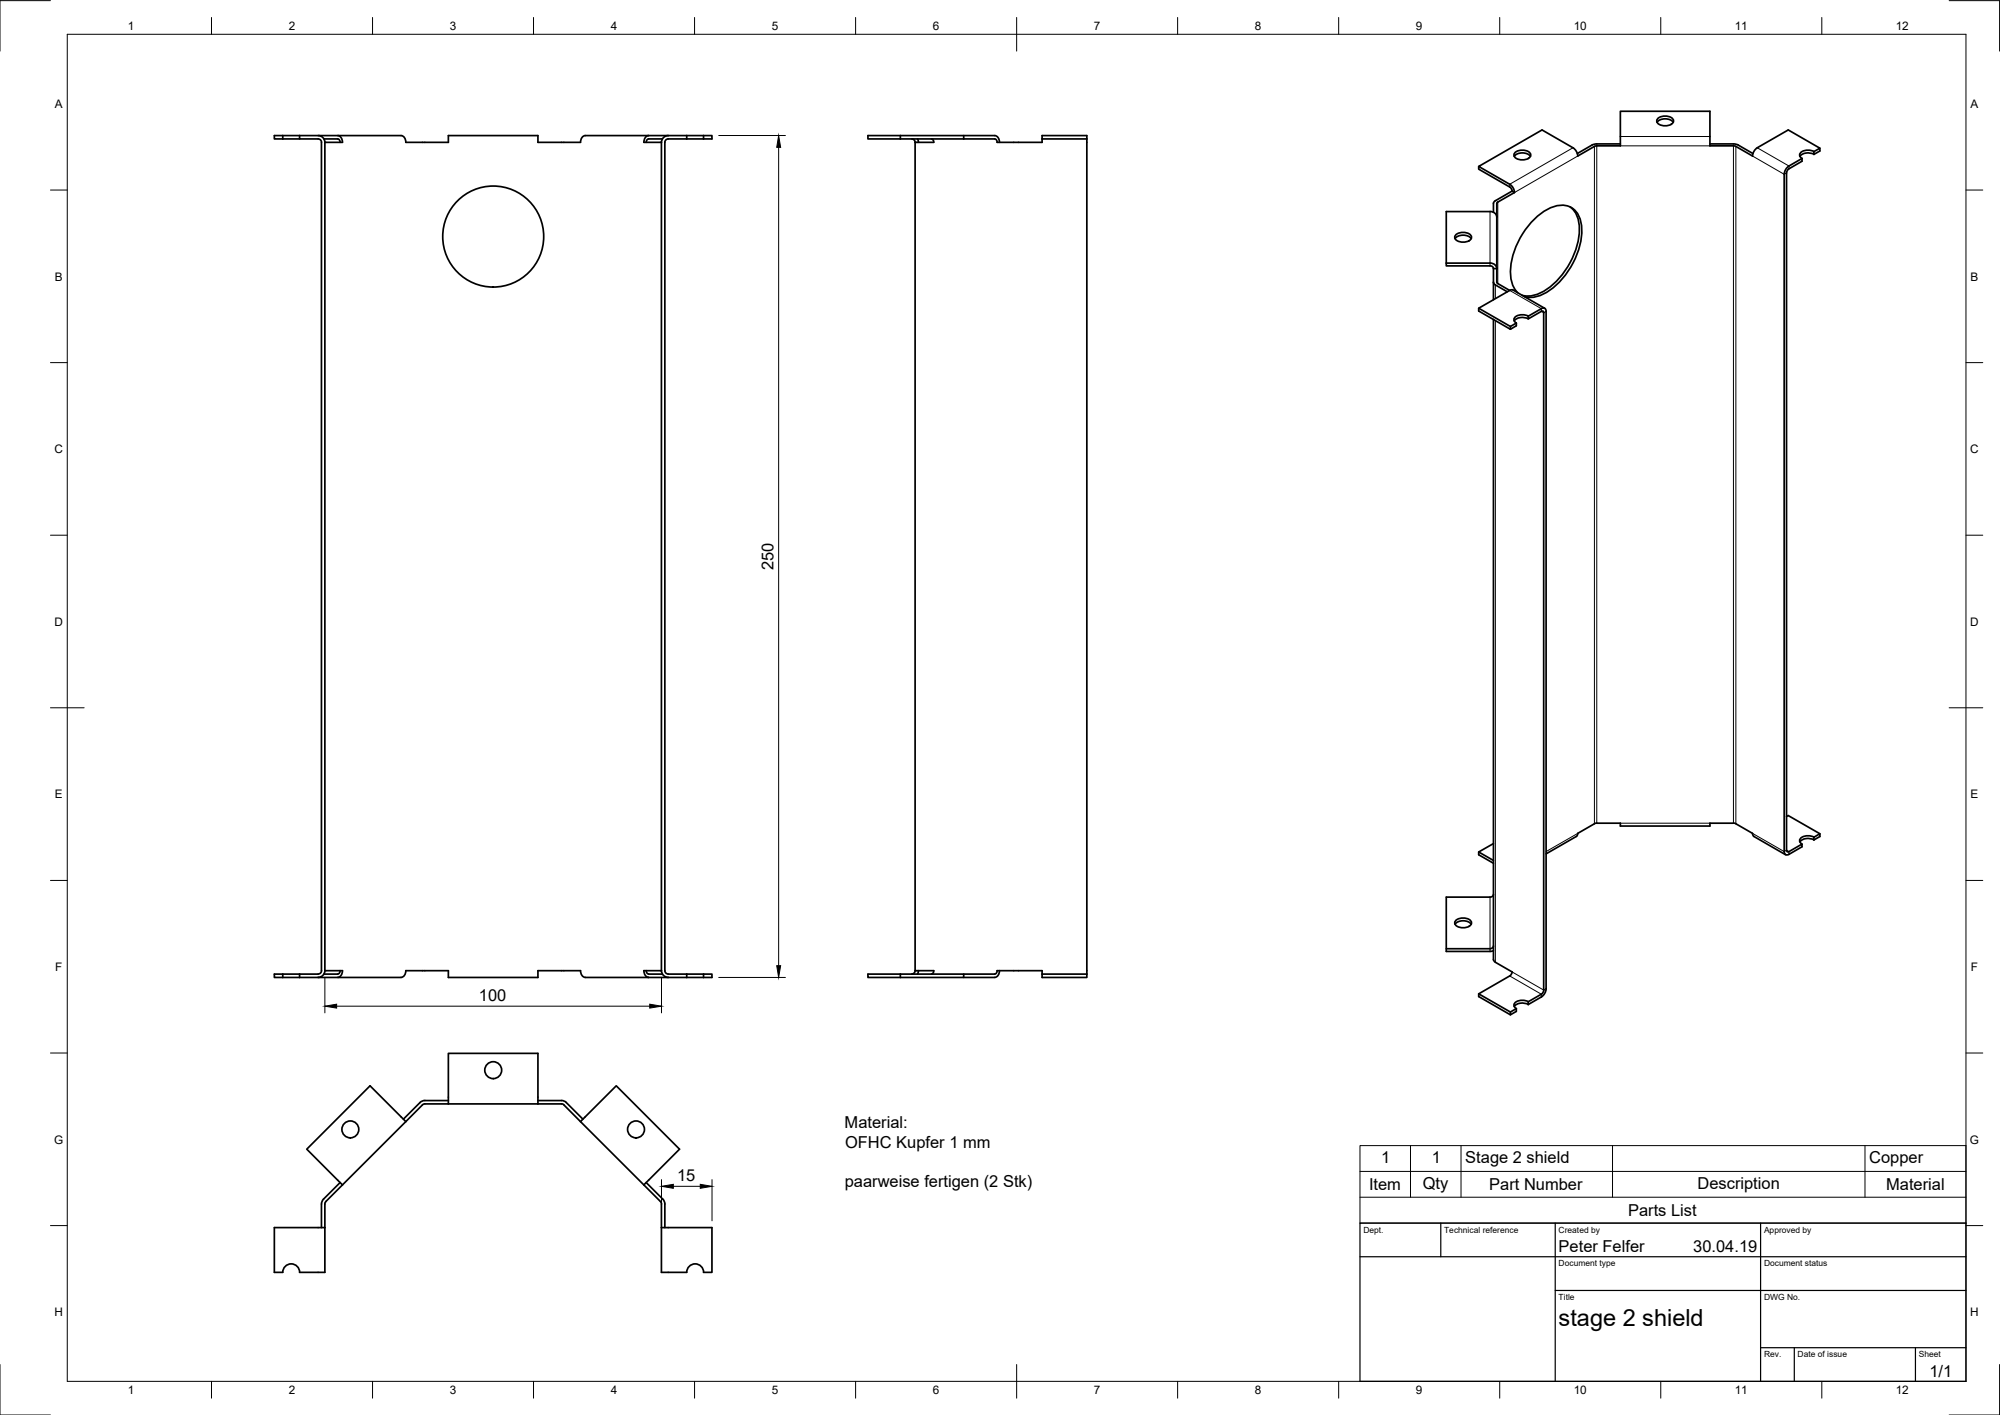
[picture p230: page 1]
Peter Felfer 250; Parts List

Material:
OFHC Kupfer 1 mm

1 | 1 | Stage 2 shield | | Copper
Item | Qty | Part Number | Description | Material

paarweise fertigen (2 Stk)

Dept. | Technical reference | Created by 30.04.19 | Approved by

Document type | Document status

Title stage 2 shield | DWG No.

Rev. | Date of issue | Sheet 1/1
