peterfelfer/Oxcart/CAD/cryo/cryo system MC/thermal conductor Drawing v1.pdf

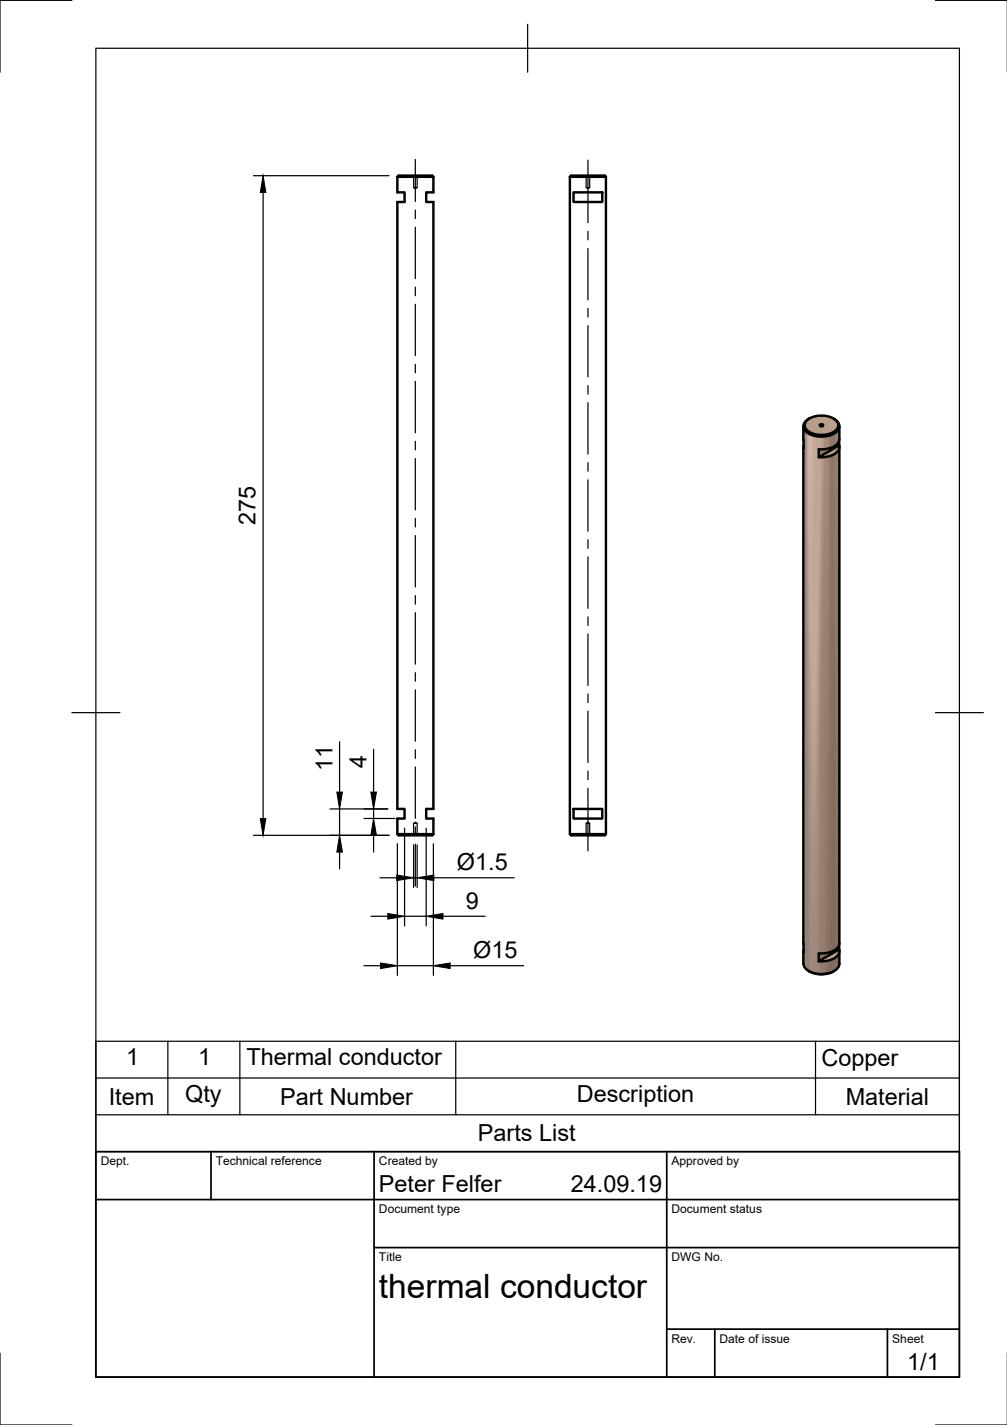
[picture p231: page 1]
Parts List

1 | 1 | Thermal conductor | | Copper
Item | Qty | Part Number | Description | Material

Dept. | Technical reference | Created by Peter Felfer 24.09.19 | Approved by

Document type | Document status

Title thermal conductor | DWG No.

Rev. | Date of issue | Sheet 1/1
