peterfelfer/Oxcart/CAD/gas-thermal/baking equipment/baking base Drawing v3.pdf

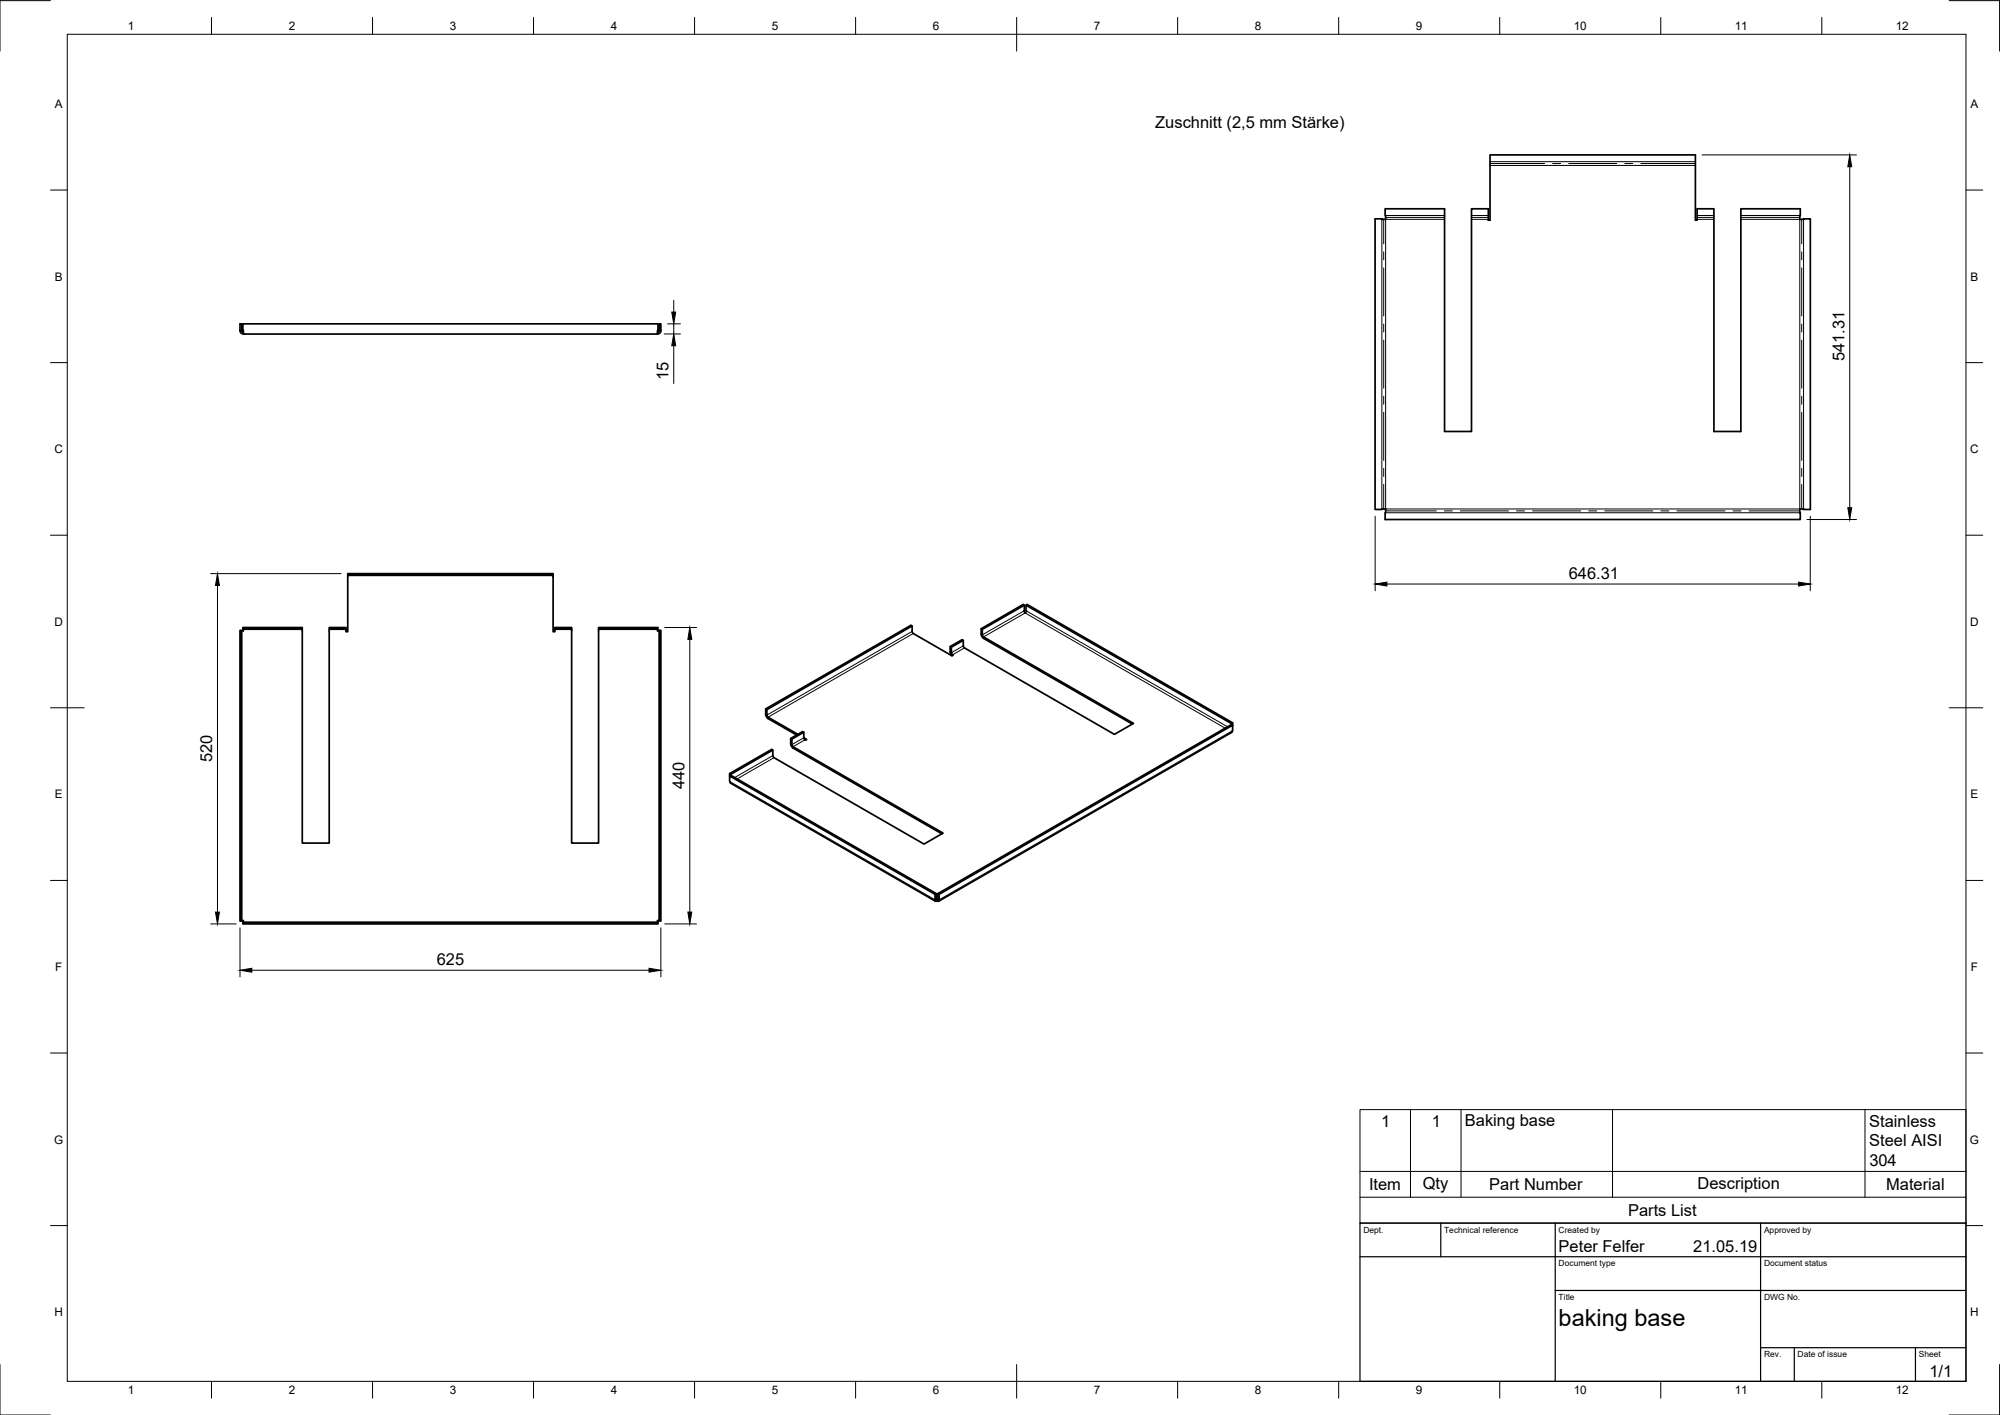
[picture p232: page 1]
Parts List

Zuschnitt (2,5 mm Stärke)

1 | 1 | Baking base | | Stainless Steel AISI 304

Item | Qty | Part Number | Description | Material

Dept. | Technical reference | Created by Peter Felfer 21.05.19 | Approved by

Document type | Document status

Title baking base | DWG No.

Rev. | Date of issue | Sheet 1/1
