peterfelfer/Oxcart/CAD/gas-thermal/baking equipment/baking lid left section Drawing v3.pdf

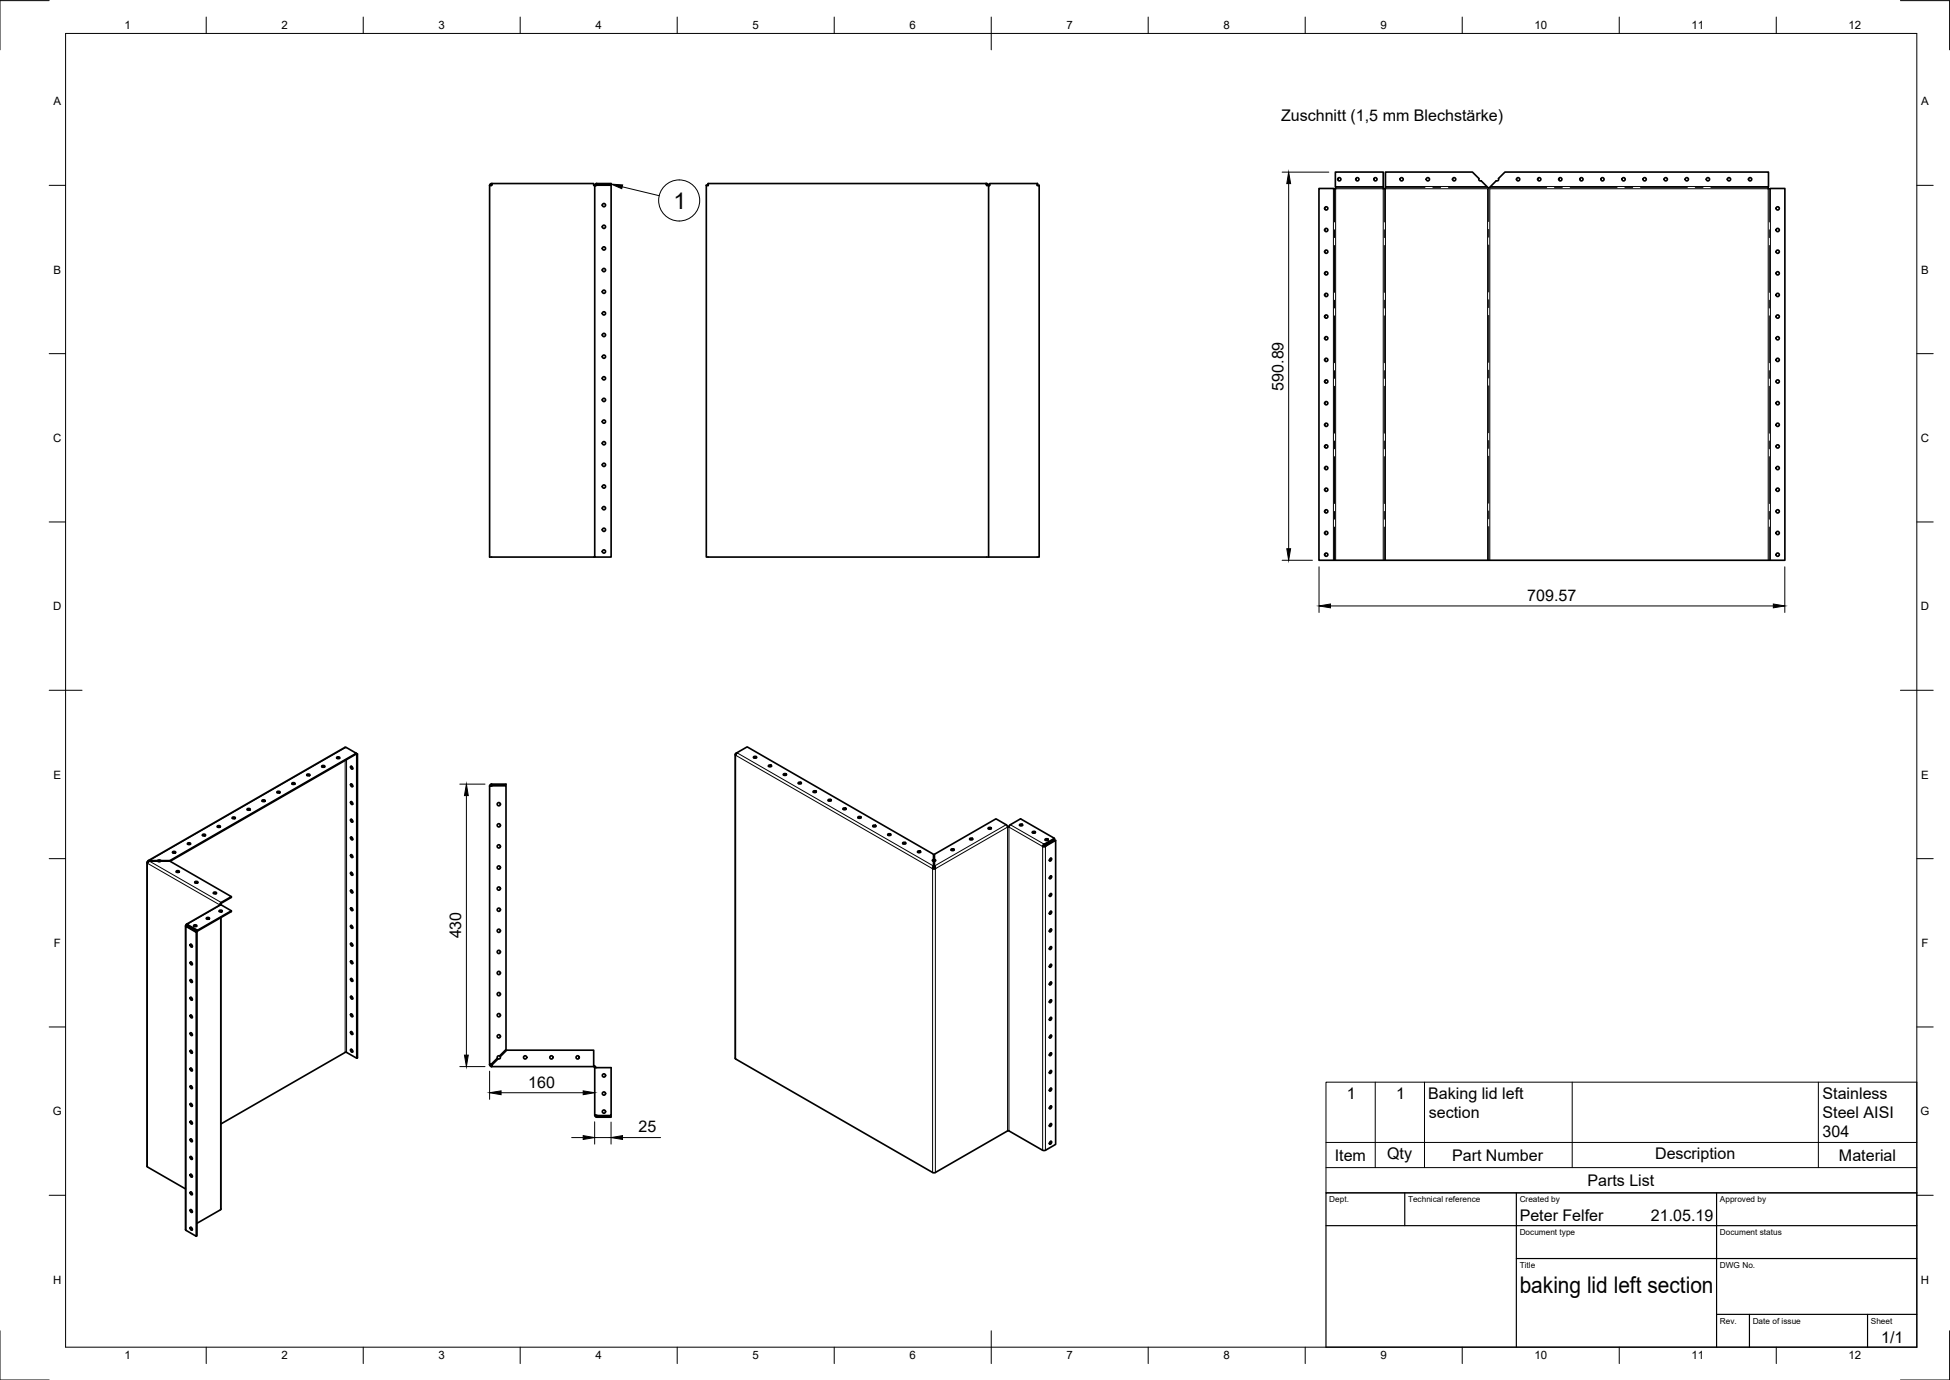
[picture p233: page 1]
Parts List

Zuschnitt (1,5 mm Blechstärke)

1 | 1 | Baking lid left section | | Stainless Steel AISI

Item | Qty | Part Number | Description | Material

Dept. | Technical reference | Created by Peter Felfer 21.05.19 | Approved by

Document type | Document status

Title baking lid left section | DWG No.

Rev. | Date of issue | Sheet 1/1
