peterfelfer/Oxcart/CAD/gas-thermal/baking equipment/baking lid mid section Drawing v3.pdf

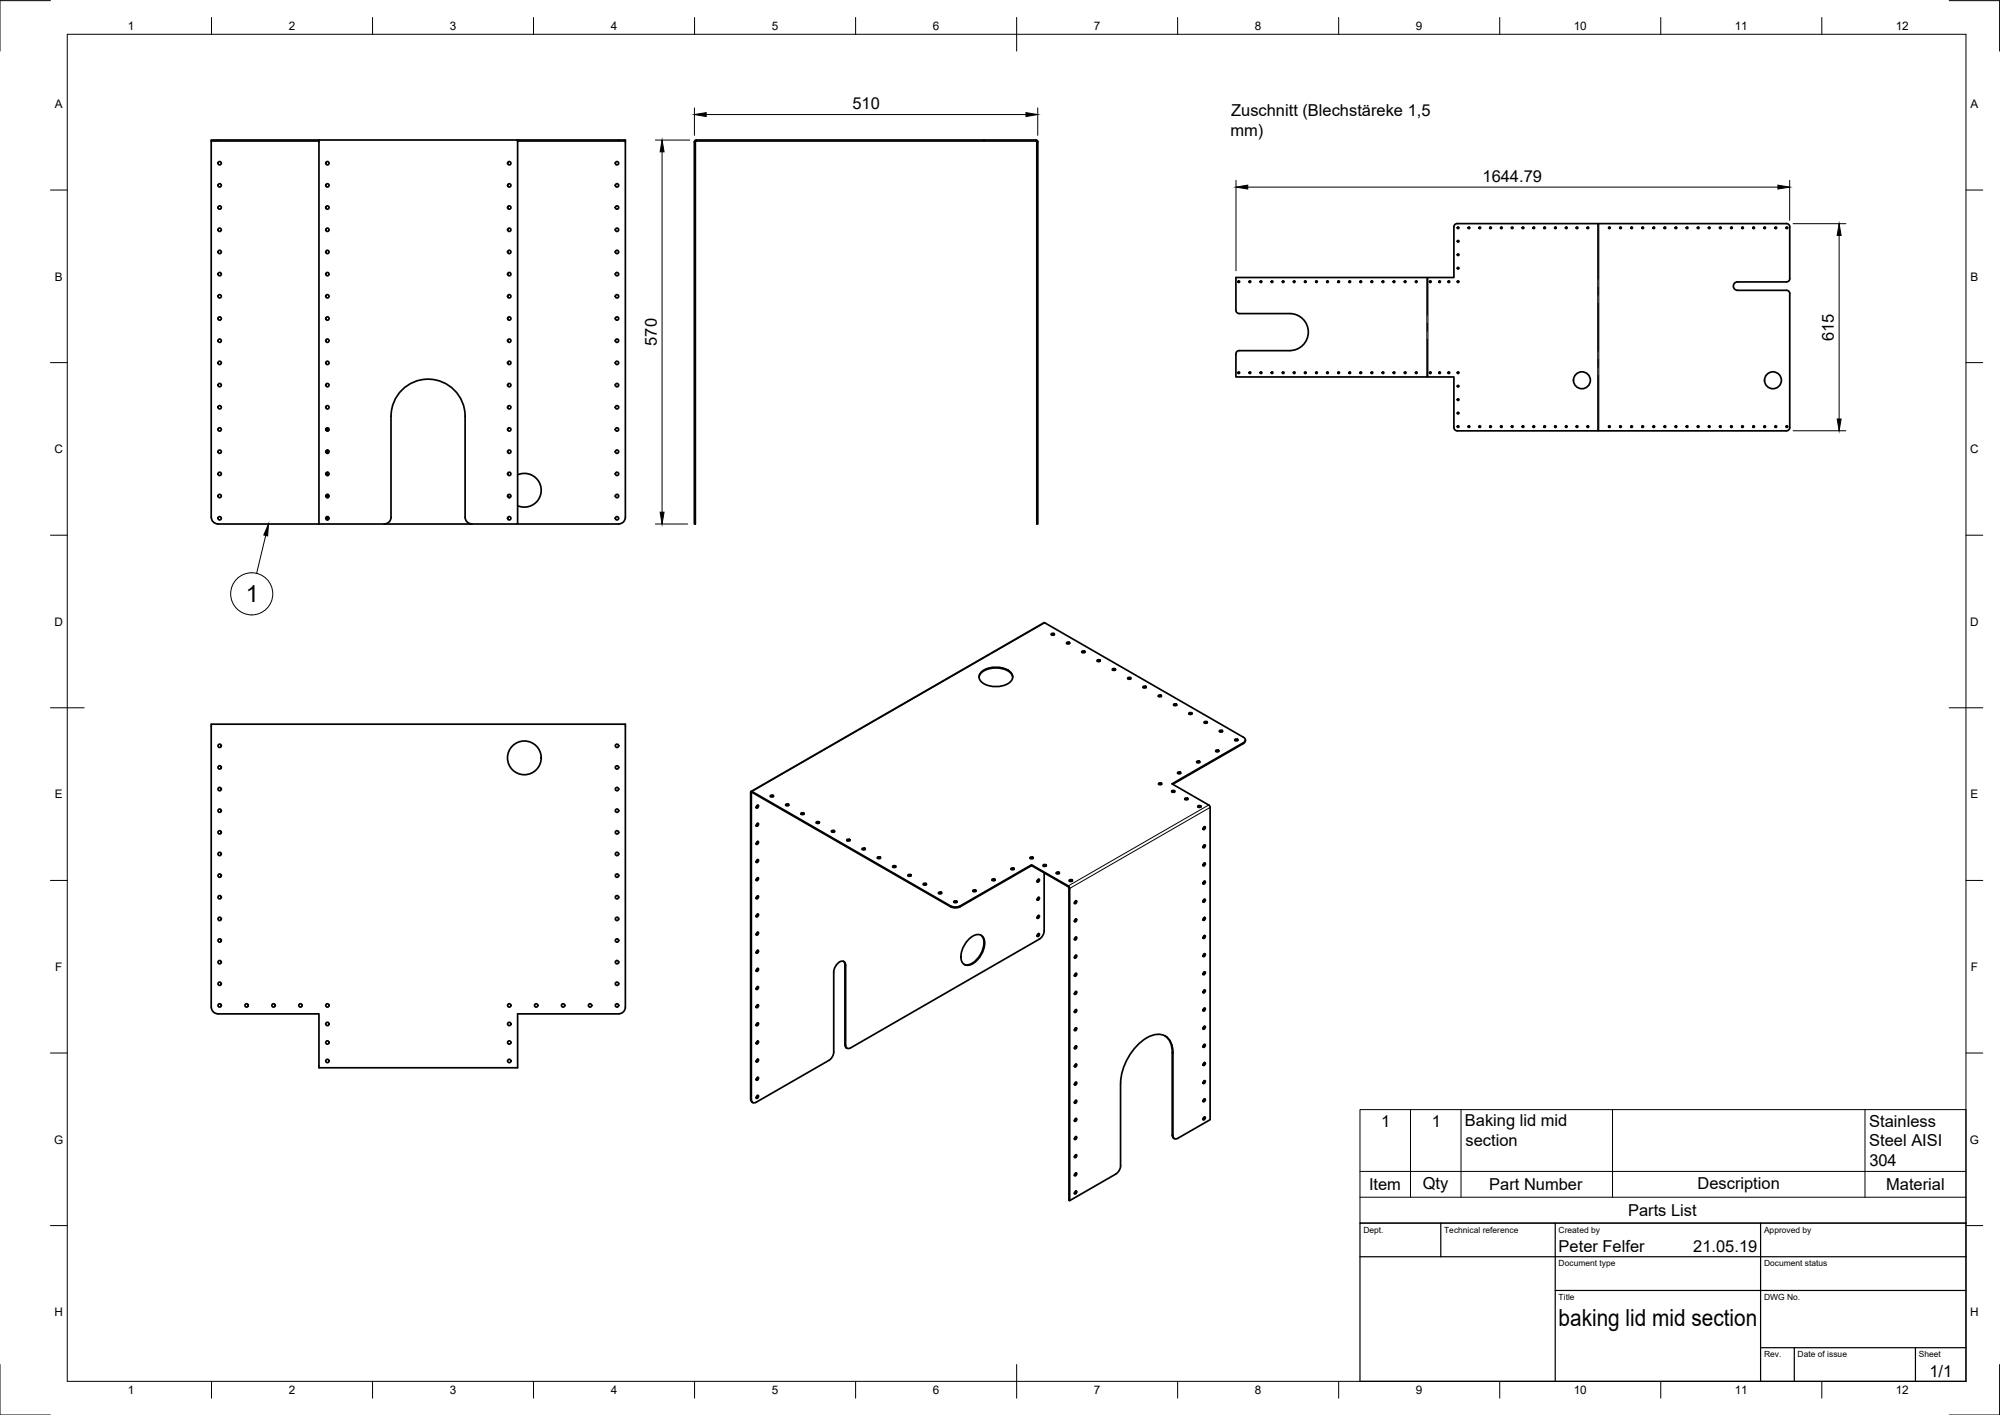
[picture p234: page 1]
Peter Felfer 570; Parts List; Zuschnitt (Blechstäreke 1,5

1 | 1 | Baking lid mid section | | Stainless Steel AISI 304

Item | Qty | Part Number | Description | Material

Dept. | Technical reference | Created by 21.05.19 | Approved by

Document type | Document status

Title baking lid mid section | DWG No.

Rev. | Date of issue | Sheet 1/1
