peterfelfer/Oxcart/CAD/gas-thermal/baking equipment/baking lid right section Drawing v4.pdf

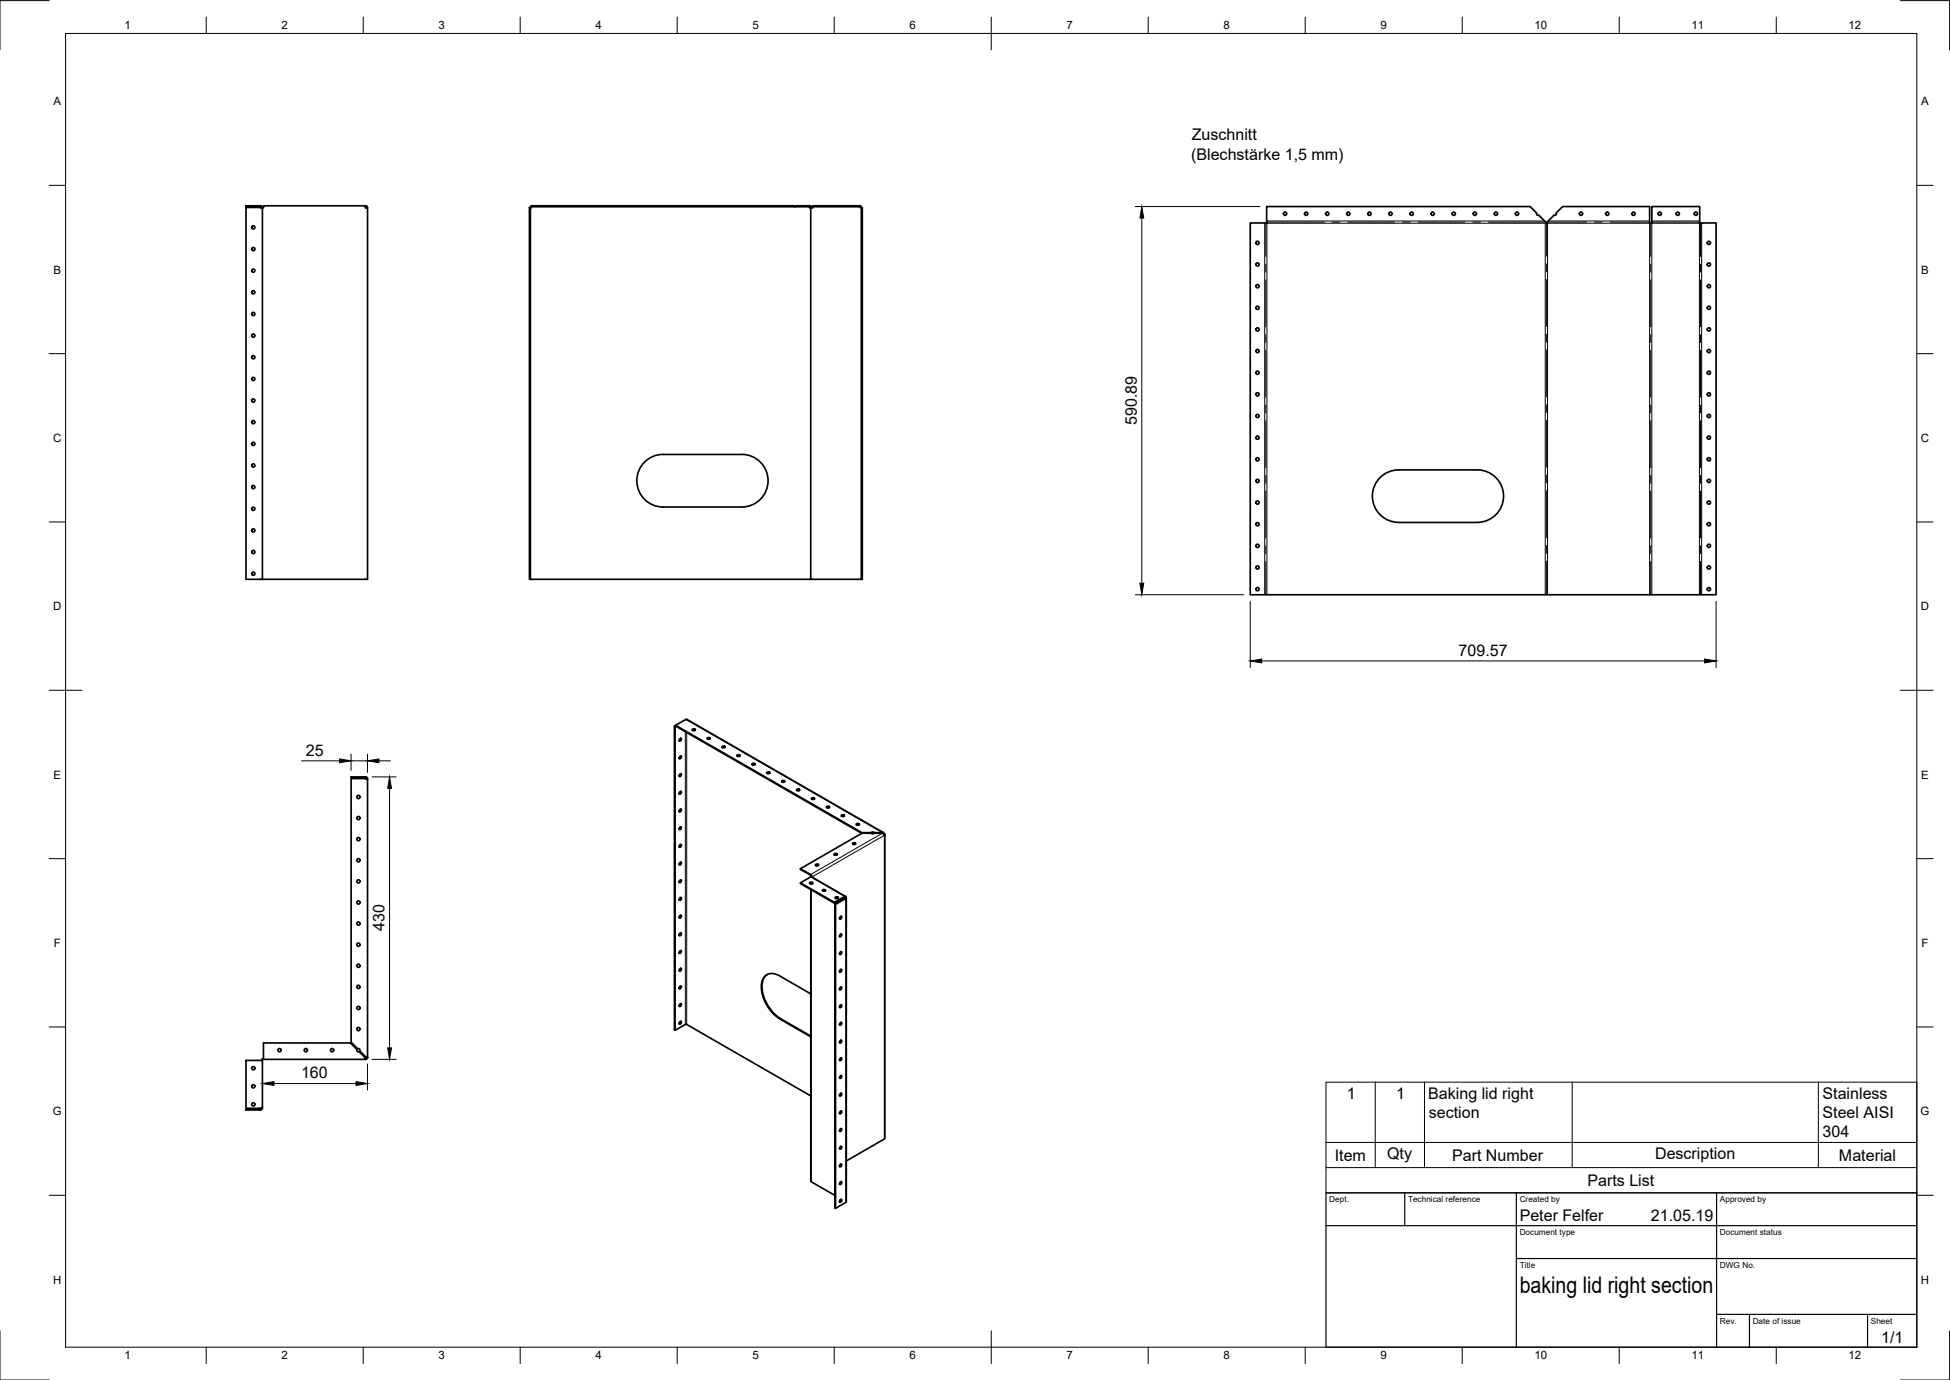
[picture p235: page 1]
(Blechstärke 1,5 mm) 590.89; Parts List

1 | 1 | Baking lid right section | | Stainless Steel AISI 304

Item | Qty | Part Number | Description | Material

Dept. | Technical reference | Created by Peter Felfer 21.05.19 | Approved by

Document type | Document status

Title baking lid right section | DWG No.

Rev. | Date of issue | Sheet 1/1
