peterfelfer/Oxcart/CAD/sample-handling/sample stage - pucks/conductor Drawing v4.pdf

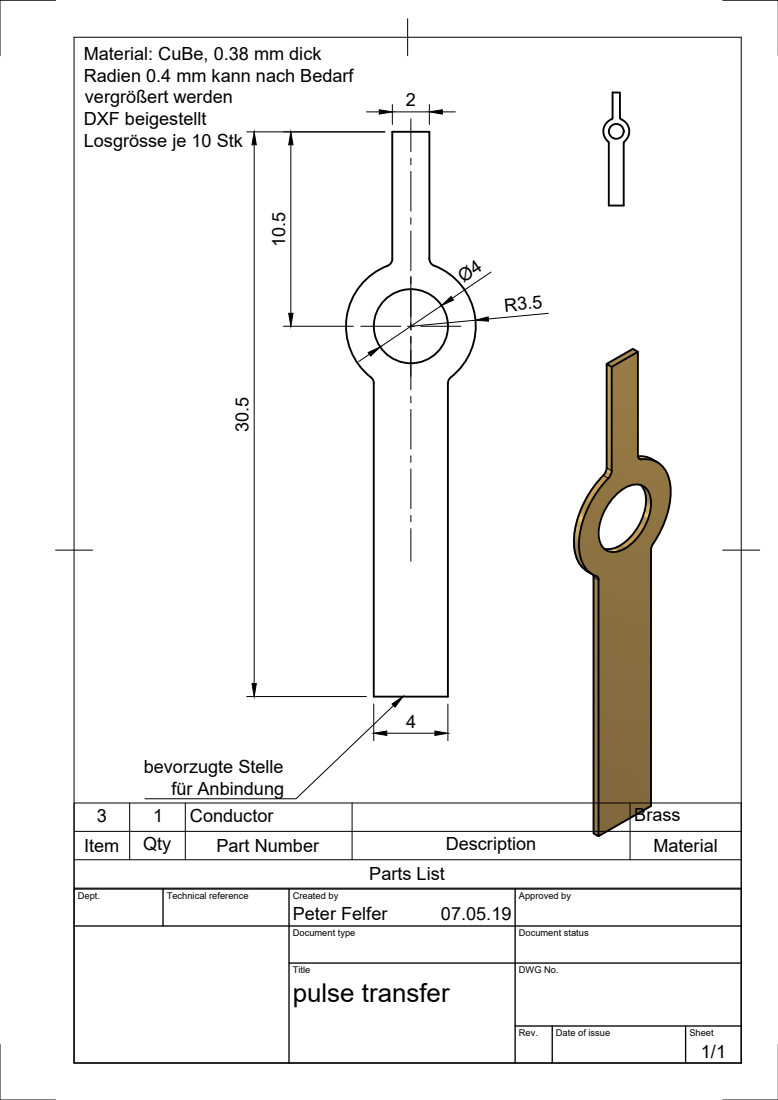
[picture p237: page 1]
Parts List; bevorzugte Stelle

Material: CuBe, 0.38 mm dick
Radien 0.4 mm kann nach Bedarf
vergrößert werden
DXF beigestellt
Losgrösse je 10 Stk
für Anbindung10.5 30.5

3 | 1 | Conductor | | Brass
Item | Qty | Part Number | Description | Material

Dept. | Technical reference | Created by Peter Felfer 07.05.19 | Approved by

Document type | Document status

Title pulse transfer | DWG No.

Rev. | Date of issue | Sheet 1/1
