peterfelfer/Oxcart/CAD/sample-handling/sample stage - pucks/connector fuxture Drawing v2.pdf

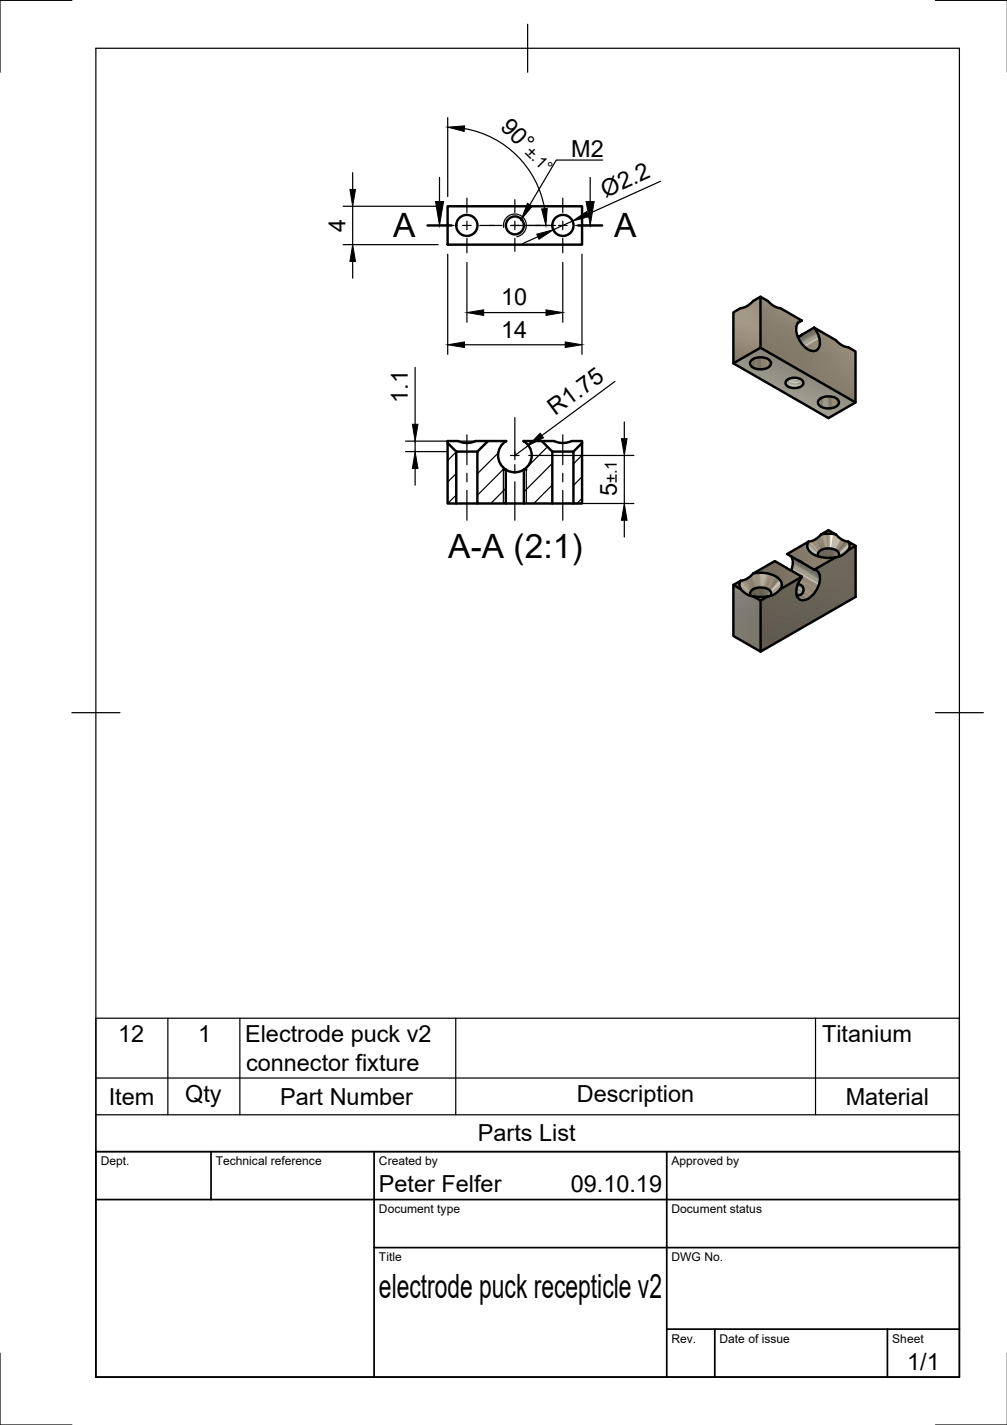
[picture p238: page 1]
Parts List

12 | 1 | Electrode puck v2 connector fixture | | Titanium

Item | Qty | Part Number | Description | Material

Dept. | Technical reference | Created by Peter Felfer 09.10.19 | Approved by

Document type | Document status

Title electrode puck recepticle v2 | DWG No.

Rev. | Date of issue | Sheet 1/1
