peterfelfer/Oxcart/CAD/sample-handling/sample stage - pucks/Cu base plate Drawing v2.pdf

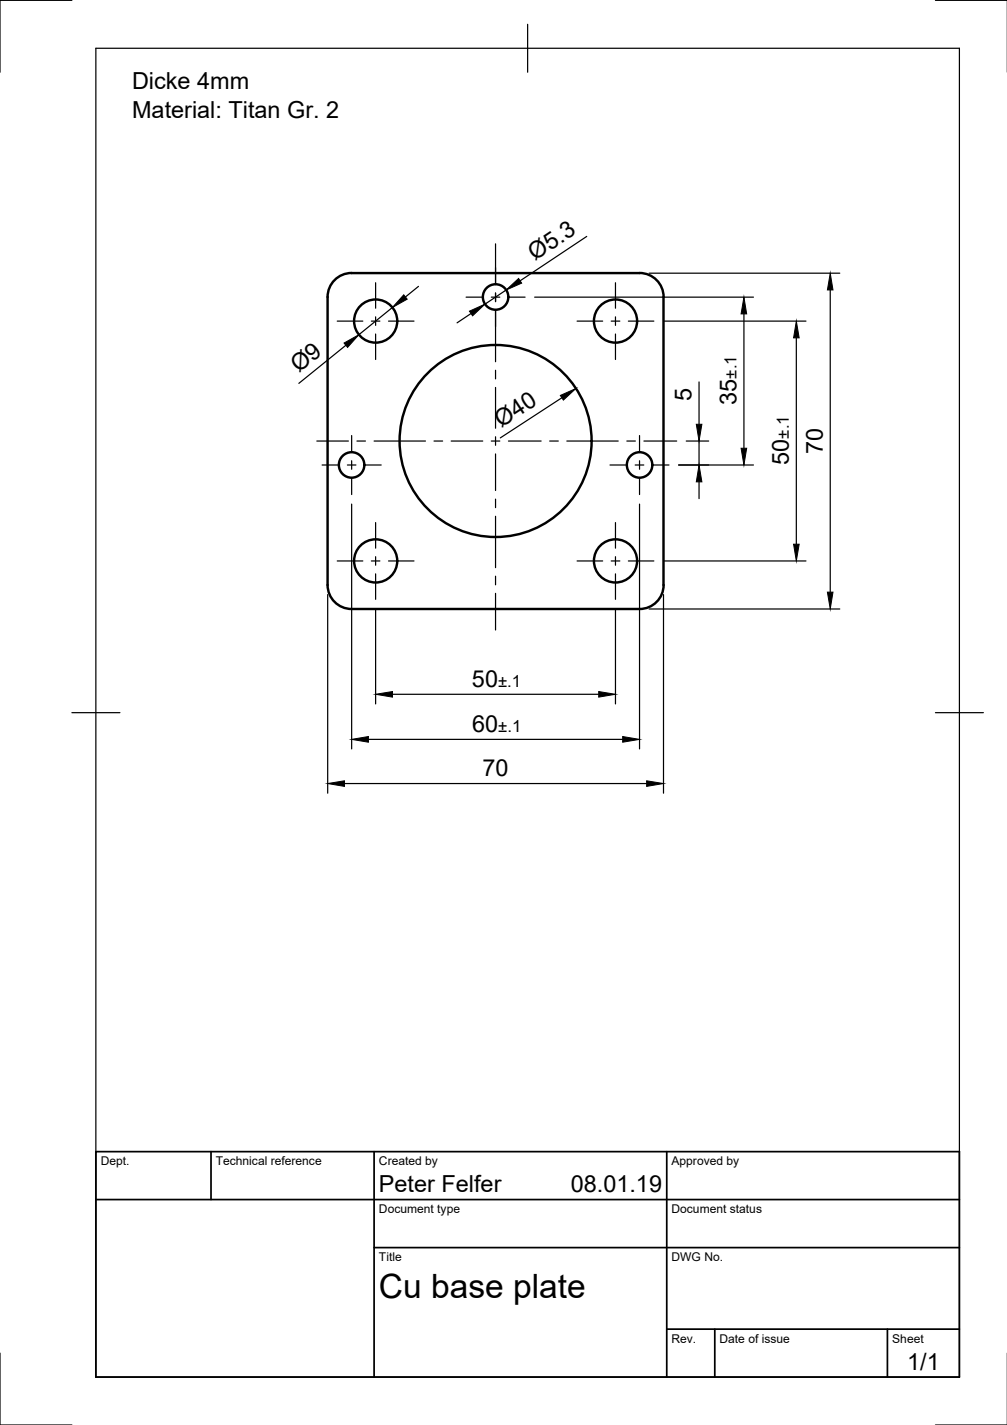
[picture p239: page 1]
Peter Felfer

Dicke 4mm
Material: Titan Gr. 2

Dept. | Technical reference | Created by 08.01.19 | Approved by

Document type | Document status

Title Cu base plate | DWG No.

Rev. | Date of issue | Sheet 1/1
