peterfelfer/Oxcart/CAD/sample-handling/sample stage - pucks/Cu braid clamp Drawing v3.pdf

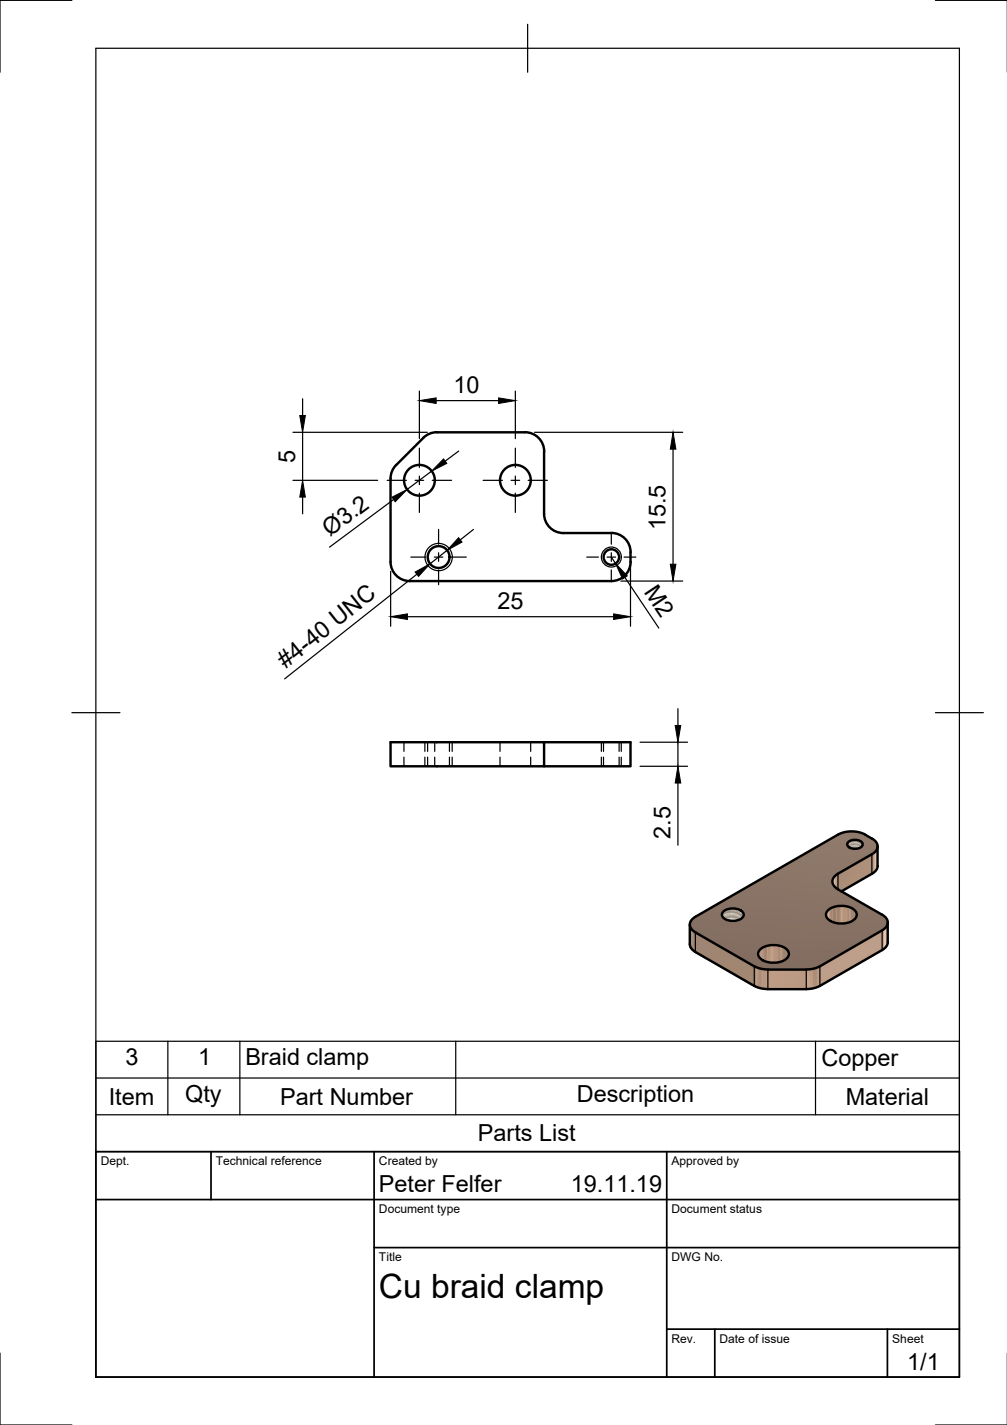
[picture p240: page 1]
#4-40 UNC; Parts List; Item; Qty; Part Number; Description; Material; Braid clamp; Copper 2.5

Dept. | Technical reference | Created by Peter Felfer 19.11.19 | Approved by

Document type | Document status

Title Cu braid clamp | DWG No.

Rev. | Date of issue | Sheet 1/1
