peterfelfer/Oxcart/CAD/sample-handling/sample stage - pucks/electrode puck Drawing v7.pdf

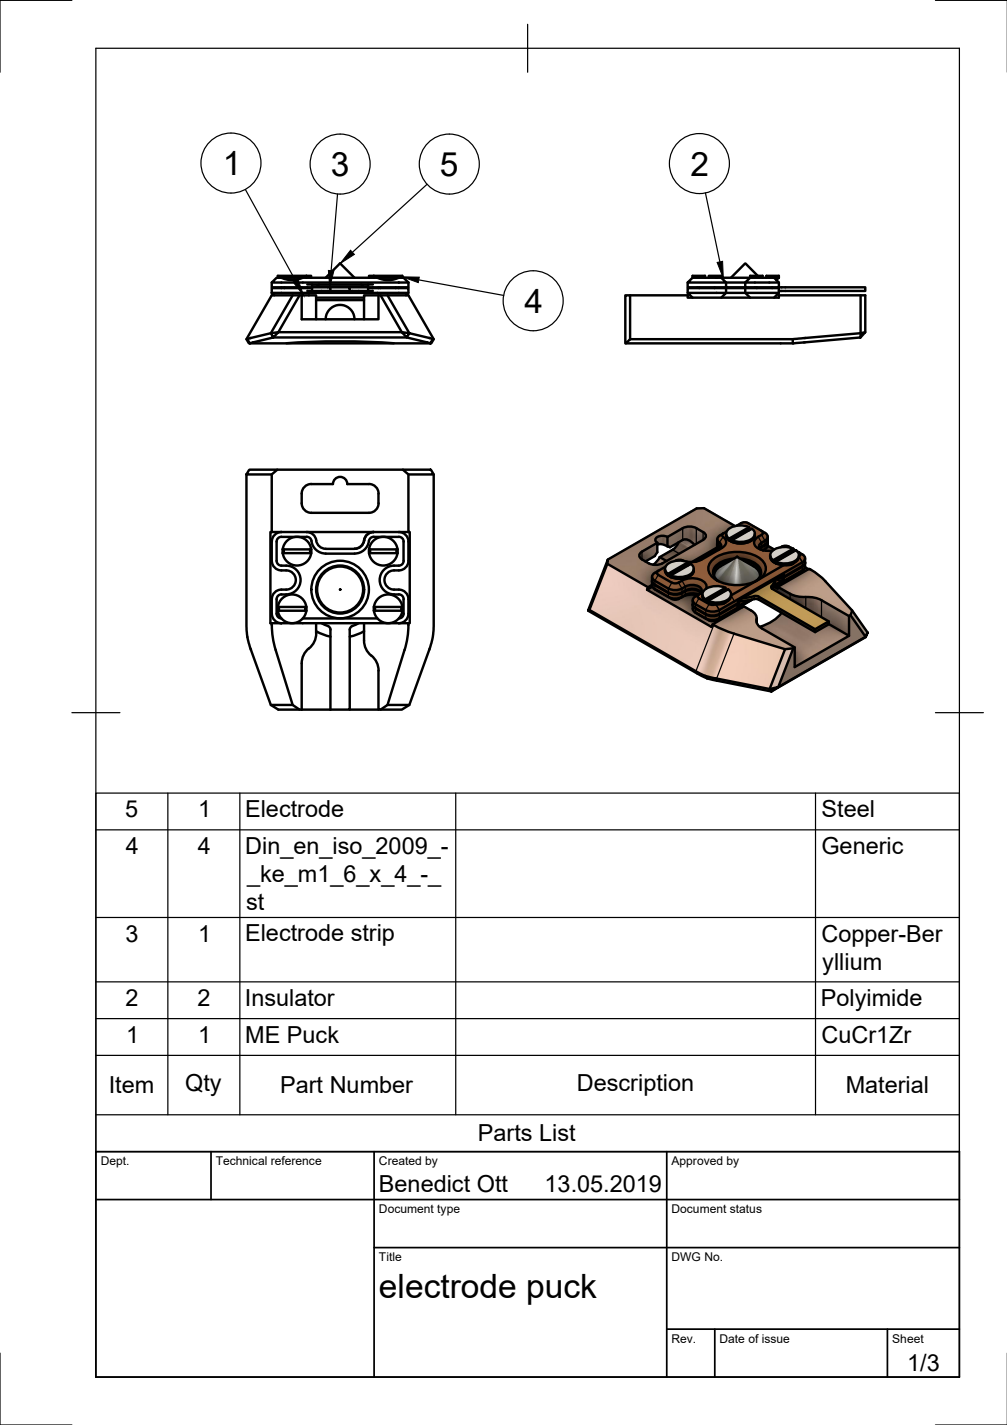
[picture p241: page 1]
Parts List

5 | 1 | Electrode | | Steel
4 | 4 | Din_en_iso_2009_-_ke_m1_6_x_4_-_ st | | Generic

3 | 1 | Electrode strip | | Copper-Ber yllium

2 | 2 | Insulator | | Polyimide
1 | 1 | ME Puck | | CuCr1Zr

Item | Qty | Part Number | Description | Material

Dept. | Technical reference | Created by Benedict Ott 13.05.2019 | Approved by

Document type | Document status

Title electrode puck | DWG No.

Rev. | Date of issue | Sheet

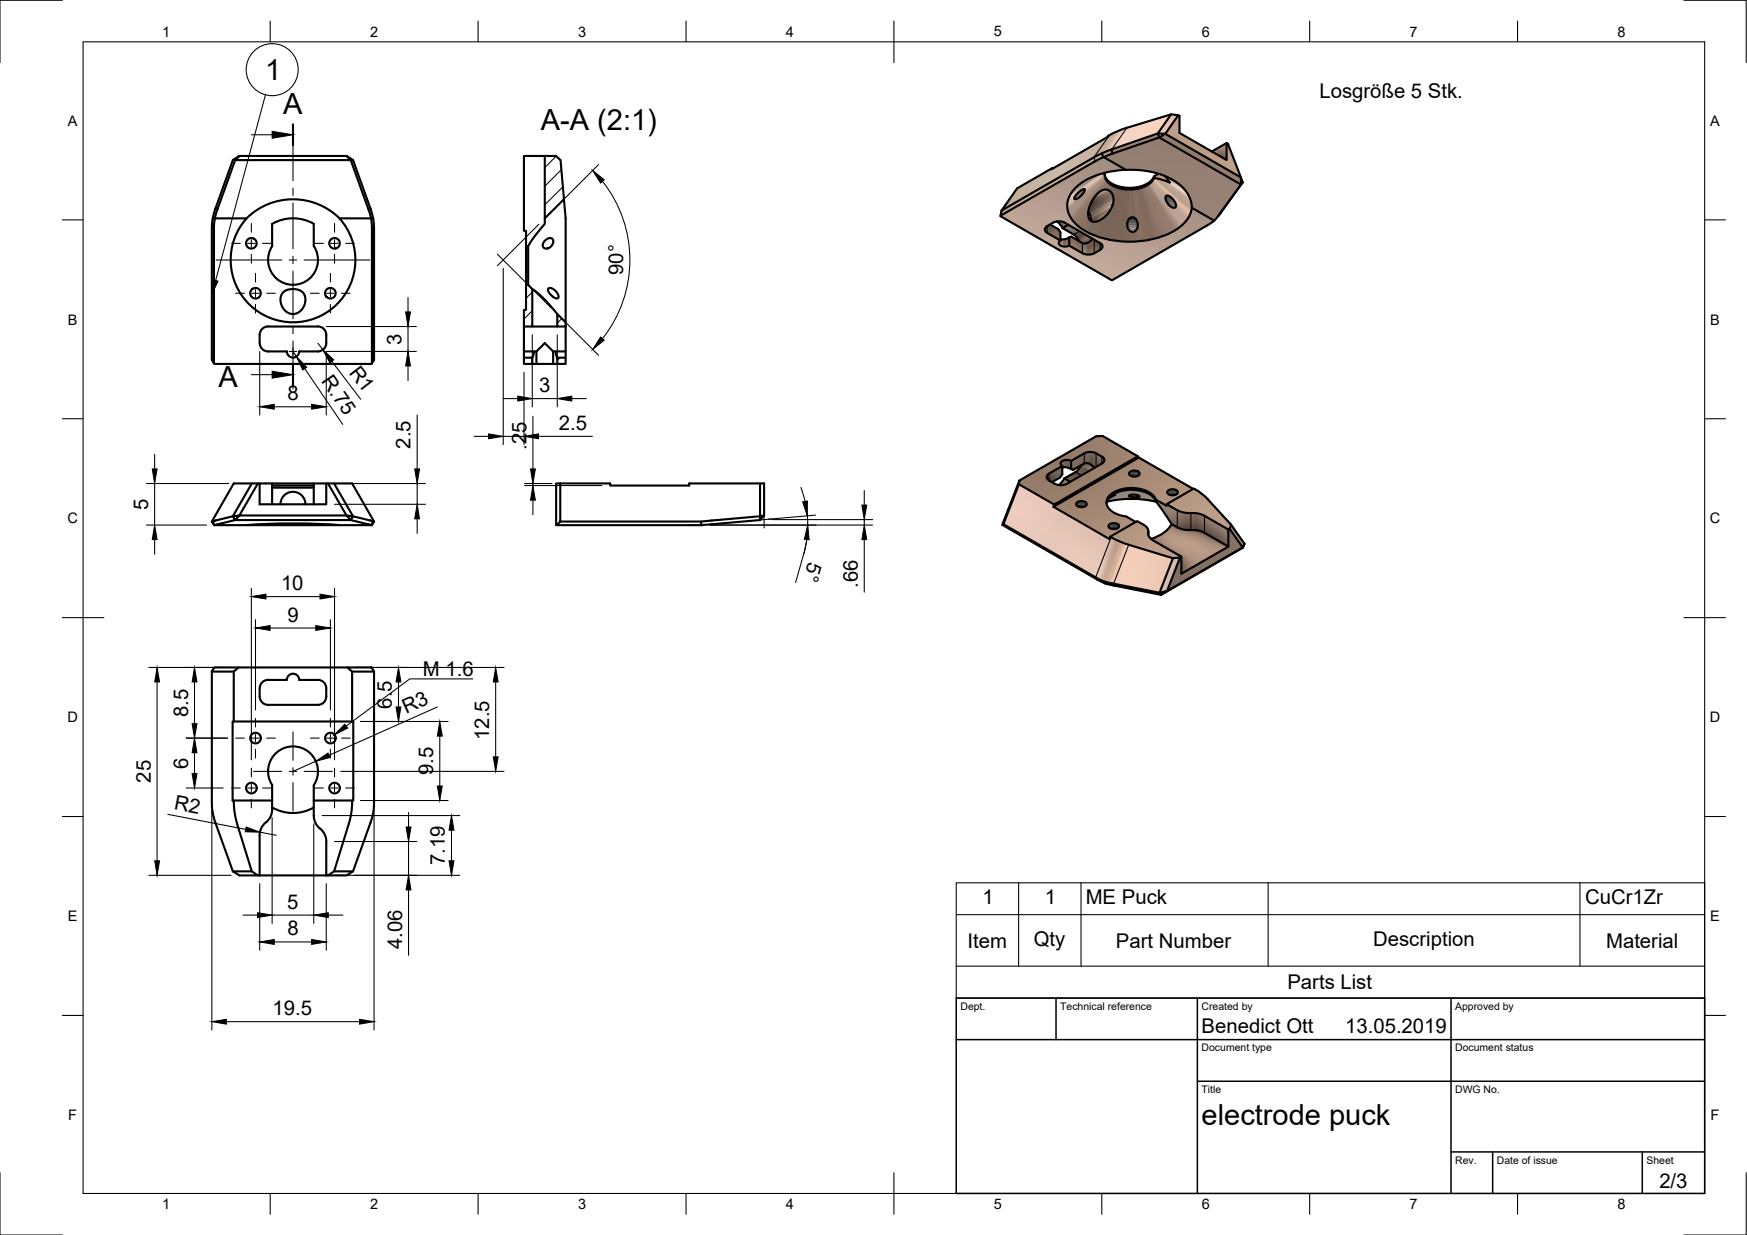
[picture p242: page 2]
Parts List; Losgröße 5 Stk.

1 | 1 | ME Puck | | CuCr1Zr

Item | Qty | Part Number | Description | Material

Dept. | Technical reference | Created by Benedict Ott 13.05.2019 | Approved by

Document type | Document status

Title electrode puck | DWG No.

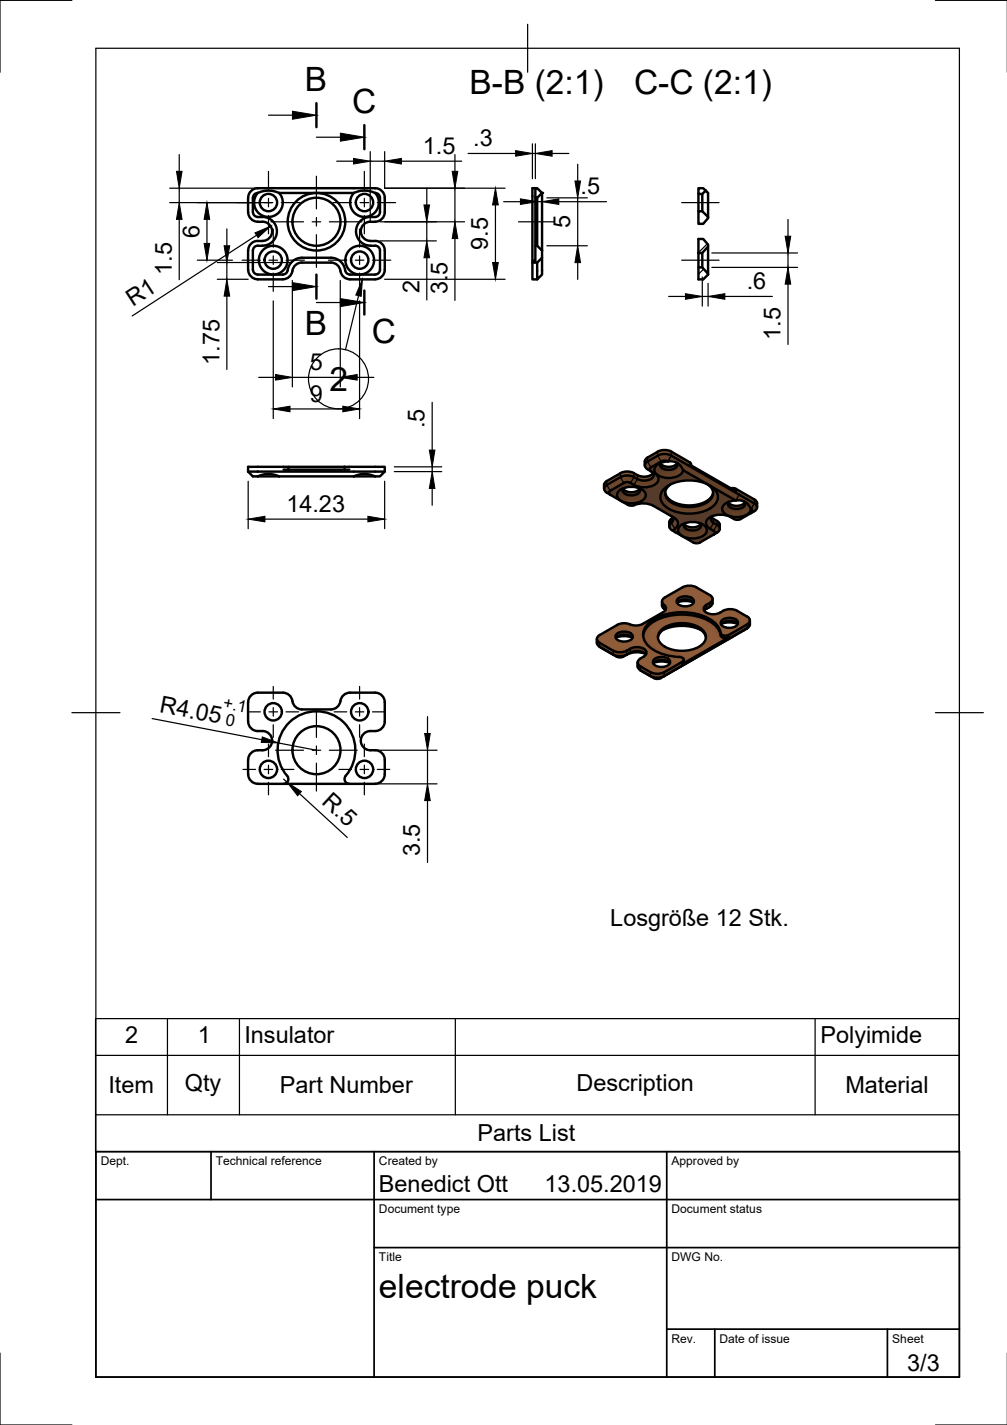
[picture p243: page 3]
Parts List; Losgröße 12 Stk.

2 | 1 | Insulator | | Polyimide

Item | Qty | Part Number | Description | Material

Dept. | Technical reference | Created by Benedict Ott 13.05.2019 | Approved by

Document type | Document status

Title electrode puck | DWG No.
