peterfelfer/Oxcart/CAD/sample-handling/sample stage - pucks/electrode puck recepticle Drawing v3.pdf

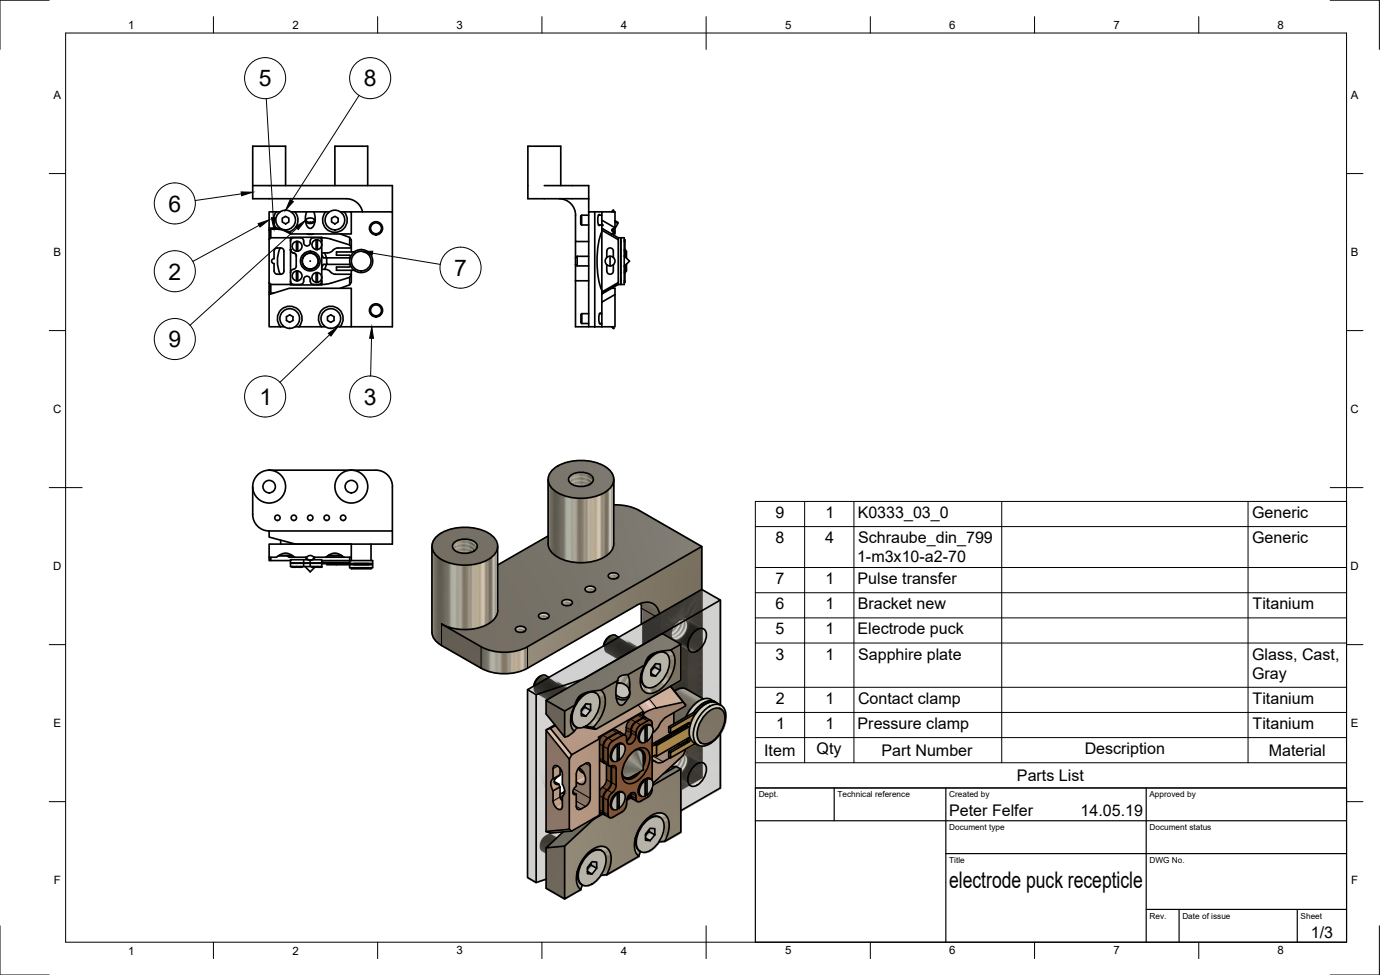
[picture p244: page 1]
Parts List

9 | 1 | K0333_03_0 | | Generic
8 | 4 | Schraube_din_799 1-m3x10-a2-70 | | Generic

7 | 1 | Pulse transfer
6 | 1 | Bracket new | | Titanium
5 | 1 | Electrode puck
3 | 1 | Sapphire plate | | Glass, Cast, Gray

2 | 1 | Contact clamp | | Titanium
1 | 1 | Pressure clamp | | Titanium
Item | Qty | Part Number | Description | Material

Dept. | Technical reference | Created by Peter Felfer 14.05.19 | Approved by

Document type | Document status

Title electrode puck recepticle | DWG No.

Rev. | Date of issue | Sheet

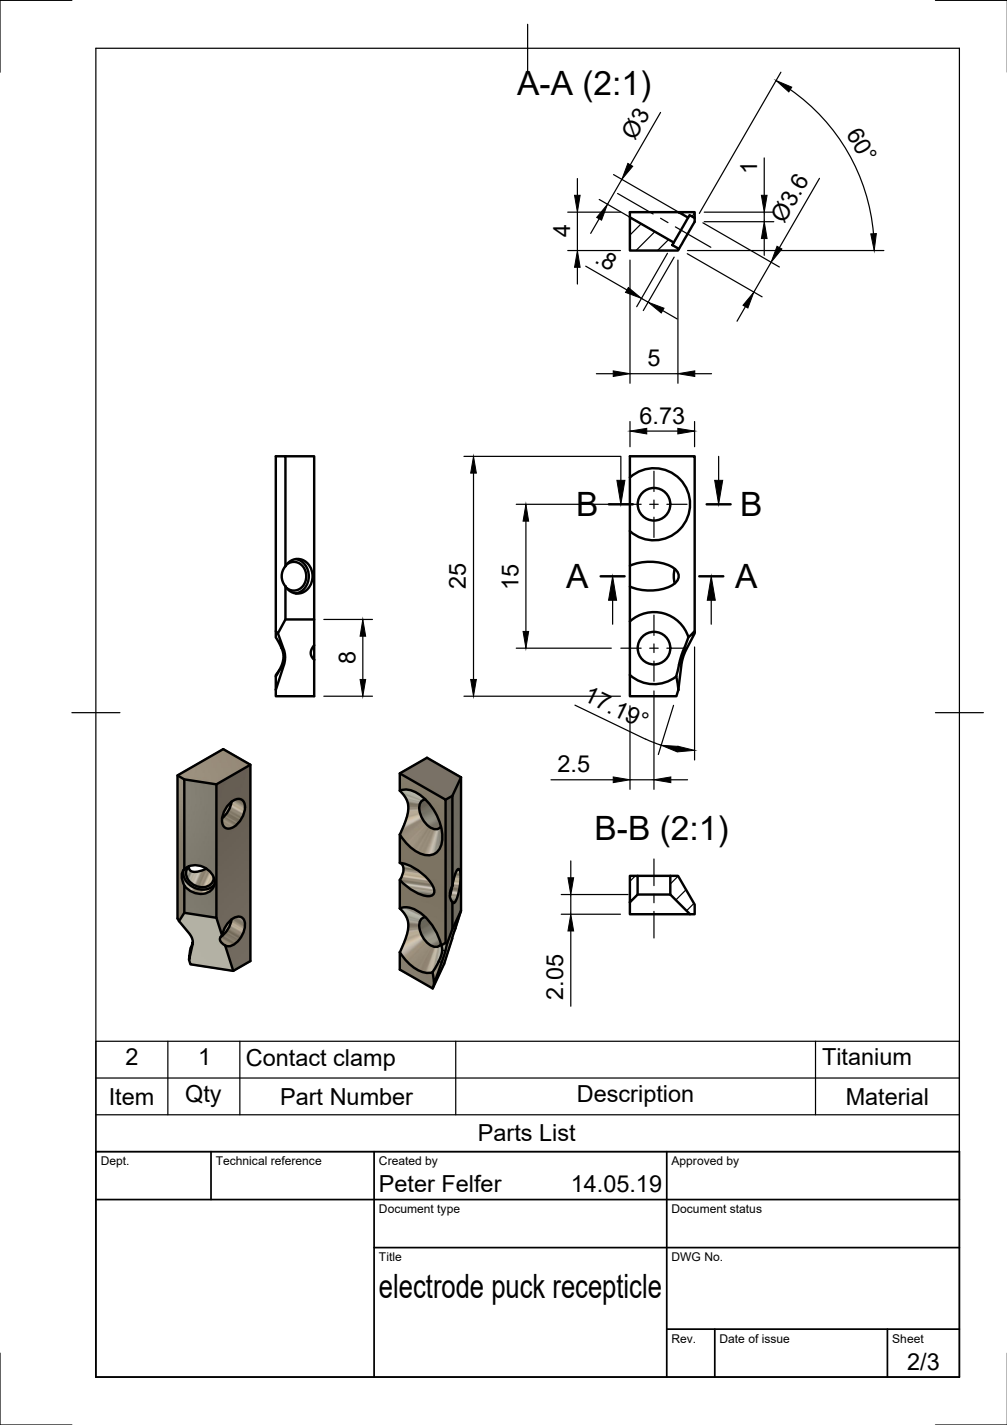
[picture p245: page 2]
Parts List

2 | 1 | Contact clamp | | Titanium
Item | Qty | Part Number | Description | Material

Dept. | Technical reference | Created by Peter Felfer 14.05.19 | Approved by

Document type | Document status

Title electrode puck recepticle | DWG No.

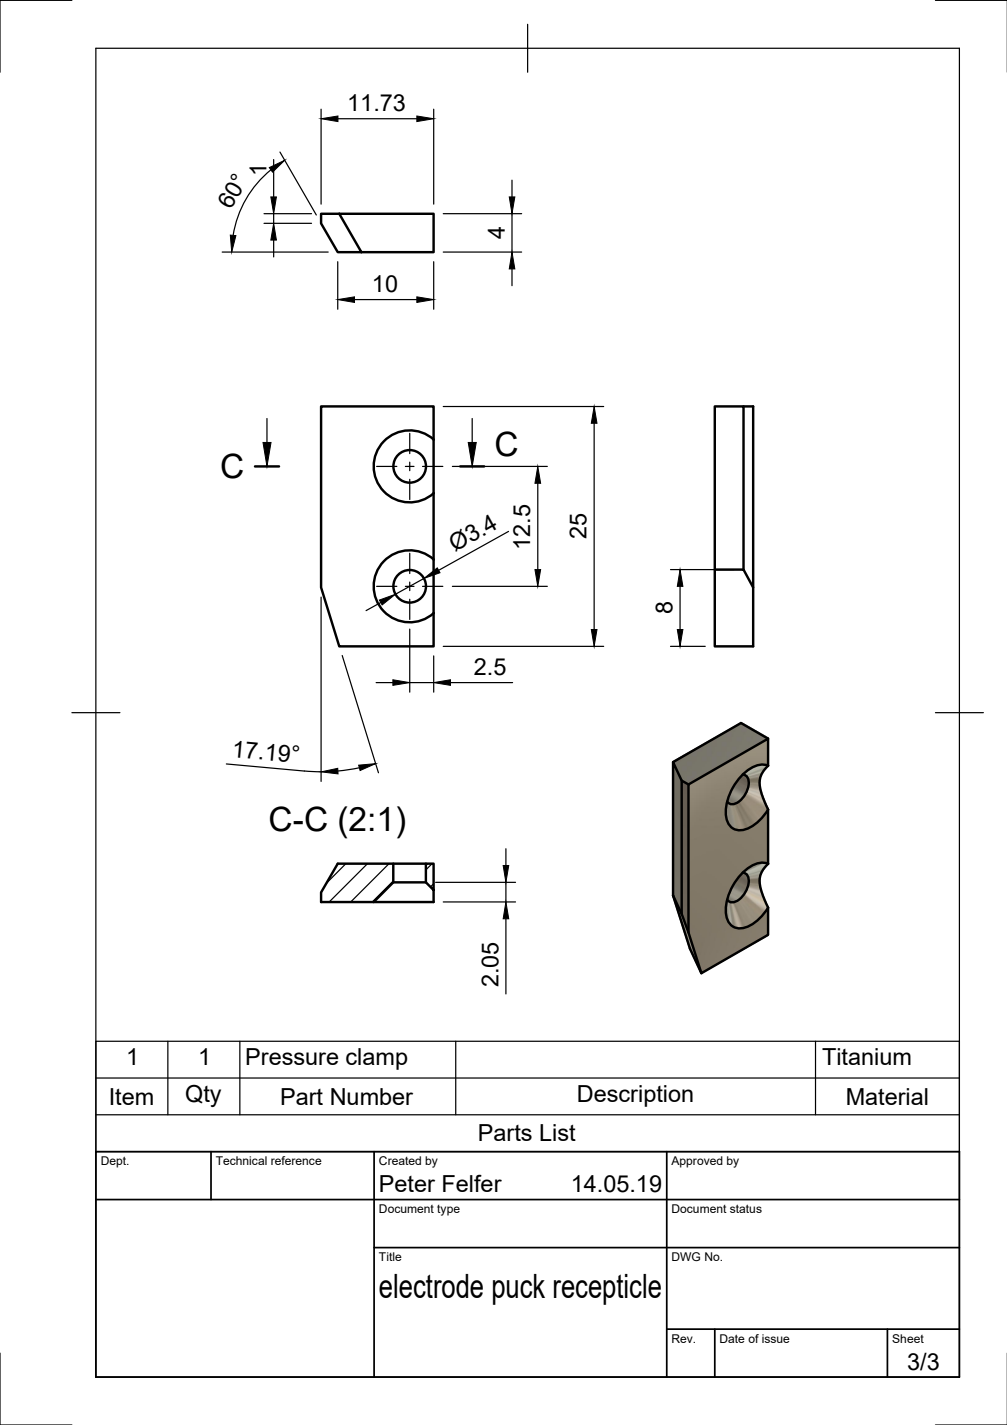
[picture p246: page 3]
Parts List

1 | 1 | Pressure clamp | | Titanium
Item | Qty | Part Number | Description | Material

Dept. | Technical reference | Created by Peter Felfer 14.05.19 | Approved by

Document type | Document status

Title electrode puck recepticle | DWG No.
