peterfelfer/Oxcart/CAD/sample-handling/sample stage - pucks/electrode puck v2 Drawing v2.pdf

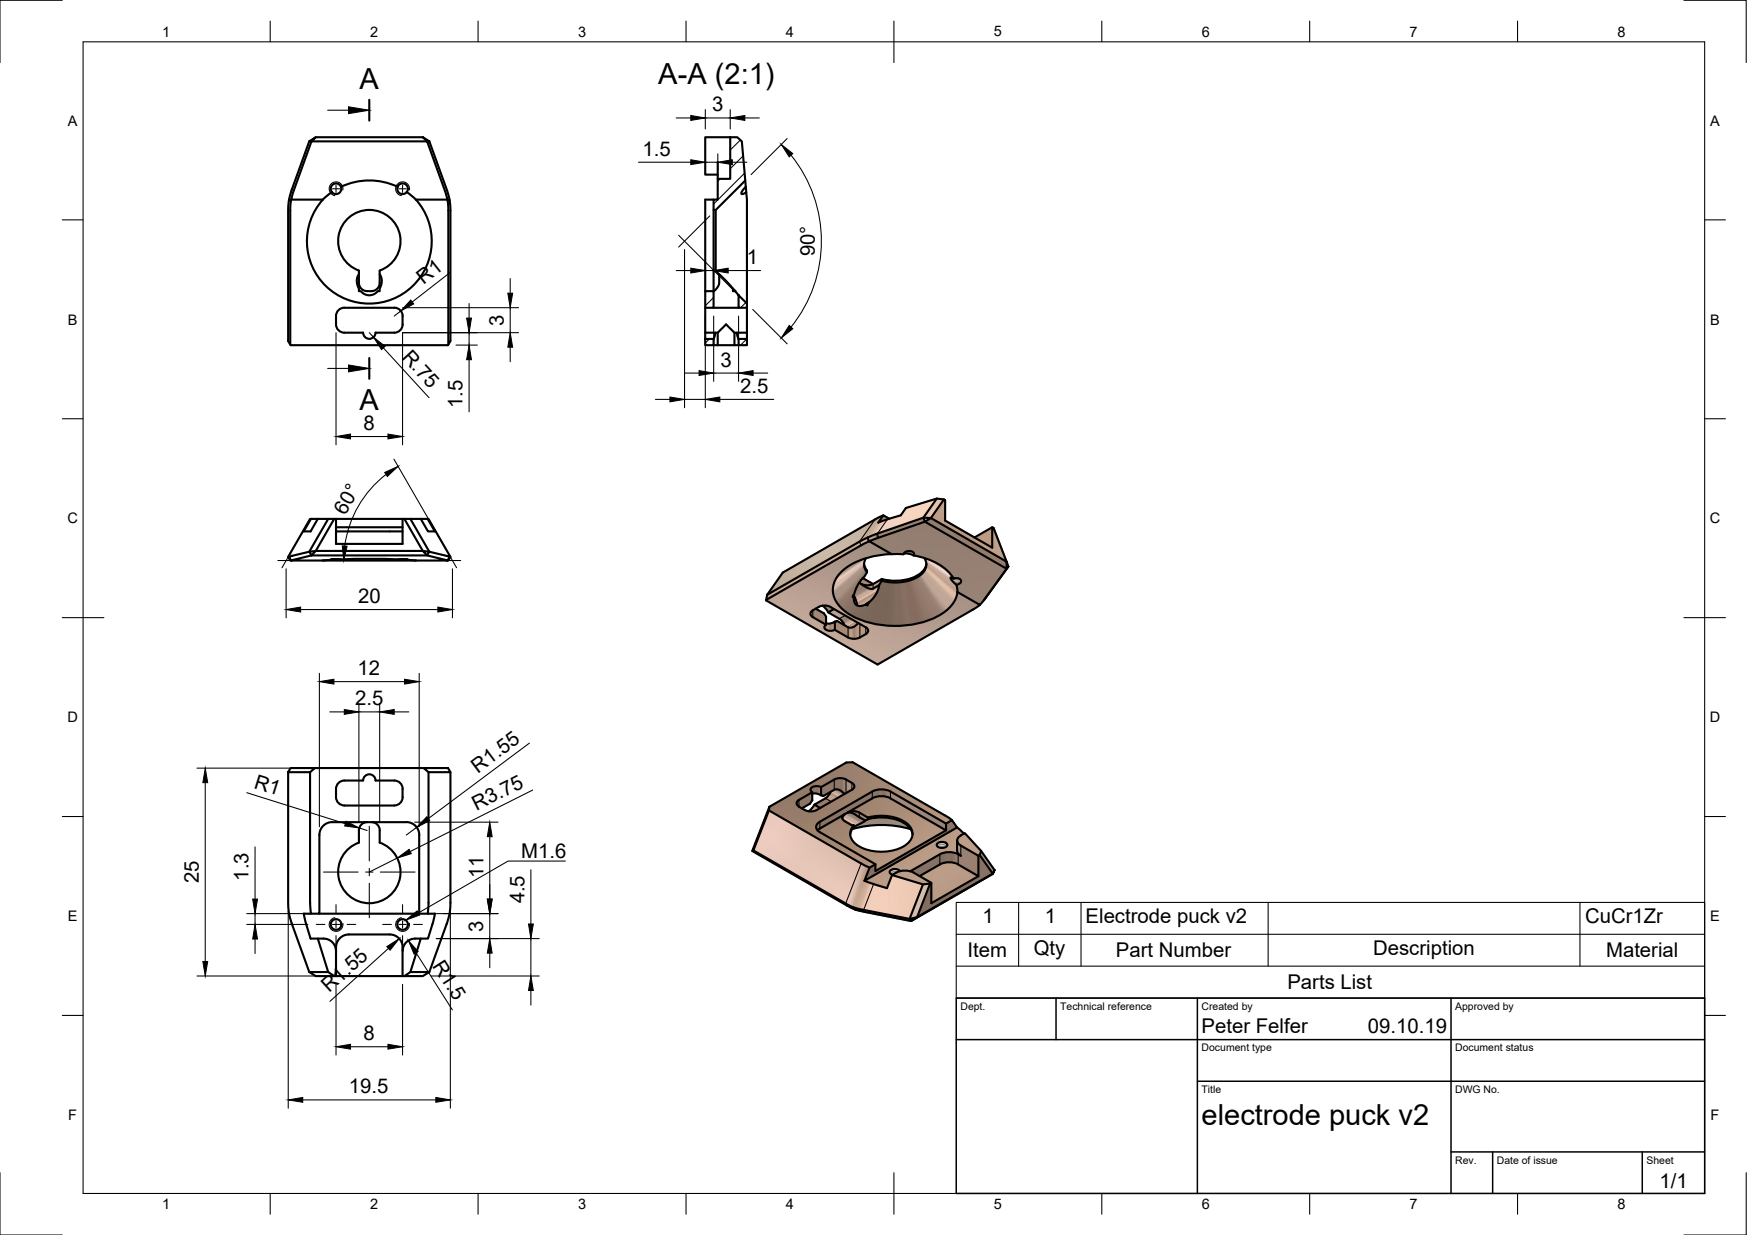
[picture p248: page 1]
Parts List

1 | 1 | Electrode puck v2 | | CuCr1Zr
Item | Qty | Part Number | Description | Material

Dept. | Technical reference | Created by Peter Felfer 09.10.19 | Approved by

Document type | Document status

Title electrode puck v2 | DWG No.

Rev. | Date of issue | Sheet 1/1
