peterfelfer/Oxcart/CAD/sample-handling/sample stage - pucks/electrode V2 Al in Ni Dipper Zeichnung v1.pdf

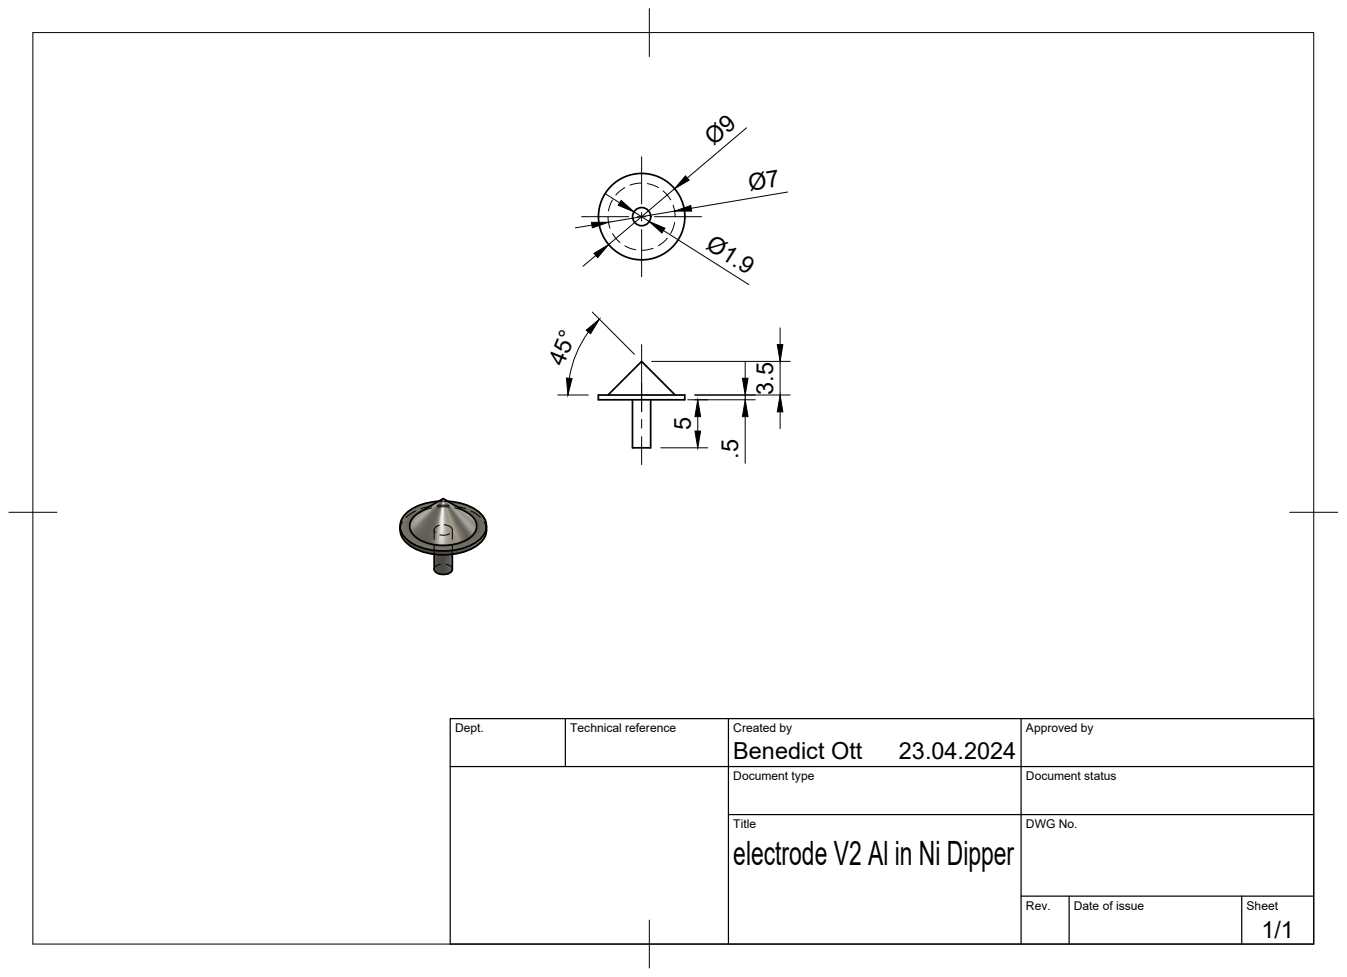
[picture p250: page 1]

Dept. | Technical reference | Created by Benedict Ott 23.04.2024 | Approved by

Document type | Document status

Title electrode V2 Al in Ni Dipper | DWG No.

Rev. | Date of issue | Sheet 1/1
