peterfelfer/Oxcart/CAD/sample-handling/sample stage - pucks/lift spring mount Drawing v1.pdf

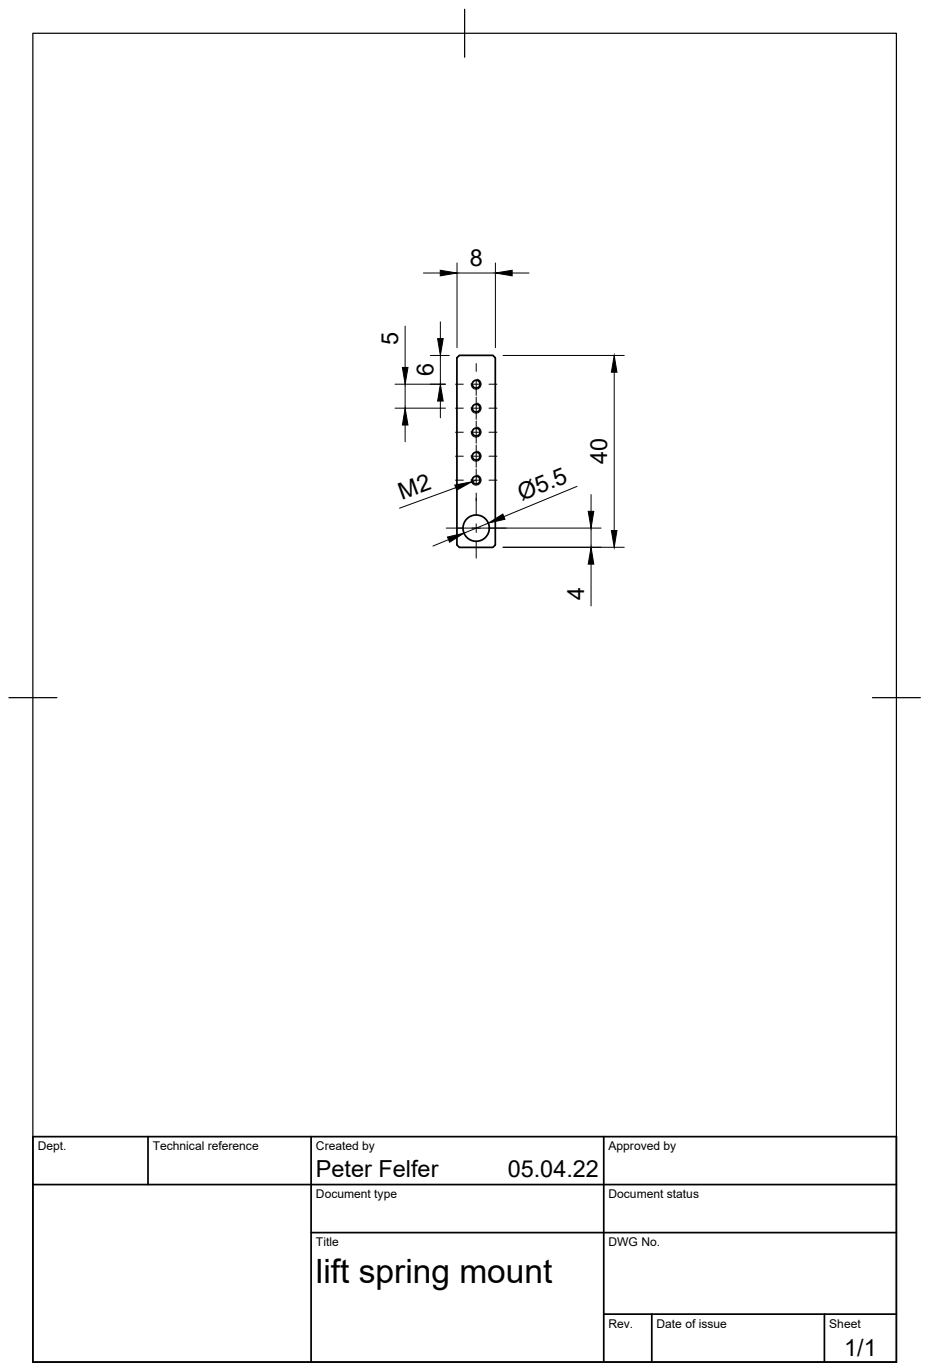
[picture p251: page 1]

Dept. | Technical reference | Created by Peter Felfer 05.04.22 | Approved by

Document type | Document status

Title lift spring mount | DWG No.

Rev. | Date of issue | Sheet 1/1
