peterfelfer/Oxcart/CAD/sample-handling/sample stage - pucks/piezo adapter plate Drawing v6.pdf

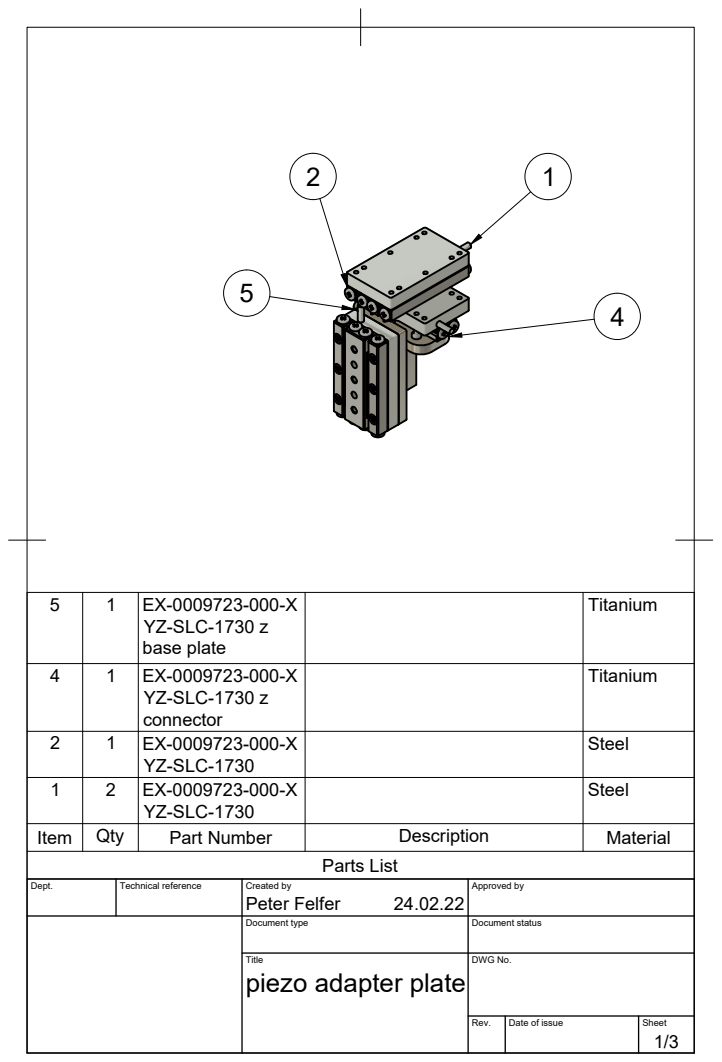
[picture p252: page 1]
Parts List

5 | 1 | EX-0009723-000-X YZ-SLC-1730 z base plate | | Titanium

4 | 1 | EX-0009723-000-X YZ-SLC-1730 z connector | | Titanium

2 | 1 | EX-0009723-000-X YZ-SLC-1730 | | Steel

1 | 2 | EX-0009723-000-X YZ-SLC-1730 | | Steel

Item | Qty | Part Number | Description | Material

Dept. | Technical reference | Created by Peter Felfer 24.02.22 | Approved by

Document type | Document status

Title piezo adapter plate | DWG No.

Rev. | Date of issue | Sheet

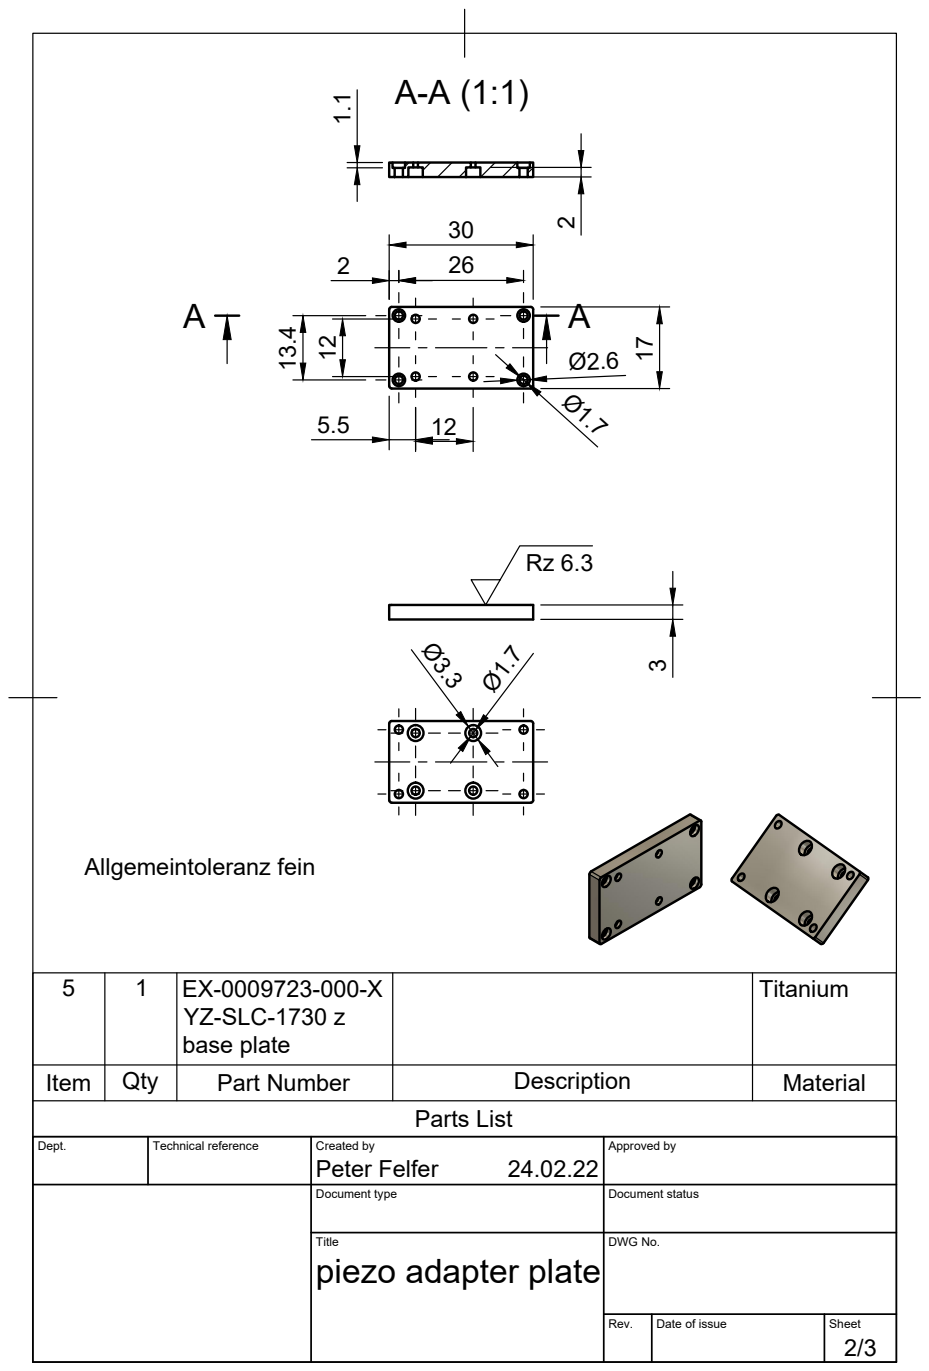
[picture p253: page 2]
Parts List; Titanium 17; Allgemeintoleranz fein

5 | 1 | EX-0009723-000-X YZ-SLC-1730 z base plate

Item | Qty | Part Number | Description | Material

Dept. | Technical reference | Created by Peter Felfer 24.02.22 | Approved by

Document type | Document status

Title piezo adapter plate | DWG No.

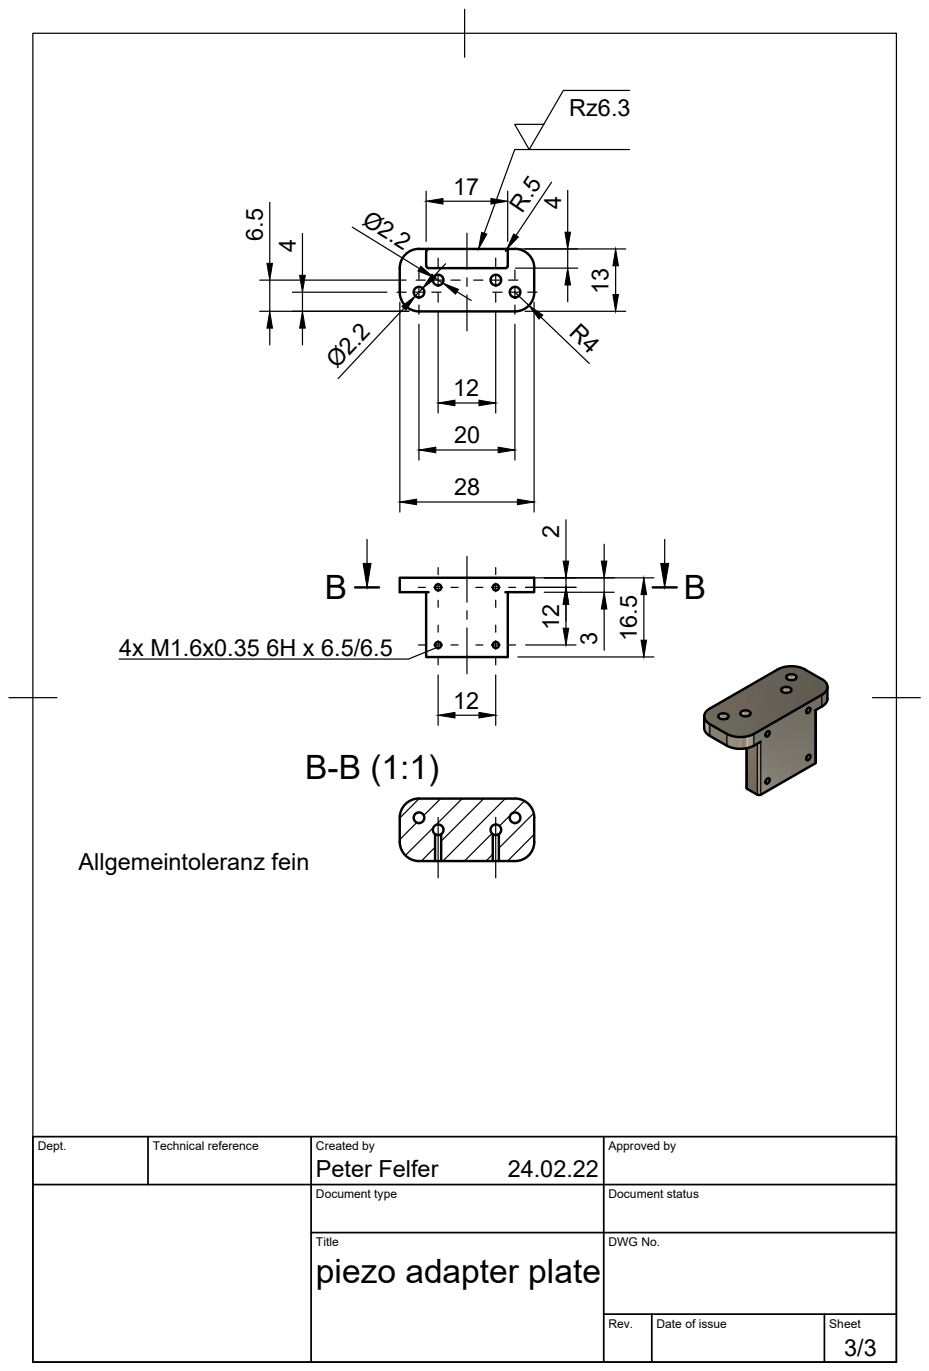
[picture p254: page 3]
Peter Felfer; Allgemeintoleranz fein

Dept. | Technical reference | Created by 24.02.22 | Approved by

Document type | Document status

Title piezo adapter plate | DWG No.
