peterfelfer/Oxcart/CAD/sample-handling/sample stage - pucks/pulse transfer pin Drawing v3.pdf

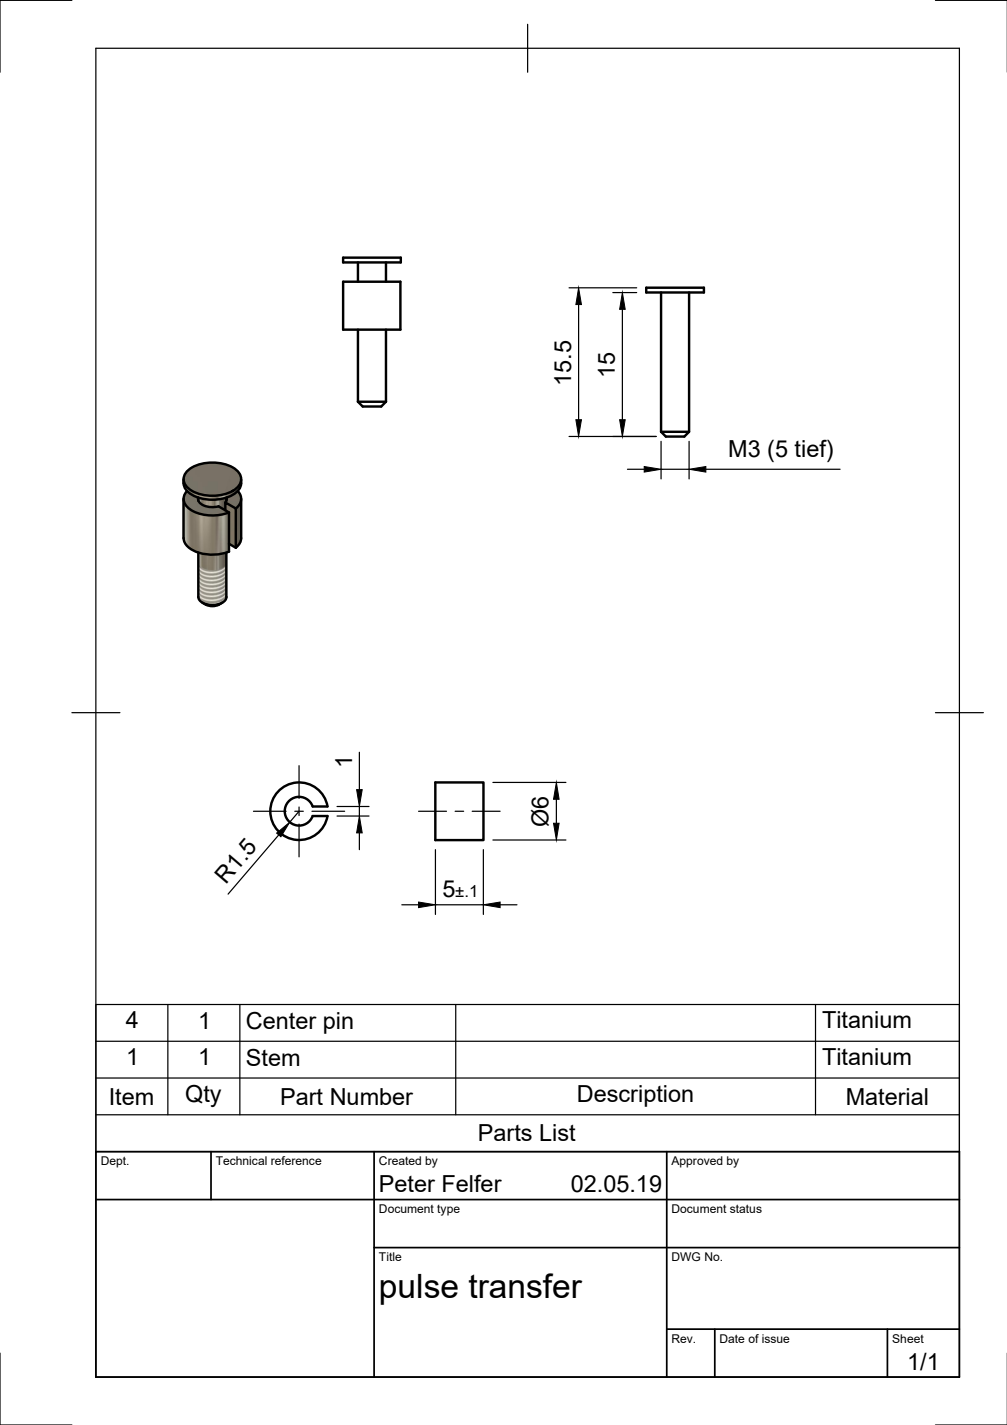
[picture p255: page 1]
Parts List; M3 (5 tief)

4 | 1 | Center pin | | Titanium
1 | 1 | Stem | | Titanium
Item | Qty | Part Number | Description | Material

Dept. | Technical reference | Created by Peter Felfer 02.05.19 | Approved by

Document type | Document status

Title pulse transfer | DWG No.

Rev. | Date of issue | Sheet 1/1
