peterfelfer/Oxcart/CAD/sample-handling/sample stage - pucks/smb electrode insulators Zeichnung v2.pdf

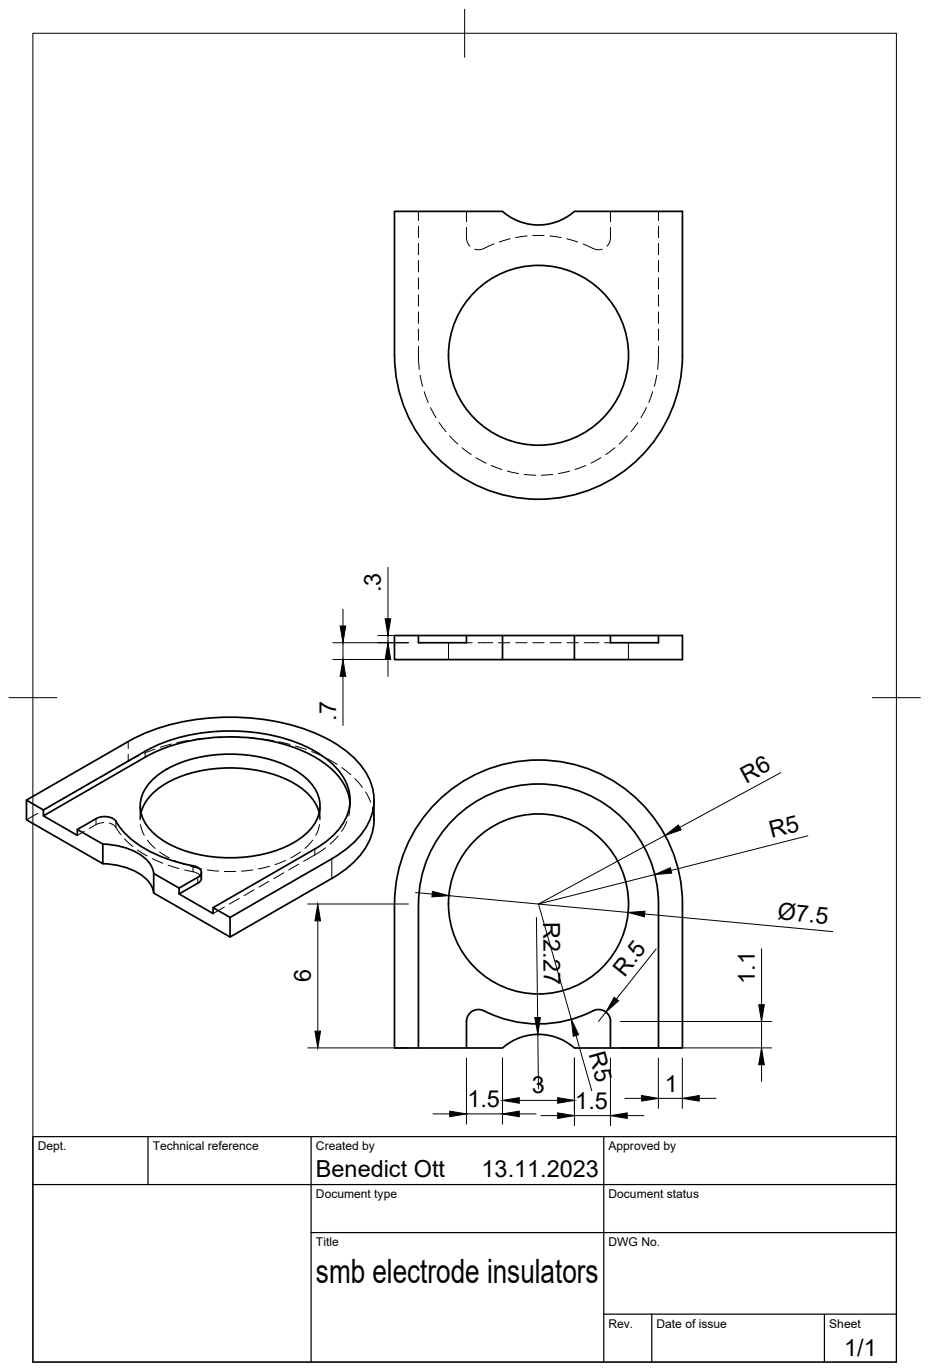
[picture p256: page 1]

Dept. | Technical reference | Created by Benedict Ott 13.11.2023 | Approved by

Document type | Document status

Title smb electrode insulators | DWG No.

Rev. | Date of issue | Sheet 1/1
