peterfelfer/Oxcart/CAD/sample-handling/sample stage - pucks/SMB electrode puck Drawing v3.pdf

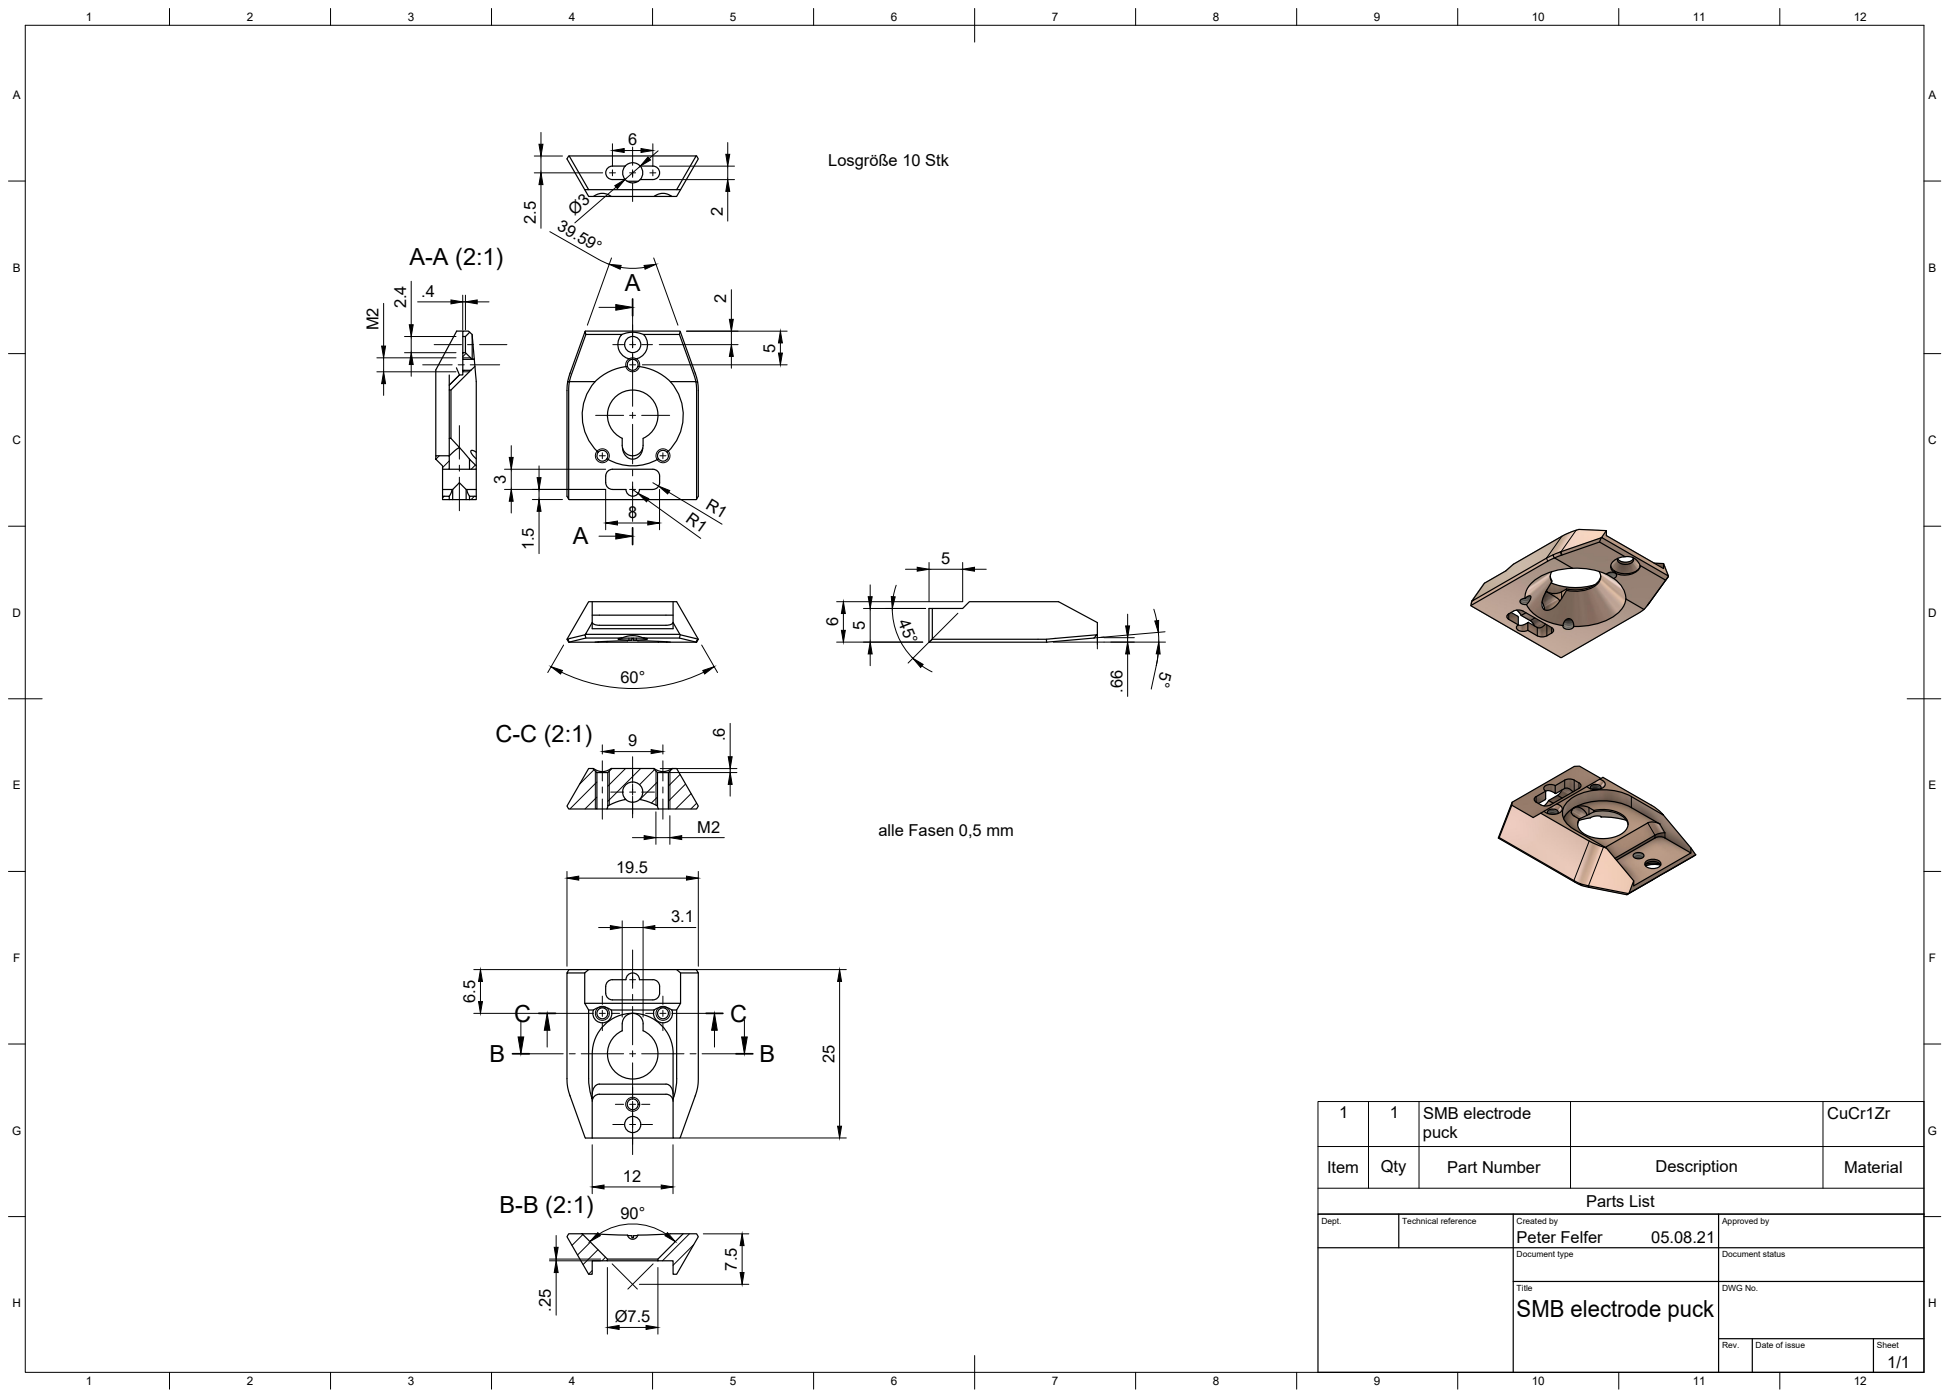
[picture p257: page 1]
Parts List; CuCr1Zr .66; Losgröße 10 Stk

alle Fasen 0,5 mm

1 | 1 | SMB electrode puck

Item | Qty | Part Number | Description | Material

Dept. | Technical reference | Created by Peter Felfer 05.08.21 | Approved by

Document type | Document status

Title SMB electrode puck | DWG No.

Rev. | Date of issue | Sheet 1/1
