peterfelfer/Oxcart/CAD/sample-handling/sample stage - pucks/SMB electrode receptacle Drawing v3.pdf

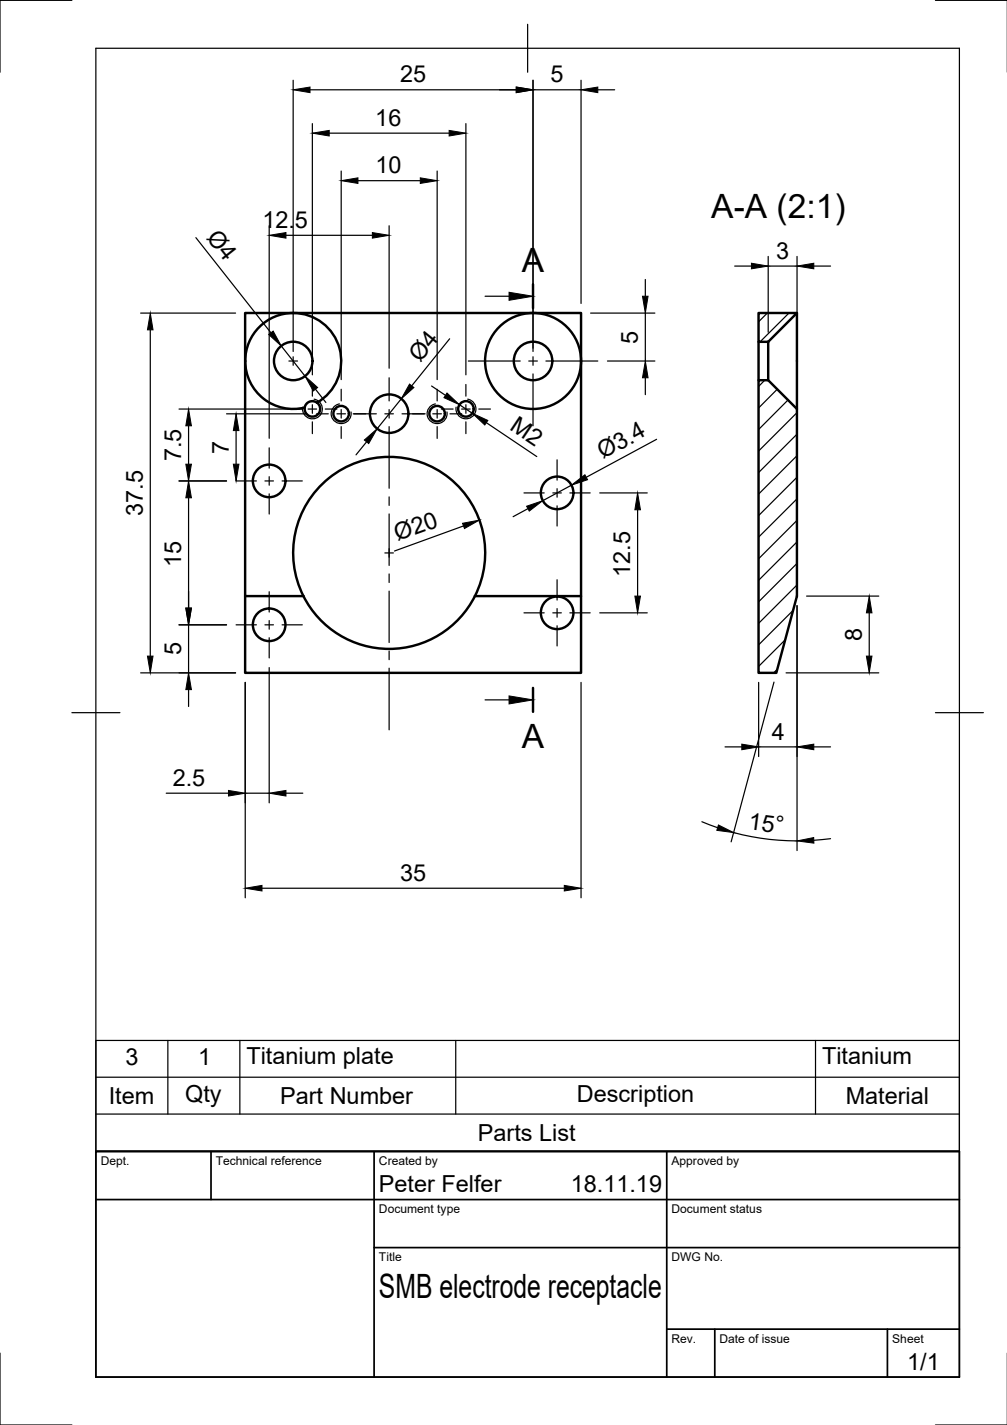
[picture p258: page 1]
Parts List

3 | 1 | Titanium plate | | Titanium
Item | Qty | Part Number | Description | Material

Dept. | Technical reference | Created by Peter Felfer 18.11.19 | Approved by

Document type | Document status

Title SMB electrode receptacle | DWG No.

Rev. | Date of issue | Sheet 1/1
