peterfelfer/Oxcart/CAD/sample-handling/sample stage - pucks/smb electrode top ground Zeichnung v1.pdf

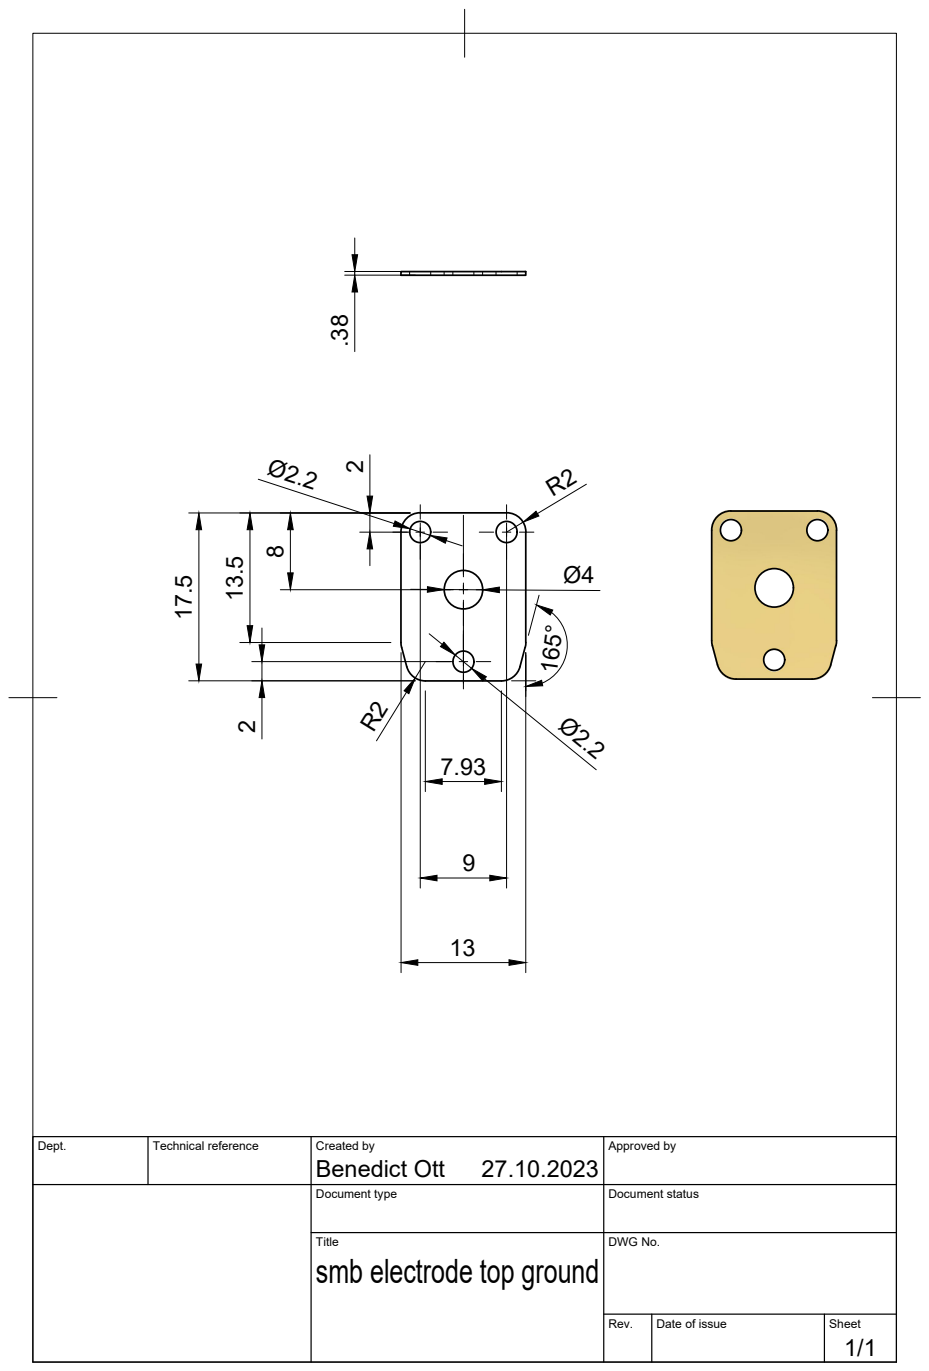
[picture p259: page 1]

Dept. | Technical reference | Created by Benedict Ott 27.10.2023 | Approved by

Document type | Document status

Title smb electrode top ground | DWG No.

Rev. | Date of issue | Sheet 1/1
