peterfelfer/Oxcart/CAD/sample-handling/sample stage - pucks/copper braid specimen curved Drawing v1.pdf

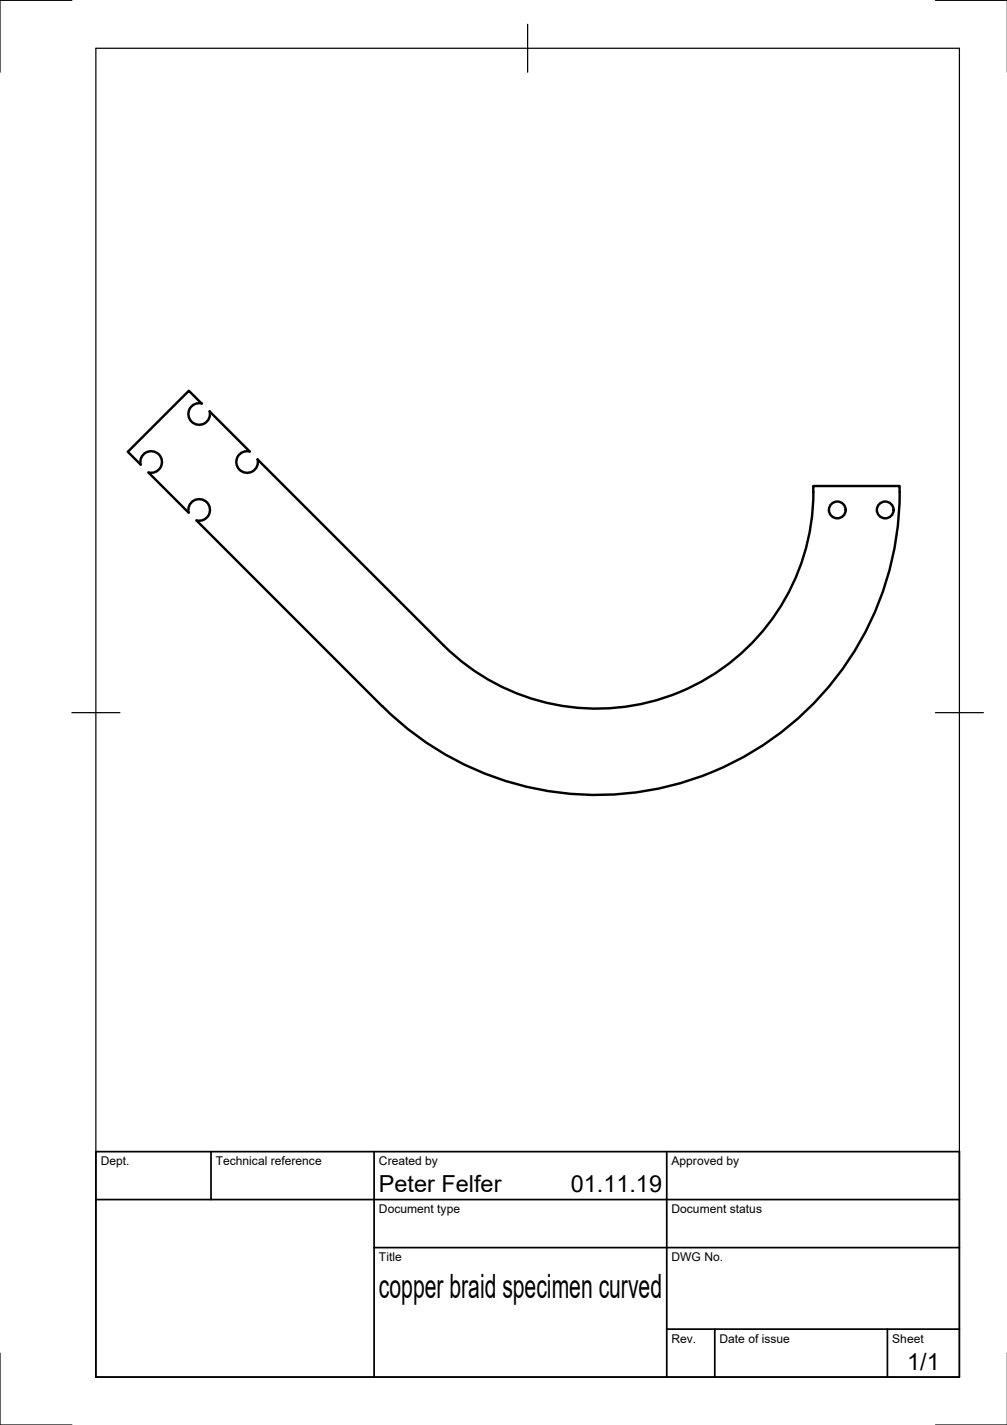
[picture p262: page 1]

Dept. | Technical reference | Created by Peter Felfer 01.11.19 | Approved by

Document type | Document status

Title copper braid specimen curved | DWG No.

Rev. | Date of issue | Sheet 1/1
