peterfelfer/Oxcart/CAD/vacuum/valves manipulation/WS_16_ES_FG_special_3 Drawing v2.pdf

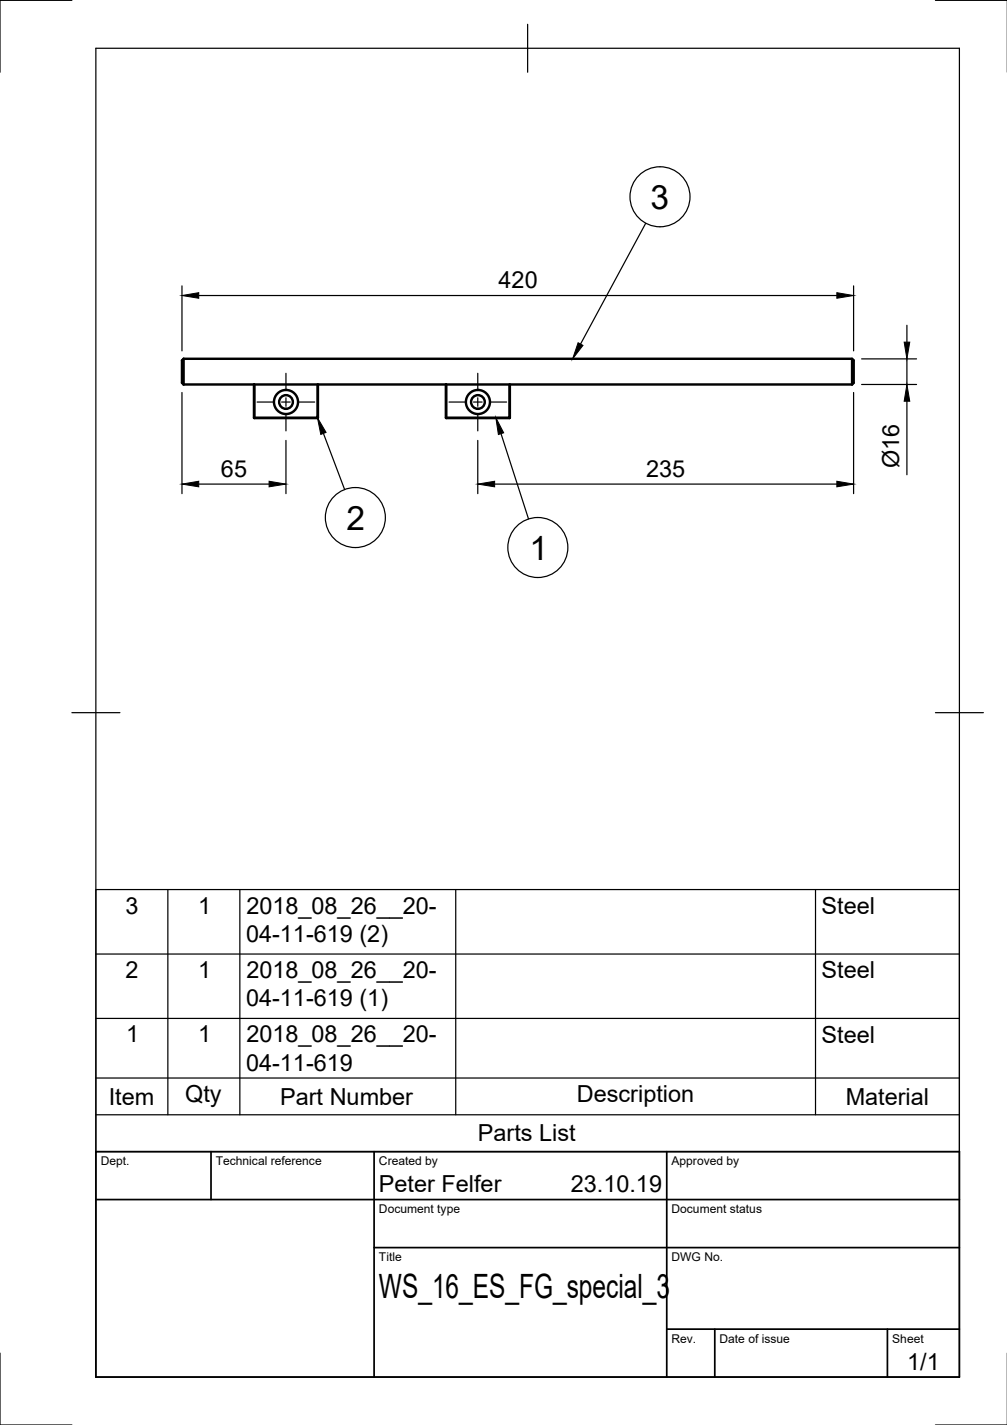
[picture p263: page 1]
Parts List

3 | 1 | 2018_08_26__20-04-11-619 (2) | | Steel

2 | 1 | 2018_08_26__20-04-11-619 (1) | | Steel

1 | 1 | 2018_08_26__20-04-11-619 | | Steel

Item | Qty | Part Number | Description | Material

Dept. | Technical reference | Created by Peter Felfer 23.10.19 | Approved by

Document type | Document status

Title WS_16_ES_FG_special_3 | DWG No.

Rev. | Date of issue | Sheet 1/1
