peterfelfer/Oxcart/CAD/gas-thermal/gas charging devices/gasChargingCube/GasChargingCryoarmGuide Zeichnung v2.pdf

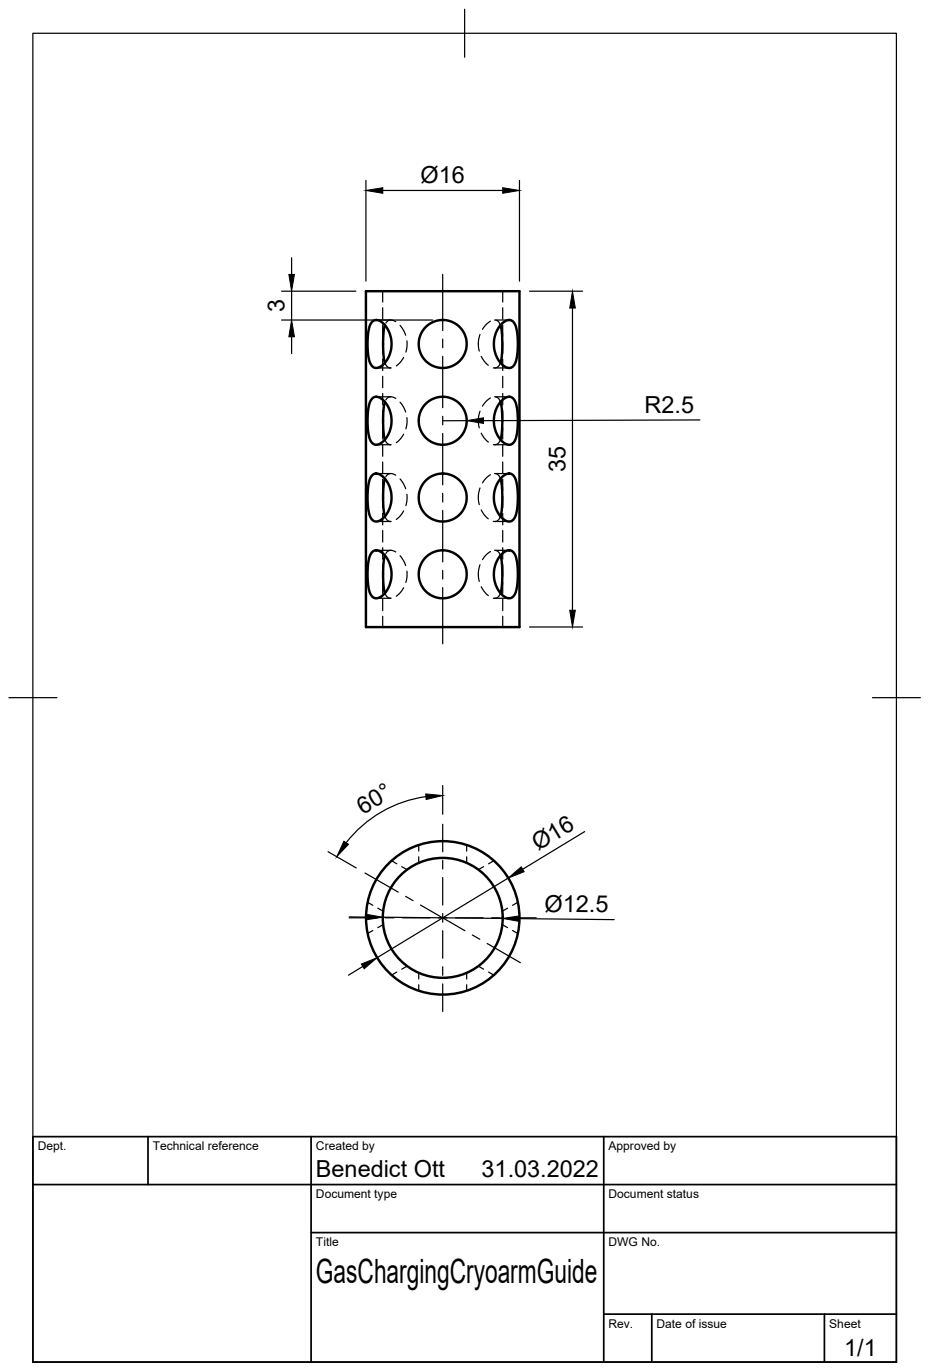
[picture p264: page 1]

Dept. | Technical reference | Created by Benedict Ott 31.03.2022 | Approved by

Document type | Document status

Title GasChargingCryoarmGuide | DWG No.

Rev. | Date of issue | Sheet 1/1
