peterfelfer/Oxcart/CAD/machining/cryo interface v4 cooling shield Zeichnung v2.pdf

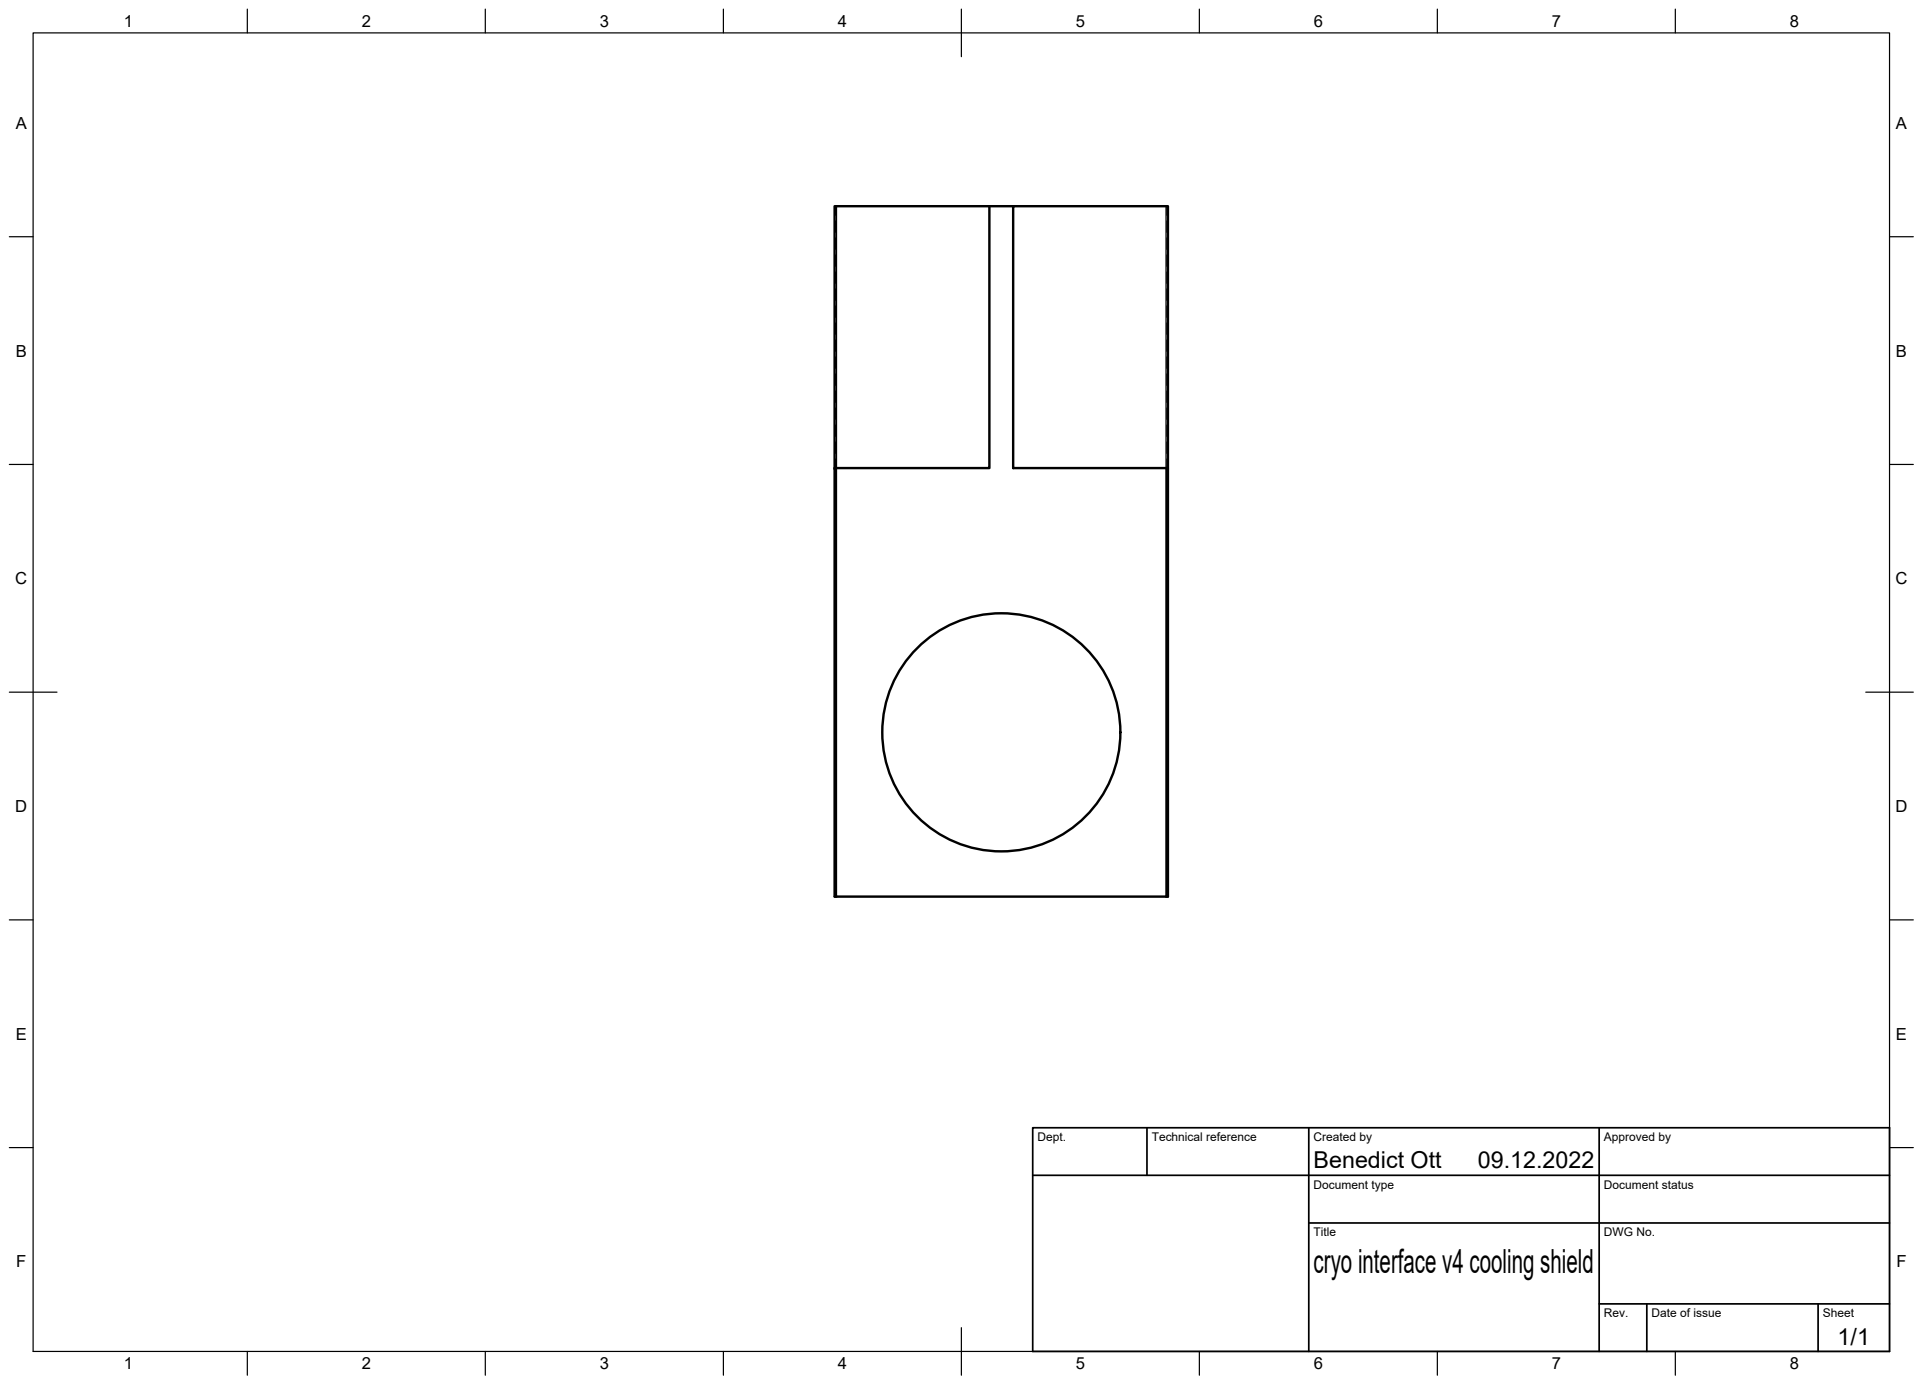
[picture p265: page 1]
Title; DWG No.; Rev.; Date of issue; Sheet

Dept. | Technical reference | Created by Benedict Ott 09.12.2022 | Approved by

Document type | Document status

cryo interface v4 cooling shield
