peterfelfer/Oxcart/CAD/cryo/cryo LL/CryoLLMainPart Zeichnung v1.pdf

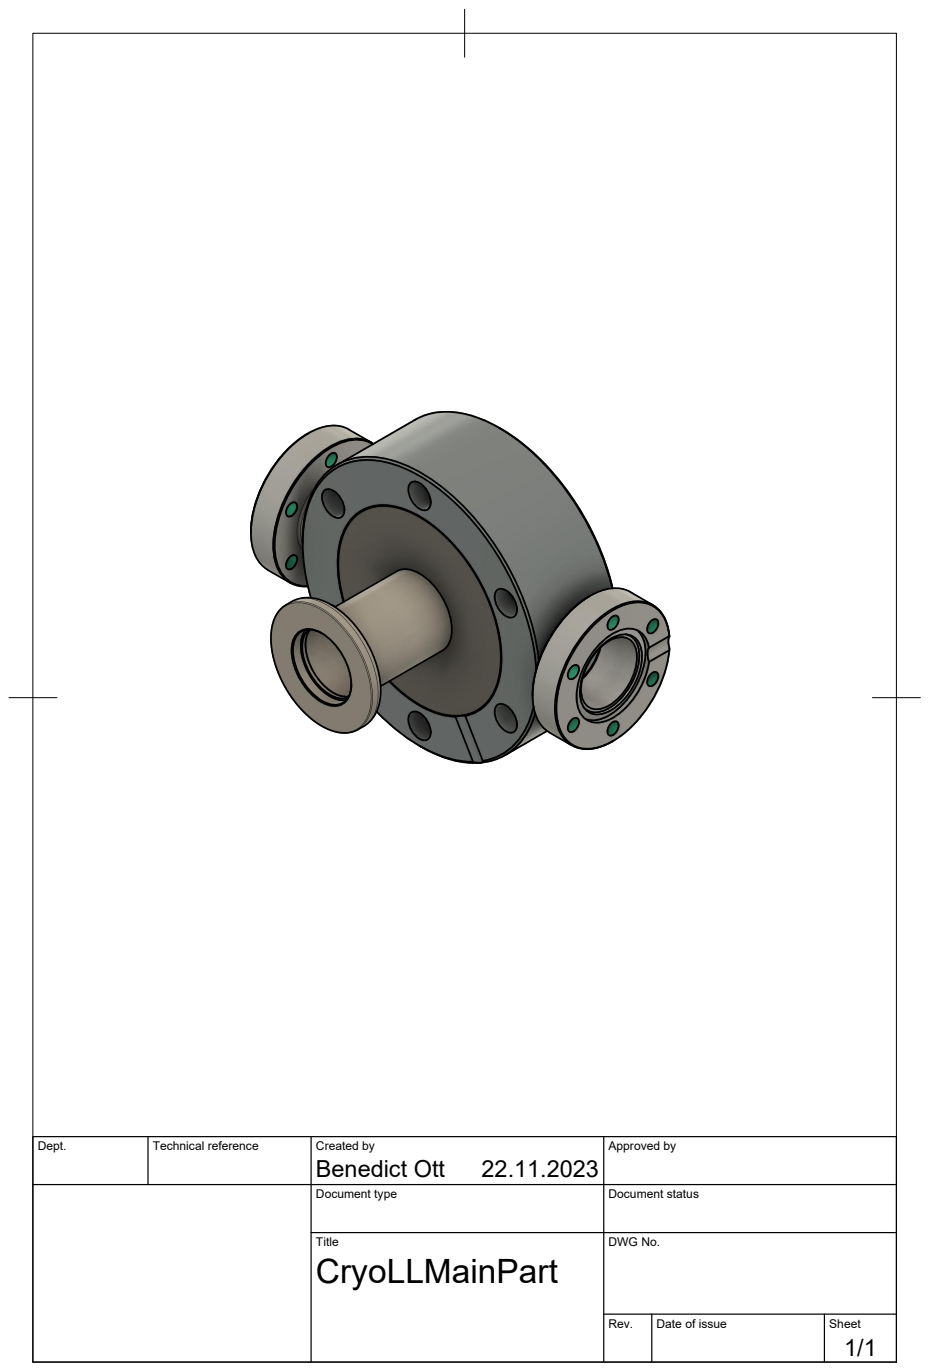
[picture p266: page 1]

Dept. | Technical reference | Created by Benedict Ott 22.11.2023 | Approved by

Document type | Document status

Title CryoLLMainPart | DWG No.

Rev. | Date of issue | Sheet 1/1
