peterfelfer/Oxcart/CAD/cryo/cryo system MC/cryo interface v4 Zeichnung v2.pdf

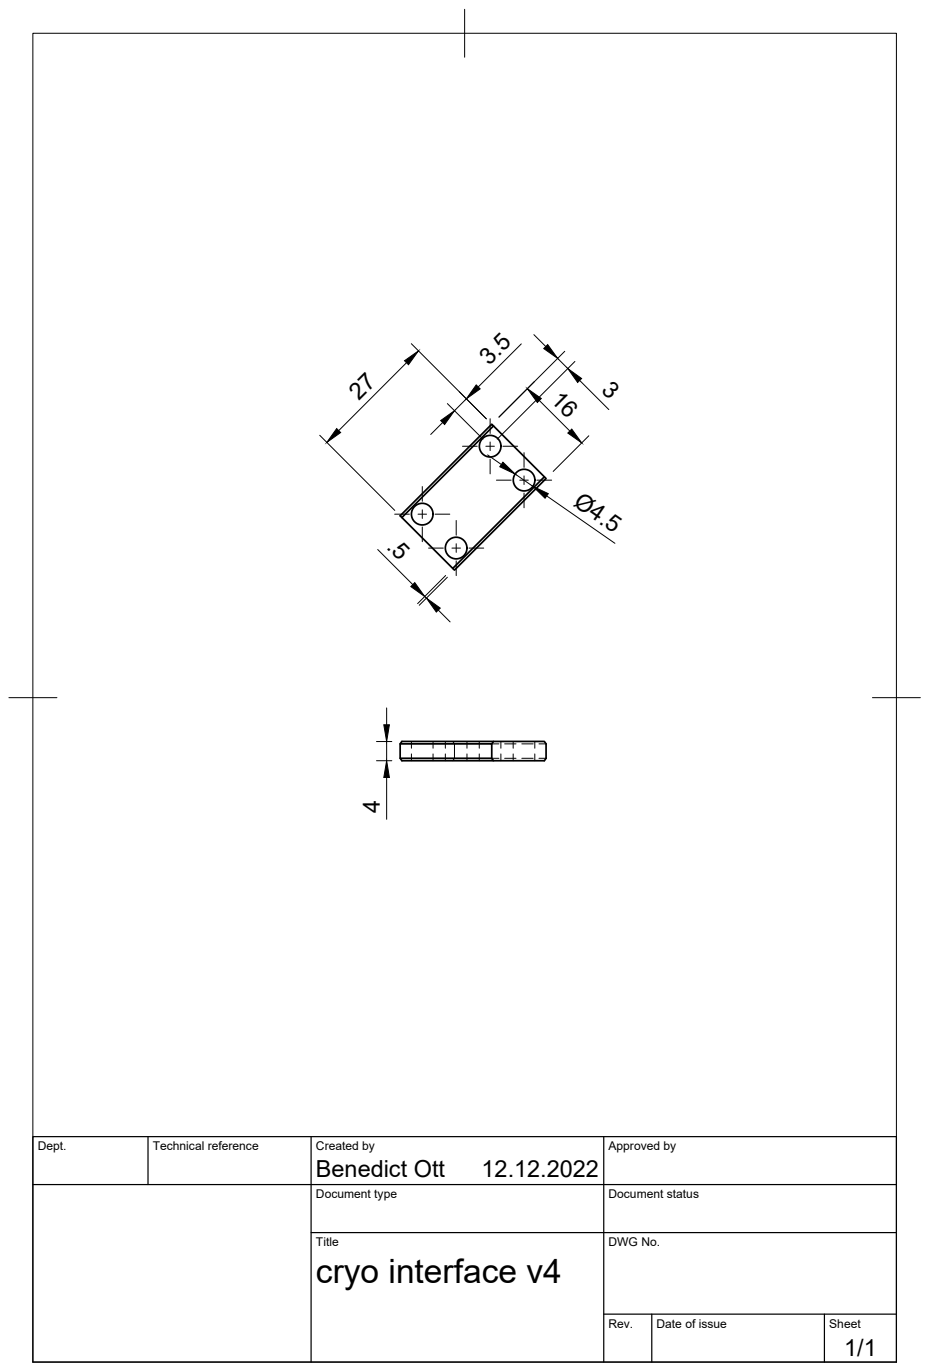
[picture p267: page 1]

Dept. | Technical reference | Created by Benedict Ott 12.12.2022 | Approved by

Document type | Document status

Title cryo interface v4 | DWG No.

Rev. | Date of issue | Sheet 1/1
