peterfelfer/Oxcart/(commit log)

2026-05-30 Prepare design files for publication
    Reorganize the Oxcart CAD package for sharing on GitHub:
    - Group all custom parts under CAD/ by subsystem (assemblies, vacuum, cryo,
    optics-laser, detector, sample-handling, frame, gas-thermal, electronics,
    fasteners, machining, measurement, 3d-print).
    - Keep only the latest version of each part; strip "(ATTER/AFTER UPDATE)" tags.
    - Provide each part as STEP + Fusion source.
    - Store the few >100 MB assemblies as compressed/split ZIP archives so the repo
    needs no Git LFS (see docs/large-files.md).
    - Exclude third-party vendor CAD; list those parts by supplier in BOM.md.
    - Expand README with a repository-layout guide; add .gitattributes.
    Co-Authored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
    [0-12 COLDHEAD ASSEMBLY v3.f3d, 0-12 COLDHEAD ASSEMBLY v3.step, 1,2 of P7-501 thermal strap v2.f3d, 1.2 of P7-501 thermal strap v2.step, 1.5W 4K v2.f3d, 1.5W 4K v2.step, 1130873 v1.f3d, 1130873 v1.step]
2026-05-30 README: lead with funding acknowledgement; add DFG laser-upgrade funding
    - Move the Funding & acknowledgement section to the top of the README.
    - Add DFG funding for the laser upgrade (project 516600907).
