peterfelfer/Oxcart/(notices)

Notices in the files:
README.md:
License: GPL v3
